PipeNitch/Project_WPNS-IoT/Pictures/IMG20240515162957.jpg

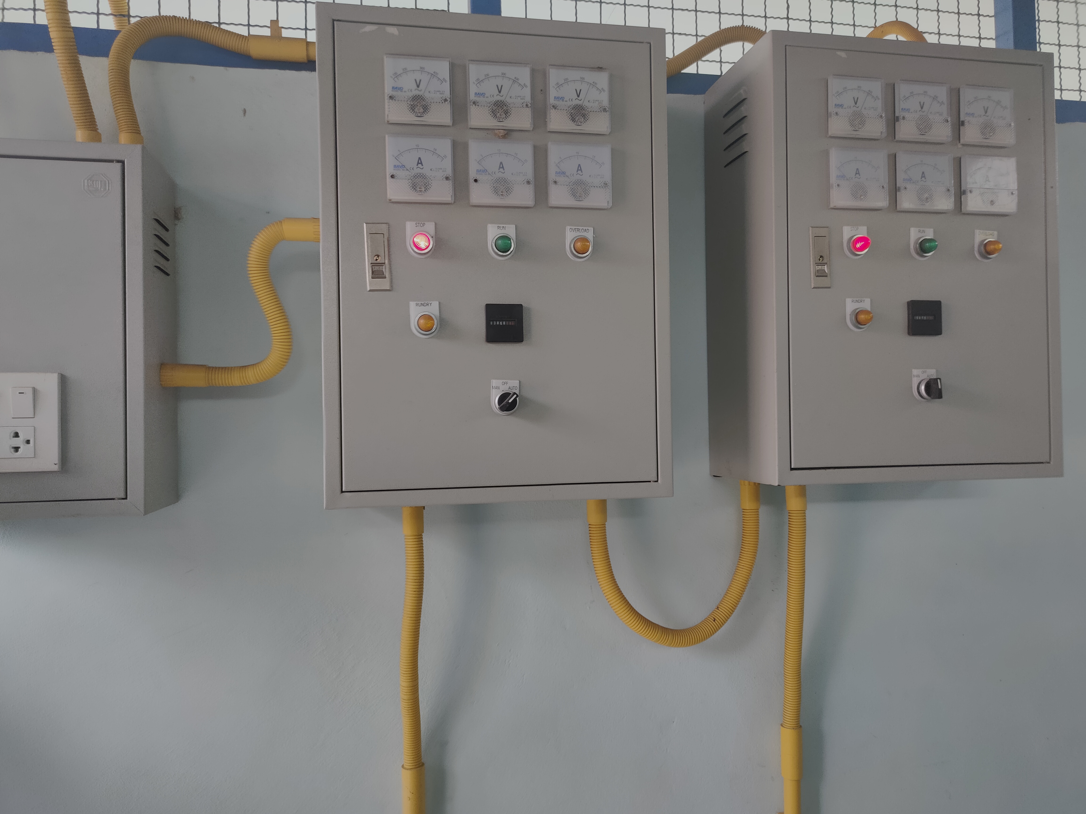
Pictures/IMG20240515162957.jpg
