PipeNitch/Project_WPNS-IoT/Pictures/IMG20240515163106.jpg

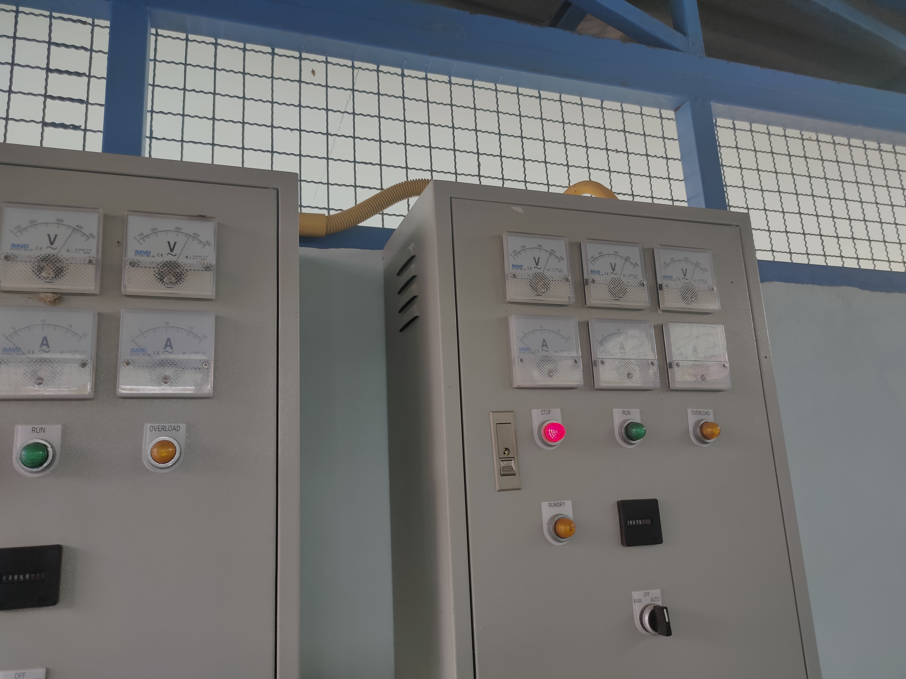
Pictures/IMG20240515163106.jpg
