PipeNitch/Project_WPNS-IoT/README.md

Project_WPNS-IoT\
A notification and shutdown system for water pumps using Internet of Things (IoT) technology.
