PipeNitch/Project_WPNS-IoT/Documents/66CS03_ระบบแจ้งเตือนและตัดการทำงานปั๊มน้ำโดยใช้เทคโนโลยีอินเทอร์เน็ตในทุกสิ่ง (IoT).pdf

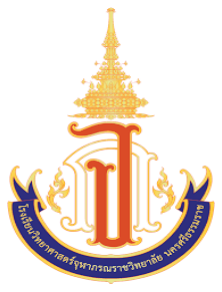
[picture p5: figure]

### ระบบแจ้งเตือนและตัดการท างานของปั๊มน ้าโดยใช้เทคโนโลยีอินเทอร์เน็ตในทุกสิ่ง A notification and shutdown system for water pumps using Internet of Things (IoT) technology

โดย
1. นายชยุต สรรพขาว
2. นายธรรมนิตย์ หนูยิ้มซ้าย

รายงานนี้เป็นส่วนหนึ่งของรายวิชา โครงงานวิทยาศาสตร์ ตามหลักสูตรโรงเรียนวิทยาศาสตร์จุฬาภรณราชวิทยาลัย นครศรีธรรมราช

### ระบบแจ้งเตือนและตัดการท างานของปั๊มน ้าโดยใช้เทคโนโลยีอินเทอร์เน็ตในทุกสิ่ง A notification and shutdown system for water pumps using Internet of Things (IoT) technology

โดย
1. นายชยุต สรรพขาว
2. นายธรรมนิตย์ หนูยิ้มซ้าย

รายงานนี้เป็นส่วนหนึ่งของรายวิชา โครงงานวิทยาศาสตร์ ตามหลักสูตรโรงเรียนวิทยาศาสตร์จุฬาภรณราชวิทยาลัย นครศรีธรรมราช

บทคัดย่อ
อยู่ระหว่างด าเนินการของโครงงาน

กิตติกรรมประกาศ
อยู่ระหว่างด าเนินการของโครงงาน

สารบัญ

อยู่ระหว่างด าเนินการของโครงงาน

บทที่ 1
บทน า
1.1 ที่มาและความส าคัญ
ปั๊มน ้าที่เราใช้กันทั่วไป ทั้งบ้านเรือน ภาคเกษตร หน่วยงานภาครัฐและเอกชน ปฏิเสธไม่ได้เลยว่าปั๊ม น ้ามีความจ าเป็นแทบจะต้องท างานตลอดเวลา หลายครั้งจะพบว่า “ปั๊มน ้าท างานแต่ไม่จ่ายน ้า” หรือเรียก ในทางเทคนิคว่า Dry Run ซึ่งมาจากหลายๆ สาเหตุ หากทราบปัญหาการท างานที่ผิดปกติได้เร็วและได้แก้ไข ในทันที จะช่วยลดค่าใช้จ่ายได้เป็นอย่างมาก แต่หากไม่รีบด าเนินการแก้ไข อาจท าให้เกิดค่าใช้จ่ายในการซ่อม มาก บางครั้งอาจก่อให้เกิดไฟฟ้าลัดวงจรจนเกิดไฟไหม้ได้
ปัญหาปั๊มน ้าท างานแบบ Dry Run พบได้บ่อยในหลายพื้นที่ สร้างความเสียหายต่อตัวปั๊มและ สิ้นเปลืองพลังงาน จากประสบการณ์ส่วนตัวที่พบปัญหาดังกล่าวบ่อยครั้งในหมู่บ้าน กระตุ้นให้เกิดโครงงานนี้ ขึ้นเพื่อพัฒนาระบบตัดการท างานของปั๊มน ้าเมื่อไม่มีน ้าไหลผ่านหรือปั๊มน ้าใช้พลังงานไฟฟ้าผิดปกติ จากปัญหาดังกล่าวข้างต้นทีมงานพัฒนาโครงงานนี้จึงมีความคิดที่จะสร้างระบบที่ท าการแจ้งเตือน และสามารถตัดการท างานปั๊มน ้าโดยอัตโนมัติเมื่อตรวจพบสภาวะ Dry Run หรือปั๊มน ้ากินกระแสไฟฟ้า มากกว่าปกติ รวมถึงระบบยังการบันทึกข้อมูลการท างานของปั๊มน ้าและปริมาณการกินกระแสไฟฟ้าผิดปกติ คุณสมบัติของระบบเหล่านี้จะช่วยยืดอายุการใช้งานปั๊มลดการสูญเสียค่าใช้จ่ายในการซ่อมบ ารุงปั๊มน ้า ประหยัดค่าไฟฟ้า อีกทั้งข้อมูลที่บันทึกไว้ยังสามารถน ามาวิเคราะห์เพื่อหามาตราการณ์ในการลดค่าไฟฟ้าจาก การท าของปั๊มน ้า รวมถึงวิเคราะห์หาแนวโน้มการช ารุดของปั๊มน ้าได้อีกด้วย

1.2 วัตถุประสงค์
1.2.1 เพื่อพัฒนาระบบแจ้งเตือนและป้องกันการท างานที่ผิดปกติของปั๊มน ้า
1.2.2 เพื่อป้องกันปั๊มน ้าไม่ให้เกิดความเสียหาย
1.2.3 เพื่อรวบรวมข้อมูลการท างานต่าง ๆ ของปั๊มน ้า

1.3 ขอบเขตของการศึกษา
1.3.1 ปั๊มน ้าที่ศึกษาเป็นแบบหอยโข่งหรือปั๊มดูดบ่อบาดาล
1.3.2 ปั๊มน ้ามีขนาด 1 แรงขึ้นไปเพื่อที่จะมีก าลังผลักของน ้าพอที่จะให้ Flow Switch ท างานได้ 1.3.3 ท่อส่งน ้าของปั๊มน ้ามีขนาด 1 นิ้วขึ้นไปหากน้อยกว่านั้นจะไม่สามารถติดตั้ง Flow Switch ได้ 1.3.4 ปั๊มน ้าที่ใช้เป็นปั๊มไฟฟ้ากระแสสลับ ขนาดแรงดันไฟฟ้า 220 โวลต์ทั้งแบบ 1 เฟส และ 3 เฟส 1.3.5 การตรวจจับความผิดปกติของปั๊มน ้าจะตรวจจับจาก 2 ปัจจัยดังนี้
1.3.5.1 ตรวจจับการไหลของน ้าโดยใช้ Flow Switch
1.3.5.2 ตรวจจับการใช้พลังงานไฟฟ้าของปั๊มน ้าขณะท างาน มีหน่วยวัดเป็นแอมป์
1.3.6 ใน 1 ระบบจะเฝ้าการท างานของปั๊มน ้า 1 ตัว

1.3.7 บอร์ดประมวลผลกลางใช้บอร์ด Node MCU ESP8266
1.3.8 แอปพลิเคชันในการรับข้อมูลและควบคุมการท างานของระบบจะใช้แอปพลิเคชัน Blynk Legacy
1.3.9 ที่แอปพลิเคชันจะมีการก าหนดค่าการหน่วงเวลาเพื่อตรวจจับการไม่ไหลของน ้าขณะที่ปั๊มน ้า ท างานมีหน่วยเป็น วินาที
1.3.10 ที่แอปพลิเคชันจะมีการก าหนดค่าการใช้พลังงานไฟฟ้าที่เกินก าหนดเพื่อให้ระบบแจ้งเตือนหรือ ตัดการท างานของปั๊มน ้ามีหน่วยเป็นแอมป์
1.3.11 การแจ้งเตือนต่าง ๆ จากระบบไปยังผู้ใช้งานระบบจะแจ้งไปยัง แอปพลิเคชันไลน์แบบกลุ่ม 1.3.12 การเก็บรวบรวมข้อมูลการท างานของปั๊มน ้าและการใช้พลังงานไฟฟ้าจะเก็บลงใน google sheet

1.4 สมมติฐาน
ระบบจะเตือนและตัดการท างานปั๊มน ้าเมื่อปั๊มน ้าท างานแต่ไม่มีน ้าไหล หรือปั๊มน ้าใช้พลังงานไฟฟ้า เกินกว่าที่ก าหนด ซึ่งจะเป็นการป้องกันการเสียหายของปั๊มน ้าได้

1.5 ตัวแปรที่ศึกษา
ตัวแปรต้น | ระบบติดตามการท างานของปั๊มน ้า
ตัวแปรตาม | ประสิทธิภาพการท างานของปั๊มน ้า
ตัวแปรควบคุม | สภาพการใช้งานของปั๊มน ้า

1.6 นิยามเชิงปฏิบัติการ
ระบบแจ้งเตือนและตัดการท างานของปั๊มน ้า หมายถึง ระบบที่สามารถตรวจสอบการท างานที่ผิดปกติ ของปั๊มน ้าได้จากกรณีต่าง ๆ ได้แก่ ปั๊มน ้าไม่สามารถดูดน ้าหรือส่งน ้าได้ ปั๊มน ้าใช้พลังงานไฟฟ้าสูงกว่าปกติ และเมื่อตรวจสอบได้จะท าการแจ้งเตือนให้ผู้ดูแลทราบและตัดการท างานเพื่อป้องกันความเสียหายที่จะเกิดกับ ปั๊มน ้าเช่นปั๊มน ้าไหม้
ประสิทธิภาพการท างานของปั๊มน ้า หมายถึง ปั๊มน ้าสามารถสูบและส่งน ้าได้ในปริมาณที่ก าหนดเมื่อ เทียบกับเวลา ยังคงใช้พลังงานไฟฟ้าเป็นปกติโดยวัดจากปริมาณน ้าที่สูบได้ในระยะเวลาหนึ่ง สภาพการใช้งานของปั๊มน ้า หมายถึง สภาพแวดล้อมที่ปั๊มน ้าจะต้องท างาน เช่น ท างานที่อุณหภูมิห้อง

บทที่ 2
ทฤษฎีและงานวิจัยที่เกี่ยวข้อง ในบทนี้กล่าวถึงทฤษฎีและงานวิจัยที่เกี่ยวข้องที่น ามาท าโครงงานระบบแจ้งเตือนและตัดการท างาน ของปั๊มน ้าโดยใช้เทคโนโลยีอินเทอร์เน็ตในทุกสิ่ง ส าหรับการสร้างระบบดังกล่าวนี้มีองค์ประกอบหลาย ๆ อย่าง ที่ทีมงานจัดท าโครงงานต้องศึกษาค้นคว้า เพื่อน าความรู้ที่ได้ศึกษามาประยุกต์ในการท าโครงงานเพื่อให้ได้ตาม วัตถุประสงค์ที่ต้องการ โดยมีรายละเอียดที่ต้องศึกษาดังนี้
1. ทฤษฎีเกี่ยวกับเซ็นเซอร์ตรวจจับการไหลของน ้า (Flow Switch)
2. ทฤษฎีเกี่ยวกับ NodeMCU ESP8266
3. ทฤษฎีเกี่ยวกับจอแสดงผล LED
4. ทฤษฎีเกี่ยวกับบอร์ด Relay 12 VDC 220 VAC 2 ช่องสัญญาณ
5. ทฤษฎีเกี่ยวกับปั๊มน ้า
6. ทฤษฎีโปรแกรมภาษา C ส าหรับ Arduino
7. ทฤษฎีเกี่ยวกับแอปพลิเคชัน Blynk
8. ทฤษฎีเกี่ยวกับเราเตอร์
9. ทฤษฎีเกี่ยวกับ Application Line
10. งานวิจัยที่เกี่ยวข้อง
2.1 ทฤษฎีเกี่ยวกับเซ็นเซอร์ตรวจจับการไหลของน ้า (Flow Switch)
เป็นสวิตช์ควบคุมการท างานของอุปกรณ์ไฟฟ้าต่าง ๆ เช่น ปั๊มน ้า โดยอาศัยการไหลของน ้าหรือ ของเหลวมาพัดพาให้ใบพายที่เชื่อมต่อไปยังสวิตช์เคลื่อนที่ไปตามทิศทางการไหลซึ่งจะมีผลให้สวิตช์มีการตัด ต่อและสั่งจ่ายหรือตัดกระแสไฟฟ้าที่จ่ายไปยังอุปกรณ์ไฟฟ้านั้น ๆ และยังสามารถปรับให้การตัดต่อสวิตช์ เป็นไปตามอัตราการไหลมากน้อย ได้ตามต้องการและใบพายมีขนาดความยาวหลายขนาดให้เลือกใช้ แสดงได้ ดังภาพที่ 2.1

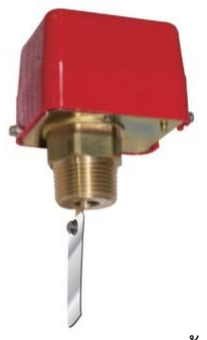
[picture p6: figure]

ภาพที่ 2.1 เซ็นเซอร์วัดการไหลของน ้า (Flow Switch) ที่มา https://inwfile.com/s-cp/496sep.png

2.2 ทฤษฎีเกี่ยวกับ Node MCU ESP8266
Node MCU Development Kit V.10 เป็นตัวที่พัฒนามาจาก Node MCU Version 0.9 เดิมเป็น โมดูลที่ประกอบด้วย ESP8266-12 E มีเสาอากาศแบบ PCB Antenna เชื่อมต่อเฮดเดอร์ส าหรับขาสัญญาณ ต่าง ๆ ได้แก่ GPIO , PWM , 12C , 1-wire , ADC และ มีSPI เพิ่มขึ้นมาจาก Version เดิม มีส่วนของ UBS -to-TTL และพอร์ต micro USB ซึ่งใช้ชิพ USB to Serial ของ Silicon Lab CP2102 เชื่อมต่อเข้ากับเครื่อง คอมพิวเตอร์เพื่อพัฒนาโปรแกรม สามารถติดตั้งเฟิร์มแวร์ Node MCU ได้ และยังมีขนาคของ PCB ที่เล็กลง สามารถใช้งานกับ breadboard ได้แสดงดังภาพที่ 2.2

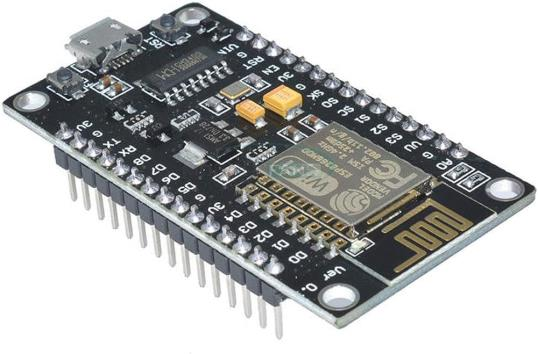
[picture p7: figure]

ภาพที่ 2.2 ลักษณะของ Node MCU ESP8266 ที่มา https://m.media-amazon.com/images/I/61UOyRccN0L._AC_UF1000,1000_QL80_.jpg จากภาพที่ 2.2 ผู้ใช้สามารถเลือกพัฒนาด้วยสคริปต์ LUA โดยใช้เฟิร์มแวร์ NodeMCU หรือเป็นชุด พัฒนาด้วยโมดูล ESP8266 ก็ได้ซึ่งสามารถเขียนด้วย Arduino IDE ได้ โมดูลมี GPIO ให้ใช้ถึง 10 พอร์ต สามารถน ามาพัฒนาโปรเจคทางด้าน Internet of Things (IOTs) เชื่อมต่อกับอุปกรณ์อื่น ๆ ตามต้องการ 2.3 ทฤษฎีเกี่ยวกับจอแสดงผล LCD
LCD ย่อมาจาก Liquid Crystal Display ซึ่งเป็นจอแสดงผลแบบ (Digital) โดยภาพที่ปรากฎขึ้นเกิด จาก แสงที่ถูกปล่อยออกมาจากหลอดไฟด้านหลังของจอภาพ (Black Light) ผ่านชั้นกรองแสง (Polarized filter) แล้ววิ่งไปยังคริสตัลเหลวที่เรียงตัวด้วยกัน 3 เซลล์คือ แสงสีแดง แสงสีเขียวและแสงสีน ้าเงิน กลายเป็น พิกเซล (Pixel) ที่สว่างสดใสเกิดขึ้น แสดงได้ดังภาพที่ 2.3

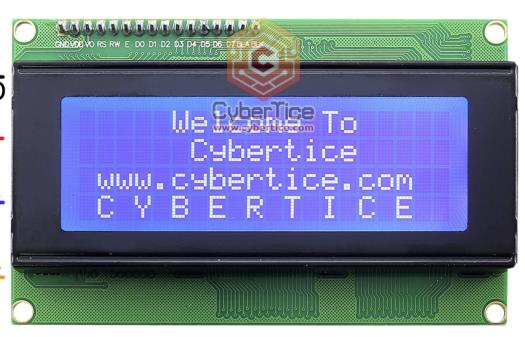
[picture p8: figure]

ภาพที่ 2.3 จอ LCD ขนาด 20x4 ที่มา https://cu.lnwfile.com/_/cu/_webp_max/4096/4096/4w/mc/lu.webp

จากภาพที่ 2.3 แสดงจอ LCD ที่มีการเชื่อมต่อแบบ I2C หรือเรียกอีกอย่างว่าการเชื่อมต่อแบบอนุกรม จะเป็นจอ LCD ธรรมดาทั่วไปที่มาพร้อมกับบอร์ด I2C Bus ที่ท าให้การใช้งานได้สะดวกยิ่งขึ้นและยังมาพร้อม กับ VR ส าหรับ ปรับความเข้มของจอ ในรูปแบบ I2C จะใช้ขาในกาเชื่อมต่อกับไมโครคอนโทรลเลอร์เพียง 4 ขา (แบบ Parallel ใช้ 16 ขา ซึ่งท าให้ใช้งานได้ง่ายและสะดวกมากยิ่งขึ้น ส าหรับการเชื่อมต่อขาสัญญาณกับ บอร์ด ESP8266 แสดงได้ดังภาพที่ 2.4

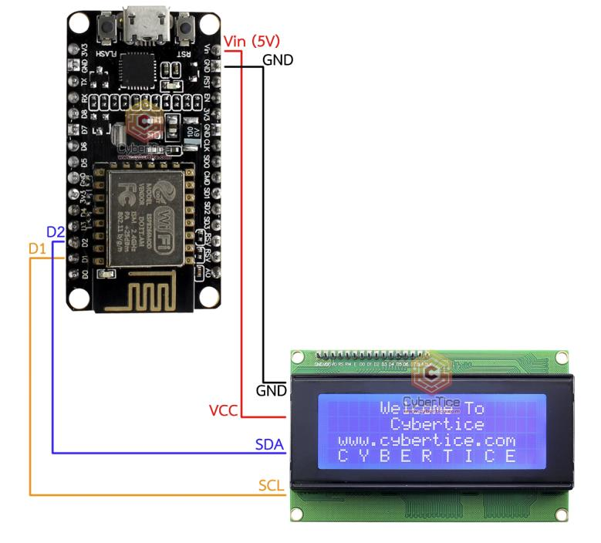
[picture p9: figure]

ภาพที่ 2.4 แสดงการเชื่อมต่อสายสัญญาณ ที่มา https://cu.lnwfile.com/_/cu/_webp_max/4096/4096/4w/mc/lu.webp จากรูปจะเห็นได้ว่าการเชื่อมต่อสายสัญญาณจะใช้เพียง 4 เส้นเท่านั้น โดยขาสัญญาณที่ใช้ส าหรับการ รับส่งข้อมูลระหว่าง บอร์ด ESP8266 กับตัวจอ LCD คือขา SDA และ SCL โดยจะน าไปต่อเช้ากับบอร์ด ESP 8266 ที่ขา D2 และ D1 ส่วน Code ภาษาซีที่ใช้ในการควบคุมการท างานเพื่อให้หน้าจอแสดงผลตามที่ ต้องการแสดงดังภาพที่ 2.5

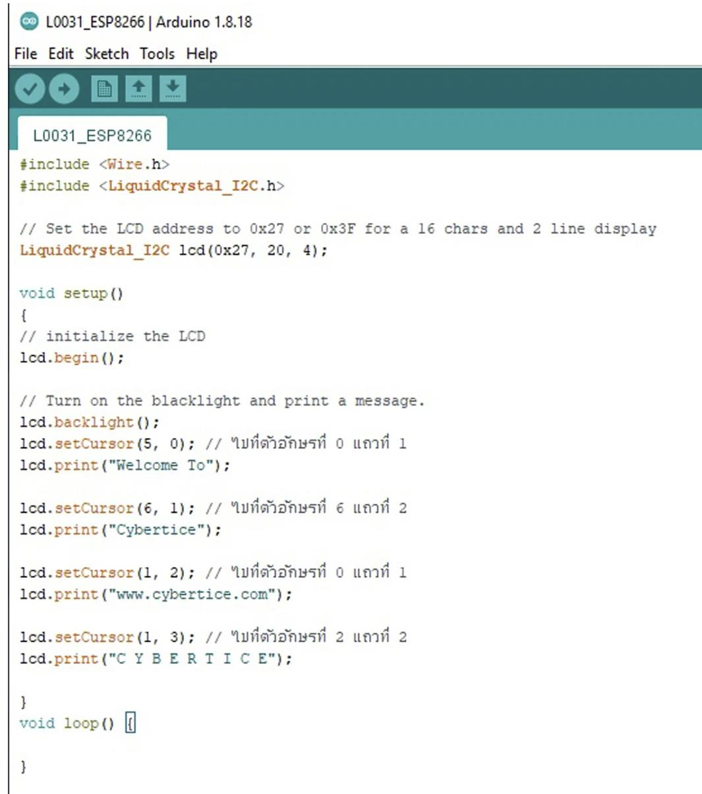
[picture p10: figure]

ภาพที่ 2.5 ตัวอย่าง Code ส าหรับบอร์ด ESP8266 แสดงผลที่จอ LCD ที่มา https://cu.lnwfile.com/_/cu/_webp_max/4096/4096/xz/ti/2i.webp จากภาพที่ 2.5 เป็นตัวอย่าง Code ส าหรับบอร์ด ESP8266 ที่ให้แสดงข้อความ จ านวน 4 บรรทัด และ มีการเรียกใช้ไลบรารี่ LiquidCrytal_I2C.h เพื่อให้ Code สามารถท างานได้

2.4 ทฤษฎีเกี่ยวกับบอร์ด Relay 12 VDC 220 VAC 2 ช่องสัญญาณ
รีเลย์ที่ใช้ต่อกับเอาต์พุตของ PLC หรืออุปกรณ์อื่น ๆ ที่เป็นทั้ง PNP หรือ NPN เพื่อน า Contact Relay ไปใช้งาน ใช้พื้นที่ในการติดตั้งน้อย ซ่อมแซมได้ง่าย เคลื่อบย้ายได้สะควก รูปทรงสวยงาม สามารถติดตั้ง บนราง DIN RAIL ในตู้ไฟฟ้าได้ มี LED โชว์สภาวะการท างานของ Relay ใช้กับสายขนาด 2.5mm*2.5mm สามารถทนอุณหภูมิการติดตั้งได้ 0-50 องศา แสดงได้ดังภาพที่ 2.6

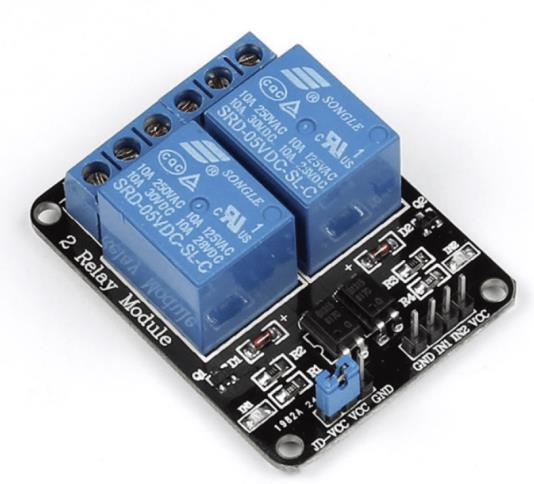
[picture p11: figure]

ภาพที่ 2.6 ลักษณะของรีเลย์ 2 ช่อง ที่มา https://static.cytron.io/image/cache/catalog/products/BB-RELAY-5V-02/BB-RELAY-5V-02-800x800.png (https://static.cytron.io/image/cache/catalog/products/BB-RELAY-5V-02/BB-RELAY-5V-02-800x800.png)
จากภาพที่ 2.6 เป็นอุปกรณ์ที่เปลี่ยนพลังงานไฟฟ้าให้เป็นพลังงานแม่เหล็ก เพื่อใช้ในการดึงดูด หน้าสัมผัสของคอนแทคให้เปลี่ยนสภาวะ โดยการป้อนกระแสไฟฟ้าให้กับขดลวด เพื่อท าการปิดหรือเปิด หน้าสัมผัสคล้ายกับสวิตช์อิเล็กทรอนิกส์ ซึ่งเราสามารถน ารีเลย์ไปประยุกต์ใช้ ในการควบคุมวงจรต่าง ๆ ใน งานช่างอิเล็กทรอนิกส์มากมาย

2.5 ทฤษฎีเกี่ยวกับปั๊มน ้า
เครื่องสูบน ้าแบบหอยโข่งมีใช้กันอย่างแพร่หลาย เพราะมีคุณสมบัติที่เหมาะสมต่อการเกษตร คือ สูบ น ้าได้ปริมาณมาก น ้าที่สูบไม่จ าเป็นที่จะต้องสะอาด เนื่องจากสิ่งสกปรกที่ปะปนอยู่ในน ้า ไม่ค่อยมีผลเสียต่อ เครื่องสูบน ้าชนิดนี้มากนัก การใช้งานก็มีอยู่อย่างกว้างขวาง ทั้งในไร่นาสวนผักสวนผลไม้ หรือแม้แต่ในฟาร์มลี้ ยงสัตว์ เครื่องสูบน ้าเบบนี้ เหมาะส าหรับสูบน ้าในแม่น ้าล าธาร บ่อน ้าคูคลอง หรืออ่างเก็บน ้าที่มีระดับต ่ากว่า ระดับพื้นดินไม่เกิน 10 เมตร แสดงได้ดังภาพที่ 2.7

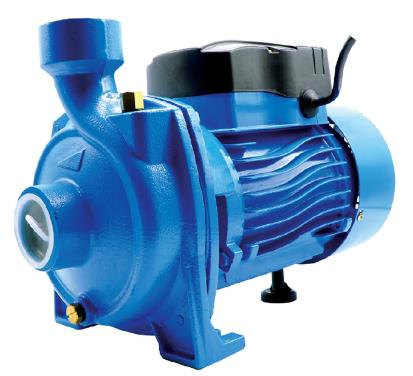
[picture p12: figure]

ภาพที่ 2.7 ปั๊มน ้าหอยโข่ง
ที่มา https://powerpumptool.com/wp-content/uploads/2020/04/43639009_1277524145735645_5090484754927583232_n.png (https://powerpumptool.com/wp-content/uploads/2020/04/43639009_1277524145735645_5090484754927583232_n.png)

จากรูปที่ 2.7 ปั๊มน ้าแบบหอยโข่งสามารถสูบน ้าด้วยการท างานของส่วนประกอบ 4 ส่วน
1. ใบพัด (Impeller): เป็นส่วนที่ท า ให้เกิดแรงหนีศูนย์กลางต่อน ้าที่อยู่ภายในเรือน
2. เรือนสูบ (Casing): เป็นส่วนที่เปลี่ยนแรงหนีศูนย์กลางที่เกิดจากใบพัดให้เป็นแรงดันได้ อย่างมีประสิทธิภาพ
3. ช่องดูด (Suction): ท าหน้าที่เป็นท่อทางน ้าเข้าของปั๊มน ้า
4. ช่องดูด (Discharge): ท าหน้าที่เป็นท่อทางส่งน ้าออกของปั๊มน ้า

2.6 ทฤษฎีโปรแกรมภาษา C ส าหรับ Arduino
ภ าษ า C เป็นก ารเขียนโป รแกรมพื้นฐานสาม ารถป ระยุกต์ใช้กับงานต่ าง ๆ ได้ม ากม าย ระบบปฏิบัติการคอมพิวเตอร์ทางคณิตศาสตร์ โปรแกรมทางไฟฟ้าอิเล็กทรอนิกส์ ไมโครคอนโทรลเลอร์ ซึ่ง เวลาใช้สามารถพิมพ์ชุดค าสั่งภาษาซีเพิ่มเข้าไปในโปรแกรมค านวณทางคณิตศาสตร์ ประมวลผลทาง สัญญาณไฟฟ้าทางไฟฟ้าสื่อสารก็ได้ท าให้ประสิทธิภาพของงานที่ท าดียิ่งขึ้น ภาษา C เป็นภาษาที่บางคน เรียกว่าภาษาระดับกลาง คือไม่เป็นภาษาระดับต ่าแบบแอสเซมบลีหรือเป็นภาษาระดับสูงแบบ เบสิค โคบอล ฟอร์แทรน หรือ ปาสคาล เนื่องจากสามารถจะจัดการเกี่ยวกับเรื่องของพอยน์เตอร์ได้อย่างอิสระ และบางทีก็ สามารถควบคุมฮาร์ดแวร์ผ่านทางภาษา C ได้ราวกับเขียนมันด้วยภาษาแอสเซมบลี
Arduino IDE คือ platform ที่ท างานบนฝั่ง Hardware โดยมี IDE ส าหรับพัฒนาและมีHardware I/O ส าหรับต่อ interface ส าหรับการท างานในรูปแบบต่าง ๆ ไม่ว่าจะเป็นการสื่อสารที่คอมพิวเตอร์ท าได้ เช่น serial sd card usb wifi lang psgsm หรือ module ต่าง ๆ ที่สามารถเพิ่มเข้าไปได้แสดงได้ดังรูปที่ 2.8

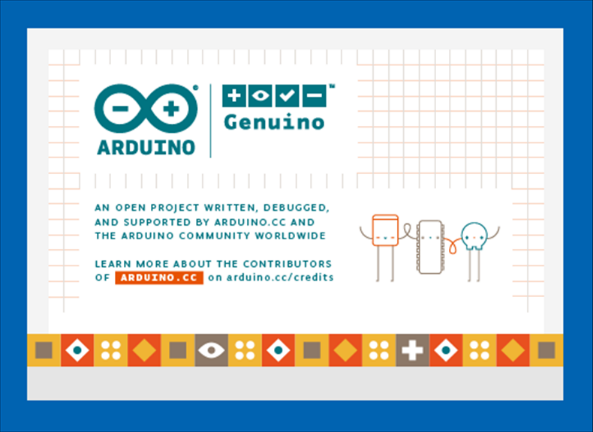
[picture p13: figure]

ภาพที่ 2.8 Arduino IDE
ที่มา https://store-images.s-microsoft.com/image/apps.62706.13510798887551775.79995e90-34bc-4c9a-809c-e0a665258acc.df21e9c8-2407-406e-9ee2-3a361eea0ca7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 (https://store-images.s-microsoft.com/image/apps.62706.13510798887551775.79995e90-34bc-4c9a-809c-e0a665258acc.df21e9c8-2407-406e-9ee2-3a361eea0ca7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)

2.7 ทฤษฎีเกี่ยวกับแอปพลิเคชัน Blynk
Blynk Platform ถูกออกแบบมาเพื่อใช้ในการควบคุมอุปกรณ์ Internet of Things ซึ่งมีคุณสมบัติใน การควบคุมจากระยะไกลผ่านเครือข่ายอินเตอร์เน็ต และยังสามารถแสดงผลค่าจากเวลาต่าง ๆ ได้อีกด้วยแสดง ดังภาพที่ 2.9

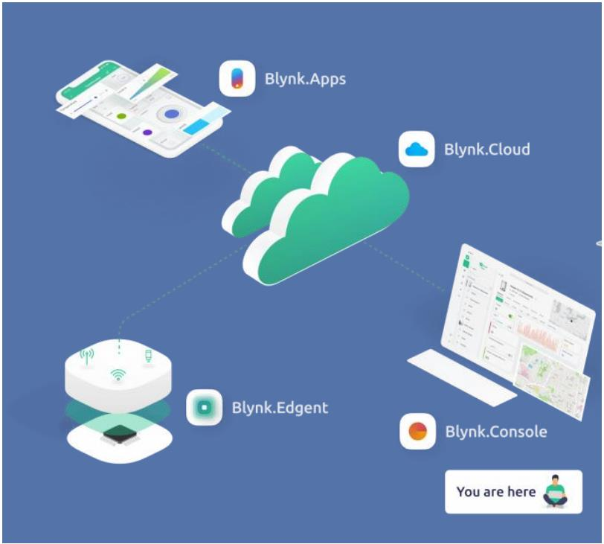
[picture p14: figure]

ภาพที่ 2.10 แอปพลิเคชัน Blynk ที่มา https://doc.inex.co.th/wp-content/uploads/2022/05/intro_2.png จากภาพที่ 2.10 Blynk คือ Application ส าเร็จรูปส าหรับงาน IOT มีความน่าสนใจคือการเขียน โปรแกรมที่ง่าย ไม่ต้องเขียน App เองสามารถใช้งานได้อย่าง Real time สามารถเชื่อมต่อ Device ต่าง ๆ เข้า กับ Internet ได้อย่างง่ายดาย ไม่ว่าจะเป็น Arduino Esp8266 Esp32 Nodemcu Rasberry pi น ามาแสดง บน Application ได้อย่างง่ายดาย แล้วที่ส าคัญ Application Blynk ยังฟรี และ รองรับในระบบ IOS และ Android อีกด้วย

2.8 ทฤษฎีเกี่ยวกับเราเตอร์
เราเตอร์ เป็นอุปกรณ์ที่ใช้ในการเชื่อมต่อเครือข่ายหรืออินเทอร์เน็ต หน้าที่หลักของ Router คือการหา เส้นทางในการส่งผ่านข้อมูลเป็นตัวกลางในการส่งต่อข้อมูลไปยังเครือข่ายอื่น รวมถึงท าหน้าที่ในการแชร์ อินเทอร์เน็ตให้เครื่องคอมพิวเตอร์และเครื่องลูกข่าย โดยลักษณะของเราเตอร์แสดงได้ดังภาพที่ 2.11

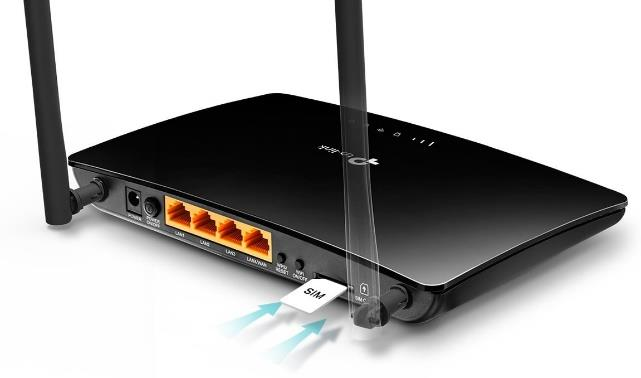
[picture p15: figure]

ภาพที่ 2.11 เราเตอร์ส าหรับเชื่อมต่อเครือข่ายและกระจายสัญญาณอินเทอร์เน็ต
ที่มา https://img.advice.co.th/images_nas/advice_activity/201910243190331481.jpg จากรูปที่ 2.9 บนตัว Router จะมีช่องที่ใช้เสียบต่อสายสัญญาณเรียกว่า LAN Port (แลนพอร์ต) แบบ RJ-45 โดยทั่วไปมัก มี 4 พอร์ต (ความเร็ว 10/100Mbps) หรือมากกว่า และ Router จะมี Internet Port หรือ WAN Port แบบ RJ-45 ส าหรับใช้เป็นพอร์ตต่อเข้ากับ ADSL Modem หรือ Fiber Media Converter เพื่อเชื่อม Router เข้าสู่ระบบเครือข่ายอินเทอร์เน็ตอีกที โดยปกติการเลือกซื้อ Router ควรจะเลือกซื้อที่มี LAN Port อยู่อย่างน้อย 4 พอร์ต เพื่อใช้เป็นพอร์ตส าหรับเชื่อมอุปกรณ์ที่มีแลนพอร์ตอื่น ฯ เช่น เดสก์ท็อป พีซีหรือคอมพิวเตอร์ตั้งโต๊ะ พรินเตอร์ที่เชื่อมต่อเน็ต

2.9 ทฤษฎีเกี่ยวกับ Application Line
โปรแกรม Application Line ที่มีความสามารถในการสนทนา เช่น การแชท การส่งข้อความ การแชร์ ไฟล์ การสร้างกลุ่มพูดคุย หรือการสนทนาผ่านเสียง ผ่านเครือข่ายอินเตอร์เน็ต บนอุปกรณ์ประเภทพกพา (Mobile Devices) เช่น สมาร์ทโฟน แท็บเล็ต เป็นต้น นอกจากนี้ Line ยังสามารถติดตั้งและ ใช้งานบนเครื่อง คอมพิวเตอร์ทั่วไปได้ด้วย แสดงได้ดังภาพที่ 2.12

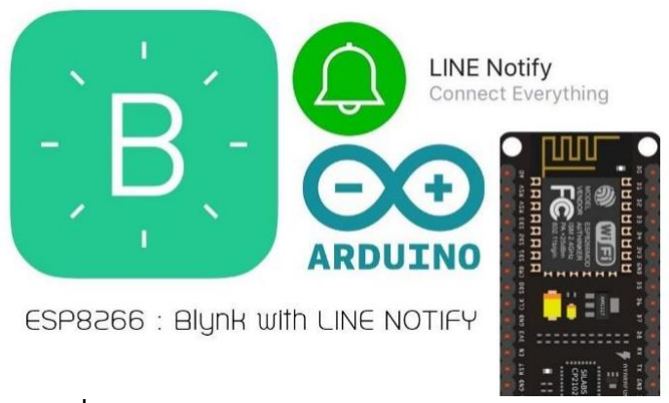
[picture p16: figure]

ภาพที่ 2.12 Application Line ส าหรับแจ้งเตือนการท างาน ที่มา https://encrypted-tbn0.gstatic.com/images?q=tbn:ANd9GcQEtu9q2JfeMJG2DPNuIVR-u0ymiIJeacGrTQ&s (https://encrypted-tbn0.gstatic.com/images?q=tbn:ANd9GcQEtu9q2JfeMJG2DPNuIVR-u0ymiIJeacGrTQ&s)

จากรูปที่ 2.12 แสดงการใช้งาน Application Line การสื่อสารการแจ้งเตือนให้ผู้ใช้งานทราบถึง สถานะการท างานของระบบโดยแจ้งเตือนเมื่ออุปกรณ์เกิดปัญหา มีการขัดข้องของอุปกรณ์ โดยแจ้งให้ผู้ดูแล ทราบสถานะของระบบ

2.10 งานวิจัยที่เกี่ยวข้อง
2.10.1 งานวิจัยเรื่องระบบอัตโนมัติแบบออนไลน์ส าหรับการควบคุมการให้น ้าสวนสละ งานวิจัยนี้เป็นของนายนายวัชรินทร์ไกรนรา และคณะ ซึ่งเป็นการสร้างระบบออนไลน์แบบอัตโนมัติ ส าหรับการควบคุมการให้น ้าในสวนสละ ระบบสามารถควบคุมได้ 2 ทางคือควบคุมที่หน้าตู้ระบบรับค าสั่งจาก การกดแป้นคีย์แพด และควบคุมออนไลน์จากแอปพลิเคชัน Blynk การท างานของระบบสามารถตั้งค่าการ ท างานได้ 3 รูปแบบ คือ การรดน ้าแบบอัตโนมัติตามความชื้นในดิน การรดน ้าตามเวลา และการสั่งรดน ้าตามที่ ผู้ใช้ควบคุมเองตามต้องการ ผู้วิจัยยังได้ออกแบบระบบเพื่อให้ปั๊มน ้าท างานตามการเปิดปิดของโซลินอยวาล์ว โดยไม่ต้องสั่งงานปั๊มน ้าเพื่อความสะดวกในการใช้งาน รวมถึงมีระบบป้องกันปั๊มเสียหายของปั๊มน ้าด้วย การออกแบบระบบของงานวิจัยดังกล่าว ผู้วิจัยได้ประยุกต์ใช้ไมโครคอลโทรลเลอร์แบบ Arduino รุ่น Mega 2560 เป็นตัวประมวลผลหลัก ใช้บอร์ด Ethernet Shield W5100 เพื่อเชื่อมต่ออินเตอร์เน็ต ส าหรับ อินพุตที่ส าคัญของระบบประกอบด้วย เซ็นเซอร์วัดความชื้นจ านวน 4 ตัว เซ็นเซอร์ตรวจจับการไหลของน ้า ส าหรับเอาต์พุตที่ส าคัญของระบบประกอบด้วย โซลินอยวาล์ว 4 ตัว และปั๊มน ้า
การทดลองระบบ ได้ติดตั้งตู้ระบบควบคุมบริเวณโรงเรือนเก็บปั๊มน ้าภายในสวนสละและท าการติดตั้งโซ ลินอยวาล์วขนานกับวาล์วเดิมเพื่อใช้วาล์วเดิมเป็นระบบส ารอง ผลการทดลองปรากฏว่าระบบสามารถรับค าสั่ง จากผู้ใช้ได้ทั้งจากการกดคีย์แพดหน้าตู้ควบคุมหรือจาก Blynk เมื่อได้รับค าสั่งแล้วระบบสามารถท างานตาม ค าสั่งได้อย่างถูกต้อง ส าหรับการท างานในแต่ละรูปแบบระบบสามารถควบคุมการรดน ้าได้อย่างถูกต้องตาม เงื่อนไขที่ได้ก าหนดไว้ รวมถึงสามารถหยุดการท างานของปั๊มน ้ากรณีปั๊มมีปัญหาและท าการแจ้งข้อความเตือน ไปยังผู้ใช้งานระบบผ่านแอพพลิเคชั่นไลน์ได้ส าหรับแผนภาพการเชื่อมโยงความเขี่ยวข้องของระบบกับผู้ใช้งาน ของงานวิจัยดังกล่างแสดงได้ดังภาพที่ 2.13

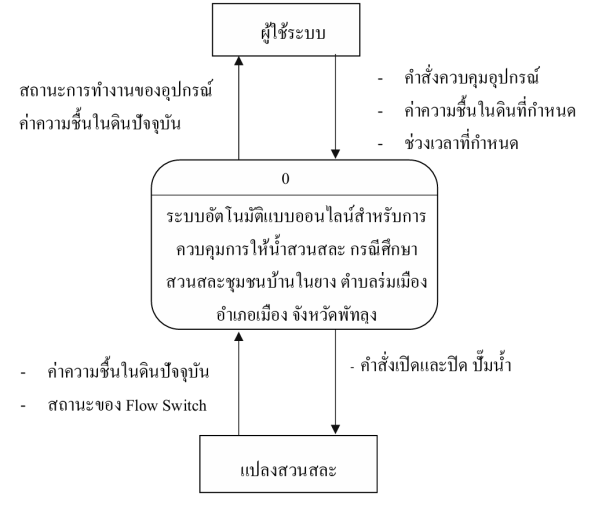
[picture p17: figure]

ภาพที่ 2.13 แสดงแผนผังการเชื่อมโยงระหว่างผู้ใช้ระบบกับแปลงสวนสละ

จากภาพที่ 2.13 แสดงถึงความสัมพันธ์ระหว่างผู้ใช้ระบบ กับระบบควบคุมที่สามารถควบคุมการท างาน ของปั๊มน ้าให้ท างานตามที่ได้ตั้งเวลาไว้และท างานตามความชื่นที่ตรวจวัดได้แบบเรียลไทม์โดยงานวิจัยดังกล่าว มีโครงสร้างระบบดังภาพที่ 2.14

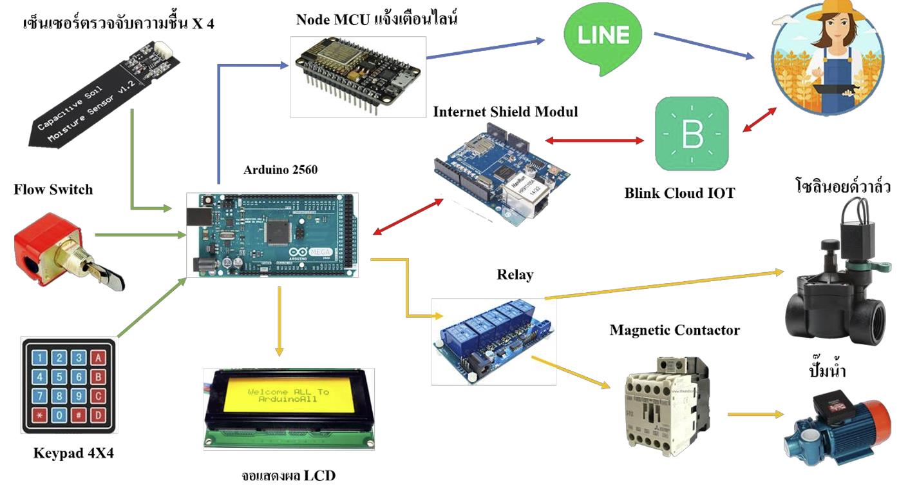
[picture p18: figure]

ภาพที่ 2.14 แสดงโครงสร้างระบบของระบบให้น ้าสวนสละ 2.10.2 งานวิจัยเรื่องระบบอัตโนมัติแบบออนไลน์ส าหรับควบคุมอุปกรณ์ไฟฟ้าเพื่อการประหยัด พลังงาน
งานวิจัยนี้เป็นการสร้างระบบอัตโนมัติแบบออนไลน์ส าหรับควบคุมอุปกรณ์ไฟฟ้าเพื่อการประหยัด ระบบสามารถควบคุมได้ 2 ทาง คือ ควบคุมที่หน้าตู้ระบบรับค าสั่งจากการกดแป้นคีย์แพด และควบคุม ออนไลน์จาก Application Blynk การท างานของระบบสามารถตั้งค่าการท างานได้ 2 รูปแบบ คือ 1. ระบบ สามารถท างานได้อัตโนมัติเพื่อให้ระบบสามารถท างานได้เองตามความต้องการของผู้ใช้ 2. ระบบสามารถเปิด หรือปิดอุปกรณ์ด้วยมือตามความต้องการของผู้ใช้ การออกแบบ ผู้วิจัยได้ประยุกต์ใช้ไมโครคอลโทรลเลอร์ แบบ Arduino รุ่น ATmega2560 ร่วมกับบอร์ด Node MCU 8266 เพื่อเชื่อมต่ออินเทอร์เน็ต โดยมี แมค เนติกสวิตช์ในการควบคุมการเปิดหรือปิดของระบบ
ผลการทดลองพบว่าระบบอัตโนมัติแบบออนไลน์ส าหรับควบคุมอุปกรณ์ไฟฟ้าเพื่อการประหยัด พลังงาน สามารถช่วยประหยัดพลังงานไฟฟ้าและช่วยในการตรวจสอบการใช้งานของอุปกรณ์ไฟฟ้า รวมถึงการ ควบคุมระบบการเปิดหรือปิดเครื่องใช้ไฟฟ้าได้ง่ายขึ้น งานวิจัยนี้มีรูปแบบโครงสร้างของระบบแสดงได้ดังภาพ ที่ 2.15

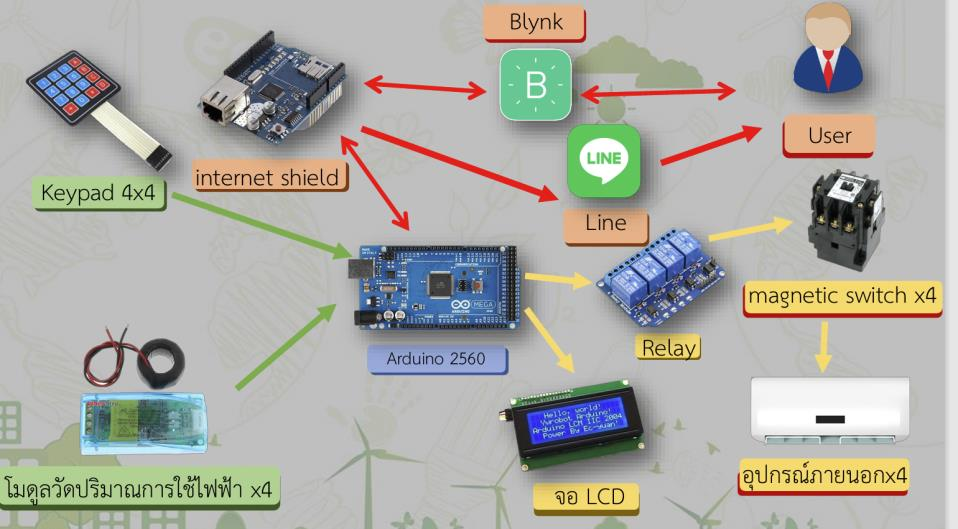
[picture p19: figure]

ภาพที่ 2.15 โครงสร้างระบบควบคุมอุปกรณ์ไฟฟ้า

บทที่ 3
วิธีด าเนินการทดลอง
ในการท าโครงงานวิทยาศาสตร์ เรื่อง ระบบแจ้งเตือนและตัดการท างานของปั๊มน ้าโดยใช้ เทคโนโลยีอินเทอร์เน็ตในทุกสิ่งนั้น เพื่อให้ระบบสามารถท างานได้ตรงตามวัตถุประสงค์ที่วางไว้ ทางทีมงานผู้จัดท าโครงงานจึงได้รวบรวมวิธีด าเนินการทดลองในส่วนต่าง ๆ โดยมีรายละเอียดดังนี้
3.1 | วัสดุอุปกรณ์ส าหรับสร้างระบบ
3.1.1 ปั๊มน ้าหอยโข่งขนาด 1 แรง | จ านวน 1 เครื่อง
3.1.2 ถังน ้าพลาสติกขนาด 100 ลิตร เพื่อท าระบบน ้าหมุนเวียน | จ านวน 1 ถัง
3.1.3 บอร์ดประมวลผล ESP-8266 | จ านวน 1 บอร์ด
3.1.4 ซอกเกตเสียบบอร์ด ESP-8266 | จ านวน 1 บอร์ด
3.1.5 Flow Switch วัดการไหลของน ้าในท่อส่งน ้า | จ านวน 1 ตัว
3.1.6 โมดูลวัดการใช้พลังงานไฟฟ้ากระแสสลับ | จ านวน 1 ตัว
3.1.7 หน้าจอแสดงผลแบบ LCD ขนาด 20 x 4 | จ านวน 1 ตัว
3.1.8 ไฮลิงค์ส าหรับแปลงไฟ 220 Vac เป็น 5 Vdc | จ านวน 2 ตัว
3.1.9 โมดูลรีเลย์ 2 ช่อง | จ านวน 1 ตัว
3.1.10 เทอร์มินอล 8 ช่องสัญญาณ | จ านวน 1 ตัว
3.1.11 ไพลอตแลมป์ไฟแสดงสถานะ | จ านวน 2 ตัว
3.1.12 สวิตช์ 2 จังหวะ | จ านวน 1 ตัว
3.1.13 กล่องพลาสติก | จ านวน 1 กล่อง
3.1.14 เราเตอร์โมเดมแบบใส่ Sim เครือข่ายโทรศัพท์มือถือ | จ านวน 1 เครื่อง
3.1.15 Sim โทรศัพท์มือถือพร้อมสัญญาณอินเทอร์เน็ต | จ านวน 1 ซิม
3.1.16 อื่น ๆ เช่น ท่อ PVC สายไฟ สายสัญญาณ เข้มขัดรัดสายไฟ น๊อต สกรูวาล์วน ้า 3.2 เครื่องมือส าหรับจัดท าโครงงาน
3.2.1 เครื่องคอมพิวเตอร์ส าหรับเขียนโปรแกรมและจัดท าเอกสาร จ านวน 1 เครื่อง 3.2.2 อุปกรณ์แบบสมาร์ทที่ใช้ระบบปฏิบัติการแอนดรอยด์ จ านวน 1 อุปกรณ์ 3.2.3 โปรแกรมภาษาซีส าหรับบอร์ด Arduino
3.2.4 แอปพลิเคชัน Blynk Legacy
3.2.5 แอปพลิเคชันไลน์
3.2.6 Google Sheet
3.2.7 Google App Scrip

3.3 โครงสร้างระบบทางด้านฮาร์ดแวร์ โครงสร้างระบบทางด้านฮาร์ดแวร์แสดงได้ดังภาพที่ 3.1

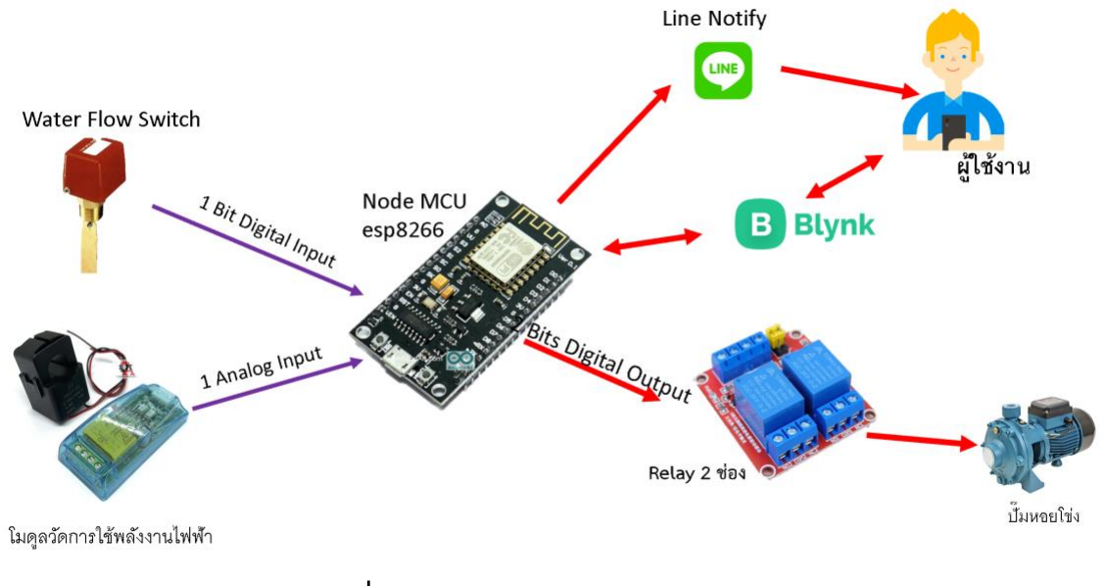
[picture p20: figure]

ภาพที่ 3.1 โครงสร้างระบบทางด้านฮาร์ดแวร์

3.4 ผังงานขั้นตอนการท างานของระบบ ผังงานขั้นตอนการท างานของระบบแสดงได้ดังภาพที่ 3.2

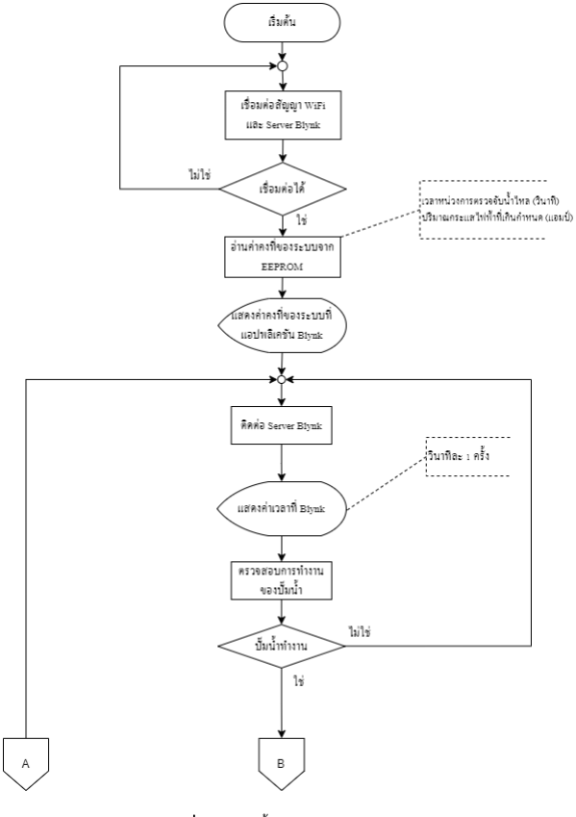
[picture p21: figure]

ภาพที่ 3.2 ผังงานขั้นตอนการท างานของระบบ

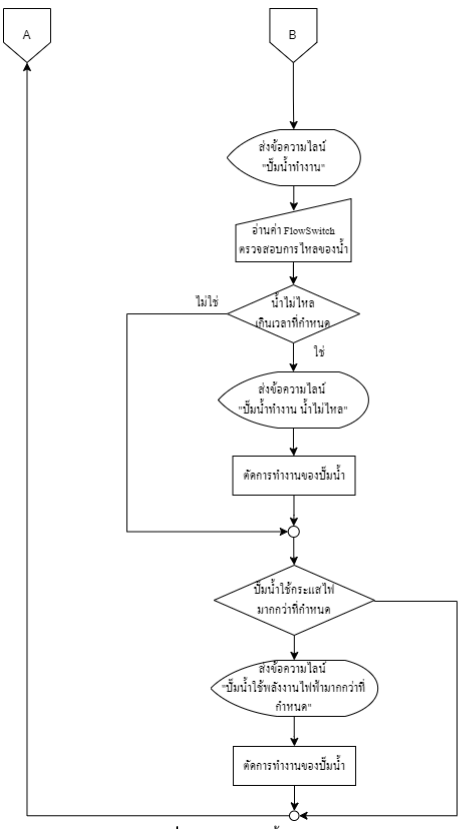
[picture p22: figure]

ภาพที่ 3.2(ต่อ) ผังงานขั้นตอนการท างานของระบบ(ต่อ)

3.5 การด าเนินงานและการทดลอง
3.5.1 ศึกษาและทดลองการใช้งานปั๊มน ้า
3.5.2 ติดตั้งโปรแกรมภาษาซีส าหรับบอร์ด Arduino
3.5.3 ทดลองเขียนโปรแกรมเพื่อควบคุมบอร์ด ESP 8266
3.5.4 ศึกษาและทดลองการท างานของ Flow Switch
3.5.5 เขียนโปรแกรมให้บอร์ด ESP 8266 ตรวจกับการท างานของ Flow Switch 3.5.6 ศึกษาและทดลองโมดูลวัดพลังงานไฟฟ้า
3.5.7 เขียนโปรแกรมให้บอร์ด ESP 8266 ตรวจกับการใช้พลังงานไฟฟ้า
3.5.8 เขียนโปรแกรมเชื่อมต่อบอร์ด ESP 8266 เข้ากับ แอปพลิเคชัน Blynk 3.5.9 เขียนโปรแกรมเชื่อมต่อบอร์ด ESP 8266 เข้ากับ แอปพลิเคชันไลน์ 3.5.10 เขียนโปรแกรมในส่วนของเงือนไขการแจ้งเตือนและตัดการท างานของปั๊ม 3.5.11 ทดสอบระบบในส่วนของโปรแกรมในภาพรวมทั้งหมด
3.5.12 ประกอบอุปกรณ์ใส่ในตู้พลาสติก
3.5.13 ประกอบไพลอตแลมป์และสวัตซ์ที่หน้าตู้พลาสติก
3.5.14 ทดสอบระบบหลังประกอบอุปกรณ์ต่าง ๆ เข้าในตู้พลาสติก

3.6 การติดตั้งระบบ
3.6.1 ติดตั้ง Flow Switch เข้ากับท่อส่งของปั๊มน ้า
3.6.2 ติดตั้งตู้พลาสติดไว้บริเวณตู้ควบคุมสั่งงานปั๊มน ้า
3.6.3 เชื่อมต่อสายไฟเพื่อเลี้ยงระบบแจ้งเตือน
3.6.4 เชื่อมสายสัญญาณ Flow Switch เข้ากับเทอร์มินอลภายในตู้ระบบแจ้งเตือน 3.6.5 เชื่อมต่อสายไฟเพื่อเป็นสัญญาณสั่งตัดการท างานของปั๊มน ้า
3.6.6 ตั้งค่าการรับสัญญาณ WiFi ให้กับระบบแจ้งเตือน
