PipeNitch/Project_WPNS-IoT/Documents/PumpIoT.pdf

A notification and shutdown system for water pumps using Internet of Things technology (IoT)

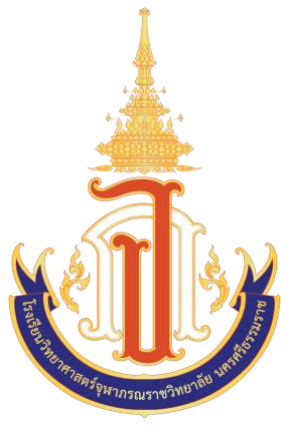
[picture p25: figure]

ระบบแจ้ง เตือนและตัดการท้างานปั๊มน ้าโดยใช้เทคโนโลยี อินเทอร์เน็ตในทุกสิ่ง (IoT)

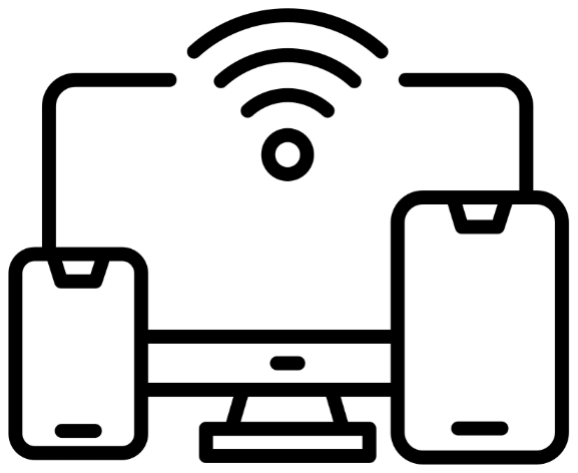
[picture p26: figure]

โรงเรียนวิทยาศาสตร์จุฬาภรณราชวิทยาลัย นครศรีธรรมราช

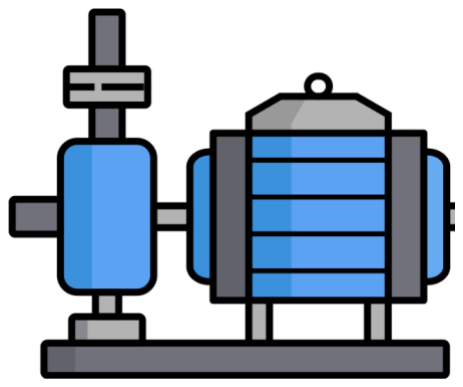
[picture p27: figure]
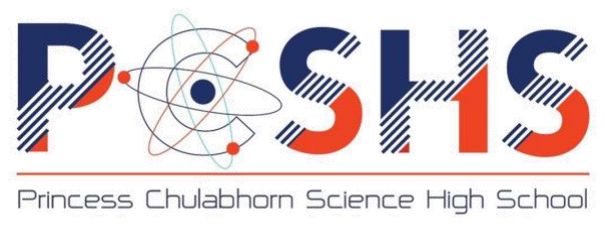
[picture p28: figure]
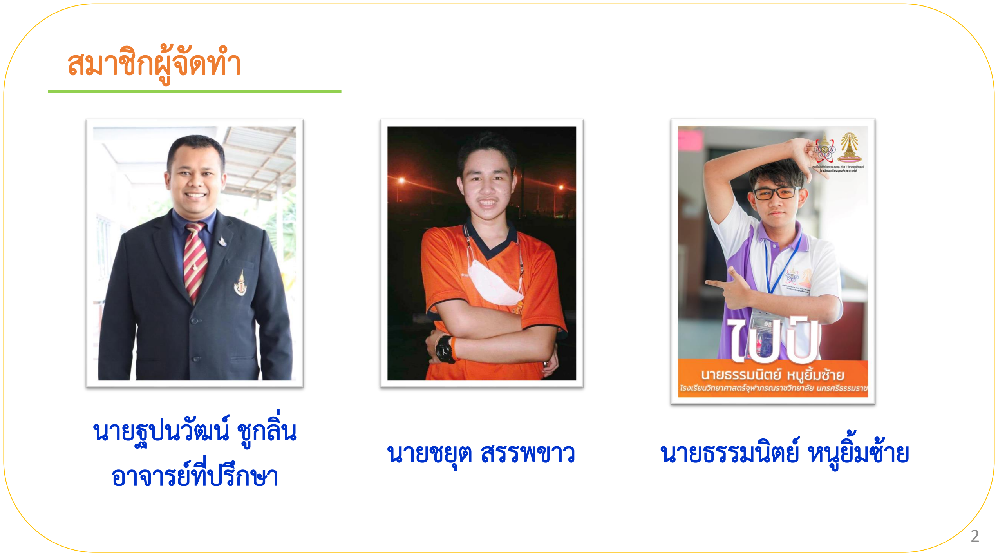
[picture p29: page 2]

### สมาชิกผู้จัดท้า

นายชยุต สรรพขาว นายธรรมนิตย์ หนูยิ มซ้าย

นายฐปนวัฒน์ ชูกลิ่น
อาจารย์ที่ปรึกษา

ทม

ี

่

### าและความสา

ค

ั

ญ

ความส าคัญ: ปั๊มน ้าเป็นอุปกรณ์ที่เราใช้กันทั่วไป ทั งในบ้านเรือน การเกษตร ระบบประปาหมู่บ้าน หรือระบบน ้าโรงเรียน จึงปฏิเสธไม่ได้เลยว่าปั๊มน ้ามีความ จ้าเป็นอย่างยิ่ง และหากเกิดปัญหา จะประทบกับผู้ใช้น ้าอย่างมาก

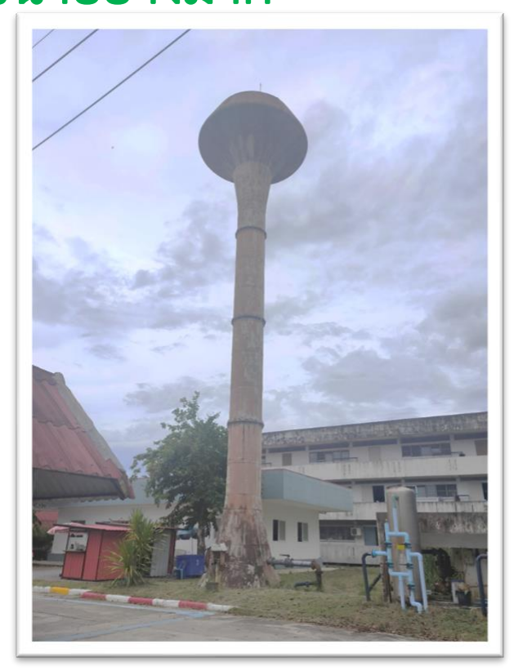
[picture p30: figure]
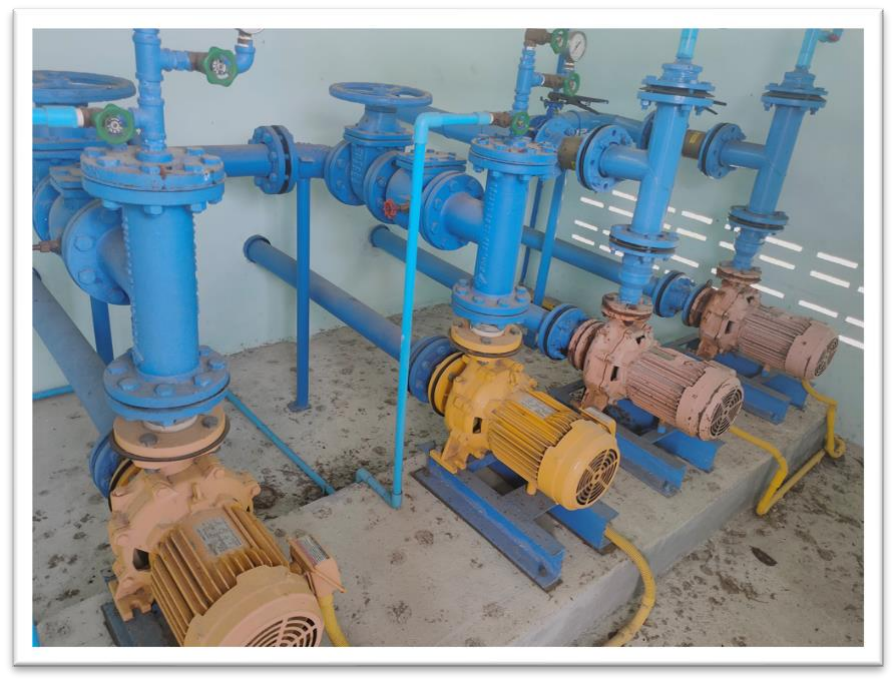
[picture p31: figure]

ทม

ี

่

### าและความสา

ค

ั

### ญ (ต่อ)

ปัญหา: หลายครั งจะพบว่า “ปั๊มน ้าท้างานแต่ไม่จ่ายน ้า” หรือเรียกว่า Dry Run ซึ่งมาจากหลายๆ สาเหตุ หากทราบปัญหาการท้างานที่ผิดปกติได้เร็วและได้แก้ไข ในทันที จะช่วยลดค่าใช้จ่ายได้เป็นอย่างมาก

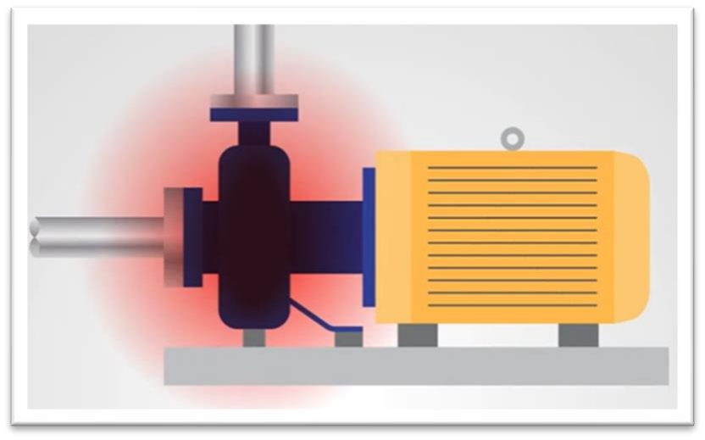
[picture p32: figure]
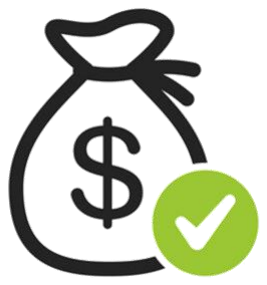
[picture p33: figure]
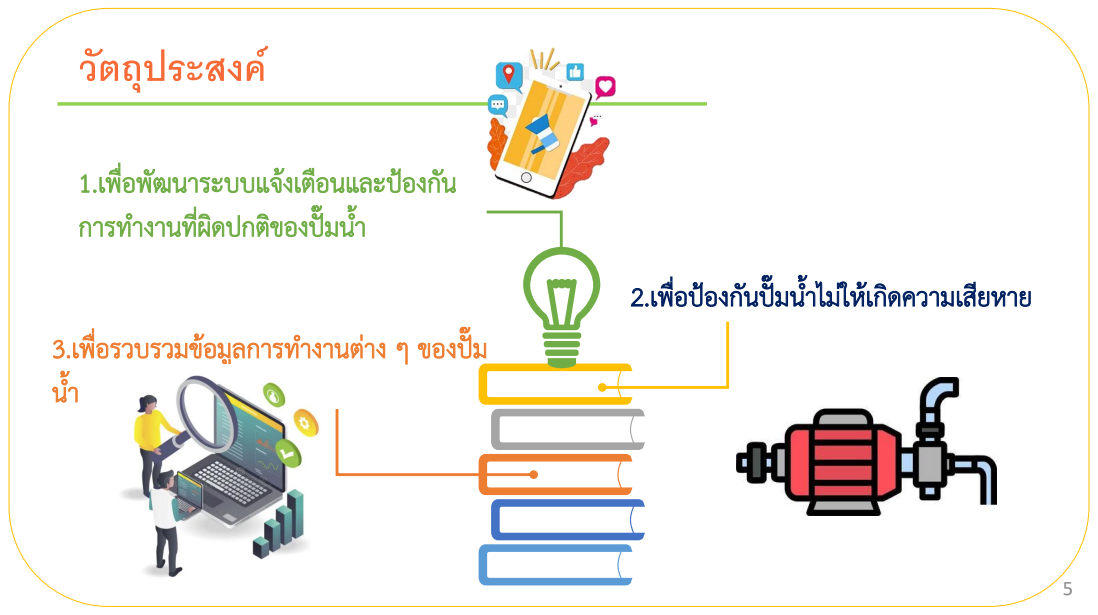
[picture p34: page 5]
วัตถุประสงค์

1.เพื่อพัฒนาระบบแจ้งเตือนและป้องกัน
การท้างานที่ผิดปกติของปั๊มน ้า

2.เพื่อป้องกันปั๊มน ้าไม่ให้เกิดความเสียหาย

3.เพื่อรวบรวมข้อมูลการท้างานต่าง ๆ ของปั๊ม

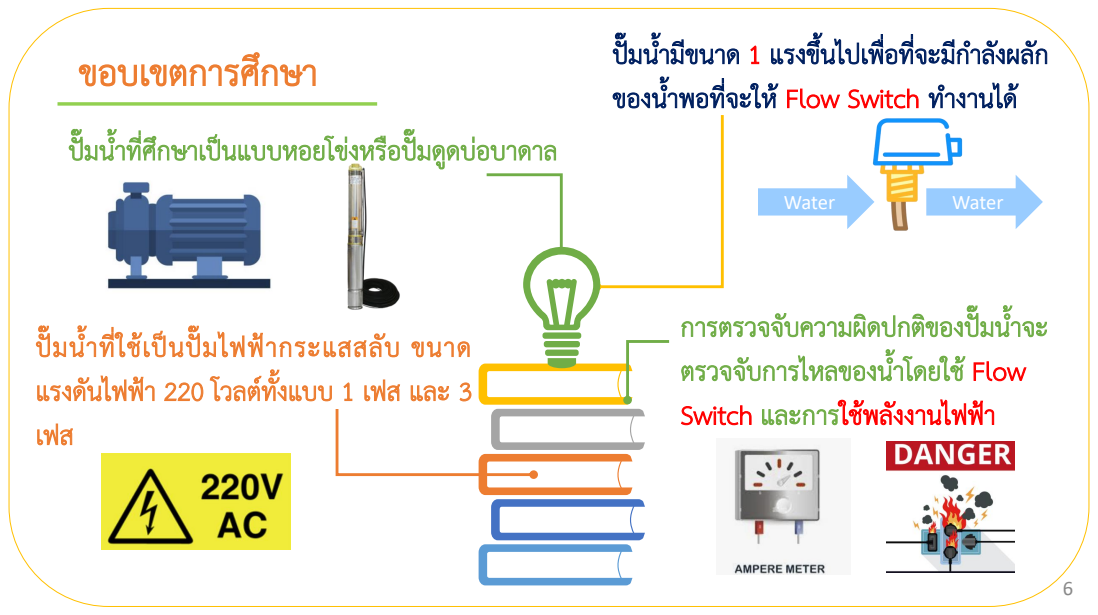
[picture p35: page 6]
ขอบเขตการศึกษา; Water

ปั๊มน ้ามีขนาด 1 แรงขึ นไปเพื่อที่จะมีก้าลังผลัก
ของน ้าพอที่จะให้ Flow Switch ท้างานได้

ปั๊มน ้าที่ศึกษาเป็นแบบหอยโข่งหรือปั๊มดูดบ่อบาดาล

การตรวจจับความผิดปกติของปั๊มน ้าจะ
ตรวจจับการไหลของน ้าโดยใช้Flow
Switch และการใช้พลังงานไฟฟ้า

ปั๊มน ้าที่ใช้เป็นปั๊มไฟฟ้ากระแสสลับ ขนาด
แรงดันไฟฟ้า 220 โวลต์ทั งแบบ 1 เฟส และ 3
เฟส

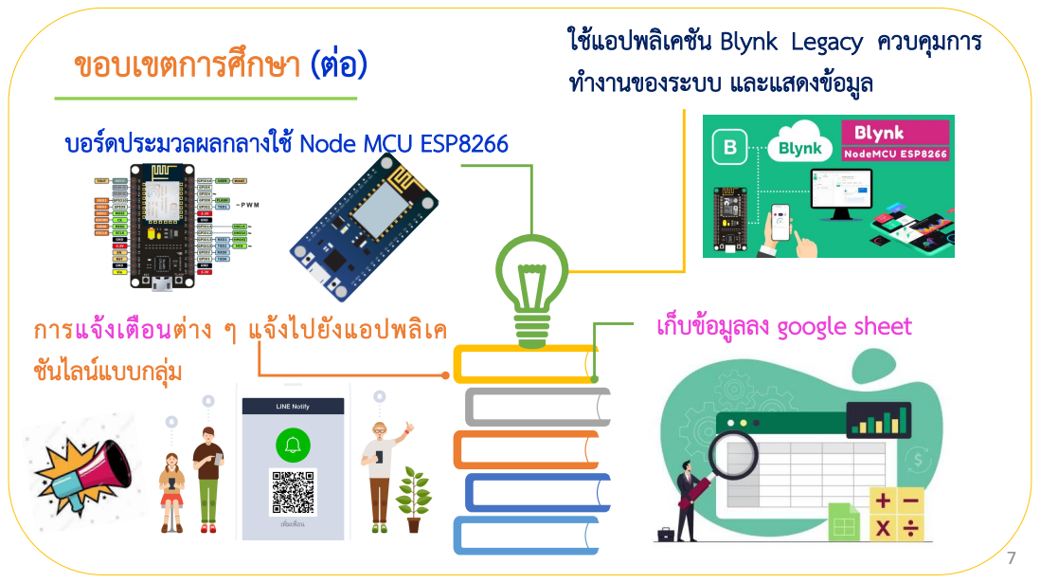
[picture p36: page 7]
ขอบเขตการศึกษา (ต่อ)

ใช้แอปพลิเคชัน Blynk Legacy ควบคุมการ
ท้างานของระบบ และแสดงข้อมูล

บอร์ดประมวลผลกลางใช้ Node MCU ESP8266

การแจ้งเตือนต่าง ๆ แจ้งไปยังแอปพลิเค
ชันไลน์แบบกลุ่ม

เก็บข้อมูลลง google sheet

### สมมติฐาน

ระบบจะเตือนและตัดการท้างานปั๊มน ้าเมื่อปั๊มน ้าท้างานแต่ไม่มีน ้าไหล (Dry Run) หรือปั๊มน ้าใช้พลังงานไฟฟ้าเกินกว่าที่ก้าหนด ซึ่งจะเป็นการ ป้องกันการเสียหายของปั๊มน ้าได้

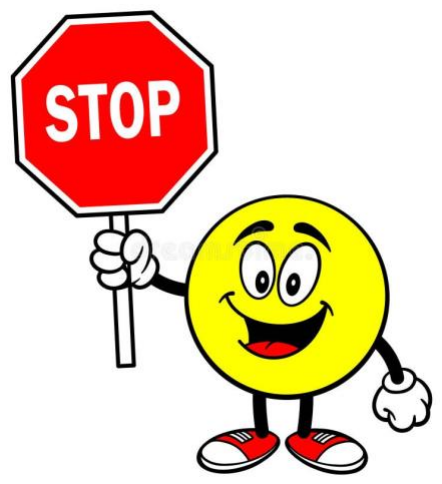
[picture p37: figure]
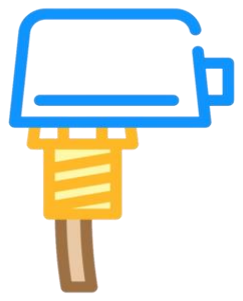
[picture p38: figure]

Water Not
Flow

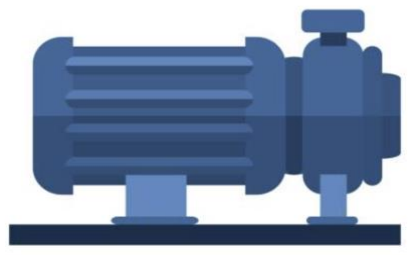
[picture p39: figure]

Over Load

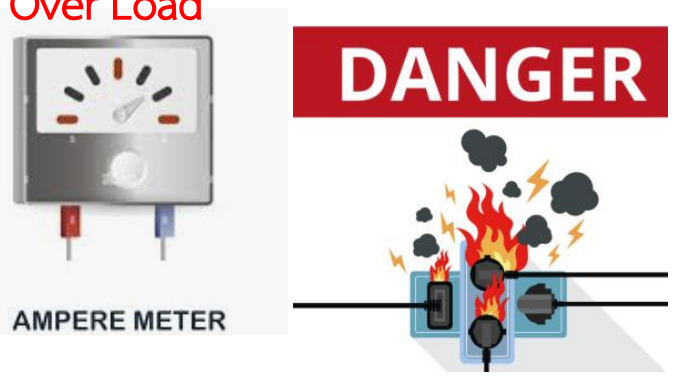
[picture p40: figure]

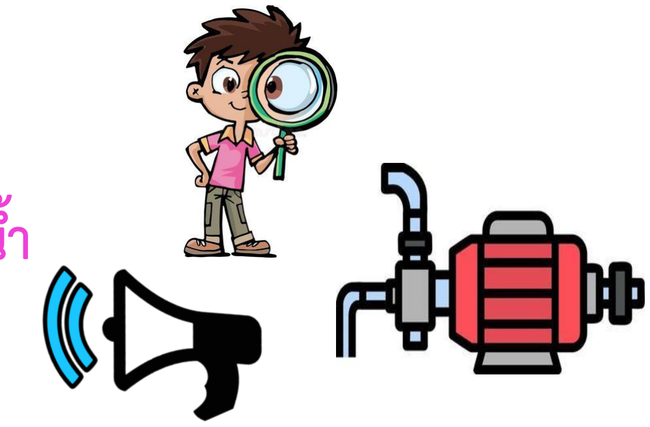
[picture p41: figure]

ตัวแปรต้น ระบบติดตามการท้างานของปั๊มน ้า

### ตัวแปรที่ศึกษา

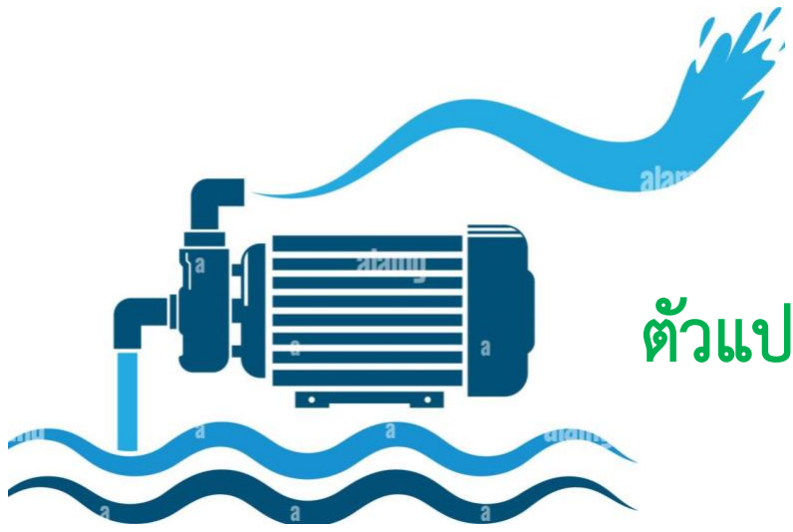
[picture p42: figure]

ตัวแปรตาม ประสิทธิภาพการท้างานของปั๊มน ้า

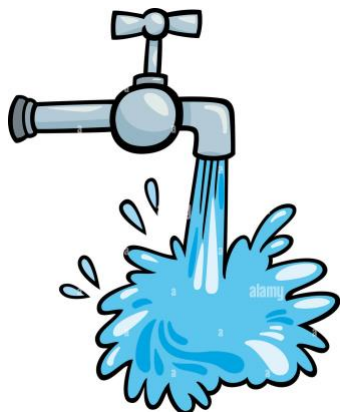
[picture p43: figure]

ตัวแปรควบคุม สภาพการใช้งานของปั๊มน ้า

### อุปกรณ์

ปั๊มน ้าหอยโข่งขนาด 1 แรง

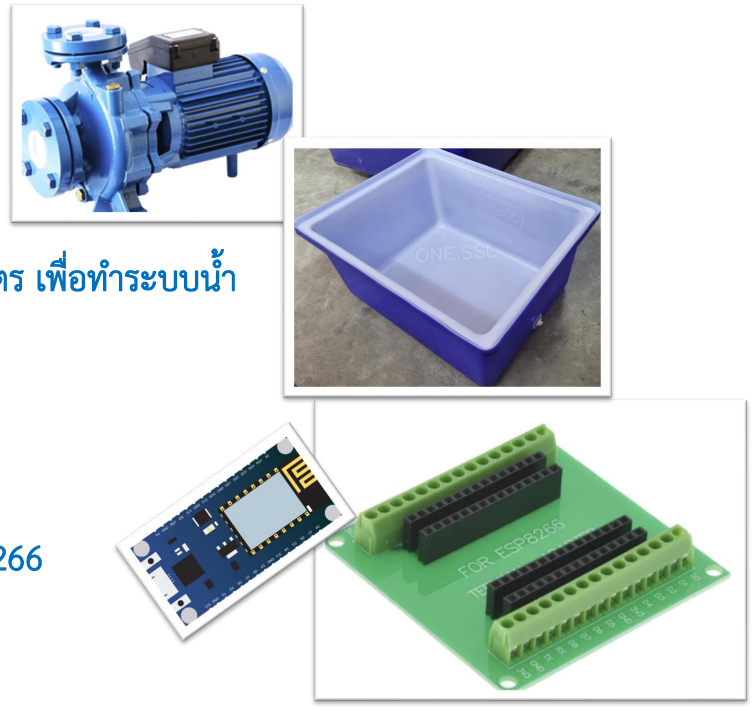
[picture p44: figure]

ถังน ้าพลาสติกขนาด 100 ลิตร เพื่อท้าระบบน ้า หมุนเวียน

บอร์ดประมวลผล ESP-8266
และซอกเกตเสียบบอร์ด ESP-8266

### อุปกรณ์

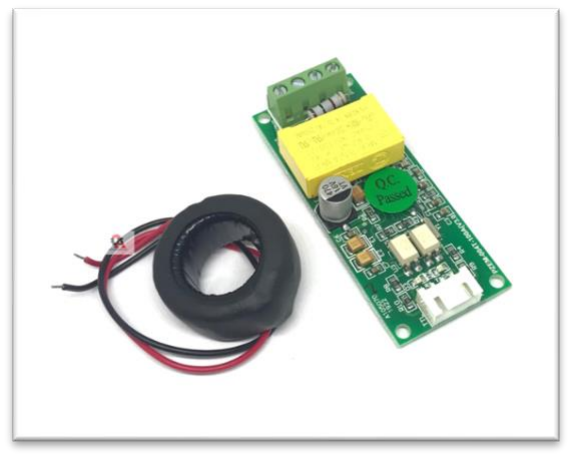
[picture p45: figure]
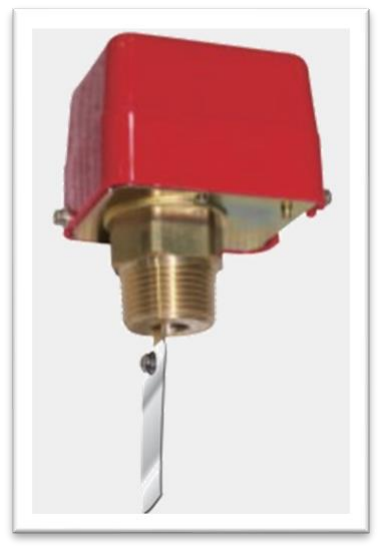
[picture p46: figure]

Flow Switch วัดการไหลของน ้าในท่อส่งน ้า

โมดูลวัดการใช้พลังงานไฟฟ้ากระแสสลับ

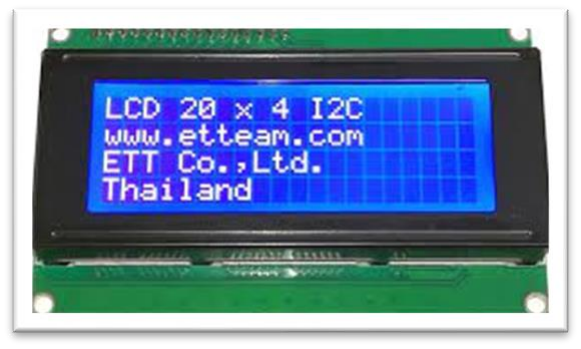
[picture p47: figure]

หน้าจอแสดงผลแบบ LCD ขนาด 20 x 4

### อุปกรณ์

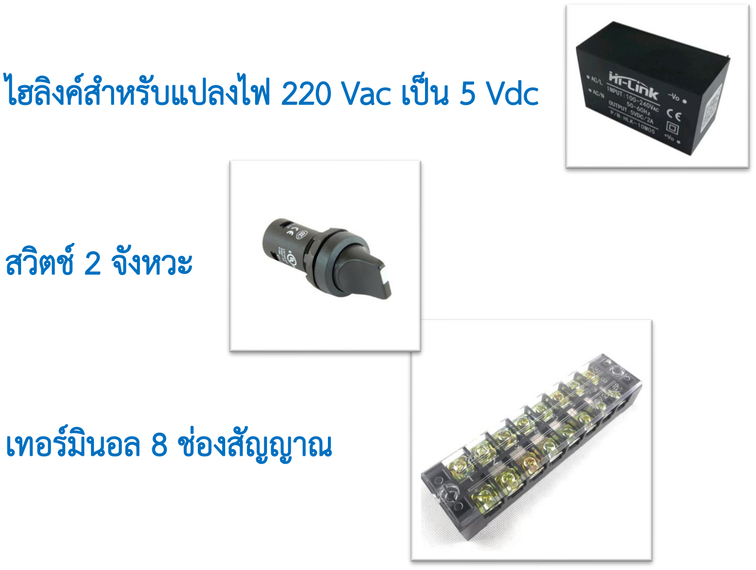
[picture p48: figure]
ไฮลิงค์ส้าหรับแปลงไฟ 220 Vac เป็น 5 Vdc; เทอร์มินอล 8 ช่องสัญญาณ; สวิตช์ 2 จังหวะ

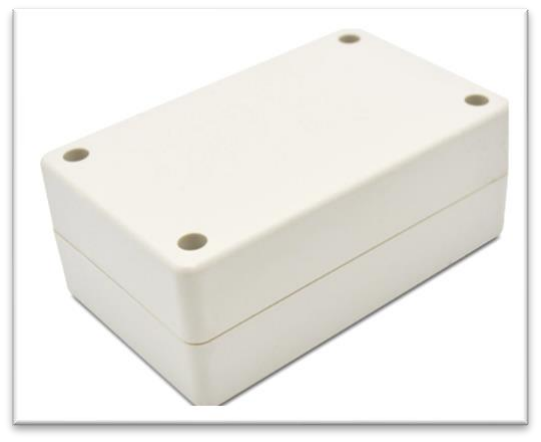
[picture p49: figure]

โมดูลรีเลย์ 2 ช่อง

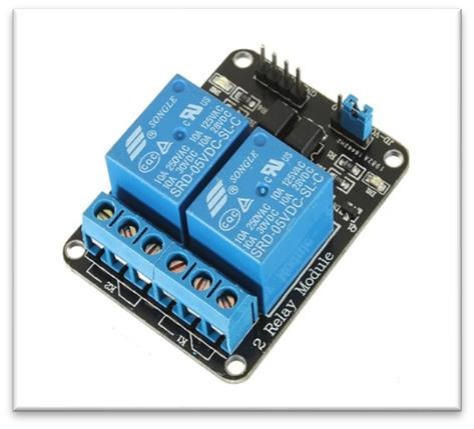
[picture p50: figure]
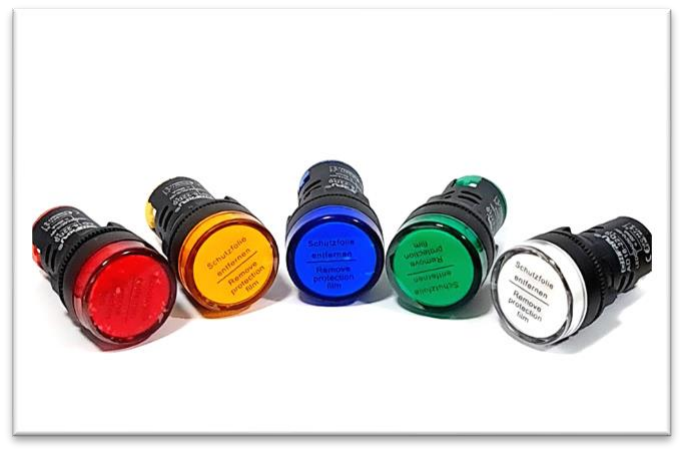
[picture p51: figure]

Pilot Lamp ไฟแสดงสถานะ

### อุปกรณ์

กล่องพลาสติก

เราเตอร์โมเดมแบบใส่ Sim เครือข่ายโทรศัพท์มือถือ และ Sim โทรศัพท์มือถือพร้อมสัญญาณอินเทอร์เน็ต

### อุปกรณ์

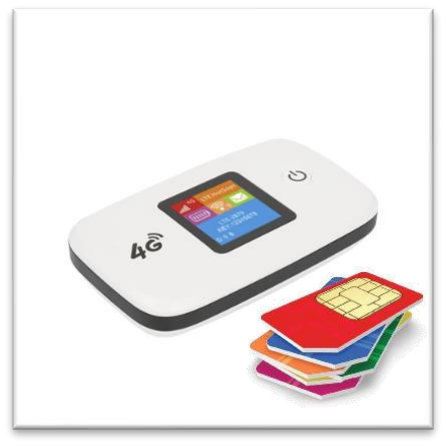
[picture p52: figure]
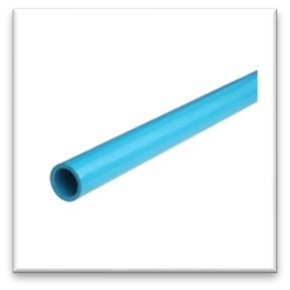
[picture p53: figure]
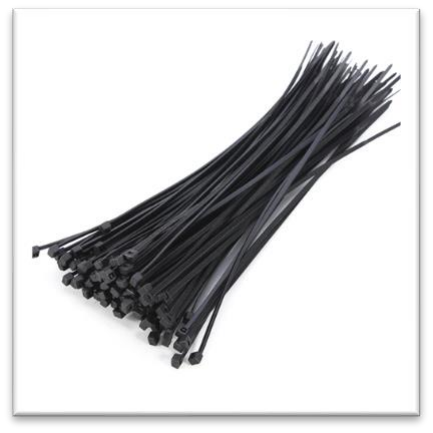
[picture p54: figure]
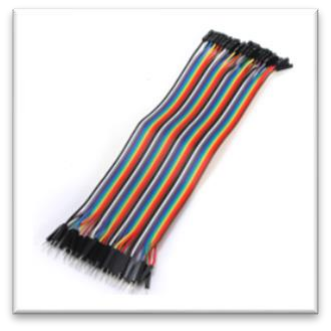
[picture p55: figure]

อื่น ๆ เช่น ท่อ PVC สายไฟ เคเบิ ลไทร์ น๊อต สกรู วาล์วน ้า

1

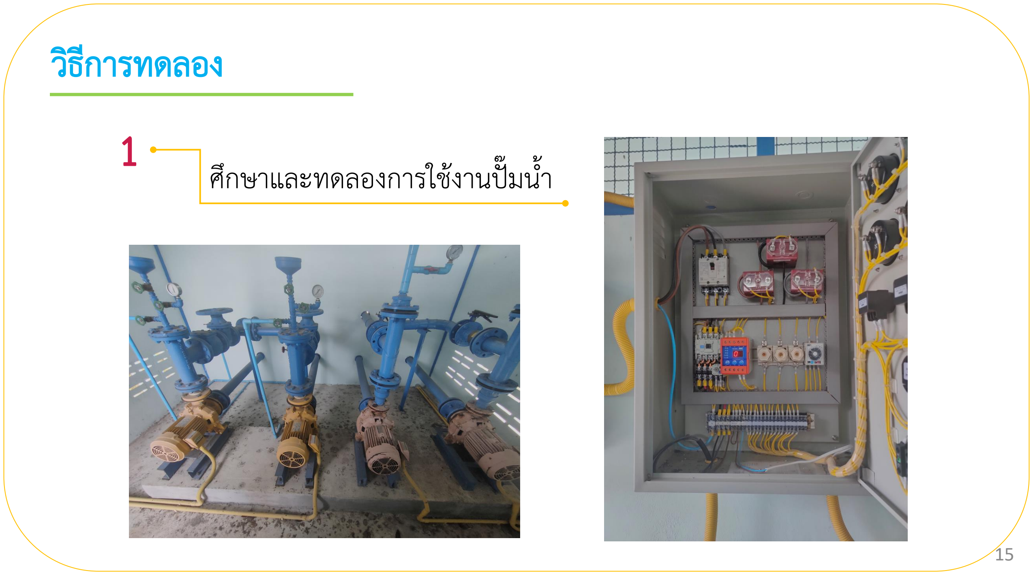
[picture p56: page 15]

### วิธีการทดลอง

ศึกษาและทดลองการใช้งานปั๊มน ้า

### วิธีการทดลอง : ต่อ

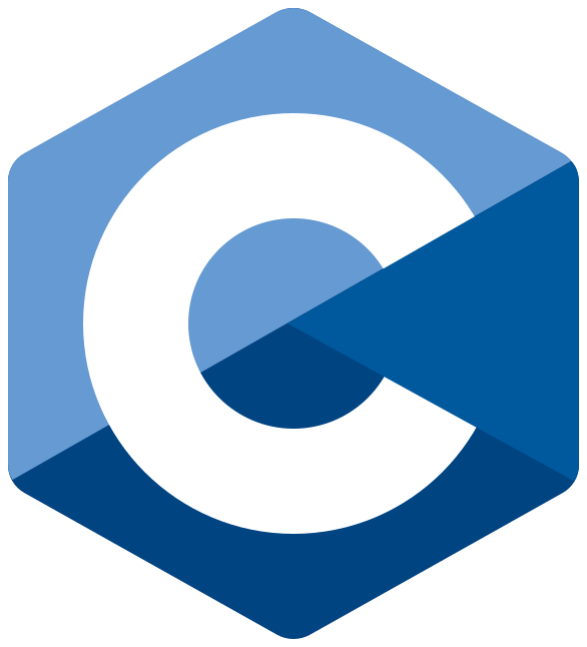
[picture p57: figure]

2

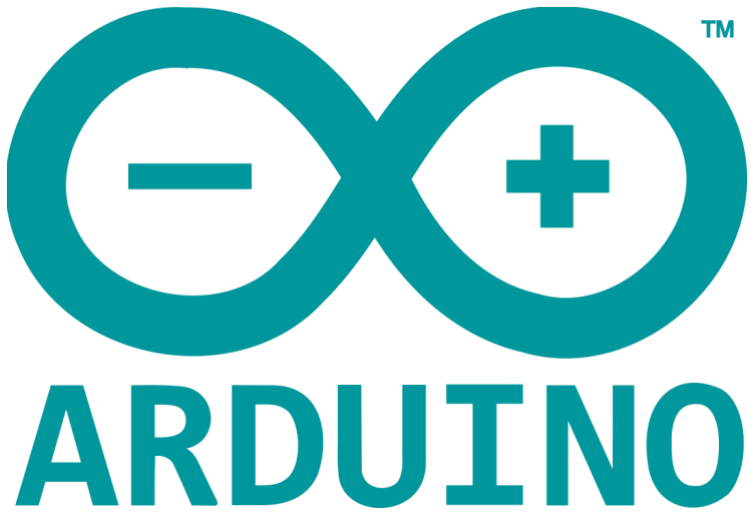
[picture p58: figure]

ติดตั งโปรแกรมภาษา C ส้าหรับบอร์ด Arduino

### วิธีการทดลอง : ต่อ

3
ทดลองเขียนโปรแกรมเพื่อควบคุมบอร์ด ESP 8266

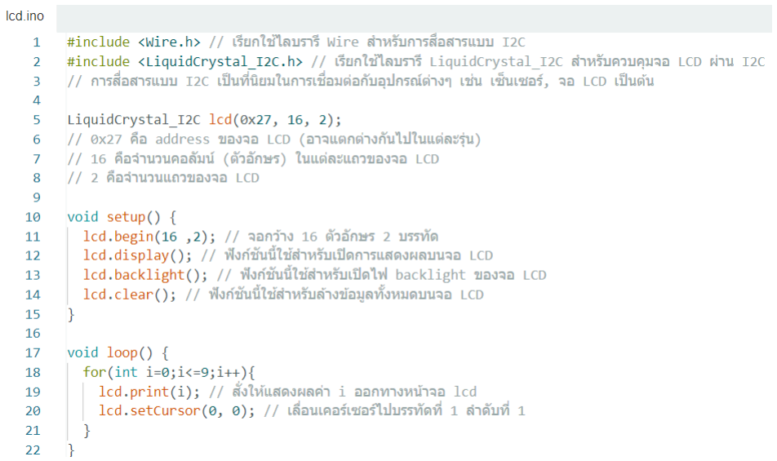
[picture p59: figure]

เขียนโปรแกรมให้บอร์ด ESP 8266 ตรวจจับการท้างานของ Flow Switch

### วิธีการทดลอง : ต่อ

5

4
ศึกษาและทดลองการท้างานของ Flow Switch

ศึกษาและทดลองโมดูลวัดพลังงานไฟฟ้า

6

เขียนโปรแกรมให้บอร์ด ESP 8266 ตรวจกับการใช้พลังงานไฟฟ้า

7

### วิธีการทดลอง : ต่อ

เขียนโปรแกรมเชื่อมต่อบอร์ด
ESP 8266 เข้ากับ แอปพลิเคชันไลน์

9

8 เขียนโปรแกรมเชื่อมต่อบอร์ด ESP 8266 เข้ากับ แอปพลิเคชัน Blynk

เขียนโปรแกรมในส่วนของเงื่อนไขการ แจ้งเตือนและตัดการท้างานของปั๊ม

10

### วิธีการทดลอง : ต่อ

11
ทดสอบระบบในส่วนของโปรแกรมในภาพรวมทั งหมด

ประกอบอุปกรณ์ใส่ในตู้พลาสติก

12

ประกอบ Pilot Lamp และสวิตช์ที่หน้าตู้พลาสติก 13

ทดสอบระบบหลังประกอบอุปกรณ์ต่าง ๆ เข้าในตู้พลาสติก

14

### โครงสร้างระบบทางด้านฮาร์ดแวร์

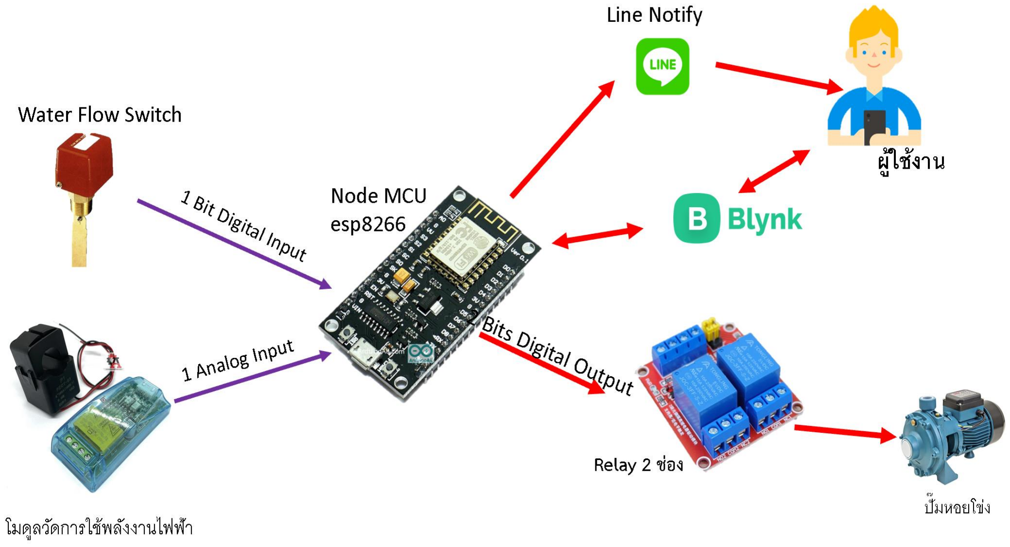
[picture p60: figure]
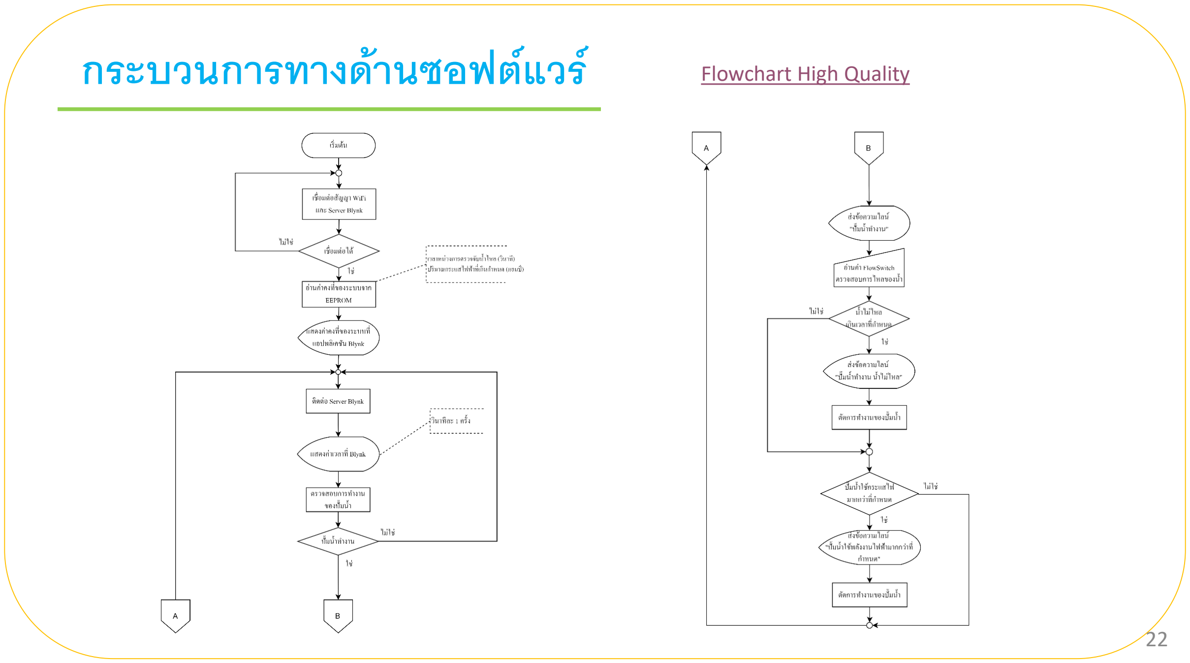
[picture p61: page 22]

### กระบวนการทางด้านซอฟต์แวร์

Flowchart High Quality

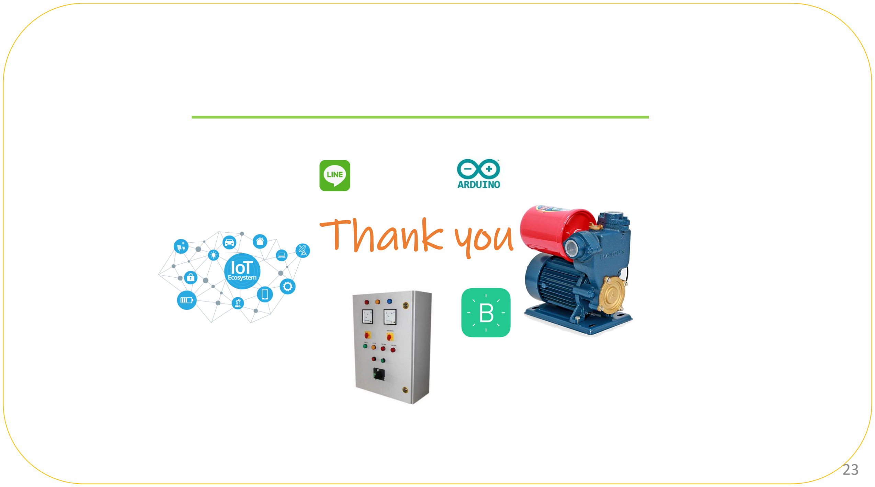
[picture p62: page 23]

Thank you
