PipeNitch/Project_WPNS-IoT/Example/รวมเล่ม_ระบบอัตโนมัติแบบออนไลน์สำหรับควบคุมอุปกรณ์ไฟฟ้าเพื่อการประหยัดพลังงาน.pdf

### ระบบอตัโนมัติแบบออนไลน

์

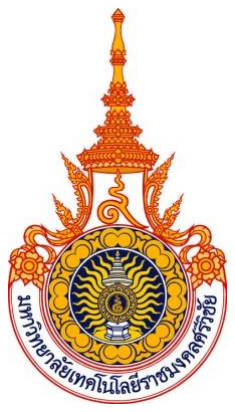
[picture p63: figure]

### ส ำหรับควบคุมอปุ กรณ

### ์ไฟฟ้

### ำเพ

### ื่อกำรประหยัดพลงังำน กรณีศึกษำ คณะวิทยำศำสตร์และเทคโนโลยี มหำวิทยำลัยเทคโนโลยีรำชมงคลศรีวิชัย

AN ONLINE AUTOMATIC SYSTEM FOR CONTROL ELECTRIC DEVICE FOR ENERGY SAVING: A CASE STUDY AT FACULTY OF SCIENCE AND TECHNOLOGY RAJAMANGALA UNIVERSITY OF TECHNOLOGY SRIVIJAYA

คณำธิป ศรีอ่อน
KANATHIP SRION
ณพิชญ์ แน่พิมำย
NAPICH NAEPIMAI
พรพนิต อินทร์แก้ว
PRONPANIT INKAEW

ปริญญำนิพนธ์นีเ้ป็นส่วนหนึ่งของกำรศึกษำตำมหลกัสูตรวิทยำศำสตรบัณฑิต สำขำวิชำเทคโนโลยีสำรสนเทศ คณะวิทยำศำสตร์และเทคโนโลยี มหำวิทยำลัยเทคโนโลยีรำชมงคลศรีวิชัย ปี กำรศึกษำ 2565

หัวข้อปริญญำนิพนธ์ ระบบอัตโนมัติแบบออนไลน์ส ำหรับควบคุมอุปกรณ์ไฟฟ้ำเพื่อกำรประหยัด พลังงำน กรณีศึกษำ คณะวิทยำศำสตร์และเทคโนโลยี มหำวิทยำลัยเทคโนโลยี รำชมงคลศรีวิชัย
นักศึกษำ | นำยคณำธิป ศรีอ่อน
| นำยณพิชญ์ แน่พิมำย นำงสำวพรพนิต อินทร์แก้ว
อำจำรย์ที่ปรึกษำ | อำจำรยส์ รำญพงศ์หนูยมิ้ ซำ้ย
| อำจำรย์สุธำพร เกตุพันธ์

สำขำวิชำเทคโนโลยีสำรสนเทศ คณะวิทยำศำสตร์และเทคโนโลยี มหำวิทยำลัย เทคโนโลยีรำชมงคลศรี วิชัย อนุมัติให้ปริ ญญำนิพนธ์ เป็ นส่วนหนึ่ งของกำรศึกษำตำมหลักสูตร วิทยำศำสตรบัณฑิต

| ประธำนหลักสูตร
(ผู้ช่วยศำสตรำจำรย์ ดร.ชัชฎำ หนูสำย)

คณะกรรมกำรสอบปริญญำนิพนธ์

| ประธำนกรรมกำร
(อำจำรยส์ รำญพงศ์หนูยมิ้ ซำ้ย)
| กรรมกำร
(อำจำรย์ชริยำ นนทกำญจน์)
| กรรมกำร
(อำจำรย์วิสำลักข์คุณธนรุ่งโรจน์)

มหำวิทยำลัยเทคโนโลยีรำชมงคลศรีวิชัย

I

หัวข้อปริญญำนิพนธ์ ระบบอัตโนมัติแบบออนไลน์ส ำหรับควบคุมอุปกรณ์ไฟฟ้ำเพื่อกำรประหยัด พลังงำน กรณีศึกษำ คณะวิทยำศำสตร์และเทคโนโลยี มหำวิทยำลัยเทคโนโลยี รำชมงคลศรีวิชัย
นักศึกษำ | นำยคณำธิป | ศรีอ่อน | รหัส 363202360040
| นำยณพิชญ์ | แน่พิมำย | รหัส 363202360056
นำงสำวพรพนิต อินทร์แก้ว | รหัส 363202360060
อำจำรย์ที่ปรึกษำ | อำจำรยส์ รำญพงศ์หนูยมิ้ ซำ้ย
อำจำรย์ที่ปรึกษำ | อำจำรย์สุธำพร เกตุพันธ์
สำขำวิชำ | เทคโนโลยีสำรสนเทศ
ปี กำรศึกษำ | 2565

บทคัดย่อ
โครงงำนวิจยัน้ีเป็นกำรสร้ำงระบบอตัโนมตัิแบบออนไลน์ส ำหรับควบคุมอุปกรณ์ไฟฟ้ำเพื่อกำร ประหยัดพลังงำน กรณีศึกษำ คณะวิทยำศำสตร์และเทคโนโลยี มหำวิทยำลัยเทคโนโลยีรำชมงคลศรีวิชัย ระบบสำมำรถควบคุมได้2 ทำง คือ ควบคุมที่หน้ำตูร้ะบบรับคำ สั่งจำกกำรกดแป้นคียแ์ พด และควบคุม ออนไลน์จำก Application Blynk กำรทำ งำนของระบบสำมำรถต้งัค่ำกำรทำ งำนได้2 รูปแบบ คือ1. ระบบ สำมำรถท ำงำนได้อัตโนมัติเพื่อให้ระบบสำมำรถท ำงำนได้เองตำมควำมต้องกำรของผู้ใช้ 2. ระบบสำมำรถ เปิ ดหรือปิ ดอุปกรณ์ด้วยมือตำมควำมต้องกำรของผู้ใช้
กำรออกแบบ ผู้วิจัยได้ประยุกต์ใช้ไมโครคอลโทรลเลอร์แบบ Arduino รุ่น ATmega2560 ร่วมกับ บอร์ด Node MCU 8266 เพื่อเชื่อมต่ออินเทอร์เน็ต โดยมี แมคเนติกสวิสต์ในกำรควบคุมกำรเปิ ดหรือปิ ด ของระบบ
ผลกำรทดลองพบว่ำระบบอัตโนมัติแบบออนไลน์ส ำหรับควบคุมอุปกรณ์ไฟฟ้ำเพื่อกำรประหยัด พลังงำน กรณีศึกษำ คณะวิทยำศำสตร์และเทคโนโลยี มหำวิทยำลัยเทคโนโลยีรำชมงคลศรีวิชยัน้นั สำมำรถ ช่วยประหยัดพลังงำนไฟฟ้ำและช่วยในกำรตรวจสอบกำรใช้งำนของอุปกรณ์ไฟฟ้ำ รวมถึงกำรควบคุมระบบ กำรเปิดหรือปิดเครื่องใชไ้ฟฟ้ำไดง้่ำยข้ึน
ค ำส ำคัญ : ประหยัดพลังงำน กำรควบคุม อุปกรณ์ไฟฟ้ำ กำรตรวจวัด

II

Thesis Title | An Online Automatic System for Control Electric Device for Energy Saving:
A Case Study at Faculty of Science and Technology Rajamangala a University of TechnologySrivijaya.
Authors | Mr. Kanathip Srion | ID 363202360040
| Mr. Napich Naepimai | ID 363202360056
| Ms.Pronpanit Inkaew | ID 363202360060
Advisors | Mr. Saranpong Nooyimsai
Advisors | Mr. Sutaporn Getpan
Field of Study | Information Technology
Academic Year | 2023

Abstract
This research project is to create an online automation system for controlling electrical equipment for energy saving. A case study of the Faculty of Science and Technology. Rajamangala University of Technology Srivijaya The system can be controlled in 2 ways: control at the front of the system cabinet receiving commands from pressing the keypad. And control online from Application Blynk. The operation of the system can be set to work in 2 ways: 1. The system can work automatically so that the system can work by itself according to the user's needs. 2. The system can turn on or off the device by hand. according to user requirements.
The researcher has applied the Arduino microcontroller model ATmega2560 with the Node MCU 8266 board to connect to the Internet, with a magnetic switch to control the opening or closing of the system.
The experimental results showed that an online automation system for controlling electrical equipment for energy saving is a case study of the Faculty of Science and Technology. Rajamangala University of Technology Srivijaya It can save electricity and helps to monitor the usage of electrical equipment. Including controlling the system to turn on or off electrical appliances easie.
Keywords : Energy saving, Control, Electrical Equipment, Measurement

III

กิตติกรรมประกำศ

โครงกำรวิจยัฉบบั น้ีส ำเร็จได้ดว้ยควำมช่วยเหลือและสนับสนุนจำกบุคคลหลำยฝ่ำยคณะผูจ้ัดทำ โครงกำรวิจยัรู้สึกซำบซ้ึงเป็นอยำ่ งยงิ่ และขอกรำบขอบพระคุณมำ ณ โอกำสน้ีดว้ย
ขอขอบคุณอำจำรยส์ รำญพงศ์หนูยิ้มซ้ำย ที่กรุณำเป็ นที่ปรึกษำโครงกำรวิจัยเป็ นแรงกระตุ้นให้ คำ ปรึกษำขอ้ เสนอแนะทำงวิชำกำรแนวทำงแก้ไขปัญหำต่ำง ๆ ตลอดจนตรวจทำนกำรวิจยัให้แก่คณะ ผู้จัดท ำมำโดยตลอด
ขอขอบคุณอำจำรย์สุธำพร เกตุพันธ์อำจำรย์ประจ ำหลักสูตรสำขำอุตสำหกรรมศำสตรบัณฑิต คณะ วิทยำสำสตร์และเทคโนโลยีที่กรุณำเป็ นที่ปรึกษำร่วมโครงกำรวิจัย ได้อนุเครำะห์สถำนที่และอุปกรณ์ รวมถึงกำรให้ค ำแนะน ำเกี่ยวกับกำรควบคุมอุปกรณ์ไฟฟ้ำเป็ นอย่ำงดี ขอขอบคุณคณำจำรย์ในหลักสูตรวิทยำศำสตรบัณฑิต สำขำวิชำเทคโนโลยีสำรสนเทศ ทุกท่ำนที่ ประสิทธิ์ ประสำทวิชำให้สำมำรถมีควำมรู้ ส ำหรับกำรศึกษำและท ำโครงกำรวิจัย ขอขอบคุณคณำจำรย์และเจ้ำหน้ำที่ คณะวิทยำศำสตร์และเทคโนโลยีมหำวิทยำลัยเทคโนโลยีรำช มงคลศรีวิชัย ที่ให้เอกสำรควำมรู้และค ำปรึกษำต่ำง ๆ ที่เป็ นประโยชน์ต่อกำรจัดท ำโครงกำรวิจัย ขอขอบคุณเพื่อน ๆ ทุกคนในห้องปฏิบตัิกำรไมโครคอมพิวเตอร์และอินเตอร์เฟส อำคำร 10 ช้นั 2 สำขำวิทยำศำสตร์คอมพิวเตอร์ คณะวิทยำศำสตร์และเทคโนโลยี มหำวิทยำลัยเทคโนโลยีรำชมงคลศรีวิชัย ที่ ใหค้วำมช่วยเหลือและคำ แนะนำ ต่ำง ๆ รวมท้งัใหก้ำ ลงัใจเสมอมำ
ที่ส ำคัญที่สุด คณะผู้จัดท ำขอน้อมร ำลึกถึงพระคุณของบิดำมำรดำและครอบครัวที่ส่งเสริมและ สนับสนุนคณะผู้จัดท ำในทุกเรื่องตลอดมำจนส ำเร็จกำรศึกษำ คุณค่ำและประโยชน์อันพึงมีจำกโครงกำรวิจัย ฉบบั น้ีขำ้พเจำ้ขอมอบแด่ผมู้ีพระคุณทุกท่ำน

คณำธิป ศรีอ่อน
ณพิชญ์ แน่พิมำย
พรพนิต อินทร์แก้ว

IV

สำรบัญ
หน้ำ
บทคัดย่อ | I
กิตติกรรมประกำศ | III
สำรบัญ | IV
สำรบัญตำรำง | VI
สำรบัญรูป | VII
บทที่1 บทน ำ | 1
1.1 ควำมเป็ นมำและควำมส ำคัญ | 1
1.2 วัตถุประสงค์ของกำรวิจัย | 2
1.3 ขอบเขตของกำรวิจัย | 2
1.4 ประโยชน์ที่คำดว่ำจะได้รับจำกงำนวิจัย | 2
1.5 ระเบียบวิธีกำรวิจัย | 2
1.6 ระยะเวลำกำรด ำเนินกำร | 3
1.7 สถำนที่ท ำกำรวิจัย | 3
1.8 เครื่องมืออุปกรณ์และซอฟต์แวร์ที่ใช้ในกำรพัฒนำ | 3
บทที่2 ทฤษฎีและงำนวิจัยที่เกี่ยวข้อง | 5
2.1 ทฤษฎีเกี่ยวกับกำรประหยัดไฟฟ้ำ | 5
2.2 ทฤษฎีเกี่ยวกับบอร์ด MEGA WiFi Dev Board | 6
2.3 ทฤษฎีเกี่ยวกับบอร์ด ESP8266 | 7
2.4 ทฤษฎีเกี่ยวกับโมดูลวัดปริมำณกำรใช้ไฟฟ้ำPZEM-004T | 8
2.5 ทฤษฎีเกี่ยวกับโมดูล Relay ขนำด 4 ช่องสัญญำณ | 9
2.6 ทฤษฎีเกี่ยวกับ Magnetic switch | 10
2.7 ทฤษฎีเกี่ยวกับคีย์แพดขนำด 4x4 | 12
2.8 ทฤษฎีเกี่ยวกับจอแสดงผล LCD 20x4 | 12
2.9 ทฤษฎีเกี่ยวกับ Application Line | 13
2.10 ทฤษฎีเกี่ยวกับ Blynk version 2.27.24 | 14
2.11 ทฤษฎีเกี่ยวกับ Switching Power Supply | 15

V

สำรบัญ (ต่อ)
หน้ำ
2.12 ทฤษฎีเกี่ยวกบักำรเพิ่มขอ้มูลระหวำ่ งบอร์ด | 16
2.13 งำนวิจัยที่เกี่ยวข้อง | 17
บทที่3กำรวิเครำะห์และออกแบบระบบ | 24
3.1 ข้นั ตอนกำรวิเครำะห์ปัญหำ | 24
3.2 ข้นั ตอนกำรออกแบบระบบ | 25
บทที่4 ผลกำรด ำเนินงำน | 36
4.1 กำรออกแบบระบบด้ำนฮำร์ดแวร์ | 36
4.2 กำรออกแบบระบบด้ำนซอฟต์แวร์ | 37
4.3 กำรประเมินควำมพึงพอใจของผู้ใช้ระบบ | 42
บทที่5 สรุปกำรด ำเนินงำน | 46
5.1 สรุปผล | 46
5.2 อุปสรรคและปัญหำ | 52
5.3 แนวทำงกำรแก้ปัญหำ | 52
5.4 ข้อเสนอแนะ | 52
บรรณำนุกรม | 53
ภำคผนวกกข้นั ตอนและวิธีกำรติดต้งัโปรแกรม | 55
ภำคผนวกขคู่มือกำรใช้งำนระบบ | 58
ภำคผนวกค ภำพรวมชิ้นงำน | 68
ภำคผนวกง งบประมำณเพื่องำนวิจัย | 72
ประวัติผู้จัดท ำปริญญำนิพนธ์ | 74

VI

สำรบัญตำรำง
ตำรำงที่ | หน้ำ
1.1ระยะเวลำกำรท ำวิจัย | 3
4.1 ผลกำรวิเครำะห์แบบสอบถำมควำมพึงพอใจด้ำนประสิทธิภำพของกำรท ำงำนระบบ | 44
4.2 ผลกำรวิเครำะห์แบบสอบถำมควำมพึงพอใจด้ำนกำรท ำงำนตำมฟังก์ชันของระบบ | 44
4.3 ผลกำรวิเครำะห์แบบสอบถำมควำมพึงพอใจด้ำนกำรน ำไปใช้ประโยชน์ | 45
5.1 บันทึกข้อมูลกำรทดสอบ | 52
ง.1 งบประมำณเพื่อกำรวิจัย | 73

VII

สำรบัญรูป
รูปที่ | หน้ำ
2.1 MEGA WiFi Dev Board | 7
2.2 ESP 8266 | 8
2.3 โมดูลวัดปริมำณไฟฟ้ำ PZEM-004T | 9
2.4 Relay ขนำด 4 ช่องสัญญำน | 9
2.5กำรใช้งำนของ Relay | 10
2.6แมกเนติกคอนแทคเตอร์ / แมกเนติกสวิตช์ | 11
2.7 กำรท ำงำนของแมกเนติก | 11
2.8 แป้นปุ่ มกดแบบ 4x4 | 12
2.9 จอแสดงผล LCD I2C | 13
2.10 Application Line ส ำหรับกำรแจ้งเตือนกำรท ำงำน | 13
2.11โปรแกรม Blynk | 14
2.12 หน้ำจอ App ที่ท ำกำรออกแบบโดยผู้ใช้ผ่ำนโปรแกรม Blynk | 15
2.13 Switching Power Supply | 15
2.14รูปแบบกำรรับส่งข้อมูลแบบซิงโครนัส | 16
2.15รูปแบบกำรรับส่งข้อมูลแบบอะซิงโครนัส | 17
2.16กำรออกแบบด้ำนฮำร์ดแวร์ | 18
2.17โครงสร้ำงภำยในกล่องควบคุมระบบ | 19
2.18 Flow chart กำรท ำงำนของระบบโดยรวม | 20
2.19 แผนผงักำรติดต้งั | 22
2.20อุปกรณ์ภำยในตู้ระบบ | 23
3.1แผนภำพบริบทของระบบ | 26
3.2ผงังำนข้นั ตอนกำรทำ งำนของระบบโดยรวมที่บอร์ด ATmega2560 | 27
3.3 ผังงำนกำรท ำงำนของโหมดอัตโนมัติที่บอร์ด ATmega2560 (Auto Mode) | 30
3.4ผังงำนกำรท ำงำนของโหมดก ำหนดเองที่บอร์ด ATmega2560 (Manual Mode) | 32
3.5ผังงำนกำรท ำงำนที่บอร์ด NodeMCU Esp8266 | 34
4.1โครงสร้ำงระบบด้ำนฮำร์ดแวร์ | 36

VIII

สำรบัญรูป (ต่อ)
รูปที่ | หน้ำ
4.2แสดงหน้ำจอ Monitor Application Blynk | 37
4.3โค้ดควบคุม เปิ ด/ปิ ด อุปกรณ์ไฟฟ้ำแบบก ำหนดเอง | 38
4.4โค้ดโปรแกรมหน้ำจอกำรท ำงำนอัตโนมัติ | 38
4.5โค้ดโปรแกรมหน้ำจอกำรท ำงำนแบบก ำหนดเวลำ | 38
4.6 หนำ้จอแสดงกำรต้งัค่ำกำรทำ งำนอตัโนมตัิ | 39
4.7โคด้โปรแกรมหนำ้จอกำรต้งัค่ำกำรทำ งำนแบบอตัโนมตัิ | 39
4.8 หนำ้จอแสดงกำรต้งัค่ำแบบกำ หนดเวลำ | 40
4.9 โค้ดโปรแกรมหน้ำจอกำรท ำงำนแบบก ำหนดเวลำ | 40
4.10 หน้ำจอแสดงกรำฟข้อมูลกำรใช้งำน | 41
4.11 กำรบันทึกข้อมูล | 42
5.1แผนกำรติดต้งัระบบ | 46
5.2 ด้ำนหน้ำตู้ควบคุมระบบ | 47
5.3ผังกำรเชื่อมต่อสำยสัญญำณ | 48
5.4 ภำยในตู้ควบคุมระบบ | 49
5.5กำรติดต้งัตูร้ะบบใตอ้ำคำร9 ช้นั 1 | 50
5.6กำรติดต้งัตูแ้มคเนติก | 51
5.7 ติดต้งัมิเตอร์วดัไฟ | 51
ก.1 กำรยอมรับเงือนไข | 56
ก.2 กำรต้งัค่ำกำรติดต้งั | 56
ก.3 กำรเลือก Folder ที่ต้องกำรจะเก็บโปรแกรม | 57
ก.4แสดงสถำนะกำรติดต้งัโปรแกรม | 57
ข.1 ระบบอัตโนมัติแบบออนไลน์ส ำหรับควบคุมอุปกรณ์ไฟฟ้ำเพื่อกำรประหยัดพลังงำน | 59
ข.2กำรเลือกโหมดกำรท ำงำนจำกคีย์แพด | 60
ข.3กำรเลือกโหมดกำรท ำงำนจำกหน้ำตู้โดยใช้สวิตช์ 2 ทำง | 60
ข.4กำรเลือกโหมดกำรท ำงำนจำกหน้ำตู้โดยใช้สวิตช์ 3 ทำง | 61
ข.5 หน้ำจอเมนูหลัก ท ำกำรเลือกโหมดกำรท ำงำน | 61

IX

สำรบัญรูป (ต่อ)
รูปที่ | หน้ำ
ข.6 หน้ำจอโหมดอัตโนมัติ | 62
ข.7 หน้ำจอกำรท ำงำนแบบควบคุมด้วยมือ | 62
ข.8 แสดงหน้ำจอ Application Blynk ส่วนของหน้ำหลัก | 63
ข.9 แสดงหน้ำจอกำรก ำหนดเงื่อนไขกำรท ำงำนอัตโนมัติ | 64
ข.10 หนำ้จอกำรต้งัค่ำเวลำ | 65
ข.11 แสดงหน้ำจอกำรใช้งำนของอุปกรณ์ในรูปแบบกรำฟ | 66
ข.12 หน้ำจอบันทึกข้อมูลลงใน Google Sheet | 67
ค.1 ตู้ควบคุมระบบ | 69
ค.2 ภำพแสดงกำรเชื่อมต่อวงจร | 69
ค.3 ภำพกำรแนะกำรเชื่อมต่อวงจร | 70
ค.4 ภำพกำรท ำตู้ควบคุม | 70
ค.5 ภำพกำรติดต้งัมิเตอร์ไฟฟ้ำ | 71
ค.6 ภำพสอนกำรใช้งำนระบบ | 71

บทที่ 1
บทน ำ

### 1.1 ควำมเป็ นมำและควำมส ำคัญ

ประเทศไทยมีไฟฟ้ำใช้เป็นคร้ังแรกเมื่อปี2427 ในสมัยของพระบำทสมเด็จพระจุลจอมเกล้ำ เจ้ำอยู่หัว รัชกำลที่ 5 ผู้ให้ก ำเนิดกิจกำรไฟฟ้ำในประเทศไทย คือ จอมพลเจ้ำพระยำสุรศักดิ์ มนตรี โดยท่ำน ไดต้ิดต้งัเครื่องกำ เนิดไฟฟ้ำ และเดินสำยไฟฟ้ำติดโคมไฟฟ้ำที่กรมทหำรหนำ้ ซ่ึงเป็นที่ต้งักระทรวงกลำโหม ในปัจจุบัน ในปี พ.ศ. 2534 – 2543 มีกำรนำ เทคโนโลยีช้นั สูงมำพฒั นำมำตรฐำนกำรบริกำรของกำรไฟฟ้ำ ส่วนภูมิภำคทำ ให้ประสบผลส ำเร็จอย่ำงดียิ่ง สำมำรถขยำยเขตระบบจำ หน่ำยไฟฟ้ำให้บริกำรกบั ประชำชน ในเขตพ้ืนที่รับผิดชอบไดอ้ย่ำงทวั่ ถึง ในปีพ.ศ. 2544 – 2553 มีกำรพัฒนำองค์กรเพื่อก้ำวสู่ระดับสำกลใน ธุรกิจพลังงำน กำรไฟฟ้ำส่วนภูมิภำคตระหนักในควำมส ำคัญของกำรให้บริกำรเพื่อสร้ำงควำมพึงพอใจให้ ลูกคำ้ควบคู่กบักำรเพิ่มประสิทธิภำพในกำรดำ เนินงำน รวมท้งัมุ่งเนน้ กำรปรับเปลี่ยนวิธีกำรบริหำรงำนให้ ทนั สมยั คล่องตวัและรวดเร็ว เพื่อให้สำมำรถแข่งขนั ไดใ้นเชิงธุรกิจและสร้ำงควำมเชื่อมนั่ แก่นักลงทุนใน กำรตัดสินใจประกอบกิจกำรต่ำง ๆ ในปี พ.ศ. 2554 – ปัจจุบัน มีกำรพัฒนำคุณภำพระบบไฟฟ้ำและ กำร บริกำร ขับเคลื่อนองค์กรไปสู่ PEA DIGITAL UTILITY กำรไฟฟ้ำส่วนภูมิภำคปรับโครงสร้ำงองค์กรและ กลยุทธ์ในกำรดำ เนินงำนให้สอดคล้องกับสภำวกำรณ์ปัจจุบัน มุ่งมั่นให้บริกำรพลังงำนไฟฟ้ำอย่ำงมี ประสิทธิภำพควบคู่กับกำรพฒั นำองคก์รอยำ่ งต่อเนื่อง ท้งัดำ้นคุณภำพและบริกำร มุ่งสู่องคก์รที่เป็นเลิศดำ้น ธุรกิจพลังงำนไฟฟ้ำ ตอบสนองควำมคำดหวงัของลูกค้ำ ร่วมสร้ำงคุณค่ำสู่สังคมและสิ่งแวดล้อมด้วย เทคโนโลยีดิจิทัล ขับเคลื่อนองค์กรไปสู่ PEA Digital Utility
คณะวิทยำศำสตร์เทคโนโลยี มหำวิทยำลัยเทคโนโลยีรำชมงคลศรี วิชัย อ ำเภอทุ่งสง จังหวัด นครศรีธรรมรำช ด้วยคณะวิทยำศำสตร์เทคโนโลยี มีเครื่องใช้ไฟฟ้ำจ ำนวนมำก ท ำให้มีค่ำใช้จ่ำยที่สูง และ ไม่สำมำรถรับรู้ได้ว่ำอุปกรณ์ตัวไหนมีกำรเปิ ดใช้งำนอยู่ ก็อำจจะมีโอกำศในกำรลืมปิ ดใช้งำนอุปกรณ์ไฟฟ้ำ ที่ไม่ได้ใช้งำนแล้ว
จำกปัญหำข้ำงต้น ทำงผู้วิจัยจึงได้มีแนวคิดที่จะสร้ำงระบบอัตโนมัติแบบออนไลน์ส ำหรับควบคุม อุปกรณ์ไฟฟ้ำเพื่อกำรประหยดั พลงังำน ให้แก่คณะวิทยำศำสตร์เทคโนโลยีมหำวิทยำลยัเทคโนโลยีรำช มงคลศรีวิชัย อ ำเภอทุ่งสง จังหวัดนครศรีธรรมรำช เพื่อให้สำมำรถควบอุปกรณ์ไฟฟ้ำและอ ำนวยควำม สะดวกในกำรควบคุมอุปกรณ์ไฟฟ้ำของบุคลำกรในสำขำรวมถึงเป็ นกำรลดค่ำใช้จ่ำยภำยในสำขำได้ ซึ่ง ระบบน้ีสำมำรถควบคุมอุปกรณ์ไฟฟ้ำได้โดยอตัิโนมตัิและสำมำรถทำ งำนตำมที่ผูใ้ช้ควบคุมจำกระบบ ออนไลน์ผ่ำนโทรศัพท์มือถือ

### 1.2 วัตถุประสงค์ของกำรวิจัย

1.2.1 เพื่อสร้ำงระบบอัตโนมัติแบบออนไลน์ส ำหรับควบคุมอุปกรณ์ไฟฟ้ำเพื่อกำรประหยัด พลังงำน
1.2.2 เพื่อทรำบปริมำณกำรใช้พลังงำนของอุปกรณ์ไฟฟ้ำ
1.2.3 เพื่ออ ำนวยควำมสะดวกในกำรควบคุมอุปกรณ์ไฟฟ้ำของบุคลำกรในสำขำ

### 1.3 ขอบเขตของกำรวิจัย

1.3.1 ระบบสำมำรถควบคุมกำรเปิ ดและปิ ดอุปกรณ์ไฟฟ้ำให้ตัดไฟตำมค่ำปริมำณกำรใช้ไฟฟ้ำที่ ก ำหนดไว้โดยอัตโนมัติ
1.3.2 ระบบสำมำรถควบคุมกำรเปิ ดและปิ ดอุปกรณ์ไฟฟ้ำตำมควำมต้องกำรของผู้ใช้
1.3.3 ระบบสำมำรถต้งัเวลำเปิ ดและปิ ดของอุปกรณ์ไฟฟ้ำได้
1.3.4 ระบบสำมำรถแสดงค่ำปริมำณกำรใช้ไฟฟ้ำผ่ำนจอ LCD และออนไลน์ได้ 1.3.5 ระบบสำมำรถควบคุมไดท้ ้งัแบบออนไซตแ์ละออนไลน์ได้
1.3.6 ระบบสำมำรถแจ้งสถำนะของอุปกรณ์ไฟฟ้ำไปยังแอปพลิเคชันไลน์
1.3.7 ระบบสำมำรบันทึกข้อมูลรำยกำรท ำงำนลงใน GoogleSheet ได้
1.3.8 ระบบสำมำรถแจ้งเตือนไปยังแอปพลิเคชันไลน์ในกรณีที่ไฟฟ้ำเกินค่ำที่ก ำหนดไว้
1.3.9 ระบบสำมำรถควบคุมอุปกรณ์ไฟฟ้ำได้ 4 อุปกรณ์

### 1.4 ประโยชน์ที่คำดว่ำจะได้รับจำกงำนวิจัย

1.4.1 ได้สร้ำงระบบอัตโนมัติแบบออนไลน์ส ำหรับควบคุมอุปกรณ์ไฟฟ้ำเพื่อกำรประหยัดพลังงำน 1.4.2 ได้ทรำบปริมำณกำรใช้พลังงำนของอุปกรณ์ไฟฟ้ำ
1.4.3 ได้อ ำนวยควำมสะดวกในกำรควบคุมอุปกรณ์ไฟฟ้ำของบุคลำกรในสำขำ

### 1.5 ระเบียบวิธีกำรวิจัย

1.5.1 ศึกษำกำรใช้ไฟฟ้ำภำยในสำขำวิชำเทคโนโลยีสำรสนเทศ
1.5.2 ศึกษำค้นคว้ำข้อมูลเกี่ยวกับอุปกรณ์ที่ใช้ในโครงกำรวิจัย
1.5.3 ออกแบบระบบกำรควบคุม
1.5.4 สร้ำงและพัฒนำระบบกำรควบคุม
1.5.5 ทดลองอ่ำนค่ำเซนเซอร์
1.5.6 ทดลองใช้งำนอุปกรณ์ต่ำง ๆ ที่จะน ำมำเชื่อมต่อเป็ นระบบ 1.5.7 ติดต้งัระบบและทำ กำรทดสอบระบบโดยกำรสั่งควบคุมอุปกรณ์

1.5.8 ปรับปรุงแก้ไขระบบและท ำกำรแก้ไขในส่วนที่ผิดพลำด เพื่อให้ระบบมีควำมสมบูรณ์ และมี ประสิทธิภำพดียงิ่ ข้ึน
1.5.9 ประเมินผลจำกผู้ใช้งำน
1.5.10 จัดท ำคู่มือกำรใช้งำนของระบบ

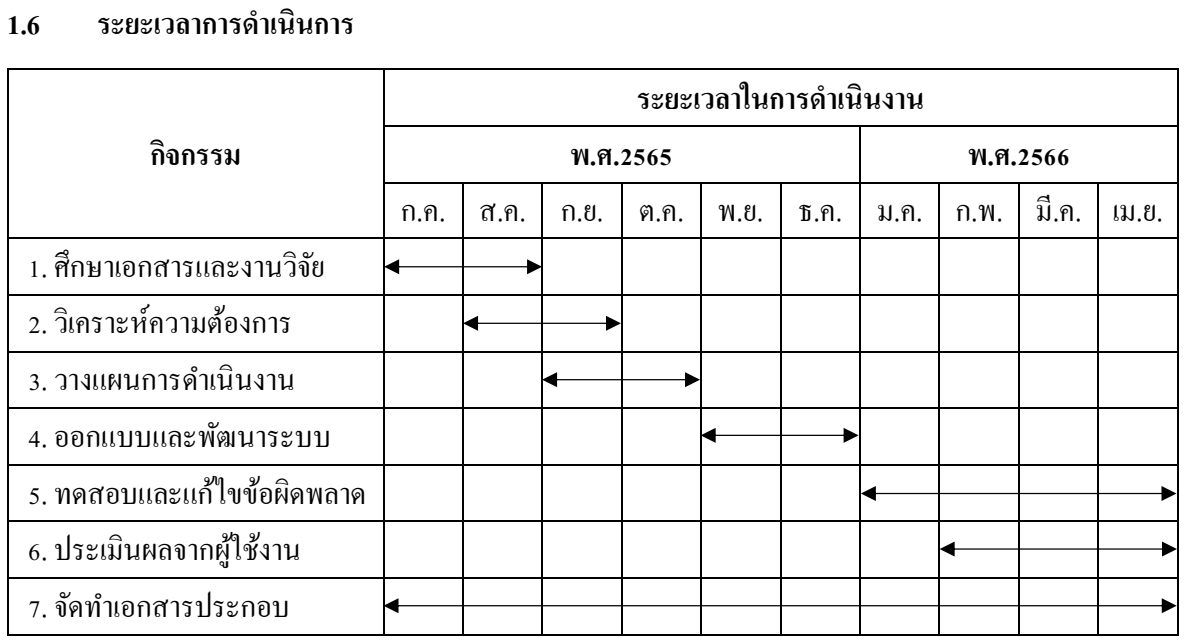
[picture p64: figure]
1.6 ระยะเวลำกำรด ำเนินกำร; กิจกรรม; ระยะเวลำในกำรด ำเนินงำน; 1. ศึกษำเอกสำรและงำนวิจัย 2. วิเครำะห์ควำมต้องกำร 3. วำงแผนกำรด ำเนินงำน 4. ออกแบบและพัฒนำระบบ 5. ทดสอบและแก้ไขข้อผิดพลำด 6. ประเมินผลจำกผู้ใช้งำน 7. จัดท ำเอกสำรประกอบ

ตำรำงที่ 1.1ระยะเวลำกำรท ำวิจัย

### 1.7 สถำนที่ท ำกำรวิจัย

ห้องปฏิบัติกำรระบบฝังตัวและอินเตอร์เน็ตในทุกสรรพสิ่ง คณะวิทยำศำสตร์และเทคโนโลยี มหำวิทยำลยัเทคโนโลยีรำชมงคลศรีวิชยั วิทยำเขตนครศรีธรรมรำช ตำ บลถ้ำ ใหญ่อำ เภอทุ่งสง จงัหวดั นครศรีธรรมรำช

### 1.8 เครื่องมืออุปกรณ์และซอฟต์แวร์ที่ใช้ในกำรพฒั นำ

โครงกำรวิจัยน้ีเป็นกำรประยุกต์ใช้อุปกรณ์ต่ำง ๆ เพื่อน ำมำพฒั นำให้เป็นระบบอัตโนมัติแบบ ออนไลน์ส ำหรับควบคุมอุปกรณ์ไฟฟ้ำเพื่อกำรประหยัดพลังงำน กรณีศึกษำ คณะวิทยำศำสตร์และ เทคโนโลยี มหำวิทยำลัยเทคโนโลยีรำชมงคลศรีวิชัย โดยเครื่องมือที่น ำมำใช้ในกำรพัฒนำระบบแบ่ง ออกเป็ น 2 ส่วน ดงัน้ี

1.8.1 เครื่องมือทำงด้ำนฮำร์ดแวร์ ประกอบด้วย
- บอร์ด Arduino ESP8266 | จ ำนวน 1 ตัว
- บอร์ด Arduino Mega2560 | จ ำนวน 1 ตัว
- โมดูลวัดปริมำณกำรใช้ไฟฟ้ำ | จ ำนวน 4 ตัว
- โมดูล relay ขนำด 4 ช่องสัญญำน | จ ำนวน 1 ตัว
- จอแสดงผล LCD ขนำด 20x4 | จ ำนวน 1 จอ
- magnetic switch | จ ำนวน 4 ตัว
- คีย์แพดขนำด 4x4 | จ ำนวน 1 ตัว
- Switching Power Supply 5v | จ ำนวน 1 ตัว
1.8.2 เครื่องมือทำงด้ำนซอฟต์แวร์ ประกอบด้วย
- โปรแกรมภำษำ C ส ำหรับบอร์ด Arduino ใช้ในกระบวนกำร คอมไพเลอร์ภำษำซี
- Application Blynk ส ำหรับกำรควบคุมกำรใช้งำนจำกระยะไกลผ่ำนเครือข่ำย อินเตอร์เน็ต
- Application Line ส ำหรับส่งข้อควำมแจ้งเตือนจำกระบบไปยังผู้ใช้งำน

บทที่ 2
ทฤษฎีและงำนวิจัยที่เกี่ยวข้อง

ในบทน้ีกล่ำวถึงทฤษฎีและงำนวิจยัที่เกี่ยวขอ้งในกำรสร้ำงงระบบอัตโนมัติแบบออนไลน์ส ำหรับ ควบคุมอุปกรณ์ไฟฟ้ำเพื่อกำรประหยัดพลังงำน กรณีศึกษำ คณะวิทยำศำสตร์และเทคโนโลยี มหำวิทยำลัย เทคโนโลยีรำชมงคลศรีวิชัย เนื่องจำกกำรสร้ำงจะต้องมีองค์ประกอบหลำย ๆ ส่วนประกอบด้วยกันจึงจ ำ เป็ นจะต้องมีกำรศึกษำถึงทฤษฎีและ งำนวิจัยที่เกี่ยวข้องเพื่อให้ทรำบถึงเงื่อนไขต่ำง ๆ และกำรท ำงำนของ อุปกรณ์ที่น ำมำใช้ในกำร ออกแบบและสร้ำงระบบอัตโนมัติแบบออนไลน์ส ำหรับควบคุมอุปกรณ์ไฟฟ้ำเพื่อ กำรประหยัดพลังงำน โดยมีทฤษฎีและงำนวิจยัที่เกี่ยวขอ้งมีดงัน้ี
1. ทฤษฎีเกี่ยวกับกำรประหยัดไฟฟ้ำ
2. ทฤษฎีเกี่ยวกับบอร์ด MEGA WiFi Dev Board
3. ทฤษฎีเกี่ยวกับบอร์ด ESP8266
4. ทฤษฎีเกี่ยวกับโมดูลวัดปริมำณกำรใช้ไฟฟ้ำ PZEM-004T
5. ทฤษฎีเกี่ยวกับโมดูล Relay ขนำด 4 ช่องสัญญำณ
6. ทฤษฎีเกี่ยวกับ Magnetic switch
7. ทฤษฎีเกี่ยวกับคีย์แพดขนำด 4x4
8. ทฤษฎีเกี่ยวกับจอแสดงผลแบบ LCD 20x4
9. ทฤษฎีเกี่ยวกับ Application Line
10. ทฤษฎีเกี่ยวกับ Blynk
11. ทฤษฎีเกี่ยวกับ Switching Power Supply
12. ทฤษฎีเกี่ยวกับกำรส่งข้อมูลระหว่ำงบอร์ด
13. งำนวิจัยที่เกี่ยวข้อง

### 2.1 ทฤษฎีเกี่ยวกับกำรประหยัดไฟฟ้ำ

กำรประหยดัพลงังำนถือเป็นวิธีแกป้ ัญหำที่ก่อใหเ้กิดผลดีต่อทุกฝ่ำย โดยเฉพำะประชำชนผใู้ชไ้ฟฟ้ำ ที่จะได้ประโยชน์สูงสุดในกำรช่วยลดรำยจ่ำยของครอบครัว ขณะเดียวกันก็ส่งผลพลอยได้ท ำให้ปริมำณกำร ใช้พลังงำนในภำพรวมของประเทศลดลงจึงช่วยลดควำมเสี่ยงในกำรขำดแคลนพลังงำนของประเทศ ส่งผล ใหก้ำรนำ เขำ้น้ำ มนัและก๊ำซธรรมชำติ(LNG) ที่มีรำคำแพงจำกต่ำงประเทศลดลงตำมไปด้วย โดยเฉพำะภำค กำรผลิตไฟฟ้ำที่ตน้ ทุนส่วนใหญ่คือค่ำเช้ือเพลิงกำรสั่งเดินเครื่องโรงไฟฟ้ำ น้ันจะเริ่มจำกโรงไฟฟ้ำที่มี ตน้ ทุนต่ำ สุดไปถึงโรงไฟฟ้ำที่มีตน้ ทุนสูงสุด ดงัน้นั หำกกำรใชไ้ฟฟ้ำลดลงกำรผลิตไฟฟ้ำในระบบก็ไม่ตอ้ง เดินเครื่องโรงไฟฟ้ำที่ใช้ LNG เป็นเช้ือเพลิงซ่ึงมีตน้ ทุนสูงในขณะน้ีเขำ้มำในระบบ ส่งผลใหต้ น้ ทุนค่ำเอฟที ในภำพรวมลดลงและเป็ นประโยชน์ต่อค่ำไฟฟ้ำ ดงัน้นักำรช่วยประหยดัพลงังำนคนไมค้นละมือของคนไทย

ทุกคนจึงเปรียบเสมือนกำรหยอดกระปุกออมสินที่ทำ ให้ประเทศไทยลดกำรพ่ึงพำกำรนำ เขำ้เช้ือเพลิงจำก ต่ำงประเทศและมีเสถียรภำพทำงพลงังำนเพิ่มข้ึน
ภำวะเศรษฐกิจของประเทศยงัคงอยู่ในข้นั วิกฤติเรำเป็นหน้ีกองทุนกำรเงินระหว่ำงประเทศเกือบ สองหมื่นลำ้นเหรียญสหรัฐ ประชำชนคนไทยท้งัหลำยต่ำงก็มีควำมห่วงใยในประเทศชำติมีควำมรักชำติที่ เข้มข้น และอยำกที่จะช่วยชำติ ซึ่งนับว่ำเป็ นควำมสำมัคคีที่ต้องจำรึกไว้ในประวัติศำสตร์เพรำะจะเป็นสิ่งที่ ยืนยันว่ำ ในยำมคับขันคนไทยพร้อมจะช่วยชำติ บ้ำงก็น ำเงินดอลล่ำร์มำบริจำค บ้ำงก็สละเงินทองทรัพย์สิน ส่วนตวั เพื่อใหร้ัฐบำลนำ ไปใชห้ น้ีแต่ยงัมีอีกวิธีที่ทุกๆคนสำมำรถช่วยชำติไดเ้ช่นกนั นนั่ ก็คือกำรลดกำรใช้ พลังงำนอย่ำงฉับพลันทันที ไม่ว่ำจะเป็นกำรลดใชน้ ้ำ มนัลงลดใชไ้ฟฟ้ำลง หรือลดใชน้ ้ำ ลง ประเทศไทยมีครัวเรือนรวมประมำณ 12 ล้ำนครัวเรือน หำกแต่ละครอบครัวช่วยกันปิ ดไฟ 1 ดวง (หลอดไส้ 60 วัตต์) เป็ นเวลำ 1 วัน เรำจะประหยัดไฟได้ 4 ล้ำน กิโลวัตต์-ชวั่ โมง/วนั =(60 วัตต์ x 6 ชม* x 12 ล้ำนครัวเรือน) ค่ำผลิตและจ ำหน่ำยไฟฟ้ำ 1 หน่วย (กิโลวัตต์-ชวั่ โมง)คือ2.2 บำท (รวมค่ำพลงังำนที่ใช้ และกำรก่อสร้ำงโรงไฟฟ้ำ) กำรประหยดัไฟ 4ลำ้นหน่วย/วนั จึงคิดเป็นมูลค่ำท้งัสิ้น 8.8ลำ้นบำท/วนั หรือ 3,212 ล้ำนบำทต่อปี=(8.8 ล้ำนบำท x วัน)
* ครอบครัวหน่ึงเปิดหลอดไส้ประมำณ 6 ชวั่ โมงต่อวนั

### 2.2 ทฤษฎีเกี่ยวกับบอร์ด MEGA WiFi Dev Board

MEGA WiFi Dev Board เป็ นบอร์ดไมโครคอนโทรลเลอร์ที่ใช้ชิพ ATmaga2560 ซึ่งมี 54 ดิจิตอล อินพตุ/เอำทพ์ ุต โดยในขำเหล่ำน้นั สำมำรถใชง้ำนเป็น PWM ได้ 15ขำอนำล็อกอินพุต 16ขำ UART 4 ชุด โดยควำมถี่คริสตรัลบนบอร์ดคือ 16 MHz เชื่อมต่อข้อมูลระหว่ำงคอมพิวเตอร์ผ่ำนพอร์ต USB บนบอร์ดได้ โดยตรงอีกท้ังรูปแบบกำรออกแบบยงัออกแบบให้รองรับกำรสวมกับ Shield ต่ำง ๆได้โดยตรง ท ำให้ สำมำรถพัฒนำระบบต่ำง ๆ ได้อย่ำงรวดเร็วและเรียบร้อยสวยงำมโดยรองรับกำรพัฒนำโปรแกรมบน แพลตฟอร์ม Arduino อย่ำงเต็มรูปแบบ ได้แสดงดังรูปที่ 2.1

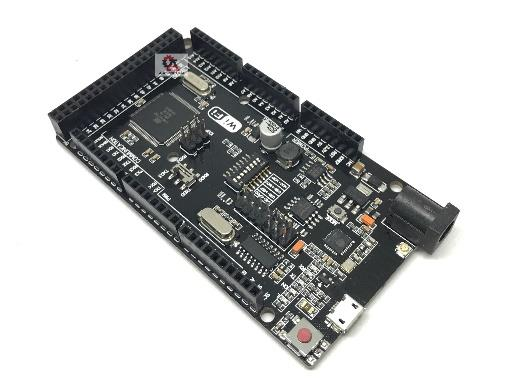
[picture p65: figure]

รูปที่2.1 MEGA WiFi Dev Board [1] จำกรูปที่ 2.1 แสดงลักษณะบอร์ด MEGA WiFi Dev Board ที่ออกแบบมำส ำหรับงำนที่ต้องใช้ช่อง ขำสัญญำณ I/O มำกกว่ำบอร์ด Arduino Uno R3 เช่น งำนที่ต้องกำรรับสัญญำณจำกเซนเซอร์ (Sensor) หรือ ควบคุมมอเตอร์หลำย ๆ ตัว ท ำให้Pin I/O ของบอร์ด Arduino Uno R3 ไม่สำมำรถรองรับได้ท้งัน้ีบอร์ด ATmega2560 ยังมีหน่วยควำมจ ำแบบ Flash ซึ่งมำกกว่ำ Arduino Uno R3 ท ำให้สำมำรถเขียนโค้ดโปรแกรม เข้ำไปได้มำกกว่ำ ในควำมเร็วของ MCU ที่เท่ำกัน

### 2.3 ทฤษฎีเกี่ยวกับบอร์ด ESP8266

มีควำมพิเศษตรงที่ตัวมันสำมำรถโปรแกรมลงไปได้ ท ำให้สำมำรถน ำไปใช้งำนแทน ไมโครคอนโทรลเลอร์ได้เลย และมีพ้ืนที่โปรแกรมที่มำกถึง 4MB ทำ ให้มีพ้ืนที่เหลือมำกในกำรเขียน โปรแกรมลงไป ผู้ใช้สำมำรถเลือกพัฒนำด้วยสคริปต์ LUA โดยใช้เฟิ ร์มแวร์ Node MCU หรือเป็ นชุดพัฒนำ ด้วยโมดูล ESP8266ก็ได้ซึ่งสำมำรถเขียนด้วย Arduino IDE ได้ โมดูลมี GPIO ให้ใช้ถึง 10 พอร์ต สำมำรถ น ำมำพัฒนำโปรเจคทำงด้ำน Internet of Things (IoTs) เชื่อมต่อกับอุปกรณ์อื่น ๆ ตำมต้องกำร
ขำของโมดูล ESP8266แบ่งไดด้งัน้ี
- VCC เป็ นขำส ำหรับจ่ำยไปเข้ำเพื่อให้โมดูลท ำงำนได้ ซึ่งแรงดันที่ใช้งำนได้คือ 3.3 -3.6V
- GND
- Reset และ CH_PD (หรือ EN) เป็ นขำที่ตอ้งต่อเขำ้ไฟ +เพื่อให้โมดูลสำมำรถทำ งำนได้ท้งั 2ขำน้ี สำมำรถน ำมำใช้รีเซ็ตโมดูลได้เหมือนกัน แตกต่ำงตรงที่ขำ Reset สำมำรถลอยไว้ได้ แต่ขำ CH_PD (หรือ EN) จำ เป็นตอ้งต่อเขำ้ไป +เท่ำน้นั เมื่อขำน้ีไม่ต่อเขำ้ไฟ +โมดูลจะไม่ทำ งำนทนั ที
- GPIO เป็ นขำดิจิตอลอินพุต / เอำต์พุต ท ำงำนที่แรงดัน 3.3V
- GPIO15 เป็ นขำที่ต้องต่อลง GND เท่ำน้นั เพื่อใหโ้มดูลทำ งำนได้
- GPIO0 เป็นขำทำ หรับกำรเลือกโหมดทำ งำน หำกนำ ขำน้ีลง GND จะเข้ำโหมดโปรแกรม หำกลอย ไว้ หรือน ำเข้ำไฟ + จะเข้ำโหมดกำรท ำงำนปกติ
- ADC เป็ นขำอนำล็อกอินพุต รับแรงดันได้สูงสุดที่ 1V ขนำด 10 บิต กำรน ำไปใช้งำนกับแรงดันที่สูง กว่ำต้องใช้วงจรแบ่งแรงดันเข้ำช่วย

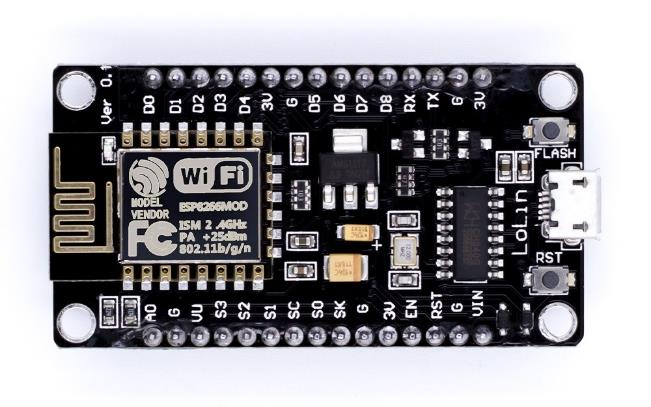
[picture p66: figure]

รูปที่2.2 ESP 8266 [2]
จำกรูปที่ 2.2 ESP8266 น้นัถูกนำ มำทำ เป็นโมดูลหลำยตวัมำก ที่น้ีจึงขออธิบำยเฉพำะตวัโมดูลที่ใช้ งำนได้ง่ำย เป็ นที่นิยม คือ ESP-01 และ Node MCU เท่ำน้นั ส่วนกำรใชง้ำนโมดูลตวัอื่นๆ จะมีวิธีกำรใชง้ำน ที่เหมือนกัน ต่ำงกันตรงกำรจัดวำงและจ ำนวนขำที่มีใช้งำน ซึ่งสำมำรถหำเอกสำรต่ำงๆน ำมำอ้ำงอิงได้ โดยทวั่ ไป โดยขำ I/O ที่ใชง้ำนไดน้้ีจะเรียกวำ่ GPIO อำจฟังดูแปลกแต่มันก็ท ำหน้ำที่เหมือนขำของ Arduino นนั่ เอง ใน Arduino เรำเรียกขำ 2 ว่ำ " 2 " ใน ESP8266 จะเรียกว่ำ " GPIO2 " ชื่อเรียกต่ำงกันแต่ท ำหน้ำที่และ เขียนโปรแกรมเหมือนกัน

### 2.4 ทฤษฎีเกี่ยวกับโมดูลวัดปริมำณกำรใช้ไฟฟ้ำ PZEM-004T

กำรวัดค่ำเพื่อบันทึกกำรใช้งำนไฟฟ้ำ เพื่อกำรตรวจสอบ วัดค่ำกำรใช้พลังงำน ควบคุมค่ำไฟฟ้ำ แล้ว อุปกรณ์วัดจ ำเป็ นต้องให้ข้อมูลหลำย ๆ ค่ำ ไดแ้ก่แรงดนั (VAC) กระแส (IAC) ก ำลังไฟฟ้ำจริง (Active power) ค่ำตัวประกอบก ำลัง (Power Factor) ค่ำพลังงำนไฟฟ้ำ (Energy) เพื่อมำใช้ในกำรค ำนวณ หรือ ควบคุมต่อ ถำ้เป็นสมยัก่อนที่ยงัไม่มีโมดูล PZEM ออกมำ กำรพัฒนำอุปกรณ์เพื่อวัดค่ำพลังงำนไฟฟ้ำ (กระแสสลับ) ดังกล่ำว อำจจะต้องใช้ Sensor เพื่อวดักระแส และแรงดนั จำกน้นัก็นำ ค่ำมำค ำนวณต่อกันเอง แต่ในปัจจุบันโมดูล PZEM รับหน้ำที่กำรค ำนวณค่ำต่ำง ๆ ไปเรียบร้อย และส่งผลกำรค ำนวณต่ำง ๆ ออกมำ จำกโมดูลผ่ำนกำรสื่อสำรแบบ serial (TX, RX) ซ่ึงสำมำรถใชเ้พื่อควบคุมสั่งกำรต่อดว้ยบอร์ด Arduino หรือ ส่งค่ำต่อไปที่คอมพิวเตอร์

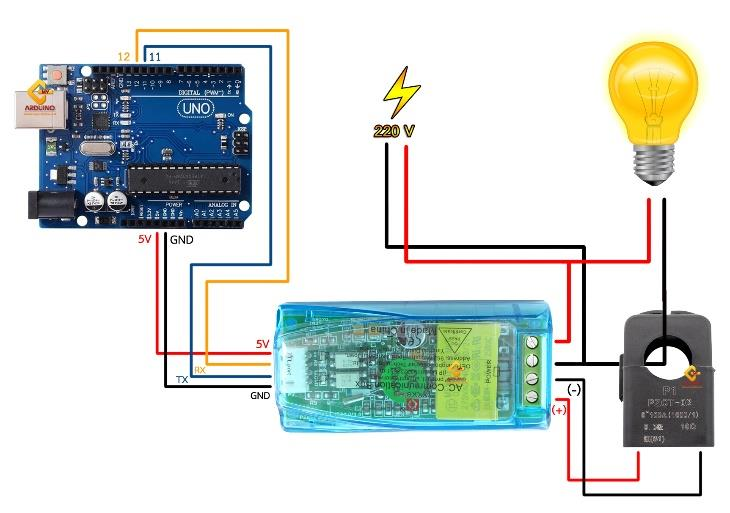
[picture p67: figure]

รูปที่2.3 โมดูลวัดปริมำณไฟฟ้ำPZEM-004T [3] จำกรูปที่ 2.3 แสดงลักษณะกำรใช้งำนโมดูลวัดปริมำณไฟฟ้ำ ที่ก ำลังเชื่อมต่อกับบอร์ด Arduino เพื่อให้ Sensor ตรวจจับไฟฟ้ำและส่งข้อมูลไปที่บอร์ด Arduino

### 2.5 ทฤษฎีเกยี่ วกบัโมดูล Relay ขนำด 4 ช่องสัญญำณ

โมดูลรีเลย์ 4ช่อง 5V (4 Channel Relay Module) เป็นโมดูลที่ใชค้วบคุมโหลดไดท้ ้งัแรงดนั ไฟฟ้ำ DC และ AC ซึ่งโหลดสูงสุด (Maximum Load) คือ AC 250V/10A, DC 30V/10A โดยใช้สัญญำณในกำร ควบคุมกำรท ำงำนด้วยสัญญำณลอจิก TTL ท ำงำนด้วยสัญญำณแบบ Active Low กระแสขับรีเลย์ (Drive Current) 15-20mA. มีกำรออกแบบให้เป็ น Isolate ด้วย Optocoupler มี LED แสดงสถำนะ Relay สำมำรถ น ำไปประยุกต์ใช้งำน PLC Control บ้ำนอัจฉริยะ ใช้ในโรงงำนอุตสำหกรรม หรืองำนอื่น ๆ ข้ึนอยู่กบักำร เขียนโปรแกรมและกำรต่อใช้งำนภำยนอก สำมำรถเชื่อมต่อใช้งำนกับบอร์ด Rasberry Pi Arduino ARM MCS-51 AVR PIC 8051 DSP MSP430 TTL logic

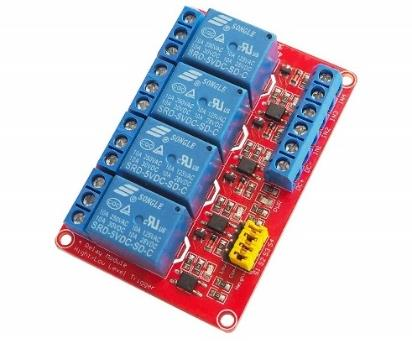
[picture p68: figure]

รูปที่2.4 Relay ขนำด 4 ช่องสัญญำน [4] จำกรูปที่ 2.4 แสดงลักษณะบอร์ดรีเลย์ 4 ช่องสัญญำณ เพื่อใช้ในกำรควบคุมกำรจ่ำยไฟให้อุปกรณ์ ต่ำง ๆ โมดูลรีเลย์ 4ช่อง 5V (4 Channel Relay Module) เป็ นโมดูลที่ใช้ควบคุมกำรท ำงำนของโหลดทำง ไฟฟ้ำไดท้ ้งัแรงดนั ไฟฟ้ำกระแสตรง (DC) และไฟฟ้ำกระแสสลับ (AC) ซึ่งโหลดสูงสุด คือ AC 250V/10A และ DC 30V/10A โดยใช้สัญญำณในกำรควบคุมกำรท ำงำนด้วยสัญญำณลอจิก TTL ท ำงำนด้วยสัญญำณ แบบ Active Low กระแสขับรี เลย์ (Drive Current) 15-20mA. มีกำรออกแบบให้เป็ น Isolate ด้วย

Optocoupler มี LED แสดงสถำนะ Relay สำมำรถน ำไปประยุกต์ใช้งำน PLC Control บ้ำนอัจฉริยะ ใช้ใน โรงงำนอุตสำหกรรม หรืองำนอื่น ๆ ข้ึนอยู่กับกำรเขียนโปรแกรมและกำรต่อใช้งำนภำยนอก สำมำรถ เชื่อมต่อใช้งำนกับบอร์ด Rasberry Pi Arduino Node MCU ESP8266 ฯลฯ เป็ นต้น

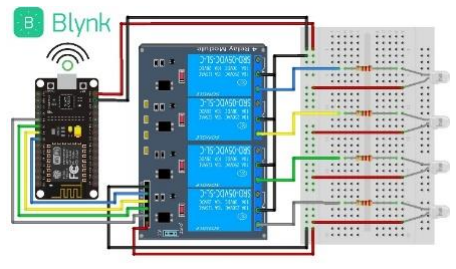
[picture p69: figure]

รูปที่2.5กำรใช้งำนของ Relay [4] จำกรูปที่ 2.5 แสดงลักษณะภำยใน Relay จะประกอบไปด้วยขดลวดและหน้ำสัมผัส
1. หน้ำสัมผัส NC (Normally Close) เป็นหนำ้สัมผสั ปกติปิด โดยในสภำวะปกติหนำ้สัมผสั น้ีจะต่อเขำ้กบัขำ COM (Common) และจะลอยหรือไม่สัมผัสกันเมื่อมีกระแสไฟฟ้ำไหลผ่ำนขดลวด
2. หน้ำสัมผัส NO (Normally Open) เป็ นหน้ำสัมผัสปกติเปิ ด โดยในสภำวะปกติจะลอยอยู่ ไม่ถูกต่อกับขำ COM (Common) แต่จะเชื่อมต่อกันเมื่อมีกระแสไฟไหลผ่ำนขดลวด
3.ขำ COM (Common) เป็ นขำที่ถูกใช้งำนร่วมกันระหว่ำง NC และ NO ข้ึนอยกู่ บัวำ่ ขณะน้นั มีกระแสไฟฟ้ำ ไหลผ่ำนขดลวดหรือไม่ หน้ำสัมผัสใน Relay 1 ตวัอำจมีมำกกว่ำ1 ชุด ข้ึนอยู่กบัผูผ้ลิตและลกัษณะของงำน ที่ถูกน ำไปใช้

### 2.6 ทฤษฎีเกี่ยวกับ Magnetic switch

แมกเนติกคอนแทคเตอร์ หรือ แมคเนติคสวิตช์คือ อุปกรณ์สวิตช์ตัดต่อวงจรไฟฟ้ำ เพื่อกำรเปิ ด-ปิ ด ของหน้ำสัมผัส (Contact) ท ำงำนโดยอำศัยอ ำนำจแม่เหล็กไฟฟ้ำช่วยในกำรเปิ ด-ปิ ดหน้ำสัมผัส ในกำรตัดต่อ วงจรไฟฟ้ำ เช่น เปิ ด-ปิ ด กำรท ำงำนของวงจรควบคุมมอเตอร์ นิยมใช้ในวงจรของระบบแอร์ ระบบควบคุม มอเตอร์ หรือใช้ในกำรควบคุมเครื่องจักรต่ำง ๆ โดยแมกเนติกคอนแทคเตอร์น้ัน จะมีส่วนประกอบหลกั ที่ ส ำคัญต่อกำรทำ งำน ไดแ้ก่แกนเหลก็ (Core) ขดลวด (Coil) หน้ำสัมผัส (Contact) และสปริง (Spring)

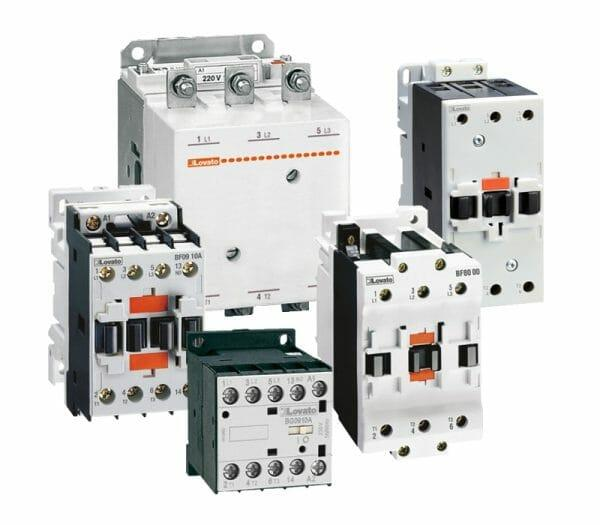
[picture p70: figure]

รูปที่2.6แมกเนติกคอนแทคเตอร์/แมกเนติกสวิตช์[5] จำกรูปที่ 2.6 เมื่อมีกระแสไฟฟ้ำไหลผ่ำนไปยังขดลวดสนำมแม่เหล็กที่อยู่ขำกลำงของแกนเหล็ก ขดลวดจะสร้ำงสนำมแม่เหล็กที่แรงสนำมแม่เหล็กชนะแรงสปริงดึงให้แกนเหล็กชุดที่เคลื่อนที่ (Stationary Core) เคลื่อนที่ลงมำในสภำวะน้ี(ON) คอนแทคท้งัสองชุดจะเปลี่ยนสภำวะกำรทำ งำนคือ คอนแทคปกติปิด จะเปิ ดวงจรจุดสัมผัสออก และคอนแทคปกติเปิ ดจะต่อวงจรของจุดสัมผัส เมื่อไม่มีกระแสไฟฟ้ำไหลผ่ำนเข้ำ ไปยงัขดลวด สนำมแม่เหลก็คอนแทคท้งัสองชุดจะกลบัไปสู่สภำวะเดิม

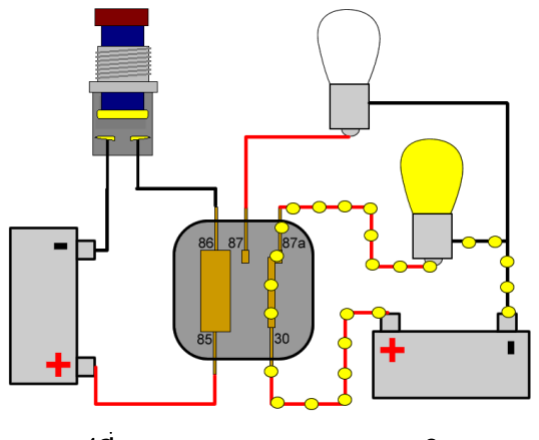
[picture p71: figure]

รูปที่2.7กำรท ำงำนของแมกเนติก[5] จำกรูปที่ 2.7 จะเห็นได้ว่ำส่วนประกอบต่ำงๆ คือ ปัจจัยส ำคัญที่จ ำเป็ นต่อกระบวนกำรท ำงำนของ แมกเนติกคอนแทคเตอร์แต่ถำ้หำกตอ้งกำรเพิ่มประสิทธิภำพเพื่อกำรทำ งำนให้ดีเรำจำ เป็นตอ้งคำ นึงถึง ปัจจัยอื่นๆ ที่มีผลต่อกำรท ำงำนด้วยเช่นกัน ไม่ว่ำจะเป็ นวิธีกำรเลือกใช้แมกเนติก คอนแทคเตอร์ อย่ำงไรให้ ได้ผล และเรำควรเลือกใช้แมกเนติก คอนแทคเตอร์ ประเภทไหนให้เหมำะกับงำน รวมไปถึงเรื่ อง อุปกรณ์เสริมของแมกเนติก คอนแทคเตอร์ที่จำ เป็นต้องรู้เพรำะสิ่งเหล่ำน้ีคือขอ้ มูลส ำคัญที่จะช่วยเพิ่ม ประสิทธิภำพและสำมำรถแกไ้ขปัญหำต่ำงๆที่อำจเกิดข้ึนไดใ้นกำรทำ งำน

### 2.7 ทฤษฎีเกี่ยวกับคีย์แพดขนำด 4x4

แป้นปุ่ มกดหรือ Keypad เป็ นอุปกรณ์ส ำหรับอินพุตจำกเจ้ำหน้ำที่ มีลักษณะเป็ นปุ่ มกดหลำยปุ่ ม ถูก จัดเรียงกัน ในลกัษณะเป็ นอำร์เรย์แบ่งเป็ นแถวแนวนอน (Rows)และแถวแนวต้งั (Columns) เช่น 3 x 4 (12 ปุ่ ม) หรือ 4 x 4 (16ปุ่ ม) เป็ นต้น แต่ละปุ่ มก็จะมีสัญลักษณ์เขียนก ำกับไว้เช่น ตัวเลข 0 ถึง 9 เครื่องหมำย # เครื่องหมำย* เป็นตน้ โดยปกติถ้ำ ต่อปุ่มกดแยกจำ นวน 16 ตวั จะตอ้งใชข้ำสัญญำณท้งัหมด 16ขำแต่ถำ้ใช้ กำรจัดเรียงแบบ 4x4 จะใช้ขำสัญญำณเพียง 8 ขำ แต่ตอ้งมีกำรตรวจดูว่ำ ปุ่มกดใดถูกกดบำ้งในขณะน้ัน วิธีกำรน้ีเรียกวำ่ กำรสแกนปุ่มกด (key scan) ส ำหรับ ลักษณะแป้นปุ่ มกด แบบ 4x4 ปุ่ ม
แสดงได้ดังรูปที่ 2.8

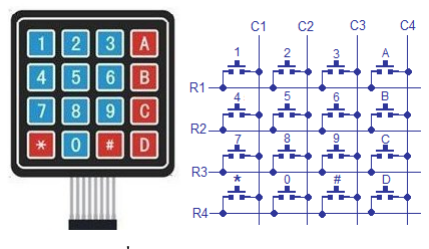
[picture p72: figure]

รูปที่2.8แป้นปุ่ มกดแบบ 4x4 [6] จำกรูปที่ 2.8 แสดงลักษณะแป้นปุ่ มกด แบบ 4x4 ปุ่ มมีสำยเชื่อมต่อคอนเนกเตอร์จ ำนวน 8 ขำ แบบ ตัวเมีย (Female)ถ้ำต้องกำรเสียบขำลงบนเบรดบอร์ด ก็สำมำรถใช้Pin Header ตวัผู้เป็นตวั เชื่อมต่อไดข้ำท้งั 8 น้นั ถำ้มองจำกดำ้นหนำ้ (Front View) และนับจำกซ้ำยไปขวำจะเป็ นขำหมำยเลข 1-8 ตำมล ำดับ โดยที่ข ำ 1 ถึง 4 จะเป็ นขำส ำหรับแถวนอน (Rows) ขำ 5ถึง 8จะเป็นขำแนวต้งั (Columns)

### 2.8 ทฤษฎีเกี่ยวกับจอแสดงผล LCD 20x4

LCD ย่อ มำจำก Liquid Crystal Display ซึ่งเป็ นจอแสดงผลแบบ (Digital)โดยภำพที่ปรำกฏข้ึนเกิด จำกแสงที่ถูกปล่อยออกมำจำกหลอดไฟด้ำนหลังของจอภำพ (Black Light) ผ่ำนช้ันกรองแสง (Polarized filter) แลว้วิ่งไปยงัคริสตลัเหลวที่เรียงตวัดว้ยกนั 3เซลลค์ือแสงสีแดงแสงสีเขียวและแสงสีน้ำ เงิน กลำยเป็ นพิกเซล (Pixel) ที่สวำ่ งสดใสเกิดข้ึน แสดงไดด้งัรูปที่2.9

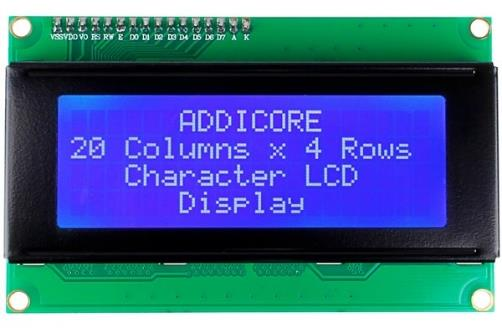
[picture p73: figure]

รูปที่2.9จอแสดงผล LCD I2C [7] จำกรูปที่ 2.9 แสดงจอ LCD ที่มีกำรเชื่อมต่อแบบ I2C หรือเรียกอีกอย่ำงว่ำกำรเชื่อมต่อแบบ อนุกรม จะเป็ นจอ LCD ธรรมดำทวั่ ไปที่มำพร้อมกบั บอร์ด I2C Bus ที่ทำ ให้กำ รใช้งำนไดส้ ะดวกยิ่งข้ึน และยงัมำ พ ร้ อ ม กับ V R ส ำ ห รั บ ป รั บ ค ว ำ ม เ ข้ม ข อ ง จ อ ใ น รู ป แ บ บ I 2 C จ ะ ใ ช้ข ำ ใ น ก ำ ร เ ชื่ อ ม ต่ อ กับ ไมโครคอนโทรลเลอร์เพียง 4 ขำ (แบบ Parallel ใช้16 ขำ ) ซ่ึงทำ ใหใ้ชง้ำนไดง้่ำยและสะดวกมำกยงิ่ ข้ึน

### 2.9 ทฤษฎีเกี่ยวกับ Application Line

โปรแกรม Application Line ที่มีควำมสำมำรถในกำรสนทนำ เช่น กำรแชท กำรส่งข้อควำม กำรแชร์ ไฟล์ก ำรสร้ำงกลุ่มพูดคุย หรือกำรสนทนำผ่ำนเสียงผ่ำนเครือข่ำยอินเตอร์เน็ต บนอุปกรณ์ประเภทพกพ ำ (Mobile Devices) เช่น สมำร์ทโฟน แทบ็ เลต็ เป็นตน้ นอกจำกน้ีLine ยังสำมำรถ ติดต้งัและใชง้ำนบนเครื่อง คอมพิวเตอร์ทวั่ ไปไดด้ว้ย

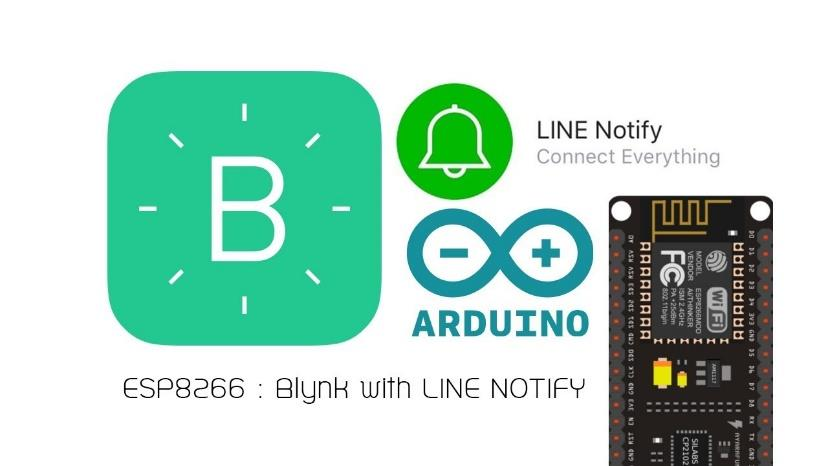
[picture p74: figure]

รูปที่2.10 Application Line ส ำหรับกำรแจ้งเตือนกำรท ำงำน [8] จำกรูปที่ 2.10 Application Line ใช้ในกำรแสดงกำรใช้งำน กำรสื่อสำรแจ้งเตือนให้ผู้ใช้งำนทรำบถึง สถำนะกำรท ำงำนของระบบแจ้งเตือนเมื่ออุปกรณ์แสดงค่ำเกินที่ก ำหนดและ มีกำรเปิ ด/ปิ ดกำรใช้งำนโดย แจ้งให้ผู้ดูแลทรำบสถำนะของระบบ

### 2.10 ทฤษฎีเกี่ยวกับ Blynkversion 2.27.24

Blynk Platform ถูกออกแบบมำเพื่อใช้ในกำรควบคุมอุปกรณ์ Internet of Things ซึ่งมีคุณสมบัติใน กำรควบคุมจำกระยะไกลผ่ำนเครือข่ำยอินเตอร์เน็ต และยังสำมำรถแสดงผลค่ำจำกเวลำต่ำง ๆ ได้อีกด้วย แสดงดังรูปที่ 2.11

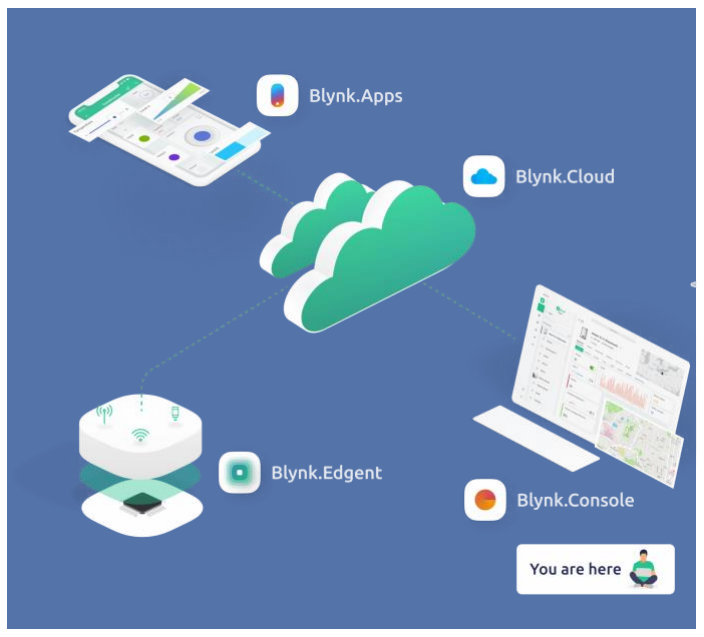
[picture p75: figure]

รูปที่2.11 โปรแกรม Blynk [9] จำกรูปที่ 2.11 Blynk คือ Application ส ำเร็จรูปส ำหรับงำน IOT มีควำมน่ำสนใจคือกำรเขียน โปรแกรมที่ง่ำย ไม่ต้องเขียน App เองสำมำรถใช้งำนได้อย่ำง Real time สำมำรถเชื่อมต่อ Device ต่ำง ๆ เข้ำ กับ Internet ได้อย่ำงง่ำยดำย ไม่ว่ำจะเป็ น Arduino Esp8266 Esp32 Nodemcu Rasberry pi น ำมำแสดงบน Application ได้อย่ำงง่ำยดำย แล้วที่ส ำคัญ Application Blynk ยังฟรี และ รองรับในระบบ IOS และ Android อีกด้วย

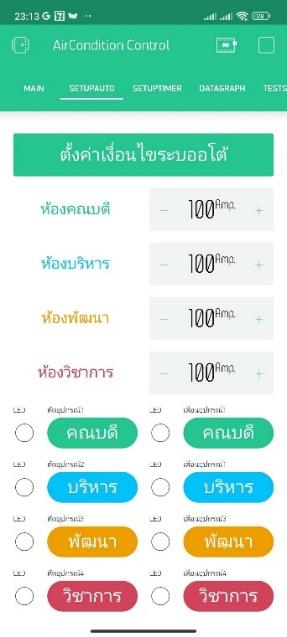
[picture p76: figure]
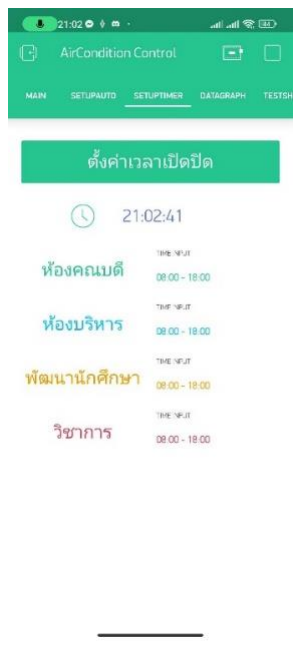
[picture p77: figure]
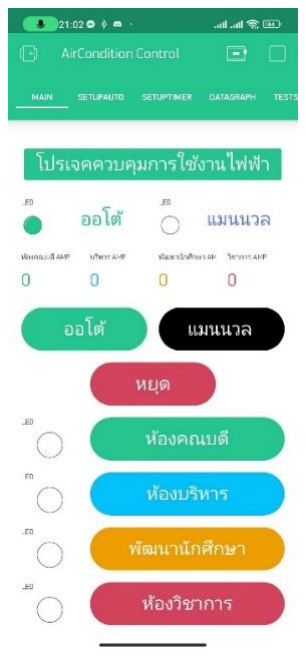
[picture p78: figure]

รูปที่2.12 หน้ำจอ App ที่ท ำกำรออกแบบโดยผู้ใช้ผ่ำนโปรแกรม Blynk [10] จำกรูปที่ 2.12 สำมำรถจับลำกจัดเลียงปรับขนำดให้เหมำะสมตรงตำมที่เรำต้องกำรของผู้ออกแบบ ระบบ เพื่อง่ำยตอนกำรใช่งำน Application

### 2.11 ทฤษฎีเกี่ยวกับ Switching Power Supply

เป็ นแหล่งจ่ำยไฟตรงคงค่ำแรงดันแบบหนึ่ง และสำมำรถเปลี่ยนแรงดันไฟจำกไปสลับโวลต์สูง ให้ เป็ นแรงดันไฟตรงค่ำต ่ำ เพื่อใช้ในงำนอิเลคทรอนิกส์ได้เช่นเดียวกันแหล่งจ่ำยไฟเชิงเส้น (Linear Power Supply) ถึงแมเ้พำเวอร์ซัพพลำยท้งัสองแบบจะตอ้งมีกำรใช้หมอ้แปลงในกำรลดทอนแรงดันสูงให้เป็น แรงดันต ่ำเช่นเดียวกัน แต่สวิตชิ่งเพำเวอร์ซัพพลำยจะตอ้งกำรใช้หมอ้แปลงที่มีขนำดเล็ก และน้ำ หนักน้อย เมื่อเทียบกบัแหล่งจ่ำยไฟเชิงเส้น อีกท้งัสวิตชิ่งเพำเวอร์ซัพพลำยยงัมีประสิทธิภำพสูงกว่ำ ส ำหรับลักษณะ Switching Power Supply ดังรูปที่ 2.13

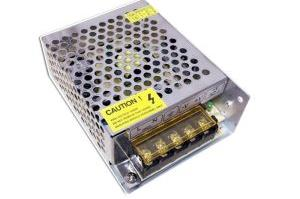
[picture p79: figure]

รูปที่2.13Switching Power Supply [11] จำกรูปที่ 2.13 แสดงลักษณะ Switching Power Supply ซึ่งรับแรงดันไฟจำก 220-240 โวลต์ โดยผ่ำน กำรควบคุมด้วยสวิตช์ ส ำหรับ AT และเมนบอร์ดแล้วยังส่งแรงดันไฟส่วนหนึ่งกลับไปที่ช่อง AC output

เพื่อเล้ียงตวัมอนิเตอร์และจะส่งแรงดนั ไฟ 220 โวลต์อกั ส่วนหน่ึงเขำ้สู่หน่วยกำรท ำงำนที่ท ำหน้ำที่แปลง แรงดันไฟกระแสสลับ 220 โวลต์ ให้เป็ นไฟกระแสตรง 300 โวลต์ โดยไม่ผ่ำนหม้อแปลงไฟ

### 2.12 ทฤษฎีเกี่ยวกับกำรส่งข้อมูลระหว่ำงบอร์ด

กำรสื่อสำรแบบอนุกรม (Serial Communication) สำมำรถท ำได้โดยกำรส่งข้อมูลจำกตัวส่ง (Transmitter) ไปยังตัวรับ (Receiver) คร้ังละ 1 ไบต์ดังน้ันกำรส่งข้อมูลจำ นวน 1 ไบต์จำ เป็นต้องใช้ สำยสัญญำณอย่ำงน้อย 2 เส้น ในกำรส่งข้อมูล คือต้องใช้สำยสัญญำณ 1 สำย ส ำหรับกำรส่งข้อมูล และ 1 สำย ส ำหรับกรำวน์ สำมำรถแบ่งกำรสื่อสำรแบบอนุกรมออกเป็น 2 ประเภท ไดแ้ก่
– แบบซิงโครนัส (Synchronous) เป็ นรูปแบบหนึ่งของวิธีกำรส่งข้อมูล โดยใช้สัญญำณ Clock มำ เป็นตวักำ หนดจงัหวะในกำรรับส่งขอ้ มูลกำรส่งขอ้ มูลแบบน้ีเป็นกำรรับส่งที่ค่อนขำ้งมีเสถียรภำพ และส่ง ได้ที่ควำมเร็วสูง มีโอกำสที่ข้อมูลจะสูญหำยระหวำ่ งกำรส่งนอ้ย ตวัอยำ่ งกำรส่งขอ้มูลลกัษณะน้ีเช่น I2C I2S SPI ดังรูปที่2.14

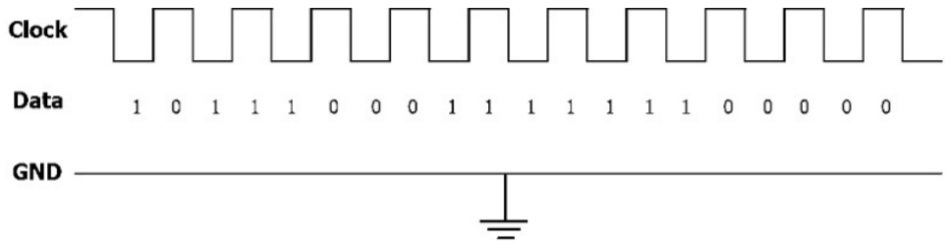
[picture p80: figure]

รูปที่2.14 รูปแบบกำรรับส่งข้อมูลแบบซิงโครนัส [12] จำกรูปที่ 2.14 แสดงกำรส่งข้อมูลแบบซิงโครนัส ผู้ส่งท ำกำรส่งบิตติดต่อกันยำว ๆ ถ้ำผู้ส่งต้องกำร แบ่งช่วงกลุ่มขอ้มูลก็ส่งกลุ่มบิต 0 หรือ1 เพื่อแสดงสถำนะวำ่ ง เมื่อแต่บิตมำถึงผรู้ับ ผู้

ัรับจะนบัจำ นวนบิต
แล้วจับกลุ่มของบิตให้เป็ นไบต์ที่มี 8 บิต
–แบบอะซิงโครนัส (Asynchronous) เป็ นกำรส่งข้อมูลที่ไม่ต้องใช้สัญญำณ Clock มำเป็ น
ตัวก ำหนดจังหวะกำรรับส่งขอ้ มูลแต่ใชว้ิธีกำ หนดรูปแบบกำรรับส่งขอ้มูลข้ึนมำแทน และอำศยักำรกำ หนด อตัรำเร็วของกำรรับ และส่งที่เท่ำกนั ท้งัฝั่งรับและฝั่งส่งขอ้ ดีของกำรใช้Asynchronous คือสำมำรถสื่อสำร แบบ Full Duplex รับ และ ส่งได้ในเวลำเดียวกัน แต่กำรสื่อสำรแบบ Asynchronous มีโอกำสที่ข้อมูลจะสูญ หำยขณะรับหรือส่งข้อมูลมำกกว่ำแบบ Synchronous

รูปที่2.15 รูปแบบกำรรับส่งข้อมูลแบบอะซิงโครนัส [12]

### 2.13 งำนวิจัยที่เกี่ยวข้อง

ในหัวขอ้ น้ีเสนองำนวิจยัที่ผูว้ิจยัไดท้ ำ กำรศึกษำเพื่อนำ มำเป็นแนวทำงในกำรพฒั นำระบบวิจยัของ ข้ำพเจ้ำซ่ึงได้แก่ 1. งำนวิจัยระบบประหยัดพลังงำนแบบออนไลน์ส ำหรับควบคุมเครื่ องปรับอำกำศ กรณีศึกษำสำขำวิทยำศำสตร์คอมพิวเตอร์ คณะวิทยำศำสตร์และเทคโนโลยี มหำวิทยำลัยเทคโนโลยีรำช มงคลศรีวิชัย 2. งำนวิจัยระบบควบคุมอุปกรณ์ไฟฟ้ำและรักษำควำมปลอดภัยภำยในบ้ำนแบบออนไลน์ กรณีศึกษำบ้ำนคุณร ำไพ ทองทิพย์ ต ำบลร่อนพิบูลย์ อ ำเภอร่อนพิบูลย์
2.13.1 งำนวิจัยระบบประหยัดพลังงำนแบบออนไลน์ส ำหรับควบคุมเครื่องปรับอำกำศ กรณีศึกษำ สำขำวิทยำศำสตร์คอมพิวเตอร์คณะวิทยำศำสตร์และเทคโนโลยี มหำวิทยำลัยเทคโนโลยีรำชมงคลศรีวิชัย (Energy Saving Online Control System for Air Conditioner Case Study of Computer Science at Faculty of Science and Technology , RMUTSV)
เป็ นผลงำนของ นำงสำวจิรนนั ท์ชอบหวำน นำงสำวชฎำภรณ์จวั่ นำน และนำงสำววิสสุตำ ขุนมีตำมหลักสูตรวิทยำศำสตรบัณฑิต สำขำวิชำเทคโนโลยีสำรสนเทศ ระบบควบคุมเครื่องปรับอำกำศ ได้ แนวคิดที่จะท ำให้ระบบประหยัดพลังงำนแบบออนไลน์ส ำหรับควบคุมเครื่องปรับอำกำศ กรณีศึกษำสำขำ วิทยำศำสตร์คอมพิวเตอร์ คณะวิทยำศำสตร์และเทคโนโลยีมหำวิทยำลัยเทคโนโลยีรำชมงคลศรี วิชัย สำมำรถสั่งงำนเปิด-ปิดเครื่องปรับอำกำศไดส้ ำมำรถต้งัเวลำปิ ดระบบได้4 ช่วงเวลำ เพื่อใช้ใน กรณีที่ผู้ใช้งำน ลืมปิ ดเครื่องปรับอำกำศหลังจำกใช้งำน โดยยผู้ใช้เลือกสั่งงำนผ่ำนหน้ำเว็บเบรำว์เซอร์หรือกดสวิตซ์ เปิ ด-ปิ ดตำมปกติ
ด้วยเหตุดังกล่ำวข้ำงต้นทำงคณะผู้วิจัยจึงได้เล็งเห็นปัญหำที่เกิดข้ึนและได้มีแนวคิดที่จะท ำ กำรสร้ำงระบบประหยัดพลังงำนแบบออนไลน์ส ำรับควบคุมเครื่องปรับอำกำศ กรณีศึกษำสำขำวิทยำศำสตร์ คอมพิวเตอร์คณะวิทยำศำสตร์และเทคโนโลยีมหำวิทยำลยัเทคโนโลยีรำชมงคลศรีวิชยัข้ึนมำ ซึ่งระบบ สำมำรถควบคุมกำรเปิ ด-ปิ ดเครื่องปรับอำกำศผ่ำนระบบเครือข่ำยคอมพิวเตอร์ไดร้ะบบสำมำรถต้งเ ั วลำปิ ด เครื่องปรับอำกำศตำมเวลำที่ก ำหนดได้4 ช่วงเวลำอีกท้งยังค ั วบคุมระบบแบบออนไลน์ไดซ้่ึงจะช่วยเพิ่ม ควำมสะดวกสบำยให้แก่ผูใช้เ ้ ครื่องปรับอำกำศ ซึ่งนอกจำกจะช่วยประหยัดเวลำ ยังสำมำรถช่วยประหยัด พลังงำนไฟฟ้ำได้ละช่วยในกำรตรวจสอบกำรใช้งำนของเครื่องปรับอำกำศรวมถึงกำรควบคุมระบบกำรเปิ ด-ปิ ดเครื่องปรับอำกำศได้ง่ำยข้ึน

กำรออกแบบระบบโดยรวม
ระบบประหยัดพลังงำนแบบออนไลน์ส ำรับควบคุมเครื่องปรับอำกำศ กรณีศึกษำสำขำ วิทยำศำสตร์คอมพิวเตอร์ คณะวิทยำศำสตร์และเทคโนโลยี มหำวิทยำลยัเทคโนโลยีรำชมงคลศรีวิชยั น้ัน พบว่ำ ภำยในสำขำวิทยำศำสตร์คอมพิวเตอร์น้ันมีเครื่องปรับอำกำศจำ นวน 10 เครื่อง และมีกำรเปิดใช้ เครื่องปรับอำกำศต้งัแต่ช่วงเวลำ 8.00 น. โดยประมำณของแต่ละวนัและไม่มีกำรปิดจนกว่ำจะถึงตอนเยน็ ระบบจะแสดงกำรเชื่อมต่อกำรท ำงำนระหว่ำงบอร์ดแสดงลักษณะดังรูปที่ 2.16

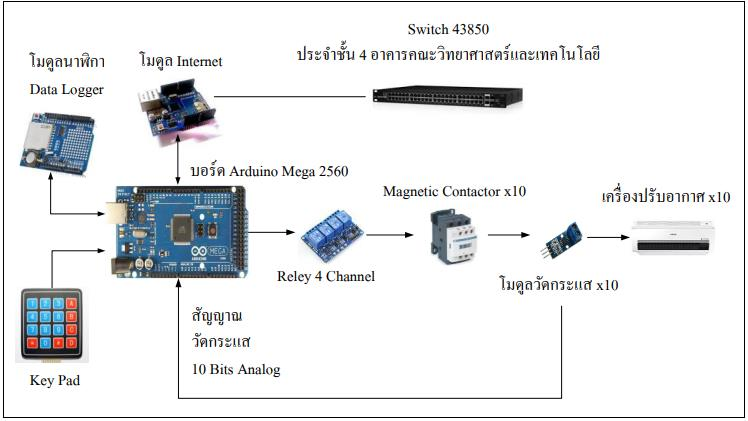
[picture p81: figure]

รูปที่2.16กำรออกแบบด้ำนฮำร์ดแวร์[13] จำกรูปที่ 2.16 ระบบสำมำรถท ำงำนได้ก็ต่อเมื่อได้รับกำรเชื่อมต่อเข้ำกับเครือข่ำยเพื่อเป็ นกำรรับค ำ สั่งจำกผูใ้ช้และส่งกลับข้อมูลไปยงัหน้ำจอแสดงผล เพื่อให้ผู้ใช้งำนระบบรับรู้สถำนะกำรใช้งำนของ เครื่องปรับอำกำศ
กล่องควบคุมระบบมีกำรติดต้งัอุปกรณ์ภำยใน เพื่อใหร้ะบบสำมำรถทำ งำนไดอย่ำงถูกต้อง ้ โดยมีโครงสร้ำงภำยในกล่องควบคุมระบบ ดังรูปที่ 2.17

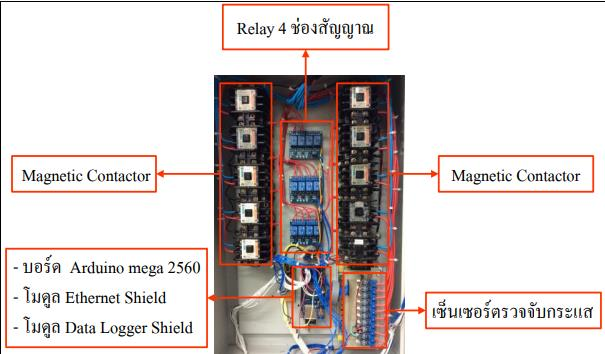
[picture p82: figure]

รูปที่2.17 โครงสร้ำงภำยในกล่องควบคุมระบบ [13] จำกรูปที่ 2.17แสดงลักษณะโครงสร้ำงภำยในกล่องควบคุมระบบ จะประกอบด้วย บอร์ด Arduino mega 2560 บอร์ดรีเลย์ 4 ช่องสัญญำณ แมกเนติกคอนแทคเตอร์โมดูล Ethernet Shield โมดูล Data Logger Shieldและเซ็นเซอร์ตรวจจับกระแสโดยมีข้นั ตอนกำรออกแบบดงัรูปที่ 2.18

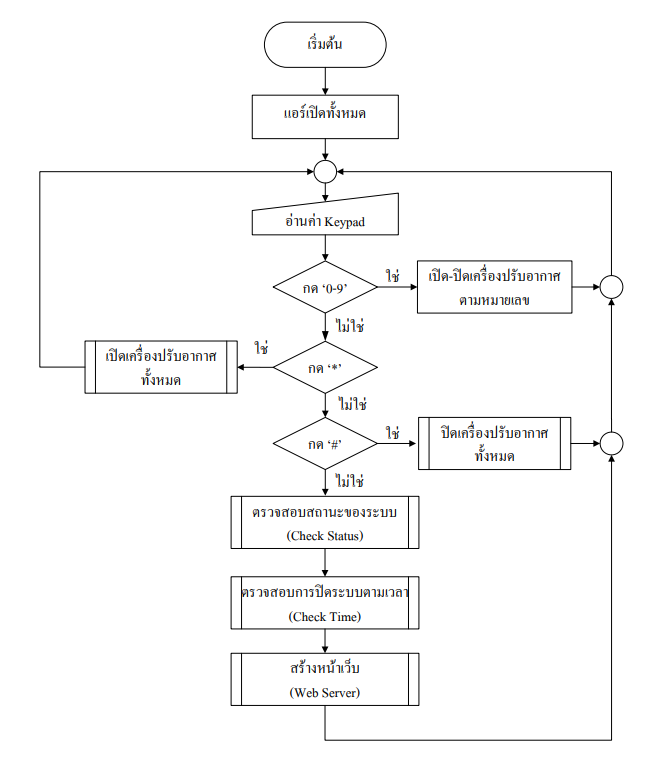
[picture p83: figure]

รูปที่2.18Flow chart กำรท ำงำนของระบบโดยรวม [13] จำกรูปที่2.18แสดงกำรเข้ำใช้งำนระบบผ่ำนกำรกดด้วย Keypad ซึ่งผู้ใชสำมำรถควบคุมกำรท ำงำน ของสวิตซ์เครื่องปรับอำกำศผ่ำนกำรกดด้วย Keypad เมื่อผูใ้ชส้ ั่งเปิด-ปิ ด ที่ระบบหรือที่ตัวสวิตซ์โดยตรงก็ ข้ึนสถำนะกำรทำ งำนของเครื่องปรับอำกำศให้ผู้ใช้งำนทรำบหลอดไฟ LED หน้ำตู้ควบคุม

2.13.2 งำนวิจัยระบบควบคุมอุปกรณ์ไฟฟ้ำและรักษำควำมปลอดภัยภำยในบ้ำนแบบออนไลน์ กรณีศึกษำบ้ำนคุณร ำไพ ทองทิพย์ ต ำบลร่อนพิบูลย์ อ ำเภอร่อนพิบูลย์จังหวัดนครศรีธรรมรำช An Online System For Electrical Appliances And Home Security Controls: A Case Stude At Ban Rampai Thongtip, Tambon Ronpiboon, Ronpiboon District, Nakhon Si Thammarat
เป็ นผลงำนของ นำยจักรวำล ชลสงครำม นำยเจนณรงค์ แก้วนุ้ย นำยสถำพร สุขคุ้ม งำนวิจัย น้ีเป็ นกำรสร้ำงระบบควบคุมอุปกรณ์ไฟฟ้ำและรักษำควำมปลอดภัยภำยในบ้ำนแบบออนไลน์กรณีศึกษำ บ้ำนคุณร ำไพ ทองทิพย์ ต ำบลร่อนพิบูลย์ อ ำเภอร่อนพิบูลย์ จังหวัดนครศรีธรรมรำชระบบมีกำรท ำงำน 2 ส่วนคือ กำรควบคุมอุปกรณ์ไฟฟ้ำ และรักษำควำมปลอดภัยภำยในบ้ำน ในส่วนของกำรควบคุมอุปกรณ์ ไฟฟ้ำผูว้ิจยัไดอ้อกแบบใหร้ะบบควบคุมอุปกรณ์ไดท้ ้งัหมด 7อุปกรณ์คือ หลอดไฟ 4 ชุด เตำ้เสียบไฟ 2 ชุด และเครื่องปรับอำกำศ 1 เครื่อง ส ำหรับกำรรักษำควำมปลอดภัยระบบจะท ำกำรเตือนด้วยกำรส่งข้อควำมไป ทำงแอปพลิเคชนั ไลน์เมื่อเกิดเหตุกำรณ์ต่ำง ๆ เช่น เกิดควำมเคลื่อนไหวภำยในบำ้น เกิดเปลวไฟ เกิดกำรรั่ว ของแก๊ส และอุณหภูมสูงผิดปกติเป็นตน้ ส ำหรับกำรควบคุมกำรทำ งำนของระบบสำมำรถควบคุมได้ท้งั แบบออนไลน์ผ่ำนแอปพลิเคชัน Blynk และผ่ำนกำรกดปุ่ มคีย์แพคหน้ำตู้ระบบ กำรออกแบบระบบได้ใช้ไมโครคอนโทรลเลอร์ Arduino Mega2560 เป็ นตัวประมวลผล หลักและบอร์ด Ethernet Shield W5100 ส ำหรับเชื่อมต่ออินเทอร์เน็ต มีอินพุตของระบบจำ นวน 5 ตวัไดแ้ก่ เซ็นเซอร์วัดอุณหภูมิ เซ็นเซอร์ตรวจจับแก๊ส เซ็นเซอร์ตรวจจับกำรเคลื่อนไหว เซ็นเซอร์ตรวจจับเปลวไฟ และเซ็นเซอร์ตรวจจับกำรใช้อุปกรณ์ไฟฟ้ำ ส ำหรับเอำต์พุตประกอบด้วยบอร์ดรีเลย์ 8 ช่องส ำหรับตัดต่อ วงจรไฟฟ้ำ
ด้วยเหตุดังกล่ำวผู้วิจัยจึงมีแนวคิดค้นที่จะสร้ำงระบบควบคุมกำรเปิ ด-ปิ ดไฟแบบออนไลน์ และรักษำควำมปลอดภัย เพื่อลดปัญหำข้ำงต้นระบบที่ผู้วิจัยไดจ้ดั ทำ ข้ึนมำเพื่อดูแลควบคุมกำรเปิด-ปิ ดไฟ และรักษำควำมปลอดภัย ช่วยในกำรอ ำนวยควำมสะดวกในกำรใช้งำน โดยมีกำรออกแบบปุ่ มกดที่หน้ำ ตู้ควบคุม และมีกำรติดต้ังตู้ควบคุมไวบ้ ริเวณบ้ำนพกัของเจ้ำของบ้ำน เนื่องจำกระบบของผูว้ิจัยได้ใช้ ตู้ควบคุมในกำรใช้ควบคุมกำรเปิ ด-ปิ ดและใช้เซนเซอร์ต่ำง ๆ เพื่อแจง้เตือนควำมปลอดภยัโดยข้นั ตอนกำร วิเครำะห์ปัญหำเพื่อน ำมำเป็ นข้อมูลในกำรพัฒนำระบบ
กำรออกแบบระบบโดยรวม
แผนผงักำรติดต้งัระบบควบคุมกำรเปิด-ปิ ดอุปกรณ์ไฟฟ้ำและรักษำควำมปลอดภัยแบบ ออนไลน์ บ้ำน ร ำไพ ทองทิพย์ แสดงได้ดังรูปที่2.19

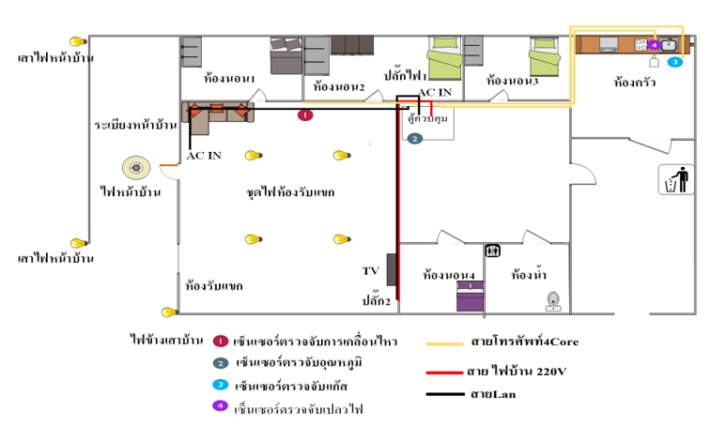
[picture p84: figure]

รูปที่2.19แผนผงักำรติดต้งั [14] จำกรูปที่ 2.19 แสดงแผนผงัพ้ืนที่กำรติดต้งัระบบควบคุมอุปกรณ์ไฟฟ้ำและรักษำควำมปลอดภยั ภำยในบ้ำนแบบออนไลน์กรณีศึกษำบ้ำนคุณร ำไพ ทองทิพย์ จะประกอบไปด้วยสำยไฟฟ้ำ 220v จ ำนวน 30 เมตร ที่เสียบสำยไฟเล้ียงมำจำกเบรกเกอร์สำยโทรศพั ท์4 core จ ำนวน 35 เมตรเป็ นสำยสัญญำณของ เซ็นเซอร์ท้ังหมด 4 ตัวประกอบไปด้วย เซ็นเซอร์ตรวจจับอุณหภูมิ จ ำนวน 1 ตัวติดต้ังหน้ำตู้ควบคุม เซ็นเซอร์ตรวจจับแก๊ส จ ำนวน 1 ตวั ติดต้งับริเวณใกลก้ บัถงัแก๊ส เซ็นเซอร์ตรวจจบักำรเคลื่อนไหวจำ นวน 1 ตวั ติดต้งัเสำกลำงบำ้น เซ็นเซอร์ตรวจจบั เปลวไฟ จำ นวน 1 ตัว ติดต้งัขอบฝ้ำภำยในห้องครัวให้ตรงองศำ กับเตำแก๊ส และสำย LAN จ ำนวน 12 เมตรเพื่อใช้ในกำรเชื่อมต่อ อินเทอร์เน็ตจำก Router ตูค้วบคุมระบบมีกำรติดต้งัอุปกรณ์ภำยใน เพื่อใหร้ะบบสำมำรถทำ งำนไดอ้ยำ่ งถูกตอ้ง โดยมีโครงสร้ำงภำยในตู้ควบคุมระบบ แสดงได้ดังรูปที่ 2.20

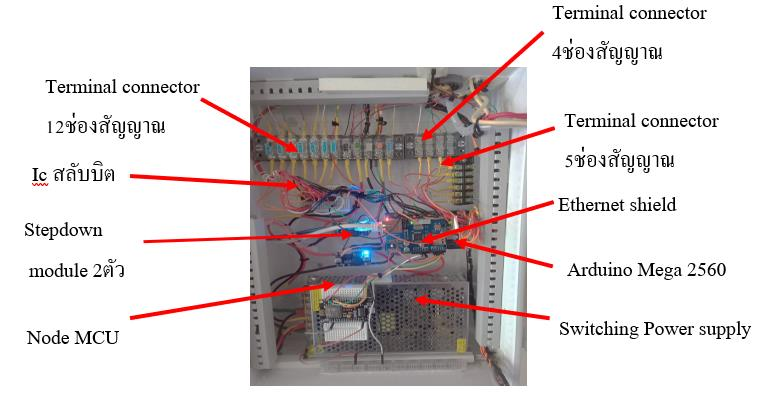
[picture p85: figure]

รูปที่ 2.20อุปกรณ์ภำยในตู้ระบบ [14] จำกรูปที่ 2.20 แสดงลักษณะของตู้ควบคุมระบบโดยมีอุปกรณ์ที่ติดต้ังเชื่อมกันกับตู้ควบคุม ประกอบไปด้วย Terminal ท้งัหมด 3 ชุดเพื่อเป็ นจุดพักสำย ขำ IC เพื่อรับขำ ขำสลับกันกับ AC -IN ภำยนอก ตู้ควบคุม Stepdownเพื่อปรับแรงดันไฟไปยังอุปกรณ์ต่ำง ๆ Switching power supply เพื่อแปลงไฟจำก เบรก เกอร์ มำยัง stepdown เพื่อส่งไฟไปเล้ียงอุปกรณ์ต่ำง ๆ Ethernet shield เพื่อ เชื่อมต่อ internet จำก Board Arduino mega2560 ไปยัง cloud IOT NodeMCU เพื่อใช้ส่งคำ สั่งแจ้งเตือนไปในไลน์ผูใ้ช้งำน Board Arduino mega2560 เพื่อใช้ควบคุมกำรท ำงำนตำมเงื่อนไขของระบบ

บทที่ 3
กำรวิเครำะห์และออกแบบระบบ

วิธีกำรด ำเนินงำน ทำงผวู้ิจยัไดแ้บ่งวิธีกำรปฏิบตัิงำนออกเป็นข้นั ตอน เพื่อให้ได้ระบบที่สมบูรณ์ และมีประสิทธิภำพ โดยมีวิธีกำรดำ เนินงำนเป็น 2ข้นั ตอน
1. ข้นั ตอนกำรวิเครำะห์ปัญหำ
2. ข้นั ตอนกำรออกแบบระบบ

### 3.1 ขั้นตอนกำรวิเครำะห์ปัญหำ

จำกที่ผู้วิจัยได้ท ำกำรศึกษำค้นคว้ำพบว่ำในปัจจุบันมีเครื่องใช้ไฟฟ้ำจ ำนวนมำก ท ำให้มีค่ำใช้จ่ำยที่ สูง และไม่สำมำรถรับรู้ได้ว่ำอุปกรณ์ตัวไหนมีกำรเปิ ดใช้งำนอยู่ ก็อำจจะมีโอกำศในกำรลืมปิ ดใช้งำน อุปกรณ์ไฟฟ้ำที่ไม่ได้ใช้งำนแล้ว จำกปัญหำข้ำงต้นทำงผู้วิจัยจึงได้มีแนวคิดที่จะสร้ำงระบบอัตโนมัติแบบออนไลน์ส ำหรับควบคุม อุปกรณ์ไฟฟ้ำเพื่อกำรประหยดัพลงังำน ใหแ้ก่สำขำวิชำเทคโนโลยสีำรสนเทศ คณะวิทยำศำสตร์เทคโนโลยี มหำวิทยำลัยเทคโนโลยีรำชมงคลศรีวิชัย อ ำเภอทุ่งสง จังหวัดนครศรีธรรมรำช เพื่อให้สำมำรถควบอุปกรณ์ ไฟฟ้ำและอ ำนวยควำมสะดวกในกำรควบคุมอุปกรณ์ไฟฟ้ำของบุคลำกรในสำขำรวมถึงเป็ นกำรลดค่ำใช้จ่ำย ภำยในสำขำได้ซ่ึงระบบน้ีสำมำรถควบคุมอุปกรณ์ไฟฟ้ำได้โดยอตัิโนมตัิและสำมำรถทำ งำนตำมที่ผูใ้ช้ ควบคุมจำกระบบออนไลน์ผ่ำนโทรศัพท์มือถือ
3.1.1 ข้นั ตอนรวบรวมของขอ้ มูลและศึกษำระบบงำน
จำกกำรส ำรวจกำรใช้ไฟฟ้ำห้องพัฒนำนักศึกษำ/งำนบริหำรและวำงแผน มักเกิดปัญหำกำรปิ ดใช้ งำนไฟฟ้ำหลังจำกมีกำรเกิดไฟฟ้ำขัดข้องท ำให้ลืมปิ ดกำรใช้งำนเครื่องใช้ไฟฟ้ำ มีผลให้เกิดค่ำใช้จ่ำยที่สูงเกิด จ ำเป็ นจึงต้องเดินตรวจสอบเครื่องใช้ไฟฟ้ำว่ำได้ท ำกำรปิ ดกำรใช้งำนเครื่องใช้ไฟฟ้ำท้งัหมดแลว้
3.1.2 ข้นั ตอนกำรกำ หนดปัญหำและควำมตอ้งกำรของระบบ
1. ประเด็นปัญหำ
-ผู้ดูแลไม่สำมำรถควบคุม กำรเปิ ด-ปิ ด
-ผู้ดูแลต้องกำรควบคุม กำรเปิ ด-ปิ ดไฟฟ้ำระยะไกล
2 ควำมต้องกำรของระบบ
จำกกำรวิเครำะห์ประเด็นและปัญหำของกำรใช้งำนอุปกรณ์ไฟฟ้ำ ทำงผู้วิจัยพบว่ำ ปัญหำดงักล่ำวจะจะส่งผลใหเ้กิดค่ำใชจ้่ำยที่สูงข้ึน ผดูู้แลตอ้งเสียเวลำ ดงัน้นัผวู้ิจยัจึงเขำ้มำแกป้ ระเด็นปัญหำ ดังกล่ำว โดยได้คิดค้นสร้ำง ระบบอัตโนมัติแบบออนไลน์ส ำหรับควบคุมกำรใช้งำนอุปกรณ์ไฟฟ้ำ ระบบ สำมำรถท ำงำนได้ 2รูปแบบ คือ

1. ระบบสำมำรถท ำงำนแบบอัตโนมัติ
2. ระบบสำมำรถเลือกเปิ ดหรือปิ ดอุปกรณ์ใดก็ได้ตำมที่ผู้ใช้ต้องกำร โดยกำร แกป้ ัญหำ ดงัน้ี
- ชุดไมโครคอนโทรลเลอร์ ATmega2560 ส ำหรับเป็ นหน่วยประมวลผลกลำง -จอแสดงผล LCD 20x4 ใช้ส ำหรับแสดงผลต่ำง ๆ
- Node MCU 8266 เพื่อส่งแจ้งเตือนผ่ำน Application Line
-แป้นพิมพ์ Keypad 4x4 ใช้ส ำหรับป้อนข้อมูลเข้ำไปในระบบ -โมดูลวัดปริมำณกำรใช้ไฟฟ้ำ ใช้วันปริมำณกำรใช้ไฟฟ้ำ

### 3.2 ขั้นตอนกำรออกแบบระบบ

กำรออกแบบระบบเป็นกระบวนกำรที่แสดงให้เห็นถึงข้นั ตอนกำรทำ งำนที่เกิดข้ึนในระบบและกำร เคลื่อนที่ของข้อมูลจำกที่หน่ึงไปอีกยงัที่หน่ึงซ่ึงกำรออกแบบน้ีมีผูว้ิจัยได้เลือกวิธีกำรออกแบบโดยใช้ แผนภำพกระแสข้อมูล (DFD : Data Flow Diagram) ดงัน้ี
3.2.1 แผนภำพบริบท (Context Diagram) แผนภำพบริบทแสดงให้เห็นถึงข้อมูลโดยรวมระบบว่ำได้รับข้อมูลจำกที่ใดมีกำรติดต่อกัน ระหว่ำงระบบอย่ำงไรและระบบมีควำมเกี่ยวข้องกับส่วนใดบ้ำงในกำรออกแบบเพื่อในเห็นภำพรวมของ ระบบและควำมสัมพันธ์ระหว่ำงส่วนต่ำงของระบบผู้วิจัยจึงจัดท ำแผนภำพบริบทแสดงได้ดังรูปที่ 3.1

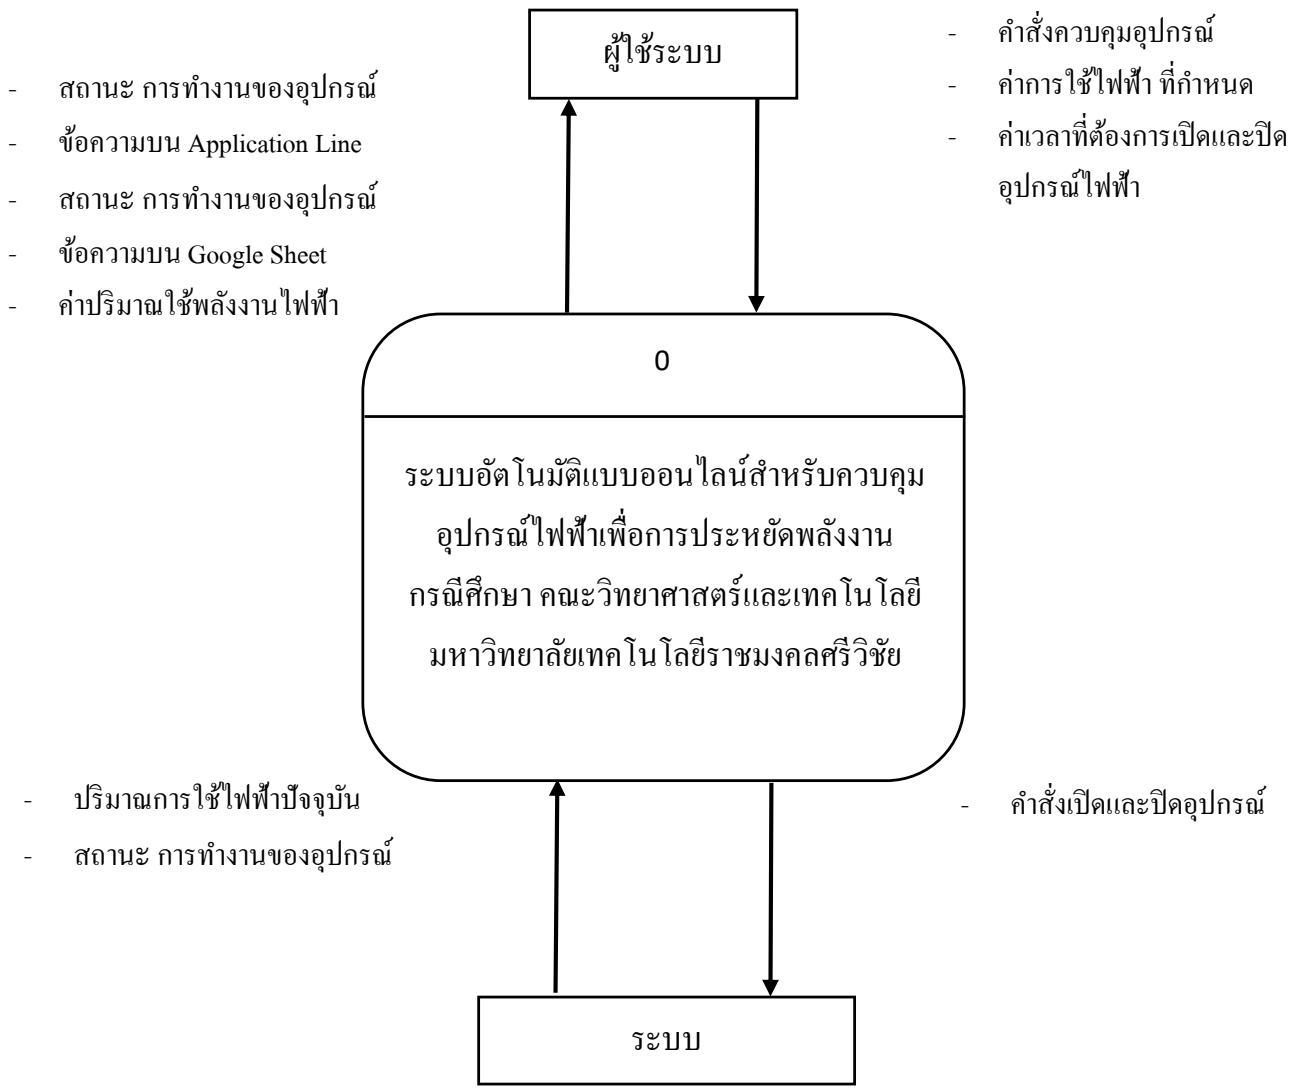
[picture p86: figure]
- คำ สั่งควบคุมอุปกรณ์ - ค่ำกำรใช้ไฟฟ้ำ ที่ก ำหนด - ค่ำเวลำที่ต้องกำรเปิ ดและปิ ด อุปกรณ์ไฟฟ้ำ; - ปริมำณกำรใช้ไฟฟ้ำปัจจุบัน - สถำนะกำรท ำงำนของอุปกรณ์; - คำ สั่งเปิดและปิ ดอุปกรณ์; ผู้ใช้ระบบ; ระบบอัตโนมัติแบบออนไลน์ส ำหรับควบคุม อุปกรณ์ไฟฟ้ำเพื่อกำรประหยัดพลังงำน กรณีศึกษำ คณะวิทยำศำสตร์และเทคโนโลยี มหำวิทยำลัยเทคโนโลยีรำชมงคลศรีวิชัย; ระบบ; - สถำนะกำรท ำงำนของอุปกรณ์ - ข้อควำมบน Application Line - สถำนะกำรท ำงำนของอุปกรณ์ - ข้อควำมบน Google Sheet - ค่ำปริมำณใช้พลังงำนไฟฟ้ำ

รูปที่3.1แผนภำพบริบทของระบบ จำกรูปที่ 3.1แสดงถึงควำมสัมพันธ์ระหว่ำงผู้ใช้กับระบบโดยที่ผู้ใช้สำมำรถใช้ระบบอัตโนมัติแบบ ออนไลน์ส ำหรับควบคุมอุปกรณ์ไฟฟ้ำเพื่อกำรประหยดัพลงังำน โดยกำรสั่งงำนผ่ำนปุ่ม Keypad ให้แสดง ผ่ำนจอ LED จำกน้นั ระบบจะสั่งกำรให้ไปควบคุมปุ่มที่รับค่ำคำ สั่งในกำรทำ งำนของระบบ แบ่งออกเป็น 3 ส่วน คือ วัดปริมำณกำรใช้ไฟฟ้ำ เปิ ด-ปิ ดอุปกรณ์ไฟฟ้ำ ปิ ดอุปกรณ์ไฟฟ้ำตำมค่ำที่ก ำหนด ปิ ดอุปกรณ์ไฟฟ้ำ ตำมช่วงเวลำที่ก ำหนด
3.2.2 กำรวิเครำะห์ส่วนต่ำง ๆ ของระบบ
ผู้วิจัยได้น ำข้อมูลจำกกำรศึกษำมำท ำกำรวิเครำะห์ถึงปัญหำและกระบวนกำรท ำงำนของระบบ โดย วิเครำะห์ปัญหำและออกแบบข้ันตอนกำรท ำงำนของระบบในส่วนต่ำง ๆ เพื่อที่จะอธิบำยข้ันตอน กระบวนกำรทำ งำนของระบบไดอ้ย่ำงชดัเจนยิ่งข้ึน ข้นั ตอนกำรทำ งำนของระบบ ต่ำง ๆ จะเขียนเป็นผงังำน ผังงำน Flow chart คือ รูปภำพ Image หรือ สัญลักษณ์Symbol ที่ใชเ้ขียนแทนข้นั ตอน คำ อธิบำยขอ้ควำม

หรือคำ พูดที่ใชอ้ลักอริทึม เพื่อเสนอข้นั ตอนของระบบให้เขำ้ใจตรงกนัแทนคำ พูด หรือขอ้ควำมทำ ให้เขำ้ใจ ง่ำยกวำ่ ดงัน้ี

### 1. ผังงำนขั้นตอนกำรท ำงำนของระบบโดยรวมที่บอร์ด ATmega2560 (System Flowchart)

ผงังำนข้นั ตอนกำรทำ งำนของระบบโดยรวมเป็นกำรอธิบำยถึงกำรทำ งำนของโปรแกรมเมื่อเริ่มเปิด ใชง้ำนระบบว่ำมีข้นั ตอนหลกัเป็นอย่ำงไรบำ้ง มีกำรตรวจสอบเงื่อนไข และปุ่มกดในกำรควบคุมระบบมีกี่ เงื่อนไข แสดงได้ดังรูปที่ 3.2

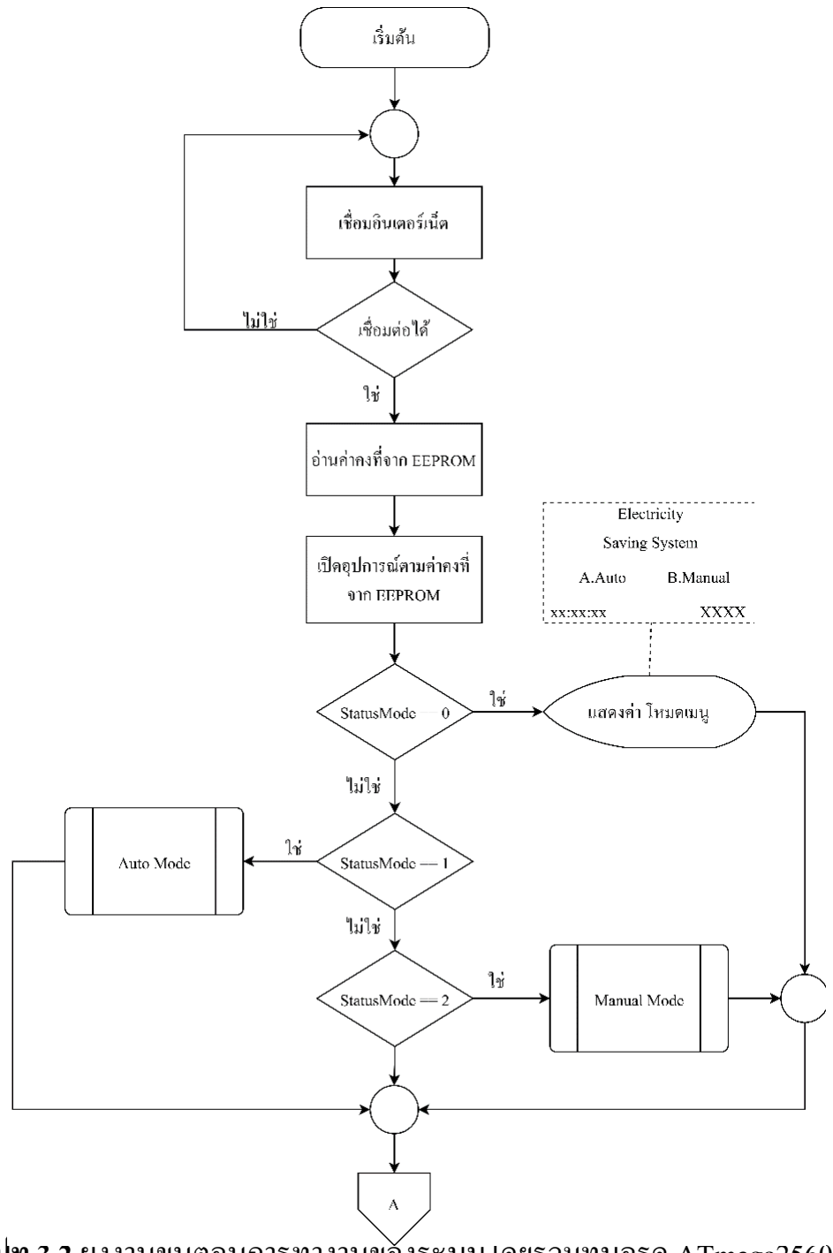
[picture p87: figure]

รูปที่3.2ผงังำนข้นั ตอนกำรทำ งำนของระบบโดยรวมที่บอร์ด ATmega2560

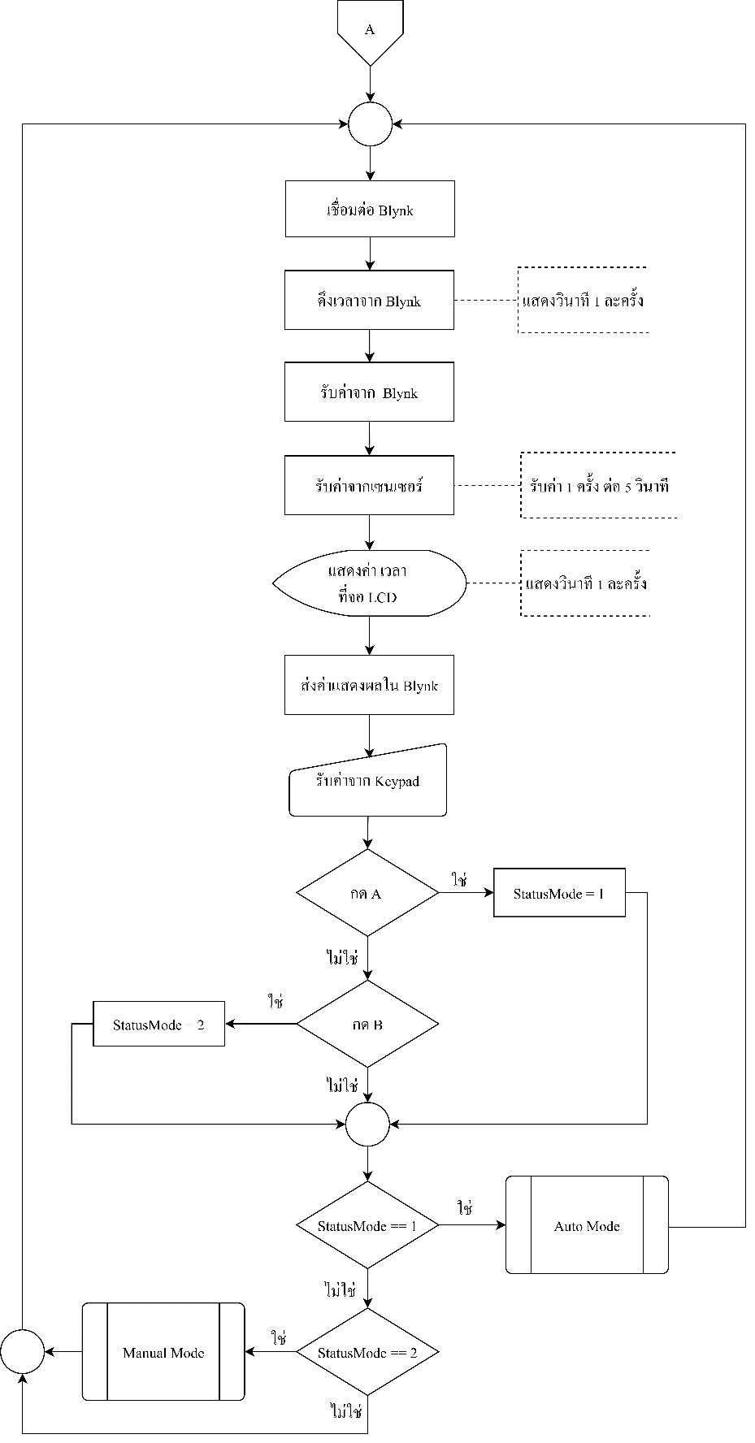
[picture p88: figure]

รูปที่3.2(ต่อ)ผงังำนข้นั ตอนกำรทำ งำนของระบบโดยรวมที่บอร์ด ATmega2560 (ต่อ) จำกรูปที่ 3.2ผงังำนข้นั ตอนกำรทำ งำนของระบบโดย เริ่มตน้ ระบบกำรเชื่อมต่ออินเตอร์เน็ตและ Server Blynk หำกอินเตอร์เน็ตมีปัญหำระบบจะท ำกำรเชื่อมต่อไปเรื่อย ๆ จนกว่ำระบบจะเชื่อมอินเตอร์เน็ต ได้ เมื่อมีกำรเชื่อมต่ออินเตอร์เน็ตระบบจะแสดงหน้ำ Menu โหมดทำง LCD และจะอ่ำนค่ำคงที่จำก

EEPROM ว่ำมีกำรทำ งำนคำ้งอยู่หรือไม่ถำ้ระบบทำ งำนคำ้งอยู่จะเริ่มทำ งำนจำกโหมดที่คำ้งอยู่หำกไม่มี กำรท ำงำนค้ำงอยู่ระบบจะรอรับค่ำจำก Keypad เพื่อเข้ำสู่เมนูกำรท ำงำนต่ำง ๆ คือ
1. กด A เพื่อเข้ำโหมด Auto
2. กด B เพื่อเข้ำโหมด Manual

### 2. ผังงำนกำรท ำงำนของโหมดอัตโนมัติที่บอร์ด ATmega2560 (Auto Mode)

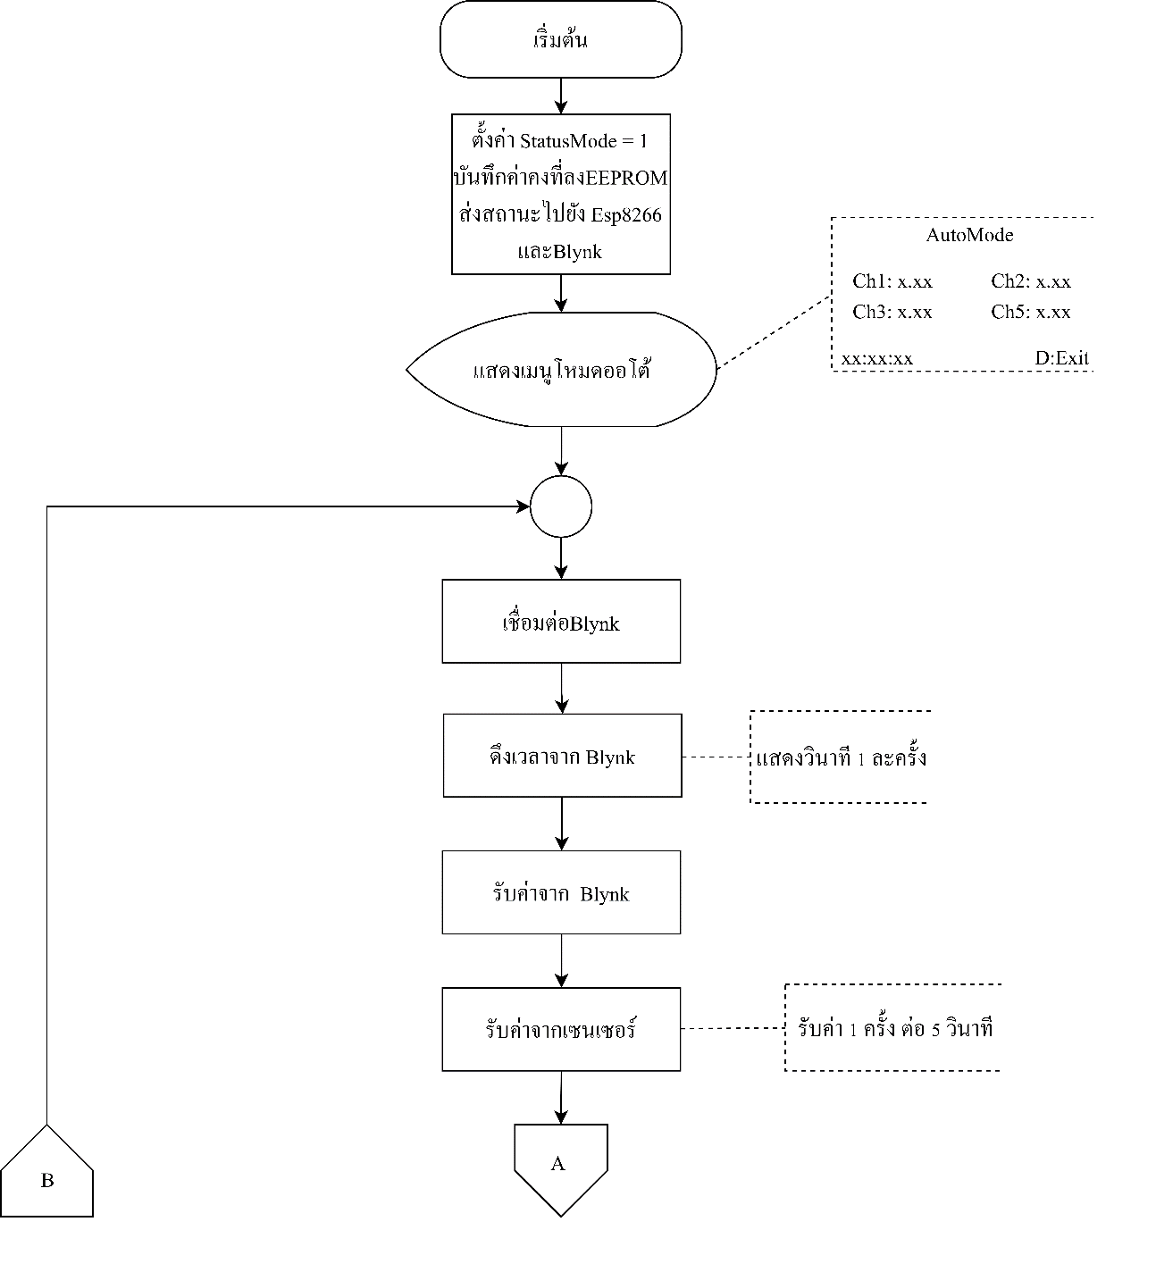
[picture p89: figure]

รูปที่3.3ผังงำนกำรท ำงำนของโหมดอัตโนมัติที่บอร์ด ATmega2560 (Auto Mode)

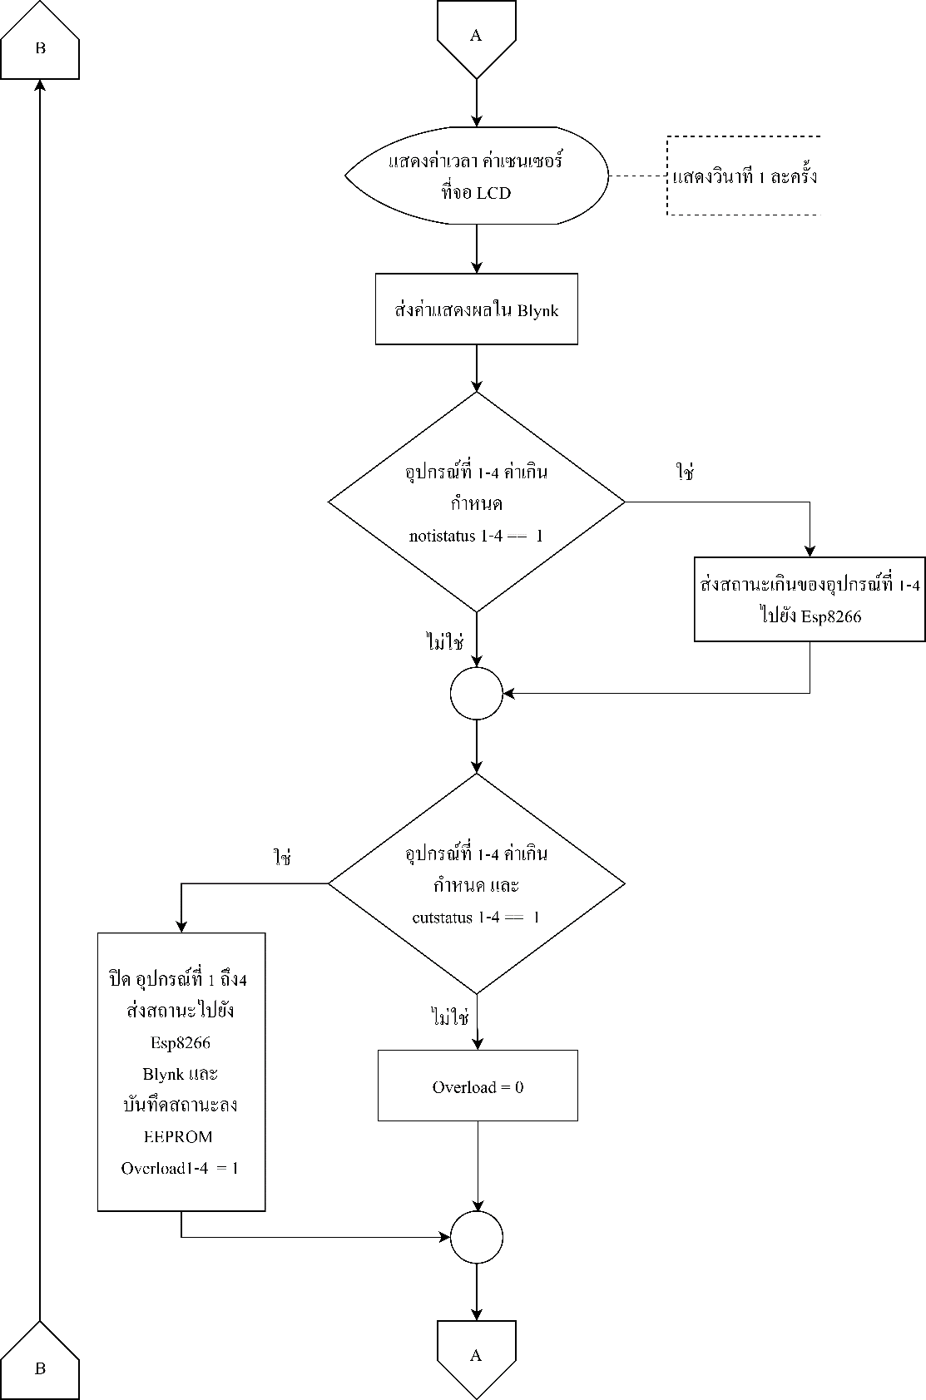
[picture p90: figure]

รูปที่3.3(ต่อ)ผังงำนกำรท ำงำนของโหมดอัตโนมัติที่บอร์ด ATmega2560 (Auto Mode)

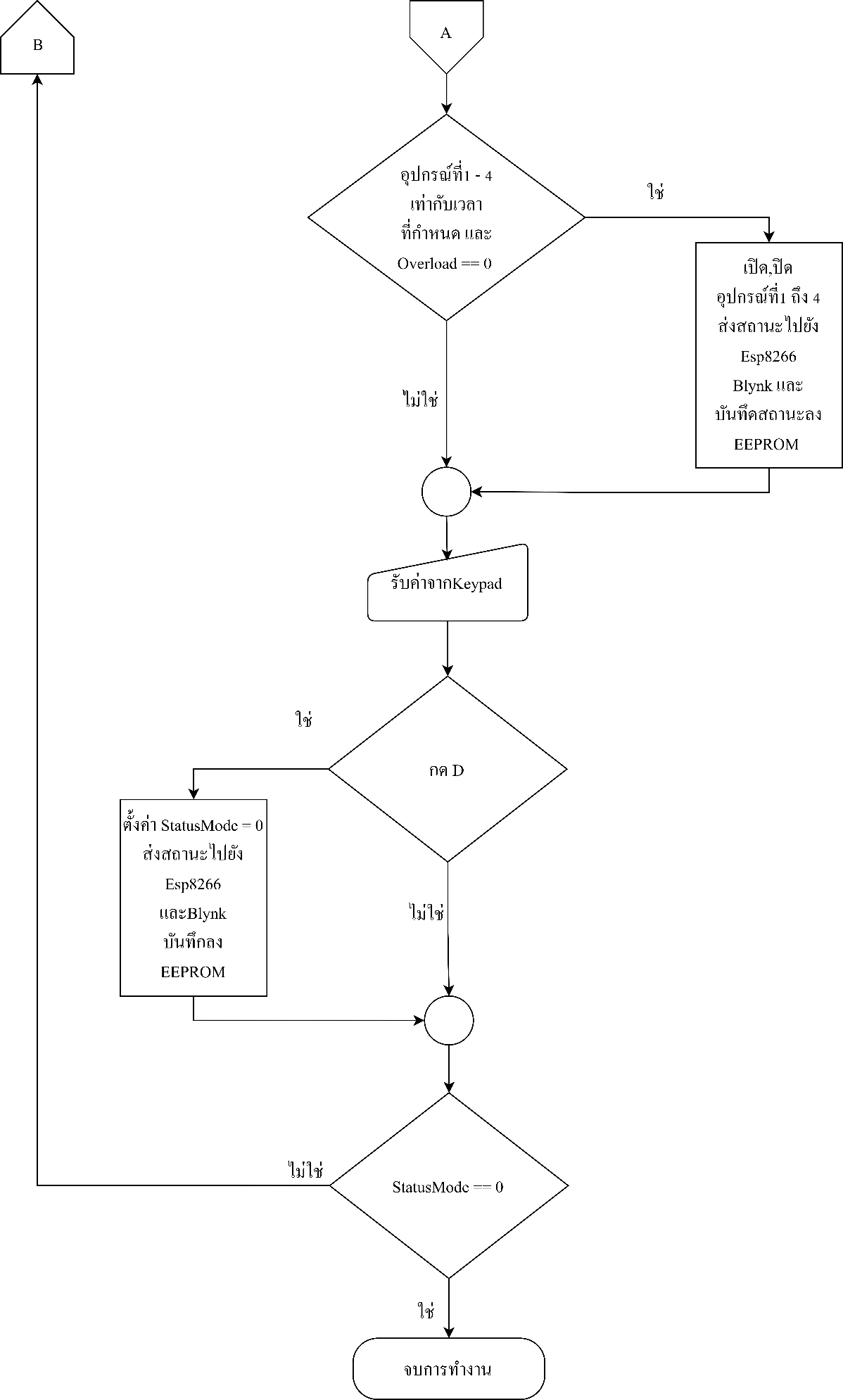
[picture p91: figure]

รูปที่3.3(ต่อ)ผังงำนกำรท ำงำนของโหมดอัตโนมัติที่บอร์ด ATmega2560 (Auto Mode) จำกรูปที่ 3.3ผงัข้นั ตอนกำรทำ งำนของโหมดอตัโนมตัิจะแสดงผลค่ำปริมำณกำรใชไ้ฟฟ้ำ ผ่ำนทำง จอ LCD โดยระบบจะท ำงำนตำมเงื่อนไขที่ก ำหนดไว้ในแอปพลิเคชัน Blynk ระบบก็จะเริ่มทำ กำรปิดแบบ

อัตโนมัติ หำกปริมำณกำรใช้ไฟฟ้ำเกินค่ำที่ก ำหนด แล้วส่งค่ำไปยัง Blynk และแสดงสถำนะหน้ำตู้ หำกผู้ใช้ ท ำกำร เปลี่ยนโหมดจำกแอปพลิเคชัน Blynk หรือผ่ำน keypad โดยกำรกด D จะเป็นกำรสิ้นสุดกำรทำ งำน ในโหมดอัตโนมัติ

### 3. ผังงำนกำรท ำงำนของโหมดก ำหนดเองที่บอร์ด ATmega2560 (Manual Mode)

ผงังำนข้นั ตอนกำรทำ งำนของโปรแกรมโหมดควบคุมดว้ยตนเอง เป็นส่วนของโปรแกรมส ำหรับ กำรท ำงำนที่ผู้ใช้ เปิ ด-ปิ ด อุปกรณ์ต่ำง ๆ ด้วยตนเอง จำกกำรกดปุ่ มที่ Keypad หรือสั่งงำนจำก Application Blynk ซึ่งกำรท ำงำนของโปรแกรม แสดงได้ดังรูปที่ 3.6

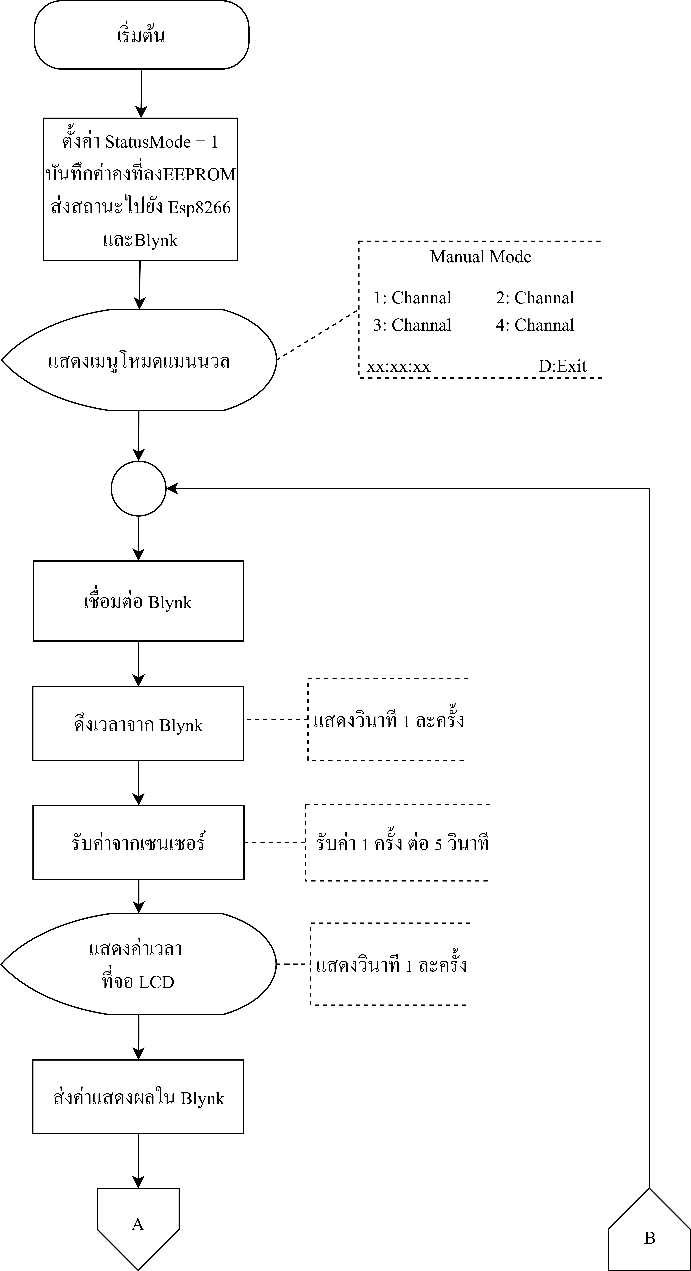
[picture p92: figure]

รูปที่3.4ผังงำนกำรท ำงำนของโหมดก ำหนดเองที่บอร์ด ATmega2560 (Manual Mode)

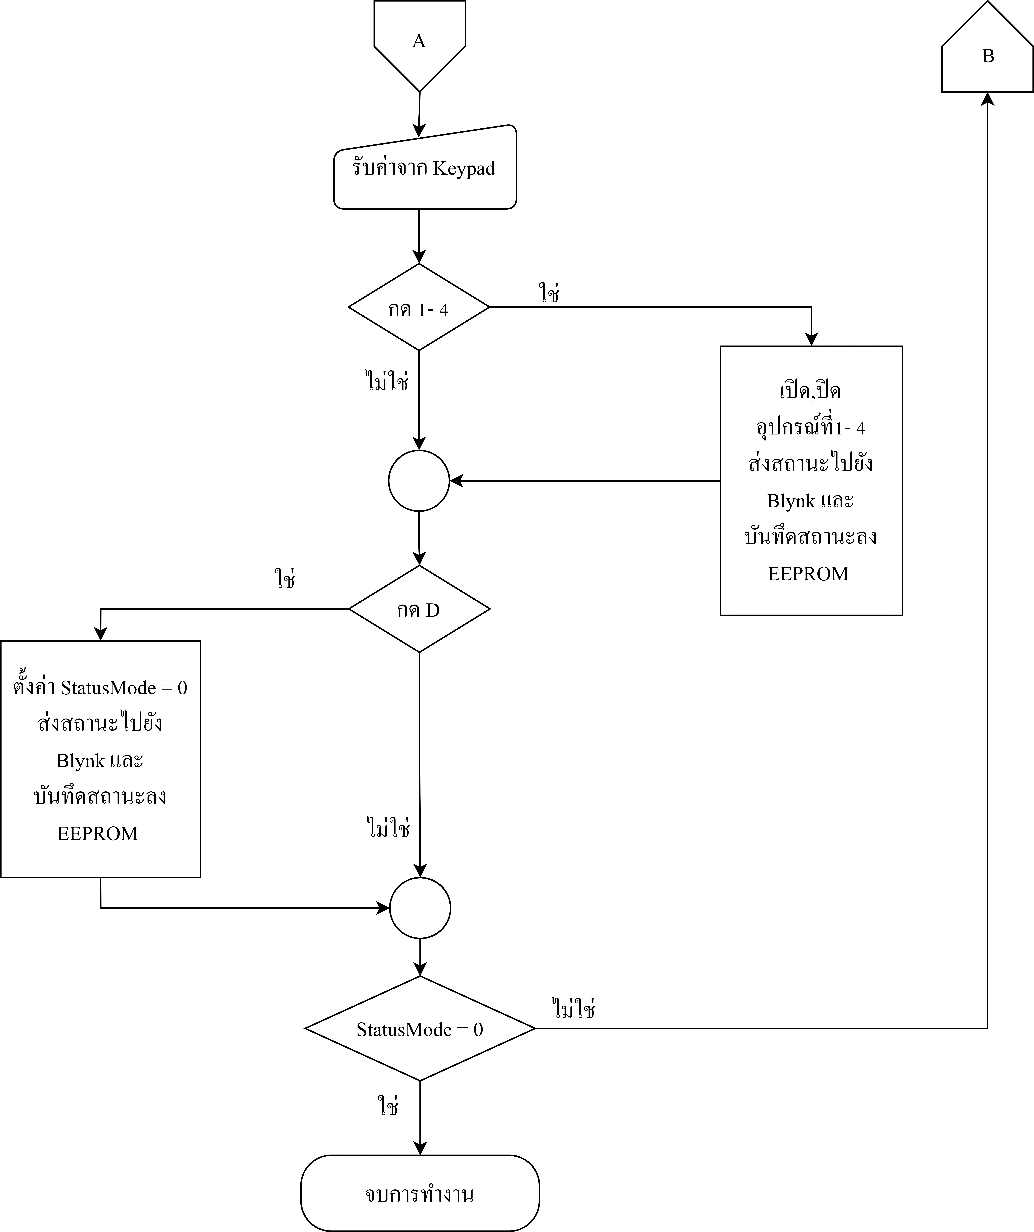
[picture p93: figure]

รูปที่3.4(ต่อ)ผังงำนกำรท ำงำนของโหมดก ำหนดเองที่บอร์ด ATmega2560 (Manual Mode) จำกรูปที่ 3.4ผงัข้นั ตอนกำรทำ งำนของโหมดกำ หนดเอง โดยระบบจะทำ งำนจำกกำรที่ผใู้ชเ้ป็นคนสั่ง เปิ ดหรือปิ ดผ่ำนทำง Keypad หรือ Blynk เมื่อผู้ใช้กดปุ่ มระบบก็จะส่งสัญญำณให้อุปกรณ์ท ำงำน และส่งค่ำ กำรเปิ ดปิ ดเพื่อแสดงสถำนะอุปกรณ์ใน Application Blynk แลว้ทำ กำร เปิด/ปิดอุปกรณ์ท้งัหมดตำมที่ผู้ใช้ ต้องกำร

### 4. ผังงำนกำรท ำงำนที่บอร์ด NodeMCU Esp8266

ผังงำนกำรท ำงำนผ่ำน NodeMCU จะมีกำรท ำงำนโดยกำรรับค่ำจำกบอร์ด ATmega2560 ส่งให้แก่ NodeMCU เพื่อน ำค่ำที่ได้ส่งไปยัง Application Line แสดงข้อควำมกำรท ำงำนแต่ละอุปกรณ์ไปยังผู้ใช้ แสดงได้ดังรูปที่3.5

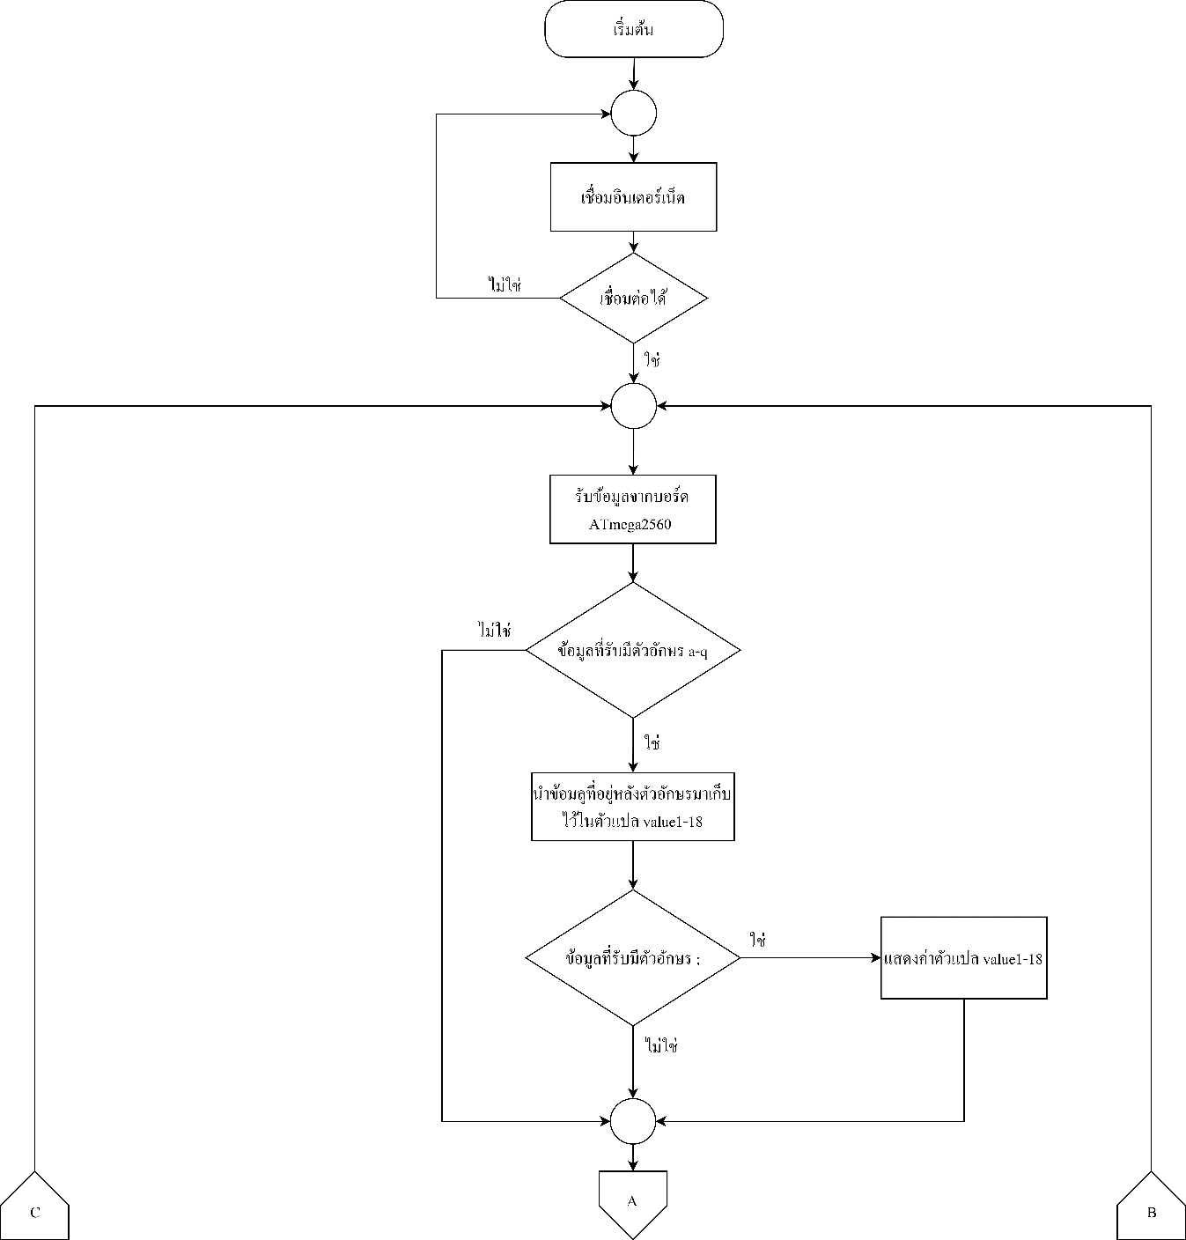
[picture p94: figure]

รูปที่3.5ผังงำนกำรท ำงำนที่บอร์ด NodeMCU Esp8266

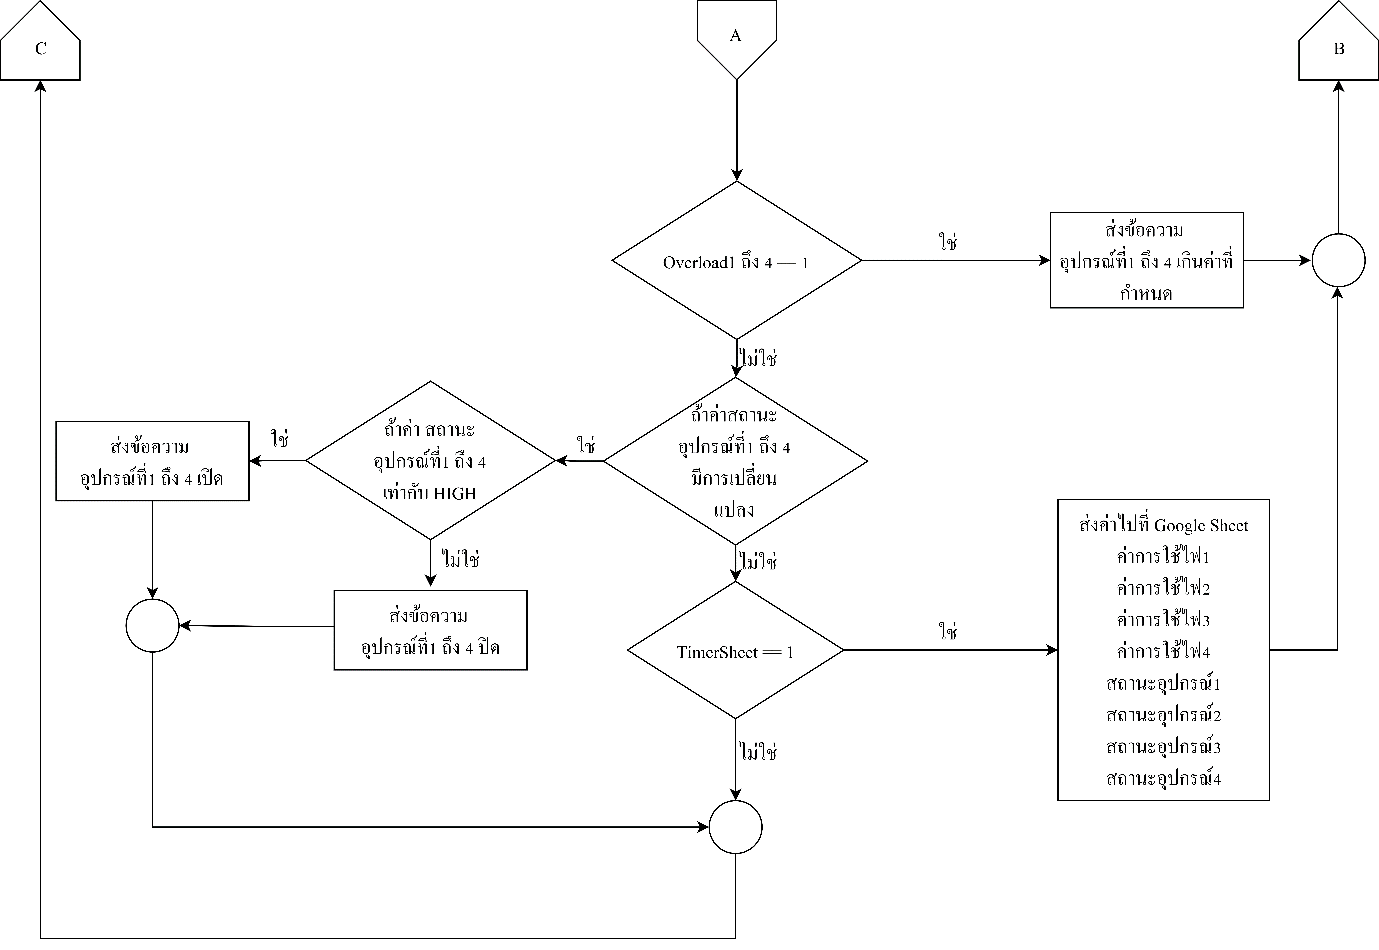
[picture p95: figure]

รูปที่3.5(ต่อ)ผังงำนกำรท ำงำนที่บอร์ด NodeMCU Esp8266 จำกรูปที่ 3.5 แสดงข้นั ตอนกำรทำ งำนของระบบกำรทำ งำนของบอร์ด Esp 8266 เริ่มจำกเชื่อมต่อ Wifi เมื่อเชื่อมต่อได้ก็จะท ำกำรรับค่ำข้อมูลจำกบอร์ด ATmega2560 นำ ขอ้ มูลน้นั มำใชง้ำนแลว้นำ มำทำ กำร ตรวจสอบหำกขอ้มูลตรงตำมเง้ือนไขจะดำ เดินกำรงำนที่ระบุไว้

บทที่ 4
ผลกำรด ำเนินงำน

บทน้ีจะเป็นกำรกล่ำวถึงกำรพฒั นำระบบงำนเพื่อสร้ำงระบบให้สำมำรถทำ งำนไดต้ ำมขอบเขตที่ ผูว้ิจัยได้กำ หนดไว้ส ำหรับงำนวิจัยที่ผูว้ิจัยด ำเนินกำรน้ีจะต้องทำ กำรออกแบบใน 2 ส่วน ด้วยกันคือ กำรออกแบบระบบด้ำนฮำร์ดแวร์ และระบบดำ้นซอฟตแ์วร์โดยมีรำยละเอียดดงัต่อไปน้ี

### 4.1 กำรออกแบบระบบด้ำนฮำร์ดแวร์

จำกกำรวิเครำะห์ระบบตำมขอบเขตที่ผู้วิจัยได้ก ำหนดไว้ ผู้วิจัยได้ท ำกำรออกแบบระบบด้ำน ฮำร์ดแวร์โดยใช้บอร์ด Atmega 2560 เป็นตวัประมวลผลกลำงโดยมีอินพุดที่นำ มำเชื่อต่อไดแ้ก่ โมดูลวดั ปริมำณกำรใช้ไฟฟ้ำ จะส่งค่ำปริมำณกำรใช้ไฟฟ้ำไปยังบอร์ด Atmega2560 เพื่อประมวณผลว่ำมีกำรใช้งำน เกินเกณฑ์หรือไม่ และ Keypad 4x4 สำ หรับรับคำ สั่งจำกผใู้ชง้ำนระบบ และส่วนในดำ้นของอุปกรณ์เอำตพ์ ุต ไดแ้ก่Relay 4 Channel จอแสดงผลภำพ LCD ดังรูป 4.1

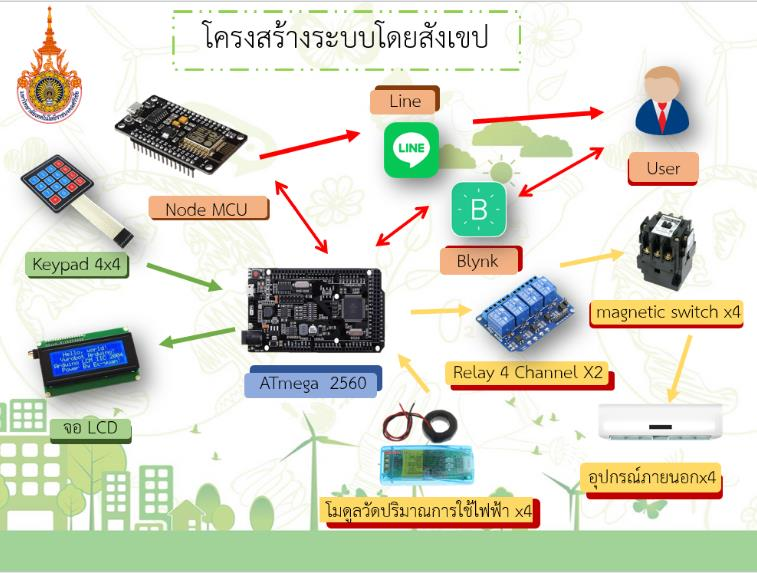
[picture p96: figure]

รูปที่4.1 โครงสร้ำงระบบด้ำนฮำร์ดแวร์ จำกรูปที่ 4.1 ทำงผู้วิจัยได้ออกแบบกำรเชื่อมต่ออุปกรณ์ต่ำง ๆ ทำงด้ำนฮำร์ดแวร์ระบบ โดยบอร์ด จะสำมำรถรับค่ำจำกโมดูลวัดปริมำณกำรใช้ไฟฟ้ำ และจำก Keypad 4x4 โดยอ่ำนค่ำจำกบอร์ด Atmega2560 ค ำนวณปริมำณกำรใช้เป็ น Unit ต่อชั่วโมง เพื่อเป็นกำรกำ หนดเกณฑ์กำรท ำงำนของอุปกรณ์ และผู้ใช้

สำมำรถก ำหนดเวลำเปิ ดปิ ดกำรใช้งำนอุปกณณ์ไฟฟ้ำตำมเวลำที่ผู้ใช้ก ำหนด ผ่ำน Application Blynk โดยมี กำรเชื่อมต่อกับอินเทอร์เน็ต และมีกำรแจ้งเตือนสถำนะของอุปกรณ์ต่ำง ๆ ทำงไลน์ และ Google Sheet ทุก ๆ ชวั่ โมง

### 4.2 กำรออกแบบระบบด้ำนซอฟต์แวร์

ข้นั ตอนของกำรออกแบบระบบทำงดำ้นซอฟตแ์วร์ผูว้ิจยัไดอ้อกแบบให้มีกำรทำ งำนใน 2 รูปแบบ คือ แบบท ำอัตโนมัติ และแบบผู้ใช้ก ำหนดเอง กำรออกแบบทำงด้ำนซอฟต์แวร์ผู้วิจัยได้ท ำกำรออกแบบตัว โปรแกรมและหนำ้จอแสดงผลโดยมีรำยละเอียดดงัน้ี
4.2.1 หน้ำจอแสดงข้อมูล Monitor ผ่ำน Application Blynk
เป็ นกำรแสดงหน้ำจอควบคุมกำรใช้งำนไฟฟ้ำ ผ่ำน Application Blynk ซ่ึงหนำ้น้ีจะแสดง โหมดกำรใช้งำน กำรควบคุม สถำนะของอุปกรณ์ แสดงได้ดังรูปที่ 4.2

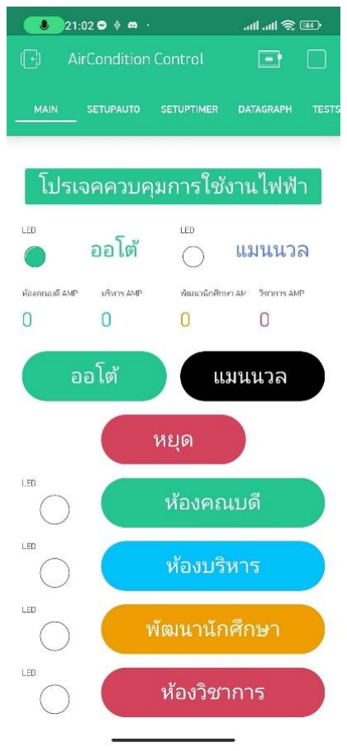
[picture p97: figure]

รูปที่4.2แสดงหน้ำจอ Monitor Application Blynk จำกรูปที่ 4.2 หน้ำจอเลือกกำรท ำงำนของระบบ แบ่งออกเป็ น กำรเลือกกำรท ำงำนแบบอัตโนมัติ แบบกำรท ำงำนด้วยกำรก ำหนดเวลำ และควบคุมกำรเปิ ด/ปิ ดอุปกรณ์ไฟฟ้ำ แสดงค่ำสถำนะกำรท ำงำนและมี กำรแสดงโค้ดโปรแกรมดังรูป

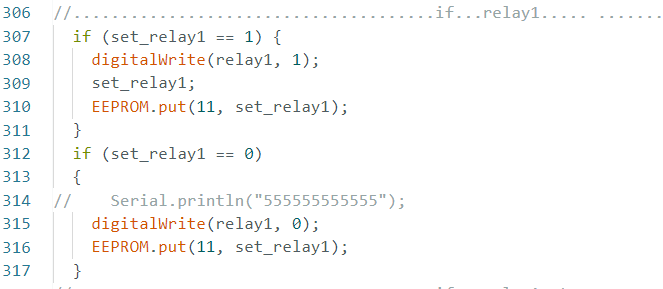
[picture p98: figure]

รูปที่4.3 โค้ดควบคุม เปิ ด/ปิ ด อุปกรณ์ไฟฟ้ำแบบก ำหนดเอง จำกโค้ดตัวอย่ำงรูปที่ 4.3 แสดงวิธีกำรท ำงำนของปุ่ มควบคุมกำรเปิ ด/ปิ ดของอุปกรณ์ จำกหน้ำ Monitor โดยผใู้ชส้ ำมำรถกด 1คร้ังเพื่อเปิด กำรทำ งำน และกดอีก1คร้ัง เพื่อ ปิดกำรทำ งำนของอุปกรณ์

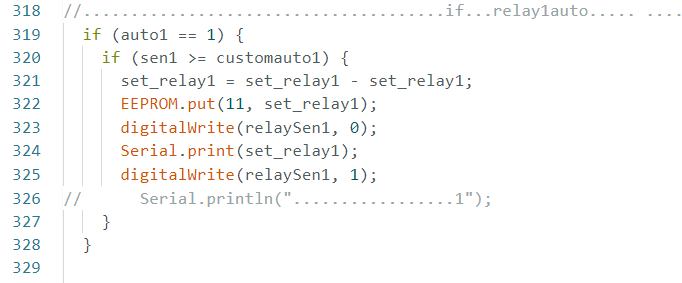
[picture p99: figure]

รูปที่4.4 โค้ดโปรแกรมหน้ำจอกำรท ำงำนอัตโนมัติ จำกโค้ดตัวอย่ำงรูปที่ 4.4 แสดงวิธีกำรท ำงำนของปุ่ ม Auto จำกหน้ำ Monitor ผู้ใช้สำมำรถกดเปิ ด Auto หลงัจำกต้งัค่ำกำรทำ งำนของปุ่มแลว้จำกกำรต้งัค่ำกำรทำ งำนผำ่ นหนำ้ SETUPAUTO

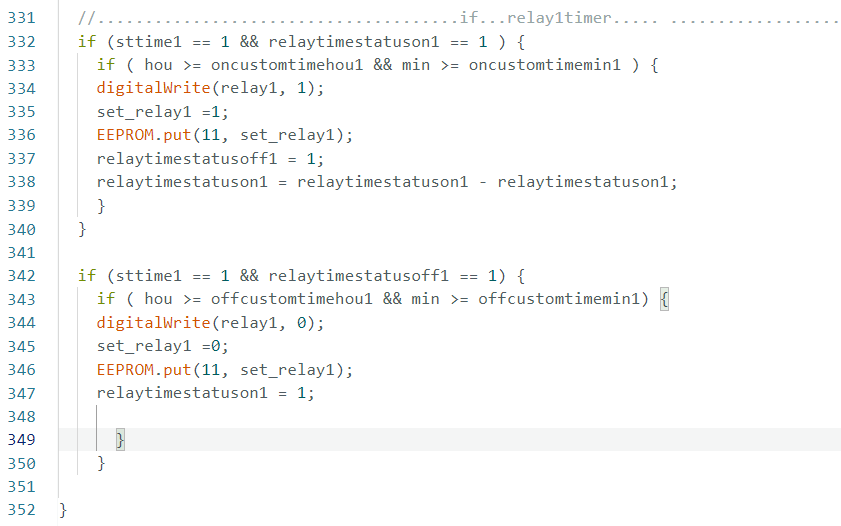
[picture p100: figure]

รูปที่4.5 โค้ดโปรแกรมหน้ำจอกำรท ำงำนแบบก ำหนดเวลำ จำกโค้ดตัวอย่ำงรูปที่ 4.5 แสดงวิธีกำรท ำงำนของปุ่ ม Timer จำกหน้ำ Monitor ผู้ใช้สำมำรถกดเปิ ด กำรท ำงำนของปุ่มหลังจำก ต้ังค่ำกำรท ำงำนของปุ่ม Timer จำกกำรต้ังค่ำกำรท ำงำนผ่ำนหน้ำจอ SETUPTIMER

4.2.2 หนำ้จอแสดงกำรต้งัค่ำกำรท ำงำนอัตโนมัติ
โหมดอัตโนมัติจะท ำงำนตำมเงือนไขของกำรต้ังค่ำ UNIT ของหน่วยที่ผู้ใช้ต้องกำร แสดงได้ดังรูปที่ 4.6

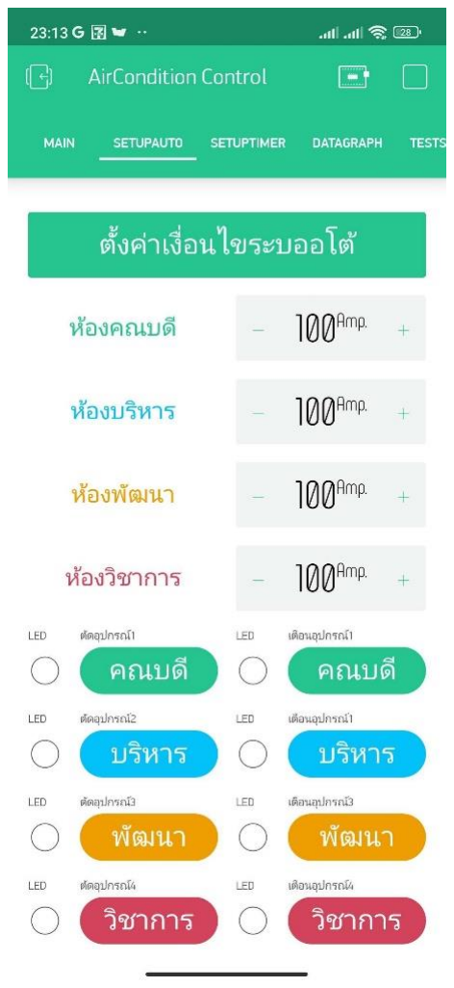
[picture p101: figure]

รูปที่4.6 หนำ้จอแสดงกำรต้งัค่ำกำรทำ งำนอตัโนมตัิ จำกรูปที่ 4.6จะข้ึนอยู่กบักำรกำ หนดเงือนไขกำรต้งัค่ำของผูใ้ชง้ำนที่จะกำ หนด UNIT ของอุปกรณ์ ไฟฟ้ำ โดยสำมำรถแสดงโค้ด ได้ดังรูปที่ 4.7

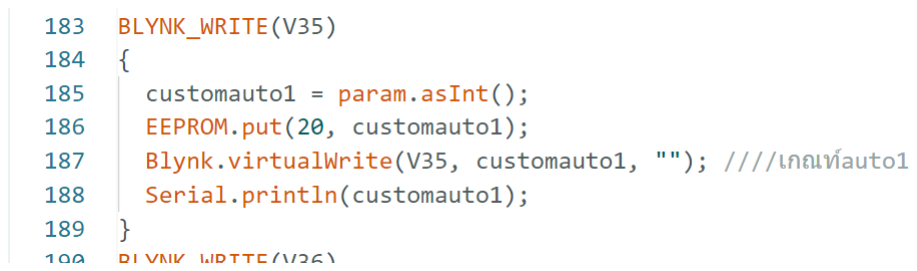
[picture p102: figure]

รูปที่4.7 โคด้โปรแกรมหนำ้จอกำรต้งัค่ำกำรทำ งำนแบบอตัโนมตัิ จำกรูปที่ 4.7 หนำ้กำรต้งัค่ำระบบอตัโนมตัิระบบสำมำรถต้งัค่ำควำมตอ้งกำรของผูใช้เพื่อที่จะหยุด ้ กำรท ำงำนของอุปกรณ์ตำมเงือนไขที่ผู้ใช้ก ำหนด

4.2.3 หนำ้จอแสดงกำรต้งัค่ำแบบกำ หนดเวลำ
โหมดกำรต้งัค่ำแบบกำ หนดเวลำทำ งำนตำมเวลำที่ผูใ้ชก้ำ หนด เริ่มจำกกำรที่ผูใ้ชใ้ส่เวลำที่ ตอ้งกำรปิดลงในช่องดำ้นล่ำงและใส่เวลำที่เริ่มเปิด ในช่องดำ้นบน ตำมรูปภำพที่ 4.8

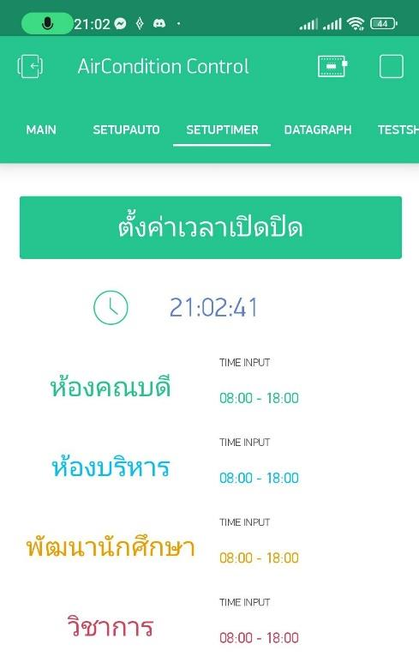
[picture p103: figure]

รูปที่4.8 หนำ้จอแสดงกำรต้งัค่ำแบบกำ หนดเวลำ จำกรูปที่4.8 จะแสดงค่ำกำรทำ งำนตำมที่ผูใ้ช้กำ หนด โดย เวลำช่องดำ้นบน จะเป็นกำรต้งัค่ำให้ อุปกรณ์น้นั เปิดทำ งำนในช่วงเวลำ 05.05 น. และจำ ทำ กำรปิดในช่วงเวลำ 09.30 น. แสดงโค้ดตัวอย่ำงกำร ท ำงำนตำมรูปที่ 4.9

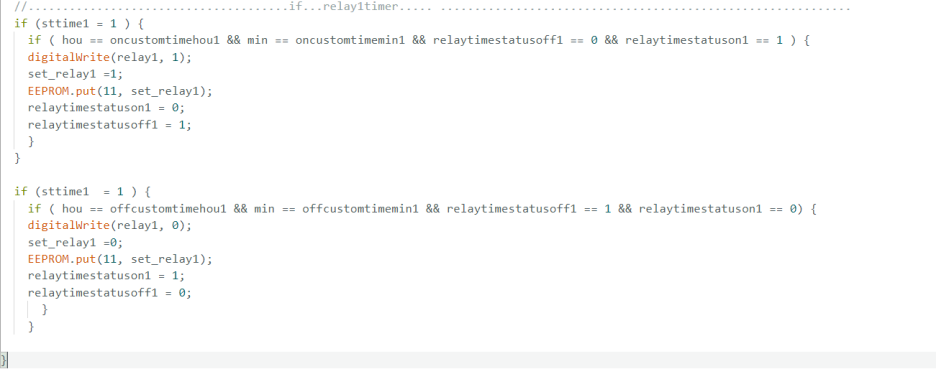
[picture p104: figure]

รูปที่4.9 โค้ดโปรแกรมหน้ำจอกำรท ำงำนแบบก ำหนดเวลำ จำกโคด้ ตวัอยำ่ งรูปที่4.9จำ กำ หนดใหเ้มื่อโปรแกรมต้งัค่ำเวลำในกำรเปิด/ปิดแลว้ จะทำ ใหต้วัคำ สั่ง จะเข้ำสู่เงือนไขกำรท ำงำนของผู้ใช้งำน

4.2.4 หน้ำจอแสดงกำรใช้งำนของอุปกรณ์ในรูปแบบของกรำฟ
แสดงค่ำกำรทำ งำนของอุปกรณ์ท้งัหมดในรูปแบบกรำฟ สำมำรถปรับกำรตรวจสอบตำม ระยะเวลำที่ผู้ใช้ต้องกำรดูได้ ตำมรูปภำพที่ 4.10

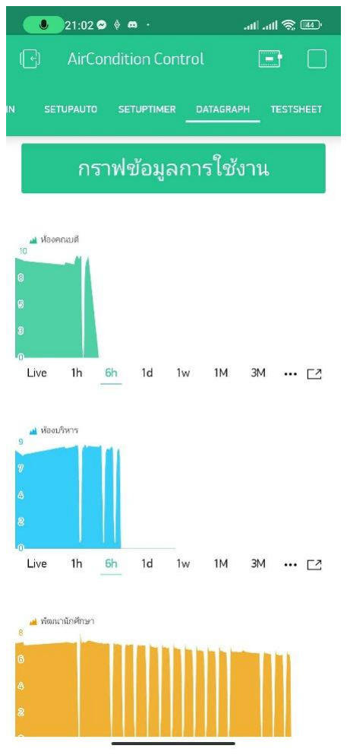
[picture p105: figure]

รูปที่4.10 หน้ำจอแสดงกรำฟข้อมูลกำรใช้งำน จำกรูปที่4.10จะแสดงกำรใชง้ำนของอุปกรณ์ท้งัหมดตำมที่ผู้ใช้ต้องกำรตำมช่วงเวลำที่ผู้ใช้ก ำหนด

4.2.5 หน้ำจอบันทึกข้อมูลกำรใช้งำนลง Google Sheet เมนูกำรบันทึกข้อมูลลงใน Google Sheet ตำมรูปที่ 4.11

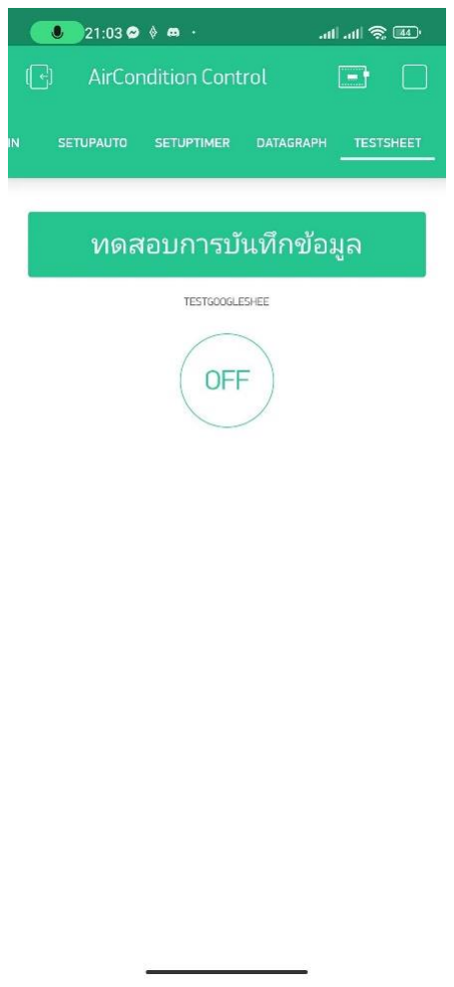
[picture p106: figure]

รูปที่4.11 กำรบันทึกข้อมูล จำกรูปที่ 4.11 แสดงปุ่ มทดสอบกำรบันทึกข้อมูลลง Google Sheet

### 4.3 กำรประเมินควำมพงึพอใจของผู้ใช้ระบบ

กำรประเมินควำมพึงพอใจของผู้ใช้ระบบ ผู้วิจัยได้ใช้แบบสอบถำมโดยมีค ำถำมใน 3 ประเด็นหลัก ๆ ดังน้ี1. ด้ำนประสิทธิภำพของกำรท ำงำนระบบ 2. ด้ำนกำรท ำงำนตำมฟังก์ชันของระบบและด้ำนกำร น ำไปใช้ประโยชน์
มีผู้ตอบแบบสอบถำมจ ำนวน 15 คน แบ่งออกเป็ น 3 ส่วน คือ
ส่วนที่ 1 นักศึก 9 คน
ส่วนที่ 2 ครู/อำจำรย์ 4 คน
ส่วนที่3 บุคคลทวั่ ไป 2คน

มีลักษณะค ำตอบเป็ นมำตรำส่วนประมำณค่ำ 5อนั ดบั ดงัน้ี
4.50 – 5.00 หมำยถึง ระดับกำรประเมินอยู่ในระดับ มำกที่สุด 3.50 – 4.49 หมำยถึง ระดับกำรประเมินอยู่ในระดับ มำก 2.50 – 3.49 หมำยถึง ระดับกำรประเมินอยู่ในระดับ ปำนกลำง 1.50 – 2.49 หมำยถึง ระดับกำรประเมินอยู่ในระดับ น้อย 1.00 – 1.49 หมำยถึง ระดับกำรประเมินอยู่ในระดับ น้อยที่สุด เกณฑ์กำรประเมินจะพิจำรณำคะแนนเฉลี่ยของควำมพึงพอใจต่อกำรใช้งำนระบบ เป็นตวั ช้ีวดั ประสิทธิภำพของระบบ ซึ่งกำรวิเครำะห์ข้อมูลใช้สถิติเชิงพรรณนำ (Descriptive Statistics) ในกำรวัดค่ำของ ข้อมูลโดยใช้ค่ำเฉลี่ยเลขคณิตหรื อค่ำเฉลี่ย (Mean) และวัดกำรกระจำยของข้อมูลโดยใช้ค่ำเบี่ยงเบน มำตรฐำน(Standard Deviation) โดยกำรค ำนวณหำค่ำเฉลี่ยเลขคณิตหรือค่ำเฉลี่ย (Mean) ใช้สูตร
- ค่ำเฉลี่ย (Arithmetic Mean) ของคะแนน โดยใช้สูตร
สูตร | x̅= ∑ x
| n
เมื่อ x̅ | แทน ค่ำเฉลี่ย
∑ x แทน ผลรวมของคะแนนท้งัหมดในกลุ่ม
n แทน จ ำนวนคนในกลุ่ม
- ส่วนเบี่ยงเบนมำตรฐำน (Standard Deviation) โดยใช้สูตร
สูตร | S.D. = √ n ∑ x 2 − (∑ x)
2
| n(n−1)

เมื่อ S.D. แทน ส่วนเบี่ยงเบนมำตรฐำน
x
2 | แทน คะแนนแต่ละตัว
n | แทน คะแนนในกลุ่ม
Σ | แทน ผลรวม

ตำรำงที่4.1ผลกำรวิเครำะห์แบบสอบถำมควำมพึงพอใจด้ำนประสิทธิภำพของกำรท ำงำนระบบ

รำยกำรประเมิน | x̅ | S.D. | ระดับควำม พึงพอใจ
1. ควำมสำมำรถในกำรท ำงำนแบบอัตโนมัติของระบบ | 4.87 | 0.35 | ดีมำก
2. ควำมสำมำรถในกำรท ำงำนที่ควบคุมด้วยตนเอง | 4.80 | 0.41 | ดีมำก
3. ควำมสำมำรถในกำรท ำงำนที่ควบคุมตำมเวลำที่ก ำหนด | 4.87 | 0.35 | ดีมำก
4. ควำมสำมำรถในกำรท ำงำนของระบบโดยรวม | 4.87 | 0.35 | ดีมำก
5. ควำมสำมำรถในกำรสลับกำรใช้งำนระบบ | 4.73 | 0.46 | ดีมำก
6. ควำมสำมำรถในกำรส่งข้อควำมผ่ำนไลน์ไปยังผู้ใช้ระบบ | 4.87 | 0.35 | ดีมำก
รวม | 4.84 | 0.05 | ดีมำก

จำกตำรำงที่ 4.1 พบว่ำ ผลกำรประเมินคุณภำพควำมพึงพอใจด้ำนประสิทธิภำพของกำรท ำงำน ระบบ พบว่ำอยู่ในเกณฑ์ดีมำก ((x̅)= 4.84,S.D. = 0.05) เมื่อพิจำรณำ เป็ นรำยข้อ ด้ำนประสิทธิภำพของกำร ท ำงำนระบบพบว่ำในข้อที่ 1, 3, 4, 6.ควำมสำมำรถในกำรท ำงำนแบบอัตโนมัติของระบบ, ควำมสำมำรถใน กำรท ำงำนที่ควบคุมตำมเวลำที่ก ำหนด, ควำมสำมำรถในกำรท ำงำนของระบบโดยรวม และควำมสำมำรถใน กำรส่งข้อควำมผ่ำนไลน์ไปยังผู้ใช้ระบบ ท้ังหมดมีค่ำเฉลี่ยมำกที่สุด อยู่ในเกณฑ์ดีมำก ((x̅)=4.87, S.D. = 0.35) รองลงมำคือข้อที่ 2 ควำมสำมำรถในกำรท ำงำนที่ควบคุมด้วยตนเอง อยู่ในเกณฑ์ดีมำก ((x̅)=4.80, S.D. = 0.41 )และค่ำเฉลี่ยน้อยที่สุดคือข้อที่ 5ควำมสำมำรถในกำรสลับกำรใช้งำนระบบ อยู่ใน เกณฑ์ดีมำก ((x̅)=4.60, S.D. = 0.60 )
ตำรำงที่ 4.2ผลกำรวิเครำะห์แบบสอบถำมควำมพึงพอใจด้ำนกำรท ำงำนตำมฟังก์ชันของระบบ
รำยกำรประเมิน | x̅ | S.D. | ระดับ ควำมพึง พอใจ
1. แอปพลิเคชันมีรูปแบบกำรจัดองค์ประกอบที่ชัดเจน และใช้งำนง่ำย | 4.87 | 0.35 | ดีมำก
2. ภำษำที่ใช้มีควำมชัดเจน ถูกต้อง เหมำะสม ท ำให้ผู้ใช้เข้ำใจได้โดยง่ำย | 5 | 0.00 | ดีมำก
3. แอปพลิเคชันมีสีสันที่ดูเรียบง่ำย สบำยตำ | 4.93 | 0.26 | ดีมำก
4. แอปพลิเคชันมีกำรชัดชุดข้อมูลอย่ำงเป็ นระเบียบ | 4.67 | 0.49 | ดีมำก
5. รูปแบบหนำ้จอกำรแบ่งหนำ้ มีควำมสอดคลอ้งกนั ท้งัหนำ้จอ ท ำให้ง่ำยต่อกำรใช้งำน | 4.93 | 0.26 | ดีมำก
รวม | 4.88 | 0.18 | ดีมำก

จำกตำรำงที่ 4.2 พบว่ำ ผลกำรประเมินคุณภำพควำมพึงพอใจด้ำนกำรท ำงำนตำมฟังก์ชันของระบบ พบว่ำอยู่ในเกณฑ์ดีมำก ((x̅) = 4.88, S.D. = 0.18) เมื่อพิจำรณำ เป็ นรำยข้อ ด้ำนกำรออกแบบ พบว่ำในข้อที่ 2 ภำษำที่ใช้มีควำมชัดเจน ถูกต้อง เหมำะสม ท ำให้ผู้ใช้เข้ำใจได้โดยง่ำย มีค่ำเฉลี่ยมำกที่สุด อยู่ในเกณฑ์ดี มำก ((x̅) =5, S.D. = 0.00) รองลงมำคือข้อที่ 3แอปพลิเคชันมีสีสันที่ดูเรียบง่ำย สบำยตำ อยู่ในเกณฑ์ดีมำก ((x̅) =4.93, S.D. = 0.26 ) รองลงมำคือข้อที่ 5 รูปแบบหนำ้จอกำรแบ่งหนำ้ มีควำมสอดคลอ้งกนั ท้งหน้ำจอ ั ท ำให้ง่ำยต่อกำรใช้งำน อยู่ในเกณฑ์ดีมำก ((x̅) = 4.93, S.D. = 0.26 ) รองลงมำคือข้อที่ 1 แอปพลิเคชันมี รูปแบบกำรจัดองค์ประกอบที่ชัดเจน และใช้งำนง่ำยอยู่ในเกณฑ์ดีมำก ((x̅)=4.87, S.D. = 0.35)และค่ำเฉลี่ย น้อยที่สุดคือข้อที่ 4 แอปพลิเคชันมีกำรจัดชุดข้อมูลอย่ำงเป็ นระเบียบ อยู่ในเกณฑ์ดีมำก ((x̅)= 4.67, S.D. = 0.49)
ตำรำงที่ 4.3ผลกำรวิเครำะห์แบบสอบถำมควำมพึงพอใจด้ำนกำรน ำไปใช้ประโยชน์
รำยกำรประเมิน | x̅ | S.D | ระดับควำมพึงพอใจ
1. ระบบมีประโยชน์ต่อกำรใช้งำนทำงด้ำนไฟฟ้ำ | 4.93 | 0.26 | ดีมำก
2. ระบบมีประโยชน์ต่อกำรควบคุมไฟฟ้ำ | 4.87 | 0.35 | ดีมำก
รวม | 4.90 | 0.06 | ดีมำก
จำกตำรำงที่ 4.3 พบว่ำ ผลกำรประเมินคุณภำพควำมพึงพอใจด้ำนกำรน ำไปใช้ประโยชน์พบว่ำอยู่ ในเกณฑ์ดีมำก ((x̅) = 4.90,S.D. = 0.06) เมื่อพิจำรณำ เป็ นรำยข้อ ด้ำนกำรน ำไปใช้ประโยชน์พบว่ำใน ข้อที่ 1 ระบบมีประโยชน์ต่อกำรใช้งำนทำงด้ำนไฟฟ้ำ มีค่ำเฉลี่ยมำกที่สุด อยู่ในเกณฑ์ดีมำก ((x̅)=4.93, S.D. = 0.26) และค่ำเฉลี่ยน้อยที่สุดคือข้อที่ 2 ระบบมีประโยชน์ต่อกำรควบคุมไฟฟ้ำ อยู่ในเกณฑ์ดีมำก ((x̅)=4.87, S.D. = 0.35)

บทที่ 5
สรุปกำรด ำเนินงำน

บทน้ีจะเป็นกำรกล่ำวถึงสรุปผลจำกกำรทำ วิจยั กำรทดลอง ขอ้ เสนอแนะรวมถึงแนวทำง ในกำร พฒั นำระบบให้มีประสิทธิภำพมำกข้ึน จำกปัญหำและประสบกำรณ์ของผูว้ิจยัที่ไดด้ ำ เนินกำรวิจยัน้ีโดย รำยละเอียดมีดงัต่อไปน้ี

### 5.1 สรุปผล

ระบบอัตโนมัติแบบออนไลน์ส ำหรับควบคุมอุปกรณ์ไฟฟ้ำเพื่อกำรประหยัดพลังงำนกรณีศึกษำ คณะวิทยำศำสตร์และเทคโนโลยี มหำวิทยำลัยเทคโนโลยีรำชมงคลศรีวิชัย โดยระบบสำมำรถควบคุมไฟฟ้ำ ตำมควำมต้องกำรของผู้ใช้เปิ ด-ปิ ดไฟฟ้ำตำมเวลำที่ผู้ใช้ก ำหนด แบบระบบอัตโนมัติ โดยผู้ใช้สำมำรถ ก ำหนดหน่วยไฟฟ้ำ เวลำในกำรเปิ ด-ปิ ด และสำมำรถควบคุมระบบโดยผู้ใช้เอง ตัวระบบจะแจ้งสถำนะกำร ท ำงำนไปยังผู้ใช้ผ่ำนไลน์
ซ่ึงเทคโนโลยีที่นำ มำใชแ้ละพฒั นำเกี่ยวกบั งำนวิจยัน้ีซ่ึงในส่วนของฮำร์ดแวร์จะประกอบไปดว้ย บอร์ด Arduino mega 2560 รีเลย์ 4 ช่องสัญญำณ แมกเนติกคอนแทคเตอร์ Node MCU ESP8266 จอ LCD KeyPad 4x4โมดูลวัดปริมำณกำรใช้ไฟฟ้ำ เทคโนโลยีที่กล่ำวมำท ำให้งำนวิจัยสมบูรณ์ และสำมำรถท ำงำน ไดอ้ยำ่ งมีประสิทธิภำพข้ึน
5.1.1แผนผงักำรติดต้งัระบบ
แผนกำรติดต้งัระบบควบไฟฟ้ำอตัโนมตัิแบบออนไลน์แสดงไดด้งัรูป 5.1

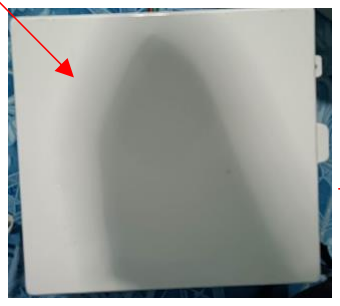
[picture p107: figure]

รูปที่5.1แผนกำรติดต้งัระบบ

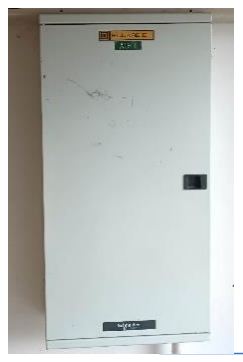
[picture p108: figure]

อุปกรณ์เชื่อมต่อ

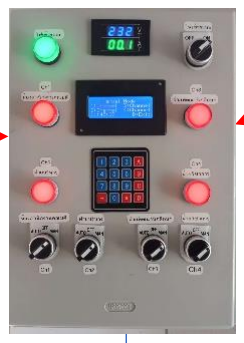
[picture p109: figure]

ควบคุมกำรท ำงำนของ
อุปกรณ์

เซนเซอร์ส่งข้อมูลกลับ
ตู้แมคเนติก

ตู้ควบคุม
ระบบ

จำกรูปที่5.1แสดงแผนผงัพ้ืนที่กำรติดต้งัระบบ จะประกอบไปดว้ย มิเตอร์ไฟฟ้ำ จำ นวน 4 ตวั ตูท้ ี่ ใส่แมกเนติก 4 ตวั ระยะห่ำงจำกตูป้ ระมำณ 1 เมตร และติดต้งัตูค้วบคุมไวด้ำ้นขำ้งสูงจำกพ้ืนประมำณ 2 เมตร
5.1.2 โครงสร้ำงตู้ระบบควบคุม
ในกำรทดลองระบบ ผู้วิจัยได้ท ำกำรสร้ำงตู้ควบคุมระบบ เพื่อให้ง่ำยต่อกำรควบคุม และสะดวกต่อกำรใช้งำนของระบบ โดยมีโครงสร้ำงด้ำนหน้ำตู้ควบคุมระบบ แสดงดังรูปที่ 5.2

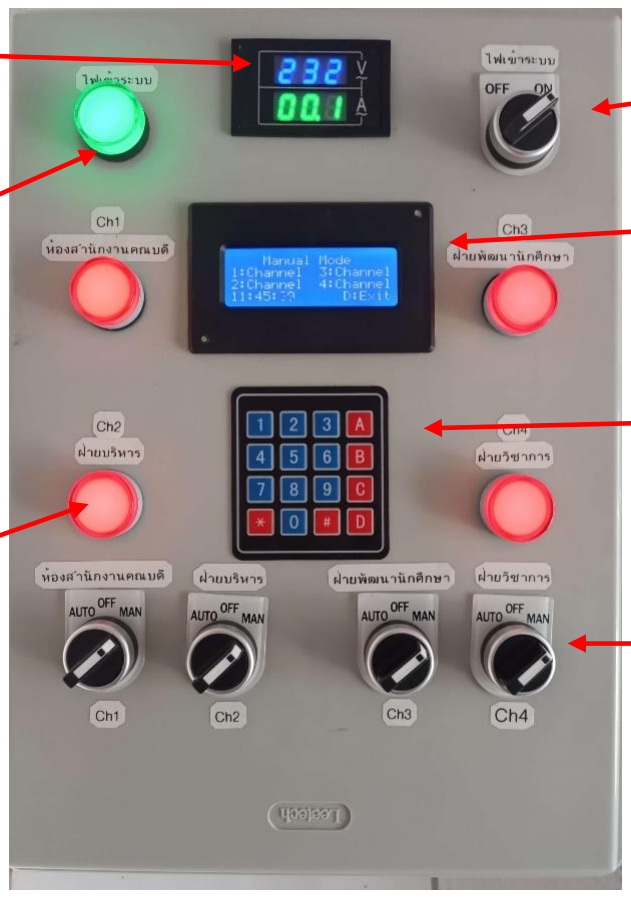
[picture p110: figure]

รูปที่5.2 ด้ำนหน้ำตู้ควบคุมระบบ จำกรูปที่ 5.2 แสดงลักษณะโครงสร้ำงด้ำนหน้ำตู้ควบคุมระบบ จะประกอบไปด้วย LCD แสดงผล แรงดันไฟฟ้ำ หน้ำจอ LCD แสดงผลกำรท ำงำนLED แสดงสถำนะของระบบ LED แสดงกำรณ์ท ำงำนของ แต่ละอุปกรณ์ สวิตช์เปิ ด-ปิ ด ของระบบ สวิตช์ควบคุมฟังก์ชันอุปกรณ์ และ Keypad ควบคุมกำรท ำงำน หน้ำตู้
ตูค้วบคุมระบบมีกำรติดต้งัอุปกรณ์ภำยใน เพื่อให้ระบบสำมำรถทำ งำนไดอ้ยำ่ งถูกตอ้งโดยมีผงักำร เชื่อมสำยสัญญำณ แสดงได้ดังรูปที่ 5.3 และโครงสร้ำงภำยในตู้ควบคุมระบบ แสดงได้ดังรูปที่ 5.4

LCD แสดงแรงดันไฟฟ้ำ

LED แสดงสถำนะระบบ

LED แสดงสถำนะ
กำรท ำงำนของอุปกรณ์

สวิตซ์ เปิ ด-ปิ ด ระบบ

จอแสดงผล LCD

ปุ่ มควบคุม
กำรท ำงำนหน้ำตู้

สวิตซ์ ควบคุม
กำรท ำงำนของอุปกรณ์

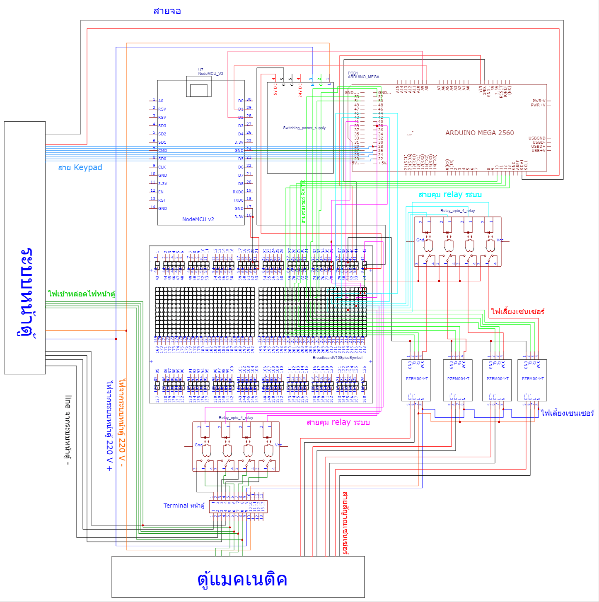
[picture p111: figure]

รูปที่5.3ผังกำรเชื่อมต่อสำยสัญญำณ จำกรูปที่ 5.3 แสดงผังเชื่อมต่อสำยสัญญำณ ของแต่ละอุปกรณ์ประกอบด้วย NodeMCU ESP8266 รีเลย์ 4 ช่องสัญญำณ ATmega2560 โมดูลวัดปริมำณกำรใช้ไฟฟ้ำ ตู้แมคเนติค ระบบหน้ำตู้ และเทอมินอล 18 ช่อง ส ำหรับเป็ นที่ต่อสำยสัญญำนควบคุมกำรเปิ ด – ปิ ดอุปกรณ์

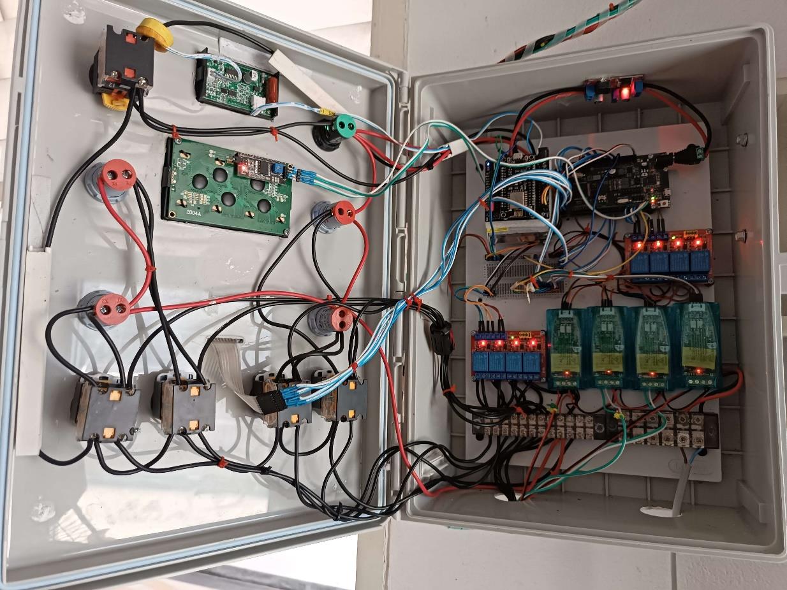
[picture p112: figure]

รูปที่5.4 ภำยในตู้ควบคุมระบบ จำกรูปที่ 5.4 แสดงกำรเชื่อมต่อสำยสัญญำณ ภำยในตู้ของแต่ละอุปกรณ์ ซึ่ งประกอบไปด้วย NodeMCU ESP8266 ATmega2560 รีเลย์ 4 ช่องสัญญำณ โมดูลวัดปริมำณกำรใช้ไฟฟ้ำ เทอร์มินอล 18 ช่อง 5.1.3กำรติดต้งัตูค้วบคุม
กำรติดต้งัตูค้วบคุมผูว้ิจยัไดต้ิดต้งัตูค้วบคุมระบบไวบ้ ริเวณห้องควบคุมระบบไฟฟ้ำ ตึกคณะวิทยำศำสตร์อำคำร 9 ช้ัน 1 มหำวิทยำลัยเทคโนโลยีรำชมงคลศรีวิชัย พ้ืนที่ไสใหญ่ แสดงดังรูปที่ 5.5

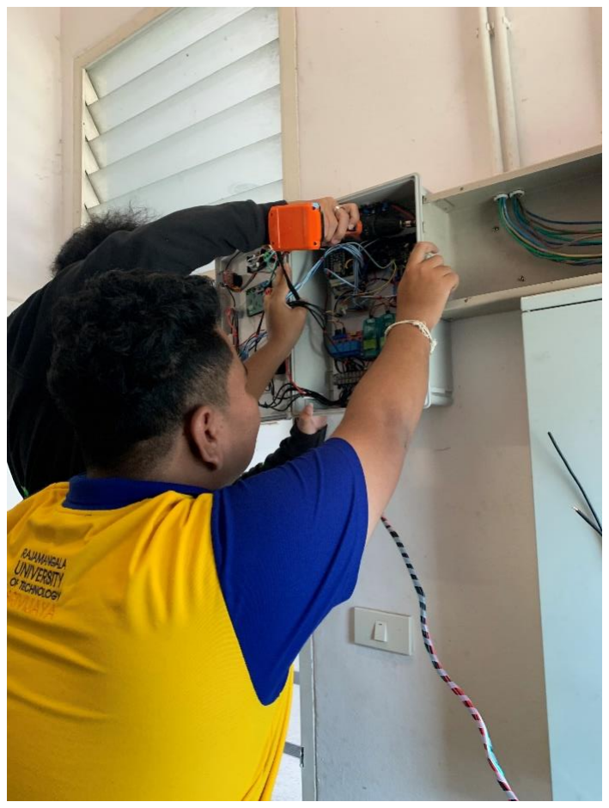
[picture p113: figure]

รูปที่5.5กำรติดต้งัตูร้ะบบใตอ้ำคำร9 ช้นั 1 จำกรูปที่ 5.5 ในกำรติดต้ังตู้ควบคุมได้ติดต้ังที่ห้องระบบไฟฟ้ำ อำคำร 9 ช้ัน 1มหำวิทยำลัย เทคโนโลยรีำชมงคลศรีวิชยั พ้ืนที่ไสใหญ่เพื่อใช้ในกำรควบคุมกำรท ำงำนของ 5.1.4กำรติดต้งัตูแ้มคเนติก
ควบคุมกำรท ำงำนของระบบไฟฟ้ำภำยในอำคำรจ ำเป็ นต้องควบคุมกำรเปิ ด-ปิ ดกำร ท ำงำนผ่ำนแมคเนติก ตำมรูปที่ 5.6

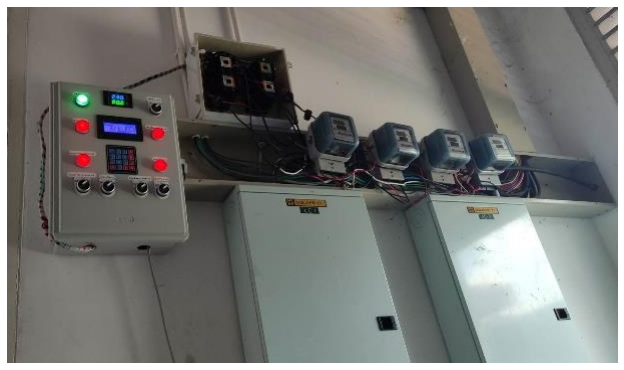
[picture p114: figure]

รูปที่5.6กำรติดต้งัตูแ้มคเนติก จำกรูปที่ 5.6 เพื่อให้ตู้ระบบสำมำรถตัดกระแสไฟฟ้ำได้เมื่อครบตำมเงือนไขที่ก ำหนด 5.1.5กำรติดต้งัมิเตอร์
มิเตอร์วัดไฟฟ้ำเข้ำกับตู้ควบคุมส ำหรับเก็บข้อมูลค่ำมิเตอร์ที่อุปกรณ์ไฟฟ้ำใช้ ตำมรูปที่ 5.7

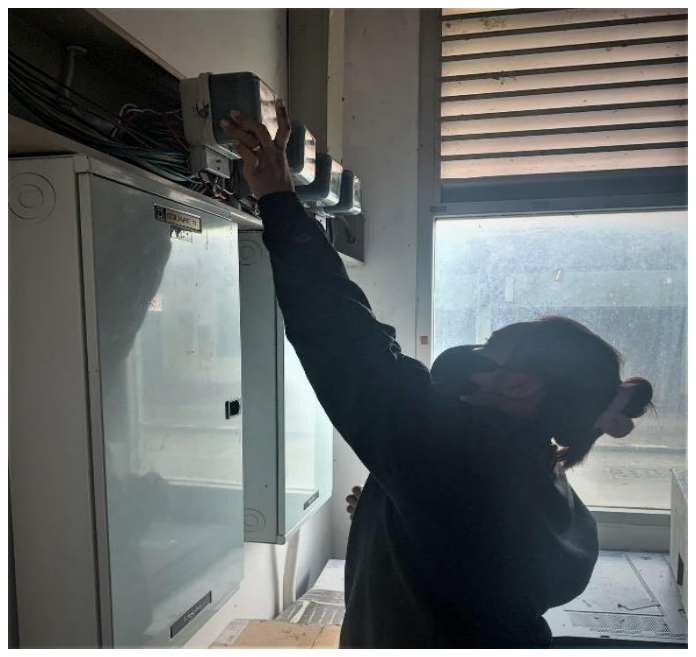
[picture p115: figure]

รูปที่5.7 ติดต้งัมิเตอร์วดัไฟ จำกรูปที่ 5.7 ติดต้งัมิเตอร์เพื่อใช้วัดปริมำณกระแสไฟฟ้ำของกำรใช้งำนอุปกรณ์ไฟฟ้ำ

5.1.6กำรเฝ้ำติดตำมทดลองกำรใช้งำนระบบ จำกกำรเฝ้ำทดลองระบบได้เจอปัญหำอุปกรณ์ไม่ตอบสนองต่อกำรท ำงำน แสดงค่ำ ไม่ตรงกับควำมเป็ นจริ ง ได้ปรับปรุ งแก้ไขปัญหำและบันทึกข้อมูลกำรทดสอบตู้ระบบ แสดงดัง ตำรำงที่ 5.1
ตำรำงที่ 5.1 บันทึกข้อมูลกำรทดสอบ

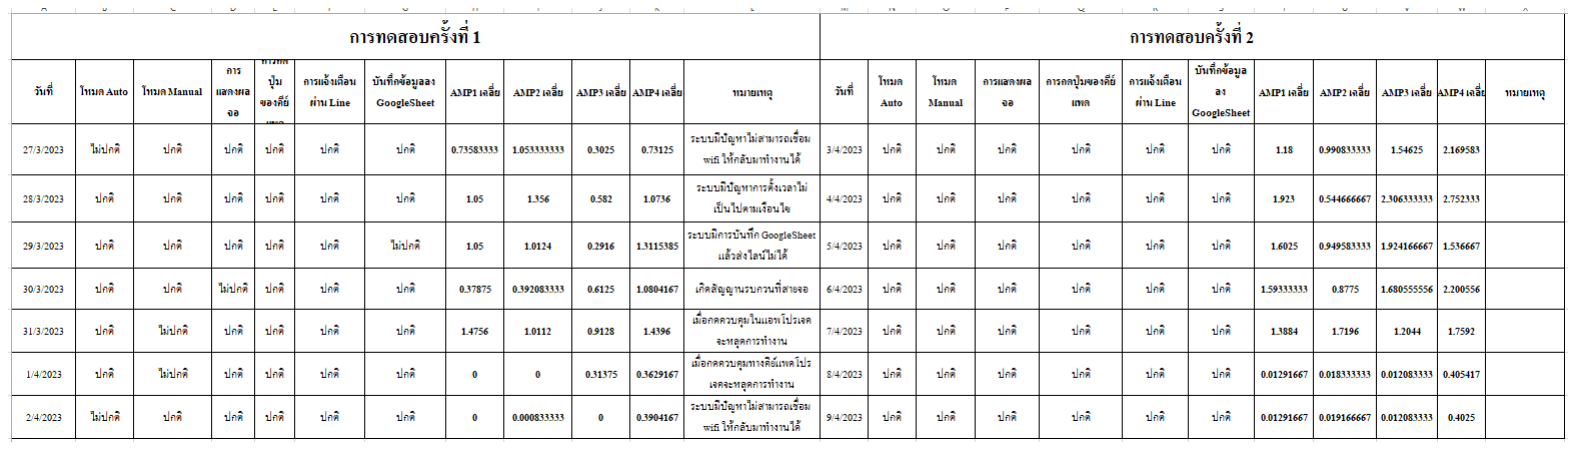
[picture p116: figure]

จำกตำรำงที่ 5.4 เป็ นกำรเก็บข้อมูลกำรทดสอบกำรท ำงำนกำรใช้งำนจริงพบว่ำ ยังมีข้อบกพร่องใน ช่วงแรกของกำรติดต้งั และไดท้ ำ กำรแกไ้ขใหเ้สถียรของในช่วยกำรทดสอบคร้ังถดัไป

### 5.2 อุปสรรคและปัญหำ

5.2.1 ขำสัญญำณไม่พอเนื่องจำกตอ้งใชใ้นกำรแสดงท้งัสถำนะกำรทำ งำนท้งักำรส่งขอ้ มูลผ่ำนไลน์ และกำรวัดค่ำปริมำณไฟฟ้ำ
5.2.2 Ethernet Shield ไม่เสถียรในเชื่อมต่อกำรท ำงำนท ำให้ช้ำและหลุดบ่อย

### 5.3 แนวทำงกำรแก้ปัญหำ

5.3.1 ศึกษำโครงสร้ำงของขำ Mega ว่ำมีขำอื่นที่ท ำหน้ำที่เหมือนกันหรือไม่ แปลงขำสัญญำณมำใช้ แทน
5.3.2 ใช้ Arduino Mega 2560 ท ำให้สำมำรถเชื่อมต่อ Wifi ได้เสถียรกว่ำ

### 5.4 ข้อเสนอแนะ

5.4.1 สำมำรถแยกกำรควบคุมออกเป็ นห้อง
5.4.2 สรุปกำรใช้ไฟฟ้ำตลอดเดือน
5.4.3 ต้งัเวลำหลำยช่วงเวลำได้

บรรณำนุกรม
[1] บอร์ด ATMega2560แหล่งที่มำ : https://www.allnewstep.com/product/2422/%E0%B8%9A%E0%B8%AD%E0%B8%A3%E0%B 9%8C%E0%B8%94-arduino-mega2560-pro-arduino-mega2560-pro-atmega2560-ch340g-arduino-compatible สืบค้นเมื่อ 25 ธันวำคม 2565
[2] Node mcu esp8266 แหล่งที่มำ : https://www.cybertice.com/category/144/modules-sensors/internet-of-things-iot-wifi/esp8266-wifi สืบค้นเมื่อ 25 ธันวำคม 2565
[3] PZEM-004T แหล่งที่มำ : https://www.cybertice.com/product/1765 สืบค้นเมื่อ 25 ธันวำคม 2565
[4] Relay 4 Channel แหล่งที่มำ : https://www.allnewstep.com/product/777/relay-4-channel-5v-relay-active-high-low-relay-module-shield-250v-10a-relay-5v สืบค้นเมื่อ 7 มกรำคม 2566
[5] Magnetic Contactor แหล่งที่มำ : https://mall.factomart.com/principle-of-magnetic-contactor/สืบค้นเมื่อ25 ธันวำคม 2565
[6] Matrix Keypad 4x4 Arduino แหล่งที่มำ : https://www.cybertice.com/product/3/ สืบค้นเมื่อ 25 ธันวำคม 2565
[7] จอแสดงผล LED 20*4 แหล่งที่มำ : https://www.ab.in.th/article/57/ สืบค้นเมื่อ 25 ธันวำคม 2565
[8] Application Line ส ำหรับกำรแจ้งเตือนกำรท ำงำน แหล่งที่มำ : https://www.timemint.co/line-notify-update/ สืบค้นเมื่อ 25 ธันวำคม 2565
[9] โปรแกรม Blynk แหล่งที่มำ : http://doc.inex.co.th/mbit-with-microblockide-ep8/ สืบค้นเมื่อ 7 มกรำคม 2566
[10] กำรออกแบบโปรแกรมโดยผู้ใช้งำนก ำหนดเอง ผ่ำน Blynk แหล่งที่มำ : https://iot.jpnet.co.th/blynk-library/ สืบค้นเมื่อ 7 มกรำคม 2566
[11] Switching power supply แหล่งที่มำ : https://www.ai-corporation.net/2021/11/12/component-of-power-supply/ สืบค้นเมื่อ 7 มกรำคม 2566
[12] กำรสื่อสำรอนุกรมแบบ UART แหล่งที่มำ : https://blog.thaieasyelec.com/espino32-ch7-how-to-use-uart/ สืบค้นเมื่อ 9 มกรำคม 2566
[13] จิรนันท์ ชอบหวำน ชฎำภรณ์ จวั่ นำน วิสสุตำ ขุนมี2559. วิจัยระบบประหยัดพลังงำนแบบออนไลน์ ส ำหรับควบคุมเครื่องปรับอำกำศ กรณีศึกษำสำขำวิทยำศำสตร์คอมพิวเตอร์ คณะวิทยำศำสตร์และ เทคโนโลยี มหำวิทยำลัยเทคโนโลยีรำชมงคลศรีวิชัย สืบค้นเมื่อ 9 มกรำคม 2566

[14] จักรวำล ชลสงครำ เจนณรงค์ แก้วนุ้ย สถำพร สุขคุ้ม 2562. งำนวิจัย ระบบควบคุมอุปกรณ์ไฟฟ้ำ และรักษำควำมปลอดภัยภำยในบ้ำนแบบออนไลน์กรณีศึกษำบ้ำนคุณร ำไพ ทองทิพย์ ต ำบลร่อน พิบูลย์ อ ำเภอร่อนพิบูลย์จังหวัดนครศรีธรรมรำช สืบค้นเมื่อ 9 มกรำคม 2566
[15] Code กำรใช้งำน Node mcu esp8266 แหล่งที่มำ :https://www.analogread.com/article/90/ สืบค้น เมื่อ 7ธันวำคม 2565
[16] ตัวอย่ำง Code กำรอ่ำนค่ำ Sensor แหล่งที่มำ : http://fitrox.lnwshop.com/article /40/tutorial สืบค้น เมื่อ9 มกรำคม 2566
[17] Application Line แหล่งที่มำ : https://line.me/en/ สืบค้นเมื่อ 7 มกรำคม 2566
[18] Arduino IDE แหล่งที่มำ : https://www.arduino.cc/en/software สืบค้นเมื่อ 7 มกรำคม 2566
[19] สุปริญญำลิ้มวนำนนท์2559. งำนวิจัยกำรประหยัดพลังงำนไฟฟ้ำ แหล่งที่มำ : http://ithesis-ir.su.ac.th/dspace/bitstream/123456789/1677/1/58602381.pdf สืบค้นเมื่อ 9 มกรำคม 2566

ภำคผนวก ก
ขั้นตอนและวิธีกำรติดตั้งโปรแกรม

ขั้นตอนกำรติดตั้งโปรแกรม Arduino IDE 2.0.0-rc9.3
1. เปิดไฟลต์ิดต้งัข้ึนมำกดปุ่ม I Agree ได้เลย

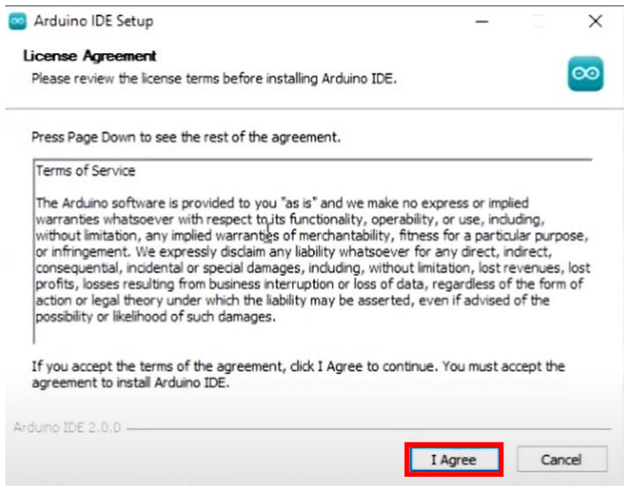
[picture p117: figure]

รูปที่ก.1กำรยอมรับเงือนไข
2. มีตวัเลือกให้เลือกติดต้งัแนะนำ ใหเ้ลือกท้งัหมด (ค่ำเริ่มตน้คือเลือกท้งัหมด)แลว้คลิกปุ่ม Next >

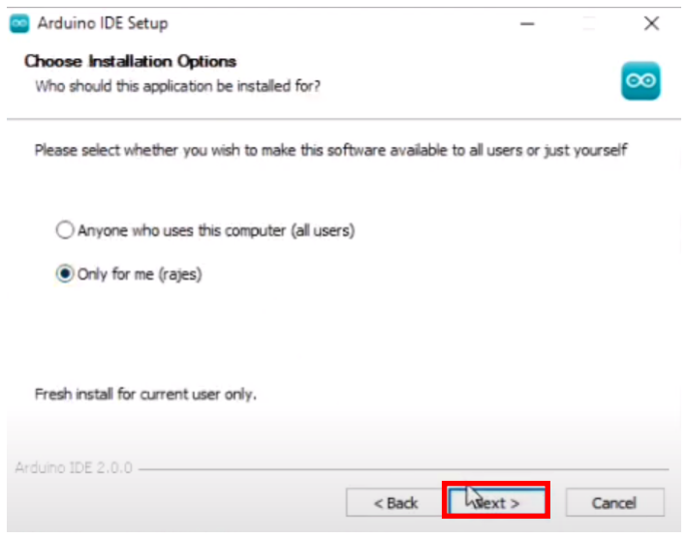
[picture p118: figure]

รูปที่ก.2กำรต้งัค่ำกำรติดต้งั

3. เลือกโฟลเดอร์ติดต้งัโปรแกรม หำกไม่ตอ้งกำรแกไ้ขคลิกปุ่ม Install

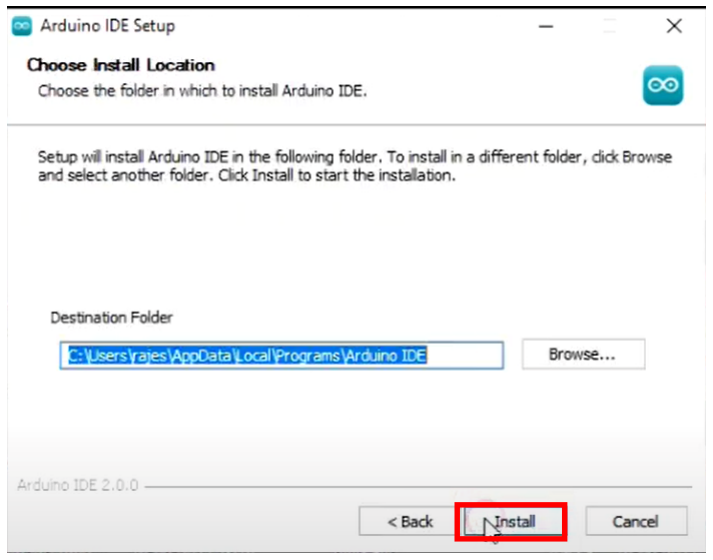
[picture p119: figure]

รูปที่ก.3กำรเลือก Folder ที่ต้องกำรจะเก็บโปรแกรม
4. จำกน้นั เริ่มทำ กำรติดต้งัโปรแกรม เมื่อติดต้งัเสร็จแลว้ใหเ้ลือก Close

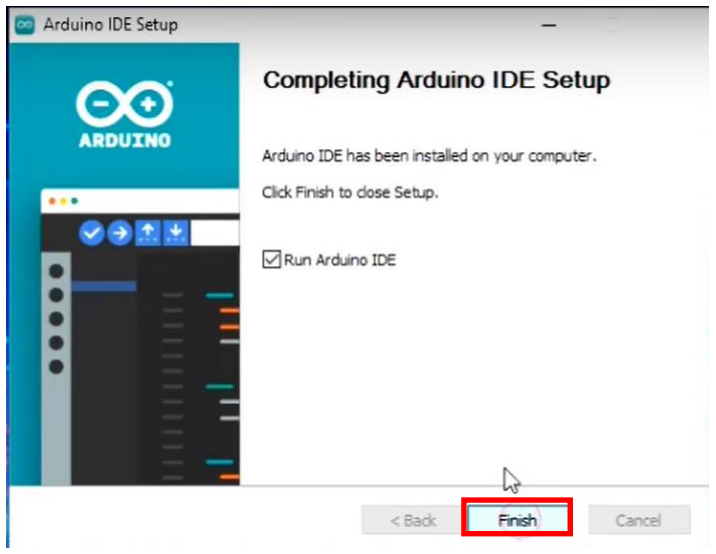
[picture p120: figure]

รูปที่ก.4แสดงสถำนะกำรติดต้งัโปรแกรม

ภำคผนวก ข
คู่ม

ื

อกำรใช้งำนระบบ

คู่ม

ื

อกำรใช้งำนระบบ

ระบบอัตโนมัติแบบออนไลน์ส ำหรับควบคุมอุปกรณ์ไฟฟ้ำเพื่อกำรประหยัดพลังงำน กรณีศึกษำ คณะวิทยำศำสตร์และเทคโนโลยี มหำวิทยำลัยเทคโนโลยีรำชมงคลศรีวิชัย

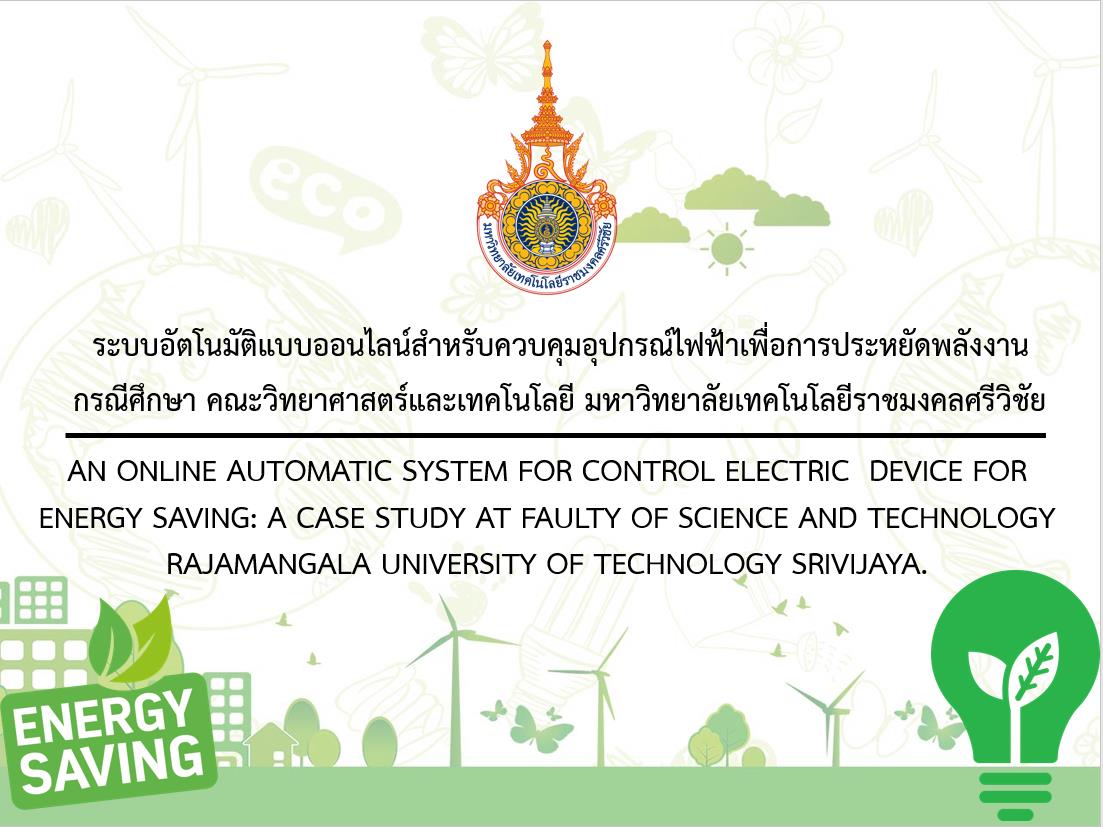
[picture p121: figure]

รูปที่ข.1ระบบอัตโนมัติแบบออนไลน์ส ำหรับควบคุมอุปกรณ์ไฟฟ้ำเพื่อกำรประหยัดพลังงำน

คู่มือกำรใช้งำนระบบที่ตู้ควบคุม
เมื่อผู้ใช้งำนต้องกำรควบคุมกำรท ำงำนของอุปกรณ์ไฟฟ้ำ ระบบอัตโนมัติแบบออนไลน์ส ำหรับ ควบคุมอุปกรณ์ไฟฟ้ำเพื่อกำรประหยัดพลังงำน กรณีศึกษำ คณะวิทยำศำสตร์และเทคโนโลยี มหำวิทยำลัย เทคโนโลยีรำชมงคลศรีวิชัย ผู้ใช้สำมำรถเลือกรูปแบบกำรท ำงำนได้ตำมที่ผู้ใช้ต้องกำร

1. เลือกโหมดกำรท ำงำนจำกคีย์แพด

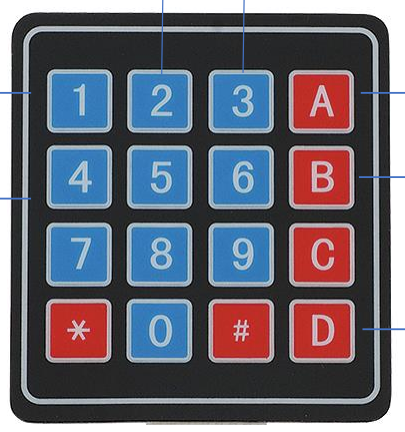
[picture p122: figure]

รูปที่ข.2กำรเลือกโหมดกำรท ำงำนจำกคีย์แพด จำกรูปที่ ข. 2ผใู้ชส้ ำมำรถเลือกรูปแบบกำรทำ งำนของระบบ ดงัน้ี
1. กดปุ่ ม 1 = Channel 1
2. กดปุ่ ม 2= Channel 2
3.กดปุ่ ม 3= Channel 3
4.กดปุ่ ม 4= Channel 4
5.กดปุ่ ม A = Auto กำรท ำงำนอัตโนมัติ 6.กดปุ่ ม B = Manualควบคุมด้วยมือ
7. กดปุ่ ม D = เพื่อออกจำกโหมด
2. เลือกโหมดกำรท ำงำนจำกสวิตช์ 2ทำง

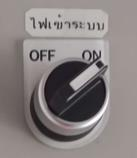
[picture p123: figure]

รูปที่ข.3กำรเลือกโหมดกำรท ำงำนจำกหน้ำตู้โดยใช้สวิตช์ 2 ทำง

1

4

5

6

7

2 3

จำกรูปที่ ข.3 ผใู้ชส้ ำมำรถเลือกรูปแบบกำรทำ งำนของระบบ ดงัน้ี
1. หมุนทำงซ้ำย = ปิ ดกำรท ำงำนของระบบ
2. หมุนทำงขวำ = เปิ ดกำรท ำงำนของระบบ
3. เลือกโหมดกำรท ำงำนจำกหน้ำตู้แบบสวิตช์3 ทำง

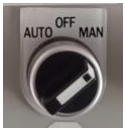
[picture p124: figure]

รูปที่ข.4กำรเลือกโหมดกำรท ำงำนจำกหน้ำตู้โดยใช้สวิตช์ 3 ทำง จำกรูปที่ ข.4 ผใู้ชเ้ลือกรูปแบบกำรทำ งำนของระบบ ดงัน้ี
1. หมุนทำงซ้ำย = กำรท ำงำนแบบ Auto
2. หมุนทำงขวำ = กำรท ำงำนแบบ Manual
3. หมุนตรงกลำง = ปิ ดกำรท ำงำน
4. หน้ำจอเมนูหลัก ท ำกำรเลือกโหมดกำรท ำงำน

รูปที่ข.5 หน้ำจอเมนูหลัก ท ำกำรเลือกโหมดกำรท ำงำน จำกรูปที่ ข.5ผู้ใช้สำมำรถเลือกรูปแบบกำรท ำงำนของระบบ แบ่งกำรท ำงำน 2 รูปแบบ
1. กดปุ่ ม A โหมดอัตโนมัติ
2. กดปุ่ ม B โหมดผู้ใช้งำนก ำหนดเอง

3. เมื่อกดปุ่ ม A แสดงภำยในโหมดอัตโนมัติ

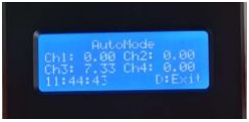
[picture p125: figure]

รูปที่ข.6 หน้ำจอโหมดอัตโนมัติ จำกรูปที่ ข.6 ระบบจะท ำงำนอัตโนมัติเมื่อท ำกำรเปิ ดกำรใช้งำน จะมีค่ำกำรวัดกำรใช้งำนไฟฟ้ำโดย แสดงขอ้ควำมดงัน้ี
1. Ch1: คือข้อควำมกำรใช้งำนเครื่องตัวที่ 1
2. Ch2: คือข้อควำมกำรใช้งำนเครื่องตัวที่ 2
3. Ch3: คือข้อควำมกำรใช้งำนเครื่องตัวที่ 3
4. Ch4: คือข้อควำมกำรใช้งำนเครื่องตัวที่ 4
5. กด D เพื่อออกจำกกำรใช้งำนโหมดอัตโนมัติ
4. เมื่อกดปุ่ ม B แสดงภำยในโหมดควบคุมด้วยมือ

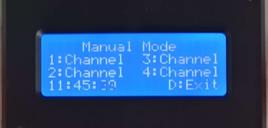
[picture p126: figure]

รูปที่ข.7 หน้ำจอกำรท ำงำนแบบควบคุมด้วยมือ จำกรูปที่ ข.7 ระบบกำรท ำงำนกรณีที่อุปกรณ์มีปัญหำหรือต้องกำรใช้งำนโดยไม่สนเงื่อนไขโดย แสดงขอ้ควำม 5 ตวัเลือกดงัน้ี
1. กดปุ่ ม 1 เพื่อให้ Ch1: เครื่องตัวที่ 1 ท ำงำน
2. กดปุ่ ม 2 เพื่อให้ Ch2: เครื่องตัวที่ 2 ท ำงำน
3. กดปุ่ ม 3 เพื่อให้ Ch3: เครื่องตัวที่ 3 ท ำงำน
4. กดปุ่ ม 4 เพื่อให้ Ch4: เครื่องตัวที่ 4 ท ำงำน
5. กด D เพื่อออกจำกกำรใช้งำนโหมดควบคุมด้วยมือ

คู่มือกำรใช้งำนระบบบน Application Blynk

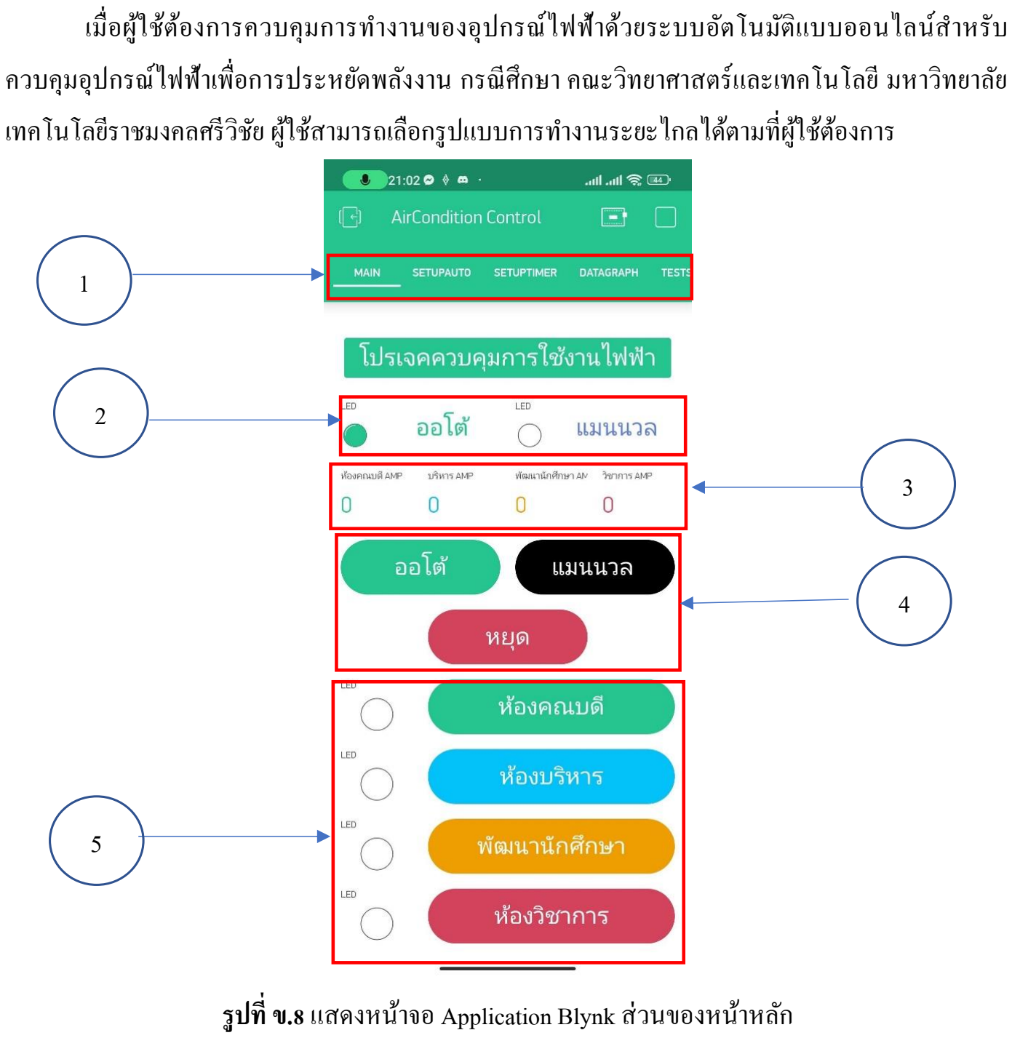
[picture p127: figure]
เมื่อผู้ใช้ต้องกำรควบคุมกำรท ำงำนของอุปกรณ์ไฟฟ้ำด้วยระบบอัตโนมัติแบบออนไลน์ส ำหรับ ควบคุมอุปกรณ์ไฟฟ้ำเพื่อกำรประหยัดพลังงำน กรณีศึกษำ คณะวิทยำศำสตร์และเทคโนโลยี มหำวิทยำลัย เทคโนโลยีรำชมงคลศรีวิชัย ผู้ใช้สำมำรถเลือกรูปแบบกำรท ำงำนระยะไกลได้ตำมที่ผู้ใช้ต้องกำร; รูปที่ข.8แสดงหน้ำจอ Application Blynk ส่วนของหน้ำหลัก

จำกรูปที่ ข.8องค์ประกอบของหน้ำหลัก 1.แถบเมนู 2.โหมดกำรท ำงำน 3.หน่วยไฟที่อุปกรณ์วัดค่ำ ได้ 4.เลือกโหมดกำรท ำงำน 5.สถำนะกำรท ำงำนอุปกรณ์

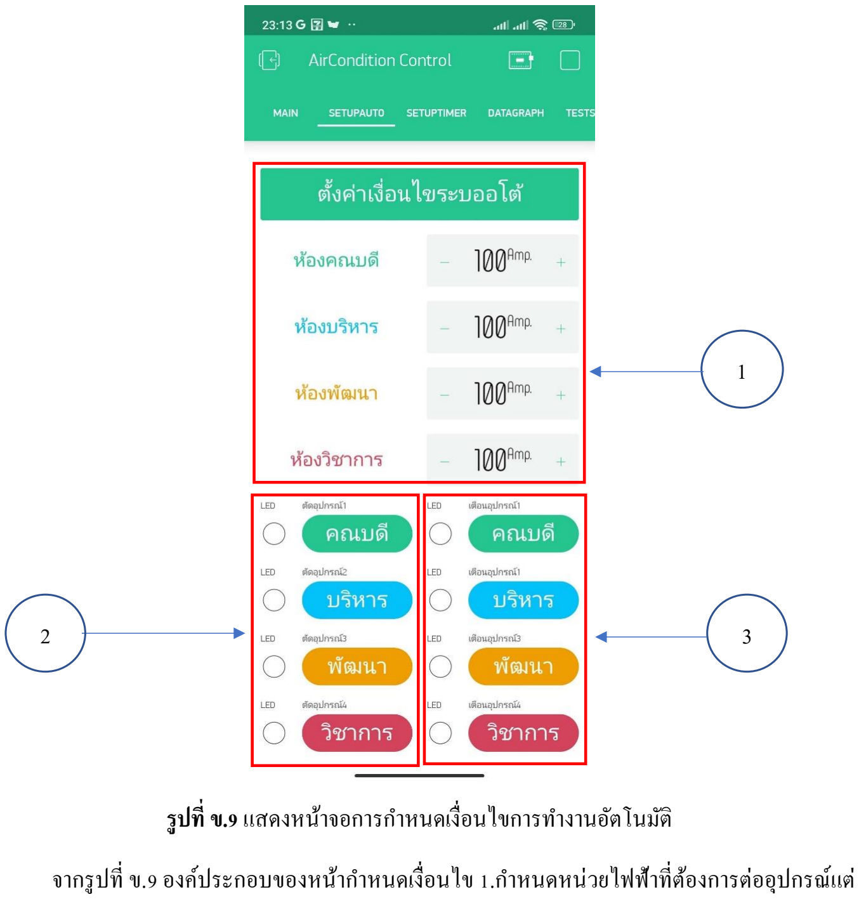
[picture p128: figure]
รูปที่ข.9แสดงหน้ำจอกำรก ำหนดเงื่อนไขกำรท ำงำนอัตโนมัติ; จำกรูปที่ ข.9องค์ประกอบของหน้ำก ำหนดเงื่อนไข 1.ก ำหนดหน่วยไฟฟ้ำที่ต้องกำรต่ออุปกรณ์แต่

ละตัว 2.ปุ่ มเปิ ด/ปิ ดกำรแจ้งเตือนกำรตัดเมื่อไฟอุปกรณ์เกิน 3.ปุ่ มเปิ ด/ปิ ด กำรแจ้งเตือนเมื่ออุปกรณ์เกิน ก ำหนด

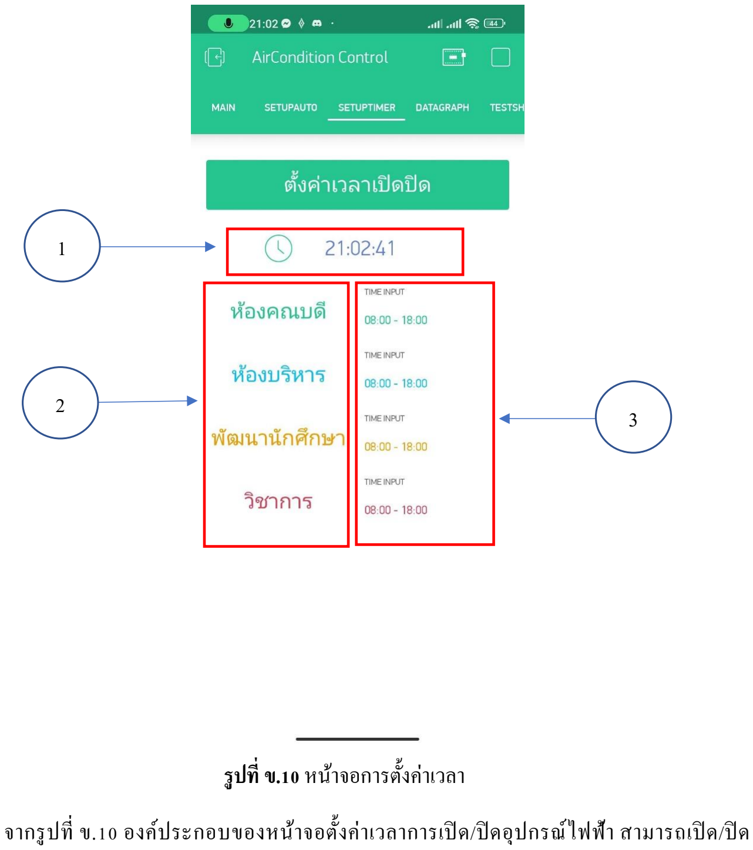
[picture p129: figure]
รูปที่ข.10 หนำ้จอกำรต้งัค่ำเวลำ; จำกรูปที่ ข.10 องค์ประกอบของหน้ำจอต้ังค่ำเวลำกำรเปิด/ปิดอุปกรณ์ไฟฟ้ำ สำมำรถเปิด/ปิด

อุปกรณ์ตำมเวลำที่ก ำหนด 1.แถบแสดงเวลำปัจจุบัน 2.ชื่อของอุปกรณ์ไฟฟ้ำ 3.เวลำกำรเปิ ด/ปิ ดอุปกรณ์

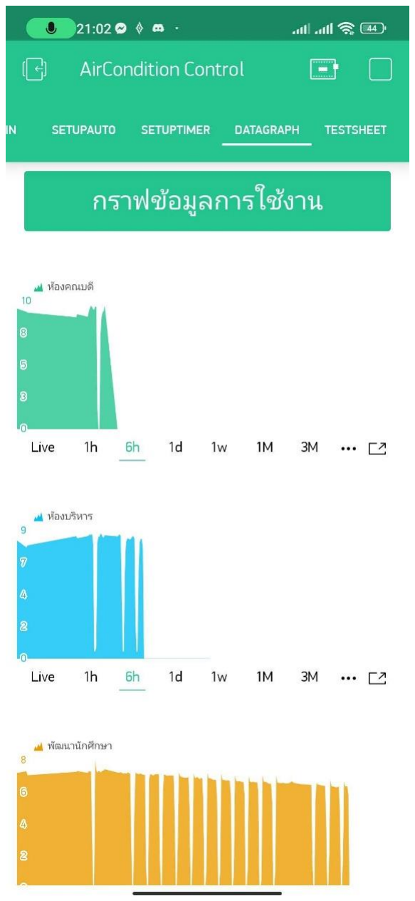
[picture p130: figure]

รูปที่ข.11แสดงหน้ำจอกำรใช้งำนของอุปกรณ์ในรูปแบบกรำฟ จำกรูป ข.11จะแสดงหน้ำจอกำรใช้งำนของอุปกรณ์แต่ละตัวในรูปแบบกรำฟ เพื่อง่ำยต่อกำรตรวจ วำ่ อุปกรณ์แต่ละตวัใชง้ำนในช่วงเวลำน้นั ๆ ไปกี่หน่วย

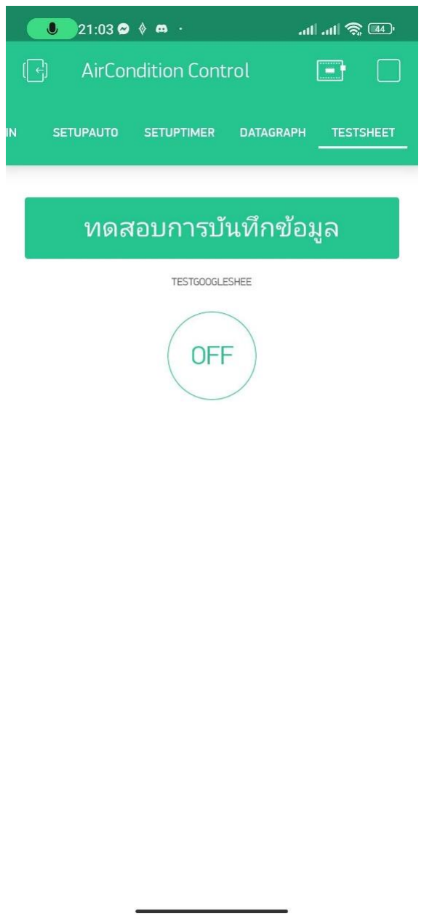
[picture p131: figure]

รูปที่ข.12 หน้ำจอบันทึกข้อมูลลงใน Google Sheet จำกรูปที่ ข.12จะแสดงปุ่ มทดสอบกำรบันทึกข้อมูลลง Google Sheet

ภำคผนวก ค
ภำพรวมชิ้นงำน

ภำพรวมชิ้นงำน

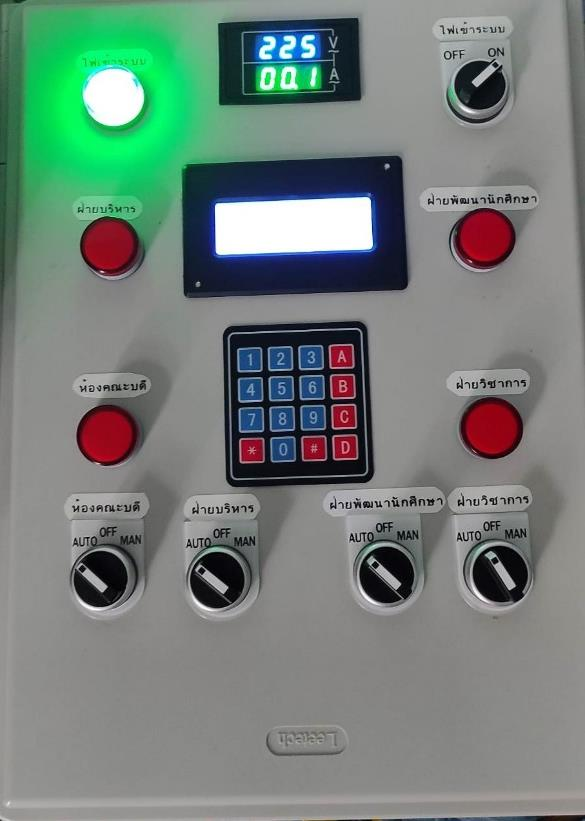
[picture p132: figure]

รูปที่ค.1 ตู้ควบคุมระบบ

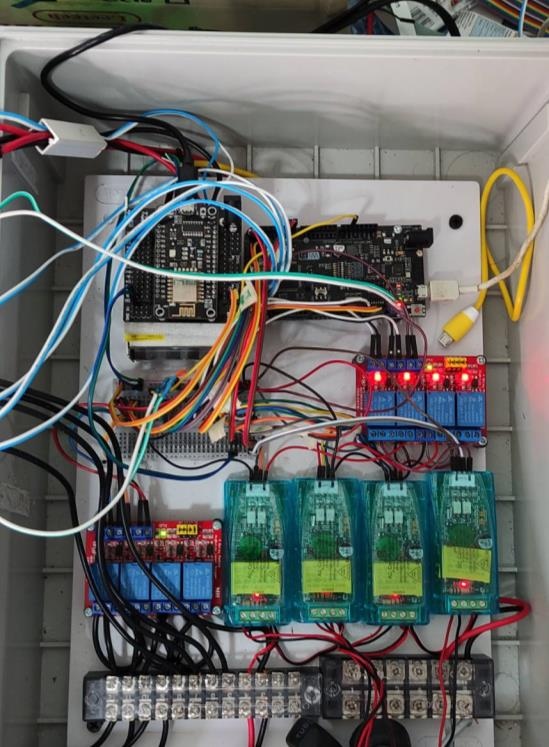
[picture p133: figure]

รูปที่ค.2 ภำพแสดงกำรเชื่อมต่อวงจร

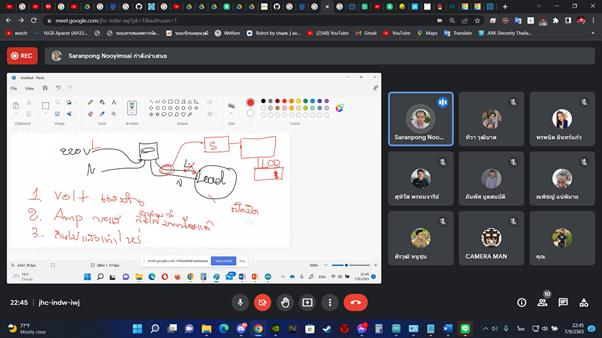
[picture p134: figure]

รูปที่ค.3 ภำพกำรแนะกำรเชื่อมต่อวงจร

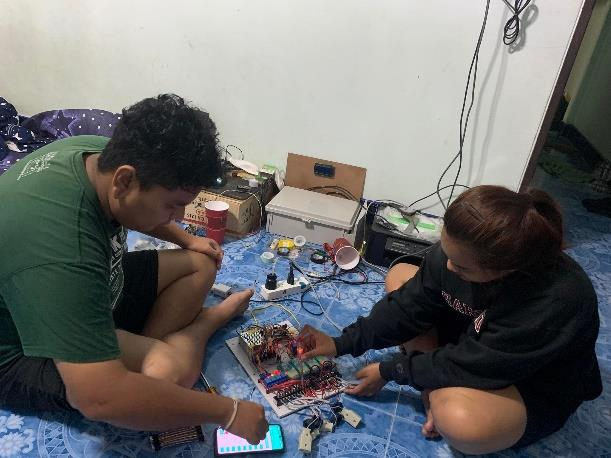
[picture p135: figure]
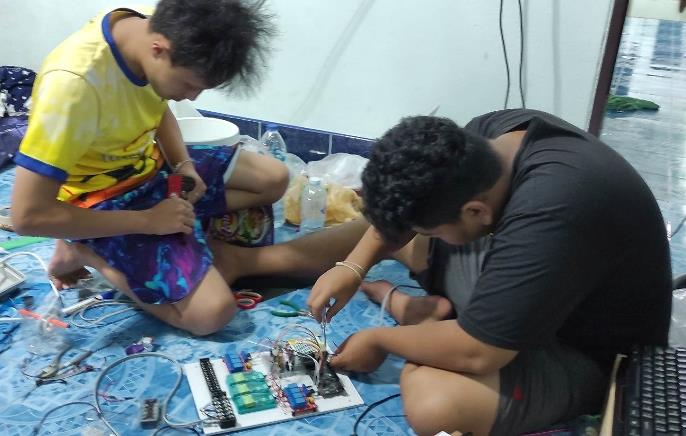
[picture p136: figure]

รูปที่ค.4 ภำพกำรท ำตู้ควบคุม

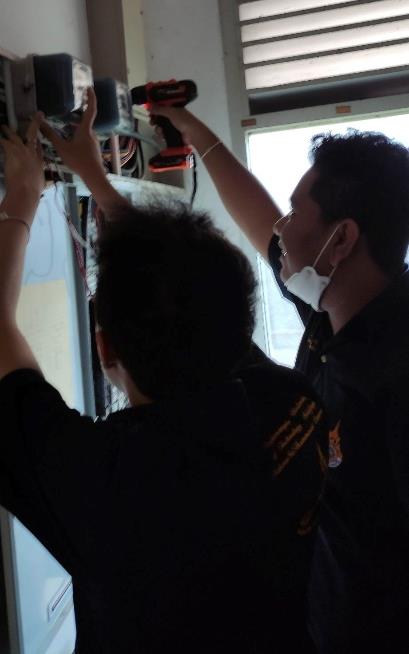
[picture p137: figure]
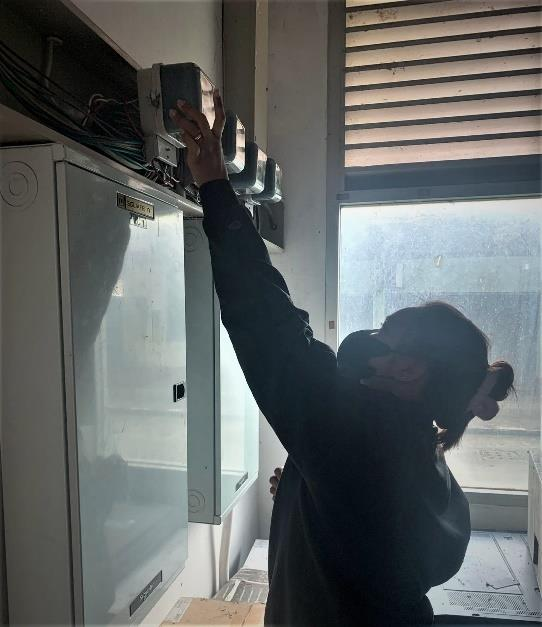
[picture p138: figure]

รูปที่ค.5 ภำพกำรติดต้งัมิเตอร์ไฟฟ้ำ

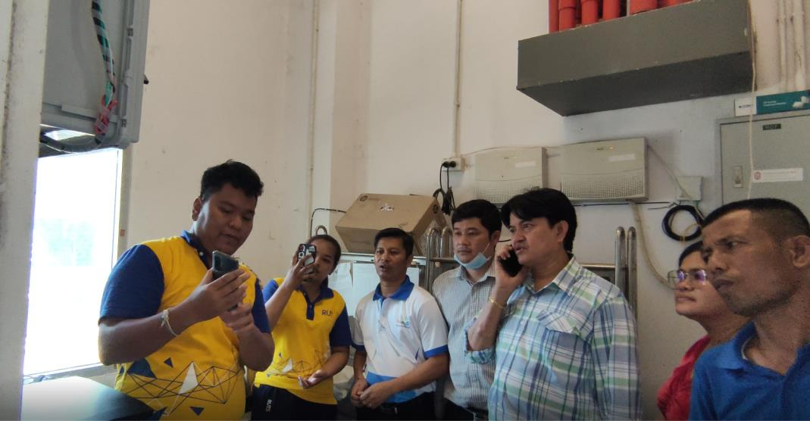
[picture p139: figure]

รูปที่ค.6 ภำพสอนกำรใช้งำนระบบ

ภำคผนวก ง
งบประมำณเพื่องำนวิจัย

งบประมำณเพื่องำนวิจัย

ตำรำงที่ ง.1 งบประมำณเพื่อกำรวิจัย

ล ำดับที่ | รำยกำร | จ ำนวน | หน่วย | รำคำ/ หน่วย | รวม
1 | บอร์ด ATMega2560 | 1 | บอร์ด | 745 | 745
2 | บอร์ด Arduino ESP8266 | 1 | บอร์ด | 70 | 70
3 | โมดูลวัดปริมำณกำรใช้ไฟฟ้ำ | 4 | โมดูล | 260 | 1,040
4 | โมดูล relay ขนำด 4 ช่องสัญญำน | 1 | โมดูล | 100 | 100
5 | จอแสดงผล LCD ขนำด 20x4 | 1 | แผง | 198 | 198
6 | สวิทชิ่ง 5 v | 1 | ชิ้น | 295 | 295
7 | คีย์แพดขนำด 4x4 | 1 | ชิ้น | 28 | 28
8 | สำยแพ/สำยจ้มัเปอร์ | 3 | แผง | 35 | 105
9 | ตู้ควบคุม | 1 | กล่อง | 390 | 390
10 | กล่องตู้ไฟ | 1 | กล่อง | 150 | 150
11 | สำยไฟ | 2 | เส้น | 150 | 300
12 | Breadboard | 1 | บอร์ด | 39 | 39
13 | Magnetic switch | 4 | ตัว | 500 | 2,000
14 | Terminal | 3 | ตัว | 70 | 210
15 | Pilot Lamp / ไฟแสดงสถำนะ | 5 | แผง | 35 | 175
16 | Selector Switch 2 Positions | 1 | ชิ้น | 35 | 35
17 | Selector Switch 3 Positions | 4 | ชิ้น | 35 | 140
18 | อุปกรณ์เบ็ดเตล็ด | | | | 500
รวม | | | | | 6,520

ประวัติผู้จัดท ำปริญญำนพิ นธ

์

ประวัติผู้จัดท ำปริญญำนพิ นธ

์

ชื่อ-นำมสกุล | นำยคณำธิป ศรีอ่อน 364202360040
สำขำวิชำ | สำขำวิชำเทคโนโลยีสำรสนเทศ
วัน-เดือน-ปี เกิด | วันที่ 30 มีนำคม 2544
สถำนที่เกิด | จังหวัดนนทบุรี
ที่อยู่ | 176 หมู่ที่1 ต ำบลปริก อ ำเภอทุ่งใหญ่ จังหวัดนครศรีธรรมรำช 80240
เบอร์โทร | 095-440-9235
ประวัติกำรศึกษำ | มัธยมศึกษำตอนต้น (ม.3) โรงเรียนเจริญวิทยำ ปี ปี ที่ส ำเร็จกำรศึกษำ 2559
| ประกำศนียบัตรวิชำชีพ (ปวช.) วิทยำลัยเทคนิคทุ่งสง ปี ที่ส ำเร็จกำรศึกษำ 2562
| ประกำศนียบตัรวิชำชีพช้นั สูง (ปวส.)วิทยำลยัเทคนิคทุ่งสง ปีที่สำ เร็จกำรศึกษำ
| 2564

ประวัติผู้จัดท ำปริญญำนพิ นธ

์

ชื่อ-นำมสกุล | นำงสำวพรพนิต อินทร์แก้ว 364202360060
สำขำวิชำ | สำขำวิชำเทคโนโลยีสำรสนเทศ
วัน-เดือน-ปี เกิด | วันที่ 17 ตุลำคม 2543
สถำนที่เกิด | จังหวัดนครศรีธรรมรำช

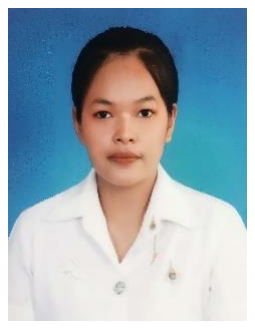
[picture p140: figure]

ที่อยู่ | 14 ถนน ทุ่งสง-นำบอน ต ำบล ปำกแพรก อ ำเภอ ทุ่งสง จังหวัด นครศรีธรรมรำช
| 80110
เบอร์โทร | 080-474-3009
ประวัติกำรศึกษำ | มัธยมศึกษำตอนต้น (ม.3) โรงเรียนทุ่งสง ปี ที่ส ำเร็จกำรศึกษำ 2559
| ประกำศนียบัตรวิชำชีพ (ปวช.) วิทยำลัยกำรอำชีพพรหมคีรี
| ปี ที่ส ำเร็จกำรศึกษำ 2562
| ประกำศนียบตัรวิชำชีพช้นั สูง (ปวส.)วิทยำลยักำรอำชีพพรหมคีรี
| ปี ที่ส ำเร็จกำรศึกษำ 2564

ประวัติผู้จัดท ำปริญญำนพิ นธ

์

ชื่อ-นำมสกุล | นำยณพิชญ์ แน่พิมำย 364202360056
สำขำวิชำ | สำขำวิชำเทคโนโลยีสำรสนเทศ
วัน-เดือน-ปี เกิด | วันที่ 2 มิถุนำยน 2542
สถำนที่เกิด | จังหวัดนครศรีธรรมรำช

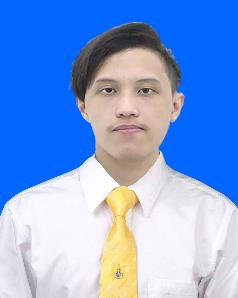
[picture p141: figure]

ที่อยู่ | 314 ถนนศรีธรรมโศก ต ำบลในเมือง อ ำเภอเมือง จังหวัดนครศรีธรรมรำช 80000
เบอร์โทร | 092-993-3752
ประวัติกำรศึกษำ | มัธยมศึกษำตอนต้น (ม.3) โรงเรียนจรัสพิชำกร ปี ที่ส ำเร็จกำรศึกษำ 2557
| ประกำศนียบัตรวิชำชีพ (ปวช.) วิทยำลัยเทคโนโลยีจรัสพิชำกร
| ปี ที่ส ำเร็จกำรศึกษำ 2560
| ประกำศนียบตัรวิชำชีพช้นั สูง (ปวส.)วิทยำลยัเทคนิคนครศรีธรรมรำช
| ปี ที่ส ำเร็จกำรศึกษำ 2562
