PipeNitch/Project_WPNS-IoT/Example/รวมเล่มรายงานวิจัยรายได้66.pdf

## รายงานการวิจัย

## การพัฒนาระบบอัตโนมัติแบบออนไลน์ส้าหรับการควบคุมการให้น ้าสวน สละชุมชนบ้านในยาง ต้าบลร่มเมือง อ้าเภอเมือง จังหวัดพัทลุง

## Development of automatic online system for the watering

controls in salacca plantations, Bannaiyang, Rommuang,

## Muang District, Phatthalung Province

## สราญพงศ์ หนูยิ มซ้าย Saranpong Nooyimsai

รัตติยา สารดิษฐ์ | Rattiya Saradit
สกุลรัตน์หาญศึก | Sakulrat Hansuek

## คณะวิทยาศาสตร์และเทคโนโลยี มหาวิทยาลัยเทคโนโลยีราชมงคลศรีวิชัย

## ได้รับการสนับสนุนทุนวิจัยจากมหาวิทยาลัยเทคโนโลยีราชมงคลศรีวิชัย งบประมาณเงินรายได้ประจ้าปีพ.ศ. 2566

ก

## การพัฒนาระบบอัตโนมัติแบบออนไลนสําหรับการควบคุมการใหน้ําสวนสละ ชุมชนบานในยาง ตําบลรมเมือง อําเภอเมือง จังหวัดพัทลุง

### สราญพงศ หนูยิ้มซาย รัตติยา สารดิษฐ และสกุลรัตน หาญศกึ

### บทคัดยอ

โครงงานวิจัยนี้เปนการพัฒนาระบบอัตโนมัติแบบออนไลนสําหรับการควบคุมการใหน้ําในสวน สละ เปนกรณีศึกษาที่สวนสละชุมชนบานในยาง ตําบลรมเมือง อําเภอเมือง จังหวัดพัทลุง ระบบควบคุม การเปดปดปมน้ําและสลับการใหน้ําในสวน 4 แถว การควบคุมระบบจะควบคุมไดทั้งแบบออนไซตท่ีหนา ตูระบบจากการกดแปนคียแพด และควบคุมแบบออนไลนผานแอพพลิเคชั่นบนโทรศัพทมือถือ การทํางาน

ของระบบสามารถตั้งคา การทํางานได3 รูปแบบ คือ การรดน้ําแบบอัตโนมัติตามความชื้นในดิน การรดน้ํา

ตามเวลา และการสั่งรดน้ําตามที่ผูใชควบคุมเองตามตองการ ผูวิจัยยังไดออกแบบระบบเพื่อใหปมน้ํา ทํางานตามการเปดปดของโซลินอยวาลวโดยไมตองสั่งงานปมน้ําเพื่อความสะดวกในการใชงาน รวมถึงมี ระบบปองกันปมน้ําเสียหายจากการที่ปมไมสามารถดูดน้ําในบอขึ้นมาได ปองกันความเสียหายของระบบ ทอจากการที่แรงดันน้ําในทอน้ําสูงเกินปกติ การทดลองระบบ ผูวิจัยไดติดตั้งตูระบบควบคุมบริเวณโรงเรือนเก็บปมน้ําภายในสวนสละและ ทําการติดตั้งโซลินอยวาลวรวมกับวาลวเดิมเพื่อใชวาลวเดิมเปนระบบสํารอง ผลการทดสอบระบบปรากฏ

วาระบบสามารถรับคําสั่งจากผูใชไดทั้งจากการกดคียแพดหนาตูควบคุมหรือจาก Blynk เมื่อไดรับคําสั่ง

### แลวระบบสามารถทํางานตามคําสั่งไดอยางถูกตอง ระบบสามารถสลับการเปดปดน้ําแตละแถวไดทุกตอง ตามเวลาท่ีกําหนดไดอยางแมนยํารวมถึงสามารถหยุดการทํางานของปมน้ํากรณีปมมีปญหาและทําการ แจงขอความเตือนไปยังผูใชงานระบบผานแอพพลิเคชั่นไลนได

### คําสําคัญ ระบบออนไลน ความชื้นในดิน การควบคุม สวนสละ สมารทฟารม

ข

## Development of automatic online system for the watering controls in

salacca plantations, Bannaiyang, Rommuang, Muang District,

## Phatthalung Province

Abstract This research project is the development of an online automatic system for controlling water supply in a salak orchard. The case study is a salak orchard in Ban Nai Yang community, Rom Muang sub-district, Mueang district, Phatthalung province. The system controls the on-off and off-off of the water pump and switches the water supply in the 4 -row orchard. The system control can be controlled both on-site at the system cabinet by pressing the keypad and online via a mobile phone application. The system can be set to work in 3 modes: automatic watering according to soil moisture, watering according to time, and watering according to the user's own control as desired. The researcher also designed the system to make the water pump work according to the on-off of the solenoid valve without having to control the water pump for ease of use. There is also a system to prevent water pump damage from the pump not being able to suck water from the pond up, and to prevent damage to the pipe system from water pressure

in the water pipe being too high.

### System testing The researcher installed a control cabinet in the water pump storage house inside the salak orchard and installed a solenoid valve together with the

original valve to use the original valve as a backup system. The system test results showed

that the system could receive commands from the user either by pressing the keypad in front of the control cabinet or from Blynk. When receiving the command, the system could work correctly according to the command. The system can switch the water on and off in each row at the specified time accurately, including stopping the water pump in case of a problem and sending a warning message to the system user via the LINE

application.
Keywords: online system, moisture levels in soil, control,

### Salacca plantation, smartfarm

ค

## กิตติกรรมประกาศ

ขอขอบคุณมหาวิทยาลัยเทคโนโลยีราชมงคลศรีวิชัย ที่สนับสนุนทุนวิจัยจากงบประมาณรายได ประจําป พ.ศ. 2566 ขอขอบคุณ นายรุน วัฒนหนู เจาของสวนสละที่ใหความอนุเคราะหสถานที่ในการทดสอบระบบ สําหรับโครงการวิจัยในครั้งนี้ ขอขอบคุณอาจารยและเจาหนาที่ สาขาเทคโนโลยี คณะวิทยาศาสตรและเทคโนโลยี ทุกทานที่ให ความชวยเหลือและอํานวยความสะดวกในเรื่องตาง ๆ ที่จําเปนตอการทํางานวิจัย

### สราญพงศ หนูยิ้มซาย รัตติยา สารดิษฐ สกุลรัตน หาญศกึ สิงหาคม 2567

ง

### สารบัญ

### บทคัดยอภาษาไทย บทคัดยอภาษาอังกฤษ กิตติกรรมประกาศ สารบัญ สารบัญตาราง สารบัญภาพ

ก
ข
ค
ง
ฉ
ช

จ

### สารบัญ (ตอ)

บทที่ 3 การวิเคราะหและออกแบบระบบ | 23 3.1 ขั้นตอนการวิเคราะหปญหา | 23 3.2 ขั้นตอนการออกแบบระบบ | 24 3.3 การพัฒนาโปรแกรมสําหรับควบคุมระบบ | 25 บทที่ 4 การพัฒนาระบบงาน | 40 4.1 การเชื่อมตออุปกรณทางดานฮารดแวร | 40 4.2 การออกแบบหนาจอแสดงผลที่ตูควบคุมระบบ | 42 4.3 การออกแบบแอพพลิเคชั่นที่ใชในการควบคุมระบบ | 45 บทที่ 5 สรุปผลการทดลอง | 46 5.1 การติดตั้งระบบ | 46 5.2 การทดสอบระบบ | 49 5.3 การประเมินความพึงพอใจของผูใชระบบ | 51 5.4 สรุปผล | 52 เอกสารอางอิง | 53

ฉ

## สารบัญตาราง

### ตารางที่ 5.1 คาเฉลี่ยและสวนเบี่ยงเบนมาตรฐานความพึงพอใจของผูใชระบบ | 51

ช

## สารบัญรูป

ซ

## สารบัญรูป(ตอ)

1

1

## บทที่ 1 บทนํา

1.1 ความเปนมาและความสําคัญ สละเปนผลไมที่มีประโยชนเนื่องดวยในผลสละมีสารตานอนุมูลอิสละเปนจํานวนมาก ไดแกสารฟ โนลิค สารฟลาโวนอยด ซึ่งเปนสารตานอนุมูลอิสระที่ทรงประสิทธิภาพ ชวยปองกันโรคตาง ๆ ไดเปน อยางดี ไดแกโรคมะเร็ง โรคหัวใจขาดเลือด ปองกันการถูกทําลายของเซลลจากสารอนุมูลอิสระ รวมทั้ง ชะลอการเกิดริ้วรอยกอนวัย สละจึงเปนที่นิยมรับประทาน และสงผลใหราคาของสละคอนขางสูงตอเนื่อง และตลอดป ดวยราคาที่คอนขางสูงและสามารถเก็บเกี่ยวไดตลอดป สละจึงเปนที่นิยมในการเพาะปลูก ของเกษตรกร สวนสละชุมชนบานในยาง ต.รมเมือง อ.เมือง จ.พัทลุง เปนสวนสละที่สรางรายไดใหแกทางชุมชน

โดยเมื่อทําการเก็บเกี่ยวเพื่อจําหนายจะมีแมคามารับซื้อผลผลิตถึงสวนโดยมีราคาขายที่หนาสวนกิโลกรัม

### ละประมาณ 50 ถึง 60 บาท ในบางครั้งดวยความนิยมรับประทานของผูบริโภคจะมีการสั่งจองเพื่อใหทาง สวนทําการจัดสงผานขนสงเอกชนซึ่งจะขายในราคาขายปลีกกิโลกรัมละประมาณ 70 ถึง 80 บาทไมรวม คาจัดสง ดวยราคาขายดังกลาวจะเห็นไดวาการปลูกสละทําใหเกษตรกรมีรายไดที่มั่นคงและตลอดป แต

ทั้งนี้จากการสํารวจของทีมงานวิจัยพบวาการปลูกสละเพื่อการจําหนายที่จะใหไดผลสละที่มีประสิทธิภาพ

### ไมมีโรค ไมมีหนอนชอนไช และรสชาติที่อรอยนั้น การปลูกสละจะตองดูแลการเพาะปลูกอยางดี มีปจจัย หลายอยางที่ตองควบคุมดูแลเอาใจใส ไดแก การผสมดอกที่มีชวงผสมระยะเวลาเก็บเกี่ยวที่ตองไดระยะ

เก็บเกี่ยวที่ไมมากไมนอยกวาที่กําหนดซึ่งโดยประมาณจะอยูที่ 7 เดือนครึ่งหลังทําการผสมดอก การใหปุย

การปองกันแมลง การเก็บเกี่ยว และที่สําคัญคือการใหน้ําที่ตองสม่ําเสมอไมมากไมนอยเกินไป จาก รายละเอียดขางตนจะเห็นวาแมผลสละจะมีราคาคอนขางสูงและเก็บเกี่ยวไดตลอดปแตก็ตองแลกกับการ เอาใจใสดูแลรักษาที่ตองคอนขางรัดกุม เกษตรกรตองมีเวลาเอาใจใสเปนอยางมากโดยเฉพาะการรดน้ําใน แปลงสวนสละที่ตองรดน้ําใหไดปริมาณน้ําที่พอดีไมมากหรือนอยเกินไป ซึ่งจะมีผลตอรสชาติและการ เจริญเติบโตของลําตน ดังนั้นในการเพาะปลูกสละของชาวเกษตรกรพบวาปจจัยหลักที่มีผลตอการ

เจริญเติบโตและรสชาติของสละคือการใหน้ําที่ตองมีการบริหารจัดการที่ดีเพื่อกอใหเกิดการประหยัดเพื่อ

### ลดตนทุนกอใหเกิดรายไดมากขึ้น ทั้งการประหยัดพลังงานไฟฟา ประหยัดเวลา รวมถึงการปองกันความ เสียหายของอุปกรณที่ใชในการรดน้ําภายในสวนสละไดแก ปมน้ํา ที่จะสามารถชํารุดไดทันที (ปมน้ํา

มอเตอรไหม) จากการที่ปมดูดน้ําในบอไมขึ้นดวยเหตุผลนานัปการ ซึ่งสิ่งตาง ๆ เหลานี้ลวนเปนคา ใชจายที่

### มีผลตอรายไดของเกษตรกรทั้งสิ้น จากประเด็นปญหาของการบริหารจัดการน้ําภายในสวนสละที่ตองการปริมาณน้ําที่ตองพอดิบ พอดีไมมากไมนอยจนเกินไป รวมถึงความตองการใหเกษตรกรมีเวลาเพื่อการดูแลปจจัยอื่นที่มีผลตอ

2

2

คุณภาพของผลสละและที่สําคัญเพื่อเปนการปองกันการชํารุดของปมน้ําที่มีราคาคอนขางแพง ทางผูวิจัย

จึงไดมีแนวคิดที่จะสราง ระบบอัตโนมัติแบบออนไลนสําหรับการควบคุมการใหน้ําสวนสละ โดยระบบ สามารถทํางานไดหลายรูปแบบไดแก การทํางานแบบอัตโนมัติตามความชื้นที่มีภายในดินจากการวัดดวย เซนเซอรวัดความชื้นในดิน การทํางานตามเวลาที่ไดกําหนดไวลวงหนาและแปรผันตามความชื้นในดิน ระบบยังมีการทํางานที่เปนแบบออนไลนที่สามารถควบคุมสั่งการดวยโทรศัพทมือถือแบบสมารทโฟน เพื่อ เพิ่มความสะดวกในการควบคุมระบบใหกับเกษตรกรและยังสามารถควบคุมมแบบออนไซตไดดวย ระบบ ที่ผูวิจัยคิดคนนี้ยังมีระบบปองกันความเสียหายของปมน้ํา ปองกันควาเสียหายของระบบทอท่ีเกิดจาก แรงดันน้ําในระบบทอมากเกินไป โดยระบบจะหยุดการทํางานของปมน้ําทันทีเมื่อตรวจจับความผิดปกติใน กรณีตาง ๆ ได ทั้งนี้เพื่อเปนการประหยัดคาซอมแซมที่เกิดจากความเสียหายของอุปกรณใหกับเกษตรกร

และที่สําคัญในสวนของอัลกอริทึมของการใหน้ําสําหรับการสลับแถวของการใหน้ําในแตละแถวผูวิจัยจะใช

### แนวคิดในการใหน้ําแบบคอยเปนคอยไปเมื่อถึงเวลาเปลี่ยนแถวการใหน้ําจะเปดการใหน้ําแบบ 2 แถว พรอมกันกอนสักระยะแลวคอยปดแถวเดิมที่ไดทําการลดน้ําไปแลว ทั้งนี้เพื่อเปนการปองกันแรงดันใน ระบบทอน้ํามากเกินไปในชวงระหวางการเปลี่ยนแถวการใหน้ํา

### 1.2 วัตถุประสงคของการวิจัย 1.2.1 เพื่อศึกษาและพัฒนาระบบอัตโนมัติสําหรับการควบคุมการใหน้ําในสวนสละที่ออนไลนโดย ใชเทคโนโลยีอินเตอรเน็ตในทุกสิ่ง 1.2.2 เพื่อเปรียบเทียบประสิทธิภาพของการใหน้ําในสวนสละในรูปแบบเดิมเทียบกับการใชระบบ อัตโนมัติที่ผูวิจัยพัฒนาขึ้น

1.3 ประโยชนที่คาดวาจะไดรับจากงานวิจัย 1.3.1 ไดระบบอัตโนมัติสําหรับการควบคุมการใหน้ําสวนสละ ใหแกชุมชนบานในยาง ตําบลรม เมือง อําเภอเมือง จังหวัดพัทลุง 1.3.2 ไดนวัตกรรมที่ชวยใหเกษตรกรมีความสะดวกไดใชเทคโนโลยีอยางคุมคา 1.3.3 เปนการสนับสนุนใหเกษตรกรในพื้นท่ีใกลเคียงไดเห็นคุณคาของการนําเทคโนโลยีมาใชใน การเกษตร 1.3.4 ชวยเพิ่มผลผลิตของสวนสละใหมีผลผลิตมากขึ้น 1.3.5 ชวยใหเกษตรกรชุมชนบานในยางมีรายไดเพิ่มขึ้น 1.3.6 ลดการสูญเสียของอุปกรณที่ใชในการเกษตร

3

3

### 1.4 เครื่องมืออุปกรณและซอฟตแวรที่ใชในการพัฒนา 1.4.1 เครื่องมือทางดานฮารดแวร ประกอบดวย

- เซ็นเซอรวัดความชื้นในดิน | จํานวน 4 โมดลู
- keypad 4x4 | จํานวน 1 แผง
- Flow Switch | จํานวน 1 ตัว
- บอรด Arduino รุน 2560 | จํานวน 1 บอรด

### - บอรด Ethernet Shield W5 100 จํานวน 1 บอรด

- Node MCU | จํานวน 1 บอรด
- จอแสดงผล LCD 20x4 | จํานวน 1 โมดูล
- Relay Module 5 Channel | จํานวน 1 โมดูล
- โซลินอยดวาลว | จํานวน 4 ตัว
- Magnetic Contactor | จํานวน 1 ตัว
- เราเตอรแบบใส SIM | จํานวน 1 เราเตอร
- ตูขนาด 6.5x12.5x16 นิ้ว | จํานวน 1 ตู
- Pressure Switch | จํานวน 1 ตัว

### 1.4.2 เครื่องมือทางดานซอฟแวร ประกอบดวย - โปรแกรมภาษา C สําหรับบอรด โปรแกรม Arduino สําหรับใชในกระบวนการ คอมไพลเลอรภาษาซี - แฟลตฟอรมแอพพลิเคชั่น Blynk - แฟลตฟอรมแอพพลิเคชั่น Line

4

4

## บทที่ 2 ทฤษฎีและงานวิจัยที่เกี่ยวของ

### ในบทนี้กลาวถึงทฤษฎีและงานวิจัยที่เกี่ยวของในการสรางระบบอัตโนมัติแบบออนไลนสําหรับ การควบคุมการใหน้ําสวนสละ กรณีศึกษาสวนสละชุมชนบานในยาง ตําบลรมเมือง อําเภอเมือง จังหวัด พัทลุง เนื่องจากการสรางจะตองมีองคประกอบหลายๆสวนประกอบดวยกันจึงจําเปนตองมีการศึกษาถึง

ทฤษฎีและงานวิจัยที่เกี่ยวของเพื่อใหทราบถึงเงื่อนไขตางๆ และการทํางานของอุปกรณที่นํามาใชในการ

ออกแบบและสรางระบบอัตโนมัติแบบออนไลนสําหรับการควบคุมการใหน้ําสวนสละ โดยมีทฤษฎีและ งานวิจัยที่เกี่ยวของ มีดังนี้ 1. ทฤษฎีเกี่ยวกับสวนสละ 2. ทฤษฎีเกี่ยวกับเซ็นเซอรวัดความชื่นในดิน ( Soil Moisture Sensor ) 3. ทฤษฎีเกี่ยวกับ Keypad 4x4 4. ทฤษฎีเกี่ยวกับเซ็นเซอรวัดการไหลของน้ํา ( Flow Switch ) 5. ทฤษฎีเกี่ยวกับบอรดไมโครคอนโทรลเลอร Arduino Mega 2560 6. บอรด Ethernet Shield W5100 7. ทฤษฎีของ Node MCU 8. ทฤษฎีเกี่ยวกับบอรด Relay 12 VDC 220 VAC 5 ชองสัญญาณ 9. ทฤษฎีเกี่ยวกับโซลินอยดวาลว 10. ทฤษฎีเกี่ยวกับ Magnetic Contactor 11. ทฤษฎีเกี่ยวกับจอแสดงผล LED 12. ทฤษฎีเกี่ยวกับปมน้ํา 13. ทฤษฎีโปรแกรมภาษา C สําหรับ Arduino 14. ทฤษฎีเกี่ยวกับ Blynk Platform 15. ทฤษฎีเกี่ยวกับ แอพพลิเคชั่นไลน 16. งานวิจัยที่เกี่ยวของ

### 2.1 ทฤษฎีเกี่ยวกับสวนสละ สละพันธุสุมาลี เปนผลไมที่นาสนใจเปนอยางมาก เมื่อเปรียบเทียบกับผลไมชนิดอื่นๆ เชน ทุเรียน

เงาะ มังคดุ เปนตน เพราะยังมีการปลูกนอย และในปจจุบันมีผูบริโภคผลสละเพิ่มมากขึ้น เรื่องของรสชาติ มีความอรอย ถูกปากคนไทย สละพันธุสุมาลีเปนพืชที่ชอบน้ํา ชอบความชื้น เหมาะกับสภาพดินที่มีน้ํา

5

5

เพียงพอตอความตองการของตนสละ ดอกและผลจะออกที่โคนตนอยูกับพื้นดิน ทําใหทํางานไดสะดวก ใช คนเก็บผลผลิตแคไมกี่คนก็สามารถทําได ในสวนของเรื่องโรคและแมลงในสละมีนอยหากดูแลหมั่นเอาใจ ใส เม่อืสละติดผลก็จะทําใหพบเจอนอย หรือหากพบเจอก็สามารปองกันไดทันเวลา วิธีการปลูก จะเวนระยะหางระหวางแถวประมาณ 10 ศอก โดยปลูกแบบกอไวกอละ 2-3 ตน ขุด หลุมปลูกใหมิดถุงตนกลาที่นํามาปลูกพอดี แลวนําดินกลบตนกลาที่ปลูกใหอยูระดับเดียวกับผิวดิน การพรางแสง สละตองมีรมเงาพรางแสงประมาน 50 เปอรเซ็นตของแสงปกติ อาจทําโดยการ ปลูกไมโตเร็ว หรือไมยืนตน ที่เหมาะสมควรปลูกมากกวา 1 ชนิดหรืออาจใชตาขายพลาสติกพรางแสงขึง คลุม การดูแลรักษา ใหปุย ใหน้ํา ตามที่กลาวขางตนวาตนสละเปนพืชชอบน้ํา ดังนั้นดินตองมีความชื่น อยูเสมอทําใหตนสละเจริญเติบโตไดดีและไมหยุดชะงัก โดยเฉพาะในฤดูหนาว และ ฤดูรอน ตองใหน้ํามาก

พอเพราะดินจะแหงเร็วจําเปนตองใหน้ําทุกวัน ครั้งละครึ่งชั่วโมง และจะใหน้ําขึ้นอยูกับความชื่นภายใน

สวนรวมถึงสภาพอากาศในแตละฤดู การใสปุยบํารุงตนสละ จะใหเดือนละ 1 ครั้ง เพื่อใหสละภายในสวนมีสารอาหารท่ีเพียงพอตอ การเจริญเติบโตเพื่อใหดอกสละมีความแข็งแรงตอการผสมพันธุ โรคและแมลง ที่พบในสวนสละสวนใหญเปนหนอน มอด และมด วิธีกําจัดจะใชวิธีเมื่อเจอตัว แมลงพวกนี้จะจับออกจากพื้นที่ทันที หรือฉีดยาปองกัน ในสวนของสละพันธุสุมาลีไมพบเจอโรคมากนัก เพราะเปนพันธุที่ตานทานโรคอยูแลว จึงไมคอยพบปญหาในเรื่องนี้ การตัดแตงทางใบ สละที่ใหผลผลิตแลวควรไวทางใบประมาณ 15-20 ทางใบ ไมควรตัดแตงทาง ใบที่รองรับทะลายผลจนกวาจะเก็บเกี่ยวผลผลิตแลว การผสมเกสร เนื่องจากสละเปนพืชที่ตนตัวผู เละตัวเมียแยกกัน การปลอยธรรมชาติจะผสมติด ไมเกิน 10 เปอรเซ็นตจึงจําเปนตองชวยผสมเกสรตัวเมีย

2.2 เซ็นเซอรวัดความชื้นในดิน ( Soil Moisture Sensor ) เซ็นเซอรวัดคาความชื่นในดิน Soil Moisture Sensor ใชวัดความชื้นในดิน หรือใชเปนเซ็นเซอร น้ํา สามารถตอใชงานกับไมโครคอนโทรลเลอรโดยใชอนาล็อกอินพุตอานคาความชื้นหรือเลือกใชสัญญาณ ดิจิตอลที่สงมาจากโมดูล สามารถปรับคาความไวไดดวยการปรับคาความตานที่ตัวโมดูล แสดงไดดังรูปที่

2.1

6

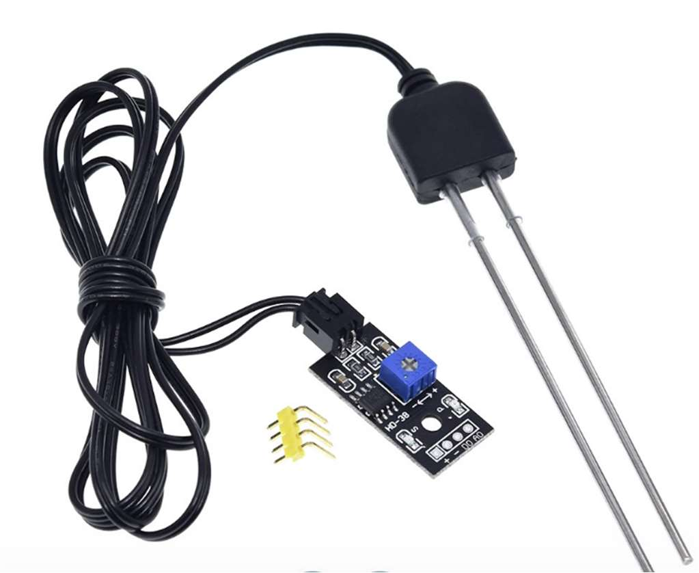
[picture p142: figure]

6

### รูปที่ 2.1 เซ็นเซอรวัดความชื่นในดิน Soil Moisture Sensor แหลงที่มา : https://www.analogread.com/product/4594/soil-moisture-sensor

จากรูปที่ 2.1 แสดงการใชงาน Sensor 1. ขาไฟเลี้ยง (+5V) สําหรับตอไฟเลี้ยงแรงดัน +5V 2. ขา Echo Pulse Output (ECHO) เปนขาเอาตพุตสําหรับสงสัญญาณพัลสออก ซึ่งการใชงาน จะนําขานี้ไปตอเขากับพอรตอินพุตของไมโครคอนโทรลเลอรเพื่อตรวจจับความกวางของสัญญาณพัลสท่ี สงออกมาเพื่อแปลความหมายออกมาเปนระยะทางอีกครั้งหนึ่ง 3. ขา Trigger Pulse Input (TRIGER) เปนขาอินพุตรับสัญญาณพัลสท่ีมีความกวางนอยกวา 10

ไมโครวินาทีเพื่อกระตุนการสรางสัญญาอัลตราโซนิค ความถี่ 40 kHz ออกสูอากาศจากตัวสง ดังนั้นเมื่อ คลื่นความถี่ดังกลาวนี้เคลื่อนที่ไปกระทบสิ่งกีดขวางท่ีอยูเบื่องหนาก็จะเกิดการสะทอนกลับเขามายังตัวรับ

### และถูกแปลงออกมาเปนความกวางของสัญญาณพัลสท่จีะสงออกไปทาง ขา Echo Pulse Output 4. ขา GND สําหรับตอกราวด สําหรับการเขียนโปรแกรมในการอานคา ความชื่นในดินจาก Sensor แสดงไดดังรูปท่ี2.2

7

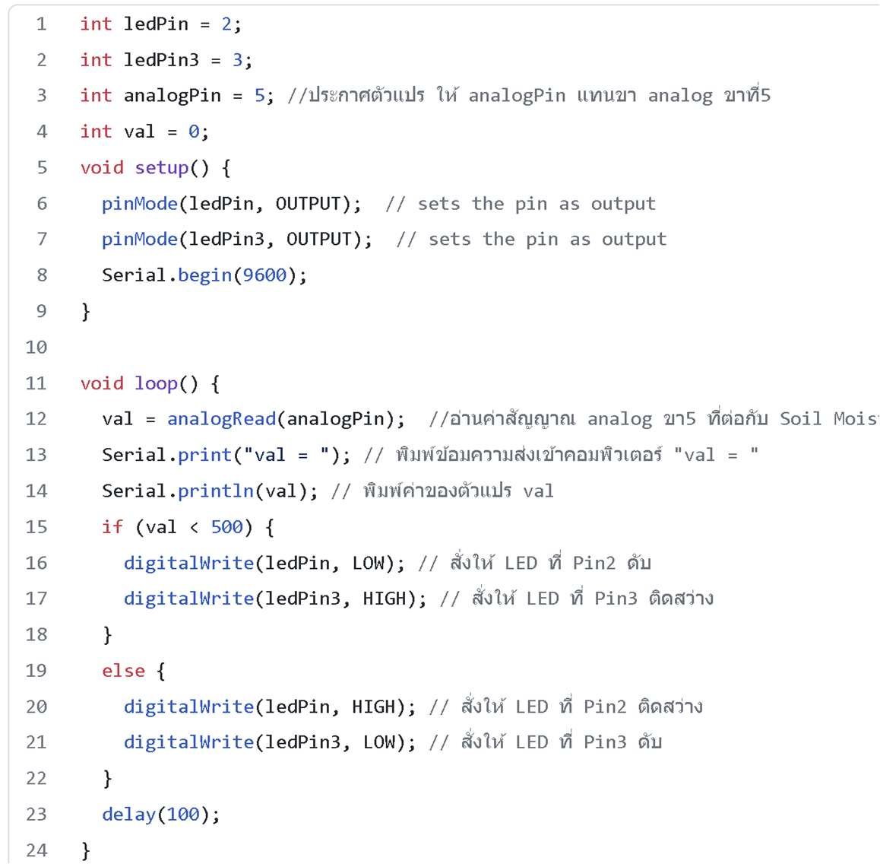
[picture p143: figure]

7

### รูปที่ 2.2 ตัวอยาง Code สําหรับอานคาความชื้นในดินจาก Sensor แหลงที่มา : https://www. cybertice.com/article/208/สอนใชงาน-arduino-เซ็นเซอรวัดความชื้นใน ดิน-soil-moisture-sensor-module

### 2.3 Keypad 4x4 แปนปุมกดหรือ Keypad เปนอุปกรณสําหรับอินพุตจากเจาหนาที่ มีลักษณะเปนปุมกดหลาย ปุม ถูกจัดเรียงกันในลักษณะเปนอารเรย แบงเปนแถวแนวนอน (Rows) และแถวแนวตั้ง (Columns)

เชน 3 x 4 (12 ปุม) หรือ 4 x 4 (16 ปุม) เปนตน แตละปุมก็จะมีสัญลักษณเขียนกํากับไว เชน ตัวเลข 0

### ถึง 9 เครื่องหมาย # เครื่องหมาย * เปนตน โดยปกติถาตอปุมกดแยกจํานวน 16 ตัว จะตองใช ขาสัญญาณทั้งหมด 16 ขา แตถาใชการจัดเรียงแบบ 4x4 จะใชขาสัญญาณเพียง 8 ขา แตตองมีการ ตรวจดูวา ปุมกดใดถูกกดบางในขณะนั้น วิธีการนี้เรียกวา การสแกนปุมกด (key scan) สําหรับลักษณะ แปนปุมกด แบบ 4x4 ปุม แสดงไดดังรูปที่ 2.3

8

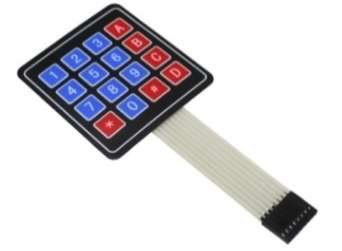
[picture p144: figure]
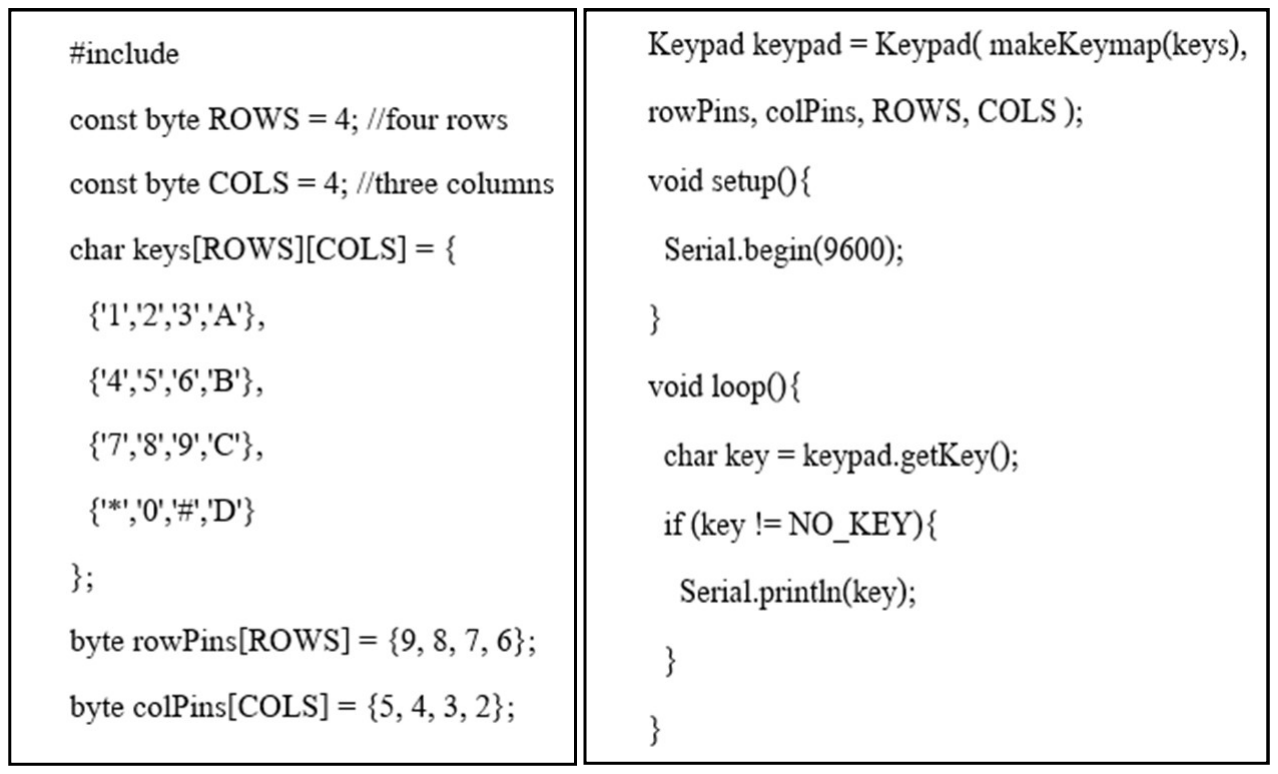
[picture p145: figure]

8

### รูปที่ 2.3 แปนปุมกดแบบ 4 x 4 แหลงที่มา : http://www.arduino.in.th/product/19/4x4-matrix-keypad

จากรูปที่ 2.3 แสดงลักษณะแปนปุมกด แบบ 4x4 ปุมมีสายเชื่อมตอคอนเนกเตอรจํานวน 8 ขา แบบตัวเมีย (Female) ถาตองการเสียบขาลงบนเบรดบอรด ก็สามารถใช Pin Header ตัวผู เปนตัว เชื่อมตอได ขาทั้ง 8 นั้น ถามองจากดานหนา (Front View) และนับจากซายไปขวา จะเปนขาหมายเลข 1-8 ตามลําดับ โดยที่ขา 1 ถึง 4 จะเปนขาสําหรับแถวนอน (Rows) ขา 5 ถึง 8 จะเปนขาแนวตั้ง (Columns) สําหรับการเขียนโปรแกรมรับคา Keypad แสดงไดดังรูปท่ี2.4

### รูปที่ 2.4 ตัวอยาง Code สําหรับการเขียนโปรแกรมรับคา Keypad 4x4 แหลงที่มา : http://www.arduino.in.th/product/19/4x4-matrix-keypad

บทที่1
บทน ำ

### 1.1 ควำมเป็นมำและควำมส ำคัญ

สละเป็นผลไม้ที่มีประโยชน์เนื่องด้วยในผลสละมีสารต้านอนุมูลอิสละเป็นจ านวนมาก ได้แก่สารฟี โนลิค สารฟลาโวนอยด์ ซึ่งเป็นสารต้านอนุมูลอิสระที่ทรงประสิทธิภาพ ช่วยป้องกันโรคต่าง ๆ ได้เป็น อย่างดี ได้แก่โรคมะเร็ง โรคหัวใจขาดเลือด ป้องกันการถูกท าลายของเซลล์จากสารอนุมูลอิสระ รวมทั้ง ชะลอการเกิดริ้วรอยก่อนวัย สละจึงเป็นที่นิยมรับประทาน และส่งผลให้ราคาของสละค่อนข้างสูงต่อเนื่อง และตลอดปี ด้วยราคาที่ค่อนข้างสูงและสามารถเก็บเกี่ยวได้ตลอดปี สละจึงเป็นที่นิยมในการเพาะปลูก ของเกษตรกร
สวนสละชุมชนบ้านในยาง ต.ร่มเมือง อ.เมือง จ.พัทลุง เป็นสวนสละที่สร้างรายได้ให้แก่ทางชุมชน โดยเมื่อท าการเก็บเกี่ยวเพื่อจ าหน่ายจะมีแม่ค้ามารับซื้อผลผลิตถึงสวนโดยมีราคาขายที่หน้าสวนกิโลกรัม ละประมาณ 50 ถึง 60 บาท ในบางครั้งด้วยความนิยมรับประทานของผู้บริโภคจะมีการสั่งจองเพื่อให้ทาง สวนท าการจัดส่งผ่านขนส่งเอกชนซึ่งจะขายในราคาขายปลีกกิโลกรัมละประมาณ 70 ถึง 80 บาทไม่ร่วม ค่าจัดส่ง ด้วยราคาขายดังกล่าวจะเห็นได้ว่าการปลูกสละท าให้เกษตรกรมีรายได้ที่มั่นคงและตลอดปี แต่ ทั้งนี้จากการส ารวจของทีมงานวิจัยพบว่าการปลูกสละเพื่อการจ าหน่ายที่จะให้ได้ผลสละที่มีประสิทธิภาพ ไม่มีโรค ไม่มีหนอนชอนไช และรสชาติที่อร่อยนั้น การปลูกสละจะต้องดูแลการเพาะปลูกอย่างดี มีปัจจัย หลายอย่างที่ต้องควบคุมดูแลเอาใจใส่ ได้แก่ การผสมดอกที่มีช่วงผสมระยะเวลาเก็บเกี่ยวที่ต้องได้ระยะ เก็บเกี่ยวที่ไม่มากไม่น้อยกว่าที่ก าหนดซึ่งโดยประมาณจะอยู่ที่ 7 เดือนครึ่งหลังท าการผสมดอก การให้ปุ๋ย การป้องกันแมลง การเก็บเกี่ยว และที่ส าคัญคือการให้น้ าที่ต้องสม่ าเสมอไม่มากไม่น้อยเกินไป จาก รายละเอียดข้างต้นจะเห็นว่าแม้ผลสละจะมีราคาค่อนข้างสูงและเก็บเกี่ยวได้ตลอดปี แต่ก็ต้องแลกกับการ เอาใจใส่ดูแลรักษาที่ต้องค่อนข้างรัดกุม เกษตรกรต้องมีเวลาเอาใจใส่เป็นอย่างมากโดยเฉพาะการรดน้ าใน แปลงสวนสละที่ต้องรดน้ าให้ได้ปริมาณน้ าที่พอดีไม่มากหรือน้อยเกินไป ซึ่งจะมีผลต่อรสชาติและการ เจริญเติบโตของล าต้น ดังนั้นในการเพาะปลูกสละของชาวเกษตรกรพบว่าปัจจัยหลักที่มีผลต่อการ เจริญเติบโตและรสชาติของสละคือการให้น้ าที่ต้องมีการบริหารจัดการที่ดีเพื่อก่อให้เกิดการประหยัดเพื่อ ลดต้นทุนก่อให้เกิดรายได้มากขึ้น ทั้งการประหยัดพลังงานไฟฟ้า ประหยัดเวลา รวมถึงการป้องกันความ เสียหายของอุปกรณ์ที่ใช้ในการรดน้ าภายในสวนสละได้แก่ ปั๊มน้ า ที่จะสามารถช ารุดได้ทันที (ปั๊มน้ า มอเตอร์ไหม้) จากการที่ปั๊มดูดน้ าในบ่อไม่ขึ้นด้วยเหตุผลนานัปการ ซึ่งสิ่งต่าง ๆ เหล่านี้ล้วนเป็นค่าใช้จ่ายที่ มีผลต่อรายได้ของเกษตรกรทั้งสิ้น
จากประเด็นปัญหาของการบริหารจัดการน้ าภายในสวนสละที่ต้องการปริมาณน้ าที่ต้องพอดิบ พอดีไม่มากไม่น้อยจนเกินไป รวมถึงความต้องการให้เกษตรกรมีเวลาเพื่อการดูแลปัจจัยอื่นที่มีผลต่อ

คุณภาพของผลสละและที่ส าคัญเพื่อเป็นการป้องกันการช ารุดของปั๊มน้ าที่มีราคาค่อนข้างแพง ทางผู้วิจัย จึงได้มีแนวคิดที่จะสร้าง ระบบอัตโนมัติแบบออนไลน์ส าหรับการควบคุมการให้น้ าสวนสละ โดยระบบ สามารถท างานได้หลายรูปแบบได้แก่ การท างานแบบอัตโนมัติตามความชื้นที่มีภายในดินจากการวัดด้วย เซนเซอร์วัดความชื้นในดิน การท างานตามเวลาที่ได้ก าหนดไว้ล่วงหน้าและแปรผันตามความชื้นในดิน ระบบยังมีการท างานที่เป็นแบบออนไลน์ที่สามารถควบคุมสั่งการด้วยโทรศัพท์มือถือแบบสมาร์ทโฟน เพื่อ เพิ่มความสะดวกในการควบคุมระบบให้กับเกษตรกรและยังสามารถควบคุมมแบบออนไซต์ได้ด้วย ระบบ ที่ผู้วิจัยคิดค้นนี้ยังมีระบบป้องกันความเสียหายของปั๊มน้ า ป้องกันควาเสียหายของระบบท่อที่เกิดจาก แรงดันน้ าในระบบท่อมากเกินไป โดยระบบจะหยุดการท างานของปั๊มน้ าทันทีเมื่อตรวจจับความผิดปกติใน กรณีต่าง ๆ ได้ ทั้งนี้เพื่อเป็นการประหยัดค่าซ่อมแซมที่เกิดจากความเสียหายของอุปกรณ์ให้กับเกษตรกร และที่ส าคัญในส่วนของอัลกอริทึมของการให้น้ าส าหรับการสลับแถวของการให้น้ าในแต่ละแถวผู้วิจัยจะใช้ แนวคิดในการให้น้ าแบบค่อยเป็นค่อยไปเมื่อถึงเวลาเปลี่ยนแถวการให้น้ าจะเปิดการให้น้ าแบบ 2 แถว พร้อมกันก่อนสักระยะแล้วค่อยปิดแถวเดิมที่ได้ท าการลดน้ าไปแล้ว ทั้งนี้เพื่อเป็นการป้องกันแรงดันใน ระบบท่อน้ ามากเกินไปในช่วงระหว่างการเปลี่ยนแถวการให้น้ า

### 1.2 วัตถุประสงค์ของกำรวิจัย

1.2.1 เพื่อศึกษาและพัฒนาระบบอัตโนมัติส าหรับการควบคุมการให้น้ าในสวนสละที่ออนไลน์โดย ใช้เทคโนโลยีอินเตอร์เน็ตในทุกสิ่ง
1.2.2 เพื่อเปรียบเทียบประสิทธิภาพของการให้น้ าในสวนสละในรูปแบบเดิมเทียบกับการใช้ระบบ อัตโนมัติที่ผู้วิจัยพัฒนาขึ้น

### 1.3 ประโยชน์ที่คำดว่ำจะได้รับจำกงำนวิจัย

1.3.1 ได้ระบบอัตโนมัติส าหรับการควบคุมการให้น้ าสวนสละ ให้แก่ชุมชนบ้านในยาง ต าบลร่ม เมือง อ าเภอเมือง จังหวัดพัทลุง
1.3.2 ได้นวัตกรรมที่ช่วยให้เกษตรกรมีความสะดวกได้ใช้เทคโนโลยีอย่างคุ้มค่า
1.3.3 เป็นการสนับสนุนให้เกษตรกรในพื้นที่ใกล้เคียงได้เห็นคุณค่าของการน าเทคโนโลยีมาใช้ใน การเกษตร
1.3.4 ช่วยเพิ่มผลผลิตของสวนสละให้มีผลผลิตมากขึ้น
1.3.5 ช่วยให้เกษตรกรชุมชนบ้านในยางมีรายได้เพิ่มขึ้น
1.3.6 ลดการสูญเสียของอุปกรณ์ที่ใช้ในการเกษตร

### 1.4 เครื่องมืออุปกรณ์และซอฟต์แวร์ที่ใช้ในกำรพัฒนำ

1.4.1 เครื่องมือทางด้านฮาร์ดแวร์ ประกอบด้วย
- เซ็นเซอร์วัดความชื้นในดิน | จ านวน 4 โมดูล
- keypad 4x4 | จ านวน 1 แผง
- Flow Switch | จ านวน 1 ตัว
- บอร์ด Arduino รุ่น 2560 | จ านวน 1 บอร์ด
- บอร์ด Ethernet Shield W5 100 จ านวน 1 บอร์ด
- Node MCU | จ านวน 1 บอร์ด
- จอแสดงผล LCD 20x4 | จ านวน 1 โมดูล
- Relay Module 5 Channel | จ านวน 1 โมดูล
- โซลินอยด์วาล์ว | จ านวน 4 ตัว
- Magnetic Contactor | จ านวน 1 ตัว
- เราเตอร์แบบใส่ SIM | จ านวน 1 เราเตอร์
- ตู้ขนาด 6.5x12.5x16 นิ้ว | จ านวน 1 ตู้
- Pressure Switch | จ านวน 1 ตัว
1.4.2 เครื่องมือทางด้านซอฟแวร์ ประกอบด้วย
- โปรแกรมภาษา C ส าหรับบอร์ด โปรแกรม Arduino ส าหรับใช้ในกระบวนการ คอมไพล์เลอร์ภาษาซี
- แฟลตฟอร์มแอพพลิเคชั่น Blynk
- แฟลตฟอร์มแอพพลิเคชั่น Line

บทที่ 2
ทฤษฎีและงำนวิจัยที่เกี่ยวข้อง

ในบทนี้กล่าวถึงทฤษฎีและงานวิจัยที่เกี่ยวข้องในการสร้างระบบอัตโนมัติแบบออนไลน์ส าหรับ การควบคุมการให้น้ าสวนสละ กรณีศึกษาสวนสละชุมชนบ้านในยาง ต าบลร่มเมือง อ าเภอเมือง จังหวัด พัทลุง เนื่องจากการสร้างจะต้องมีองค์ประกอบหลายๆส่วนประกอบด้วยกันจึงจ าเป็นต้องมีการศึกษาถึง ทฤษฎีและงานวิจัยที่เกี่ยวข้องเพื่อให้ทราบถึงเงื่อนไขต่างๆ และการท างานของอุปกรณ์ที่น ามาใช้ในการ ออกแบบและสร้างระบบอัตโนมัติแบบออนไลน์ส าหรับการควบคุมการให้น้ าสวนสละ โดยมีทฤษฎีและ งานวิจัยที่เกี่ยวข้อง มีดังนี้
1. ทฤษฎีเกี่ยวกับสวนสละ
2. ทฤษฎีเกี่ยวกับเซ็นเซอร์วัดความชื่นในดิน ( Soil Moisture Sensor )
3. ทฤษฎีเกี่ยวกับ Keypad 4x4
4. ทฤษฎีเกี่ยวกับเซ็นเซอร์วัดการไหลของน้ า ( Flow Switch )
5. ทฤษฎีเกี่ยวกับบอร์ดไมโครคอนโทรลเลอร์ Arduino Mega 2560
6. บอร์ด Ethernet Shield W5100
7. ทฤษฎีของ Node MCU
8. ทฤษฎีเกี่ยวกับบอร์ด Relay 12 VDC 220 VAC 5 ช่องสัญญาณ
9. ทฤษฎีเกี่ยวกับโซลินอย์ด์วาล์ว
10. ทฤษฎีเกี่ยวกับ Magnetic Contactor
11. ทฤษฎีเกี่ยวกับจอแสดงผล LED
12. ทฤษฎีเกี่ยวกับปั๊มน้ า
13. ทฤษฎีโปรแกรมภาษา C ส าหรับ Arduino
14. ทฤษฎีเกี่ยวกับ Blynk Platform
15. ทฤษฎีเกี่ยวกับ แอพพลิเคชั่นไลน์
16. งานวิจัยที่เกี่ยวข้อง

### 2.1 ทฤษฎีเกี่ยวกับสวนสละ

สละพันธุ์สุมาลี เป็นผลไม้ที่น่าสนใจเป็นอย่างมาก เมื่อเปรียบเทียบกับผลไม้ชนิดอื่นๆ เช่น ทุเรียน เงาะ มังคุด เป็นต้น เพราะยังมีการปลูกน้อย และในปัจจุบันมีผู้บริโภคผลสละเพิ่มมากขึ้น เรื่องของรสชาติ มีความอร่อย ถูกปากคนไทย สละพันธุ์สุมาลีเป็นพืชที่ชอบน้ า ชอบความชื้น เหมาะกับสภาพดินที่มีน้ า

เพียงพอต่อความต้องการของต้นสละ ดอกและผลจะออกที่โคนต้นอยู่กับพื้นดิน ท าให้ท างานได้สะดวก ใช้ คนเก็บผลผลิตแค่ไม่กี่คนก็สามารถท าได้ ในส่วนของเรื่องโรคและแมลงในสละมีน้อยหากดูแลหมั่นเอาใจ ใส่ เมื่อสละติดผลก็จะท าให้พบเจอน้อย หรือหากพบเจอก็สามารป้องกันได้ทันเวลา
วิธีการปลูก จะเว้นระยะห่างระหว่างแถวประมาณ 10 ศอก โดยปลูกแบบกอไว้กอละ 2-3 ต้น ขุด หลุมปลูกให้มิดถุงต้นกล้าที่น ามาปลูกพอดี แล้วน าดินกลบต้นกล้าที่ปลูกให้อยู่ระดับเดียวกับผิวดิน การพรางแสง สละต้องมีร่มเงาพรางแสงประมาน 50 เปอร์เซ็นต์ของแสงปกติ อาจท าโดยการ ปลูกไม้โตเร็ว หรือไม้ยืนต้น ที่เหมาะสมควรปลูกมากกว่า 1 ชนิดหรืออาจใช้ตาข่ายพลาสติกพรางแสงขึง คลุม
การดูแลรักษา ให้ปุ๋ย ให้น้ า ตามที่กล่าวข้างต้นว่าต้นสละเป็นพืชชอบน้ า ดังนั้นดินต้องมีความชื่น อยู่เสมอท าให้ต้นสละเจริญเติบโตได้ดีและไม่หยุดชะงัก โดยเฉพาะในฤดูหนาว และ ฤดูร้อน ต้องให้น้ ามาก พอเพราะดินจะแห้งเร็วจ าเป็นต้องให้น้ าทุกวัน ครั้งละครึ่งชั่วโมง และจะให้น้ าขึ้นอยู่กับความชื่นภายใน สวนรวมถึงสภาพอากาศในแต่ละฤดู
การใสปุ๋ยบ ารุงต้นสละ จะให้เดือนละ 1 ครั้ง เพื่อให้สละภายในสวนมีสารอาหารที่เพียงพอต่อ การเจริญเติบโตเพื่อให้ดอกสละมีความแข็งแรงต่อการผสมพันธุ์
โรคและแมลง ที่พบในสวนสละส่วนใหญ่เป็นหนอน มอด และมด วิธีก าจัดจะใช้วิธีเมื่อเจอตัว แมลงพวกนี้จะจับออกจากพื้นที่ทันที หรือฉีดยาป้องกัน ในส่วนของสละพันธุ์สุมาลีไม่พบเจอโรคมากนัก เพราะเป็นพันธุ์ที่ต้านทานโรคอยู่แล้ว จึงไม่ค่อยพบปัญหาในเรื่องนี้
การตัดแต่งทางใบ สละที่ให้ผลผลิตแล้วควรไว้ทางใบประมาณ 15-20 ทางใบ ไม่ควรตัดแต่งทาง ใบที่รองรับทะลายผลจนกว่าจะเก็บเกี่ยวผลผลิตแล้ว
การผสมเกสร เนื่องจากสละเป็นพืชที่ต้นตัวผู้ เละตัวเมียแยกกัน การปล่อยธรรมชาติจะผสมติด ไม่เกิน 10 เปอร์เซ็นต์จึงจ าเป็นต้องช่วยผสมเกสรตัวเมีย

### 2.2 เซ็นเซอร์วัดควำมชื้นในดิน ( Soil Moisture Sensor )

เซ็นเซอร์วัดค่าความชื่นในดิน Soil Moisture Sensor ใช้วัดความชื้นในดิน หรือใช้เป็นเซ็นเซอร์ น้ า สามารถต่อใช้งานกับไมโครคอนโทรลเลอร์โดยใช้อนาล็อกอินพุตอ่านค่าความชื้นหรือเลือกใช้สัญญาณ ดิจิตอลที่ส่งมาจากโมดูล สามารถปรับค่าความไวได้ด้วยการปรับค่าความต้านที่ตัวโมดูล แสดงได้ดังรูปที่ 2.1

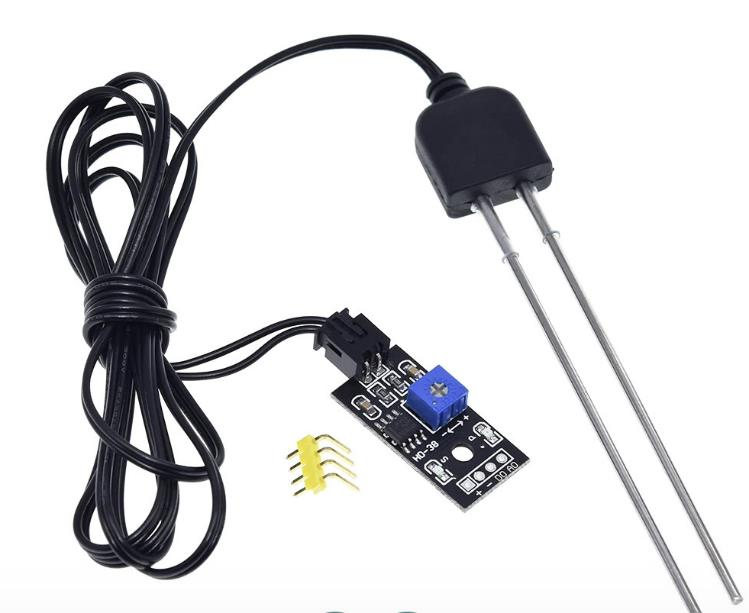
[picture p146: figure]

รูปที่ 2.1 เซ็นเซอร์วัดความชื่นในดิน Soil Moisture Sensor แหล่งที่มา : https://www.analogread.com/product/4594/soil-moisture-sensor

จากรูปที่ 2.1 แสดงการใช้งาน Sensor
1. ขาไฟเลี้ยง (+5V) ส าหรับต่อไฟเลี้ยงแรงดัน +5V
2. ขา Echo Pulse Output (ECHO) เป็นขาเอาต์พุตส าหรับส่งสัญญาณพัลส์ออก ซึ่งการใช้งาน จะน าขานี้ไปต่อเข้ากับพอร์ตอินพุตของไมโครคอนโทรลเลอร์เพื่อตรวจจับความกว้างของสัญญาณพัลส์ที่ ส่งออกมาเพื่อแปลความหมายออกมาเป็นระยะทางอีกครั้งหนึ่ง
3. ขา Trigger Pulse Input (TRIGER) เป็นขาอินพุตรับสัญญาณพัลส์ที่มีความกว้างน้อยกว่า 10 ไมโครวินาทีเพื่อกระตุ้นการสร้างสัญญาอัลตราโซนิค ความถี่ 40 kHz ออกสู่อากาศจากตัวส่ง ดังนั้นเมื่อ คลื่นความถี่ดังกล่าวนี้เคลื่อนที่ไปกระทบสิ่งกีดขวางที่อยู่เบื่องหน้าก็จะเกิดการสะท้อนกลับเข้ามายังตัวรับ และถูกแปลงออกมาเป็นความกว้างของสัญญาณพัลส์ที่จะส่งออกไปทาง ขา Echo Pulse Output
4. ขา GND ส าหรับต่อกราวด์
ส าหรับการเขียนโปรแกรมในการอ่านค่าความชื่นในดินจาก Sensor แสดงได้ดังรูปที่ 2.2

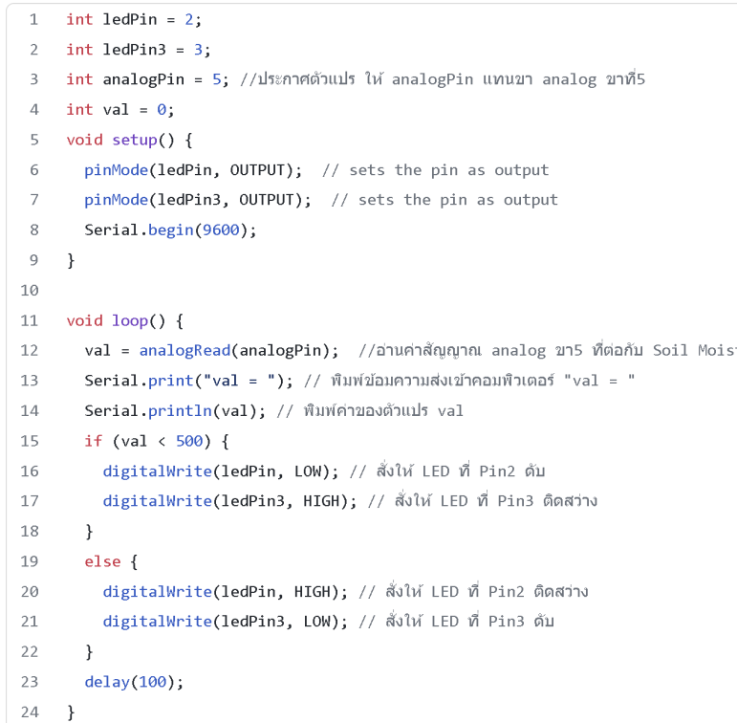
[picture p147: figure]

รูปที่ 2.2 ตัวอย่าง Code ส าหรับอ่านค่าความชื้นในดินจาก Sensor แหล่งที่มา : https://www.cybertice.com/article/208/สอนใช้งาน-arduino-เซ็นเซอร์วัดความชื้นใน ดิน-soil-moisture-sensor-module

### 2.3 Keypad 4x4

แป้นปุ่มกดหรือ Keypad เป็นอุปกรณ์ส าหรับอินพุตจากเจ้าหน้าที่ มีลักษณะเป็นปุ่มกดหลาย ปุ่ม ถูกจัดเรียงกันในลักษณะเป็นอาร์เรย์ แบ่งเป็นแถวแนวนอน (Rows)และแถวแนวตั้ง (Columns) เช่น 3 x 4 (12 ปุ่ม) หรือ 4 x 4 (16 ปุ่ม) เป็นต้น แต่ละปุ่มก็จะมีสัญลักษณ์เขียนก ากับไว้ เช่น ตัวเลข 0 ถึง 9 เครื่องหมาย # เครื่องหมาย * เป็นต้น โดยปกติถ้าต่อปุ่มกดแยกจ านวน 16 ตัว จะต้องใช้ ขาสัญญาณทั้งหมด 16 ขา แต่ถ้าใช้การจัดเรียงแบบ 4x4 จะใช้ขาสัญญาณเพียง 8 ขา แต่ต้องมีการ ตรวจดูว่า ปุ่มกดใดถูกกดบ้างในขณะนั้น วิธีการนี้เรียกว่า การสแกนปุ่มกด (keyscan) ส าหรับลักษณะ แป้นปุ่มกด แบบ 4x4 ปุ่ม แสดงได้ดังรูปที่ 2.3

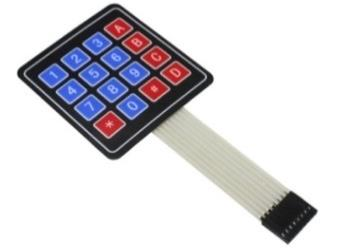
[picture p148: figure]

รูปที่ 2.3 แป้นปุ่มกดแบบ 4 x 4

แหล่งที่มา : http://www.arduino.in.th/product/19/4x4-matrix-keypad

จากรูปที่ 2.3 แสดงลักษณะแป้นปุ่มกด แบบ 4x4 ปุ่มมีสายเชื่อมต่อคอนเนกเตอร์จ านวน 8 ขา แบบตัวเมีย (Female) ถ้าต้องการเสียบขาลงบนเบรดบอร์ด ก็สามารถใช้Pin Header ตัวผู้ เป็นตัว เชื่อมต่อได้ ขาทั้ง 8 นั้น ถ้ามองจากด้านหน้า (FrontView) และนับจากซ้ายไปขวา จะเป็นขาหมายเลข 1-8 ตามล าดับ โดยที่ขา 1 ถึง 4 จะเป็นขาส าหรับแถวนอน (Rows) ขา 5 ถึง 8 จะเป็นขาแนวตั้ง (Columns)
ส าหรับการเขียนโปรแกรมรับค่า Keypad แสดงได้ดังรูปที่ 2.4

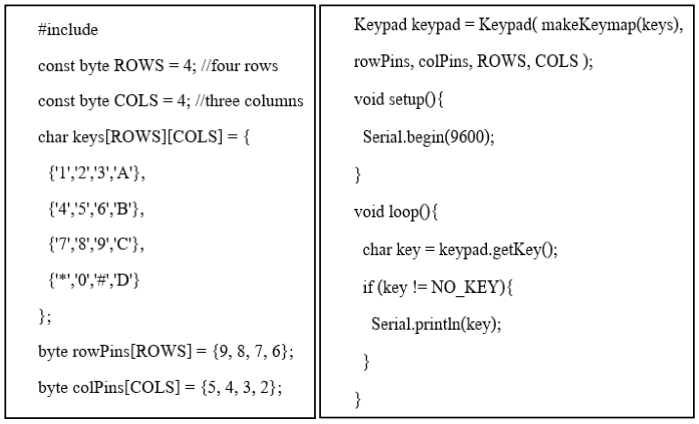
[picture p149: figure]

รูปที่ 2.4 ตัวอย่าง Code ส าหรับการเขียนโปรแกรมรับค่า Keypad 4x4

แหล่งที่มา : http://www.arduino.in.th/product/19/4x4-matrix-keypad

จากรูปที่ 2.4 แสดง Code Keypad โดยมีการ include Library <Keypad.h> และเมื่อใช้งาน ต้องต่อสาย Keypad ตั้งแต่ขา 2-9 ต่อเข้าพอร์ท analog ของบอร์ด Arduino จากนั้นวนรอรับ Key จาก ผู้ใช้

### 2.4 เซ็นเซอร์วัดกำรไหลของน้ ำ (Flow Switch)

เป็นสวิตช์ควบคุมการท างานของอุปกรณ์ไฟฟ้าต่าง ๆ เช่น ปั๊มน้ า โดยอาศัยการไหลของน้ า หรือ ของเหลว มาพัดพาให้ใบพายที่เชื่อมต่อไปยังสวิตช์ เคลื่อนที่ไปตามทิศทางการไหล ซึ่งจะมีผลให้สวิตช์มี การตัดต่อและสั่งจ่ายหรือตัดกระแสไฟฟ้าที่จ่ายไปยังอุปกรณ์ไฟฟ้านั้น ๆ และยังสามารถปรับให้การตัดต่อ สวิตช์เป็นไปตามอัตราการไหลมากน้อย ได้ตามต้องการ และใบพายมีขนาดความยาวหลายขนาดให้ เลือกใช้แสดงได้ดังรูปที่ 2.5

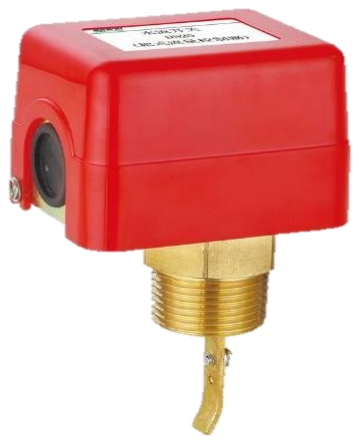
[picture p150: figure]

รูปที่ 2.5 เซ็นเซอร์วัดการไหลของน้ า Flow Switch แหล่งที่มา : https://www.siamhw.com/products_detail/view/6344186

จากรูปที่ 2.5 อุปกรณ์ที่ใช้ส าหรับตรวจจับอัตราการไหลของของไหลในท่อ สวิตช์ควบคุมอัตรา การไหล เป็นอุปกรณ์ป้องกันของปั๊มน้ า ป้องกันความเสียหายที่เกิดจาก ปั๊มน้ าท างานแล้ว แต่ดูดน้ าไม่ขึ้น หรือไม่มีน้ า ก็จะตัดการท างาน

### 2.5 บอร์ด Arduino Mega 2560

Arduino Mega 2560 คือ บอร์ดคอมพิวเตอร์ขนาดเล็กที่สามารถเชื่อมต่อกับจอมอนิเตอร์ คีย์บอร์ดและเมาส์ได้ สามารถน ามาประยุกต์ใช้ในการท าโครงงานทางด้านอิเล็กทรอนิกส์ การเขียน

โปรแกรม หรือเป็นเครื่องคอมพิวเตอร์ตั้งโต๊ะขนาดเล็ก ไม่ว่าจะเป็นการท างาน Spreadsheet Word Processing ท่องอินเทอร์เน็ตส่งอีเมล์ หรือเล่นเกมส์ อีกทั้งยังสามารถเล่นไฟล์วีดีโอความละเอียดสูง Arduino Mega 2560 สามารถเชื่อมรับพลังงานโดยการเชื่อมต่อ Micro USB Connector จาก ภายนอกได้ โดยแหล่งพลังงานจะถูกเลือกโดยอัตโนมัติบอร์ดสามารถท างานได้ในช่วงแรงดัน 6 ถึง 20 โวลต์ถ้าแหล่งจ่ายมีค่าต่ ากว่า 7 โวลต์อาจส่งผลให้ 5 โวลต์มีแรงดันที่ต่ ากว่า 5 โวลต์ และบอร์ดอาจจะ ไม่เสถียร แต่ถ้าหากแรงดันมีค่าสูงกว่า 12 โวลต์อาจส่งผลให้บอร์ด Overheat และอาจท าให้บอร์ด เสียหายได้ ดังนั้นช่วงแรงดันที่เหมาะสมกับบอร์ดคือ 7 โวลต์ถึง 12 โวลต์ แสดงได้ดังรูปที่ 2.6

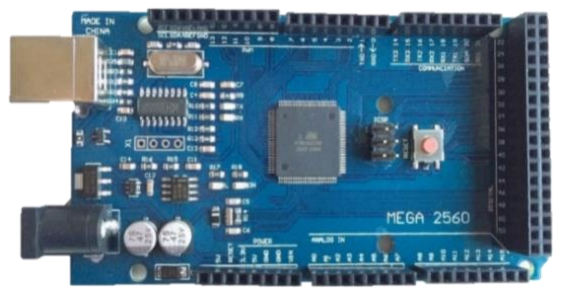
[picture p151: figure]

รูปที่ 2.6 Arduino Mega 2560 แหล่งที่มา : https://www.arduino.in.th/product/558/arduino-mega-2560-r3-แถมสาย-usb

จากรูปที่ 2.6 บอร์ด Arduino Mega 2560 เป็นบอร์ด Arduino ที่ออกแบบมาส าหรับงานที่ต้อง ใช้ I/O มากกว่า Arduino Uno R3 เช่น งานที่ต้องการรับสัญญาณจาก Sensor หรือควบคุมมอเตอร์ Servo หลายๆ ตัว ท าให้ Pin I/O ของบอร์ด Arduino Uno R3 ไม่สามารถรองรับได้ ทั้งนี้บอร์ด Mega 2560 R3 ยังมีความหน่วยความจ าแบบ Flash มากกว่า Arduino Uno R3 ท าให้สามารถเขียนโค้ด โปรแกรมเข้าไปได้มากกว่า ในความเร็วของ MCU ที่เท่ากัน

### 2.6 บอร์ด Ethernet Shield W5100

เป็นบอร์ดไมโครคอนโทรลเลอร์ที่สามารถเชื่อมต่อกับอินเทอร์เน็ตได้ หัวใจหลักของส่วนนี้ คือ ไอซี Ethernet จากบริษัท WIZnet เบอร์ W5100 W5100 จะสื่อสารในระบบเครือข่าย (IP) ได้ทั้งใน รูปแบบของ TCP และ UDP สามารถรองรับการเชื่อมต่อพร้อมกันได้ถึง 4 คอนเน็กชันด้วยกัน โดยใช้ ไลบราลี่ของ Ethernet จากเว็บไซต์ https://www.arduino.cc/en/Reference/Ethernet ซึ่งจะมี ตัวอย่างที่ใช้กับ Ethernet Shield นี้ หลังจากที่มีการเชื่อมต่อ Ethernet Shield กับบอร์ด Arduino แล้ว ท่านยังสามารถใช้ขาที่เป็นรูปแบบพื้นฐานของบอร์ด Arduino เดิมได้ เพราะขาทุกขาของบอร์ด

Arduino จะถูกเชื่อมต่อกับบอร์ด Ethernet Shield ดังนั้นท่านจึงสามารถใช้งานขาของบอร์ด Arduino ได้เช่นเดิม ดังแสดงในรูปที่ 2.7

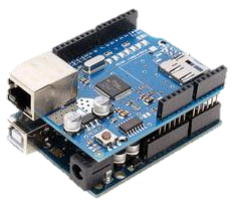
[picture p152: figure]

รูปที่ 2.7 การเชื่อมต่อบอร์ด Ethernet Shield กับบอร์ด Arduino แหล่งที่มา : http://www.arduino.in.th/product/5/ethernet-wiznet-5100micro-sd-card-shield

จากรูปที่ 2.7 บนบอร์ดมีช่องเสียบการ์ด Micro-SD ซึ่งสามารถน ามาใช้ในการจัดเก็บไฟล์ส าหรับ การให้บริการผ่านเครือข่าย บอร์ดถูกออกแบบให้ใช้ได้กับ Arduino/Genuino ทุกบอร์ด การ์ด Micro SD บนบอร์ดสามารถใช้งานได้ด้วยไลบราลี่ SD ที่ตระเตรียมไว้ให้ในตัวอย่าง ซึ่งเมื่อเรียกใช้งาน SD จะใช้ขา 4 ของ Arduino เป็นขา SS บนบอร์ด Shield ได้เพิ่มส่วนการรีเซตเพื่อให้มั่นใจว่าโมดูล W5100Ethernet ถูกรีเซ็ตเมื่อได้รับแรงดัน (power on reset)
Arduino สื่อสารกับ W5100 และการ์ด SD โดยใช้บัส SPI (ผ่านทางพอร์ท ICSP) ซึ่งจะตรงกับ ขาดิจิตอล 10, 11, 12, และ 13 ส าหรับบอร์ด UNO และขา 50, 51, และ 52 ส าหรับบอร์ด MEGA การ เลือกใช้งานระหว่าง Ethernet W5100 กับ การ์ด SD จะใช้ขา 10 ส าหรับเลือก W5100 และขา 4 ส าหรับการ์ด SD ในกรณีบอร์ด MEGA จะไม่สามารถใช้ขา I/O ทั่วไปมาก าหนดให้เป็นขา SS ได้ ซึ่ง จ าเป็นต้องใช้ขาที่มีคุณสมบัติเป็น SS โดยเฉพาะ ซึ่งนั่นก็คือขา 53, ดังนั้นหากใช้บอร์ด MEGA ท่านจะ สามารถเลือกใช้ได้เพียงอย่างใดอย่างหนึ่งระหว่าง W5100 หรือการ์ด SD เนื่องจากการเชื่อมต่อระหว่าง W5100 และการ์ด SD จะใช้บัส SPI เดียวกัน ดังนั้นการสื่อสารจะ ท าได้ทีละอย่าง ถ้าหากโปรแกรมของท่านมีการก าหนดให้ใช้งานทั้งสองอย่างการอ่านสื่อสารจะต้อง สอดคล้องกัน และการเลือกอุปกรณ์จะต้องเป็นไปอย่างชัดเจน ยกตัวอย่างเช่น การเลือกการ์ด SD ขา 4

จะต้องก าหนดให้เป็นเอาต์พุตและสภาวะต้องเป็นลอจิกสูง (High) ในส่วนของ W5100 จะต้องไม่เลือกใช้ งานขา 10 ของ Arduino จะต้องก าหนดเป็นเอาต์พุตและก าหนดเป็นลอจิกต่ า (Low)

### 2.7 บอร์ด Node MCU

Node MCU (โหนดเอ็มซียู) คือ บอร์ดคล้าย Arduino (https://poundxi.com/arduino-%e0%b8%84%e0%b8%b7%e0%b8%ad%e0%b8%ad%e0%b8%b0%e0%b9%84%e0%b8%a3) ที่สามารถเชื่อมต่อกับ WiFi ได้สามารถ เขียนโปรแกรมด้วย ArduinoIDE (https://poundxi.com/%e0%b8%a7%e0%b8%b4%e0%b8%98%e0%b8%b5%e0%b9%83%e0%b8%8a%e0%b9%89%e0%b8%87%e0%b8%b2%e0%b8%99%e0%b9%82%e0%b8%9b%e0%b8%a3%e0%b9%81%e0%b8%81%e0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) ได้เช่นเดียวกับ Arduino และบอร์ดก็มีราคาถูกมากๆ เหมาะแก่ผู้ที่คิด จะเริ่มต้นศึกษา หรือทดลองใช้งานเกี่ยวกับ Arduino, IoT, อิเล็กทรอนิกส์ หรือแม้แต่การน าไปใช้จริงใน โปรเจคต่าง ๆ ดังแสดงในรูปที่ 2.8

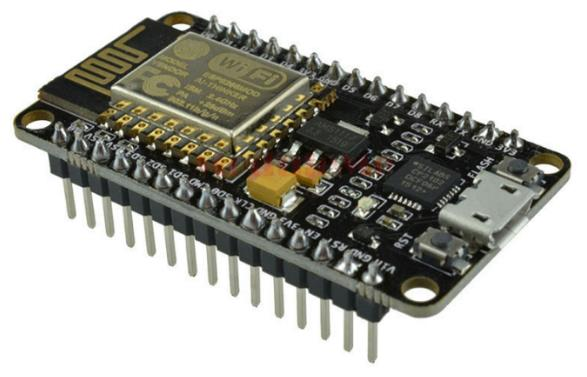
[picture p153: figure]

รูปที่2.8 NodeMCU ESp8266
แหล่งที่มา : http://www.arduino.in.th/product/420/nodemcu-development-kit-v2

จากรูปที่ 2.8 บอร์ด Nodemcu ภายในบอร์ดของ NodeMCU ประกอบไปด้วย ESP8266 ไมโครคอนโทรลเลอร์ที่สามารถเชื่อมต่อ WiFi ได้ พร้อมอุปกรณ์อ านวยความสะดวกต่าง ๆ เช่น พอร์ต micro USB ส าหรับจ่ายไฟ/อัปโหลดโปรแกรม, ชิพส าหรับอัปโหลดโปรแกรมผ่านสาย USB ชิพแปลง แรงดันไฟฟ้า และขาส าหรับเชื่อมต่ออุปกรณ์ภายนอก เป็นต้น

### 2.8 บอร์ด Relay Module

ชุดรีเลย์ที่ใช้ต่อกับเอาต์พุตของ PLC หรืออุปกรณ์อื่นๆ ที่เป็นทั้ง PNP หรือ NPN เพื่อน า Contact Relay ไปใช้งาน ใช้พื้นที่ในการติดตั้งน้อย ซ่อมแซมได้ง่าย เคลื่อนย้ายได้สะดวก รูปทรงสวยงาม สามารถติดตั้ง บนราง DIN RIAL ในตู้ไฟฟ้าได้ มี LED โชว์สภาวะการท างานของ Relay ใช้กับสายขนาด 2.5mm×2.5mm สามารถทนอุณหภูมิการติดตั้งได้ 0-50 องศา แสดงได้ดังรูปที่ 2.9

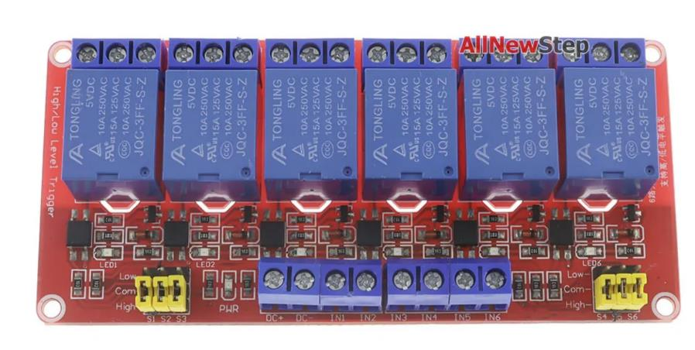
[picture p154: figure]

รูปที่ 2.9 บอร์ด Relay Module แหล่งที่มา : https://www.allnewstep.com/product/3047/relay-5v-6-ช่อง-relay-module-relay-5v-relay-6-channal-แบบแยกกราวน์-optocupler-isolation

จากรูปที่ 2.9 เป็นอุปกรณ์ที่เปลี่ยนพลังงานไฟฟ้าให้เป็นพลังงานแม่เหล็ก เพื่อใช้ในการดึงดูด หน้าสัมผัสของคอนแทคให้เปลี่ยนสภาวะ โดยการป้อนกระแสไฟฟ้าให้กับขดลวด เพื่อท าการปิดหรือเปิด หน้าสัมผัสคล้ายกับสวิตช์อิเล็กทรอนิกส์ ซึ่งเราสามารถน ารีเลย์ไปประยุกต์ใช้ ในการควบคุมวงจรต่าง ๆ ในงานช่างอิเล็กทรอนิกส์มากมายภายใน Relay (http://thaieasyelec.com/products-components/relay.html) จะประกอบไปด้วยขดลวดและหน้าสัมผัส แสดงได้ดังรูป ที่ 2.10

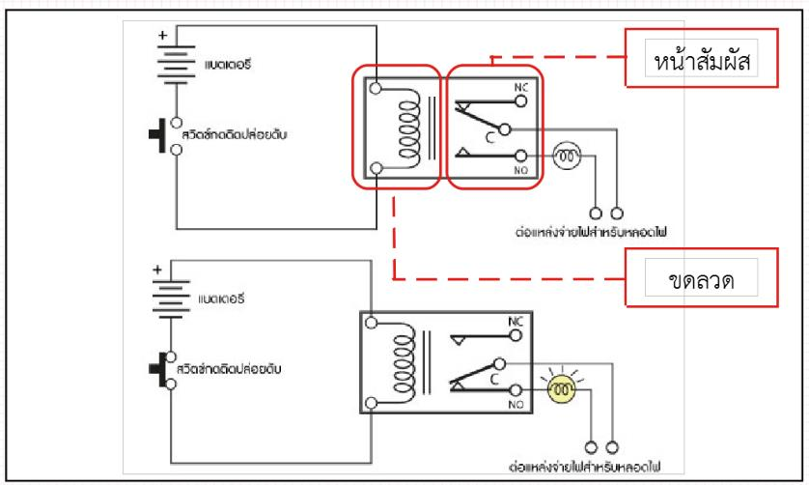
[picture p155: figure]

รูปที่ 2.10 สัญลักษณ์วงจรไฟฟ้าภายในรีเลย์ แหล่งที่มา : http://www.kruteerapong.com/u18Knowledge.php

จากรูปที่ 2.10 แสดงภายใน Relay (http://thaieasyelec.com/products-components/relay.html) จะประกอบไปด้วยขดลวดและหน้าสัมผัส หน้าสัมผัส NC (Normally Close) เป็นหน้าสัมผัสปกติปิด โดยในสภาวะปกติหน้าสัมผัสนี้จะต่อเข้ากับขา COM (Common) และจะลอยหรือไม่สัมผัสกันเมื่อมีกระแสไฟฟ้าไหลผ่านขดลวด หน้าสัมผัส NO (Normally

Open) เป็นหน้าสัมผัสปกติเปิด โดยในสภาวะปกติจะลอยอยู่ ไม่ถูกต่อกับขาCOM (Common) แต่จะ เชื่อมต่อกันเมื่อมีกระแสไฟไหลผ่านขดลวด ขา COM (Common) เป็นขาที่ถูกใช้งานร่วมกันระหว่าง NC และ NO ขึ้นอยู่กับว่า ขณะนั้นมีกระแสไฟฟ้าไหลผ่านขดลวดหรือไม่ หน้าสัมผัสใน Relay 1 ตัวอาจมี มากกว่า 1 ชุด ขึ้นอยู่กับผู้ผลิตและลักษณะของงานที่ถูกน าไปใช้

### 2.9 โซลินอยด์วำล์ว

โซลินอยด์ (Solenoid) เป็นอุปกรณ์แม่เหล็กไฟฟ้าชนิดหนึ่ง ที่มีหลักการท างานคล้ายกับรีเลย์ (Relay) Relay) Relay) ภายในโครงสร้างของโซลินอยด์จะประกอบด้วย ขดลวดที่พันอยู่รอบแท่งเหล็กที่ ภายในประกอบด้วย แม่เหล็กชุดบนกับชุดล่าง เมื่อมีกระแสไฟไหลผ่านขดลวดที่พันรอบแท่งเหล็ก ท าให้ แท่งเหล็กชุดล่างมีอ านาจแม่เหล็กดึงเท่งเหล็กชุดบนลงมาสัมผัสกันท าให้ครบวงจรท างาน เมื่อวงจรถูกตัด กระแสไฟท าให้แท่งเหล็กส่วนล่างหมดอ านาจแม่เหล็ก สปริงก็จะดันแท่งเหล็กส่วนบนกับสู่ต าแหน่งปกติ จากหลักการดังกล่าวของโซลินอยด์ก็จะน ามาใช้ในการเลื่อนลิ้นวาล์วของระบบนิวแมติกส์ไฟฟ้า โครงสร้าง ของ Solenoid Valve Solenoid Valve โดยทั่วไปแบ่งออกเป็น 2 ชนิด คือ เลื่อนวาล์วด้วยโซลินอยด์ วาล์วกลับด้วยสปริง (Single Solenoid Valve) e Solenoid Valve) และเลื่อนวาล์ว แสดงได้ดังรูปที่ 2.11

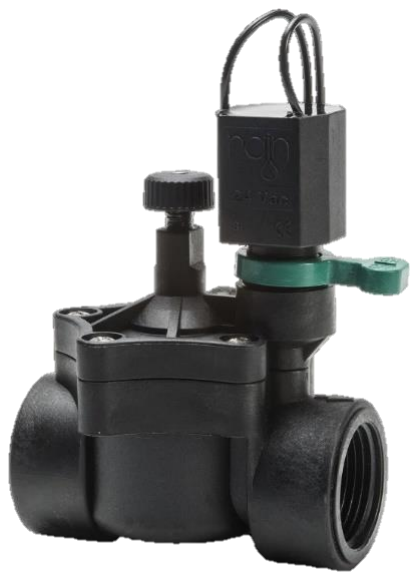
[picture p156: figure]

รูปที่ 2.11 โซลินอยด์วาล์ว แหล่งที่มา : https://globalhouse.co.th/product/detail/8855638057825

จากรูปที่ 2.11 เป็นโซลินอยด์วาล์วกลับด้วยโซลินอยด์วาล์ว (Double Solenoid Valve) ที่ใช้อยู่ ในปัจจุบัน เช่น โซลินอยด์วาล์ว 2/2 เป็นต้น

### 2.10 Magnetic Contactor

แมกเนติกคอนแทคเตอร์ คือ อุปกรณ์สวิตช์ตัดต่อวงจรไฟฟ้า เพื่อการเปิด-ปิด ของหน้าสัมผัส (Contact) ท างานโดยอาศัยอ านาจแม่เหล็กไฟฟ้าช่วยในการเปิด-ปิดหน้าสัมผัส ในการตัดต่อวงจรไฟฟ้า เช่น เปิด-ปิด การท างานของวงจรควบคุมมอเตอร์ นิยมใช้ในวงจรของระบบแอร์ , ระบบควบคุมมอเตอร์ หรือใช้ในการควบคุมเครื่องจักรต่าง ๆ โดยแมคเนติกคอนแทคเตอร์นั้น จะมีส่วนประกอบหลักที่ส าคัญต่อ การท างาน ได้แก่ แกนเหล็ก (Core) ,ขดลวด (Coil), หน้าสัมผัส (Contact) และสปริง (Spring) ดังรูปที่ 2.12

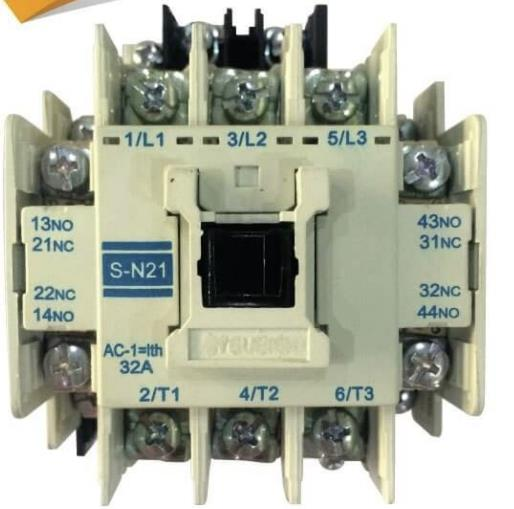
[picture p157: figure]

รูปที่ 2.12 Magnetic Contactor แหล่งที่มา : http://www.tsc-th.com/ดูยังไงว่าแมกเนติกเสีย/

จากรูปที่ 2.12 แสดงแมคเนติกคอนแทกเตอร์ (Magnetic Contactor) เป็นสวิตซ์อีกชนิดหนึ่ง ประกอบด้วยส่วนที่ส าคัญ 2 ส่วนคือ ส่วนที่เป็นขดลวดหรือคอยล์ ซึ่งเมื่อป้อนกระแสไฟฟ้าเข้าในขดลวด แล้วจะเกิดสนามแม่เหล็กขึ้น และอีกส่วนหนึ่งเป็นหน้าสัมผัสของตัวแมคเนติคอนแทกเตอร์ ท าหน้าที่ตัด หรือต่อวงจรไฟฟ้า ก าลังที่ป้อนเข้าโหลด หลักการท างานของแมคเนติกคอนแทกเตอร์คือ เมื่อป้อน กระแสไฟฟ้าเข้าในขดลวดจะเกิดสนามแม่เหล็กขึ้นรอบขดลวด มีอ านาจดูดเหล็กอาร์มาเจอร์ (Armature) ซึ่งแกนเหล็กนี้ปลายข้างหนึ่งจะต่ออยู่กับหน้าสัมผัสเคลื่อนที่ (Moving Contact) และปลายอีกข้างหนึ่ง วางอยู่บนสปริง ซึ่งจะคอยผลักแกนเหล็กอาร์มาเจอร์ให้หน้าสัมผัสจาก เมื่อขดลวดเกิดสนามแม่เหล็กและ มีอ านาจมากกว่าแรงดันสปริง แกนอาร์มาเจอร์จะถูกดูด ท าให้หน้าสัมผัสต่อกัน และเมื่อตัดกระแสไฟฟ้าที่ ป้อนเข้าขดลวด อ านาจแม่เหล็กรอบขดลวดจะหมดไป แรงดันสปริงจะผลักแกนเหล็กอาร์มาเจอร์ให้ หน้าสัมผัสจากออกหน้าสัมผัสของแม็กเนติกคอนแทกเตอร์ในหนึ่งตัวอาจจะมีขั้วเพียงขั้วเดียว หรือ 2 ขั้ว

หรือ 3 ขั้วก็ได้ และหน้าสัมผัสอาจเป็นแบบปกติเปิดทั้งหมด หรืออาจจะมีทั้งหน้าสัมผัสปกติเปิดและปกติ ปิดสลับกันก็ได้ ทั้งนี้ขึ้นอยู่กับแบบและวงจรการควบคุม

### 2.11 จอแสดงผลแบบ LCD

LCD ย่อมาจาก Liquid Crystal Display ซึ่งเป็นจอแสดงผลแบบ (Digital) โดยภาพที่ปรากฏขึ้น เกิดจาก แสงที่ถูกปล่อยออกมาจากหลอดไฟด้านหลังของจอภาพ (Black Light) ผ่านชั้นกรองแสง (Polarized filter) แล้ววิ่งไปยังคริสตัลเหลวที่เรียงตัวด้วยกัน 3 เซลล์คือ แสงสีแดง แสงสีเขียวและแสงสี น้ าเงิน กลายเป็นพิกเซล (Pixel) ที่สว่างสดใสเกิดขึ้น แสดงได้ดังรูปที่ 2.13

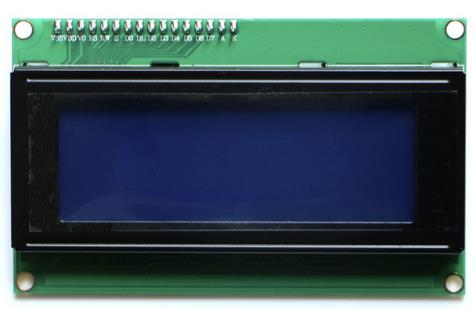
[picture p158: figure]

รูปที่2.13 จอแสดงผล LCD
แหล่งที่มา : http://www.arduino4.com/product/140/2004-lcd-blue-screen-20x4-lcd-จอ-lcd-สีฟ้า

จากรูปที่ 2.13 แสดงจอ LCD ที่มีการเชื่อมต่อแบบ I2C หรือเรียกอีกอย่างว่าการเชื่อมต่อแบบ อนุกรม จะเป็นจอ LCD ธรรมดาทั่วไปที่มาพร้อมกับบอร์ด I2C Bus ที่ท าให้การใช้งานได้สะดวกยิ่งขึ้น และยังมาพร้อมกับ VR ส าหรับ ปรับความเข้มของจอ ในรูปแบบ I2C จะใช้ขาในกาเชื่อมต่อกับ ไมโครคอนโทรลเลอร์เพียง 4 ขา (แบบ Parallel ใช้ 16 ขา) ซึ่งท าให้ใช้งานได้ง่ายและสะดวกมากยิ่งขึ้น ส าหรับการเขียนโปรแกรมจอแสดงผล LCD แสดงได้ดังรูปที่ 2.14

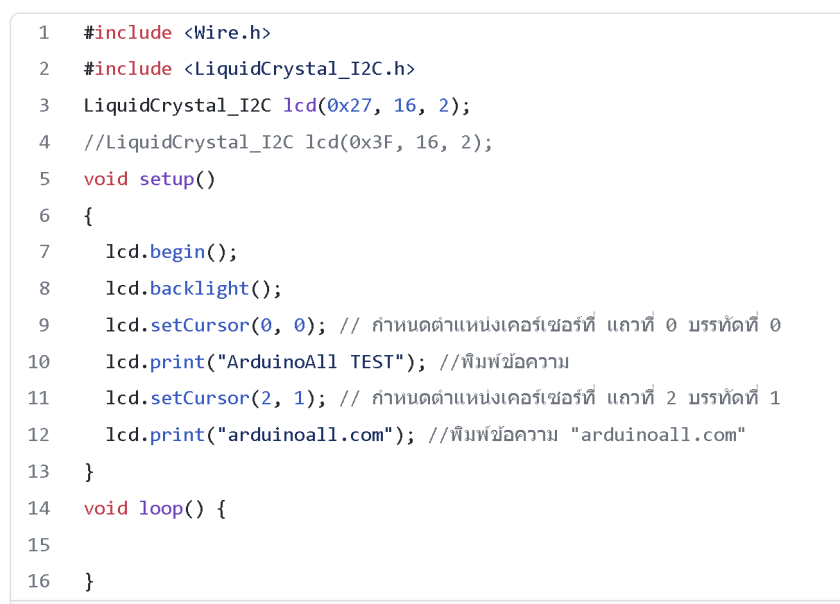
[picture p159: figure]

รูปที่ 2.14 ตัวอย่าง Code ส าหรับการเขียนโปรแกรมจอแสดงผล LCD แหล่งที่มา : http://www.allnewstep.com/article/220/20-สอน-arduino-วิธีใช้จอ-lcd-1602-แบบ-i2c-อย่างง่าย

จากรูปที่ 2.14 แสดง Code ส าหรับการเขียนโปรแกรมจอแสดงผล LCD โดยมีการ include Library <LiquidCrystal_I2C.h> เข้ามา

### 2.12 ปั๊มน้ ำ

เครื่องสูบน้ าแบบหอยโข่งมีใช้กันอย่างแพร่หลาย เพราะมีคุณสมบัติที่เหมาะสมต่อการเกษตร คือ สูบน้ าได้ปริมาณมาก น้ าที่สูบไม่จ าเป็นที่จะต้องสะอาด เนื่องจากสิ่งสกปรกที่ปะปนอยู่ในน้ า ไม่ค่อยมี ผลเสียต่อเครื่องสูบน้ าชนิดนี้มากนัก การใช้งานก็มีอยู่อย่างกว้างขวาง ทั้งในไร่นา สวนผัก สวนผลไม้ หรือ แม้แต่ในฟาร์มเลี้ยงสัตว์ เครื่องสูบน้ าแบบนี้ เหมาะส าหรับสูบน้ าในแม่น้ าล าธาร บ่อน้ า คูคลอง หรืออ่าง เก็บน้ าที่มีระดับต่ ากว่าระดับพื้นดินไม่เกิน 10 เมตร แสดงได้ดังรูปที่ 2.15

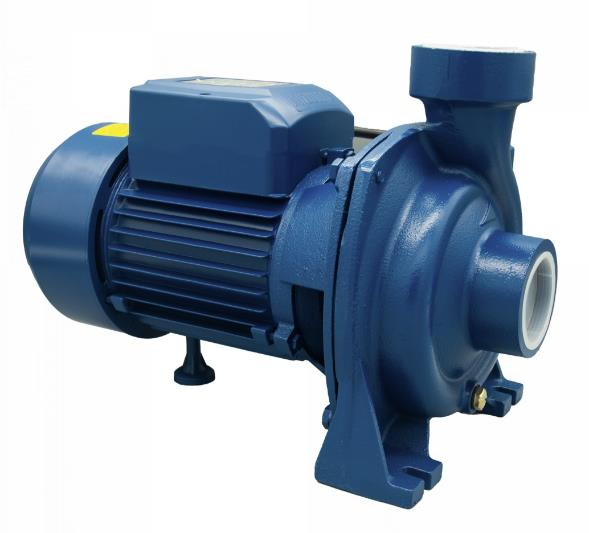
[picture p160: figure]

รูปที่ 2.15 ปั๊มน้ าขนาด 2 แรงม้า แหล่งที่มา : https://globalhouse.co.th/product/detail/6222007620195

จากรูปที่ 2.15 ปั๊มน้ าแบบหอยโข่งสามารถสูบน้ าด้วยการท างานของส่วนประกอบ 4 ส่วน
1. ใบพัด (Impeller): เป็นส่วนที่ท า ให้เกิดแรงหนีศูนย์กลางต่อน้ าที่อยู่ภายในเรือน
2. เรือนสูบ (Casing): เป็นส่วนที่เปลี่ยนแรงหนีศูนย์กลางที่เกิดจากใบพัดให้เป็นแรงดันได้อย่างมี ประสิทธิภาพ
3. ช่องดูด (Suction): ท าหน้าที่เป็นท่อทางน้ าเข้าของปั๊มน้ า (https://www.ktw.co.th/category/%E0%B8%9B%E0%B8%B1%E0%B9%8A%E0%B8%A1%E0%B8%99%E0%B9%89%E0%B8%B3%E0%B8%AB%E0%B8%AD%E0%B8%A2%E0%B9%82%E0%B8%82%E0%B9%88%E0%B8%87-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)
4. ช่องดูด (Discharge): ท าหน้าที่เป็นท่อทางส่งน้ าออกของปั๊มน้ า (https://www.ktw.co.th/category/%E0%B8%9B%E0%B8%B1%E0%B9%8A%E0%B8%A1%E0%B8%99%E0%B9%89%E0%B8%B3%E0%B8%AB%E0%B8%AD%E0%B8%A2%E0%B9%82%E0%B8%82%E0%B9%88%E0%B8%87-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)

### 2.13 โปรแกรมภำษำ C ส ำหรับ Arduino

เนื้อหาในส่วนนี้จะอธิบายถึงระบบปฏิบัติการและภาษาที่ใช้ในการควบคุมให้ระบบสามารถ ท างานได้ตามขอบเขตที่ก าหนดไว้ โดยมีรายละเอียดดังนี้
(1) ภาษาที่ใช้ในการพัฒนาระบบ
ภาษา C เป็นการเขียนโปรแกรมพื้นฐานสามารถประยุกต์ใช้กับงานต่างๆได้มากมาย ระบบปฏิบัติการคอมพิวเตอร์ทางคณิตศาสตร์ โปรแกรมทางไฟฟ้าอิเล็กทรอนิกส์ ไมโครคอนโทรลเลอร์ ซึ่งเวลาใช้สามารถพิมพ์ชุดค าสั่งภาษาซีเพิ่มเข้าไปในโปรแกรมค านวณทางคณิตศาสตร์ ประมวลผลทาง สัญญาณไฟฟ้าทางไฟฟ้าสื่อสารก็ได้ท าให้ประสิทธิภาพของงานที่ท าดียิ่งขึ้น ภาษาซีเป็นภาษาที่บางคน เรียกว่าภาษาระดับกลาง คือไม่เป็นภาษาระดับต่ าแบบแอสเซมบลีหรือเป็นภาษาสูงแบบ เบสิค โคบอล ฟอร์แทรน หรือ ปาสคาล เนื่องจากสามารถจะจัดการเกี่ยวกับเรื่องของพอยน์เตอร์ได้อย่างอิสระ และบาง ทีก็สามารถควบคุมฮาร์ดแวร์ผ่านทางภาษาซีได้ราวกับเขียนมันด้วยภาษาแอสเซมบลี
(2) Arduino IDE ที่ใช้ในการพัฒนาระบบ

Arduino IDE คือ platform ที่ท างานบนฝั่ง Hardware โดยมี IDE ส าหรับพัฒนาและมี Hardware I/O ส าหรับต่อ interface ส าหรับการท างานในรูปแบบต่างๆ ไม่ว่าจะเป็นการสื่อสารที่ คอมพิวเตอร์ท าได้ เช่น serial sd card usb wifi lang psgsm หรือ module ต่างๆ ที่สามารถเพิ่มเข้าไป ได้ แสดงได้ดังรูปที่ 2.16

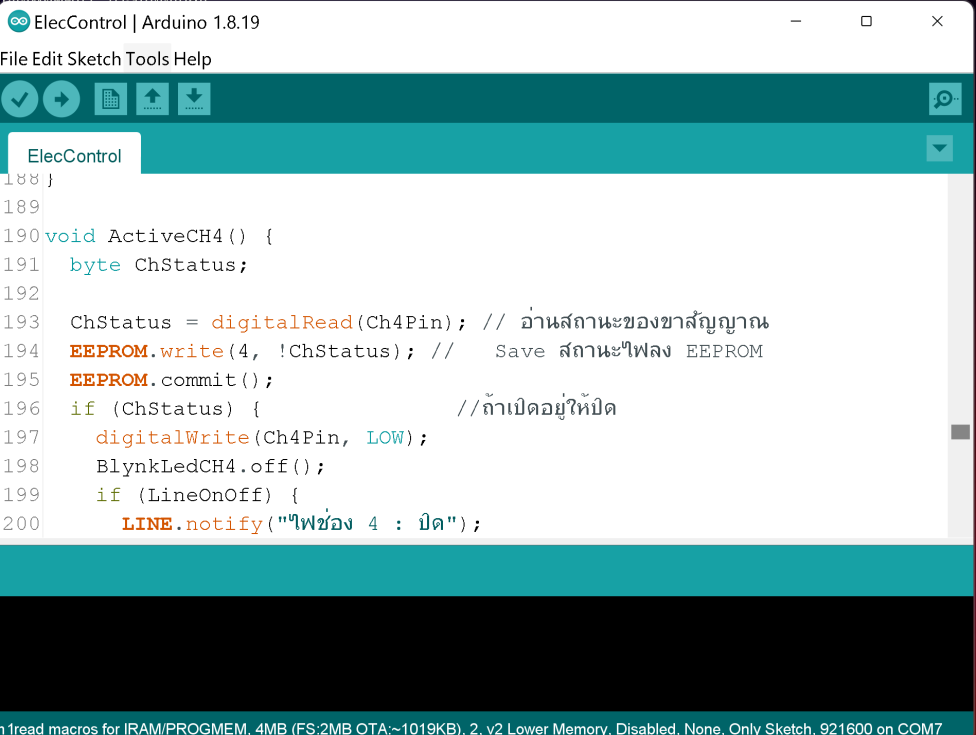
[picture p161: figure]

รูปที่ 2.16 แสดงลักษณะของโปรแกรม Arduino IDE แหล่งที่มา : ผลิตเอง

จากรูปที่ 16 แสดงการใช้งาน Arduino IDE จะรวบรวมชุดไลบรารี่ส าหรับการท างานร่วมกัน Arduino hardware ซึ่งหลังจากพัฒนาหรือจะท าการทดลองก็เพียงแค่โหลดโปรแกรมที่เขียนลงสู่ Arduino hardware ได้โดยไม่ต้องมีเครื่องโปรแกรมใด ๆ

### 2.14 Blynk Platform

Blynk Platform ถูกออกแบบมาเพื่อใช้ในการควบคุมอุปกรณ์ Internet of Things ซึ่งมี คุณสมบัติในการควบคุมจากระยะไกลผ่านเครือข่ายอินเตอร์เน็ต และยังสามารถแสดงผลค่าจากเซนเซอร์ ต่าง ๆ ได้อีกด้วย ส าหรับโครงการของ Blynk Platform แสดงได้ดังรูปที่ 2.17

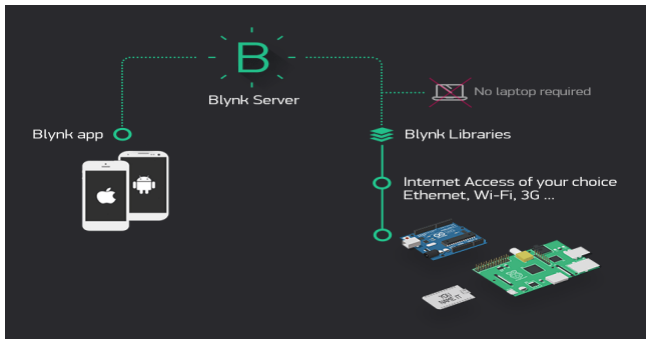
[picture p162: figure]

รูปที่ 2.17 Blynk Platform แหล่งที่มา : https://blog.thaieasyelec.com/getting-started-iot-with-blynk

จากรูปที่ 2.17 แสดงการใช้Blynk App – แอพพลิเคชั่นที่สามารถติดตั้งในมือถือของเราเองเพื่อ สร้าง Interface ในการควบคุมหรือแสดงผลค่าจากอุปกรณ์Internet of ThingsBlynk Server – ท า หน้าที่เป็นตัวกลางในการติดต่อสื่อสารระหว่างแอพพลิเคชั่นกับอุปกรณ์Internet of Things ในส่วนนี้จะ เปิดให้ใช้บริการฟรี Blynk Librariesออกแบบมาส าหรับอุปกรณ์Internet of Things ต่างๆ ให้สามารถ สื่อสารกันได้อย่างมีประสิทธิภาพ แสดงได้ดังรูปที่ 2.18

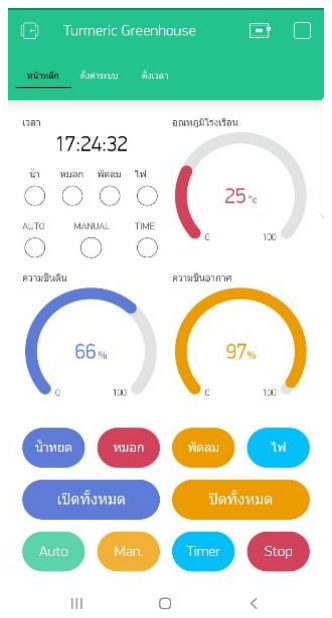
[picture p163: figure]
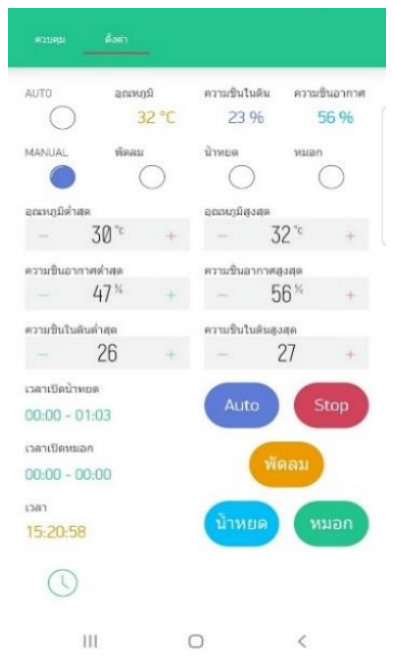
[picture p164: figure]

รูปที่ 2.18 ตัวอย่างของแอพพลิเคชันที่สร้างจาก Blynk Platform แหล่งที่มา : ผลิตเอง

จากรูปที่ 2.18 แสดงให้เห็นถึงการออกแบบหน้าใช้งานของโปรแกรม Blynk Server เป็น Digital Dashboard Platform ส าหรับ Arduino NodeMCU และ Raspberry Pi โดยผู้ใช้งานสามารถสร้าง Graphic interface ขึ้นมาใน Application (รองรับทั้ง iOS และ Android) เพื่อท าการควบคุมจัดการ อุปกรณ์ IoT ได้อย่างง่ายได้ส าหรับท่านที่ต้องการใช้งาน Blynk นั้นทางเราได้ท าการสร้างระบบ Blynk Server ขึ้นมาเพื่อให้สามารถใช้งานได้แบบฟรีๆ กันเลย

### 2.15 แอพพลิเคชั่นไลน์

โปรแกรม App Line แอพพลิเคชั่น ที่มีความสามารถในการสนทนา เช่น การแชท การส่ง ข้อความ การแชร์ไฟล์การสร้างกลุ่มพูดคุย หรือการสนทนาผ่านเสียง ผ่านเครือข่ายอินเตอร์เน็ต บน อุปกรณ์ประเภทพกพา (Mobile Devices) เช่น สมาร์ทโฟน แท็บเล็ต เป็นต้น นอกจากนี้ Line ยัง สามารถติดตั้งและใช้งานบนเครื่อง คอมพิวเตอร์ทั่วไปได้ด้วย แสดงได้ดังรูปที่ 2.19

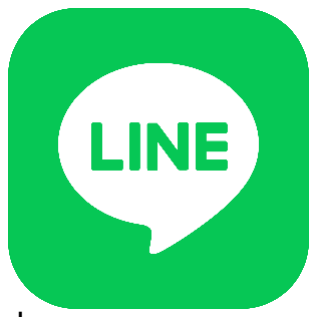
[picture p165: figure]

รูปที่ 2.19 Application Line แหล่งที่มา : http://th.wikipedia.org/wiki/ไลน์_(โปรแกรมประยุกต์)

จากรูปที่ 2.19 แสดงการใช้งาน App Line การสื่อสารการแจ้งเตือนให้ผู้ใช้งานทราบถึง สถานะการท างานของระบบโดยแจ้งเตือนเมื่ออุปกรณ์เกิดปัญหา มีการขัดข้องของอุปกรณ์โดยแจ้งให้ ผู้ดูแลทราบสถานะของระบบ

### 2.16 งำนวิจัยที่เกี่ยวข้อง

ในหัวข้อนี้เสนองานวิจัยที่ผู้วิจัยได้ท าการศึกษาเพื่อน ามาเป็นแนวทางในการพัฒนา ระบบวิจัยของข้าพเจ้าซึ่งได้แก่ งานวิจัยเรื่องระบบควบคุมการให้น ้าอัตโนมัติด้วยเซนเซอร์ความชื้นของดิน ระบบรดน้ าอัตโนมัติผ่านเครือข่ายเซ็นเซอร์ไร้สาย และระบบอัตโนมัติแบบออนไลน์ส าหรับการควบคุม การให้น้ าสวนสละ กรณีศึกษาสวนสละ ชุมชนบ้านในยาง ต าบลร่มเมือง อ าเภอเมือง จังหวัดพัทลุง โดย รายละเอียดเกี่ยวกับงานวิจัยที่ผู้วิจัยได้น ามาศึกษามีดังนี้
2.16.1 งานวิจัยเรื่องระบบควบคุมการให้น้ าอัตโนมัติด้วยเซนเซอร์ความชื้นของดิน ผลงานของ ทองล้วน สิงห์นันท์และ วันดี หวังคะพันธ์ สาขาวิชาเทคโนโลยีคอมพิวเตอร์ คณะเกษตรศาสตร์และ

เทคโนโลยี มหาวิทยาลัยเทคโนโลยีราชมงคลอีสาน วิทยาเขตสุรินทร์ อ าเภอเมือง จังหวัดสุรินทร์และ สาขาวิชาวิทยาศาสตร์ คณะวิทยาศาสตร์และเทคโนโลยี มหาวิทยาลัยราชภัฏราชนครินทร์ อ าเภอเมือง จังหวัดฉะเชิงเทรา โครงการวิจัยชุดนี้มีวัตถุประสงค์ เพื่อออกแบบ และพัฒนาเครื่องมือเทคโนโลยี สารสนเทศ ส าหรับ ควบคุมการให้ น้าอัตโนมัติ โดยใช้ เซ็นเซอร์ วัดค่า ความชื้นจากดินในพื้นที่แปลงปลูก พืช ส่งข้อมูลมาประมวลผลเพื่อท าการตัดสินใจในการให้น้าแก่พืชที่ปลูก โดยอัตโนมัติ และสามารถ ควบคุมได้ด้วยมือ เพื่อช่วย ลดปัญหาในเรื่องของทรัพยากรน้า สามารถท างานแทนมนุษย์ได้
2.16.2 ดิน ระบบรดน้ าอัตโนมัติผ่านเครือข่ายเซ็นเซอร์ไร้สาย ผลงานของ นราธิป ทองปาน และ ธนาพัฒน์ เที่ยงภักดิ์ คณะเทคโนโลยีสารสหนเทศ มหาวิทยาลัยราชภัฏมหาสารคาม งานวิจัยนี้มี วัตถุประสงค์เพื่อ พัฒนาระบบรดน้ าอัตโนมัติผ่านเครือข่ายเซ็นเซอร์ไร้สาย ศึกษาผลการ ทดลองใช้ระบบ รดน้ าอัตโนมัติผ่านเครือข่ายเซ็นเซอร์ไร้สายในแปลงทดลองของเกษตรกรและ ศึกษาความพึงพอใจของ เกษตรกรที่มีต่อระบบรดน้ าอัตโนมัติผ่านเครือข่ายเซ็นเซอร์ไร้สาย กลุ่มตัวอย่างเป็น เกษตรกรบ้านโนน ตาล ต าบลท่า สองคอน อ าเภอเมือง จังหวัดมหาสารคาม จ้านวน 10 คน ด้วยวิธีเลือกแบบเจาะจง เฉพาะ กลุ่มเกษตรที่ปลูกหน่อไม้เครื่องมือที่ใช้ในการวิจัย ได้แก่ ระบบรดน้ าอัตโนมัติแบบบันทึกการวัดระยะการ ท างานระบบรดน้ าอัตโนมัติแบบบันทึก การวัดค่าความชื้นของดิน แบบบันทึกการวัดระยะการท้างาน ระบบรดน้ าด้วยคอมพิวเตอร์และ แบบสอบถามความพึง พอใจของผู้ใช้ระบบ สถิติที่ใช้ในการวิจัย คือ ค่าเฉลี่ย และส่วนเบี่ยงเบนมาตรฐาน
2.16.3 ระบบอัตโนมัติส าหรับการควบคุมการให้น้ าสวนผสมผสาน กรณีศึกษาศูนย์การเรียนรู้ เศรษฐกิจพอเพียงบ้านคลองเคียน ต าบลกะปาง อ าเภอทุ่งสง จังหวัดนครศรีธรรมราชผลงานของ ธัญ ลักษณ์ บัวทิพย์ศิริกานต์ เรื่องสุวรรณ์และ อรรถพล วิฑูรย์พันธ์สาขาเทคโนโลยีสารสนเทศ คณะ วิทยาศาสตร์และเทคโนโลยี มหาวิทยาลัยเทคโนโลยีราชมงคลศรีวิชัย ท าการวิจัยเรื่องระบบรดน้ า อัตโนมัติใดยจะท าการรดน้ าเมื่อค่าความชื้นในดินมีค่าไม่เหมะสมต่อการเจริญเติบโตของต้นสละ หรือ ระบบสามารถท างานได้ตามผู้ใช้ควบคุมการรดน้ าจากการกดปุ่มผ่านกล่องควบคุม และผ่านแอพพลิเคชั่น Blynk ที่ติดตั้งอยู่ในบริเวณที่พักของเจ้าหน้าที่ดูแล

บทที่ 3
กำรวิเครำะห์และออกแบบระบบ

### 3.1 ขั้นตอนกำรวิเครำะห์ปัญหำ

จากที่ผู้วิจัยได้ท าการศึกษาค้นคว้าพบว่าในปัจจุบันทางสวนสละชุมชนบ้านในยาง ต าบลร่มเมือง อ าเภอเมือง จังหวัดพัทลุง จะเป็นลักษณะของการให้น้ าด้วยระบบสปริงเกอร์ที่เจ้าหน้าที่จะต้องท าการ เดินควบคุมการรดน้ าด้วยตนเอง ซึ่งจะท าให้เจ้าของสวนที่เสียเวลาเสียก าลังแรงงาน และไม่สามารถรับรู้ ความชื้นในดินว่าเหมาะสมหรือไม่ซึ่งเป็นผลกระทบต่อผลสละท าให้มีการเจริญเติบโตได้ช้า ด้วยเหตุดังกล่าวผู้วิจัยจึงมีแนวคิดค้นที่จะสร้างระบบอัตโนมัติแบบออนไลน์ส าหรับการควบคุม การให้น้ าสวนสละ เพื่อลดปัญหาข้างต้นระบบที่ผู้วิจัยได้จัดท าขึ้นมาเพื่อดูแลควบคุมความชื้นแปลงต้น สละ ช่วยในการอ านวยความสะดวกในการใช้งาน โดยมีการออกแบบปุ่มกดที่หน้าตู้ควบคุม และมีการ ติดตั้งตู้ควบคุมไว้บริเวณที่พักของผู้ดูแลสวนร่วมถึงมีการท างานผ่านระบบออนไลน์เนื่องจากระบบของ ผู้วิจัยได้ใช้เซ็นเซอร์วัดความชื้นในดินควบคุมการให้น้ าสวนสละ จึงได้รับค่าความชื้นที่เหมาะสมต่อการ เจริญเติบโต โดยขั้นตอนการวิเคราะห์ปัญหาเพื่อน ามาเป็นข้อมูลในการพัฒนาระบบ ส าหรับงานวิจัยนี้ ประกอบด้วย
1. ขั้นตอนรวบรวมของข้อมูลและศึกษาระบบงาน
2. ขั้นตอนการก าหนดปัญหาและความต้องการของระบบ
3.1.1 ขั้นตอนการรวบรวมข้อมูลและศึกษาระบบงาน
จากการศึกษาสวนสละโดยทั่วไป ในปัจจุบันพบว่าผู้ใช้งานมักพบปัญหาเกี่ยวกับเรื่องของ การให้น้ า ที่ผู้ใช้งานคาดคะเนในการให้น้ าแต่ละครั้ง แถวของต้นสละแต่ละแถวต้องการน้ าในปริมาณที่ แตกต่างกัน เนื่องจากพื้นที่มีความต่างระดับ โดยต้นสละที่ก าลังออกผลที่ก าลังเจริญเติบโตย่อมต้องการน้ า เป็นจ านวนมากในแต่ละวัน และการให้น้ าต้นสละในแต่ละครั้งนั้นควรให้น้ าปริมาณที่พอเหมาะกับความ ต้องการของต้นสละ
3.1.2 ขั้นตอนการก าหนดปัญหาและความต้องการของระบบ
1. ประเด็นปัญหา
- เจ้าของสวน ไม่สามารถควบคุมความชื้นในดิน ที่เหมาะสมต่อการเจริญเติบโต ของผลสละได้เนื่องจากไม่มีเครื่องมือวัดค่าความชื้นในดิน
- ผู้ดูแลสวนต้องดูแลการให้น้ าโดยควบคุมระบบสปริงเกอร์
- ไม่มีความสะดวกในการดูต้นสละและผลสละ
2. ความต้องการของระบบ

จากการวิเคราะห์ประเด็นและปัญหา ของสวนสละทางผู้ดูแลพบว่าปัญหาดังกล่าวจะส่งผลให้ ผลผลิตตกต่ าไม่มีคุณภาพ รายได้น้อย ผู้ดูแลต้องเสียเวลาในการดูแล และเสียสุขภาพ เสี่ยงต่อการเกิด อุบัติเหตุในการท างานโดยเฉพาะผู้ดูแลสูงอายุดังนั้นทางผู้วิจัยจึงเข้ามาแก้ประเด็นปัญหาดังกล่าว ได้ คิดค้นระบบอัตโนมัติแบบออนไลน์ส าหรับการควบคุมการให้น้ าสวนสละฯ สามารถท างานได้ 3 รูปแบบ คือ การควบคุมการให้น้ าตามค่าความชื้นในดิน (Auto Mode) การควบคุมการให้น้ าตามช่วงเวลาที่ ก าหนด (Timer & Auto Mode) และการควบคุมการให้น้ าที่ผู้ใช้ก าหนดเอง (Manual Mode) สามารถ ระบุความต้องการของระบบที่ใช้ในการแก้ปัญหา โดยพัฒนาระบบอัตดนมัติเพื่อช่วยในการให้น้ าในสวน สละที่แม่นย าตามเวลาที่ก าหนดและความชื้นที่ก าหนด

### 3.2 ขั้นตอนกำรออกแบบระบบ

การออกแบบระบบเป็นกระบวนการที่แสดงให้เห็นถึงขั้นตอนการท างานที่เกิดขึ้นในระบบและ การเคลื่อนที่ของข้อมูลจากที่หนึ่งไปยังอีกที่หนึ่ง ซึ่งการออกแบบนี้ ผู้วิจัยได้เลือกวิธีการออกแบบ โดยใช้ แผนภาพกระแสข้อมูล (DFD : Data Flow Diagram) ดังนี้

### 3.2.1 แผนภำพบริบท (Context Diagram)

แผนภาพบริบท เป็นการแสดงให้เห็นถึงข้อมูลโดยรวมของระบบว่าได้รับข้อมูลจากที่ใด มี ส่วนประกอบใดและเกี่ยวข้องกันอย่างไร มีการติดต่อสื่อสารกันอย่างไร และมีการแลกเปลี่ยนข้อมูลใดบ้าง โดยแผนภาพบริบทของระบบการให้น้ าสวนสละที่ผู้วิจัยได้ท าการวิเคราะห์ข้อมูลมาได้นั้นแสดงได้ดังรูปที่ 20

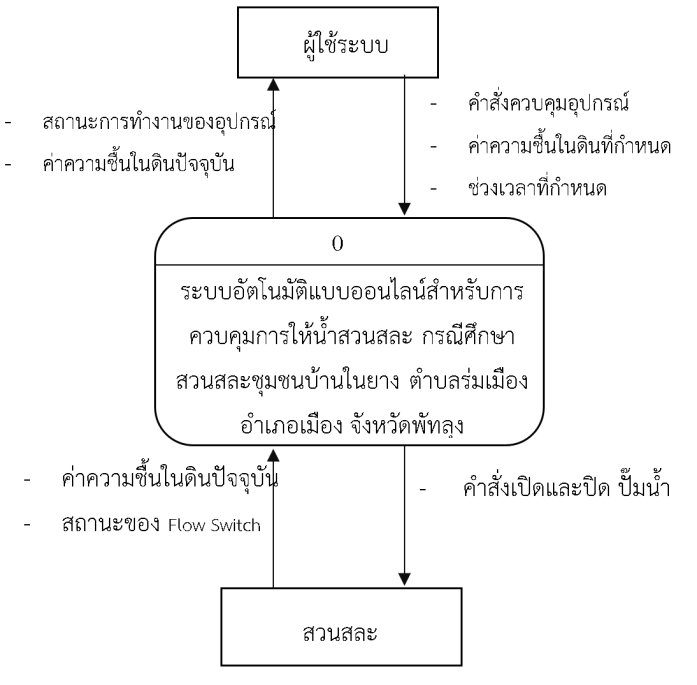
[picture p166: figure]

รูปที่ 3.1 แผนภาพบริบทของระบบ

### 3.2.2 โครงสร้ำงทำงด้ำนฮำร์ดแวร์ของระบบ

เป็นการแสดงให้เห็นถึงวัสดุอุปกรณ์ที่น ามาสร้างเป็นระบบและแสดงให้เห็นถึงการเชื่อมต่อกัน ของวัสดุอุปกรณ์ต่าง ๆ ว่ามีการเชื่อมต่อกันอย่างไรบ้าง ซึ่งแสดงได้ดังรูปที่ 21

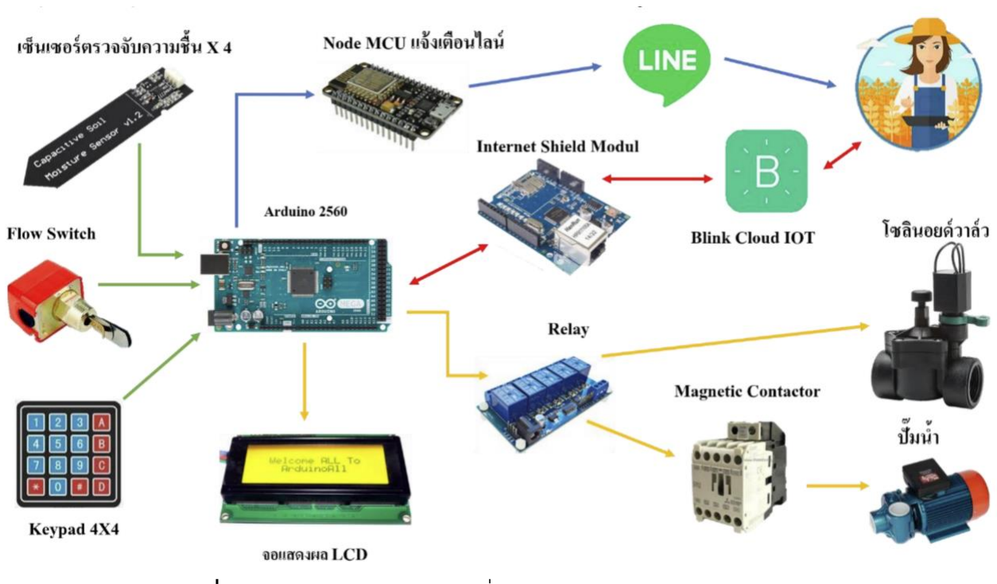
[picture p167: figure]

รูปที่ 3.2 แสดงโครงสร้างการเชื่อมต่อทางด้านฮาร์ดแวร์ของระบบ

3.3กำรพัฒนำโปรแกรมส ำหรับควบคุมระบบ
ในส่วนนี้จะเป็นการพัฒนาโปรแกรมส าหรับบันทึกเข้าไปในตัวประมวลผลกลางที่อยู่ในบอร์ด Arduino เพื่อให้ตัวประมวลผลกลางท างานตามโปรแกรมที่ผู้วิจัยให้ท างานตามเงื่อนไขต่าง ๆ อยู่ถูกต้อง แม่นย า โดยผู้วิจัยจะแบ่งการเขียนโปรแกรมเป็นส่วน ๆ และจะอธิบายล าดับการท างานในลักษณะผังงาน หรือที่เรียกว่า Flowchart ดังนี้

### 3.3.1 ผังงำนขั้นตอนกำรท ำงำนของระบบโดยรวม

ผังงานขั้นตอนการท างานของระบบโดยรวมเป็นการอธิบายถึงการท างานของโปรแกรมเมื่อเริ่ม เปิดใช้งานระบบว่ามีขั้นตอนหลักเป็นอย่างไรบ้าง มีการตวจสอบเงื่อนไข และปุ่มกดในการควบคุมระบบกี่ เงื่อนไข ซึ่งแสดงได้ดังรูปที่ 3.3

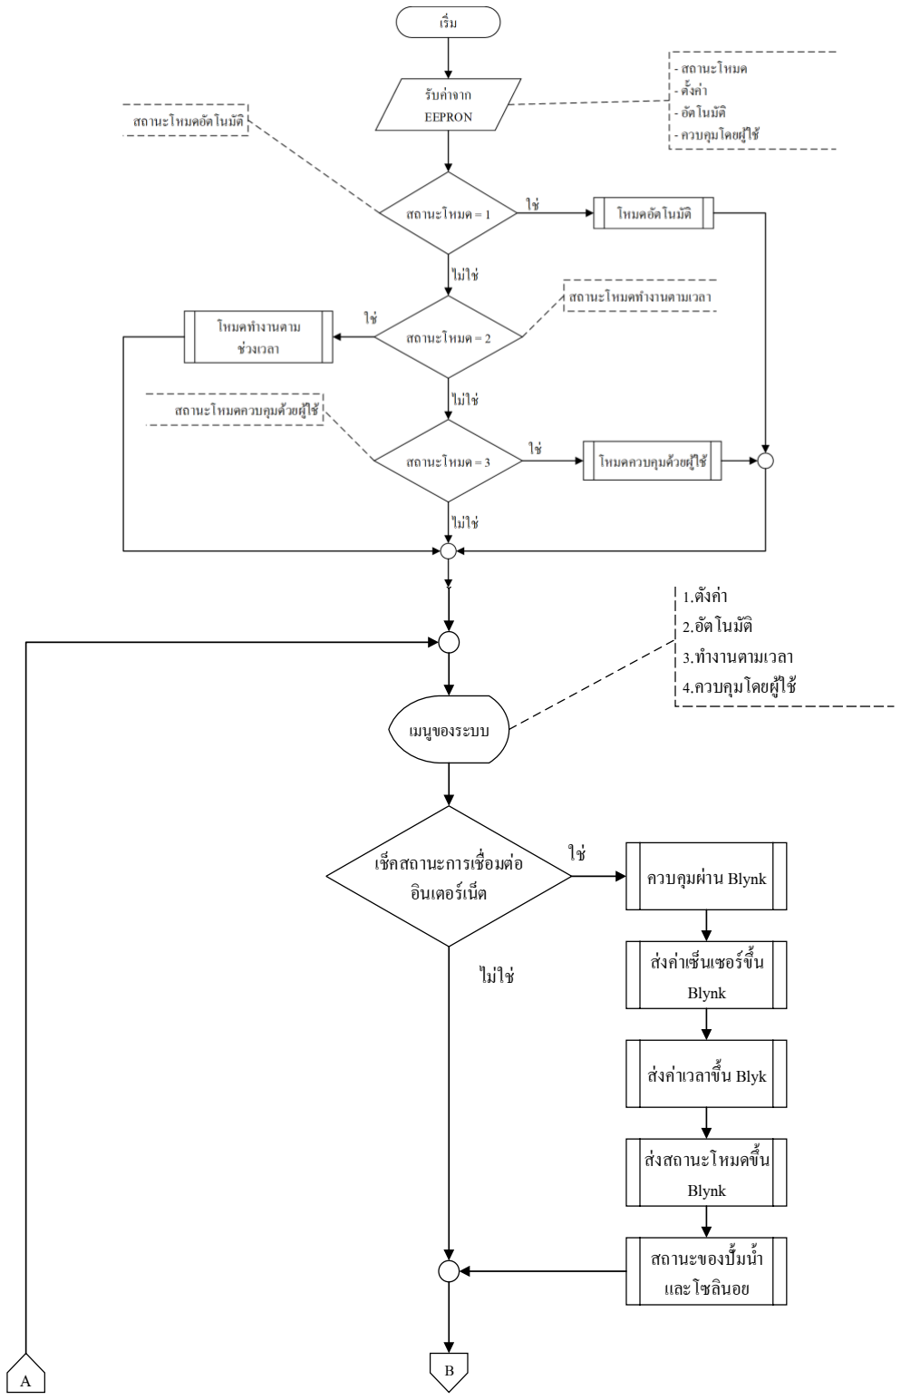
[picture p168: figure]
Blynk; Blyk

รูปที่3.3 ผังงานขั้นตอนการท างานของระบบโดยรวม

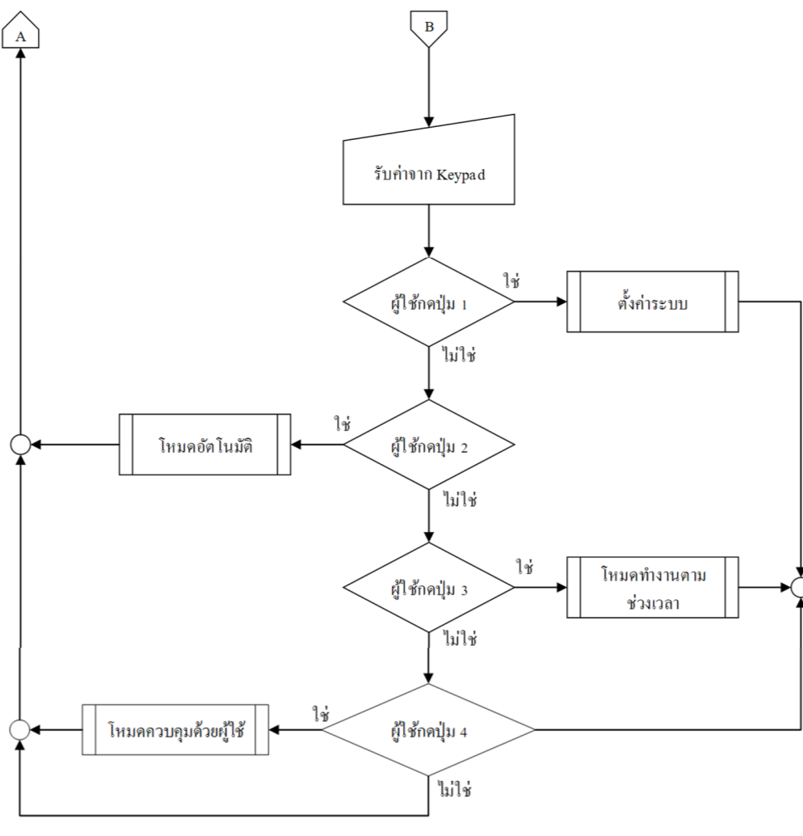
[picture p169: figure]

รูปที่ 3.3 ผังงานขั้นตอนการท างานของระบบโดยรวม (ต่อ)

จากรูปที่ 3.3 ผังงานขั้นตอนการท างานระบบโดยรวม เริ่มต้นระบบมีจะการอ่านค่าคงที่จาก EEPROM เมื่อเป็นการเข้าระบบครั้งแรกจะมีการตรวจสอบการเข้าระบบว่ามีการท างานค้างอยู่หรือไม่ถ้า ระบบค้างอยู่ ระบบจะเริ่มการท างานตามโหมดที่ค้างอยู่ หากไม่มีการท างานให้ระบบรับค่าจาก Keypad เพื่อเข้าสู่ Mode ต่าง ๆ ต่อไปแล้วระบบจะแสดงผลออกทางหน้าจอโดยมีMode ต่าง ๆ คือ
1. กด 1 จะเข้าสู่การตั้งค่าการท างาน
2. กด 2 จะเข้าสู่โหมดอัตโนมัติ
3. กด 3 จะเข้าสู่โหมดท างานตามช่วงเวลา(อัตโนมัติ)
4. กด 4 จะเข้าสู่ระบบควบคุมด้วยผู้ใช้

### 3.3.2 ผังงำนขั้นตอนกำรท ำงำนของกำรตั้งค่ำของระบบ

การท างานของการตั้งค่าของระบบ เป็นส่วนของโปรแกรมส าหรับตั้งค่าคงที่ต่าง ๆ ของระบบที่จะ น าไปใช้ในการตรวจสอบเงื่อนไขต่าง ๆ ที่จะให้ระบบท างานได้อย่างถูกต้องตามขอบเขตที่ผู้วิจัยได้ก าหนด ไว้ โดยจะมีการตั้งค่าคงที่ได้แก่ ตั้งค่าความชื้นต่ าสุด ตั้งค่าความชื้นสูงสุด ตั้งค่าช่วงเวลาเปิดปิด และตั้งค่า ช่วงเวลาของโหมดอัตมัติโดยแสดงได้ดังรูปที่ 3.4

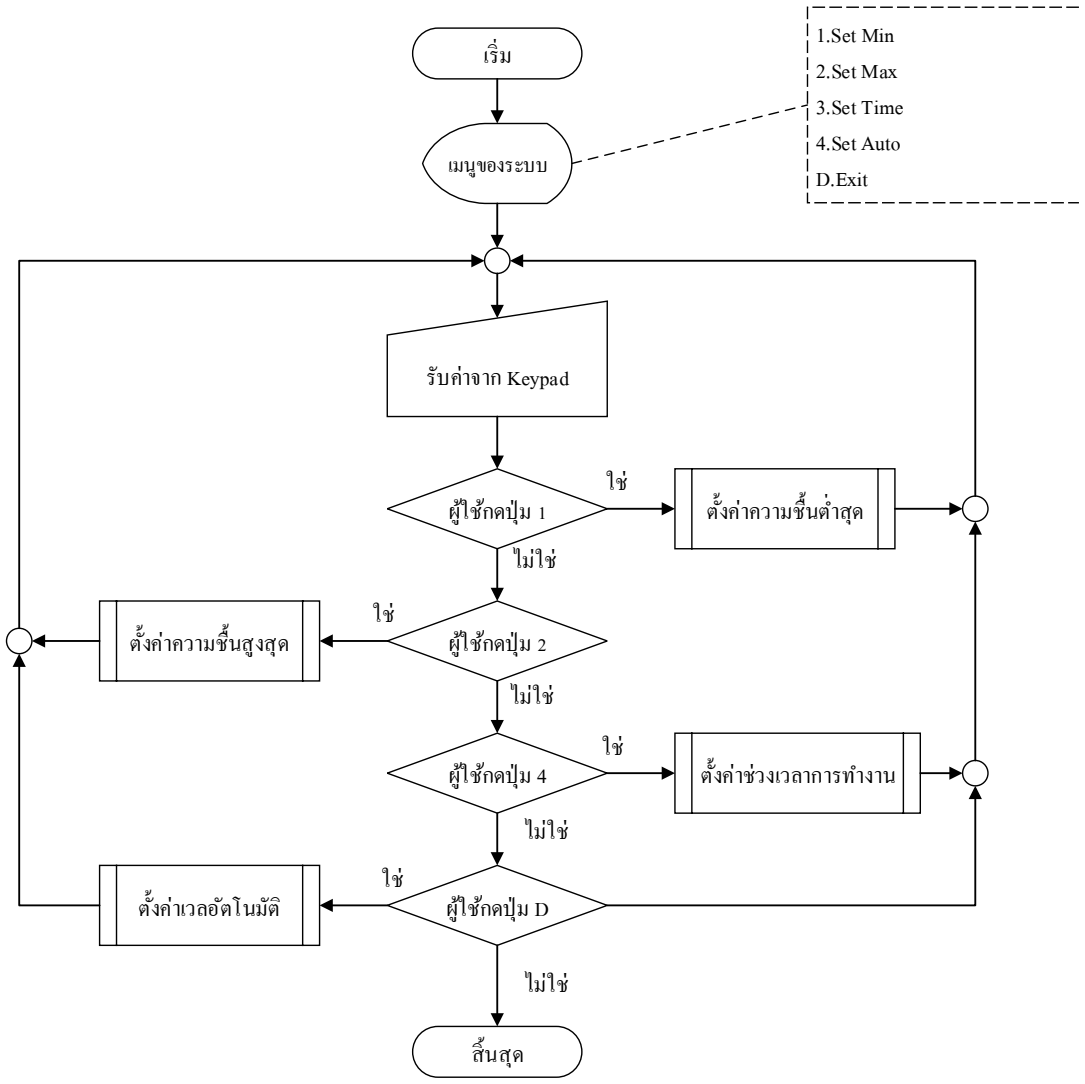
[picture p170: figure]
Keypad; 1.Set Min 2.Set Max 3.Set Time 4.Set Auto D.Exit

รูปที่ 3.4 ผังงานการตั้งค่าระบบ

จากรูปที่ 3.3 ขั้นตอนการท างานของการตั้งค่าระบบ เริ่มต้นระบบจะท าแสดงเมนูของการท างาน ตั้งค่าระบบ หลังจากนั้นระบบจะให้ผู้ใช้ ดังนี้
1. ตั้งค่าความชื้นต่ าสุด
2. ตั้งค่าความชื้นสูงสุด
3. ตั้งค่าช่วงเวลาการท างาน
3. ตั้งค่าช่วงเวลาโหมดอัตโนมัติ

### 3.3.3 ผังงำนกำรอ่ำนค่ำเซ็นเซอร์(Read Sensor)

การอ่านค่าเซ็นเซอร์เป็นส่วนโปรแกรมส าหรับอ่านค่าเซ็นเซอร์วัดความชื้น จ านวน 4 ตัวแล้วท า การหาค่าเฉลี่ยเพื่อน าค่าเฉลี่ยที่ได้ไปใช้ในการตรวจสอบเงื่อนไขร่วมกับค่าความชื้นต่ าสุดและสูงสุด โดยผัง งานแสดงได้ดังรูปที่ 3.5

NumSensor =4

Sensor 4

Sensor 1<10 | NumSensor = NumSensor -1
NumSensor = NumSensor -1 | Sensor 2<10
Sensor 3<10 | NumSensor = NumSensor -1
NumSensor = NumSensor -1 | Sensor 4<10
NumSensor <=0 | NumSensor = 1

= (Sensor 1+Sensor 2+Sensor 3+Sensor4)/NumSensor

รูปที่3.5 ผังงานการท างานของการอ่านค่าเซ็นเซอร์

จากรูปที่3.5 หลักการท างานของการอ่านค่าเซ็นเซอร์จะเริ่มจากอ่านค่าเซ็นเซอร์ทั้ง 4 ตัว จะท า การตรวจสอบว่าเซ็นเซอร์ท างานหรือไม่ ถ้าไม่ท างานให้NumSensor = NumSensor – 1 หลังจากนั้น น าค่าของเซ็นเซอร์ทั้ง 4 ตัวบวกกันแล้วหารด้วยจ านวนเซ็นเซอร์ที่ใช้งานได้เพื่อหาค่าเฉลี่ยของความชื่นใน ดินที่จะน าไปเป็นเงื่อนไขในการให้น้ าในโหมด Auto

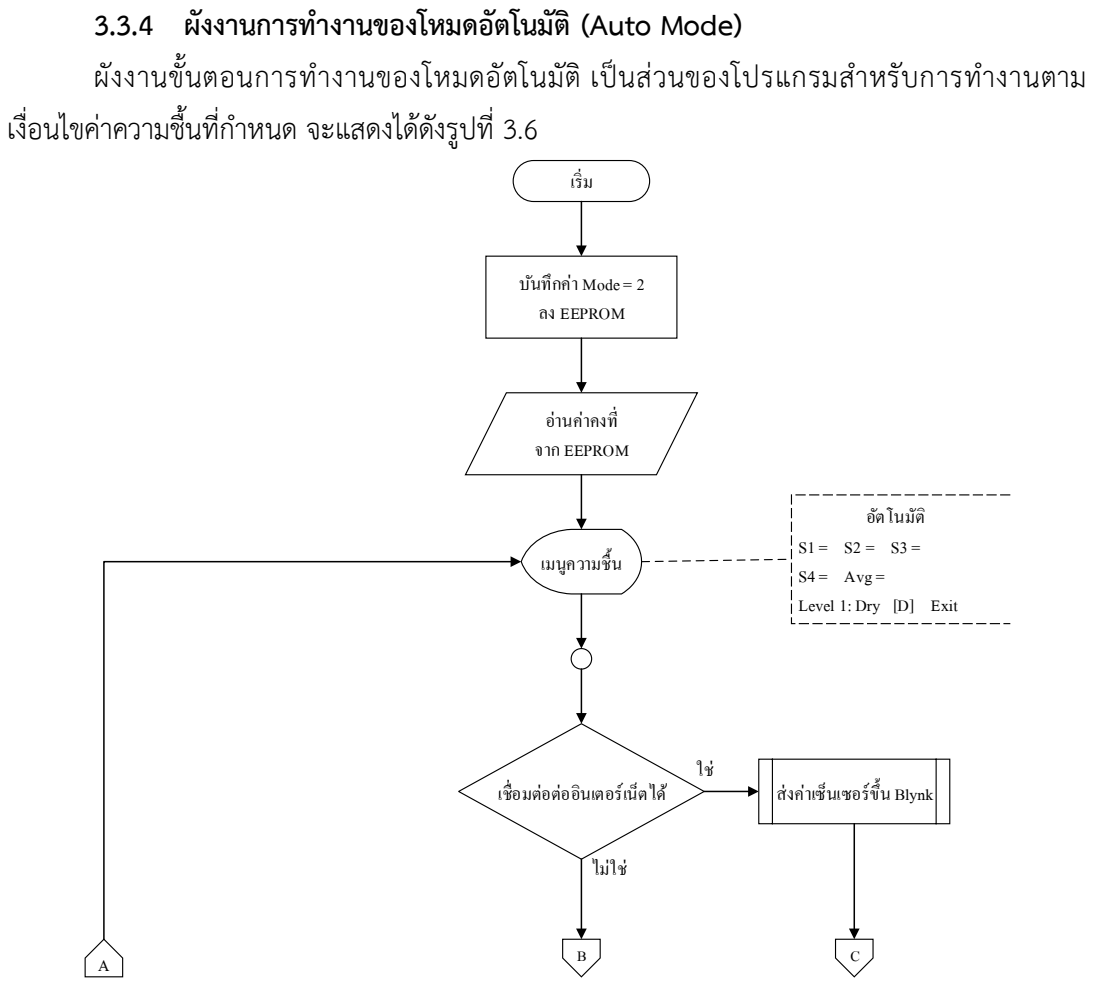
[picture p171: figure]
3.3.4 ผังงำนกำรท ำงำนของโหมดอัตโนมัติ(Auto Mode) ผังงานขั้นตอนการท างานของโหมดอัตโนมัติเป็นส่วนของโปรแกรมส าหรับการท างานตาม เงื่อนไขค่าความชื้นที่ก าหนด จะแสดงได้ดังรูปที่ 3.6; Mode = 2 EEPROM; EEPROM; Blynk; S1 = S2 = S3 = S4 = Avg = Level 1: Dry [D] Exit

รูปที่3.6 ผังงานการท างานของโหมดอัตโนมัติ

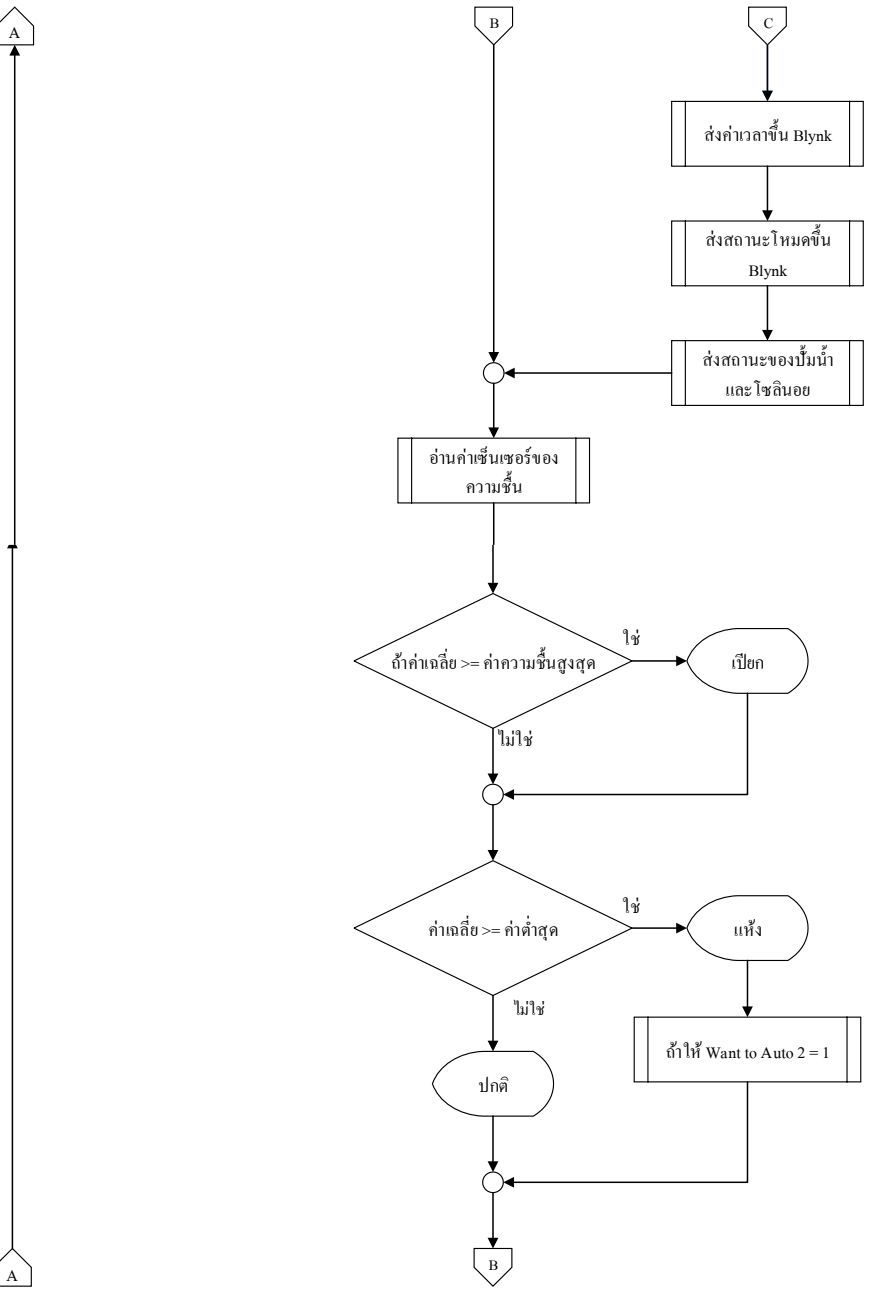
[picture p172: figure]
Blynk; Want to Auto 2= 1

รูปที่3.6 ผังงานการท างานของโหมดอัตโนมัติ(ต่อ)

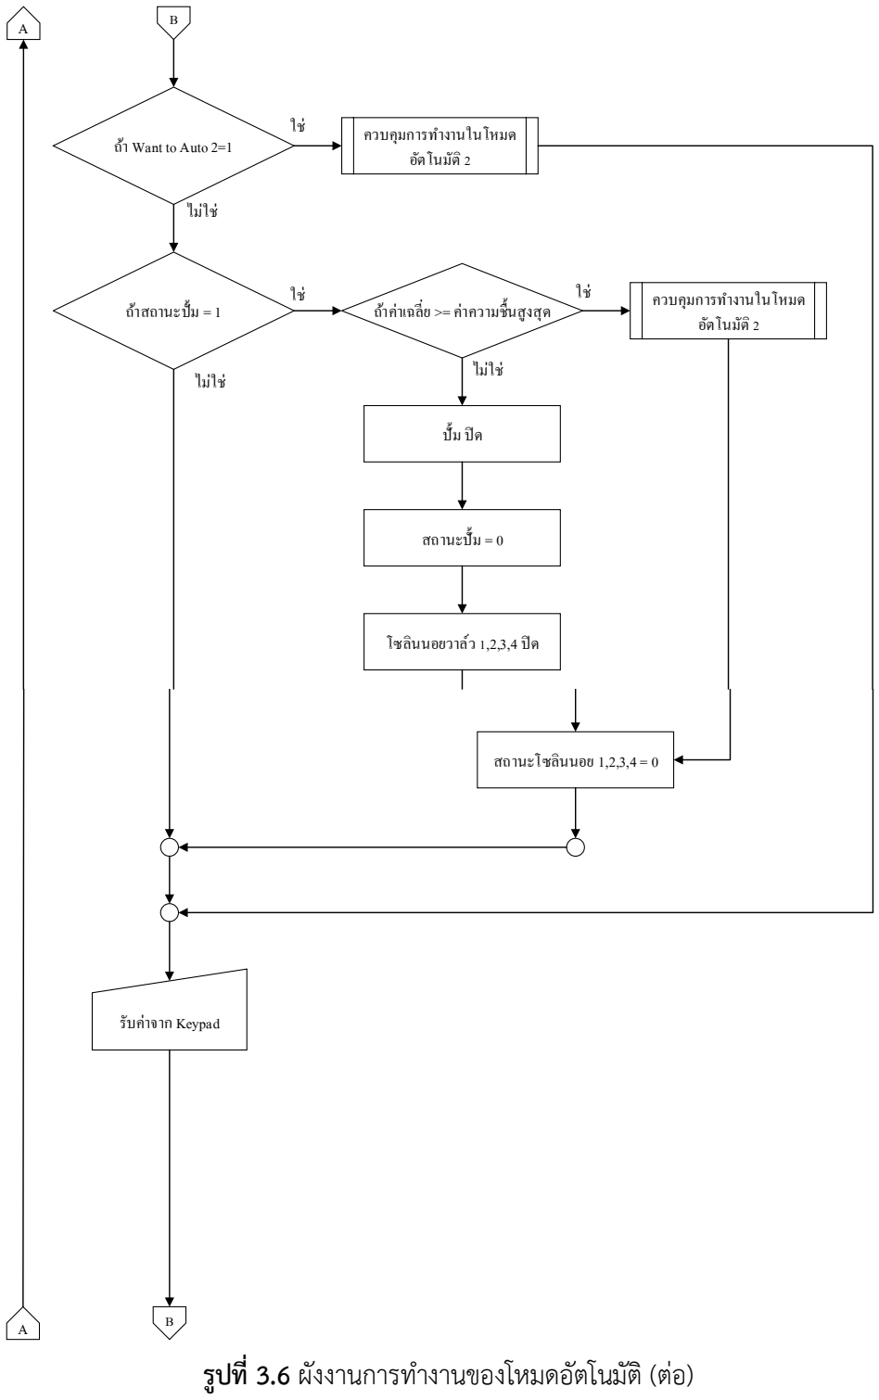
[picture p173: figure]
Want to Auto 2=1; Keypad; รูปที่3.6 ผังงานการท างานของโหมดอัตโนมัติ(ต่อ)

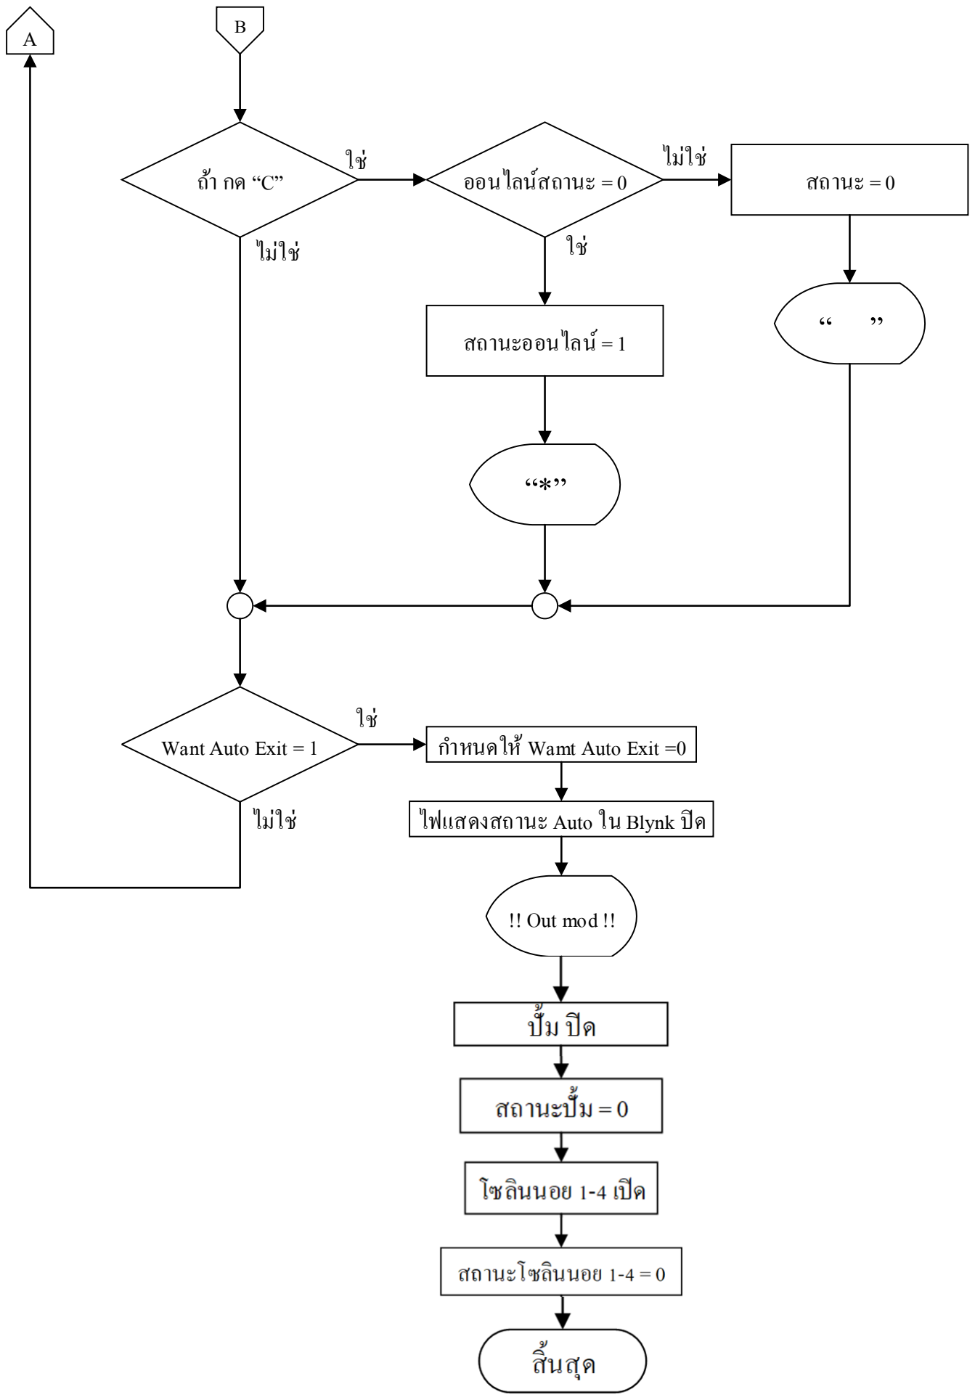
[picture p174: figure]
Want Auto Exit = 1; Wamt Auto Exit =0; Auto Blynk; !! Out mod !!

รูปที่3.6 ผังงานการท างานของโหมดอัตโนมัติ(ต่อ)

### 3.3.5 ผังงำนกำรท ำงำนของโหมดกำรท ำงำนตำมช่วงเวลำ (Time r& Auto Mode)

ผังงานขั้นตอนการท างานของโหมดการท างานตามช่วงเวลา เป็นส่วนของโปรแกรมส าหรับการ ท างานตามเงื่อนไข ช่วงเวลาการท างาน และค่าความชื้นที่ก าหนด จะแสดงได้ดังรูปที่ 3.7

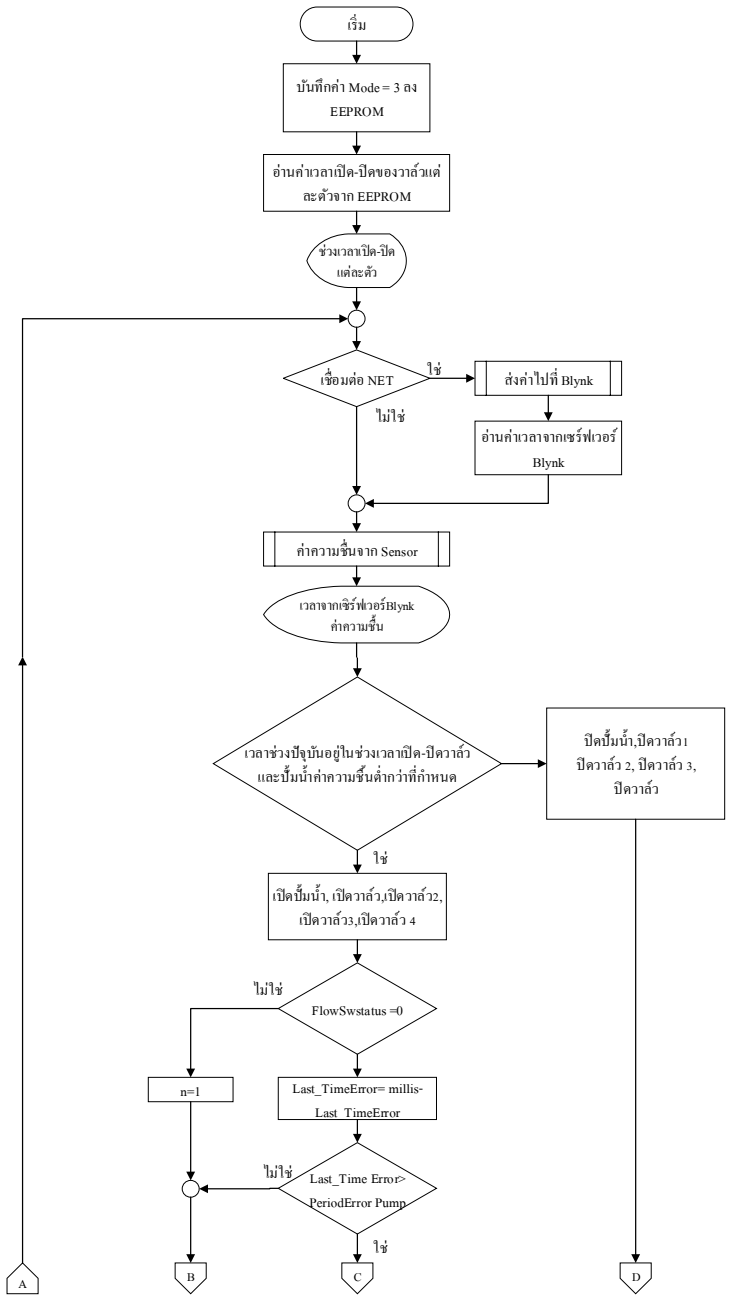
[picture p175: figure]
Mode = 3 EEPROM; - EEPROM; NET; Blynk; Sensor; FlowSwstatus =0; Last_TimeError= millis-; Last_TimeError; Last_Time Error> PeriodError Pump

รูปที่ 3.7 ผังงานการท างานโหมดการท างานตามช่วงเวลา

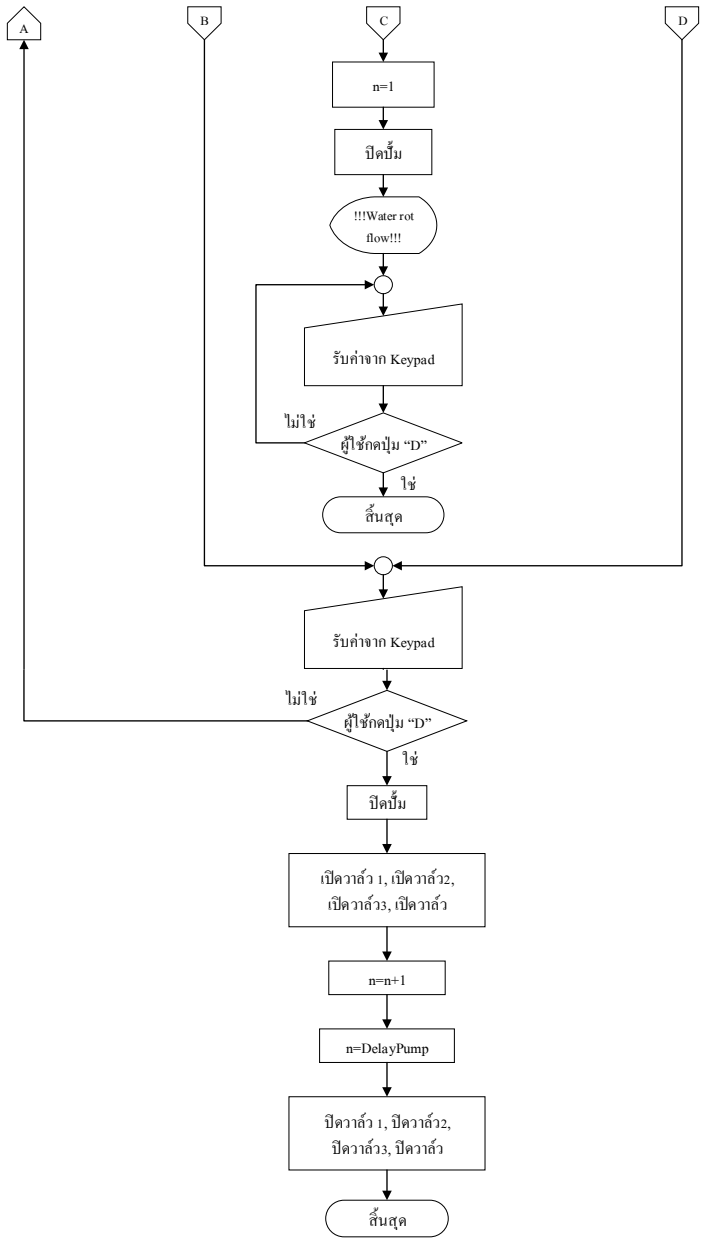
[picture p176: figure]
!!!Water rot flow!!!; Keypad; n=DelayPump

รูปที่ 3.7 ผังงานการท างานโหมดการท างานตามช่วงเวลา (ต่อ)

จากรูปที่ 3.7 แสดงขั้นตอนการท างานของระบบการให้น้ าตามช่วงเวลา จะเริ่มจากบันทึกค่า โหมดลงใน EEPROM หลังจากนั้นอ่านค่าคงที่เดิมจาก EEPROM แสดงหน้าเมนูและช่วงเวลาของการ ท างานเดิม อ่านเวลาจากเซิร์ฟเวอร์Bylnk และค่าความชื้นจากเซ็นเซอร์แล้วจะแสดงหน้าเมนูระบบจะ ท างานตามเงื่อนไข ถ้าเวลาช่วงปัจจุบันอยู่ในช่วงเปิดปั๊มน้ าและค่าความชื้นต่ ากว่าที่ก าหนด ปั๊มจะเริ่ม

ท างาน หากกรณีน้ าไม่ไหลแต่ปั๊มท างาน Flow Switch จะนับรอบเพื่อตรวจสอบว่าน้ าไหลหรือไม่ ถ้าน้ า ไม่ไหลระบบจะสั่งให้ปั๊มหยุดการท างานทันทีแล้วจะแสดงข้อความว่า !!!Water Not Flow!!! ผู้ใช้กดปุ่ม D ระบบก็จะสิ้นสุดการท างานในโหมดการท างานตามช่วงเวลา กรณีน้ าไม่ไหลระบบจะสั่งให้ปั๊มหยุดการ ท างานทันทีแล้วจะแสดงข้อความว่า !!!Water Not Flow!!! ผู้ใช้กดปุ่ม D ระบบก็จะสิ้นสุดการท างานใน โหมดการท างานตามช่วงเวลา

### 3.3.6 ผังงำนกำรท ำงำนของโหมดผู้ใช้ก ำหนดเอง (Manual Mode)

ผังงานขั้นตอนการท างานของโหมดผู้ใช้ก าหนดเอง เป็นส่วนของโปรแกรมส าหรับการท างานตาม เงื่อนไข โดยผู้ใช้ควบคุมการเปิดปิดปั๊มน้ าเอง จะแสดงได้ดังรูปที่ 3.8

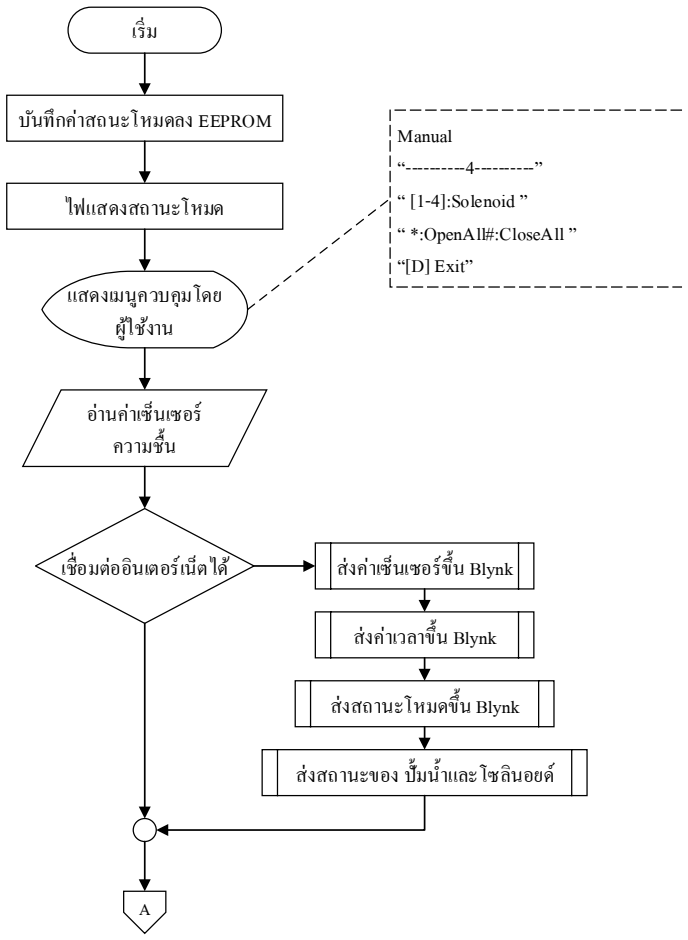
[picture p177: figure]
EEPROM; Blynk; Manual ---------- ---------- [1-4]:Solenoid *:OpenAll#:CloseAll D] Exit

รูปที่ 3.8 ผังงานการท างานโหมดผู้ใช้ก าหนดเอง

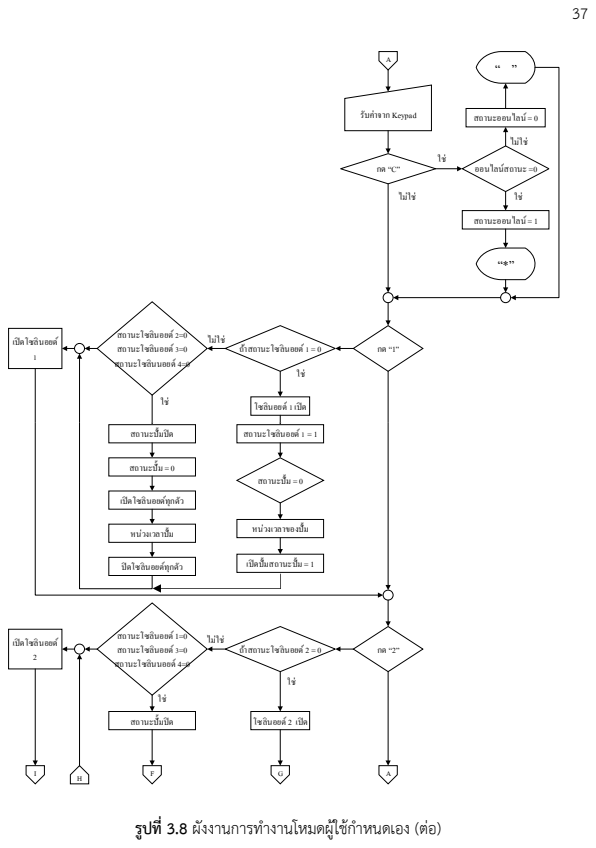
[picture p178: page 54]
Keypad

รูปที่3.8 ผังงานการท างานโหมดผู้ใช้ก าหนดเอง (ต่อ)

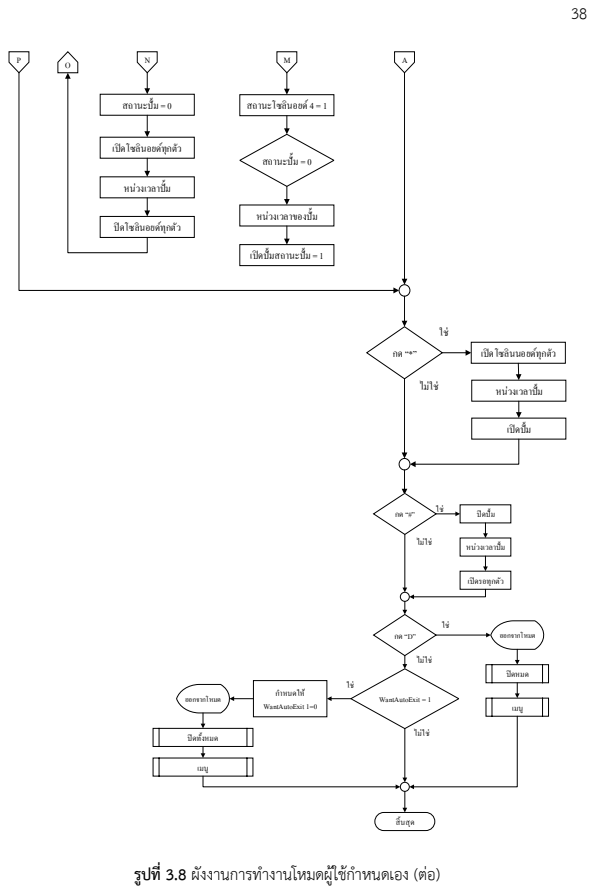
[picture p179: page 55]
WantAutoExit = 1; WantAutoExit 1=0

รูปที่ 3.8 ผังงานการท างานโหมดผู้ใช้ก าหนดเอง (ต่อ)

จากรูปที่ 3.8 แสดงขั้นตอนการท างานของโหมดผู้ใช้ก าหนดเอง จะเริ่มจากบันทึกค่าโหมดลงใน EEPROM หลังจากนั้นอ่านสถานะของปั๊มจาก EEPROM แสดงหน้าเมนูเมื่อผู้ใช้กดปุ่ม 1 ระบบก็จะสั่งให้ ปั๊มและวาล์วตัวที่ 1 เปิดการท างาน ถ้าผู้ใช้กดปุ่ม 1 อีกครั้งระบบก็จะสั่งให้ปั๊มและวาล์วที่ 1 หยุดการ
ท างาน หากกรณีน้ าไม่ไหลแต่ปั๊มท างาน Flow Switch จะนับรอบเพื่อตรวจสอบว่าน้ าไหลหรือไม่ถ้าน้ า ไม่ไหลระบบจะสั่งให้ปั๊มหยุดการท างานทันทีแล้วจะแสดงข้อความว่า !!!Water Not Flow!!! ผู้ใช้กดปุ่ม D ระบบก็จะสิ้นสุดการท างานในโหมดอัตโนมัติ

บทที่ 4
กำรพัฒนำระบบงำน

บทนี้จะเป็นการกล่าวถึงการพัฒนาระบบงานเพื่อสร้างระบบให้สามารถท างานได้ตามขอบเขตที่ ผู้วิจัยได้ก าหนดไว้ส าหรับงานวิจัยที่ผู้วิจัยด าเนินการนี้จะต้องท าการออกแบบใน 2 ส่วนด้วยกันคือ การ ออกแบบระบบทางด้านฮาร์ดแวร์ซึ่งเป็นการออกแบบการเชื่อมต่ออุปกรณ์ต่าง ๆ ให้ท างานร่วมกันได้ อย่างถูกต้องเพื่อควบคุมอุปกรณ์ที่ได้ก าหนดไว้อีกส่วนคือการออกแบบทางด้านซอฟต์แวร์ซึ่งเป็นการ ออกแบบส่วนติดต่อผู้ใช้ การออกแบบการแสดงผลที่แอพพลิเคชั่น และ ที่หน้าจอตรงตุ้ควบคุมระบบ โดย มีรายละเอียดทั้งสองส่วนดังต่อไปนี้

4.1กำรเชื่อมต่ออุปกรณ์ทำงด้ำนฮำร์ดแวร์ ในส่วนนี้จะเป็นการเชื่อมต่ออุปกรณ์ทางด้านฮาร์ดแวร์ที่จะน าอุปกรณ์ต่าง ๆ ที่ใช้ในการควบคุม ระบบการให้น้ าในส่วนสละโดยอัตโนมัติ ซึ่งจะเป็นการเชื่อมต่อประสานอุปกรณ์ต่าง ๆ ได้แก่ เซนเซอร์วัด ความชื้นในดิน บอร์ดประมวลผล บอร์ดเชื่อมต่ออินเทอร์เน็ต โมดูลรีเลย์ คีย์แพด เป็นต้น โดยจะแบ่งการ อธิบายเป็น 2 ส่วนย่อย เป็นการเชื่อมต่ออุปกรณ์หน้าตู้ควบคุม และ การเชื่อมต่ออุปกรณ์ภายในตู้ควบคุม

### 4.1.1 กำรเชื่อมต่ออุปกรณ์หน้ำตู้ควบคุม

การเชื่อมต่ออุปกรณ์หน้าตู้ควบคุม จะเป็นส่วนส าหรับผู้ใช้งานระบบ สั่งให้ระบบท างานผ่านการ กดค่าคีย์แพดที่ติดไว้บริเวณหน้าตู้ แล้วการท างานของระบบจะแสดงผลออกมาแสดงที่ หน้าจอ LCD และ หลอดไฟ LED ที่หน้าตู้ระบบยังมีสวิตช์ส าหรับ เปิด ปิด การท างานของตู้ควบคุมระบบ ส าหรับการ เชื่อมต่ออุปกรณ์ต่าง ๆ ที่บริเวณหน้าตู้ระบบ แสดงดังรูปที่ 4.1

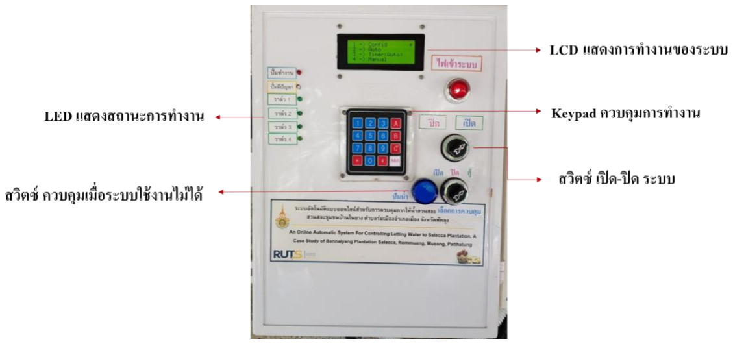
[picture p180: figure]

รูปที่ 4.1 การเชื่อมต่ออุปกรณ์ทางด้านฮาร์ดแวร์ที่หน้าตู้ควบคุมระบบ

### 4.1.2 กำรเชื่อมต่ออุปกรณ์ภำยในตู้ควบคุม

ในส่วนนี้จะเป็นการเชื่อมต่ออุปกรณ์ต่าง ๆ ทางด้านฮาร์ดแวร์ ที่อยู่ภายในตู้ควบคุมระบบ ซึ่ง ภายในตู้จะประกอบไปด้วย
1. แหล่งจ่ายไฟกระแสตรงขนาด 12 โวลต์ (Power Supply)
2. แหล่งจ่ายไฟกระแสสลับขนาด 24 โวลต์
3. บอร์ดลดแรงดันไฟฟ้าจาก 12 โวลต์ เป็น 5 โวลต์
4. บอร์ดประมวลผลกลาง Arduino Mega2560
5. บอร์ดเชื่อมต่ออินเตอร์เน็ต
6. แผงวงจรรีเลย์โมดูล
7. โมดูลเซนเซอร์วัดความชื้น
8. แผงเทอร์มินอลส าหรับยึดสายไฟ
ส าหรับการเชื่อมต่ออุปกรณ์ต่าง ๆ เข้าด้วยกัน รวมถึงการจัดวางต าแหน่งของอุปกรร์ภายในตู้ แสดงได้ดังรูปที่ 4.2

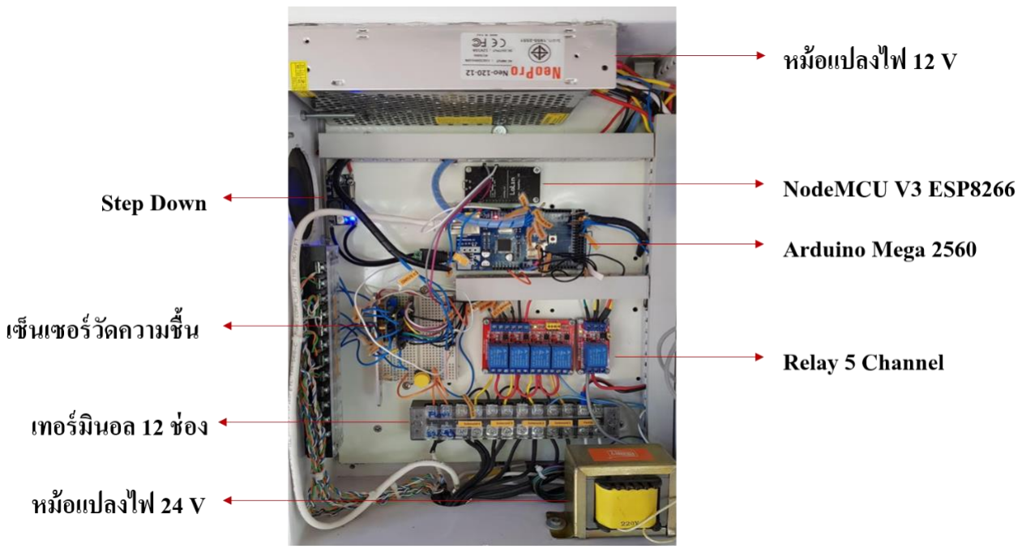
[picture p181: figure]

รูปที่ 4.2 แสดงการเชื่อมต่ออุปกรณ์ทางด้านฮาร์ดแวร์ภายในตู้ควบคุมระบบ

4.2กำรออกแบบหน้ำจอแสดงผลที่ตู้ควบคุมระบบ ในส่วนนี้จะเป็นการอธิบายการออกแบบหน้าจอแสดงผลบริเวณหน้าตู้ควบคุมระบบ เพื่อให้ ผู้ใช้งานระบบได้เห็นสถานะของระบบว่ามีการท างานในโหมดใด มีค่าความชื้นในดินเท่าไหร่บ้างของ เซนเซอร์วัดความชื้นแต่ละตัว โดยมีรายละเอียดของการออกแบบหน้าจอดังนี้

### 4.2.1 หน้ำจอหลักของระบบ

หน้าจอหลักจะแสดงผลเมื่อมีการเข้าระบบและยังไม่มีการสั่งให้ระบบท าการให้น้ า หน้าจอหลักนี้ จะเป็นหน้าจอแรก เมื่อเปิดระบบให้ท างานเพื่อรอให้ผู้ใช้ระบบสั่งการว่าต้องการท าสิ่งใดโดยการกดปุ่มคีย์ แพทที่หน้าตู้ควบคุมระบบเป็นตัวเลข 4 ตัว ได้ เลข 1 เมื่อต้องการเข้าไปตั้งค่าระบบ เลข 2 เมื่อต้องการ เข้าระบบเพื่อท างานแบบ Auto เลข 3 เมื่อต้องการเข้าระบบเพื่อท างานแบบ Timer Auto หรือการ ท างานตามเวลาที่ก าหนดโดยไม่ขึ้นกับค่าความชื้นในดิน และกด เลข 4 เมื่อต้องการควบคุมแบบ Manual โดยรายละเอียดแสดงดังรูปที่ 4.3

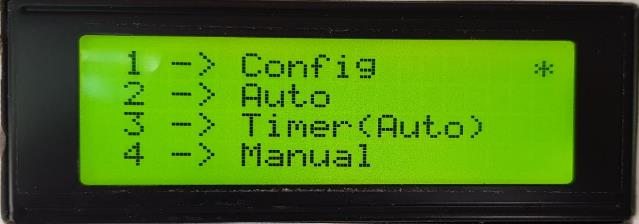
[picture p182: figure]

รูปที่4.3 หน้าจอหลักของระบบ จากรูปที่ 4.3 จะเห็นว่าข้อความที่แสดงผลที่หน้าจอ LCD จะแสดงตัวเลขแล้วตามด้วย ข้อความ เป็นภาษาอังกฤษในแต่ละบรรทัด เพื่อบกบอกให้ผู้ใช้ทราบว่าหากต้องการเข้าเมนูใด ให้กดปุ่มตัวเลขที่ ต้องการที่ปุ่มคีย์แพทที่อยู่หน้าตู้ ส าหรับ Code ของโปรแกรมที่ท าให้เกิดการแสดงผลและท างานตาม ต้องการจากการกดปุ่ม ตัวเลข 1 ถึง 4 ได้นั้น แสดงดังรูปที่ 4.4

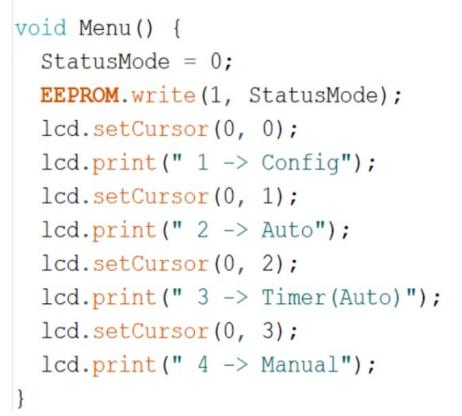
[picture p183: figure]

รูปที่ 4.4 โค้ดโปรแกรมส าหรับการแสดงข้อความหน้าจอหลัก

### 4.2.2 หน้ำจอกำรตั้งค่ำระบบ

หน้าจอแสดงผลนี้จะแสดงตัวเลือกในการท างาน การตั้งค่าความชื้นสูงสุด การตั้งค่าความชื้น ต่ าสุด ตั้งค่าช่วงเวลาการท างาน และการตั้งค่าช่วงเวลาโหมดอัตมัติแสดงได้ดังรูปที่ 4.5

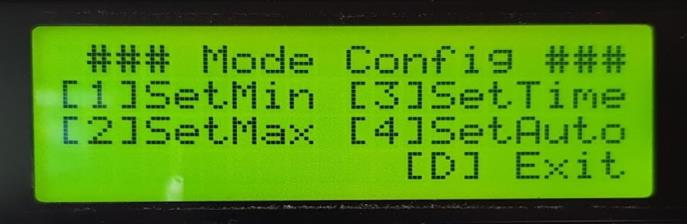
[picture p184: figure]

รูปที่ 4.5 หน้าจอการตั้งค่าระบบ

จากรูปที่ 4.5 จะเป็นหน้าจอเมื่อผู้ใช้งานกดเลข 1 จากเมนูหลัก เพื่อเข้ามาสู่โปรแกรมส าหรับตั่ง ค่าต่าง ๆ ของระบบ จากหน้าจอนี้จะเป็นการบอกให้ผู้ใช้เลือกว่าต้องการจะตั้งค่าใด ซึ่งประกอบด้วย 4 ค่าต่าง ๆ ดังนี้
1. กดปุ่ม 1 หมายถึง ตั้งค่าความชื้นต่ าสุด (Set Min)
2. กดปุ่ม 2 หมายถึง ตั้งค่าความชื้นสูงสุด (Set Max)
3. กดปุ่ม 3 หมายถึง ตั้งค่าเวลาการให้น้ า (Set Time)
4. กดปุ่ม 4 หมายถึง การตั้งค่าช่วงเวลาโหมดอัตโนมัติ(Set Auto)
ส าหรับ Code โปรแกรมที่ให้เกิดผลของการท างานในส่วนของการตั้งค่าระบบแสดงได้ ดังรูปที่ 4.6

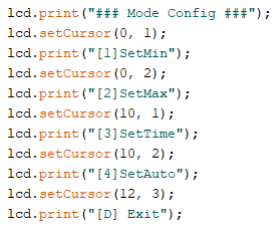
[picture p185: figure]

รูปที่ 4.6 โค้ดโปรแกรมส าหรับตั้งค่าระบบ

### 4.2.3 หน้ำจอโหมด Auto

หน้าโหมด Auto หน้าจอนี้จะเข้ามาเมื่อผู้ใช้งานระบบกดค าสั่งให้มีการท างานแบบ Auto ซึ่งจะ เป็นการให้น้ าในสวนเมื่อค่าความชื้นเฉลี่ยน้อยกว่าที่ก าหนดไว้ โดยไม่สนใจว่าเป็นเวลาใด ส าหรับข้อมูลที่ แสดงผลจะประกอบไปด้วย ค่าความชื้นในดินจากเซนเซอร์แต่ละตัว และค่าความชื้นเฉลี่ย รายละเอียด แสดงดังรูปที่ 4.7

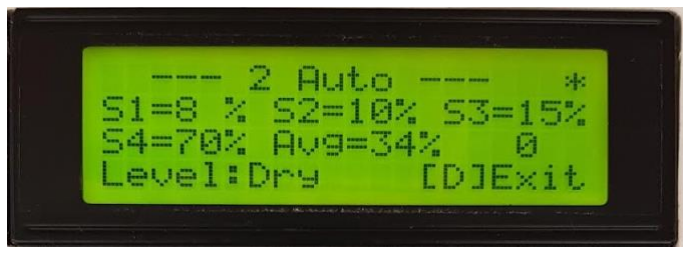
[picture p186: figure]

รูปที่ 4.7 หน้าจอแสดงผลเมื่อเข้าสู่โหมด Auto

### 4.2.4 หน้ำจอโหมด Timer Auto

การแสดงผลหน้าจอ Timer Auto หน้าจอนี้จะเข้ามาแสดงผลเมื่อผู้ใช้สั่งควบคุมระบบให้ท างาน อัตโนมัติตามเวลาที่ก าหนดไว้ ข้อมูลที่แสดงผลในหน้าจะดังกล่าวจะประกอบด้วย ค่า % ความชื้อแต่ละ ตัว ค่าความชื้นเฉลี่ย เวลาที่ท าการรดน้ าในแต่ละแถว เช่น 17:00 – 17:20 หมายถึงจะท าการรดน้ าที่เวลา ห้าโมงเย็น ถึง ห้าโมงยี่สิบนาที เป็นเวลา 20 นาที โดยข้อมูลในแต่ละแถวที่แสดงผลที่หน้าจอ LCD หมายถึง เวลาการเปิดวาล์วรดน้ าในแต่ละแถว ซึ่งค่าเวลานี้จะท าการค านวณโดยอัตโนมัติ จากการตั้ง ค่าคงที่ไว้ จากเมนู ที่ 1 หน้าตั้งค่าคงที่ของระบบ (Config) แล้วเลือก Set Time ส าหรับหน้าจอในโหมด Timer Auto แสดงได้ดังรูปที่ 4.8

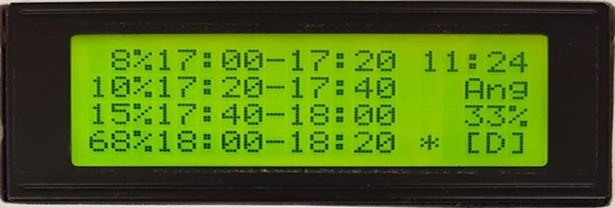
[picture p187: figure]

รูปที่ 4.8 หน้าจอแสดงผลเมื่อเข้าสู่การท างานแบบ Timer Auto

### 4.2.5 หน้ำจอโหมด Manual

การแสดงผลหน้าจอในโหมด Manual จะมีการแสดงผลข้อความที่บ่งบอกถึงการกดตัวเลข 1 – 4 เพื่อเป็นการเลือกเปิดโซลินอยวาล์วตามล าดับแถวที่ต้องการให้รดน้ าในสวนสละ โดยการท างานเมื่อมีการ กดปุ่มตัวเลข 1 2 3 หรือ 4 จะเป็นการสั่งให้ปั๊มน้ าท างานและเปิดวาล์วน้ าของแถวนั้น ซึ่งเมื่อกดอีกครั้งก็ จะเป็นการปิดวาล์ว โดยหน้าจอแสดงได้ดังรูปที่ 4.9

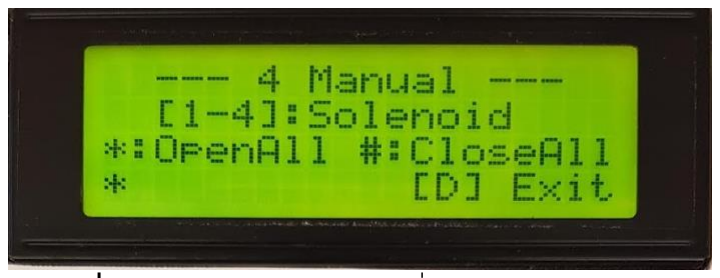
[picture p188: figure]

รูปที่ 4.9 หน้าจอการท างานเมื่อเข้าโหมด Manual

4.3กำรออกแบบแอพพลิเคชั่นที่ใช้ในกำรควบคุมระบบ
แอพพลิเคชั่นส าหรับควบคุมการท างานของระบบ จะเป็นการควบคุมในกรณีที่ผู้ใช้งานต้องการ ควบคุมระบบแบบออนไลน์ แอพพลิเคชั่นนี้สร้างโดยแฟลตฟอร์มของแอพพลิเคชั่น Blynk โดยมีส่วนที่ เป็นการแสดงผลจะประกอบด้วย สถานะของโหมดที่ท างาน ค่าความชื้นในดินจากเซนเซอร์แต่ละตัว ค่า ความชื้นเฉลี่ย และค่าเวลาเปิดปิดของวาล์วน้ าแต่ละตัวที่ได้ก าหนดไว้ ส าหรับปุ่มค าสั่งที่ใช้ในการควบคุม ระบบด้วยแอพพลิเคชั่นจะประกอบไปด้วย ปุ่มกดเพื่อเลือกการท างานของระบบ ปุ่มกดเพื่อเลือกการเปิด ปิด วาล์วน้ าแต่ละแถวที่ต้องการรดน้ าในสวน โดยการจัดวางต าแหน่งของส่วนการแสดงผลและปุ่มค าสั่ง แสดงดังรูปที่ 4.10

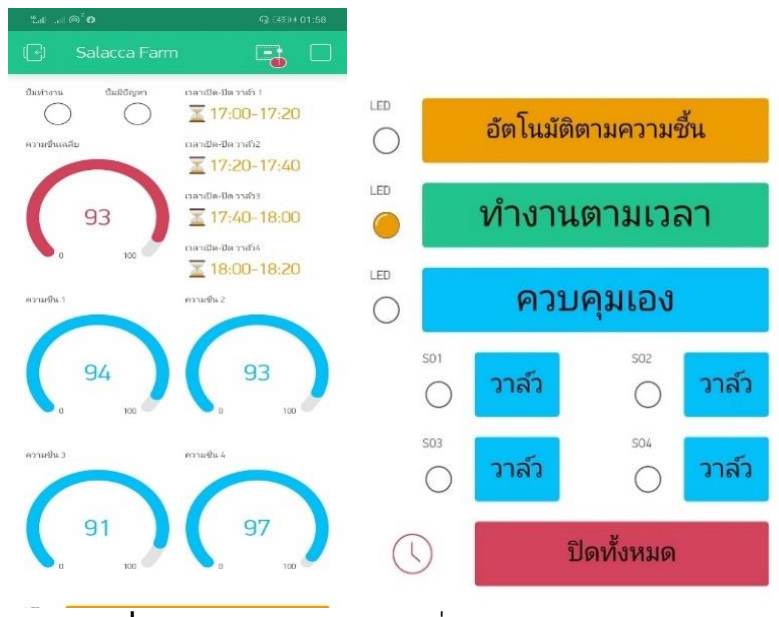
[picture p189: figure]

รูปที่ 4.10 แสดงแอพพลิเคชั่นในการควบคุมระบบ

บทที่ 5
สรุปผลกำรทดลอง

ในบทที่จะเป็นการสรุปผลการทดลองระบบที่ได้พัฒนาขึ้นเพื่อให้ได้ทราบถึงประสิทธิภาพการ ท างานของระบบให้น้ าในสวนสละแบบอัตโนมัติ ว่าระบบสามารถควบคุมปั๊มน้ าและโซลินอยวาล์วให้ ท างานได้ถูกต้องตามเงื่อนไขที่ก าหนดไว้ได้อย่างแม่นย าหรือไม่ ในการทดลองระบบผู้วิจัยได้ท าการติดตั้ง อุปกรณ์เพิ่มเติมภายในสวนสละที่ใช้เป็นกรณีศึกษา ได้แก่ การติดตั้งตู้ควบคุม การติดตั้งโซลินอยวาล์ว การเดินสายไฟเพื่อควบคุมโซลินอยวาล์วจากตู้ควบคุมระบบ การติดตั้งเซนเซอร์วัดความชื้นในดิน การ ติดตั้ง Flow Switch เพื่อตรวจจับการไหลของน้ าจากการท างานของปั๊มน้ า การติดตั้ง Pressure Switch เพื่อป้องกันระบบท่อน้ าแตกจากแรงดันน้ า หลังจากนั้นผู้วิจัยจึงได้เปิดระบบให้ท างานในโหมดต่าง ๆ และ เฝ้าสังเกตุการท างานของระบบว่าระบบได้ท างานถูกต้องแม่นย าตามเงื่อนไขหรือไม่ โดยมีรายละเอียดดังนี้ 5
5.1กำรติดตั้งระบบ
การติดตั้งระบบทางผู้วิจัยได้ติดตั้งอุปกรณ์ต่าง ๆ ที่ใช้ในการทดลองระบบได้แก่ ตู้ควบคุมระบบ รติดตั้งโซลินอยวาล์ว เดินสายไฟเพื่อควบคุมโซลินอยวาล์วจากตู้ควบคุมระบบ ติดตั้งเซนเซอร์วัดความชื้น ในดิน ติดตั้ง Flow Switch เพื่อตรวจจับการไหลของน้ าจากการท างานของปั๊มน้ า การติดตั้ง Pressure Switch เพื่อป้องกันระบบท่อน้ าแตกจากแรงดันน้ า โดยมีรายละเอียดของการติดตั้งดังนี้

### 5.1.1 กำรติดตั้งตู้ควบคุม

ตู้ควบคุมระบบผู้วิจัยได้ท าการติดตั้งบริเวณหน้าห้องส าหรับเก็บปั๊มน้ า โดยดึงสายไฟฟ้ามาจาก ภายในห้อง รอยสายผ่านท่อพลาสติกเข้ามายังภายในกล่องคุม ดังรูปที่ 5.1

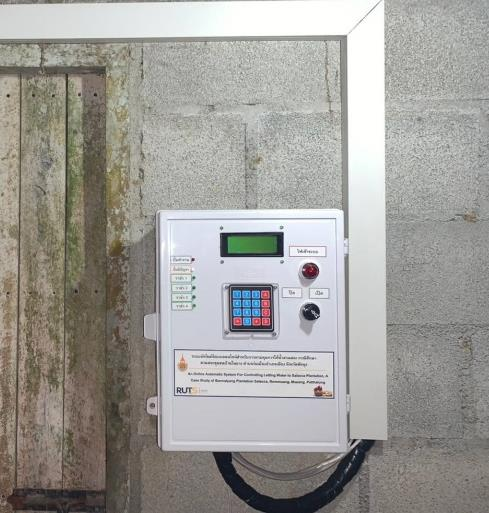
[picture p190: figure]

รูปที่ 5.1 แสดงการติดตั้งกล่องควบคุมระบบ

### 5.1.2 กำรติดตั้งโซลินอยวำล์ว

โซลินอยวาล์วเป็นวาล์วน้ าที่เปิดปิดด้วยไฟฟ้า ในงานวิจัยนี้ได้เลือกใช้โซลินอยวาล์วที่ใช้ แรงดันไฟฟ้าขนาด 24 โวลต์กระแสสลับ ในการเปิดปิดวาล์ว และเป็นโซลินอยวาล์วแบบอาศัยแรงดันน้ า ในการติดตั้งโซลินอยวาล์วได้ติดตั้งขนานไปกับวาล์วเดิมของทางสวนสละ เพื่อให้วาล์วเดิมเป็นวาล์วส ารอง ที่จะเปิดให้น้ าไหลผ่านได้กรณีที่ระบบอัตโนมัติช ารุด ส าหรับการติดตั้งแสดงดังรูปที่ 5.2

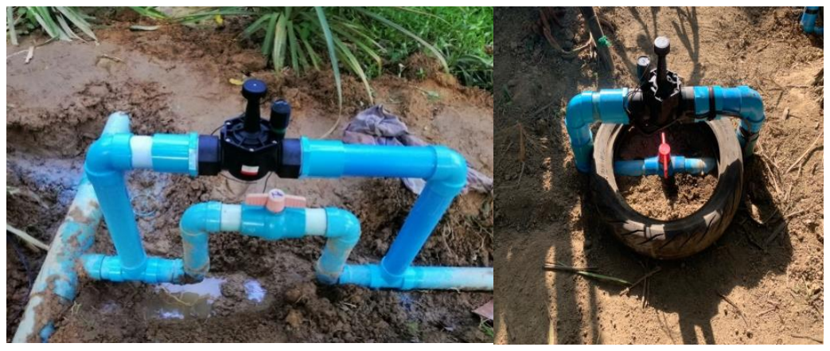
[picture p191: figure]

รูปที่ 5.2 แสดงการติดตั้งโซลินอยวาล์วขนานกับวาล์วเดิม

### 5.1.3 กำรติดตั้งเซนเซอร์วัดค่ำควำมชื้นในดิน

การติดตั้งเซนเซอร์วัดค่าความชื้นในดิน มีการติดตั้งบริเวณโคนต้นสละ ท าการฝังเซนเซอร์ลงไป ในดินประมาณ 5 เซนติเมตร เนื่องจากต้นสละมีการแผ่กระจายรากอยู่บริเวณหน้าดิน การท างานของ เซนเซอร์วัดค่าความชื้นในดิน คือ รับค่าความชื้นส่งมายังตู้ควบคุมเพื่อท าการ เปิด-ปิด โซลินอยด์วาล์ว เมื่อผู้ใช้เลือกโหมดการท างานอัตโนมัติและ โหมดท างานตามเวลา ระบบจะมีการตรวจสอบค่าความชื้น ในดินเพื่อท าการให้น้ าต้นสละ ถ้ามีค่าความชื้นต่ ากว่า 60-70 % จะมีการท างานอัตโนมัติเมื่อค่าความชื้น ในดินสะสมถึง 70 % ระบบจะตัดการท างานทันทีโดยการติดตั้งแสดงได้ดังรูปที่ 5.3

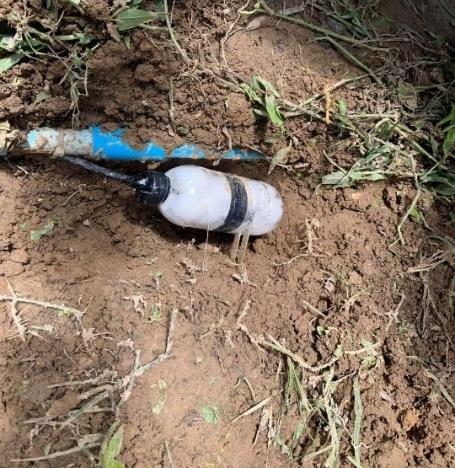
[picture p192: figure]

รูปที่ 5.3 แสดงการติดตั้งเซนเซอร์วัดความชื้นในดิน

### 5.1.4 กำรติดตั้ง Flow Switch

Flow Switch จะเป็นอุปกรณ์ส าหรับตรวจจับการไหลของน้ า ซึ่งจะถูกติดตั้งบนท่อน้ าขาออก ของปั๊มน้ า เมื่อปั๊มน้ าท างานและสามารถดูดน้ าจากบ่อขึ้นมาได้จะท าให้มีแรงดันน้ าไปกระทบกับใบพาย ของ Flow Switch ท าให้ Flow Switch ต่อวงจรให้มีสัญญาณส่งไปยังกล่องควบคุมที่ได้มีการโปรแกรม เพื่อตรวจสอบการท างานของ Flow Switch เมื่อระบบสั่งให้ปั๊มน้ าท างาน แต่หากว่าปั๊มน้ าถูกสั่งให้ ท างานแล้วแต่ไม่มีแรงดันน้ าไหลฝ่าย Flow Switch ซึ่งนั้นหมายถึงปั๊มน้ าท างานผิดปกติที่สามารถดูดน้ า ขึ้นจากบ่อน้ าได้ ระบบก็จะสั่งให้ปั๊มน้ าหยุดท างานทันที เพื่อป้องกันไม่ให้ปั๊มน้ าเสียหาย ส าหรับการติดตั้ง Flow Switch แสดงดังรูปที่ 5.4

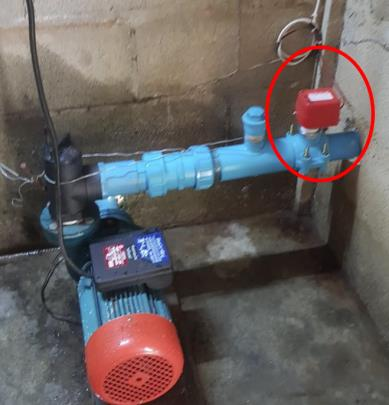
[picture p193: figure]
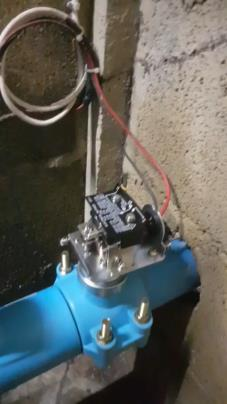
[picture p194: figure]

รูปที่ 5.4 แสดงการติดตั้ง Flow Switch

### 5.1.5 กำรติดตั้ง Pressure Switch

Pressure Switch เป็นอุปกรณ์ส าหรับตรวจจับแรงดันของน้ าในระบบท่อ เมื่อแรงดันในท่อน้ าสูง กว่าที่ตั้งค่าไว้ Pressure Switch จะท าการตัดวงจรไฟฟ้าไม่ให้ไฟฟ้าไหลผ่าน ด้วยหลักการนี้ทางผู้วิจัยจึง น้ ามาใช้ในการส่งสัญญาณไปยังตู้ควบคุมระบบให้ท าการตัดการท างานของปั๊มน้ าเพื่อไม่ให้ปั๊มน้ าดันน้ าใน ท่อภายในสวนแตกหรือหลุดได้ โดยการติดตั้งแสดงดังรูปที่ 5.5

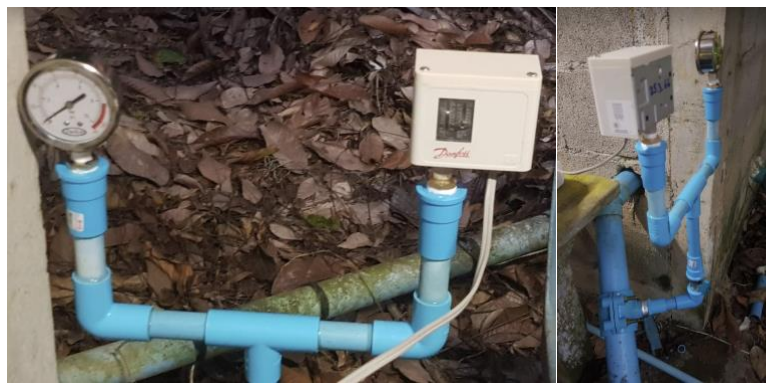
[picture p195: figure]

รูปที่ 5.5 แสดงการติดตั้ง Pressure Switch

### 5.1.6 กำรเดินสำยสัญญำณ

สายสัญญาณที่ใช้ในการติดตั้งระบบจะประกอบไปด้วยสายสัญญาณจากเซนเซอร์วัดความชื้นใน ดินจ านวน 4 ตัว และสายสัญญาณที่ตู้ควบคุมส่งไปเปิดให้โซลินอยวาล์วท างาน การเดินสายสัญญาณนี้ ผู้วิจัยได้ท าการเดินสายในแนวเดียวกับเดินท่อน้ าภายในสวนเพื่อป้องกันการขุดหรือท าให้สายสัญญา เสียหาย โดยมีรายละเอียดของการเดินสายสัญญาณดังรูปที่ 5.6

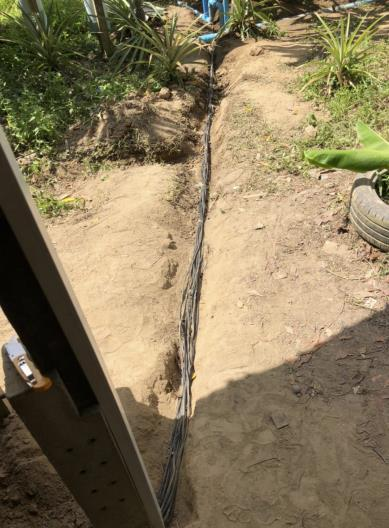
[picture p196: figure]
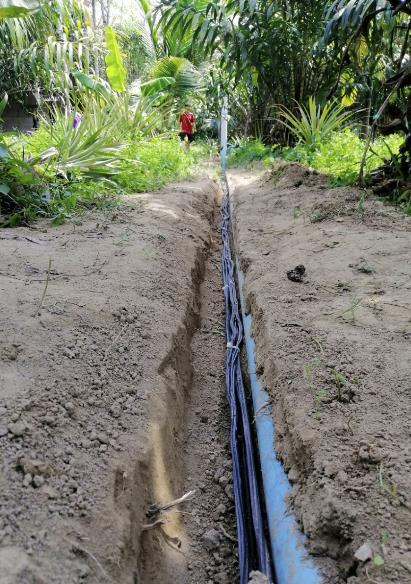
[picture p197: figure]

รูปที่ 5.6 แสดงการเดินสายสัญญาณ 5.2กำรทดสอบระบบ
ในการทดสอบการใช้งานระบบจะท าการทดสอบเป็นส่วน ๆ เพื่อวัดประสิทธิภาพการท างานของ ระบบแยกเป็นการทดสอบดังต่อไปนี้

### 5.2.1 ทดสอบในโหมด Manual

การท างานในโหมดนี้จะเป็นการสั่งให้ระบบรับค าสั่งเพื่อเปิดปิดวาล์วแต่ละแถวจากการสั่งการ จากผู้ใช้โดยตรง โดยไม่ขึ้นกับเวลาและค่าความชื้นในดิน หรือกล่าวได้ว่าเป็นการสั่งเปิดปิดวาล์วให้รดน้ า แต่ละแถวตามอัธยาศัยของผู้ใช้งานระบบเอง ในการทดสอบได้ท าการทดสอบทั้งแบบ Onsite จากการกด ปุ่มคีย์แพดที่ปุ่มหน้าตู้ และสั่งผ่านแอพพลิเคชั่น ผลปรากฎว่าระบบสามารถสั่งเปิดปิดวาล์วน้ าได้อย่าง ถูกต้องและเมื่อมีการสั่งให้วาล์วเปิดปั๊มน้ าก็จะท างานทันทีเพื่อเป็นการเพิ่มความสะดวกในการใช้งาน ระบบ โดยในโปรแกรมที่ผู้วิจัยได้พัฒนาขึ้นจะใช้เงือนไขให้ปั๊มน้ าท างานเมื่อมีการเปิดวาล์วน้ าแถวใด แถวนึง และจะหยุดท างานทันทีเพื่อวาล์วน้ าทุกแถวได้ปิดลง ทั้งนี้เพื่อป้องกันการหลงลืมปิดปั๊มเมื่อวาล์ว ถูกปิดทั้งหมดแล้ว

### 5.2.2 ทดสอบในโหมด Auto

การท างานในโหมด Auto จะเป็นการสั่งให้ระบบรดน้ าในสวนและสลับวาล์วน้ าตามค่าความชื้น เฉลี่ยที่ค านวณได้ โดยไม่ขึ้นอยู่กับเวลาหมายถึง เมื่อความชื้นเฉลี่ยน้อยกว่าค่าที่ก าหนดไว้ระบบจะสั่งเปิด วาล์วน้ าและปั๊มน้ าให้ท างานแล้วท าการสลับแถวการรดน้ าไปตามระยะเวลาที่ก าหนดไว้ว่าต้องการรดน้ า แถวละกี่นาที เมื่อรดน้ าครบทุกแถวแล้วระบบจะสั่งปิดปั๊มน้ าให้โดยอัตโนมัติ ผลจากการทดลองใช้งาน ระบบในโหมด Auto พบว่าระบบท างานได้ถูกต้องตามเงื่อนไขที่ก าหนดไว้นั้นคือ เมื่อค่าความชื้นเฉลี่ย น้อยกว่าที่ก าหนดไว้ระบบก็จะท าการเปิดวาล์วตัวที่ 1 แล้วตามด้วยเปิดปั๊มน้ าตามหลัง และเมื่อแต่ละแถว ได้ท าการรดน้ าครบเวลาที่มีหน่วยเป็นนาทีแล้วระบบก็จะท าการเปิดวาล์วตัวถัดไปซึ่งการเปิดวล์วน้ าล าดับ ถัดไปนี้ระบบจะท าการเปิดก่อนที่วาล์วก่อนหน้าจะหมดเวลา 1 นาที หมายถึงจะเปิดวาล์ว 2 วาล์วพร้อม กันก่อนเป็นเวลา 1 นาที แล้วจึงปิดวาล์วก่อนหน้า ทั้งนี้เพื่อเป็นการป้องกันแรงดันในระบบท่อน้ าสูง เกินไปในขณะท าการรดน้ า การท างานจะเป็นลักษณะดังกล่าวไปเรื่อนจนรดน้ าครบทุกแถว เมื่อครบทุก แถวระบบจะสั่งให้เปิดวลาว์น้ าทุกตัวเป็นเวลา 1 วินาทีเพื่อเป็นการระบบแรงดันของท่อน้ าออกจากแถว ทุกแถวก่อนที่จะสั่งปิดปั๊มน้ าตามหลังแล้วตามด้วยปิดวาล์วน้ าทุกตัว

### 5.2.3 ทดสอบในโหมด Auto Timer

การท างานในโหมด Auto Timer คือการท างานแบบอัตโนมัติตามเวลา โดยไม่ขึ้นกับค่าความชื้น ในดิน กล่าวคือ การเปิดวาล์วน้ าแต่ละแถว จะเปิดเมื่อเวลานาฬิกาของระบบตรงกับเวลาที่ก าหนดไว้ใน การตั้งค่าการเปิดวาล์วน้ าของแต่ละแถว เมื่อเวลาตรงกับการเปิดของแถวใดระบบก็จะท าเปิดวาล์วน้ าของ แถวนั้นแล้วตามด้วยเปิดปั๊ม จากการทดสอบระบบ ระบบสามารถเปิดและปิดวาล์วรวมถึงปั๊มน้ าได้ถูกต้อง ตามเงื่อนไขของเวลาที่ก าหนดไว้ รวมถึงระบบยังสามารถตรวจสอบได้อีกว่า เมื่อวาล์วน้ าทุกตัวไม่มีการ เปิดแล้วระบบจะสั่งปิดปั๊มน้ าให้เองโดยอัตโนมัติ

### 5.2.4 ทดสอบกำรป้องกันปั๊มน้ ำจำกเหตุน้ ำไม่ไหล

การทดสอบนี้จะเป็นการทดสอบให้ระบบป้องกันปั๊มน้ าเสียหายจากการที่ปั๊มน้ าท างานแต่ไม่ สามารถดูดน้ าขึ้นจากบ่อและไม่สามารถส่งน้ าไปยังท่อส่งน้ าเพื่อท าการรดน้ าในสวนได้ ในการทดสอบนี้ ระบบจะท าการตรวจสอบเงื่อนไข 2 อย่างคือ เมื่อปั๊มน้ าเปิดท างานแล้ว Flow Switch จะต้องตรวจจับน้ า ว่าไหลหรือไม่ ถ้าหากว่าปั๊มน้ าท างานแต่น้ าไม่ไหล Flow Switch จะส่งสัญญาณไปบอกระบบให้ท าการ ปิดน้ าตามค่าหน่วงเวลาที่ก าหนดไว้ เช่น ก าหนดเวลาไว้ 10 วินาทีของค่าการหน่วงน้ าไม่ไหล เมื่อน้ าไม่ ไหลนานกว่าที่ก าหนดไว้ระบบต้องสั่งปิดปั๊มน้ าโดยทันทีจากการทดสอบผู้วิจัยได้ทดสอบโดยการสั่งให้ปั๊ม น้ าท างานในโหมดต่าง ๆ หลังจากนั้นจะท าการปิดวาล์วธรรมดาตรงบริเวณท่อส่งน้ าเพื่อกั้นน้ าไม่ให้ไหล ผ่าน Flow Switch หลังจากนั้นเมื่อระบบเริ่มจับเวลาของการที่น้ าไม่ไหลถึงวินาทีที่ก าหนดไว้ ระบบก็จะ ท าการตัดปั๊มน้ า ในขณะเดียวกันก็จะส่งข้อความไปทางแอพพลิเคชั่นไลน์ด้วย ส่วนที่หน้าตู้ควบคุมระบบ

LED ก็จะติดในดวงที่มีป้ายก ากับไว้ว่า ปั๊มน้ ามีปัญหา เพื่อเป็นการบ่งบอกให้ผู้ใช้งานระบบทราบว่ามี เหตุการณ์ที่ท าให้น้ าไม่สามารถดูดน้ าส่งไปในระบบท่อรดน้ าให้สวนได้

### 5.2.5 ทดสอบกำรป้องกันแรงดันน้ ำเกินก ำหนดในระบบท่อส่งน้ ำ

การทดสอบนี้จะเป็นการทดสอบการป้องกันความเสียหายของระบบท่อน้ าที่เกิดจากปั๊มน้ าท างาน และมีการส่งน้ า แต่วาล์วแต่ละตัวไม่เปิดให้น้ าไหล ซึ่งโดยปกติแล้วหากเกิดเหตุการณ์ดังกล่าวปั๊มน้ าที่มี ก าลังดันน้ าสูงจะท าให้น้ าดันท่อส่งน้ าแตก หรือหลุด ตามจุดต่าง ๆ ส่งผลให้มีค่าใช้จ่ายในการซ่อม แต่ด้วย ระบบที่ผู้วิจัยได้ออกแบบไว้ ได้ท าการติดตั้ง Pressure Switch เพื่อเป็นตัวตัดการท างานของปั๊มน้ าเมื่อ แรงดันในระบบท่อสูงกว่าที่ก าหนดไว้ เพื่อเป็นการลดความเสียหายของท่อน้ าได้ ผลการทดลองระบบ ผู้วิจัยได้ทดลองเปิดระบบให้ปั๊มน้ าท างานเพื่อรถน้ าโดยปกติ แล้วผู้วิจัยได้สั่งให้ระบบเข้า โหมด Manual เพื่อควบคุมวาล์วน้ าได้ตามอัธยาศัย เมื่อเข้าโหมด Manual แล้วจึงได้สั่งปิดวาล์วน้ าทุกตัวในขณะที่ปั๊มน้ า ยังท างานอยู่ เมื่อปิดวาล์วน้ าจนหมด น้ าในระบบท่อไม่มีทางไปจึงเกิดแรงดันในท่อสูงขึ้นเรื่อย ๆ จนถึง ประมาณ 2 บาร์ กว่า ๆ Pressure Switch จึงท าการตัดไฟที่ไปควบคุมปั๊มน้ าเพื่อหยุดการท างานของปั๊ม น้ าก่อนที่แรงดันจะสูงเกินจนเกิดความเสียหายได้

5.3กำรประเมินควำมพึงพอใจของผู้ใช้ระบบ
การประเมินความพึงพอใจของผู้ใช้ระบบ ผู้วิจัยได้ใช้แบบสอบถามโดยมีค าถามใน 3 ประเด็น หลัก ๆ ดังนี้ ด้านประสิทธิภาพการท างานของระบบ ด้านการท างานตามฟังก์ชันของระบบ และด้านการ น าไปใช้ประโยชน์ แบบสอบถามความพึงพอใจมีจ านวน 10 ข้อ ส าหรับกลุ่มเป้าหมายทางผู้วิจัยได้ให้ เจ้าของสวนสละ ท าการประเมิน หลังจากนั้นผู้วิจัยได้น าข้อมูลมาวิเคราะห์ด้วยโปรแกรมคอมพิวเตอร์ เพื่อหาค่าเฉลี่ย และส่วนเบี่ยงเบนมาตรฐาน โดยผลการวิเคราะห์ได้ผลความพึงพอใจอยู่ที่ 4.98 ซึ่ง หมายถึงความพึงพอใจของการใช้ระบบมีค่าความพึงพอใจเป็น มากที่สุด และมีรายละเอียดการประเมิน ดังตารางที่ 5.1

ตำรำงที่ 5.1 ค่าเฉลี่ยและส่วนเบี่ยงเบนมาตรฐานความพึงพอใจของผู้ใช้ระบบ

รำยกำร | x̃ | S.D.
1. ด้านประสิทธิภาพของการท างานระบบ
1.1 ความสามารถในการท างานแบบอัตโนมัติของระบบ | 5.00 | .000
1.2 ความสามารถในการท างานที่ควบคุมด้วยตนเอง | 5.00 | .500
1.3 ความสามารถในการท างานที่ควบคุมตามเวลาที่ก าหนด | 4.90 | .000

1.5 ความสามารถในการท างานของระบบโดยรวม | 5.00 | .000
2 .ด้านการท างานตามฟังก์ชั่นของระบบ
2.1 ความถูกต้องของระบบในการเปิด-ปิดอุปกรณ์ | 4.80 | 0.00
2.2 ความถูกต้องในการท างานของเซ็นเซอร์วัดความชื้น | 5.00 | 0.00
2.3 ความถูกต้องของการท างานที่ควบคุมด้วยตนเอง | 5.00 | 0.32
2.4 ความถูกต้องของการท างานของเวลาที่ก าหนด | 5.00 | 0.00
2.5 ความถูกต้องของระบบในภาพรวม | 5.00 | 0.00
3 .ด้านการน าไปใช้ประโยชน์
3.1 ระบบมีประโยชน์ต่อการใช้งานทางการเกษตร | 5.00 | 0.00
รวม | 4.98 | 0.06

จากตารางที่5.1 ความคิดเห็นความพึงพอใจของผู้ใช้ระบบโดยรวมอยู่ในระดับความพึงพอใจมาก ที่สุด ( x̃ = 4.98) ด้านประสิทธิภาพของการท างานระบบอยู่ในระดับดีมาก ด้านการท างานตามฟังก์ชัน อยู่ในระดับดีมาก และด้านการน าไปใช้ประโยชน์อยู่ในระดับดีมาก

5.4สรุปผล
สรุปผลโดยภาพรวมหลังจากที่ผู้วิจัยได้ท าการทดสอบและวัดประสิทธิภาพของระบบ ปรากฏว่า ระบบท างานได้ถูกต้องและแม่นย าตามเงื่อนไขที่ผู้วิจัยได้ก าหนดไว้ เพื่อให้ตรงกับความต้องการของผู้ใช้ ระบบอย่างแท้จริง ซึ่งในการใช้งานระบบทางผู้วิจัยได้เปิดระบบเพื่อควบคุมการรดน้ าในสวนสละเป็นเวลา 3 เดือน ผลปราก าว่าระบบท างานได้ดี และโหมดที่ผู้ใช้งานที่เป็นเจ้าของสวนเปิดใช้บ่อยที่สุดคือ โหมด Auto Timer หรือระบบที่รดน้ าในสวนตามเวลาที่ก าหนด ซึ่งเจ้าของสวนได้ตั้งเวลาการรดน้ าแถวแรกไว้ที่ เวลา 17:00 น. – 17:20 น. แถวที่ 2 เวลา 17:20 น. – 17:40 น. แถวที่ 3 เวลา 17:40 น. – 18:00 น. และแถวที่ 4 เวลา 18:00 น. – 18:20 น. แถวละ 20 นาทีในการรดน้ า ส าหรับการป้องกันปั๊มน้ าเสียหาย นั้น ในระยะเวลาที่ใช้งานระบบ ได้มีเหตุปั๊มน้ าดูดน้ าไม่ขึ้น จ านวน 1 ครั้ง ซึ่งระบบได้ท าการตัดปั๊มน้ าให้ โดยอัตโนมัติ ในขณะที่เจ้าของสวนไม่ได้อยู่ในพื้นที่ในระหว่างระบบก าลังท าการรดน้ าให้ จะเห็นได้ว่าหาก เป็นการรดน้ าด้วยวิธีธรรมดาแล้วเกิดเหตุดังกล่าว อาจท าให้ปั๊มน้ าเสียหายและมีค่าใช้จ่ายในการซ่อมได้ ส าหรับการป้องกันแรงดันน้ าในท่อสูงผิดปกติ ในระหว่างที่ใช้ระบบตามช่วงเวลาดังกล่าวยังไม่เกิด เหตุการณ์นี้

เอกสำรอ้ำงอิง

สนธยา นงนุช เซ็นเซอร์วัดความชื้นในดิน Soil Moisture Sensor แหล่งที่มา : https://www.ioxhop.com/product/soil-moisture-sensor (10 ตุล าคม 2566). นพพร จูจันทร์Keypad 4x4 [ระบบออนไลน์] แหล่งที่มา : http://www.circuitstoday.com/interfacing- Hex-keypad-to-Arduino (10 ตุลาคม 2566).
เซ็นเซอร์วัดการไหลของน้ า Flow Switch [ระบบออนไลน์] แหล่งที่มา :
http://wow.in.th/XYC1 (10 ตุลาคม 2566).
Arduino Mega 2560 [ระบบออนไลน์] แหล่งที่มา : http://wow.in.th/u9e1 (10 ตุลาคม 2566). อภิรักษ์นามแถ่ง Arduino Ethernet Control [ระบบออนไลน์] แหล่งที่มา : https://bit.ly/3aIPDJg (10 ตุลาคม 2566).
ธัญวัลย์ธนวงศ์พร (256) รถส ารวจเพดานควบคุมผ่านสมาร์ตโฟน
[ระบบออนไลน์] แหล่งที่มา : http://digital_collect.lib.buu.ac.th/project/b00254341. (10 ตุลาคม 2566).
บอร์ด Relay Module [ระบบออนไลน์] แหล่งที่มา : https://bit.ly/2y3T3sT (10 ตุลาคม 2566).
ห ลั ก ก า ร ท าง าน ข องโ ซ ลิน อ ย ด์ ว า ล์ ว (Solenoid valve) [ร ะบ บ อ อ นไ ล น์] แห ล่ง ที่ ม า : https://2www.me/S8GM7 (10 ตุลาคม 2566).
Magnetic Contactor [ระบบออนไลน์] แหล่งที่มา : https://bit.ly/2y0d3fV (10 ตุลาคม 2566). จอแสดงผล LCD [ระบบออนไลน์] แหล่งที่มา http://wow.in.th/W28L (10 ตุลาคม 2566).
ปั๊มน้ า [ระบบออนไลน์] แหล่งที่มา : http://wow.in.th/WsyK (10 ตุลาคม 2566).
ประภาส สุวรรณเพชร. (2558). เครื่องมือเขียนโปรแกรม ArduinoIDE. [ออนไลน์]
แหล่งที่มา : http://praphas.com/index.php/arduino/87-arduino-2-sketch (20 ตุลาคม 2566 ).
คณุตฆ์แซ่ม้า (2561). ระบบรดน้ าแปลงผักอัตโนมัติ[ระบบออนไลน์] แหล่งที่มา : http://dspace.rmutk.ac.th/bitstream/handle (15 ตุลาคม 2566). ศักรินทร์ตันสุพงษ์. (2548). ปัจจัยที่ส่งผลต่อการยอมรับแอพพลิเคชั่นไลน์[ระบบออนไลน์] แหลงที่มา : http://dspace.bu.ac.th/bitstream/123456789/1260/1/sakarin.tans.pdf (8 ตุลาคม2562)
