PipeNitch/Project_WPNS-IoT/Documents/PumpIoT/PumpIoT Final.pdf

A notification and shutdown system for water pumps using Internet of Things technology (IoT)


ระบบแจ้งเตือนและตัดการท้างานปั๊มน ้าโดยใช้เทคโนโลยี อินเทอร์เน็ตในทุกสิ่ง (IoT)


โรงเรียนวิทยาศาสตร์จุฬาภรณราชวิทยาลัย นครศรีธรรมราช

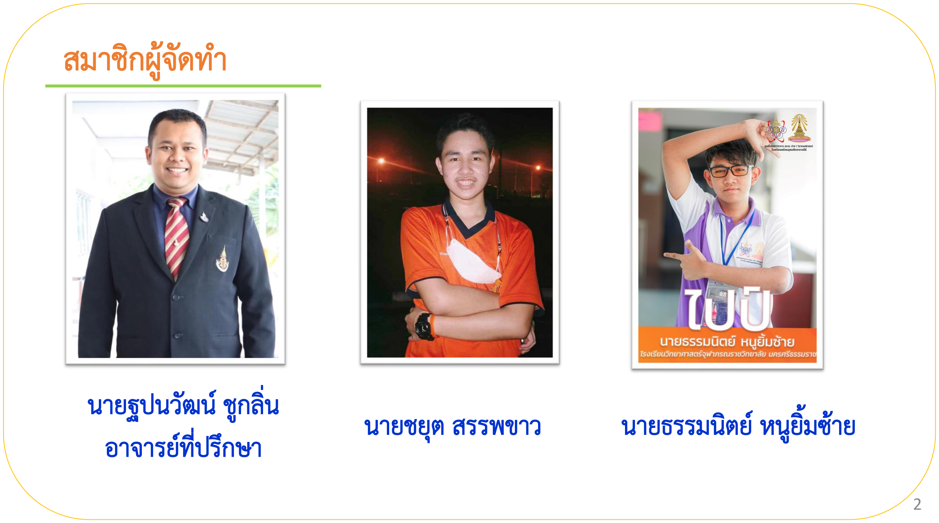
[picture p198: page 2]

### สมาชิกผู้จัดท้า

นายชยุต สรรพขาว นายธรรมนิตย์ หนูยิ มซ้าย

นายฐปนวัฒน์ ชูกลิ่น
อาจารย์ที่ปรึกษา

ทม

ี

่

### าและความสา

ค

ั

ญ

ความส าคัญ: ปั๊มน ้าเป็นอุปกรณ์ที่เราใช้กันทั่วไปในหลายพื นที่ จึงปฏิเสธไม่ได้ เลยว่าปั๊มน ้ามีความจ้าเป็นอย่างยิ่ง และหากเกิดปัญหา จะกระทบกับผู้ใช้น ้า อย่างมาก

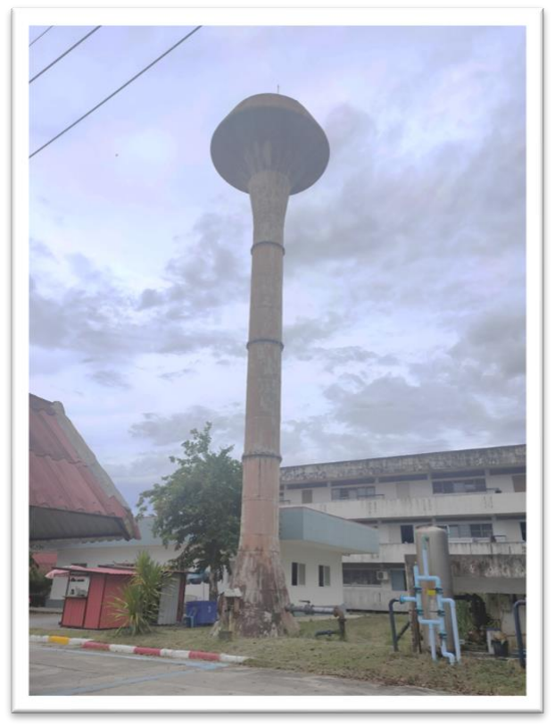
[picture p199: figure]

ทม

ี

่

### าและความสา

ค

ั

### ญ (ต่อ)

ปัญหา: หลายครั งจะพบว่า “ปั๊มน ้าท้างานแต่ไม่จ่ายน ้า” (Dry Run) ซึ่งมาจาก หลายๆ สาเหตุ หากทราบปัญหาการท้างานที่ผิดปกติได้เร็วและได้แก้ไขในทันที จะช่วยลดค่าใช้จ่ายได้เป็นอย่างมาก

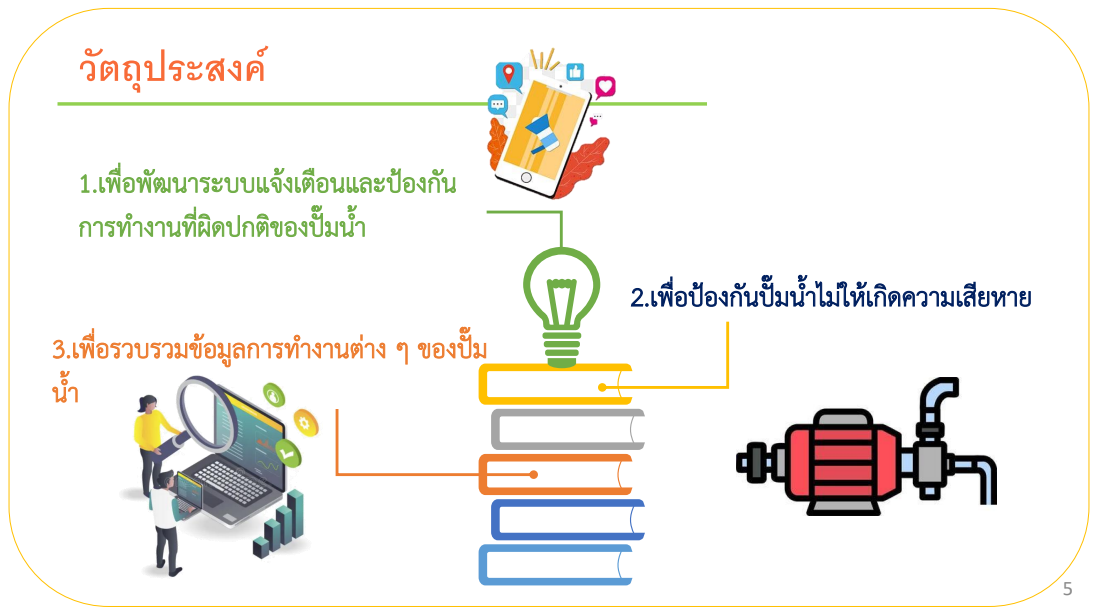
[picture p200: page 5]
วัตถุประสงค์

1.เพื่อพัฒนาระบบแจ้งเตือนและป้องกัน
การท้างานที่ผิดปกติของปั๊มน ้า

2.เพื่อป้องกันปั๊มน ้าไม่ให้เกิดความเสียหาย

3.เพื่อรวบรวมข้อมูลการท้างานต่าง ๆ ของปั๊ม

ขอบเขตการศึกษา; Water

ปั๊มน ้ามีขนาด 1 แรงขึ นไปเพื่อที่จะมีก้าลังผลัก
ของน ้าพอที่จะให้ Flow Switch ท้างานได้

ปั๊มน ้าที่ศึกษาเป็นแบบหอยโข่งหรือปั๊มดูดบ่อบาดาล

การตรวจจับความผิดปกติของปั๊มน ้าจะ
ตรวจจับการไหลของน ้าโดยใช้Flow
Switch และการใช้พลังงานไฟฟ้า

ปั๊มน ้าที่ใช้เป็นปั๊มไฟฟ้ากระแสสลับ ขนาด
แรงดันไฟฟ้า 220 โวลต์ทั งแบบ 1 เฟส และ 3
เฟส

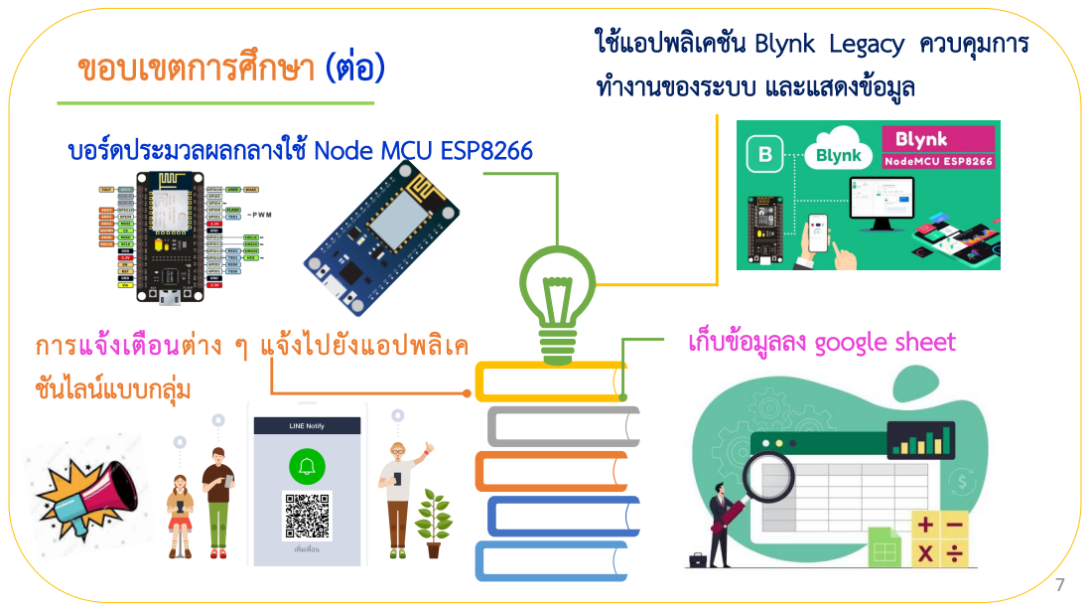
[picture p201: page 7]
ขอบเขตการศึกษา (ต่อ)

ใช้แอปพลิเคชัน Blynk Legacy ควบคุมการ
ท้างานของระบบ และแสดงข้อมูล

บอร์ดประมวลผลกลางใช้ Node MCU ESP8266

การแจ้งเตือนต่าง ๆ แจ้งไปยังแอปพลิเค
ชันไลน์แบบกลุ่ม

เก็บข้อมูลลง google sheet

### สมมติฐาน

ระบบจะเตือนและตัดการท้างานปั๊มน ้าเมื่อปั๊มน ้าท้างานแต่ไม่มีน ้าไหล (Dry Run) หรือปั๊มน ้าใช้พลังงานไฟฟ้าเกินกว่าที่ก้าหนด ซึ่งจะเป็นการ ป้องกันการเสียหายของปั๊มน ้าได้


Water Not
Flow

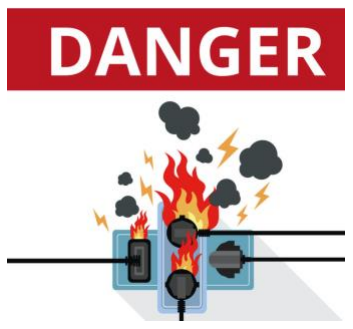
[picture p202: figure]
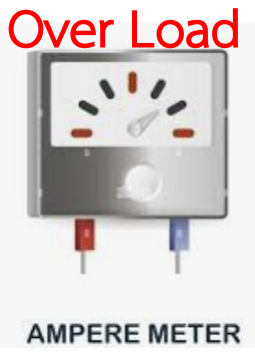
[picture p203: figure]
Over Load


ตัวแปรต้น | ระบบติดตามการท้างานของปั๊มน ้า

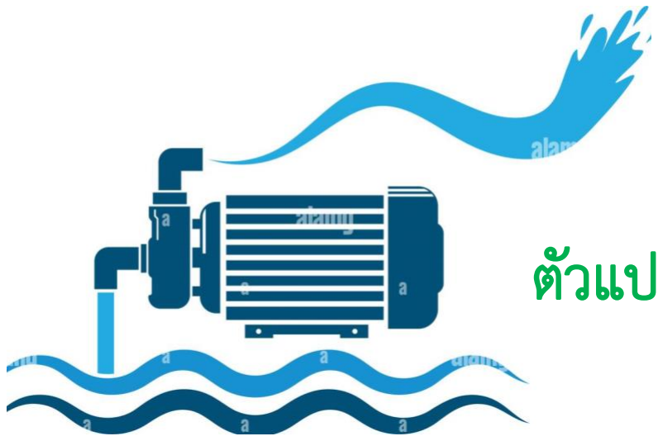
[picture p204: figure]

ตัวแปรตาม | ประสิทธิภาพการท้างานของปั๊มน ้า


ตัวแปรควบคุม สภาพการใช้งานของปั๊มน ้า

### ตัวแปรที่ศึกษา

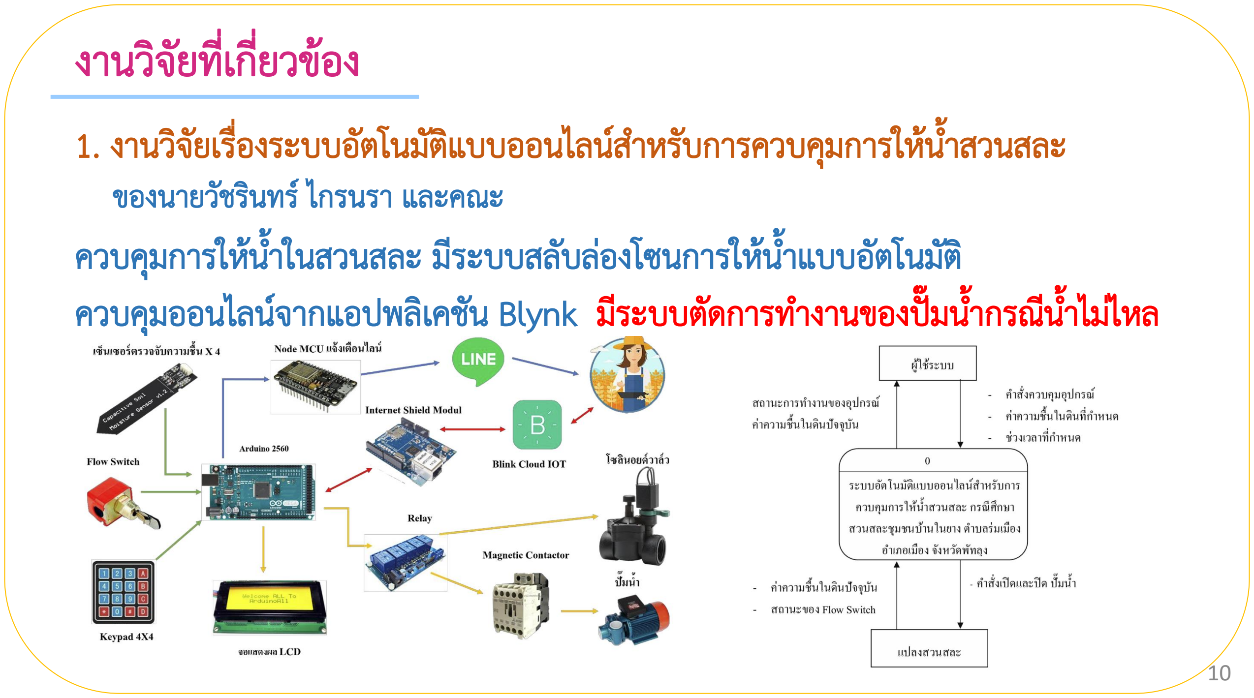
[picture p205: page 10]

### งานวิจัยที่เกี่ยวข้อง

1. งานวิจัยเรื่องระบบอัตโนมัติแบบออนไลน์ส้าหรับการควบคุมการให้น ้าสวนสละ ของนายวัชรินทร์ ไกรนรา และคณะ
ควบคุมการให้น ้าในสวนสละ มีระบบสลับล่องโซนการให้น ้าแบบอัตโนมัติ ควบคุมออนไลน์จากแอปพลิเคชัน Blynk มีระบบตัดการท้างานของปั๊มน ้ากรณีน ้าไม่ไหล

### งานวิจัยที่เกี่ยวข้อง (ต่อ)

2. งานวิจัยเรื่องระบบอัตโนมัติแบบออนไลน์ส้าหรับควบคุมอุปกรณ์ไฟฟ้าเพื่อการประหยัด
พลังงาน | ของนายคณาธิป ศรีอ่อน และคณะ

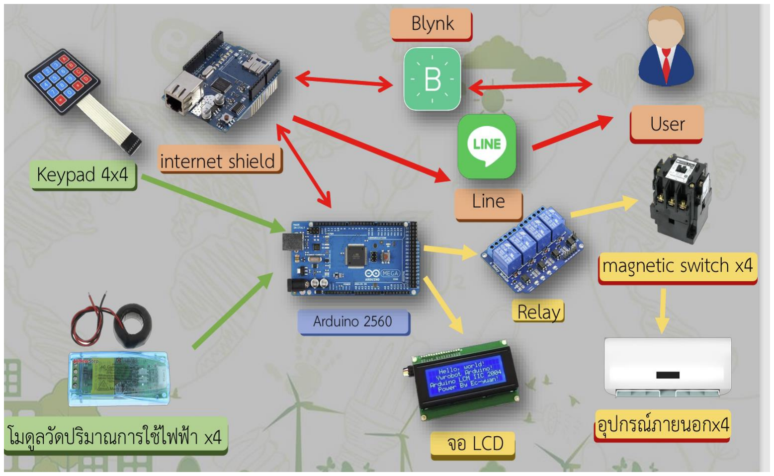
[picture p206: figure]

- พัฒนาระบบควบคุมอุปกรณ์ไฟฟ้า 4 อุปกรณ์
- ควบคุมออนไลน์จากแอปพลิเคชัน Blynk
- มีระบบตัดการท้างานของอุปกรณ์ไฟฟ้า กรณีที ่ใช้ไฟฟ้าเกินกว่าที่ก้าหนด
- ใช้เซนเซอร์วัดการใช้พลังงานไฟฟ้า

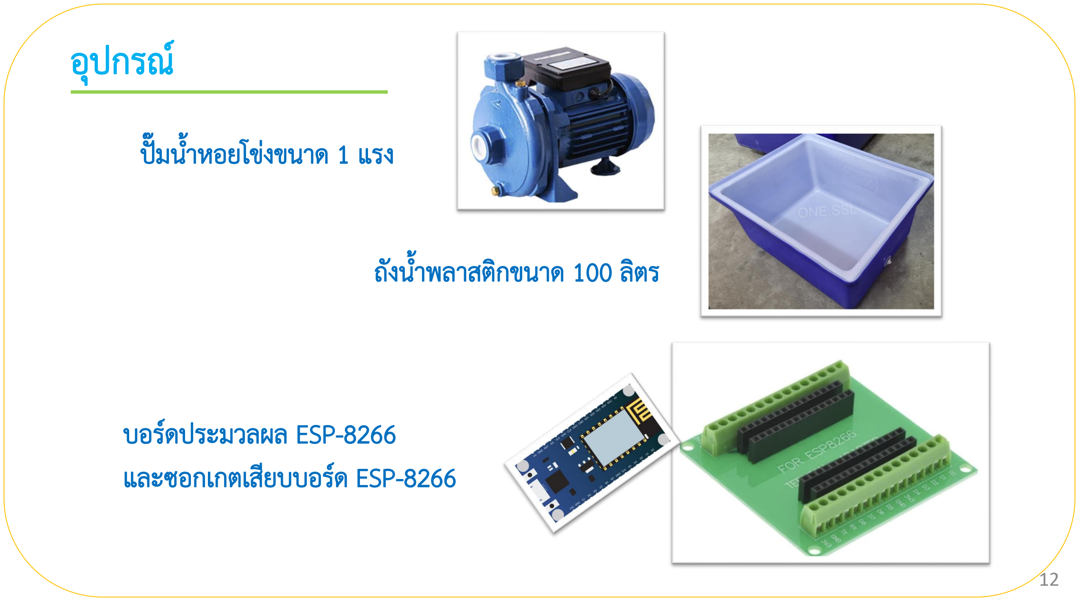
[picture p207: page 12]

### อุปกรณ์

ปั๊มน ้าหอยโข่งขนาด 1 แรง

ถังน ้าพลาสติกขนาด 100 ลิตร

บอร์ดประมวลผล ESP-8266
และซอกเกตเสียบบอร์ด ESP-8266

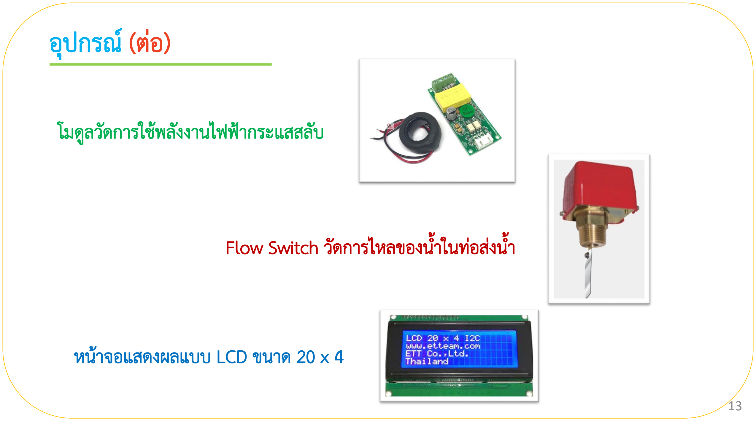
[picture p208: page 13]

### อุปกรณ์ (ต่อ)

Flow Switch วัดการไหลของน ้าในท่อส่งน ้า

โมดูลวัดการใช้พลังงานไฟฟ้ากระแสสลับ

หน้าจอแสดงผลแบบ LCD ขนาด 20 x 4

### อุปกรณ์ (ต่อ)

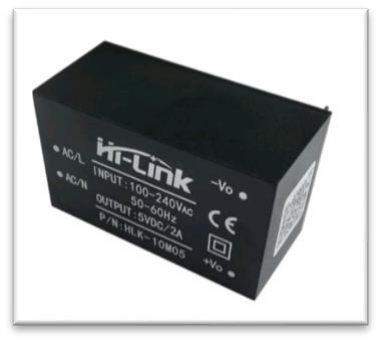
[picture p209: figure]

ไฮลิงค์ส้าหรับแปลงไฟ 220 Vac เป็น 5 Vdc

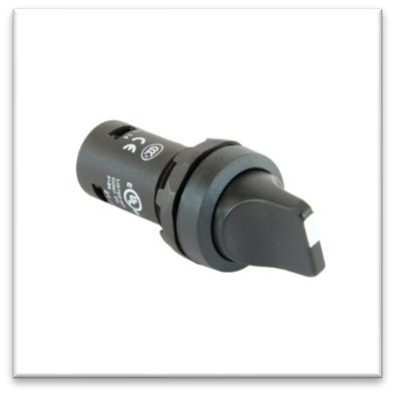
[picture p210: figure]
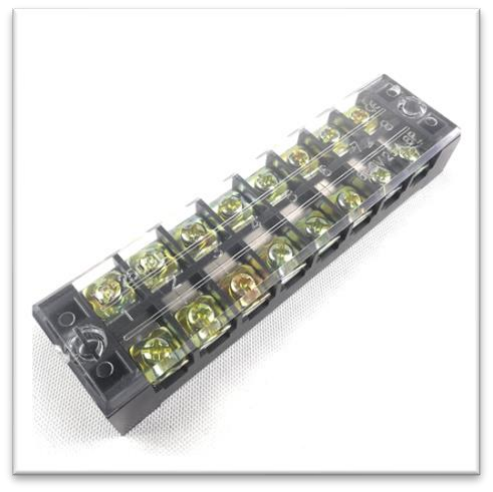
[picture p211: figure]

เทอร์มินอล 8 ช่องสัญญาณ

สวิตช์ 2 จังหวะ


โมดูลรีเลย์ 2 ช่อง

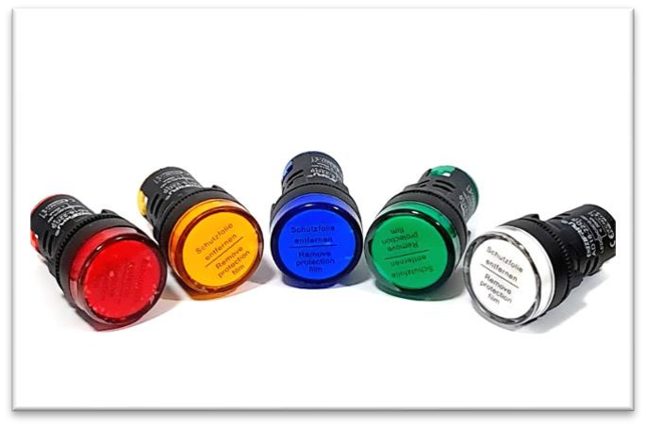
[picture p212: figure]

Pilot Lamp ไฟแสดงสถานะ

### อุปกรณ์ (ต่อ)

กล่องพลาสติก

เราเตอร์แบบใส่ Sim เครือข่ายโทรศัพท์มือถือ
และ Sim โทรศัพท์มือถือพร้อมสัญญาณอินเทอร์เน็ต

### อุปกรณ์ (ต่อ)


อื่น ๆ เช่น ท่อ PVC สายไฟ เคเบิ ลไทร์ น๊อต สกรู วาล์วน ้า

1

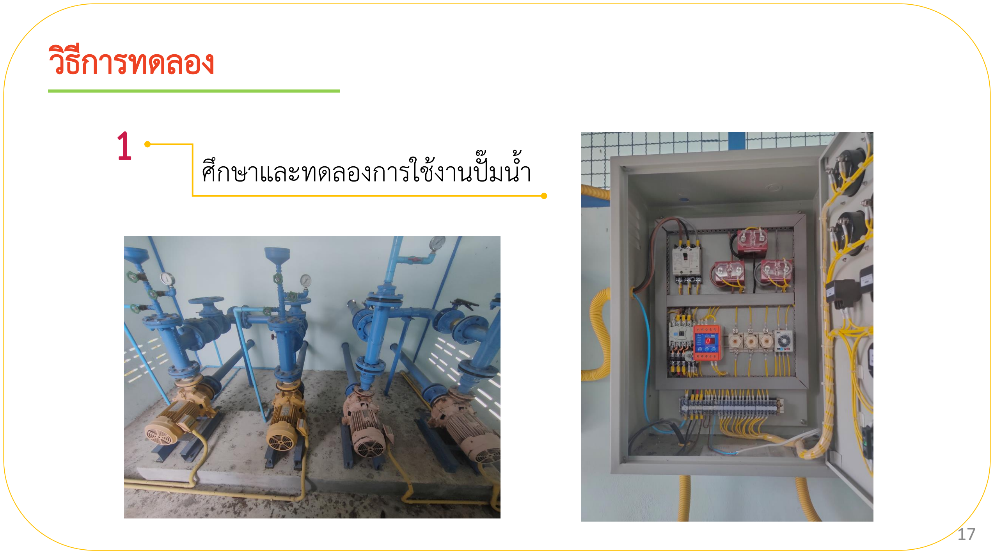
[picture p213: page 17]

### วิธีการทดลอง

ศึกษาและทดลองการใช้งานปั๊มน ้า

### วิธีการทดลอง (ต่อ)


2


ติดตั งโปรแกรมภาษา C ส้าหรับบอร์ด Arduino

3
ทดลองเขียนโปรแกรมเพื่อควบคุมบอร์ด ESP 8266

### วิธีการทดลอง (ต่อ)


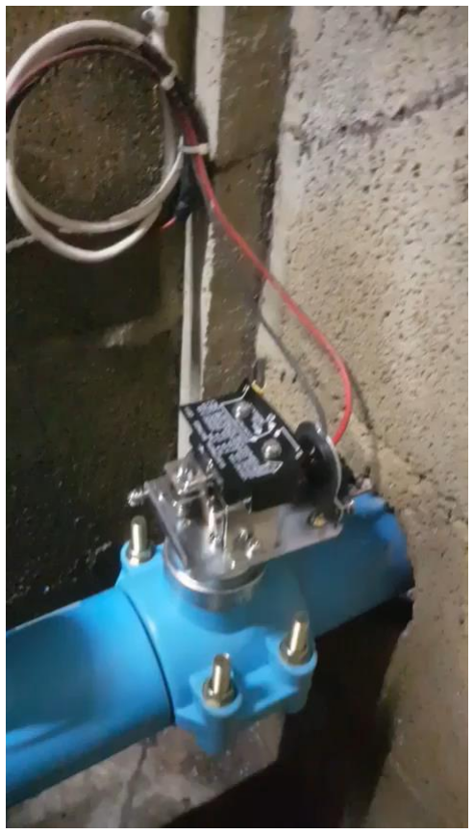
[picture p214: figure]

4
ศึกษาและทดลองการท้างานของ Flow Switch แล้วเขียนโปรแกรมให้บอร์ดรับสัญญาณจาก Flow Switch

ศึกษาและทดลองโมดูลวัดพลังงานไฟฟ้า แล้ว เขียนโปรแกรมให้บอร์ดรับสัญญาณจากโมดูลวัด พลังงานไฟฟ้า

5

### วิธีการทดลอง (ต่อ)

7

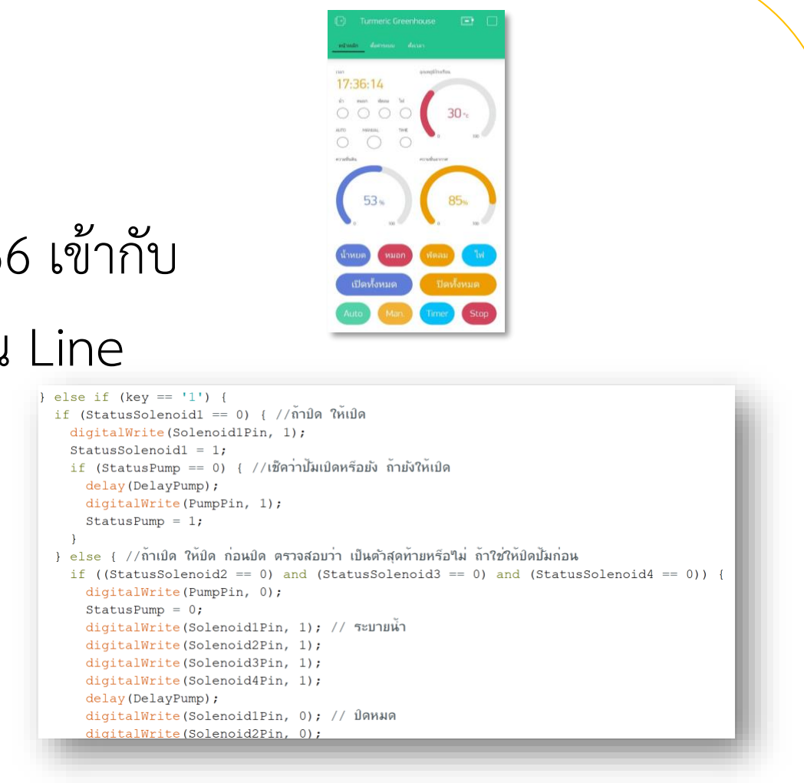
[picture p215: figure]

6 เขียนโปรแกรมเชื่อมต่อบอร์ด ESP 8266 เข้ากับ แอปพลิเคชัน Blynk และ แอปพลิเคชัน Line เขียนโปรแกรมในส่วนของเงื่อนไขการ แจ้งเตือนและตัดการท้างานของปั๊ม
8

### วิธีการทดลอง (ต่อ)

ทดสอบระบบในส่วนของโปรแกรมใน ภาพรวมทั งหมด

9
ประกอบอุปกรณ์ใส่ในตู้พลาสติก 10 ทดสอบระบบหลังประกอบอุปกรณ์ต่าง ๆ เข้าในตู้พลาสติก

### วิธีการทดลอง (ต่อ)

### โครงสร้างระบบทางด้านฮาร์ดแวร์

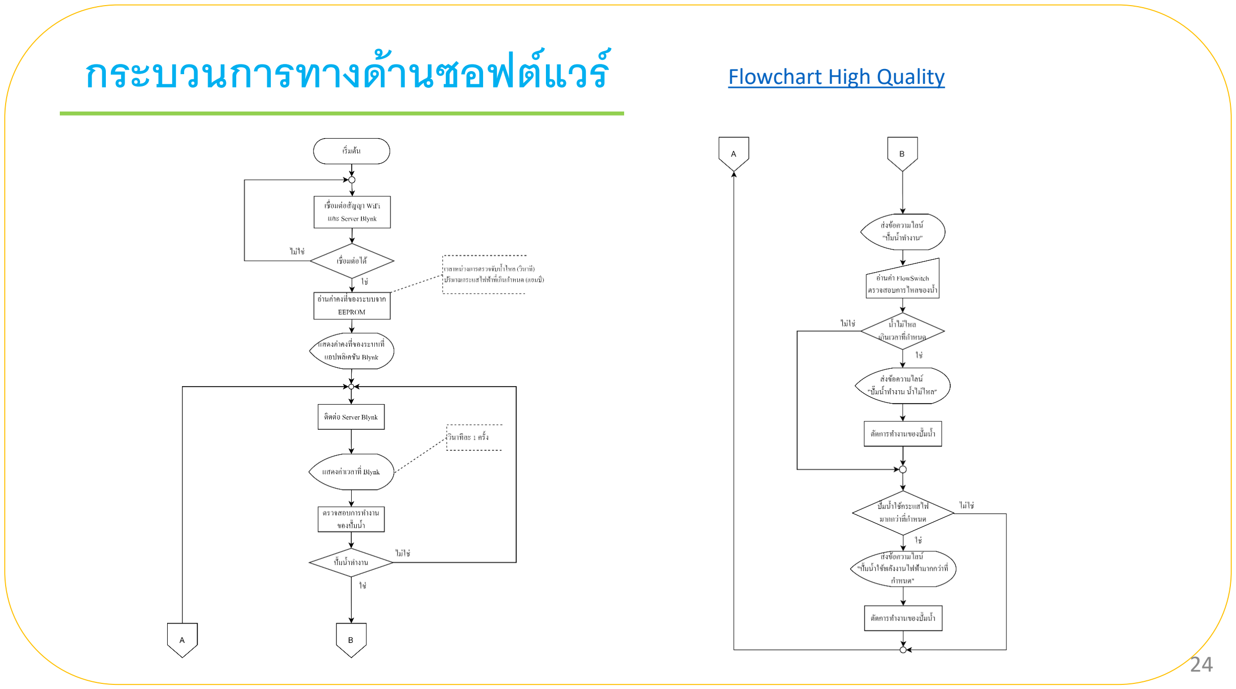
[picture p216: page 24]

### กระบวนการทางด้านซอฟต์แวร์

Flowchart High Quality

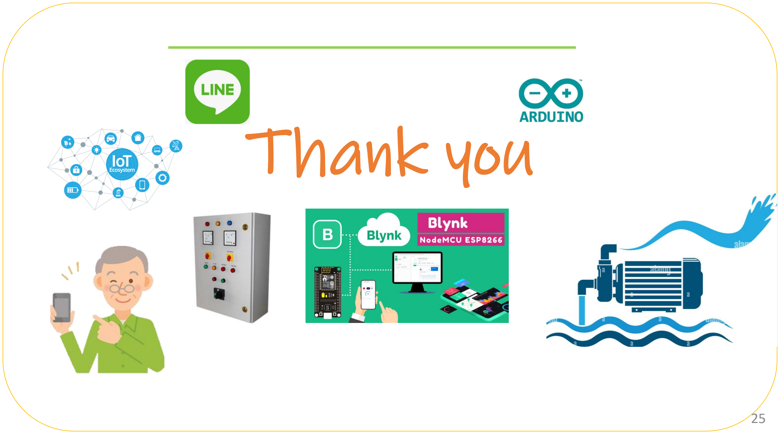
[picture p217: page 25]

# Thank you
