PipeNitch/Project_WPNS-IoT/Example/ของบวิจัย2566-สราญพงศ์.pdf

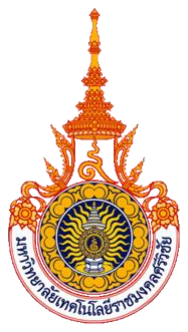
[picture p228: figure]

# การพัฒนาระบบอัตโนมัติแบบออนไลน์ส้าหรับการควบคุมการให้น ้าสวนสละ ต้าบลบ้านในยาง อ้าเภอเมือง จังหวัดพัทลุง

# Development of automatic online system for the watering controls in salacca plantations, Bannaiyang, Muang District, Phatthalung Province

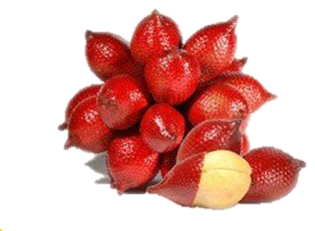
[picture p229: figure]

# คณะวิทยาศาสตร์และเทคโนโลยี

# น้าเสนอของบประมาณวิจัยเงินรายได้ประจ้าปี 2566

### มหาวิทยาลัย นวัตกรรม เพื่อสังคม

# คณะวิจัย

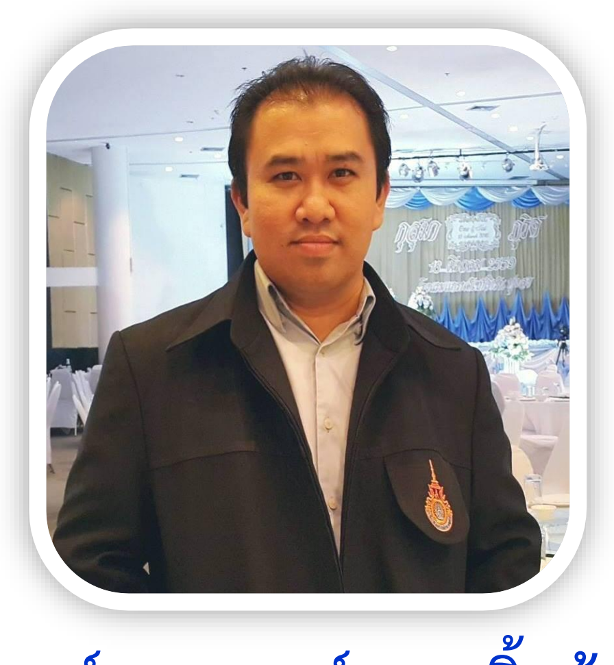
[picture p230: figure]

# อาจารย์สราญพงศ์ หนูยิ มซ้าย หัวหน้าคณะวิจัย

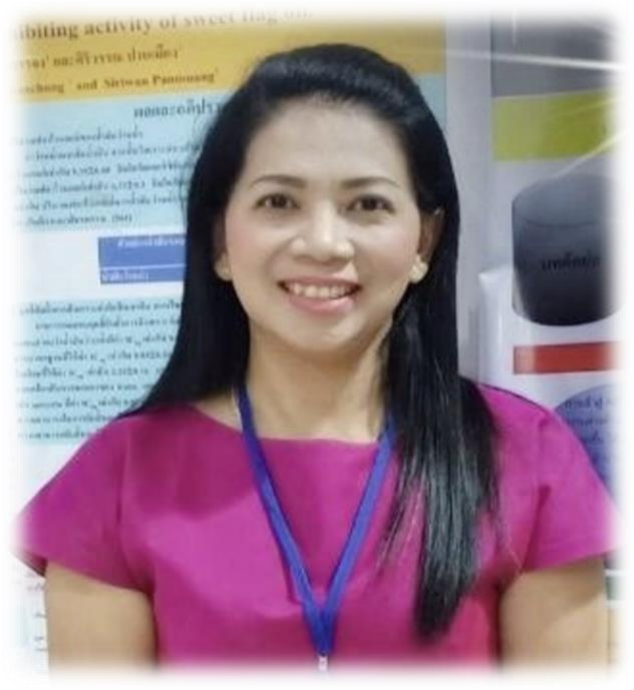
[picture p231: figure]

# ผู้ช่วยศาสตราจารย์รัตติยา สารดิษฐ์ ผู้ร่วมวิจัย

# ที่มาและความส้าคัญ

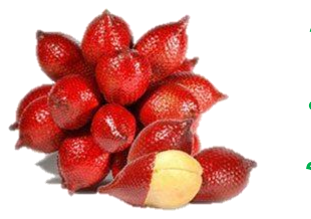
[picture p232: figure]

# สละเป็นผลไม้ที่ได้รับความนิยมในการรับประทาน มีรสชาติอร่อย ทั งยังมีประโยชน์ต่อร่างกาย ด้วยมีสารต้านอนุมูลอิสละ เช่น สารฟี โนลิค สารฟลาโวนอยด์เป็นต้น [1]

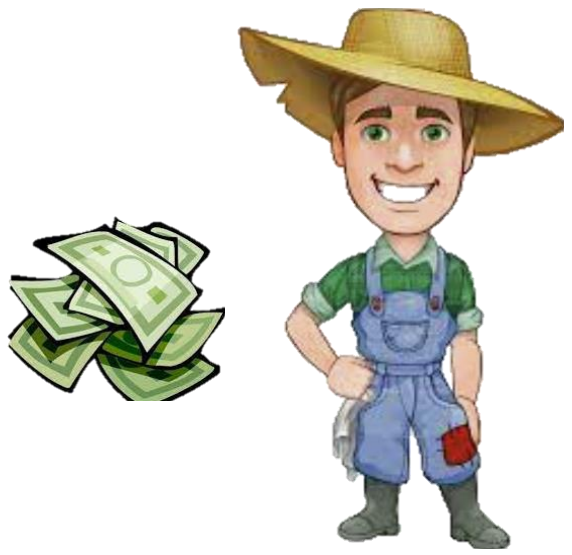
[picture p233: figure]

# ราคาขายปลีก ประมาณ 70 - 80 ฿/Kg ราคาค่อนข้างคงที่ตลอด ปี และผลผลิตออกตลอดปี ส่งผลให้เกษตรกรมีรายได้เป็นอย่างมาก

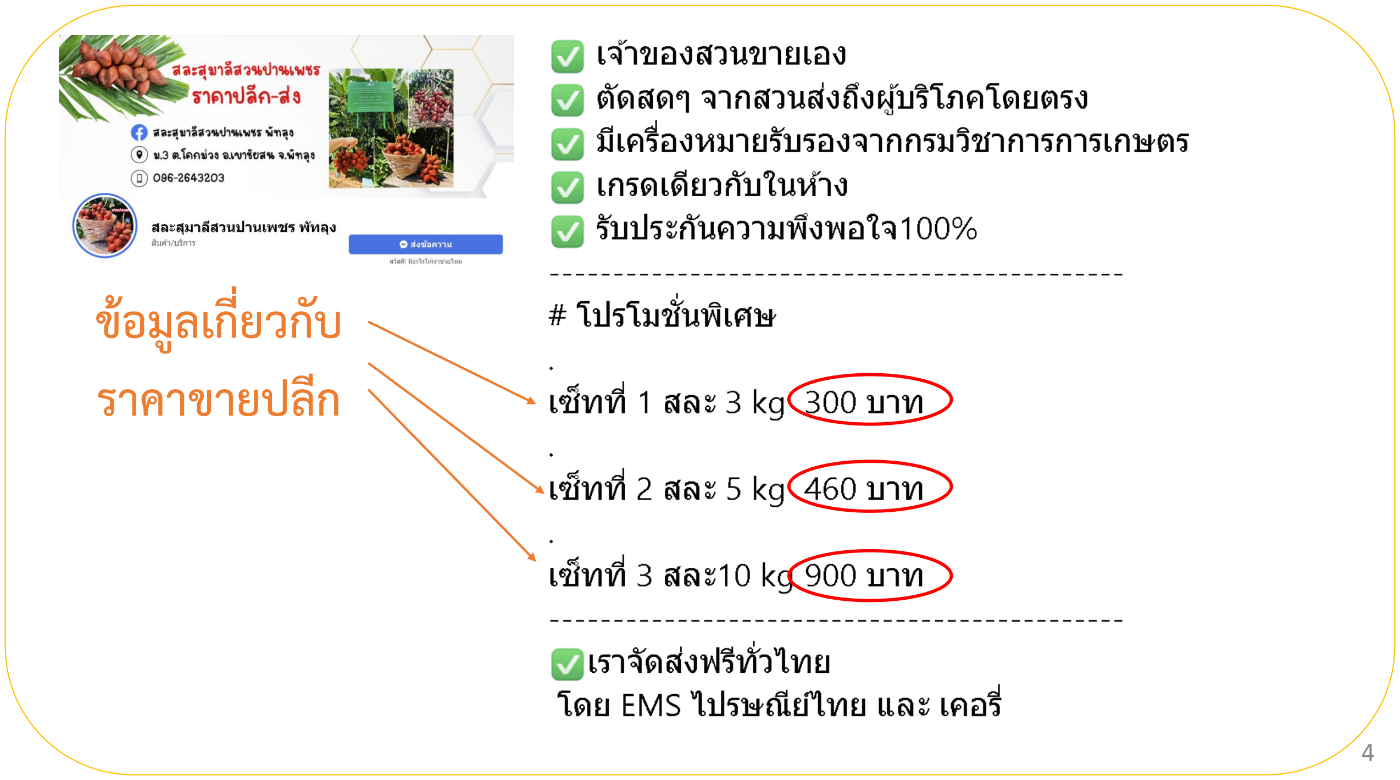
[picture p234: page 4]

# ข้อมูลเกี่ยวกับ ราคาขายปลีก

# เพท Facebook ขายสละในจังหวัดพัทลุง

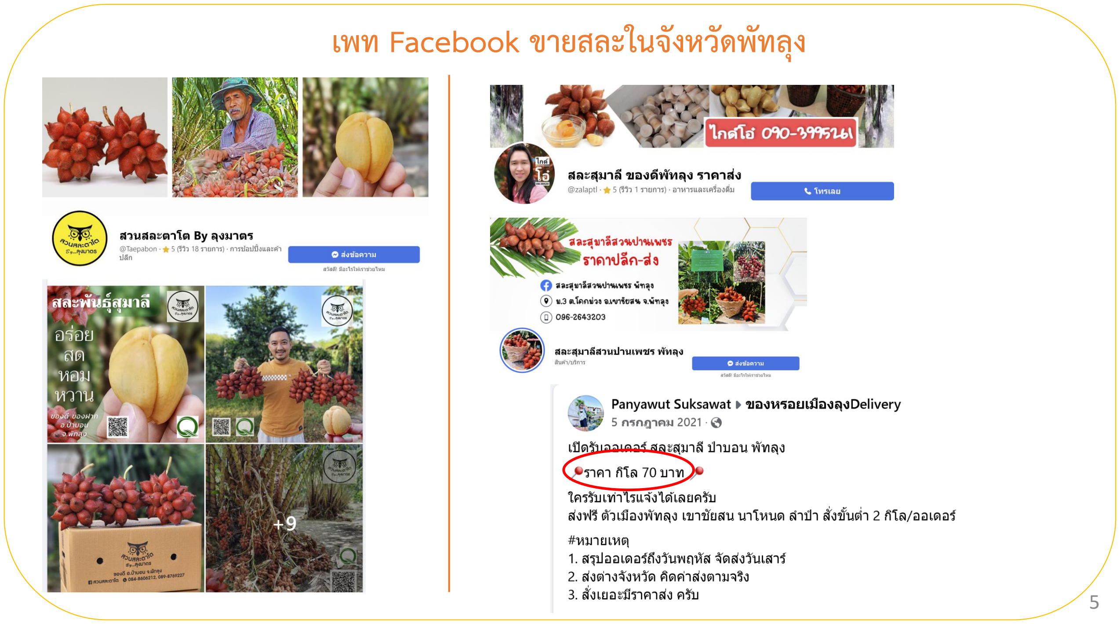
[picture p235: page 5]

# เพท Facebook ขายสละในจังหวัดพัทลุง

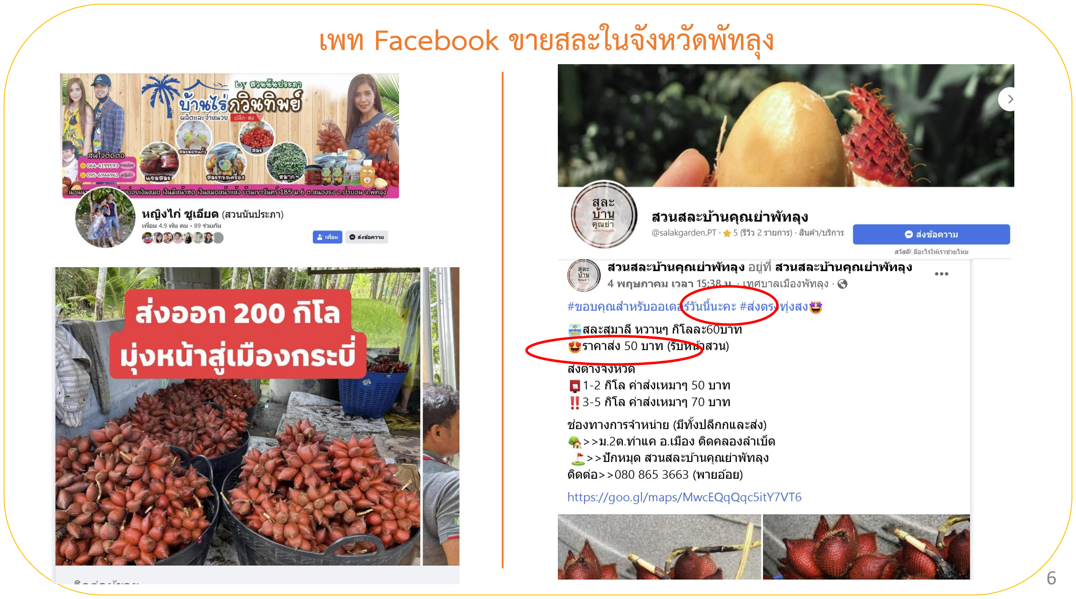
[picture p236: page 6]

# สละ ต้องดูแลอย่างดี รสชาติถึงจะอร่อย น้อยไปไม่ได้

# ที่มาและความส้าคัญ : ปัญหา

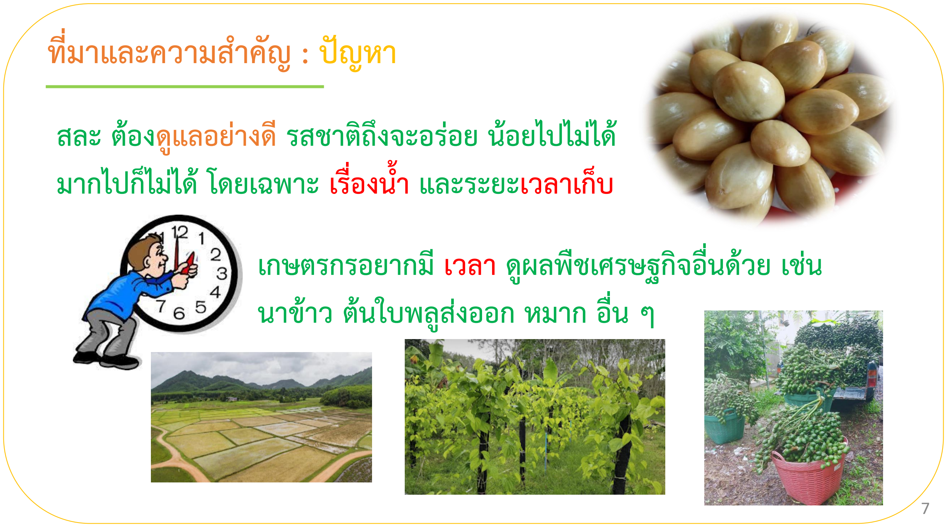
[picture p237: page 7]

# มากไปก็ไม่ได้ โดยเฉพาะ เรื่องน ้า และระยะเวลาเก็บ

# เกษตรกรอยากมีเวลา ดูผลพืชเศรษฐกิจอื่นด้วย เช่น นาข้าว ต้นใบพลูส่งออก หมาก อื่น ๆ

# รายจ่ายแผง เช่น ค่าไฟจากการปั๊มน ้าเกินจ้าเป็น น ้าดูด

# ที่มาและความส้าคัญ : ปัญหา

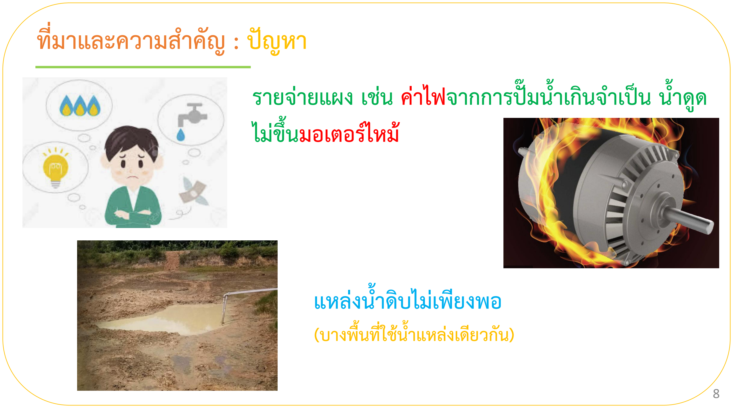
[picture p238: page 8]

# ไม่ขึ นมอเตอร์ไหม้

# แหล่งน ้าดิบไม่เพียงพอ

## (บางพื นที่ใช้น ้าแหล่งเดียวกัน)

# ควบคุมการให้น ้า ให้มีความชื นใน ดินเหมาะสม

# ที่มาและความส้าคัญ : แก้ปัญหา

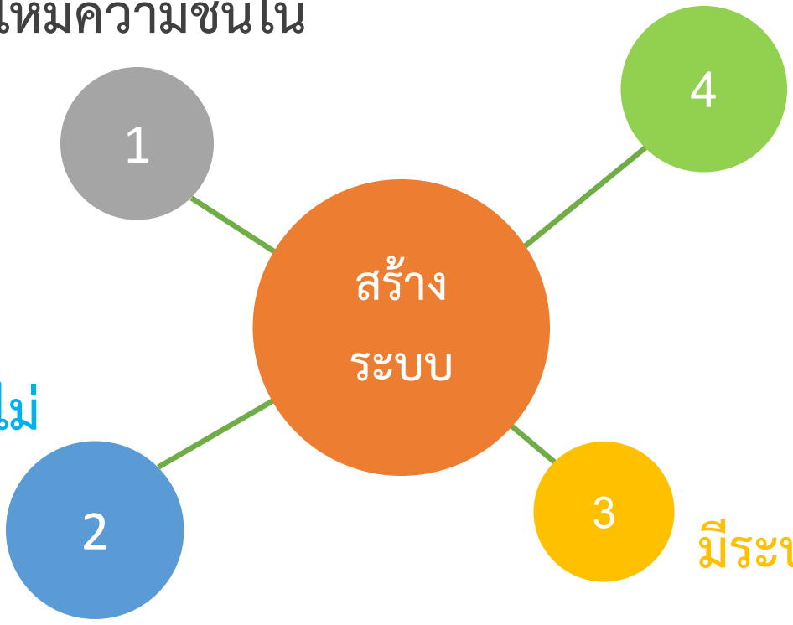
[picture p239: figure]
สร้าง ระบบ

# ควบคุมแบบออนไลน์ ไม่ ต้องเข้ามาในสวน มีระบบป้องกันปั๊มน ้าเสียหาย

## มีการแจ้งการท้างานของ ระบบไปยัง ไลน์

## - ตัดปั๊มเมื่อดูดน ้าไม่ขึ น - ตัดปั๊มเมื่อร้อนเกินก้าหนด

# วัตถุประสงค์

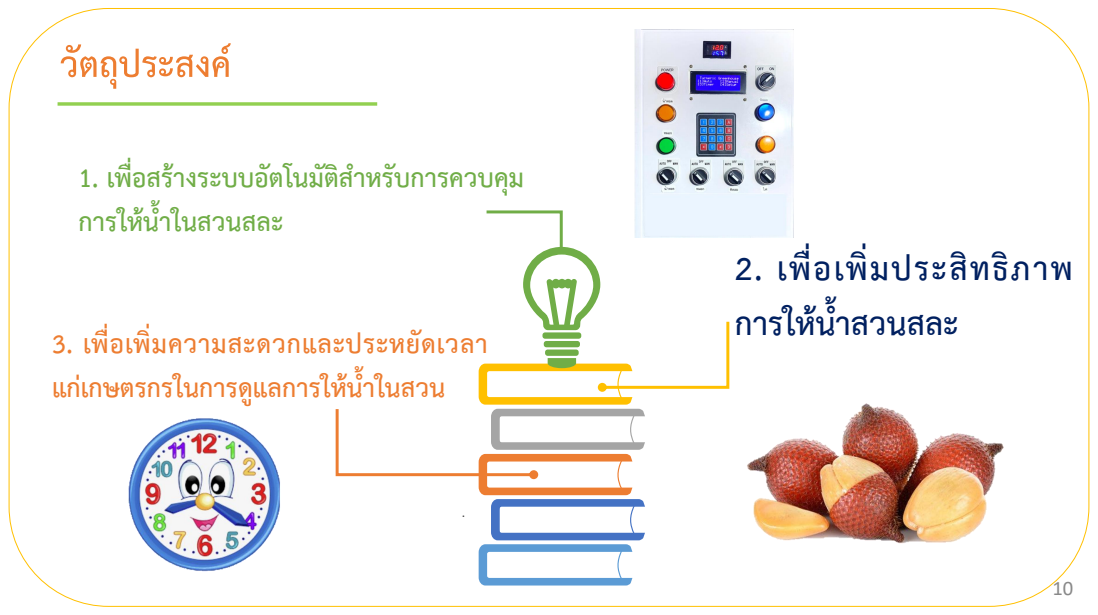
[picture p240: page 10]

1. เพื่อสร้างระบบอัตโนมัติส้าหรับการควบคุม
การให้น ้าในสวนสละ

2. เพื่อเพิ่มประสิทธิภาพ
การให้น ้าสวนสละ

3. เพื่อเพิ่มความสะดวกและประหยัดเวลา
แก่เกษตรกรในการดูแลการให้น ้าในสวน

# กรอบวิจัย

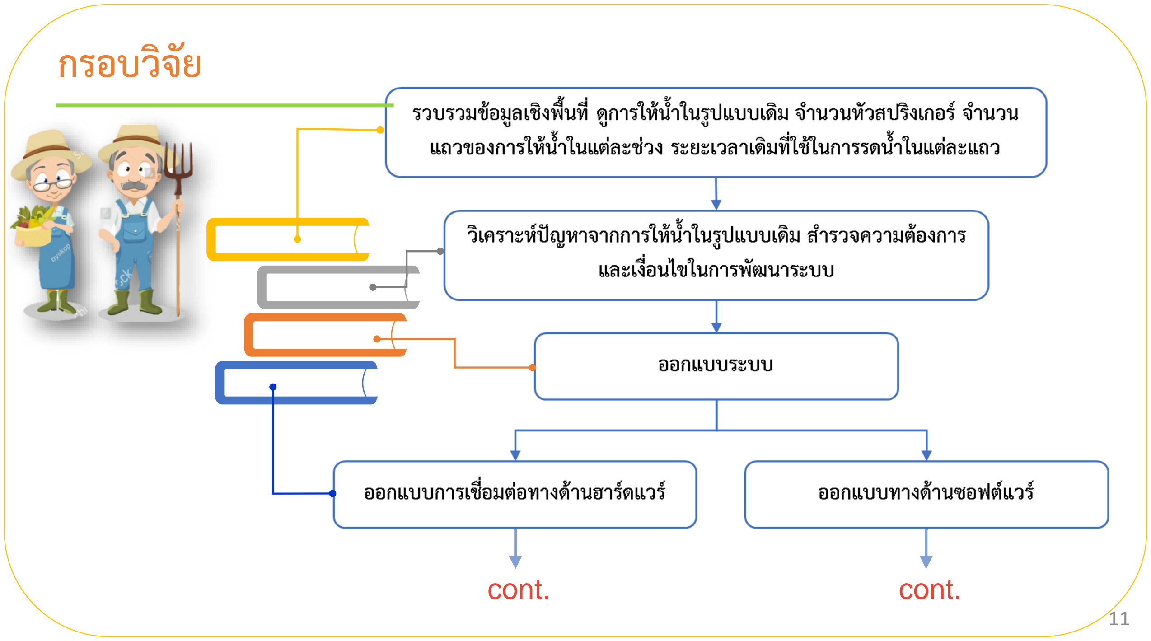
[picture p241: page 11]

cont. | cont.

กรอบวิจัย cont.

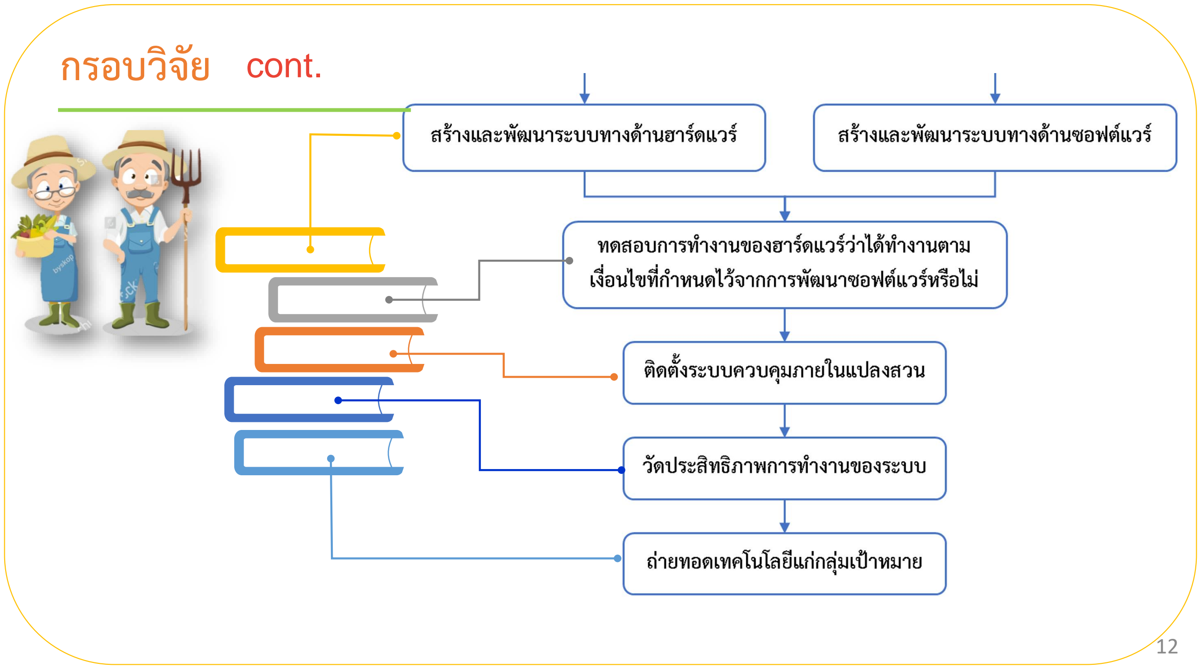
[picture p242: page 12]

# ระเบียบวิธีวิจัย

## รวบรวมข้อมูลเชิงพื นที่ ดูการให้น ้าในรูปแบบเดิมของเกษตรกร จ้านวนหัว

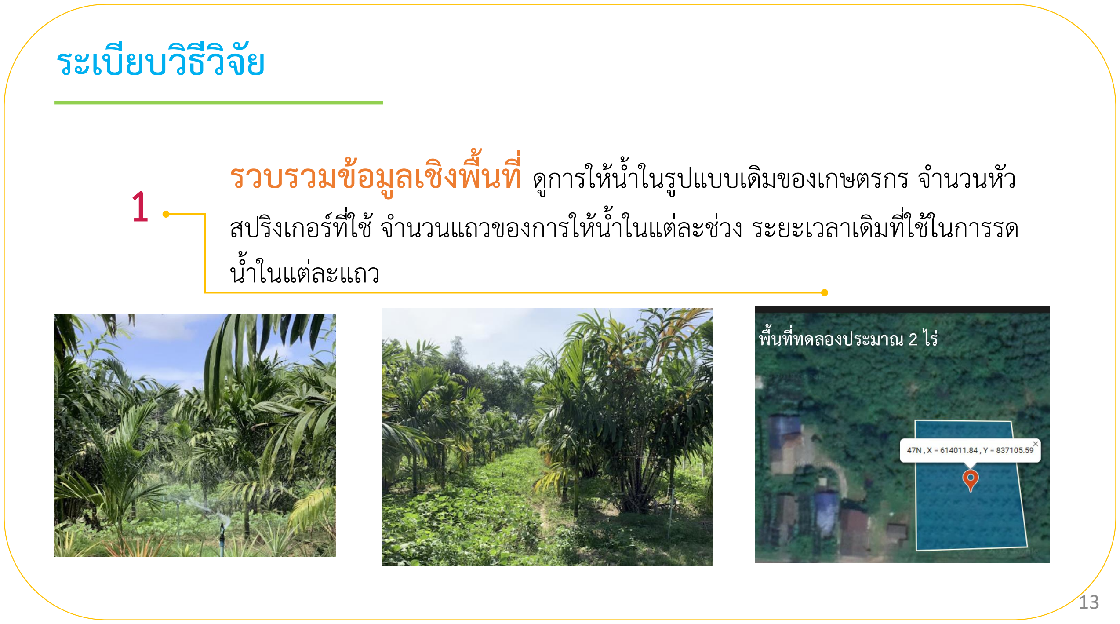
[picture p243: page 13]

1

## สปริงเกอร์ที่ใช้ จ้านวนแถวของการให้น ้าในแต่ละช่วง ระยะเวลาเดิมที่ใช้ในการรด น ้าในแต่ละแถว

# วิเคราะห์ปัญหาจากการให้น ้าในรูปแบบเดิม

2

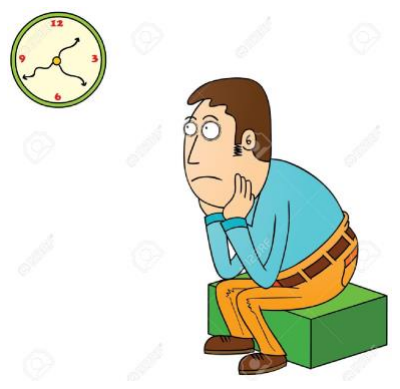
[picture p244: figure]

## ต้องเฝ้าการให้น ้าตลอดเวลา กลัวน ้าหมดบ่อ กลัวให้น ้ามากเกินไป

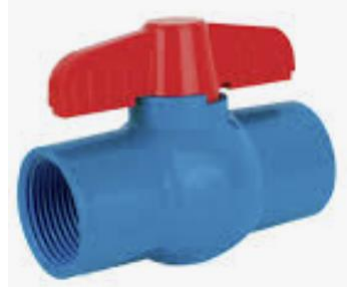
[picture p245: figure]

## ต้องปรับสลับแถวรดน ้าเอง

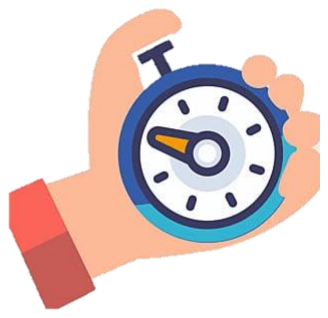
[picture p246: figure]

## คาดคะเนปริมาณการให้น ้าด้วย การกะเวลา

# ระเบียบวิธีวิจัย : ต่อ

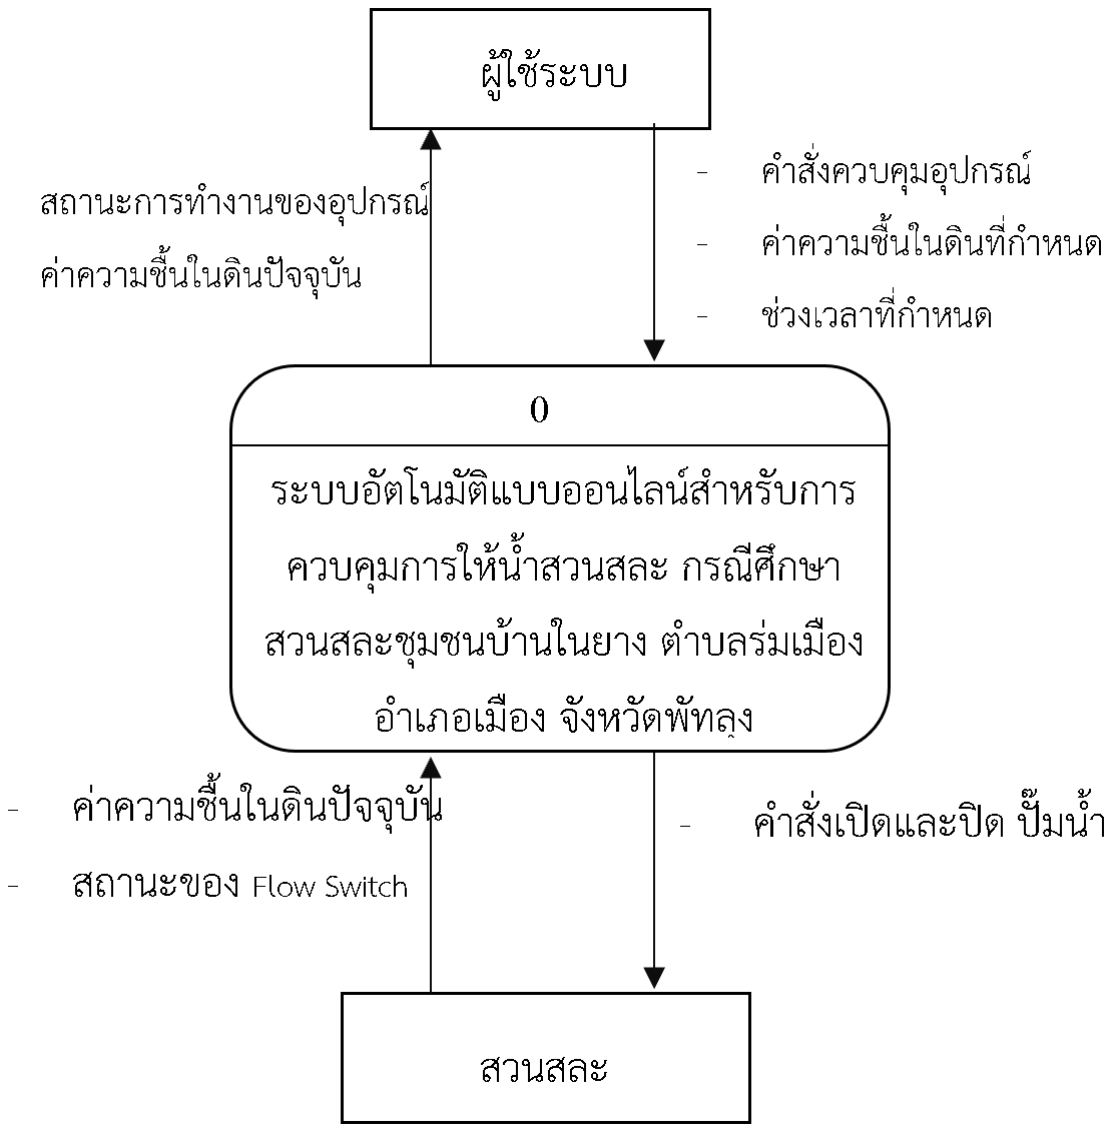
[picture p247: figure]

# ออกแบบระบบ

3

# 3.1 Context Diagram

# ระเบียบวิธีวิจัย : ต่อ

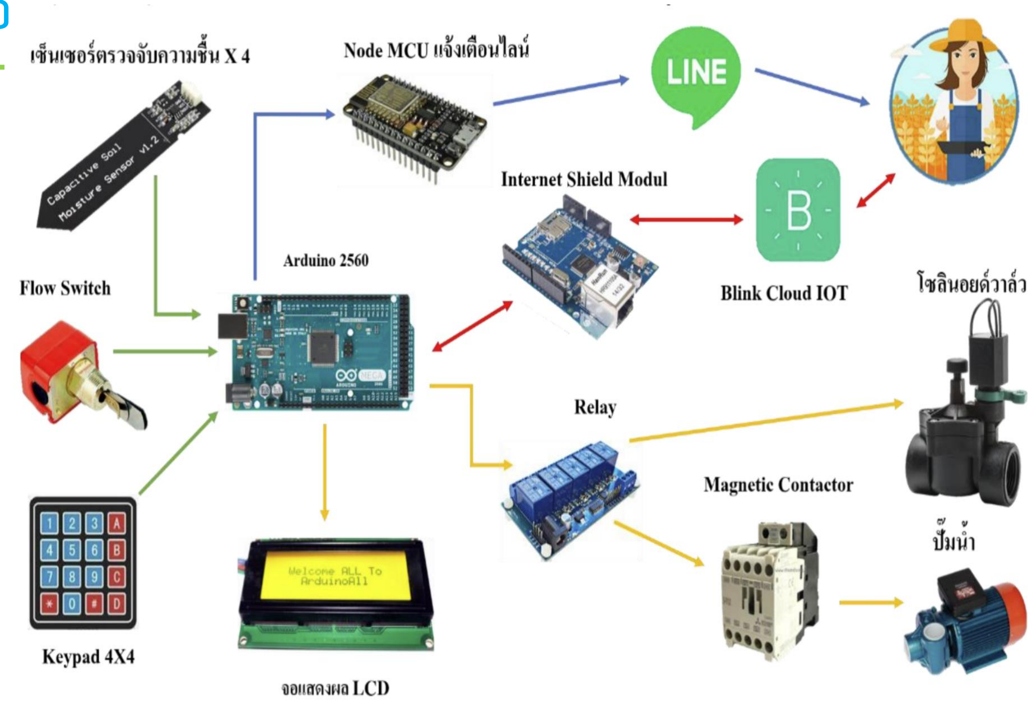
[picture p248: figure]

# ออกแบบระบบ

3

# 3.2 Hardware Interface

# ระเบียบวิธีวิจัย : ต่อ

# สร้างและพัฒนาระบบทางด้านฮาร์ดแวร์

4

# ระเบียบวิธีวิจัย : ต่อ

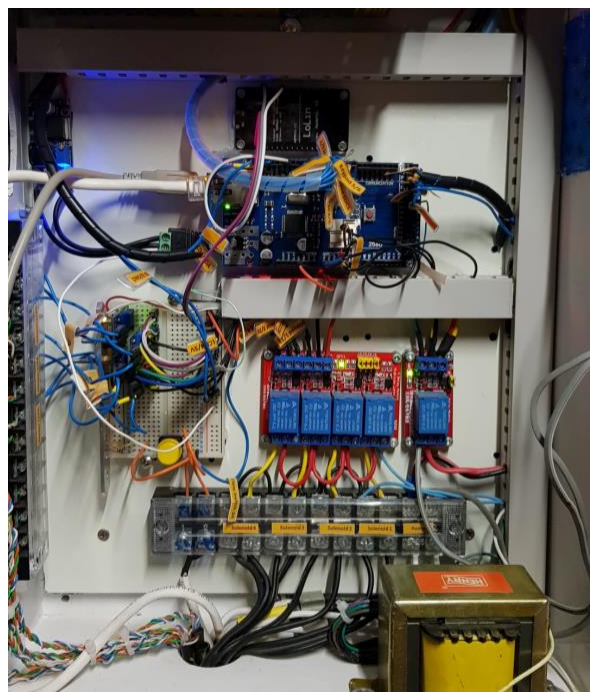
[picture p249: figure]
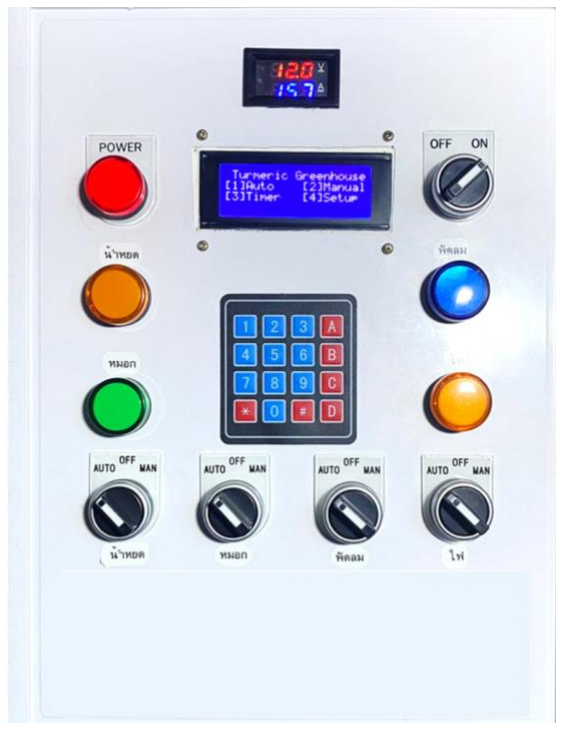
[picture p250: figure]

# พัฒนาซอฟต์แวร์ที่ใช้ในการควบคุมระบบ

5

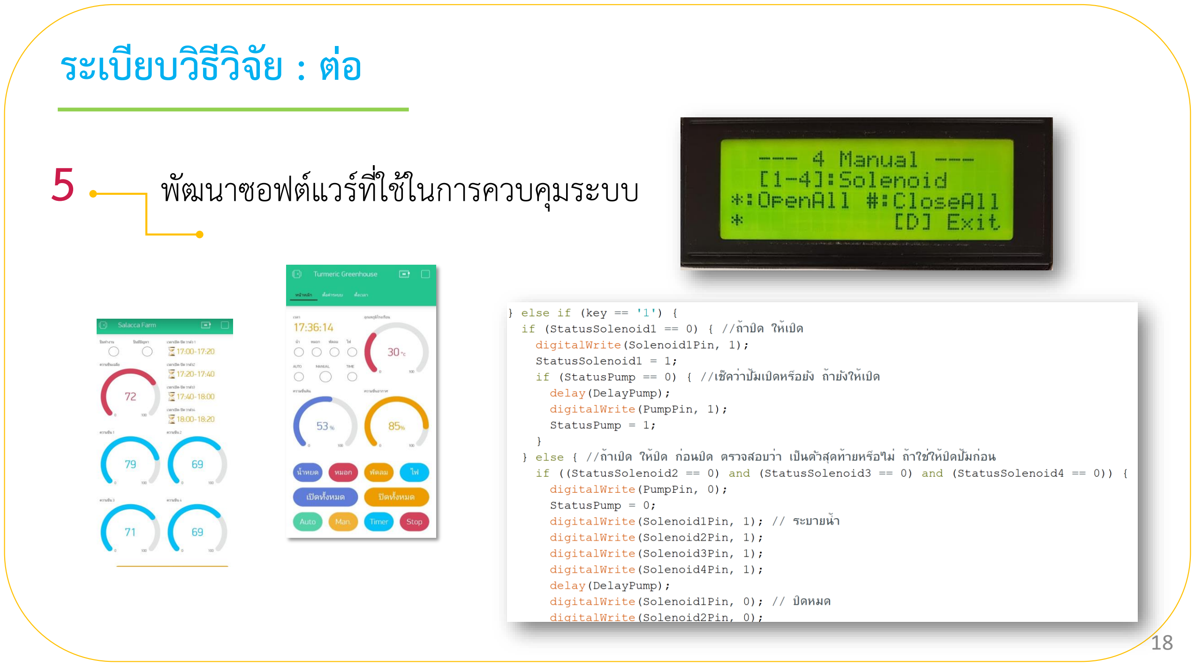
[picture p251: page 18]

# ระเบียบวิธีวิจัย : ต่อ

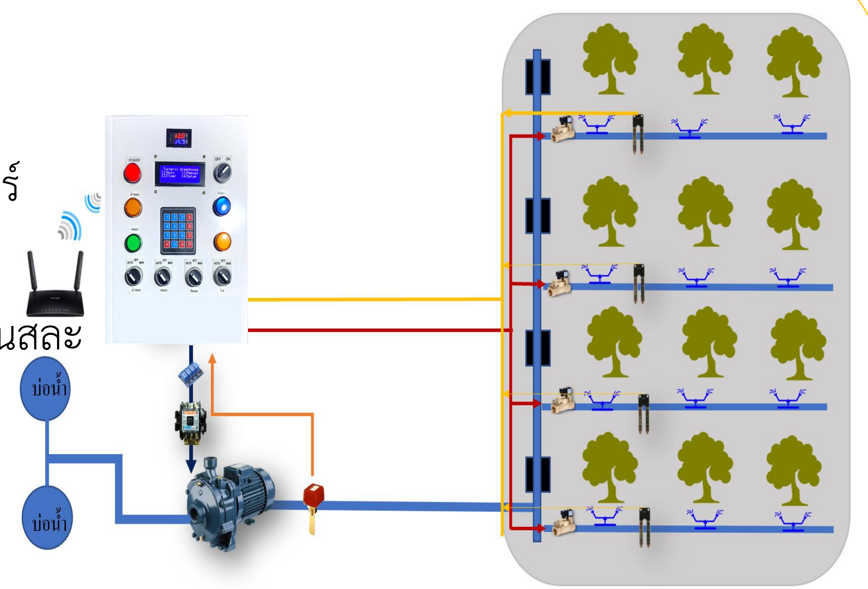
[picture p252: figure]

# ทดสอบการท้างานของฮาร์ดแวร์

6
7

# ติดตั งตู้ควบคุมระบบภายในสวนสละ 8 ติดตั งโซลินอยวาล์ว

# 9 ติดตั งเซนเซอร์วัดความชื น

10 ติดตั งระบบอินเตอร์เน็ต | เชื่อมต่อตู้ควบคุมระบบเข้ากับระบบอินเตอร์เน็ต 11

# ระเบียบวิธีวิจัย : ต่อ

# ระเบียบวิธีวิจัย : ต่อ

# ทดสอบการท้างานของระบบที่ได้ติดตั ง

12

# ปรับปรุงแก้ไข จากปัญหาที่เกิดขึ น 13

# จัดท้าคู่มือ 14

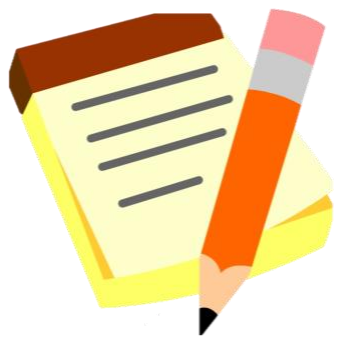
[picture p253: figure]
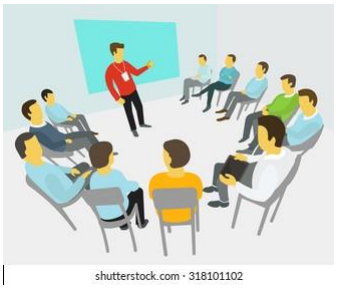
[picture p254: figure]

# ถ่ายทอดเทคโนโลยี 15

# แผนด้าเนินงาน

กิจกรรม | ระยะเวลาในการด้าเนินงาน

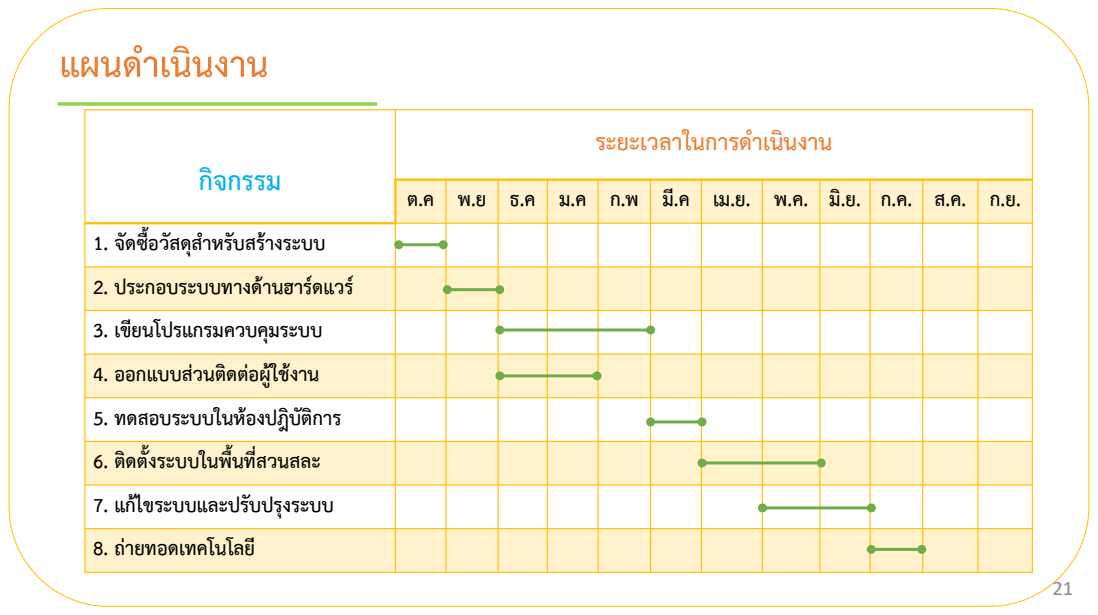
[picture p255: page 21]

1. จัดซื อวัสดุส้าหรับสร้างระบบ
2. ประกอบระบบทางด้านฮาร์ดแวร์
3. เขียนโปรแกรมควบคุมระบบ
4. ออกแบบส่วนติดต่อผู้ใช้งาน
5. ทดสอบระบบในห้องปฎิบัติการ
6. ติดตั งระบบในพื นที่สวนสละ
7. แก้ไขระบบและปรับปรุงระบบ
8. ถ่ายทอดเทคโนโลยี

# งบประมาณ

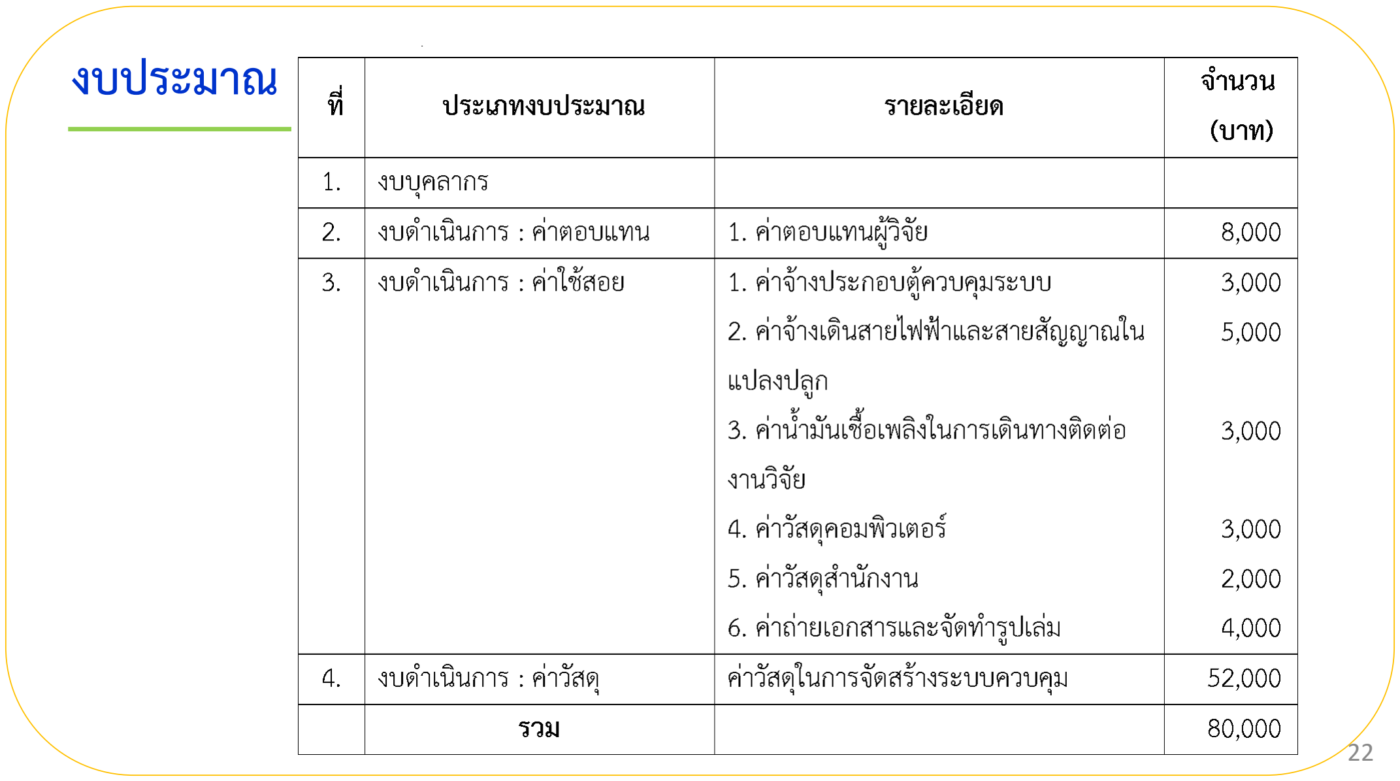
[picture p256: page 22]

# งบประมาณ : แจงรายละเอียด

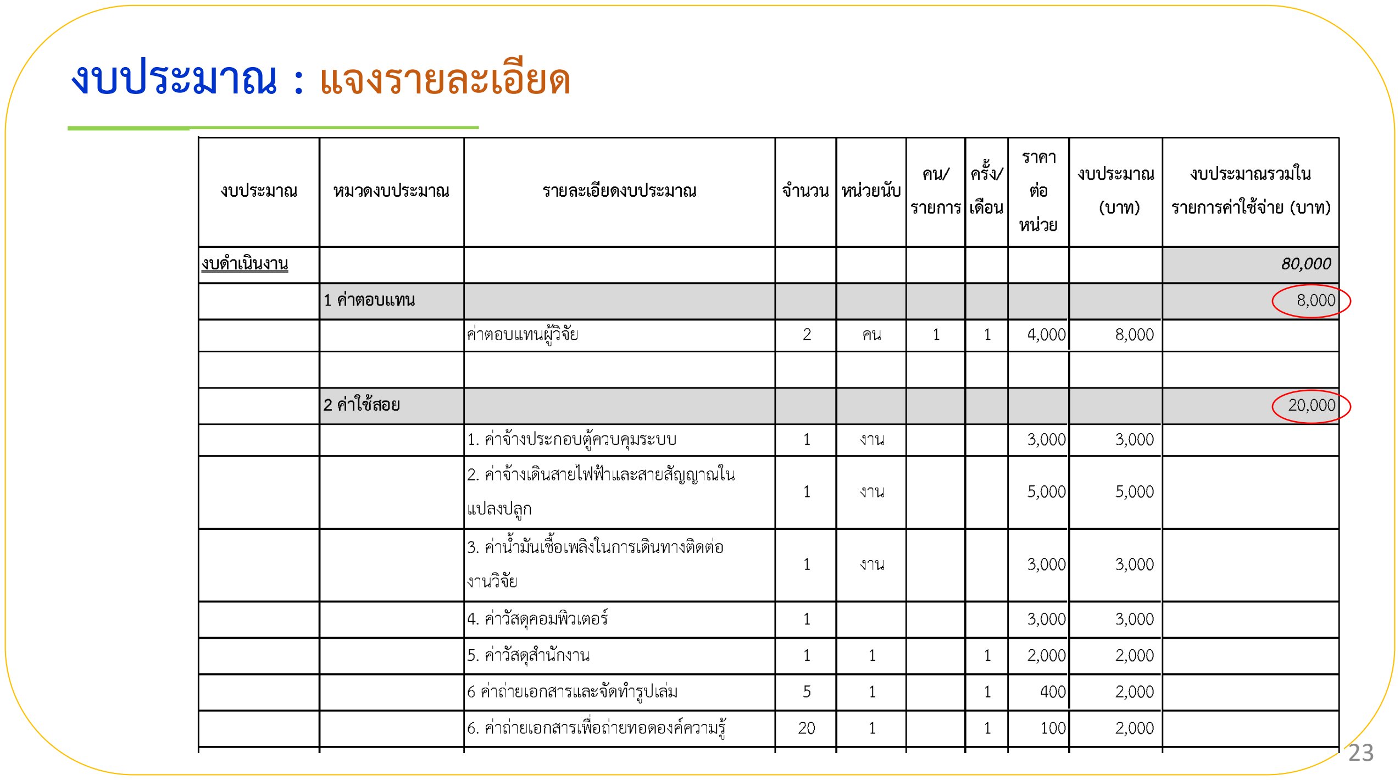
[picture p257: page 23]

# งบประมาณ : แจงรายละเอียด

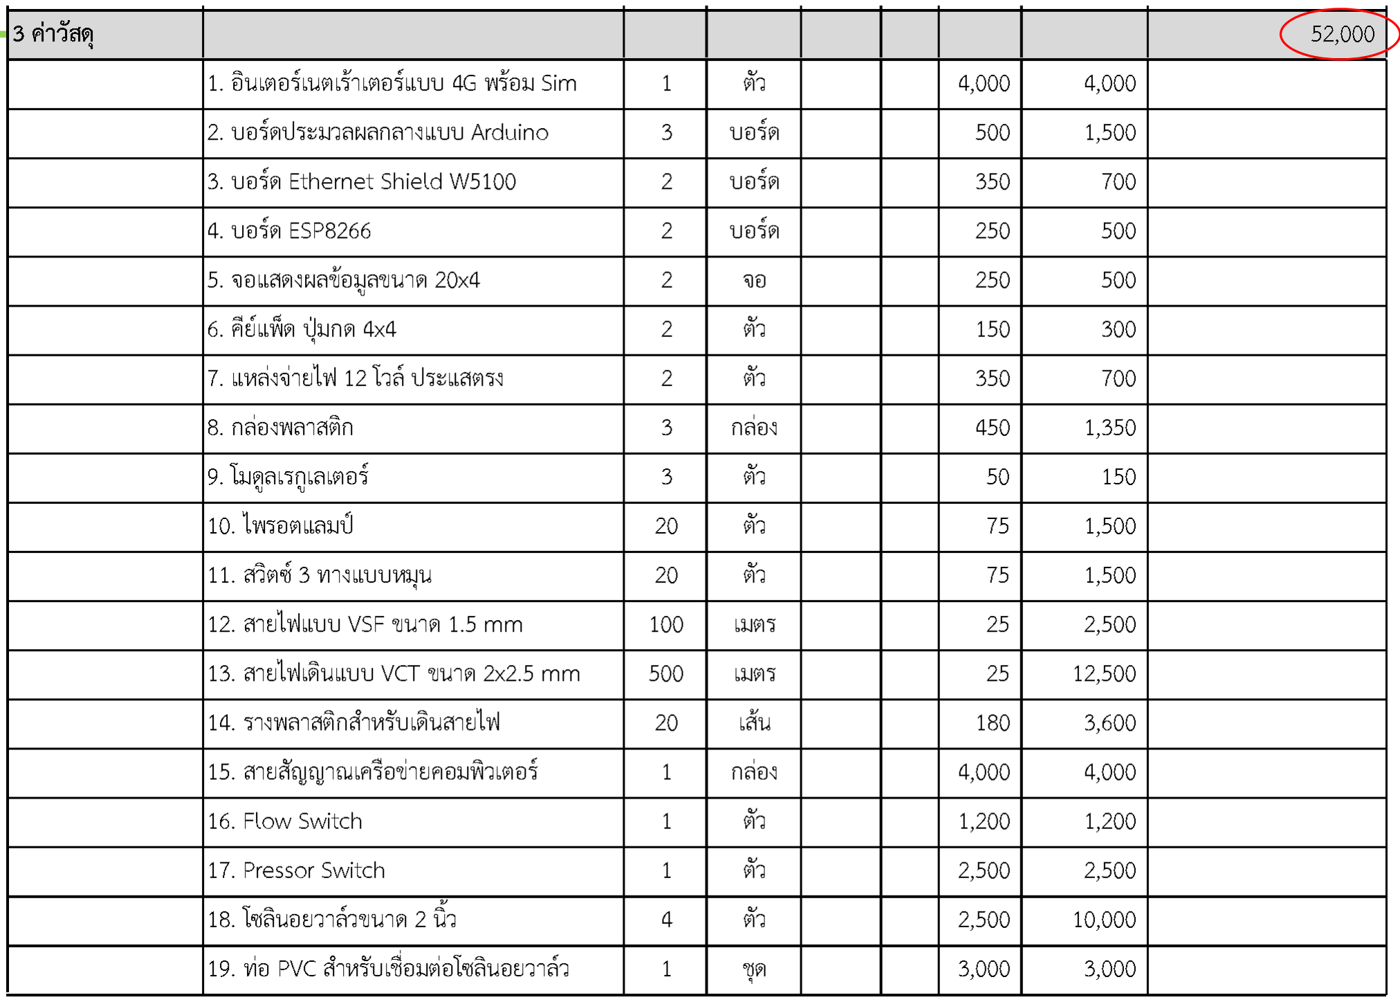
[picture p258: figure]

### * รวมเผื่อช้ารุด

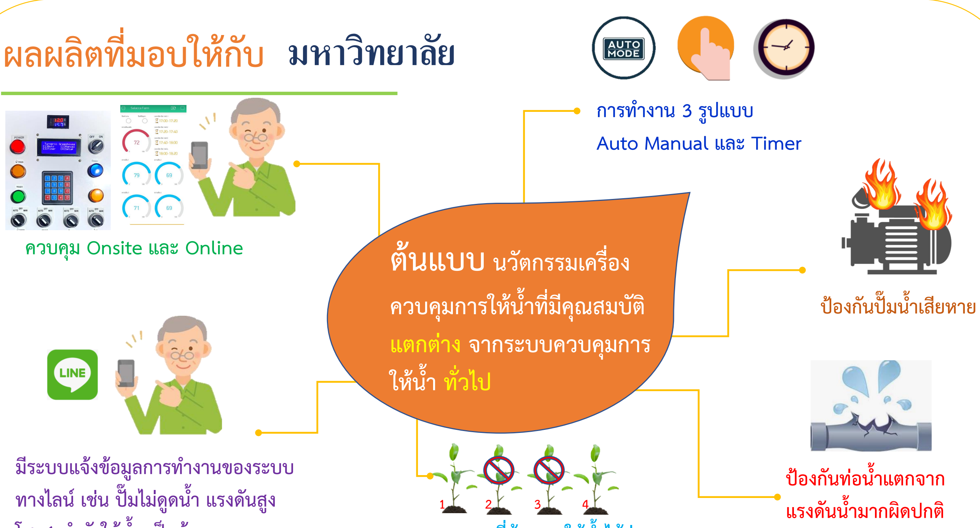
[picture p259: figure]
ผลผลิตที่มอบให้กับ; ต้นแบบ นวัตกรรมเครื่อง; ควบคุมการให้น ้าที่มีคุณสมบัติ แตกต่าง จากระบบควบคุมการ ให้น ้า ทั่วไป; ควบคุม Onsite และ Online; มหาวิทยาลัย; การท้างาน 3 รูปแบบ Auto Manual และ Timer; ป้องกันปั๊มน ้าเสียหาย; ป้องกันท่อน ้าแตกจาก แรงดันน ้ามากผิดปกติ; มีระบบแจ้งข้อมูลการท้างานของระบบ ทางไลน์เช่น ปั๊มไม่ดูดน ้า แรงดันสูง

โซน1 ก้าลังให้น ้า เป็นต้น | ระบุแถวที่ต้องการให้น ้าได้ว่าจะ ให้แถวไหนบ้าง

# แผนที่ผลลัพธ์ : Outcome Mapping

Input | Output | Outcome | Impact
User | Change
1.งบวิจัย 80,000 บาท

### 2. ระยะเวลา 1 ปี 3. นักวิจัย 2 คน 4. องค์ความรู้

- องค์ความรู้เกี่ยวกับการ
พัฒนาระบบอัตโนมัติ
และ IoT
- องค์ความรู้เกี่ยวกับการ
ออกแบบระบบน ้าทาง
การเกษตร
1. ต้นแบบเทคโนโลยีของ
การประยุกต์ใช้ระบบให้
น ้าแบบอัตโนมัติส้าหรับ
การเกษตรที่มีคุณสมบัติ
ป้องกันความเสียหาย
ของปั๊มน ้าได้
2. ชุดความรู้เกี่ยวกับการ
พัฒนาระบบให้น ้า
ทางการเกษตรที่สามารถ
ให้น ้าตามค่าความชื นใน
ดินและสามารถป้องกัน
ความเสียหายของปั๊มน ้า
ได้
3. เกษตรกรมีทักษะในการ
ใช้ระบบอัตโนมัติมาช่วย
ในการเกษตร
1. เกษตรกรผู้ปลูกสละ
ชุมชนบ้านในยาง อ.เมือง
จ.พัทลุง
2. นักวิชาการเกษตร
3. เกษตรกรทั่วไป
4. หน่วยงานที่มีหน้าที่
สนับสนุนทางการเกษตร
ชุมชน
1. สามารถใช้ระบบการให้
น ้าทางการเกษตรที่มี
ประสิทธิภาพเหมาะสมต่อ
พืชปลูกและพื นที่
2. เกษตรกรมีความรู้
ทางด้านระบบการให้น ้า
แบบอัตโนมัติเพิ่มมากขึ น
3. สามารถน้าระบบไป
พัฒนาและประยุกต์ใช้ใน
การเกษตรอื่นๆ
1. ผลกระทบด้านสังคม : มีเวลาใน การพบปะพูดคุยเข้าร่วมกิจกรรม ในสังคมมากขึ น
2. ผลกระทบด้านเศรษฐกิจ :
- เกษตรกรมีรายได้เพิ่มขึ น
- ท้าให้เพิ่มมูลค่าทางธุรกิจอาหาร เกษตรปลอดภัยในจังหวัดพัทลุง
3. ด้านสิ่งแวดล้อม
- ประหยัดทรัพยากรน ้า
- ประหยัดพลังงาน
- เกิดความตระหนัก รับผิดชอบต่อ การอนุรักษ์และฟื้นฟูทรัพยากรใน ท้องถิ่น

# อ้างอิง

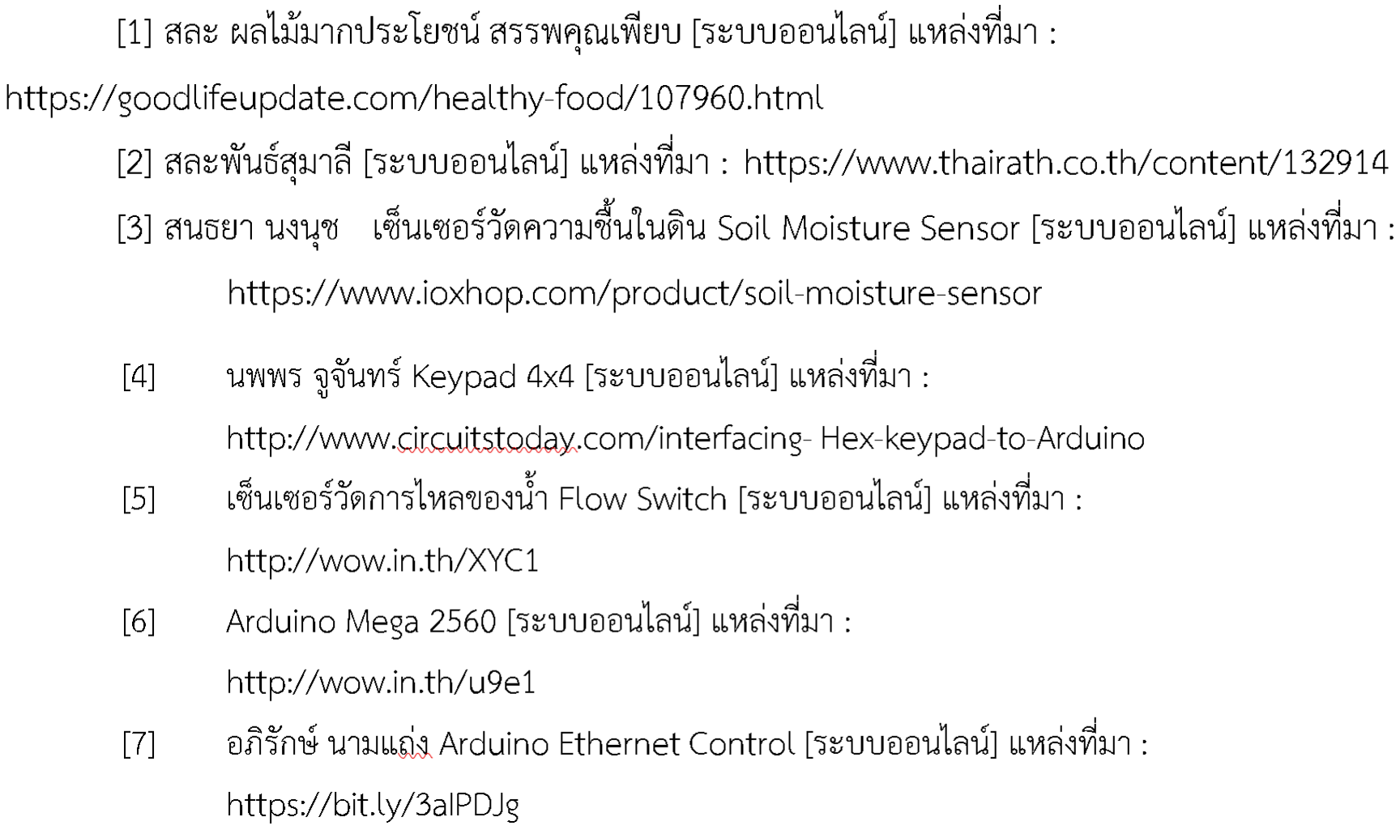
[picture p260: figure]

# อ้างอิง : ต่อ

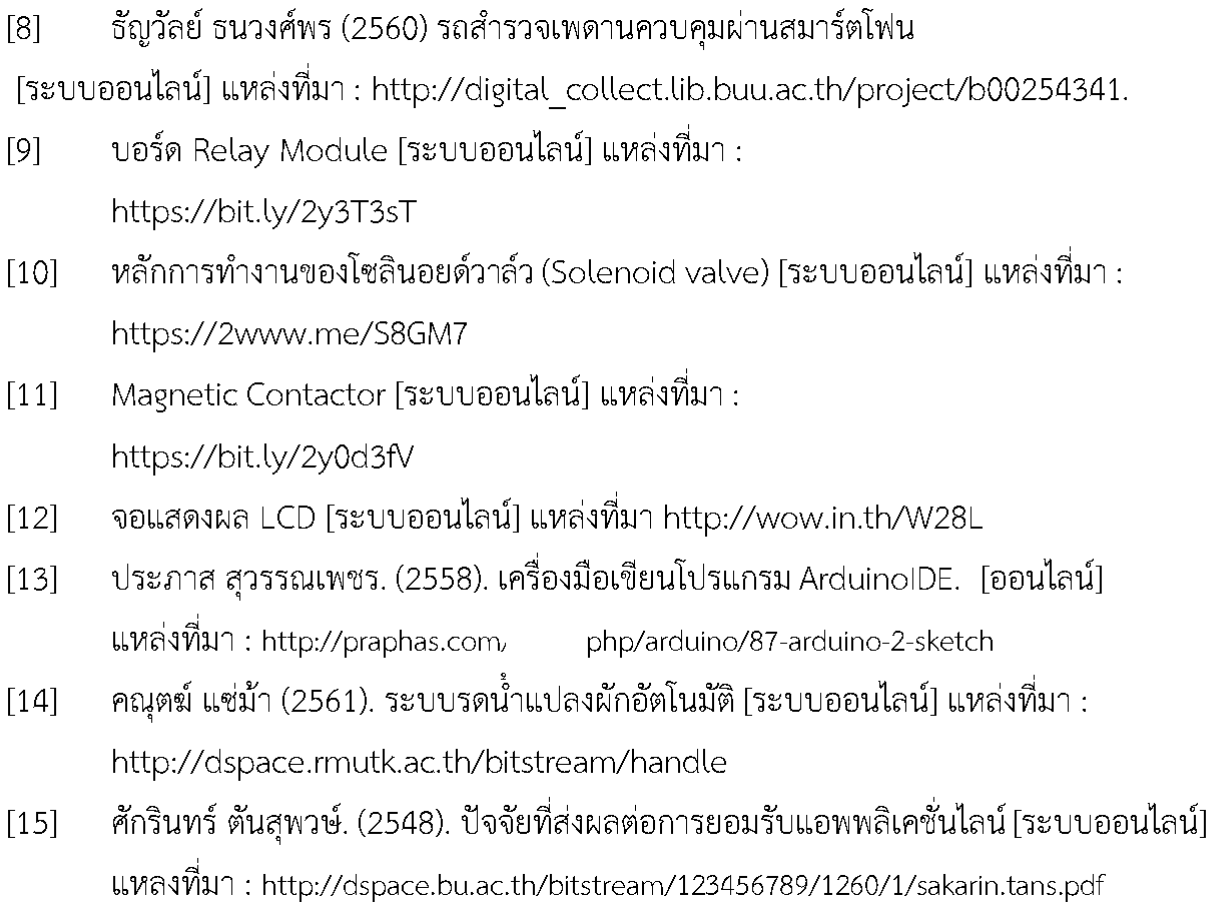
[picture p261: figure]

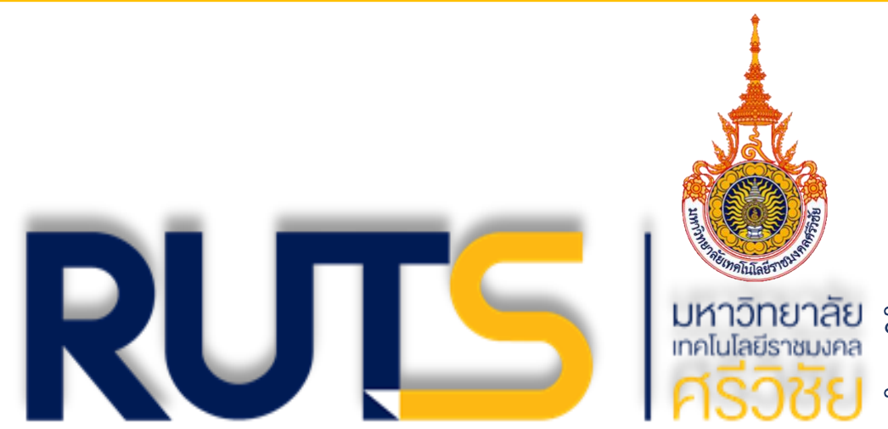
[picture p262: figure]
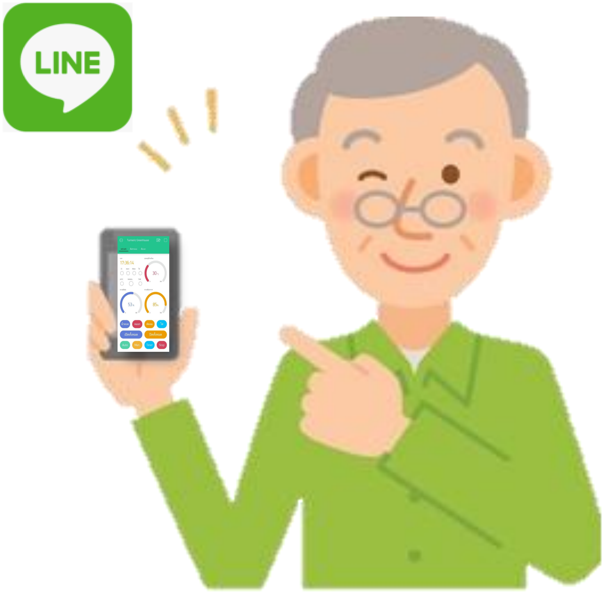
[picture p263: figure]
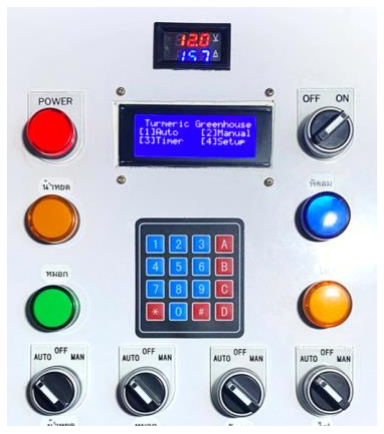
[picture p264: figure]

# จบการน้าเสนอ…ขอบคุณครับ

### มหาวิทยาลัย นวัตกรรม เพื่อสังคม
