PipeNitch/Project_WPNS-IoT/Example/ระบบควบคุมอุปกรณ์ไฟฟ้าระยะไกล.pdf

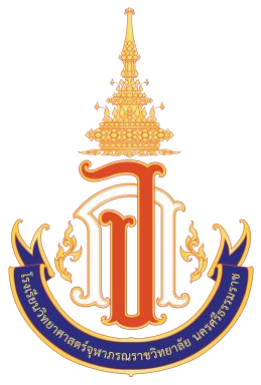
[picture p265: figure]

## โครงงานวิทยาศาสตร์ เรื่องระบบควบคุมอุปกรณ์ไฟฟ้าระยะไกล Remote control of electrical devices

โดย
1. เด็กชายธนทัต จิตเมตไตร | ห้อง 203 | เลขที่ 5
2. เด็กชายธนพล สองรักษ์ | ห้อง 204 | เลขที่ 2
3. เด็กชายธรรมนิตย์ หนูยิ้มซ้าย | ห้อง 204 | เลขที่ 4

รายงานนี้เป็นส่วนหนึ่งของรายวิชา โครงงานวิทยาศาสตร์ 2 ตามหลักสูตรโรงเรียนวิทยาศาสตร์จุฬาภรณราชวิทยาลัย นครศรีธรรมราช ภาคเรียนที่ 2 ปีการศึกษา 2564

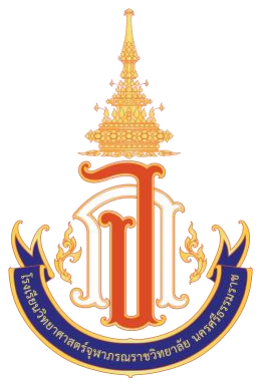
[picture p266: figure]

## โครงงานวิทยาศาสตร์ เรื่องระบบควบคุมอุปกรณ์ไฟฟ้าระยะไกล Remote control of electrical devices

โดย
1. เด็กชายธนทัต จิตเมตไตร | ห้อง 203 | เลขที่ 5
2. เด็กชายธนพล สองรักษ์ | ห้อง 204 | เลขที่ 2
3. เด็กชายธรรมนิตย์ หนูยิ้มซ้าย | ห้อง 204 | เลขที่ 4

ครูที่ปรึกษา
นายฐปนวัฒน์ ชูกลิ่น

รายงานนี้เป็นส่วนหนึ่งของรายวิชา โครงงานวิทยาศาสตร์ 2 ตามหลักสูตรโรงเรียนวิทยาศาสตร์จุฬาภรณราชวิทยาลัย นครศรีธรรมราช ภาคเรียนที่ 2 ปีการศึกษา 2564

ก

## บทคัดย่อ

โครงงานระบบควบคุมอุปกรณ์ไฟฟ้าระยะไกล มีจุดประสงค์เพื่อสร้างระบบอัตโนมัติแบบ ออนไลน์ส าหรับควบคุมเครื่องใช้ไฟฟ้า เพื่อศึกษาการท างานของระบบอัตโนมัติแบบออนไลน์ส าหรับ ควบคุมเครื่องใช้ไฟฟ้า และเพื่อศึกษาการรับ-ส่งข้อมูลผ่านแอปพลิเคชัน Blynk และแอบพลิเคชัน Line ทางผู้จัดท าจึงได้คิดค้นอุปกรณ์เพื่อควบคุมอุปกรณ์ไฟฟ้าระยะไกลขึ้น ผ่านแอปพลิเคชัน Blynk และ แอบพลิเคชัน Line ขึ้น
ทั้งนี้จากการทดลองควบคุมอุปกรณ์ไฟฟ้าระยะไกล จ านวน 20 ครั้ง ผลปรากฎว่าสามารถ ควบคุมได้ทุกครั้ง มีความแม่นย า ร้อยละ 100 อีกทั้งการควบคุมอุปกรณ์ดังกล่าว แม้ระบบสัญญาณ อินเตอร์เน็ตในบางครั้งอาจจะไม่เสถียร ระบบอาจจะหยุดท างาน แต่เมื่อสัญญาณอินเตอร์เน็ตใช้ได้ เป็นปกติ ระบบจะท างานอย่างต่อเนื่อง ไม่เกิดปัญหาที่จะต้องไปเริ่มต้นใหม่ ซึ่งถือว่าเป็นข้อดีของการ พัฒนาระบบควบคุมดังกล่าวที่คณะผู้จัดท าได้พัฒนาขึ้น

ข

## กิตติกรรมประกาศ

โครงงานเรื่องระบบควบคุมอุปกรณ์ไฟฟ้าระยะไกล สามารถส าเร็จลุล่วงได้ด้วยความกรุณา ช่วยเหลือ แนะน า ให้ค าปรึกษา ตรวจสอบแก้ไขข้อบกพร่องต่าง ๆ ด้วยความเอาใจใส่อย่างดียิ่งจาก คุณครูฐปนวัฒน์ ชูกลิ่น ครูผู้สอนรายวิชาเทคโนโลยีและวิทยาการค านวณ ว22103 ขอขอบพระคุณผู้ปกครองและคุณครูทุกท่าน ที่มีส่วนช่วยในการสนับสนุนค่าอุปกรณ์และคอย ช่วยเหลือสนับสนุนเป็นก าลังใจ ให้ผู้จัดท าโครงงานสามารถท าโครงงานชิ้นนี้ได้เสร็จสมบูรณ์ นอกจากนี้ยังมีผู้ที่ให้ความร่วมมือช่วยเหลืออีกหลายท่าน ซึ่งผู้เขียนไม่สามารถกล่าวนามในที่นี้ได้หมด จึงขอขอบคุณทุกท่านไว้ ณ โอกาสนี้ด้วย
สุดท้ายนี้ หากผลส าเร็จของโครงงานฉบับนี้เป็นประโยชน์แก่ผู้ที่สนใจและเป็นประโยชน์ทาง การศึกษา ผู้จัดท าขอมอบคุณค่าและคุณประโยชน์ที่มาจากโครงงานฉบับนี้ แด่คณะครูโรงเรียน วิทยาศาสตร์จุฬาภรณ์ราชวิทยาลัย นครศรีธรรมราช และผู้มีพระคุณทุกท่าน

ธนทัต จิตเมตไตร
ธนพล สองรักษ์
ธรรมนิตย์ หนูยิ้มซ้าย

ค

## สารบัญ

หน้า

บทคัดย่อ | ก
กิตติกรรมประกาศ | ข
สารบัญ | ค
สารบัญตาราง | ง
สารบัญภาพ | จ
บทที่ 1 บทน า | 1
ที่มาและความส าคัญ | 1
วัตถุประสงค์ของโครงงาน | 1
ขอบเขตของโครงงาน | 1
สมมุติฐาน | 2
ตัวแปรที่ศึกษา | 2
นิยามเชิงปฏิบัติการ | 2
บทที่ 2 เอกสารและงานวิจัยที่เกี่ยวข้อง | 3
บทที่ 3 วิธีการด าเนินการทดลอง | 10
บทที่ 4 ผลการทดลอง | 12
บทที่ 5สรุป อภิปรายผล และข้อเสนอแนะ | 17
เอกสารอ้างอิง | 19
ภาคผนวก | 20

ง

## สารบัญตาราง

ตารางที่ | หน้า

ตารางที่ 4.1 แสดงผลการทดลองการควบคุมอุปกรณ์ไฟฟ้า ผ่านแอปพลิเคชัน Blynk
ครั้งละ 1 Channel | 13
ตารางที่ 4.2 แสดงผลการทดลองการควบคุมอุปกรณ์ไฟฟ้า ผ่านแอปพลิเคชัน Blynk
ครั้งละ 2 Channel | 13
ตารางที่ 4.3 แสดงผลการทดลองการควบคุมอุปกรณ์ไฟฟ้า จากสวิสต์ที่บอร์ดควบคุม 14 ตารางที่ 4.4 แสดงผลการทดลองการควบคุมอุปกรณ์ไฟฟ้า แบบผสมผสาน
โดยผ่านแอปพลิเคชัน Blynk และจากสวิสต์ที่บอร์ดควบคุม | 15

จ

## สารบัญภาพ

ภาพที่ | | หน้า
ภาพที่ 2.1 | NodeMCU | 3
ภาพที่ 2.2 | บอร์ดรีเลย์ 4 ช่องสัญญาณ | 4
ภาพที่ 2.3 | แสดงสัญลักษณ์ในวงจนไฟฟ้าของรีเลย์ | 5
ภาพที่ 2.4 | การเชื่อมต่อขาสัญญาณ Relay 4 Channel กับบอร์ด Arduino | 6
ภาพที่ 2.5 | การจัดวางปุ่มของ Tact Switch | 6
ภาพที่ 2.6 | การต่อวงจรของ Tact Switch | 7
ภาพที่ 2.7 | โปรแกรม Blynk | 7
ภาพที่ 2.8 | การออกแบบโปรแกรม โดยผู้ใช้งานก าหนดเอง | 8
ภาพที่ 2.9 | Application Line | 8
ภาพที่ 4.1 | ผลการสร้างระบบอัตโนมัติแบบออนไลน์ส าหรับควบคุมอุปกรณ์
| ไฟฟ้าระยะไกล | 12
ภาพที่ 4.2 | การท างานของระบบอัตโนมัติแบบออนไลน์ ส่งข้อมูล
| ผ่านแอปพลิเคชัน Blynk | 12

## บทที่ 1 บทน า

### 1.1 ที่มาและความส าคัญ

ในปัจจุบันการควบคุมเครื่องใช้ไฟฟ้าในบ้าน ที่ท างาน หรือหน่วยงานต่าง ๆ ยังคงเป็นแบบ เปิดปิดโดยการกดสวิตช์หรือเปิดปิดอุปกรณ์ทีละอย่าง ไม่สามารถควบคุมอุปกรณ์ได้หลายๆ อย่างใน เวลาเดียวกันได้ และหากต้องอยู่นอกสถานที่ ไม่สามารถสั่งการท างานของอุปกรณ์ในระยะไกลได้ ผู้จัดท า จึงมีแนวคิดที่จะจัดท าระบบการควบคุมไฟฟ้าจากระยะไกลขึ้น ซึ่งสามารถท างาน ได้ 2 ภาพแบบ คือ อัตโนมัติตามเวลาและ เปิด – ปิดโดยผู้ใช้เอง ทั้งนี้ระบบสามารถแจ้งเตือนออนไลน์ ผานแอพ Blynk ได้ซึ่งแนวคิดดังกล่าว สามารถลดปัญหาการลืมเปิด – ปิดอุปกรณ์ไฟฟ้าเมื่อออกจาก บ้าน ช่วยอ านวยความสะดวกในการควบคุมเครื่องใช้ไฟฟ้าในบ้าน ตลอดถึงมีความปลอดภัยในการ ด ารงชีวิตประจ าวัน
ทั้งนี้ โครงงานดังกล่าวผู้จัดท าได้เล็งเห็นความก้าวหน้าทางด้านเทคโนโลยีคอมพิวเตอร์ และ เทคโนโลยีในการสื่อสาร ที่มีศักยภาพสูงสามารถน ามาใช้เพื่อให้เกิดประโยชน์ในชีวิตประจ าวันและ เกิดประโยชน์ต่อผู้ที่สนใจศึกษา จึงเกิดเป็นโครงงานนี้ขึ้น

### 1.2 วัตถุประสงค์

1.2.1 เพื่อสร้างระบบอัตโนมัติแบบออนไลน์ส าหรับควบคุมเครื่องใช้ไฟฟ้า
1.2.2 เพื่อศึกษาการท างานของระบบอัตโนมัติแบบออนไลน์ส าหรับควบคุมเครื่องใช้ไฟฟ้า 1.2.3 เพื่อศึกษาการรับ-ส่งข้อมูลผ่านแอปพลิเคชัน Blynk และแอบพลิเคชัน Line

### 1.3 ขอบเขตของการศึกษา

1.3.1 ระบบสามารถควบคุมอุปกรณ์ไฟฟ้าโดยอัตโนมัติตามค่าที่ก าหนดได้
1.3.2 ระบบสามารถท างานได้ 2 ภาพแบบ คือ อัตโนมัติตามเวลาและเปิด – ปิดโดยผู้ใช้เอง 1.3.3 ระบบจัดท าเป็นตู้ควบคุมที่สามารถใช้งานได้ง่าย
1.3.4 ระบบสามารถแจ้งเตือนออนไลน์ผ่านแอพ Blynk ได้
1.3.5 แจ้งเตือนการท างานของอุปกรณ์ไฟฟ้าผ่านแอพพลิเคชันไลน์
1.3.6 ระบบสามารถควบคุมการท างานได้แบบออนไลน์

สถานที่ : โรงเรียนวิทยาศาสตร์จุฬาภรณ์ราชวิทยาลัย นครศรีธรรมราช ระยะเวลา : 1 ปีการศึกษา

### 1.4 สมมุติฐาน

ระบบอัตโนมัติแบบออนไลน์ส าหรับควบคุมเครื่องใช้ไฟฟ้า สามารถท างานผ่านแอปพลิเคชัน Blynk และแอบพลิเคชัน Line ได้

### 1.5 ตัวแปรที่ศึกษา

ตัวแปรต้น | ระบบอัตโนมัติแบบออนไลน์ส าหรับควบคุมเครื่องใช้ไฟฟ้า
ตัวแปรตาม | การเปิด-ปิดเครื่องใช้ไฟฟ้าด้วยระบบอัตโนมัติ
ตัวแปรควบคุม ความเสถียรของระบบเครือข่ายอินเตอร์เน็ต

### 1.6 นิยามเชิงปฏิบัติการ

อุปกรณ์ไฟฟ้า หมายถึง ระบบไฟฟ้า หรือเครื่องใช้ไฟฟ้าต่าง ๆ
ระยะไกล หมายถึงระบบควบคุมการท างานแบบอัตโนมัติเพื่อให้อุปกรณ์หรือเครื่องใช้ไฟฟ้า ท างานผ่านแอปพลิเคชัน Blynk และ Line ซึ่งสามารถควบคุมการท างานของระบบไฟฟ้าและอุปกรณ์ ไฟฟ้าได้

## บทที่ 2 เอกสารและงานวิจัยที่เกี่ยวข้อง

การจัดท าโครงงานวิทยาศาสตร์ เรื่องระบบควบคุมอุปกรณ์ไฟฟ้าระยะไกล มีวัตถุประสงค์ เพื่อสร้างระบบอัตโนมัติแบบออนไลน์ส าหรับควบคุมเครื่องใช้ไฟฟ้า เพื่อศึกษาการท างานของระบบ อัตโนมัติแบบออนไลน์ส าหรับควบคุมเครื่องใช้ไฟฟ้า และเพื่อศึกษาการรับ-ส่งข้อมูลผ่านแอปพลิเคชัน Blynk และแอบพลิเคชัน Line ผู้จัดท าได้ศึกษาค้นคว้า รวบรวมเอกสาร แนวคิดทฤษฎีที่เกี่ยวข้อง ดังต่อไปนี้
1. ทฤษฎีเกี่ยวกับบอร์ด Nodemcu
2. ทฤษฎีเกี่ยวกับบอร์ดรีเลย์ 4 ช่องสัญญาณ (Relay 4CH)
3. ทฤษฎีเกี่ยวข้องกับการท างานของ Tact Switch
4. ทฤษฎีเกี่ยวกับ Blynk
5. ทฤษฎีเกี่ยวกับแอปพลิเคชัน Line

### 2.1 ทฤษฎีเกี่ยวกับบอร์ด NodeMcu

บอร์ดของ NodeMCU ประกอบไปด้วย ไมโครคอนโทรลเลอร์ที่สามารถเชื่อมต่อ WiFi ได้ พร้อมอุปกรณ์อ านวยความสะดวกต่าง ๆ เช่น พอร์ต micro USB ส าหรับจ่ายไฟ/อัปโหลดโปรแกรม ชิพส าหรับอัปโหลดโปรแกรมผ่านสาย USB, ชิพแปลงแรงดันไฟฟ้า และขาส าหรับเชื่อมต่ออุปกรณ์ ภายนอก เป็นต้น ซึ่งในตอนนี้ทาง NodeMCU จะออกมาอีกสองรุ่น คือ รุ่น 0.9 กับ รุ่น 1.0 ทาง ผู้พัฒนาตั้งใจจะออกNodeMCU ให้เป็น platform ที่ออกแบบทุกอย่างเป็น Node การท างานย่อย ๆ และใช้ภาษา Lua ในการเขียนโปรแกรม แต่ด้วย platfrom ที่สะดวกในการใช้งาน ทางกลุ่มนักพัฒนา ของ ESP8266 ก็เลยน า NodeMCU มาบรรจุในเป็นบอร์ดหนึ่งของ ARDUINO IDE (ESP8266) ด้วย จึงได้มีการพัฒนาต่อให้สามารถเขียนในภาษา C/C++ ซึ่งนักพัฒนาด้านไมโครคอนโทรลเลอร์คุ้นเคย กว่า ภาษา Lua จึงท าให้ได้รับความนิยมทดลองใช้กันอย่างกว้างขวางดังภาพที่ 2.1

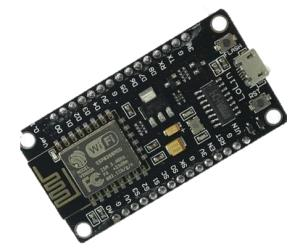
[picture p267: figure]

ภาพที่ 2.1 Nodemcu
ลักษณะโครงสร้างของโมดูล Nodemcu ESP 8266 ซึ่งมีรายละเอียด ดงัต่อไปนี้ 2.1.1 ใช้โมดูล ESP-1 2E (ESP8266 SoC chip) ของบริษัท AI Thinker (ในขณะที่ NodeMCU v1 ใช้โมดูล ESP12) มีขาเพิ่มมาอีก6ขา เมื่อเปรียบเทียบกับ ESP-12 2.1.2 ใช้ชิป Flash ความจุ 32Mbits (4MBytes)

2.1.3 มีขนาดแคบกว่า NodeMCU v1 ดังนั้นเมื่อเสียบขาลงบนเบรดบอร์ด จะมีช่อง เหลือด้านข้างท าให้สะดวกในการต่อวงจรบนเบรดบอร์ด 2.1.4 มีวงจรควบคุมแรงดัน 3.3v (@800mA max.) บนบอร์ดใช้ไอซีที่จ่ายกระแส มากกว่า บอร์ด NodeMCU v1
2.1.5 ใช้ชิป CP2102 ของ Silabs ท าหน้าที่เป็นส่วนเชื่อมต่อ USB-to-Serial (แต่ NodeMCU v1 ใช้ชิป CH340G)
2.1.6 มีขาส าหรับ SPI ส าหรับต่อกับการ์ด SD (เพิ่มจากเดิมที่มีขาส าหรับ HSPI)
2.1.7 มีขาGPIO3/RXD0และ GPIO1/TXD0 ที่ต่อกับขาTXDและRXDของชิป CP2102 ตามล าดับ
2.1.8 มีขา GPIO13/RXD2และ GPIO15/TXD2 (ใช้เป็นพอร์ต Serial เพิ่มอีกหนึ่งชุด) 2.1.9 ใช้คอนเนกเตอร์แบบ micro-USB ส าหรับจ่ายแรงดันไฟเลี้ยง (VUSB) เท่ากับ +5V และส าหรับดาวน์โหลดเฟิร์มแวร์ (แรงดัน VUSB ต่อผ่าน Schottky Diode 1N5819 ไปยัง VDD5V)
2.1.10 สามารถจ่ายแรงดันไฟเลี้ยง+5V จากภายนอกได้ (ต่อเข้าที่ขา VDD5V)
2.1.11 มีปุ่มกด RST (รีเซตการท างาน) และ Flash (ส าหรับโปรแกรมเฟิร์มแวร์ใหม่) 2.1.12 มีขา A0 รับอินพุตแรงดันแบบแอนะล็อกส าหรับวงจร ADC (ขนาด 10 บิต) ที่อยู่ ภายในชิปผ่านวงจรแบ่งแรงดันด้วยตัวต้านทาน 100k / 220k (ลดแรงดันอินพุตจาก 0..3.3V ลงมาให้ อยู่ในช่วง 0V..1V

### 2.2 ทฤษฎีเกี่ยวกับบอร์ดรีเลย์ 4 ช่องสัญญาณ (Relay 4CH)

บอร์ดรีเลย์ 4 ช่องสัญญาณ เป็นอุปกรณ์ที่ใช้ส าหรับควบคุมการท างานของอุปกรณ์ไฟฟ้า ขนาดไฟ 220 โวลต์ เพื่อใช้งานในการควบคุมอุปกรณ์ไฟฟ้า รับกระแสได้สูงถึง 12A ใช้งานได้ทั้งไฟฟ้า กระแสตรงและกระแสสลับ รับแรงดันระดับ 5 โวลต์ตรงจากบอร์ด Arduino มี LED แสดง สถานการณ์ท างานของรีเลย์ ซึ่งโครงงานนี้ได้น ามาควบคุม การหมุนของมอเตอร์ ส าหรับลักษณะ บอร์ดรีเลย์ 4 ช่องสัญญาณ แสดงดังภาพที่ 2.2

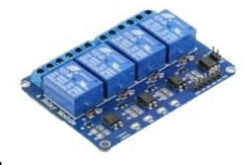
[picture p268: figure]

ภาพที่ 2.2 บอร์ดรีเลย์ 4 ช่องสัญญาณ

จากภาพที่ 2.2 แสดงลักษณะบอร์ดรีเลย์ 4 ช่องสัญญาณ รีเลย์เป็นอุปกรณ์ไฟฟ้าชนิดหนึ่ง ซึ่ง ท าหน้าที่ตัดต่อวงจรแบบเดียวกับสวิตช์ โดยควบคุมการท างานด้วยไฟฟ้ารีเลย์มีหลายประเภท ตั้งแต่ รีเลยข์นาดเล็กที่ใช้ในงานอิเล็กทรอนิกส์ทั่วไปจนถึงรีเลยข์นาดใหญ่ที่ใช้ในงานไฟฟ้าแรงสูงโดย มี ภาพร่างหน้าตาแตกต่างกันออกไป แต่มีหลักการท างานที่คล้ายคลึงกัน ส าหรับการนารีเลย์ไปใช้

งานจะ ใช้ในการตัดต่อวงจร ทั้งนี้รีเลย์ยังสามารถเลือกใช้งานได้หลากหลายภาพแบบ ส าหรับการ แสดง สัญลักษณ์ในวงจรไฟฟ้าของรีเลย์แสดงดังภาพที่ 2.3

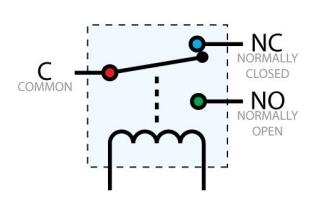
[picture p269: figure]

ภาพที่ 2.3 แสดงสัญลักษณ์ในวงจนไฟฟ้าของรีเลย์

จากภาพที่ 2.3 แสดงสัญลักษณ์ในวงจรไฟฟ้าของรีเลย์ ซึ่งภายในรีเลย์จะประกอบไปด้วย ขดลวดและหน้าสัมผัส มีรายละเอียดดังต่อไปนี้
2.2.1 หน้าสัมผัส NC(Normally Close) เป็นหน้าสัมผัสปกติปิดโดยในสภาวะปกติ หน้าสัมผัสนี้จะต่อเข้ากับขา COM (Common) และจะลอยสัมผัสกันเมื่อมีกระแสไฟฟ้าไหลผ่าน ขดลวด
2.2.2 หน้าสัมผัส NO (Normally Open) เป็นหน้าสัมผัสปกติเปิด โดยในสภาวะปกติจะ ลอยอยู่ ไม่ถูกต่อกับขา COM (Common) แต่จะเชื่อมต่อกันเมื่อมีกระแสไฟไหลผ่านขดลวด
2.2.3 ขา COM (Common) เป็นขาที่ถูกใช้งานร่วมกันระหว่าง NC และNOขึ้นอยู่กับว่า ขณะนั้น มีกระแสไฟฟ้าไหลผ่านขดลวดหรือไม่ หน้าสัมผัสใน Relay 1 ตัวอาจมีมากกว่า 1 ชุด ขึ้นอยู่ กับผู้ผลิต และลักษณะของงานที่ถูกน าไปใช้ จ านวนหน้าสัมผัสถูกแยกประเภทตามจ านวน Pole และ จ านวน Throw ซึ่งจ านวน Pole (SP-Single Pole, DP - Double Pole, 3P -Triple Pole, etc.) จะ บอกถึงจ านวน วงจรที่ท าการเปิด-ปิด หรือ จ านวนของขา COM และจ านวน Throw (ST, DT) จะ บอกถึงจ านวนของ ตัวเลือกของ Pole ตัวอย่างเช่น SPST-Single Pole Single Throw สวิตช์จะ สามารถเลือกได้เพียงอย่าง เดียวโดยจะเป็นปกติเปิด (NO-Normally Open) หรือปกติปิด (NC-Normally Close) แต่ถ้าเป็น SPDT - Single Pole Double Throw สวิตช์จะมีหนึ่งคู่เป็นปกติเปิด (NO) และอีกหนึ่งคู่เป็นปกติปิดเสมอ (NC) ลักษณะการเชื่อมต่อขาสัญญาณ Relay 4 CH กับบอร์ด Arduino แสดงดังภาพที่ 2.4

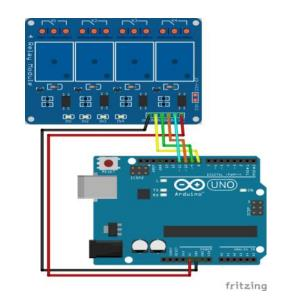
[picture p270: figure]

ภาพที่ 2.4 การเชื่อมต่อขาสัญญาณ Relay 4 Channel กับบอร์ด Arduino

จากภาพที่ 2.4 การเชื่อมต่อขาสัญญาณ Relay 4 Channel กับบอร์ด Arduino โดยมีการ เชื่อมต่อดังนี้คือ
1) น าขาสัญญาณ VCC จาก Relay 4 Channel ต่อเข้ากับไฟ 5V ของบอร์ด Arduino
2) น าขาสัญญาณ GNG จาก Relay 4 Channel ต่อเข้ากับขา GNG ของบอร์ด Arduino
3) น าขาสัญญาณ IN1 IN2 IN3 IN4 จาก Relay 4 Channel ต่อเข้ากับขา PIN 8PIN 9PIN 10 PIN 11 ของบอร์ด Arduino

### 2.3 ทฤษฎีเกี่ยวข้องกับการท างานของ Tact Switch

การท างานของ Tact Switch จะแยกเป็น 2 ส่วน คือตอนที่ยังไม่กด (Not Pressed) และ ตอนที่กด(Pressed) ซึ่งเมื่อเราลองจัดวางปุ่มนี้ ดังภาพ โดยให้ด้านหน้าและหลังของปุ่ม ไม่มีขา ส่วน ด้านซ้ายเป็นขา 1 กับ 3 และด้านขวาเป็นขา 2 กับ 4 ดังภาพที่ 2.5

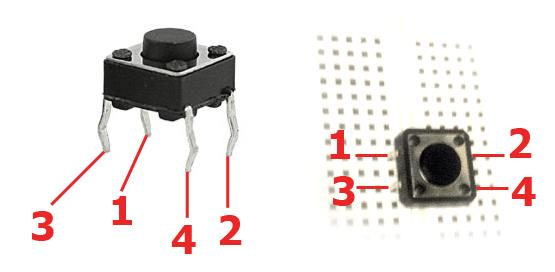
[picture p271: figure]

ภาพที่ 2.5 การจัดวางปุ่มของ Tact Switch

เมื่อวงจรเปิด (Not Pressed) : ขาที่ 1 จะเชื่อมอยู่กับขาที่ 2/ขาที่ 3 จะเชื่อมอยู่กับขาที่ 4 เมื่อวงจรปิด (Pressed) : ขาที่ 1 จะเชื่อมอยู่กับขาที่ 3/ขาที่ 2 จะเชื่อมอยู่กับขาที่ 4 หรือพูดง่าย ๆ คือ เมื่อยังไม่ได้กดปุ่มขาที่ 1 จะเชื่อมอยู่กับขาที่ 2 และขาที่ 3 จะเชื่อมอยู่กับขาที่ 4 แต่เมื่อเรากดปุ่ม

แล้ว จะเกิดการสลับคู่ของขาเพื่อเปลี่ยนแปลงเส้นทางการจ่ายกระแสไฟฟ้าในวงจรนั่นเอง ซึ่ง สามารถใช้หลักการนี้มาควบคุมการเปิดและปิดของวงจรอิเล็กทรอนิกส์ได้ง่าย ๆ
การใช้งานของ Tact Switch (การต่อวงจร) จากหลักการท างานของมัน จะสังเกตได้ว่าการ สลับคู่ของขานั้น ท าให้เกิดการเปลี่ยนแปลงของทิศทางการไหลของกระแสไฟฟ้า ซึ่งจะมีลักษณะดัง ภาพที่ 2.6

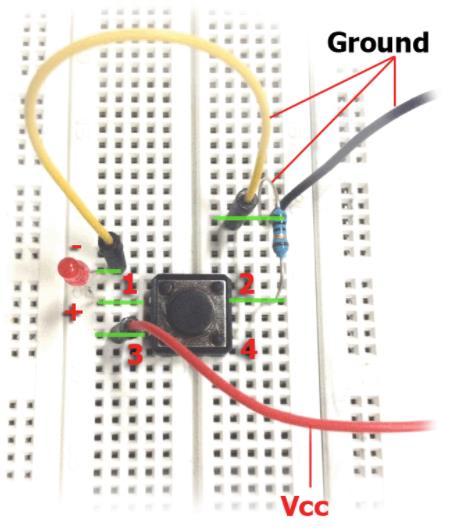
[picture p272: figure]

ภาพที่ 2.6 การต่อวงจรของ Tact Switch

จากภาพที่ 2.6 เมื่อวงจรเปิด ขา 1 ของปุ่มจะเชื่อมเข้ากับขา 2 เป็นเหตุท าให้ขา + ของ LED เชื่อมต่อกับ Ground จึงท าให้ไฟดับ และเมื่อวงจรปิด ขา 1 ของปุ่ม จะเชื่อมเข้ากับขา 3 เป็นเหตุท า ให้ขา + ของ LED เชื่อมต่อกับแหล่งจ่าย 3 Volts ท าให้ไฟติด

### 2.4 ทฤษฎีเกี่ยวกับ Blynk

Blynk Platform ถูกออกแบบมาเพื่อใช้ในการควบคุมอุปกรณ์ Internet of Things ซึ่งมี คุณสมบัติในการควบคุมระยะไกลผ่านเครือข่ายอินเตอร์เน็ต และยังสามารถแสดงผลค่าจาก เวลาต่าง ๆ ได้อีกด้วยแสดงได้ดังภาพที่ 2.7

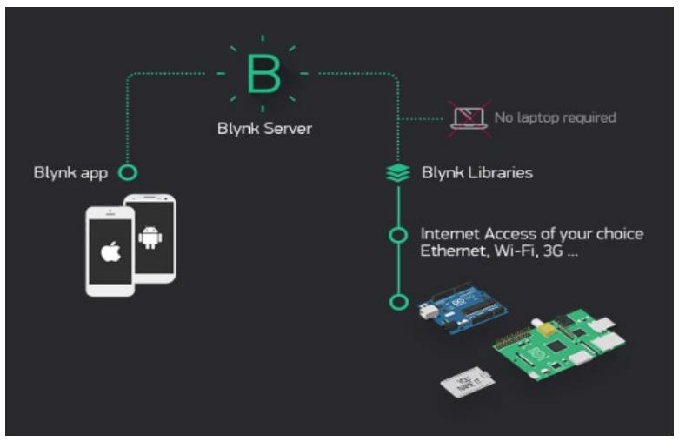
[picture p273: figure]

ภาพที่ 2.7 โปรแกรม Blynk
จากภาพที่ 2.7 แสดงการใช้Blynk App – แอปพลิเคชันที่สามารถติดตั้งในมือถือของเราเอง เพื่อสร้าง Interface ในการควบคุมหรือแสดงผลค่าจากอุปกรณ์Internet of ThingsBlynk Server

ท าหน้าที่เป็นตัวกลางในการติดต่อสื่อสารระหว่างแอปพลิเคชันกับอุปกรณ์ Internet of Things ใน ส่วนนี้จะเปิดให้ใช้บริการฟรี Blynk Libraries ออกแบบมาส าหรับอุปกรณ์ Internet of Things ต่าง ๆ ให้สามารถสื่อสารกันได้อย่างมีประสิทธิภาพ แสดงได้ดังภาพที่ 2.8

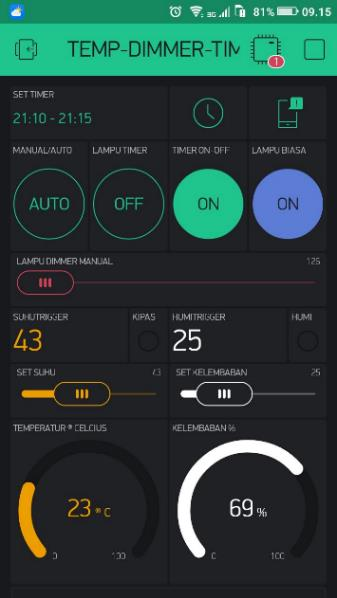
[picture p274: figure]

ภาพที่ 2.8 การออกแบบโปรแกรม โดยผู้ใช้งานก าหนดเอง

จากภาพที่ 2.8 แสดงให้เห็นถึงการออกแบบหน้าใช้งานของโปรแกรม Blynk Server เป็น Digital Dashboard Platform ส าหรับ Arduino, NodeMCU และ Raspberry Pi โดยผู้ใช้งาน สามารถสร้าง Graphic interface ขึ้นมาใน Application (รองรับทั้ง iOS และ Android) เพื่อท าการ ควบคุมจัดการ อุปกรณ์ IoT ได้อย่างง่ายได้ ส าหรับท่านที่ต้องการใช้งาน Blynk นั้นทางเราได้ท าการ สร้างระบบ Blynk Server ขึ้นมาเพื่อให้สามารถใช้งานได้แบบฟรีๆ กันเลย

### 2.5 ทฤษฎีเกี่ยวกับแอปพลิเคชัน Line

โปรแกรม Application Line ที่มีความสามารถในการสนทนา เช่น การแชท การส่งข้อความ การแชร์ไฟล์การสร้างกลุ่มพูดคุย หรือการสนทนาผานเสียง ผ่านเครือข่ายอินเตอร์เน็ต บนอุปกรณ์ ประเภทพกพา (Mobile Devices) เช่น สมาร์ทโฟน แท็บเล็ต เป็นต้น นอกจากนี้Line ยังสามารถ ติดตั้งและใช้งานบนเครื่องคอมพิวเตอร์ทั่วไปได้ด้วย แสดงได้ดังภาพที่ 2.9

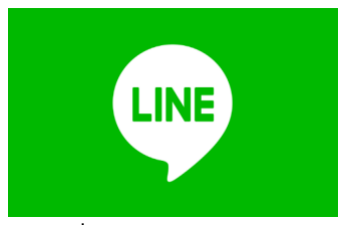
[picture p275: figure]

ภาพที่ 2.9 Application Line

จากภาพที่ 2.9 แสดงการใช้งาน Application Line การสื่อสารการแจ้งเตือนให้ผู้ใช้งาน ทราบถึงสถานะการท างานของระบบ โดยแจ้งเตือนเมื่ออุปกรณ์เกิดปัญหา มีการขัดข้องของอุปกรณ์ โดยแจ้งให้ผู้ดูแลทราบสถานะของระบบ

## บทที่ 3 วิธีด าเนินการทดลอง

โครงงานวิทยาศาสตร์ เรื่องระบบควบคุมอุปกรณ์ไฟฟ้าระยะไกล มีวัตถุประสงค์เพื่อสร้าง ระบบอัตโนมัติแบบออนไลน์ส าหรับควบคุมเครื่องใช้ไฟฟ้า เพื่อศึกษาการท างานของระบบอัตโนมัติ แบบออนไลน์ส าหรับควบคุมเครื่องใช้ไฟฟ้า และเพื่อศึกษาการรับ-ส่งข้อมูลผ่านแอปพลิเคชัน Blynk และแอบพลิเคชัน Line ซึ่งผู้จัดท าได้ด าเนินการ ดังนี้

### 3.1 วัสดุอุปกรณ์

3.1.1 กล่องพลาสติก ขนาด 123mm x 206mm จ านวน 1 กล่อง
3.1.2 Hi-Link 5V 3W จ านวน 1 ตัว (ตัวแปลงไฟ 220vac เป็น 5vDc) 3.1.3 บอร์ด Node MCU ESP8266 v2 จ านวน 1 ตัว
3.1.4 โมดูลรีเลย์ขนาด 4 ช่องสัญญาณ 5v จ านวน 1 โมดูล
3.1.5 สวิตช์ กดติดปล่อยดับ ขนาด 12x12x14 mm จ านวน 8 ตัว 3.1.6 ตัวตานทานขนาด 4.7 KW จ านวน 8 ตัว
3.1.7 โมดูลจอแสดงผลแบบ LCD 20 x 4 I2c จ านวน 1 ตัว 3.1.8 สายจั๊มแบบ ผู้ ผู้ จ านวน 20 เส้น
3.1.9 สายจั๊มแบบ ผู้ เมีย จ านวน 20 เส้น
3.1.10 แผ่นปริ้นอเนกประสงค์ จ านวน 4 แผ่น
3.1.11 ตะกั่วบัดกรี จ านวน 1 หลอด
3.1.12 น้ ายาประสาน จ านวน 1 ตลับ
3.1.13 หัวแร้งบัดกรี จ านวน 1 ตัว
3.1.14 ปลั๊กไฟกราวด์คู่ พร้อมหน้ากาก จ านวน 2 ชุด
3.1.15 ตะปูเกรียวตัวเล็ก จ านวน 20 ตัว
3.1.16 สายไฟแบบ VSF ขนาด 2 มิลลิเมตรสีด า จ านวน 3 เมตร 3.1.17 สายไฟแบบ VSF ขนาด 2 มิลลิเมตรสีแดง จ านวน 3 เมตร 3.1.18 สายไฟแบบ VSF ขนาด 1.5 มิลลิเมตรสีเขียว จ านวน 3 เมตร 3.1.19 เทอร์มินอลขนาด 12 ช่อง จ านวน 1 ตัว

### 3.2 ขั้นตอนการด าเนินงาน

3.2.1 ต่อวงจรสวิตช์ โดยน าสวิตช์เชื่อมต่อกับค่าความต้านทาน
3.2.2 ต่อชุดสวิตช์และโมดูลรีเลย์เข้ากับ Node MCU
3.2.3 เขียนโปรแกรมรับค่าสวิตช์และสั่งงานเปิดปิดรีเลย์
3.2.4 สร้างแอปพลิเคชัน Blynk ให้มีปุ่มควบคุมจ านวน 4 ปุ่ม และมีการแสดงผล สถานะของช่องสัญญาณไฟฟ้า 4 ช่อง
3.2.5 เขียนโปรแกรมเชื่อมต่อแอปพลิเคชัน Blynk เข้ากับบอร์ด Node MCU 3.2.6 ทดสอบสั่งงานเปิดปิดอุปกรณ์จากแอปพลิเคชัน Blynk
3.2.7 เขียนโปรแกรมให้ระบบเปิดปิดอุปกรณ์ได้ตามเวลาที่ก าหนด
3.2.8 ทดสอบให้ระบบเปิดปิดอุปกรณ์ตามเวลาที่ตั้งค่าไว้
3.2.9 เขียนโปรแกรมเชื่อมต่อแอปพลิเคชัน Line เข้ากับบอร์ด Node MCU 3.2.10 ทดสอบให้บอร์ดแจ้งเตือนไลน์เมื่อมีการเปิดปิดอุปกรณ์
3.2.11 ทดสอบการท างานโดยภาพรวมของระบบ

## บทที่ 4 ผลการทดลอง

จากการด าเนินการทดลอง ควบคุมอุปกรณ์ไฟฟ้าระยะไกล โดยมีวัตถุประสงค์เพื่อสร้างระบบ อัตโนมัติแบบออนไลน์ส าหรับควบคุมเครื่องใช้ไฟฟ้า เพื่อศึกษาการท างานของระบบอัตโนมัติแบบ ออนไลน์ส าหรับควบคุมเครื่องใช้ไฟฟ้า และเพื่อศึกษาการรับ-ส่งข้อมูลผ่านแอปพลิเคชัน Blynk และ แอบพลิเคชัน Line นั้น ผู้จัดท าได้ผลการทดลองที่สอดคล้องกับสมมติฐาน วัตถุประสงค์และวิธีการ ด าเนินงาน
ผลการสร้างระบบอัตโนมัติแบบออนไลน์ส าหรับควบคุมเครื่องใช้ไฟฟ้าแบบออนไลน์ ผู้จัดท า ได้ด าเนินการจัดสร้างและพัฒนาขึ้น ดังภาพที่ 4.1

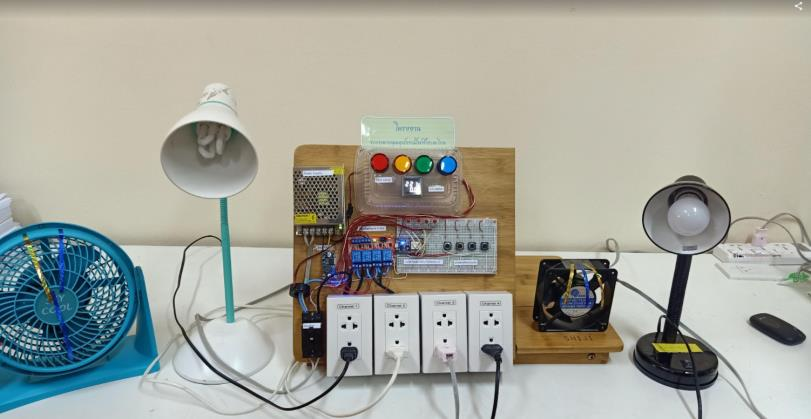
[picture p276: figure]

ภาพที่ 4.1 ผลการสร้างระบบอัตโนมัติแบบออนไลน์ส าหรับควบคุมอุปกรณ์ไฟฟ้าระยะไกล

ผลการศึกษาการท างานของระบบอัตโนมัติแบบออนไลน์ ส่งข้อมูลผ่านแอปพลิเคชัน Blynk แสดงดังภาพที่ 4.2

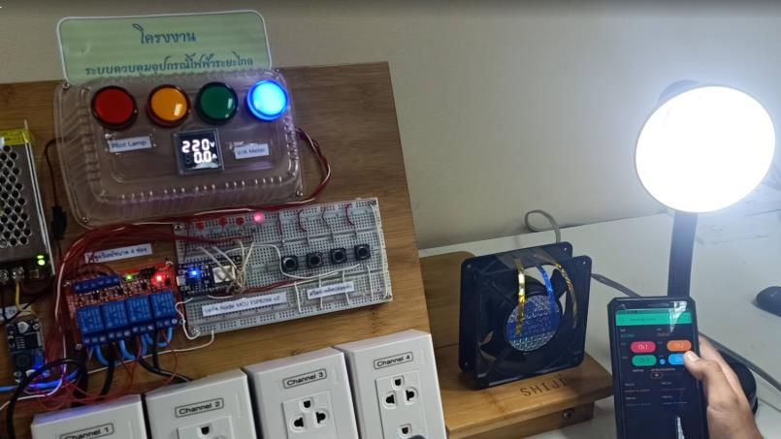
[picture p277: figure]

ภาพที่ 4.2 การท างานของระบบอัตโนมัติแบบออนไลน์ ส่งข้อมูลผ่านแอปพลิเคชัน Blynk

ผลการทดลองการควบคุมการท างานของระบบอัตโนมัติแบบออนไลน์ ส าหรับควบคุม เครื่องใช้ไฟฟ้าระยะไกล ซึ่งจากการทดลองควบคุม แสดงได้ผลตามตารางบันทึกผลต่อไปนี้

ตารางที่ 4.1 แสดงผลการทดลองการควบคุมอุปกรณ์ไฟฟ้า ผ่านแอปพลิเคชัน Blynk โดย ควบคุมครั้งละ 1 Channel

ครั้งที่ | Channel | สรุปผลการทดลอง
1 | 2 | 3 | 4
1 | | | | ✓ | ควบคุมได้
2 | ✓ | | | | ควบคุมได้
3 | | ✓ | | | ควบคุมได้
4 | | | ✓ | | ควบคุมได้
5 | ✓ | | | | ควบคุมได้
6 | | | ✓ | | ควบคุมได้
7 | | | | ✓ | ควบคุมได้
8 | | ✓ | | | ควบคุมได้
9 | ✓ | | | | ควบคุมได้
10 | | | ✓ | | ควบคุมได้

จากตารางที่ 4.1 พบว่า ผลการทดลองการควบคุมอุปกรณ์ไฟฟ้า ผ่านแอปพลิเคชัน Blynk โดย ควบคุมครั้งละ 1 Channel จ านวน 10 ครั้ง สามารถควบคุมได้10 ครั้ง และควบคุมไม่ได้ 0 ครั้ง

ตารางที่ 4.2 แสดงผลการทดลองการควบคุมอุปกรณ์ไฟฟ้า ผ่านแอปพลิเคชัน Blynk โดย ควบคุมครั้งละ 2 Channel

ครั้งที่ | Channel | สรุปผลการทดลอง
1 | 2 | 3 | 4
1 | | ✓ | | ✓ | ควบคุมได้
2 | ✓ | | | ✓

ครั้งที่ | Channel | สรุปผลการทดลอง
1 | 2 | 3 | 4
2 | ✓ | | | ✓ | ควบคุมได้
3 | ✓ | ✓ | | | ควบคุมได้
4 | | | ✓ | ✓ | ควบคุมได้
5 | ✓ | | ✓ | | ควบคุมได้
6 | | ✓ | ✓ | | ควบคุมได้
7 | ✓ | | | ✓ | ควบคุมได้
8 | | ✓ | | | ควบคุมได้
9 | ✓ | ✓ | | | ควบคุมได้
10 | | | ✓ | ✓ | ควบคุมได้

จากตารางที่ 4.2 พบว่า ผลการทดลองการควบคุมอุปกรณ์ไฟฟ้า ผ่านแอปพลิเคชัน Blynk โดยควบคุมครั้งละ 2 Channel จ านวน 10 ครั้ง สามารถควบคุมได้10 ครั้ง และควบคุมไม่ได้ 0 ครั้ง
สรุปผลการทดลอง จ านวน 20 ครั้ง พบว่า ระบบควบคุมอุปกรณ์ไฟฟ้าระยะไกล เป็นระบบ อัตโนมัติแบบออนไลน์ที่สามารถควบคุมเครื่องใช้ไฟฟ้า โดยรับ-ส่งข้อมูลผ่านแอปพลิเคชัน Blynk และแอบพลิเคชัน Line สามารถควบคุมได้ ร้อยละ 100 เป็นไปตามสมมุตฐานที่ตั้งไว้

นอกจากนี้ ผู้จัดท าได้ทดลองการควบคุมอุปกรณ์ไฟฟ้าจากสวิสต์ที่บอร์ดควบคุมอุปกรณ์ ไฟฟ้า และแบบผสมผสาน โดยผ่านแอปพลิเคชัน Blynk และจากสวิสต์ที่บอร์ดควบคุม แสดงผล ดังตาราง 4.3 และตารางที่ 4.4

ตารางที่ 4.3 แสดงผลการทดลองการควบคุมอุปกรณ์ไฟฟ้า จากสวิสต์ที่บอร์ดควบคุม

ครั้งที่ | Channel | สรุปผลการทดลอง
1 | 2 | 3 | 4
1 | | | | ✓ | ควบคุมได้
2 | ✓ | | | | ควบคุมได้
3 | | ✓ | | | ควบคุมได้

ครั้งที่ | Channel | สรุปผลการทดลอง
1 | 2 | 3 | 4
4 | | | ✓ | | ควบคุมได้
5 | ✓ | | | | ควบคุมได้
6 | | | ✓ | | ควบคุมได้
7 | | | | ✓ | ควบคุมได้
8 | | ✓ | | | ควบคุมได้
9 | ✓ | | | | ควบคุมได้
10 | | | ✓ | | ควบคุมได้

จากตารางที่ 4.3 พบว่า ผลการทดลองการควบคุมอุปกรณ์ไฟฟ้า จากสวิสต์ที่บอร์ดควบคุม สามารถควบคุมได้10 ครั้ง และควบคุมไม่ได้ 0 ครั้ง

ตารางที่ 4.4 แสดงผลการทดลองการควบคุมอุปกรณ์ไฟฟ้า แบบผสมผสาน โดยผ่านแอปพลิเคชัน Blynk และจากสวิสต์ที่บอร์ดควบคุม

ครั้งที่ | เปิดจาก Blynk | เปิดจากสวิตซ์ ที่บอร์ด ควบคุม | ปิดจาก Blynk | ปิดจากสวิตซ์ที่ บอร์ดควบคุม | สรุปผลการ ทดลอง
1 | Channel 1 | | | Channel 1 | ควบคุมได้
2 | | Channel 2 | Channel 2 | | ควบคุมได้
3 | Channel 3 | | | Channel 3 | ควบคุมได้
4 | | Channel 4 | Channel 4 | | ควบคุมได้
5 | Channel 1 | | | Channel 1 | ควบคุมได้
6 | | Channel 2 | Channel 2 | | ควบคุมได้
7 | Channel 3 | | | Channel 3 | ควบคุมได้
8 | | Channel 4 | Channel 4 | | ควบคุมได้

ครั้งที่ | Channel | สรุปผลการ ทดลอง
1 | 2 | 3 | 4
9 | Channel 2 | | | Channel 2 | ควบคุมได้
10 | | Channel 3 | Channel 3 | | ควบคุมได้

จากตารางที่ 4.4 พบว่า ผลการทดลองการควบคุมอุปกรณ์ไฟฟ้า แบบผสมผสาน โดยผ่านแอปพลิเคชัน Blynk และจากสวิสต์ที่บอร์ดควบคุม สามารถควบคุมได้10 ครั้ง และควบคุม ไม่ได้ 0 ครั้ง

## บทที่ 5 สรุป อภิปรายผล และข้อเสนอแนะ

จากการศึกษาและจัดท าโครงงานเรื่องระบบควบคุมอุปกรณ์ไฟฟ้าระยะไกล | ในครั้งนี้เพื่อ
สร้างระบบอัตโนมัติแบบออนไลน์ส าหรับควบคุมเครื่องใช้ไฟฟ้าในระยะไกล | ซึ่งสามารถสรุปผล
อภิปรายผล และข้อเสนอแนะได้ดังนี้

5.1สรุปผล
จากการสร้างระบบอัตโนมัติแบบออนไลน์ส าหรับควบคุมเครื่องใช้ไฟฟ้า มีการรับ-ส่งข้อมูล ผ่านแอปพลิเคชัน Blynk และแอบพลิเคชัน Line และมีการเชื่อมต่อกับโมดูลสวิตย์รีเลย์ 4 ช่อง ซึ่ง จากการทดลองการท างานของระบบอัตโนมัติโดยการควบคุมระยะไกล จ านวน 20 ครั้ง พบว่า ร้อยละ 100 สามารถควบคุมอุปกรณ์ไฟฟ้าผ่านระบบอัตโนมัติได้อย่างแม่นย าและมีประสิทธิภาพ นอกจากนี้ผู้จัดท าได้พัฒนาให้ระบบสามารถควบคุมผ่านสวิสต์ที่บอร์ดควบคุม และแบบผสมผสาน ซึ่ง จากการทดลองดังกล่าวสามารถควบคุมการการท างานของเครื่องใช้ไฟฟ้าได้อย่างแม่นย าทุกครั้ง

### 5.2 อภิปรายผล

การจัดท าโครงงานเรื่องระบบอัตโนมัติควบคุมเครื่องใช้ไฟฟ้าระยะไกล โดยสามารถอภิปราย ผลได้ดังนี้
การสร้างระบบอัตโนมัติแบบออนไลน์ส าหรับควบคุมเครื่องใช้ไฟฟ้า ผ่านแอปพลิเคชัน Blynk และแอบพลิเคชัน Line และมีการเชื่อมต่อกับโมดูลสวิตย์รีเลย์ 4 ช่อง ท าให้ระบบมีการท างาน แบบออนไลน์สามารถควบคุมเครื่องใช้ไฟฟ้าระยะไกลได้ ซึ่งจากผลการทดลองในการควบคุมอุปกรณ์ ไฟฟ้าทุกครั้งระบบมีความแม่นย าถูกต้องและสามารถใช้ได้จริงสอดคล้องกับวิทยานิพนธ์ของนาย จักรวาล ชลสงครามและคณะ ที่จัดท าวิจัยเรื่องระบบควบคุมอุปกรณ์ไฟฟ้าและรักษาความปลอดภัย ในบ้านแบบออนไลน์ และสอดคล้องกับข้อมูลที่ผู้จัดท าโครงการได้ศึกษาเพิ่มเติมจาก ข้อมูลการพัฒนา แอพพลิเคชั่นส าหรับโทรศัพท์มือถือระบบปฏิบัติการแอนดรอยด์ เพื่อการควบคุมเครื่องใช้ไฟฟ้า ภายในบ้านจากระยะไกล ของพาขวัญ พัดเย็นใจ
สรุปได้ว่า การจัดท าโครงงานระบบอัตโนมัติควบคุมเครื่องใช้ไฟฟ้าระยะไกล สามารถ แก้ปัญหาการควบคุมอุปกรณ์ไฟฟ้าได้หลายๆ อย่างในเวลาเดียวกันได้ และหากต้องอยู่นอกสถานที่ สามารถสั่งการท างานของอุปกรณ์ในระยะไกลได้ ช่วยลดปัญหาการลืมเปิด – ปิดอุปกรณ์ไฟฟ้าเมื่อ ออกจากบ้าน ช่วยอ านวยความสะดวกในการควบคุมเครื่องใช้ไฟฟ้าในบ้าน ตลอดถึงมีความปลอดภัย ในการด ารงชีวิตประจ าวัน และเป็นการน าเทคโนโลยีคอมพิวเตอร์ และเทคโนโลยีในการสื่อสาร ที่มี ศักยภาพสูงสามารถน ามาใช้เพื่อให้เกิดประโยชน์ในชีวิตประจ าวันได้อย่างมีประสิทธิภาพ

### 5.3 ข้อเสนอแนะ

5.3.1 พัฒนาระบบให้สามารถเปิด-ปิด หรือท างานตามเวลาที่ก าหนดได้
5.3.2 ปรับปรุงรูปลักษณ์ของระบบควบคุมอุปกรณ์ไฟฟ้าระยะไกล ให้มีความแข็งแรงทนทาน ต่อการน าไปใช้งานจริง

## เอกสารอ้างอิง

จักรวาล ชลสงครามและคณะ, ระบบควบคุมอุปกรณ์ไฟฟ้าและรักษาความปลอดภัยในบ้าน แบบออนไลน์ (วิทยานิพนธ์ปริญญาตรีบัณฑิต คณะวิทยาศาสตร์ มหาวิทยาลัยเทคโนโลยีราชมงคลศรี วิชัย วิทยาเขตนครศรีธรรมราช 2562), หน้า 6.
พาขวัญ พัดเย็นใจ. (2561). การพัฒนาแอพพลิเคชั่นส าหรับโทรศัพท์มือถือระบบปฏิบัติการ แอนดรอยด์ เพื่อการควบคุมเครื่องใช้ไฟฟ้าภายในบ้านจากระยะไกล. [ออนไลน์].
เข้าถึงได้จาก https://ph02.tci-thaijo.org/index.php/project-journal/article/view/152790 สัญญา ผาสุก. (2549). การควบคุมอุปกรณ์ไฟฟ้าระยะไกลด้วยข้อความจาก โทรศัพท์เคลื่อนที่. [ออนไลน์]. เข้าถึงได้จาก https://www.repository.rmutsv.ac.th/handle/123456789/730
โสภณ มหาเจริญ. (2558). การเพิ่มประสิทธิภาพระบบควบคุมอุปกรณ์ไฟฟ้าระยะไกลผ่าน อุปกรณ์สมาร์ทโฟน. [ออนไลน์]. เข้าถึงได้จาก https://publication.npru.ac.th/jspui/handle/123456789/513

## ภาคผนวก

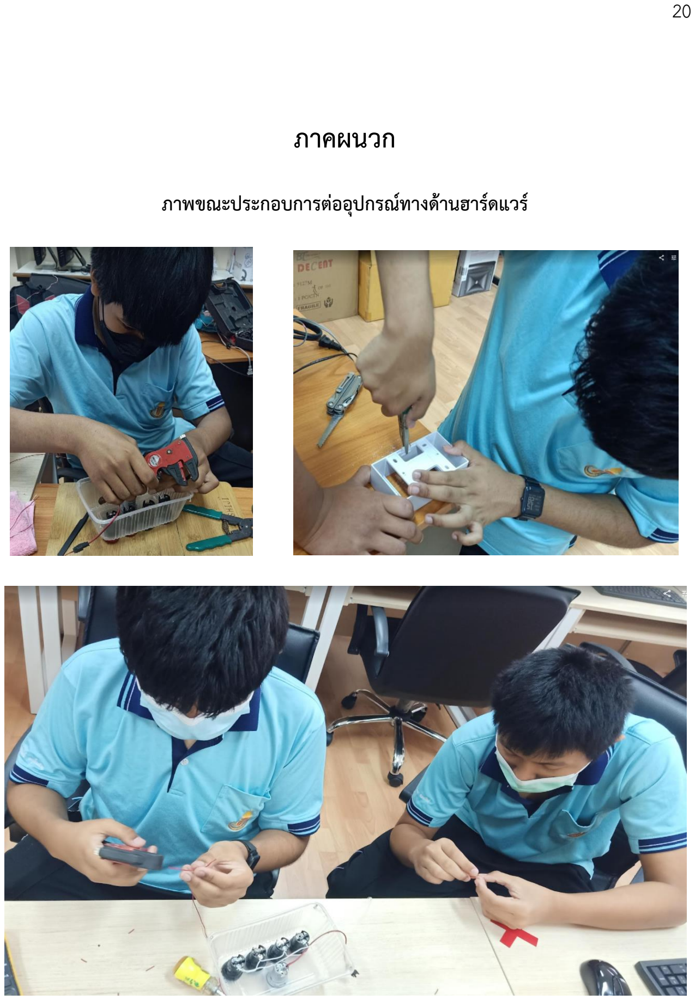
[picture p278: page 27]

ภาพขณะประกอบการต่ออุปกรณ์ทางด้านฮาร์ดแวร์

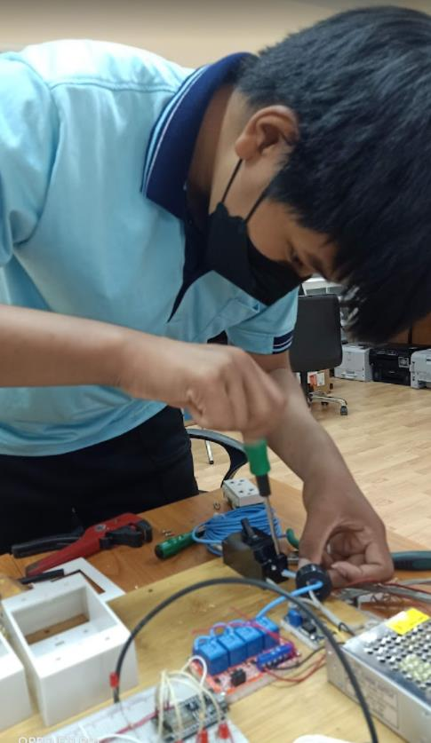
[picture p279: figure]
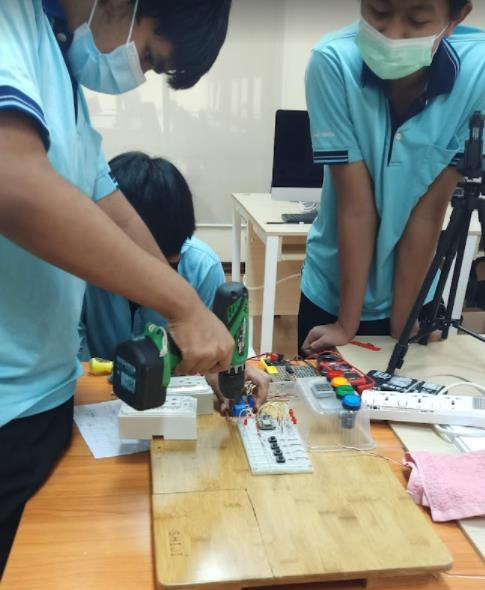
[picture p280: figure]
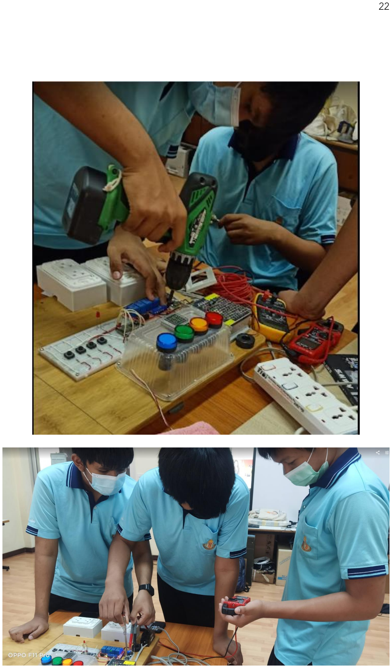
[picture p281: page 29]

## ภาคผนวก

ภาพขณะประกอบการควบคุมระบบ

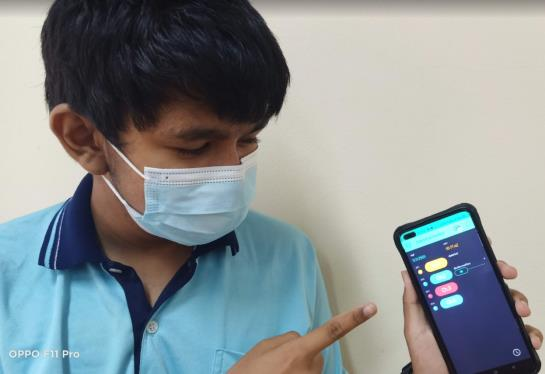
[picture p282: figure]
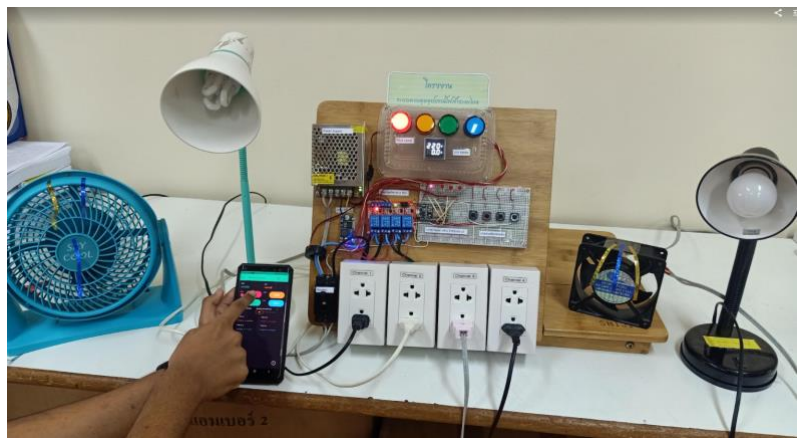
[picture p283: figure]

Channel 1

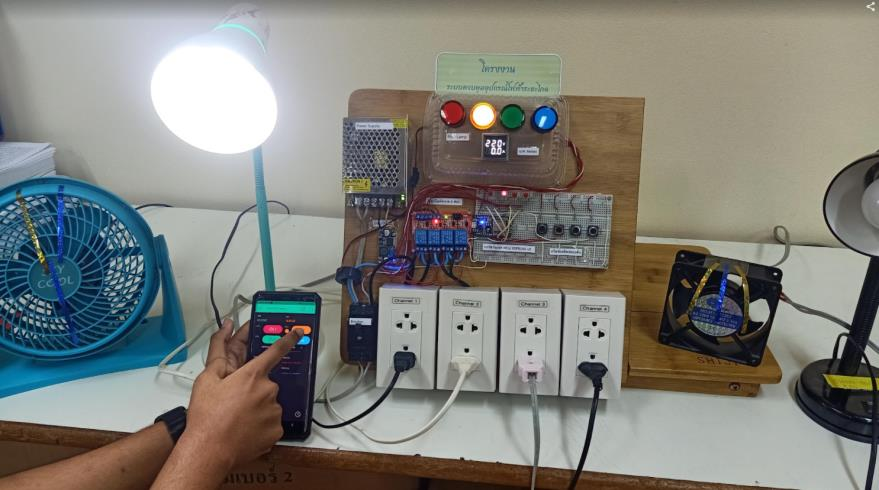
[picture p284: figure]

Channel 2

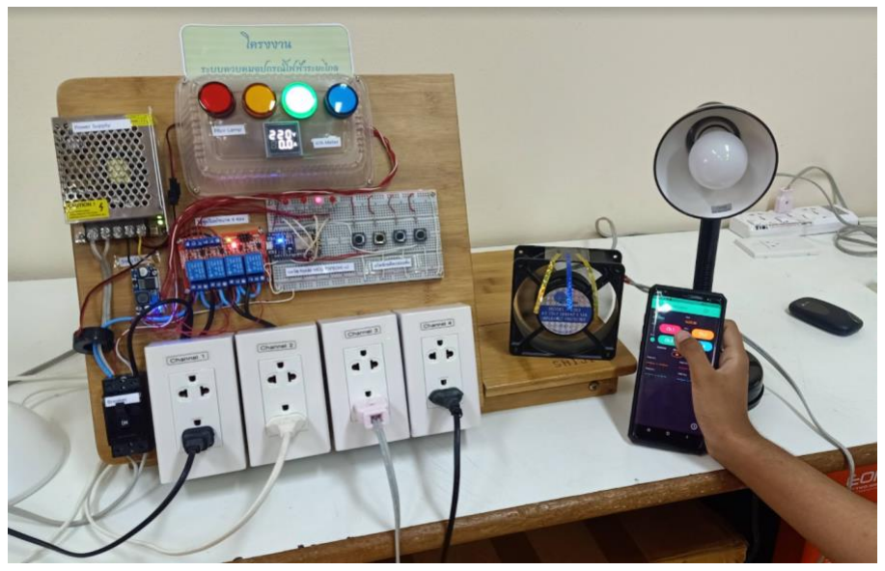
[picture p285: figure]

Channel 3

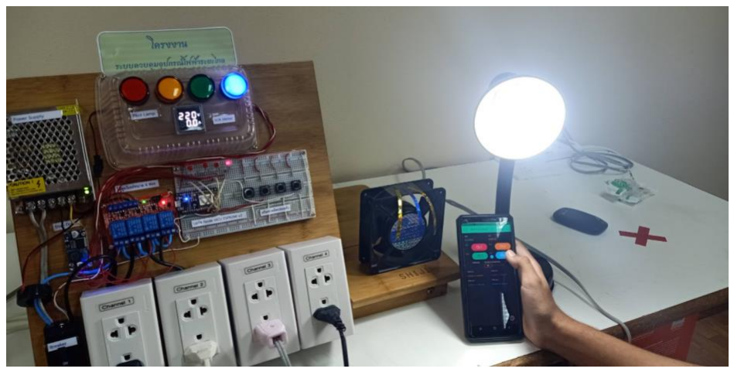
[picture p286: figure]

Channel 4

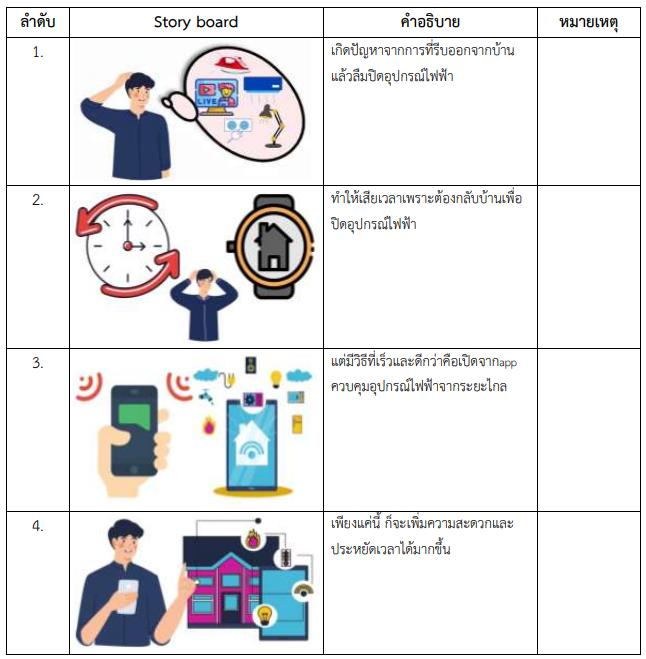
[picture p287: figure]
