PipeNitch/Project_WPNS-IoT/Documents/เอกสารความเป็นเจ้าของและอื่นๆ/img20240830_08542125.pdf

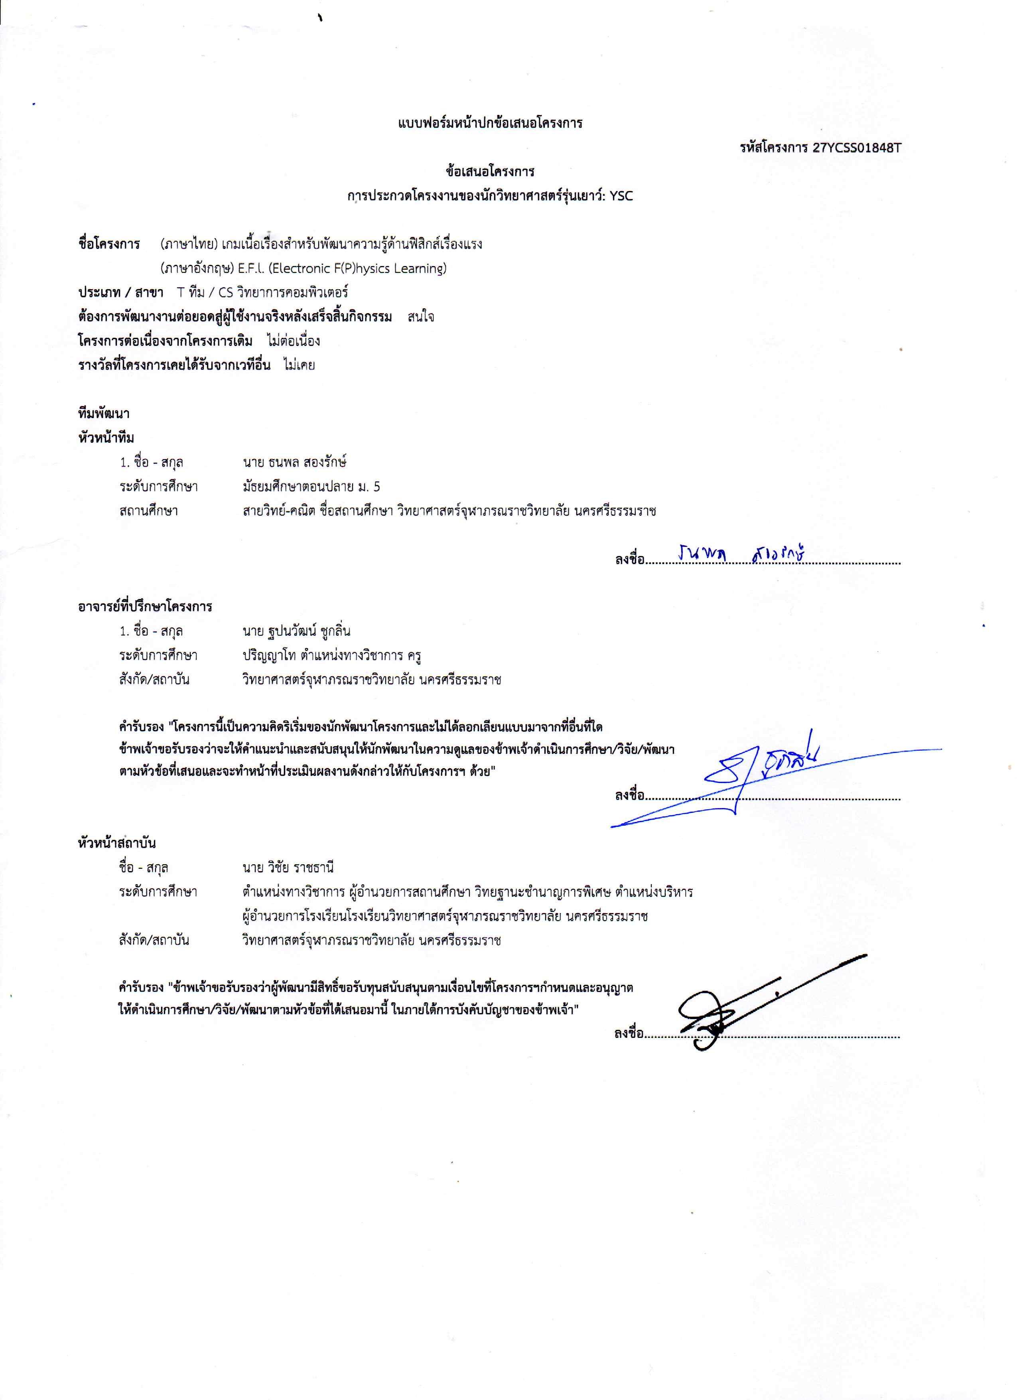
[picture p288: page 1]
