PipeNitch/Project_WPNS-IoT/Documents/เอกสารความเป็นเจ้าของและอื่นๆ/PumpIoT.pdf

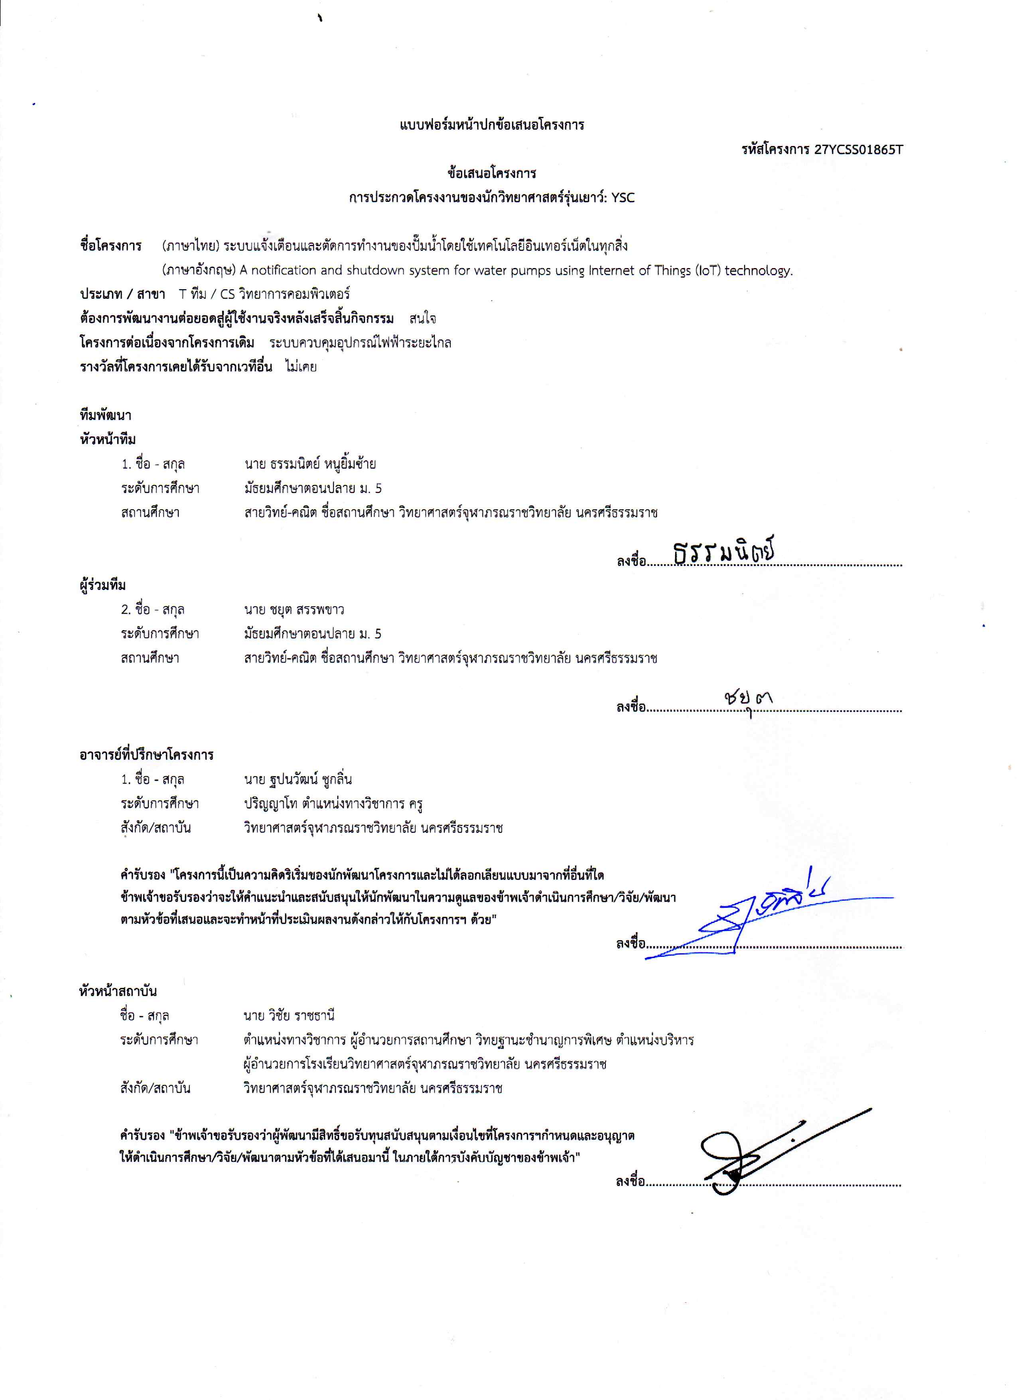
[picture p289: page 1]
