PipeNitch/Project_WPNS-IoT/Documents/Flowchart PumpIoT 1 page.png

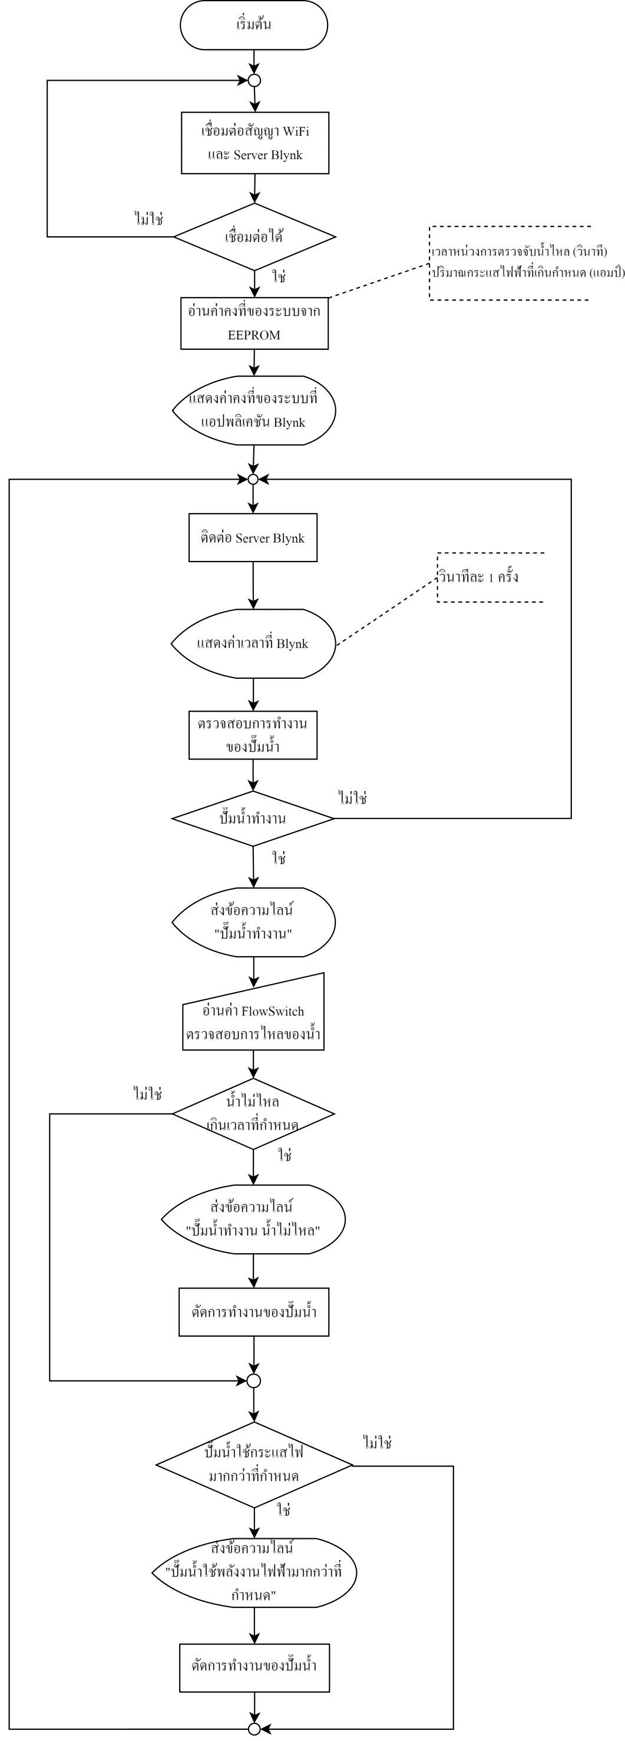
Documents/Flowchart PumpIoT 1 page.png
