PipeNitch/Project_WPNS-IoT/Documents/Flowchart PumpIoT 2 pages-1.png

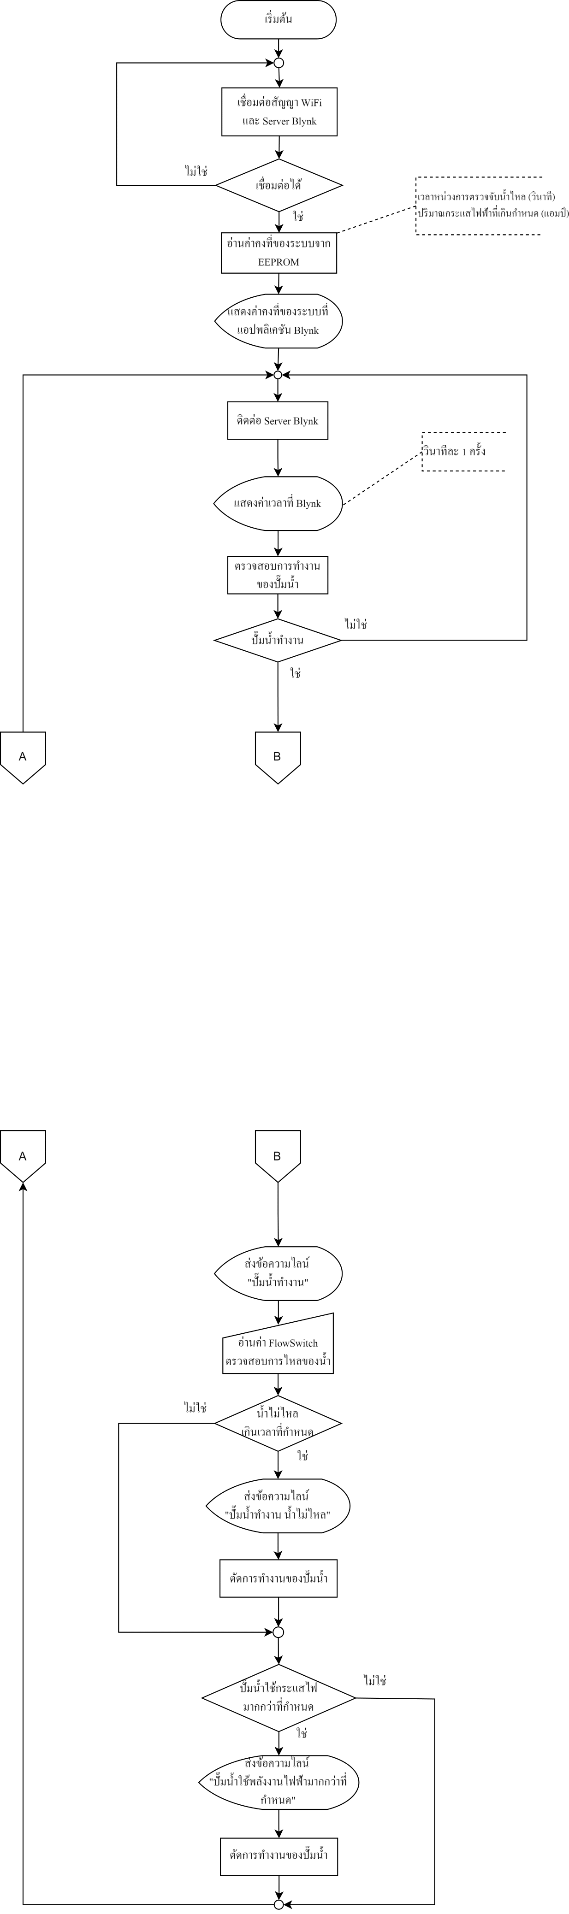
Documents/Flowchart PumpIoT 2 pages-1.png
