PipeNitch/Project_WPNS-IoT/Documents/PumpIoT/Screenshot 2024-05-22 231715.png

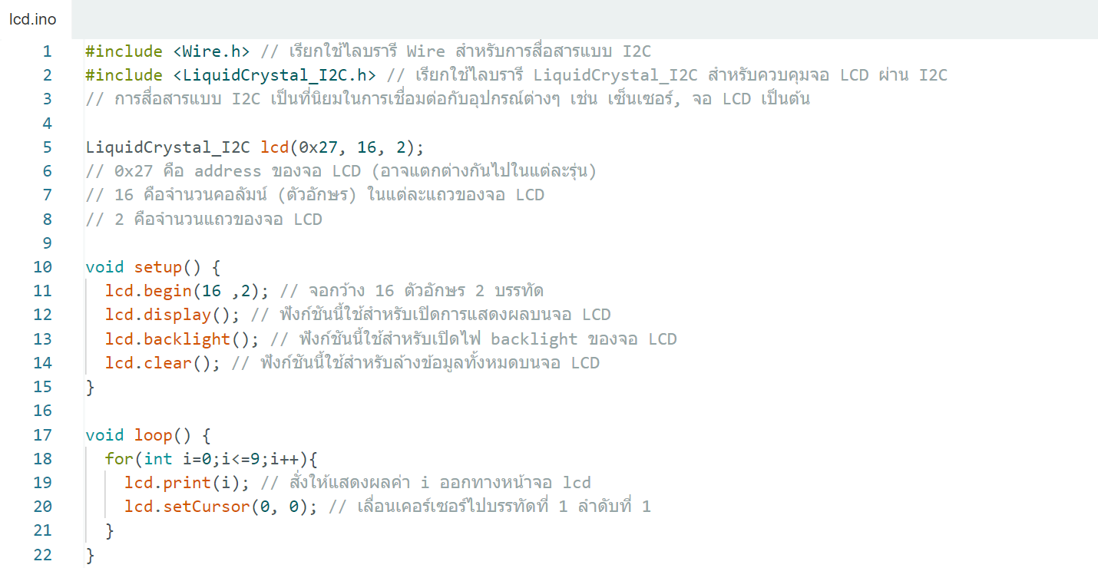
Documents/PumpIoT/Screenshot 2024-05-22 231715.png
