PipeNitch/Project_WPNS-IoT/Pictures/IMG20240515163019.jpg

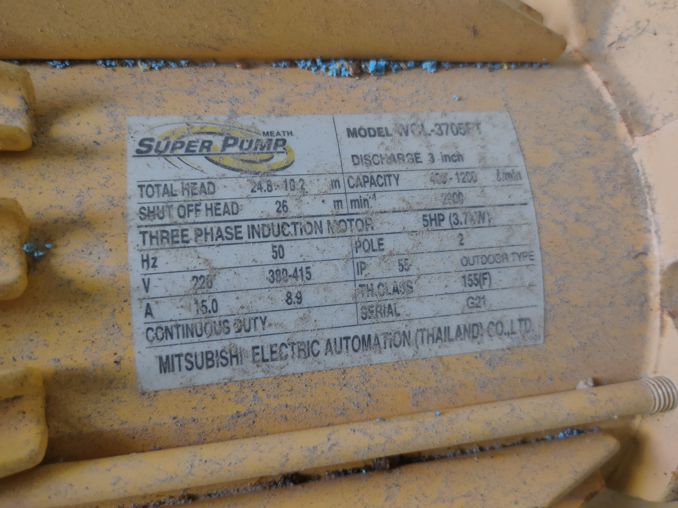
Pictures/IMG20240515163019.jpg
