PipeNitch/Project_WPNS-IoT/Pictures/IMG20240515163022.jpg

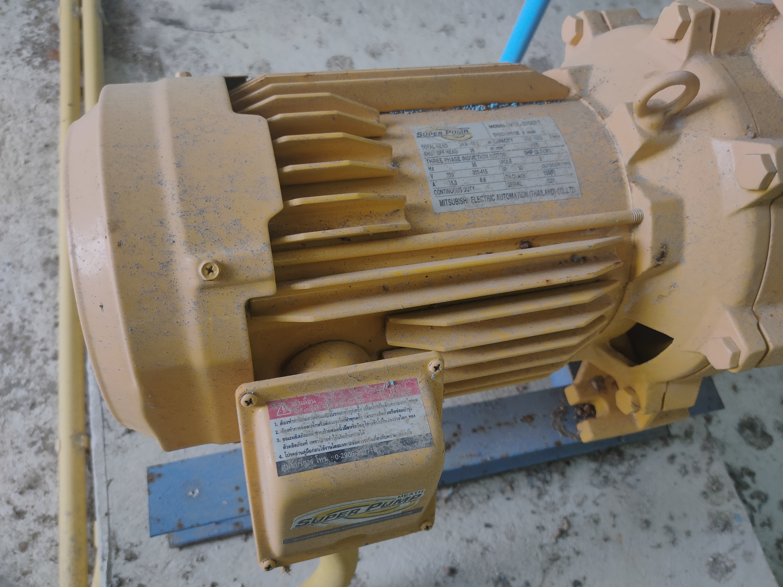
Pictures/IMG20240515163022.jpg
