PipeNitch/Project_WPNS-IoT/Pictures/IMG20240515163026.jpg

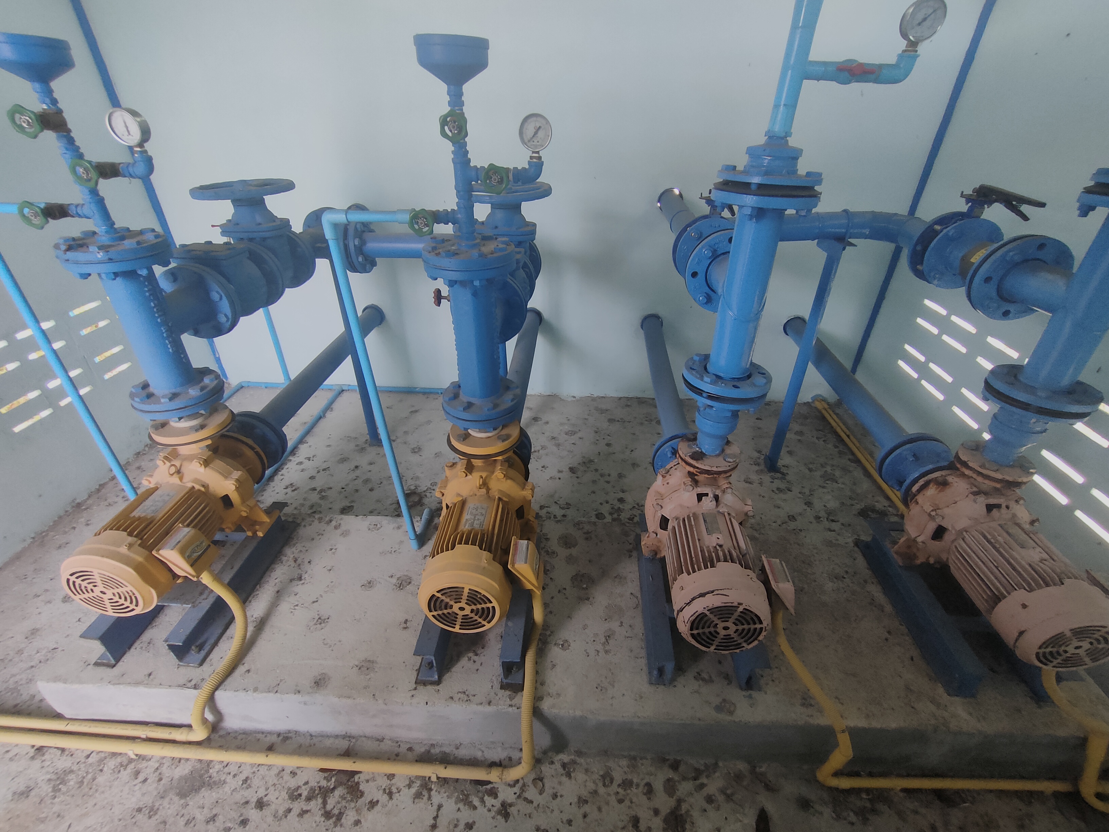
Pictures/IMG20240515163026.jpg
