PipeNitch/Project_WPNS-IoT/Pictures/IMG20240515163104.jpg

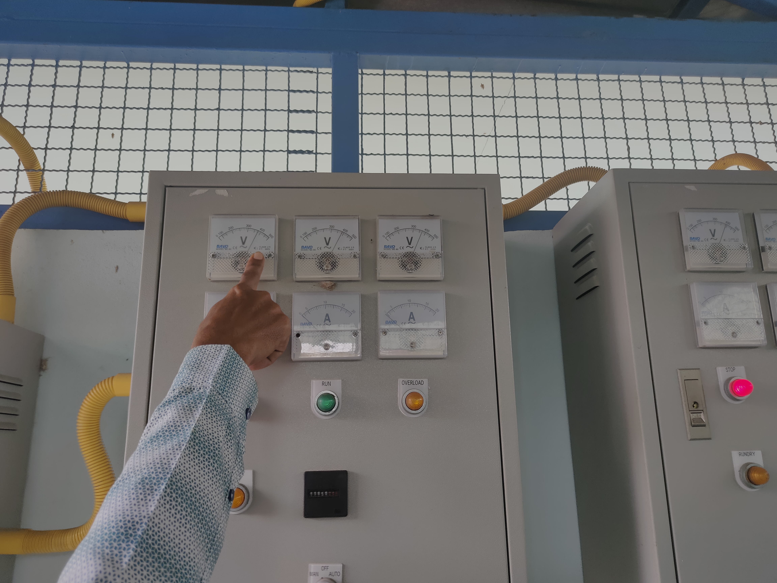
Pictures/IMG20240515163104.jpg
