PipeNitch/Project_WPNS-IoT/Pictures/IMG20240515163153.jpg

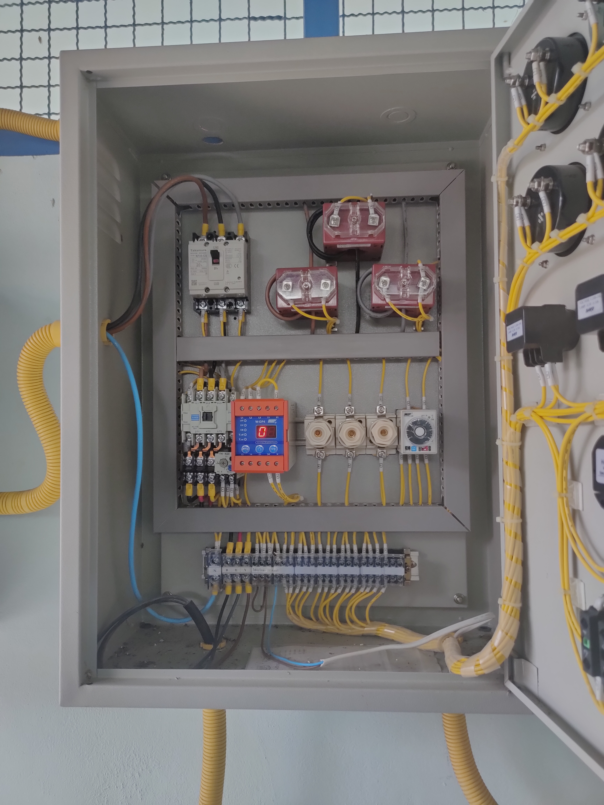
Pictures/IMG20240515163153.jpg
