PipeNitch/Project_WPNS-IoT/Pictures/IMG20240515163155.jpg

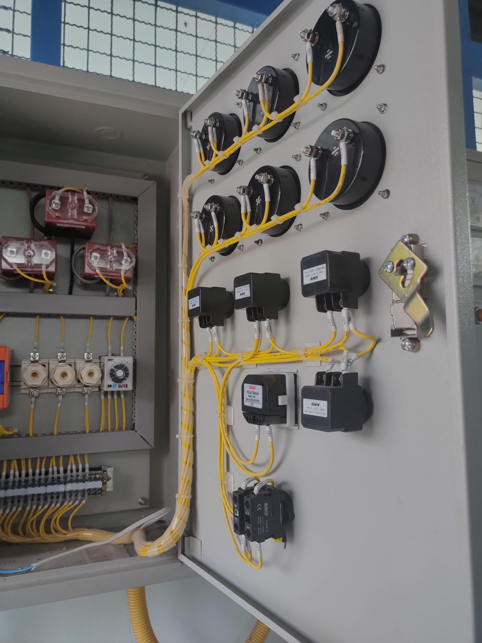
Pictures/IMG20240515163155.jpg
