PipeNitch/Project_WPNS-IoT/Pictures/IMG20240515163158.jpg

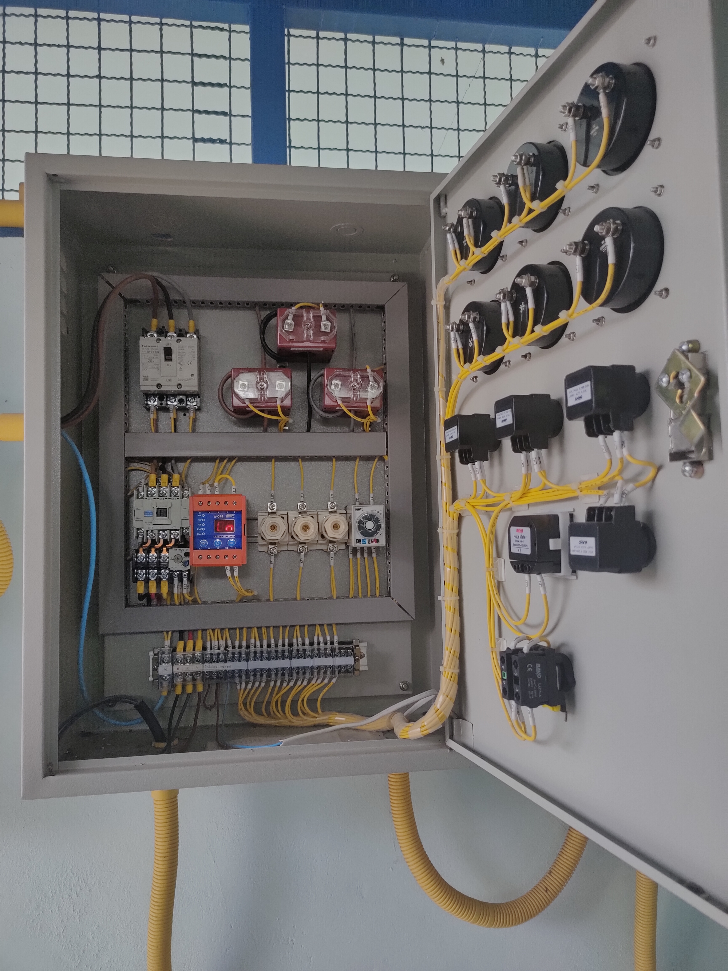
Pictures/IMG20240515163158.jpg
