PipeNitch/Project_WPNS-IoT/Pictures/IMG20240515163215.jpg

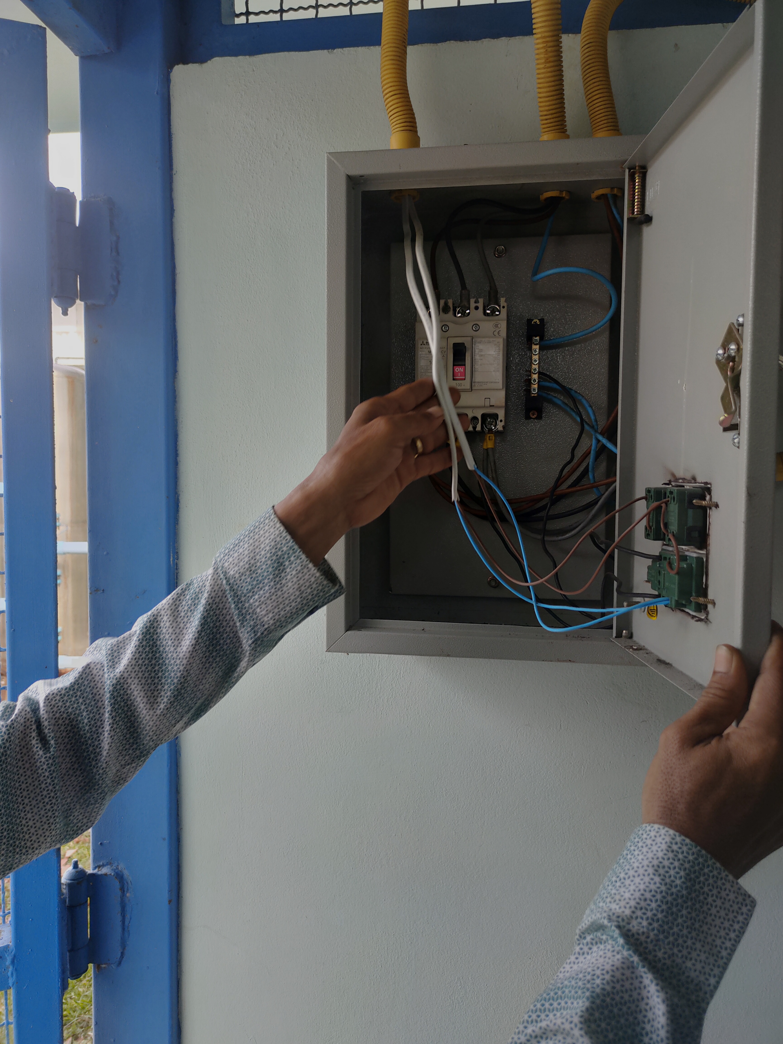
Pictures/IMG20240515163215.jpg
