PipeNitch/Project_WPNS-IoT/Pictures/IMG20240515163219.jpg

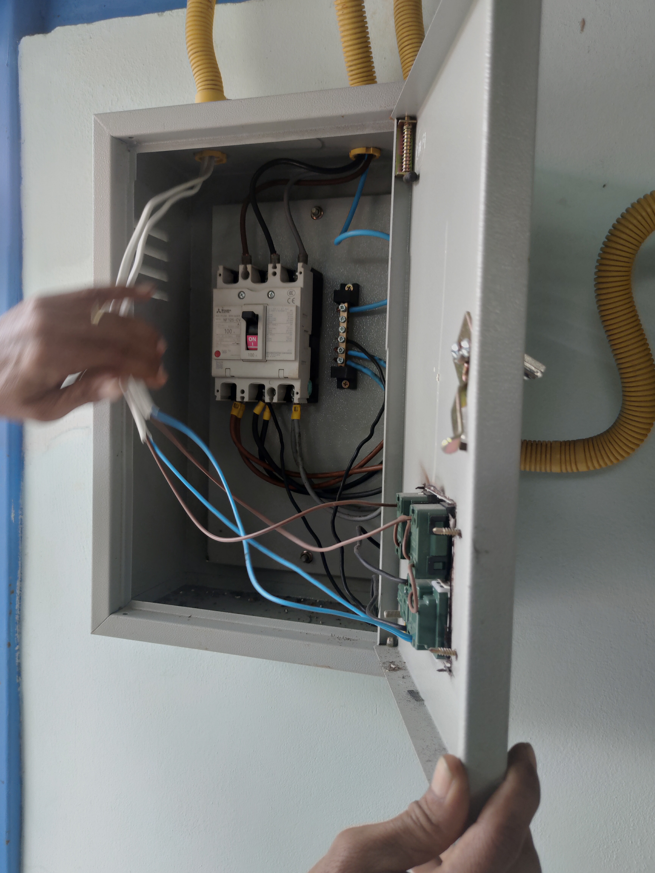
Pictures/IMG20240515163219.jpg
