PipeNitch/Project_WPNS-IoT/Pictures/IMG20240515163220.jpg

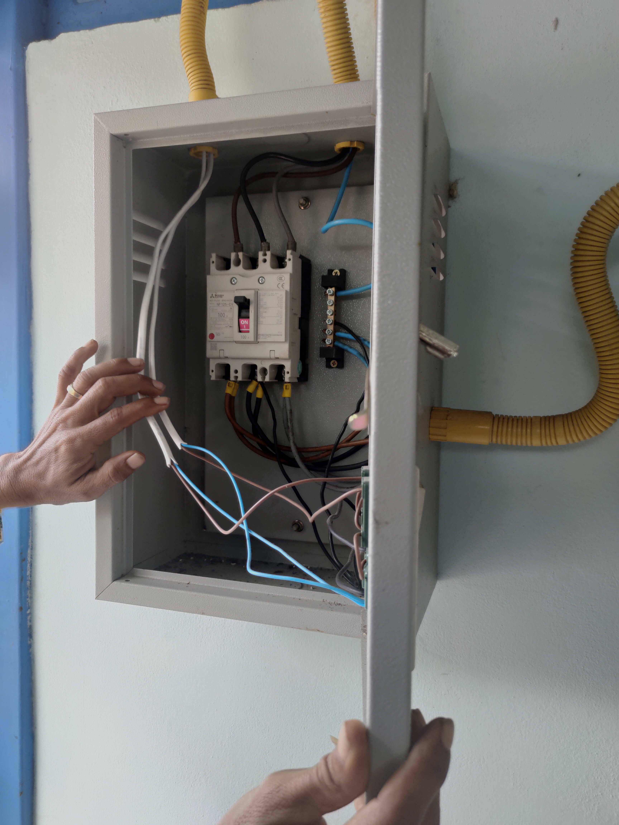
Pictures/IMG20240515163220.jpg
