PipeNitch/Project_WPNS-IoT/Pictures/IMG20240515163225.jpg

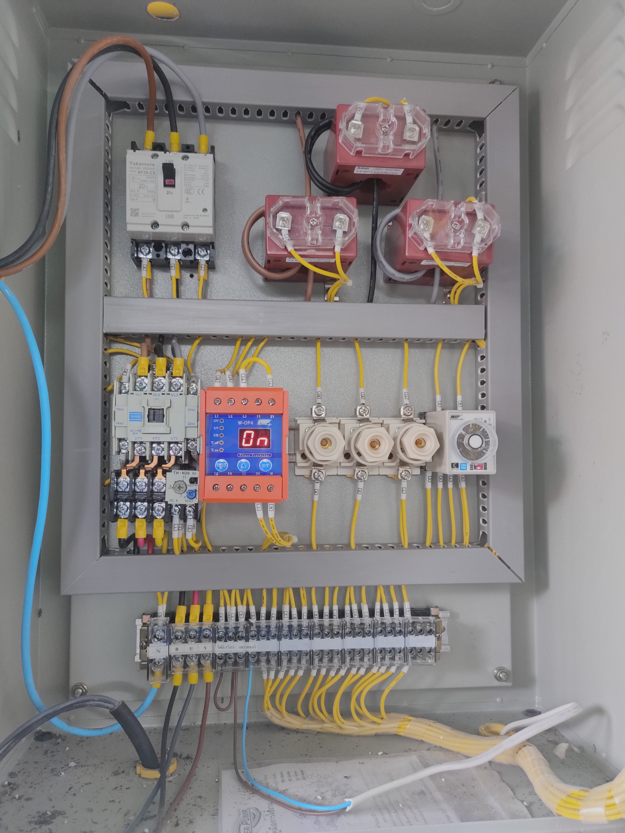
Pictures/IMG20240515163225.jpg
