PipeNitch/Project_WPNS-IoT/Pictures/IMG20240515163234.jpg

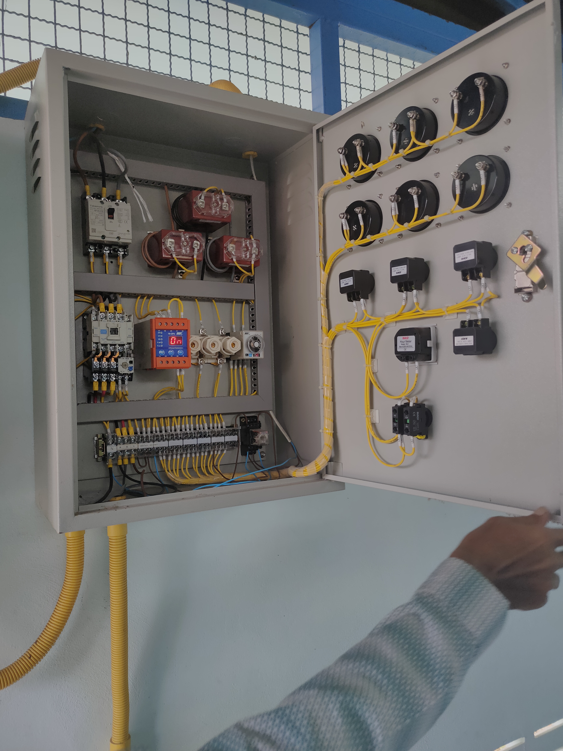
Pictures/IMG20240515163234.jpg
