PipeNitch/Project_WPNS-IoT/Pictures/IMG20240515163326.jpg

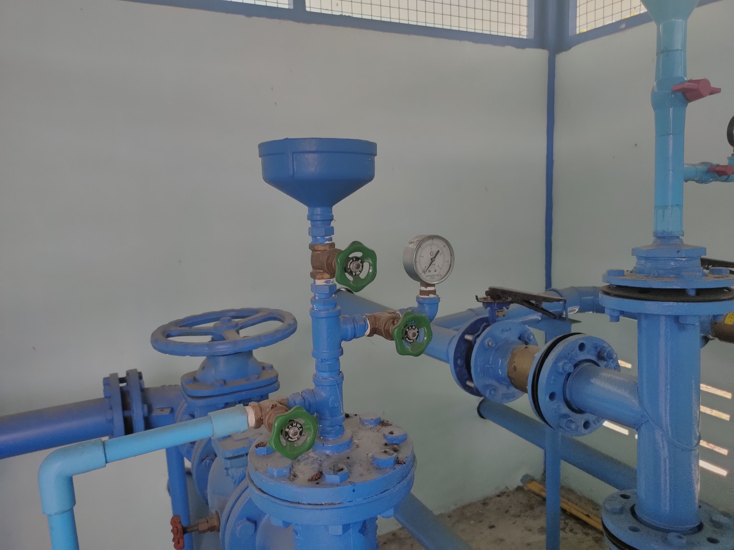
Pictures/IMG20240515163326.jpg
