PipeNitch/Project_WPNS-IoT/Pictures/IMG20240515163740.jpg

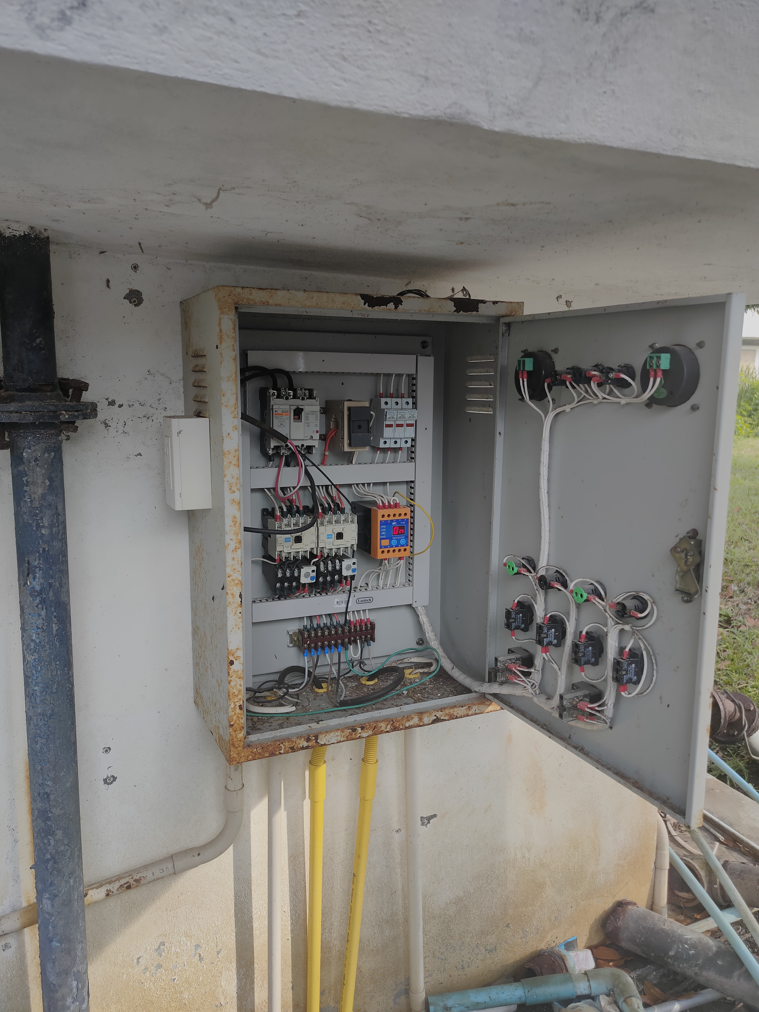
Pictures/IMG20240515163740.jpg
