PipeNitch/Project_WPNS-IoT/Pictures/IMG20240515163743.jpg

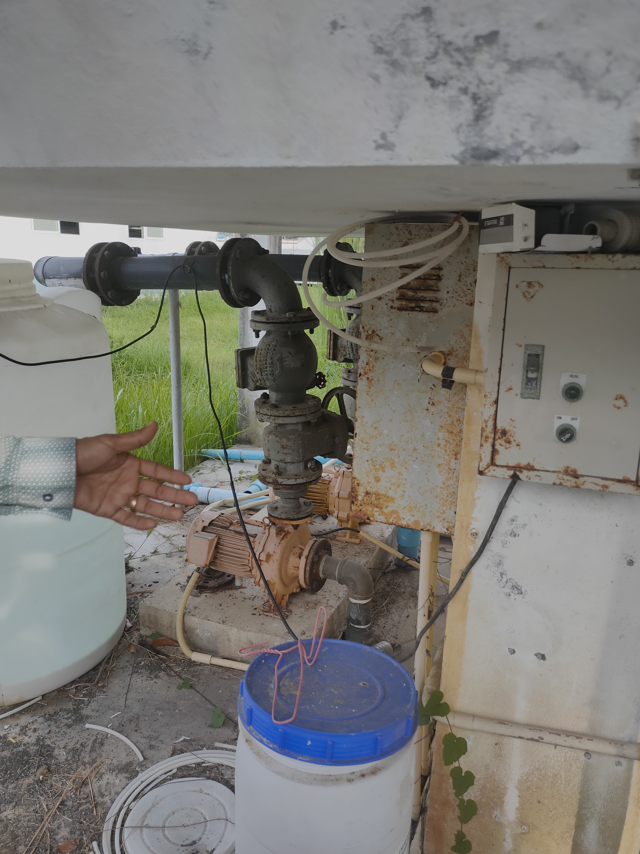
Pictures/IMG20240515163743.jpg
