PipeNitch/Project_WPNS-IoT/Pictures/IMG20240515163814.jpg

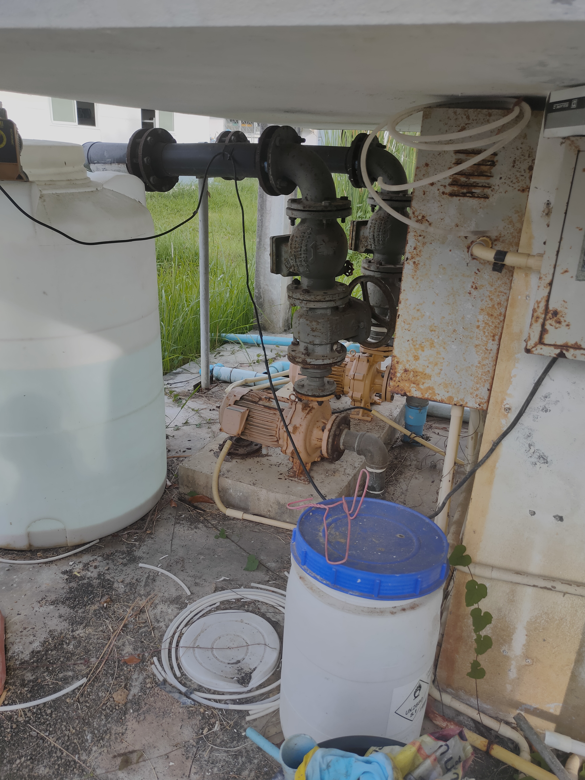
Pictures/IMG20240515163814.jpg
