PipeNitch/Project_WPNS-IoT/Pictures/IMG20240521151940.jpg

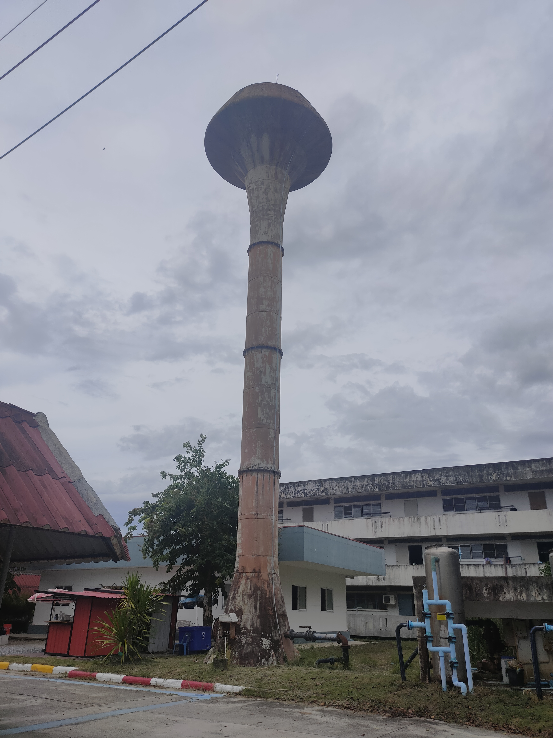
Pictures/IMG20240521151940.jpg
