PipeNitch/Project_WPNS-IoT/Pictures/IMG_20240522_211048.jpg

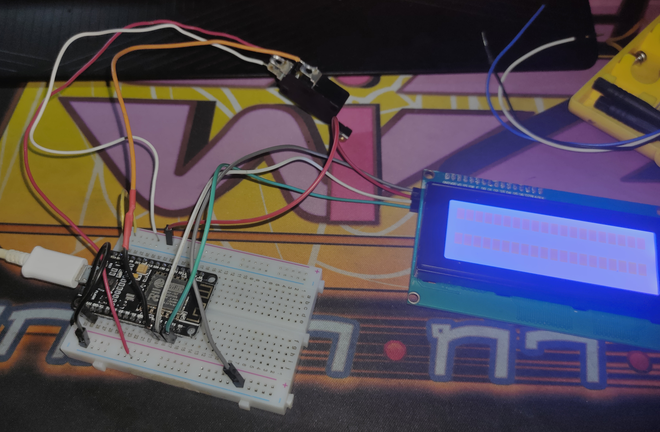
Pictures/IMG_20240522_211048.jpg
