PipeNitch/Project_WPNS-IoT/Pictures/ระบบแจ้งเตือนและตัดการทำงานของปั๊มน้ำโดยใช้เทคโนโลยีอินเทอร์เน็ตในทุกสิ่ง_InterfaceBlynk.jpg

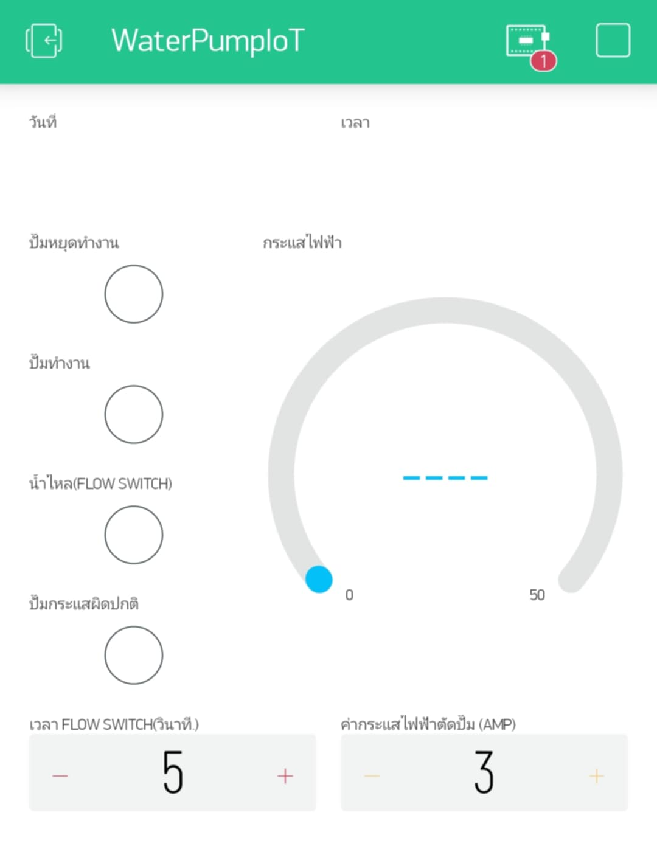
Pictures/ระบบแจ้งเตือนและตัดการทำงานของปั๊มน้ำโดยใช้เทคโนโลยีอินเทอร์เน็ตในทุกสิ่ง_InterfaceBlynk.jpg
