PipeNitch/Project_WPNS-IoT/Documents/ระบบแจ้งเตือนและตัดการทำงานของปั๊มน้ำโดยใช้เทคโนโลยีอินเทอร์เน็ตในทุกสิ่ง_Infographic.pdf

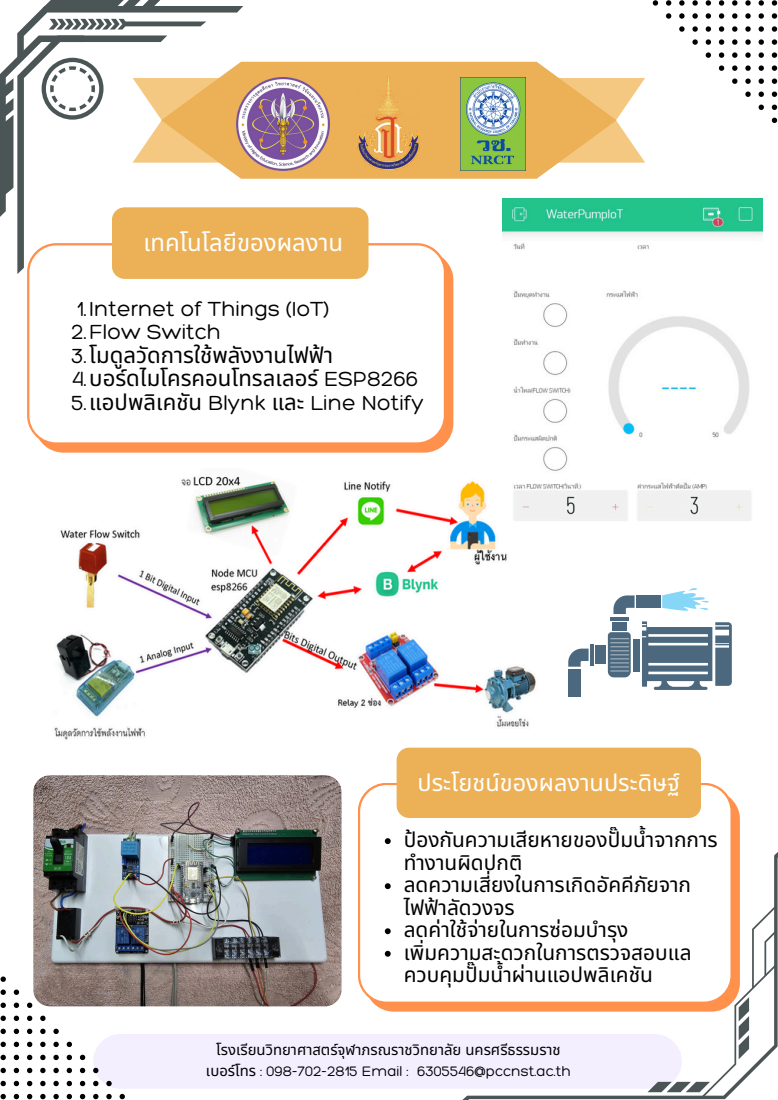
[picture p312: page 1]
โรงเรียรี; ยาศาสตร์จุร์; จุฬาภรณราชวิทวิ; ยาลัย นครศรีธรี; รรมราช; เบอร์โร์; ทร : 098-702-2815 Email : 6305546@pccnst.ac.th; ประโยชน์ขน์; องผลงานประดิษดิ; งกันความเสียสี; หายของปั๊มน้ำ จากการ; ทำ งานผิดผิ; ปกติ; ลดความเสี่ย; ไฟฟ้าฟ้; ลัดวงจร; ลดค่าใช้จ่ช้; ยในการซ่อซ่; มบำ รุงรุ; ความสะดวกในการตรวจสอบแล; ควบคุมคุ; นแอปพลิเคชันชั; เทคโนโลยีขยี; องผลงาน; 3.โมดูลดู; การใช้พช้; ลังงานไฟฟ้าฟ้; 4.บอร์ดร์; ไมโครคอนโทรลเลอร์ ESP8266; 5.แอปพลิเคชันชั; Blynk และ Line Notify

1.Internet of Things (IoT)
2.Flow Switch

งในการเกิดอัคคีภัยจาก
