PipeNitch/Project_WPNS-IoT/Example/KM64Cop7.pdf

## แนวปฏิบัติที่ดี CoP ที่ 7 การพัฒนานักศึกษา ขอบเขต : ส

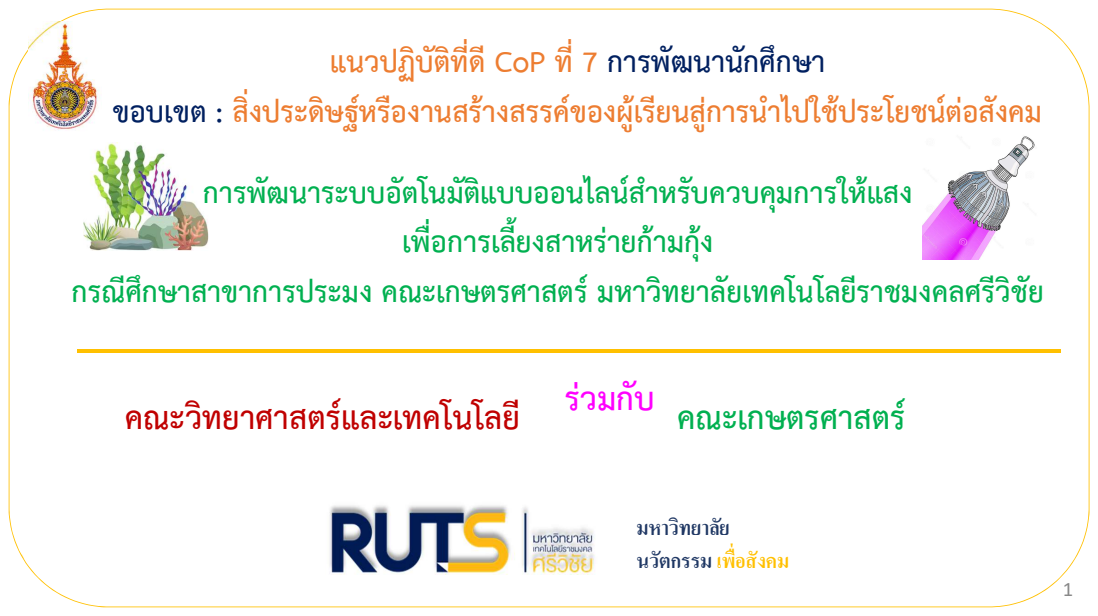
[picture p313: page 1]
ฒนาระบบอ; ตโนม; แบบออนไลน; าหร; บควบคม; การให; แสง; ษฐห; งานสรา; งสรรค; ของผ; ยนส; ูการน; าไปใช; ประโยชน; งคม; คณะเกษตรศาสตร รวมกับ

ิ่งประด
การพ
กรณีศึกษาสาขาการประมง คณะเกษตรศาสตร มหาวิทยาลัยเทคโนโลยีราชมงคลศรีวิชัย

เพื่อการเลี้ยงสาหรายกามกุง

คณะวิทยาศาสตรและเทคโนโลยี

มหาวทิยาลยั นวัตกรรม เพืÉอสังคม

# ทีมงาน

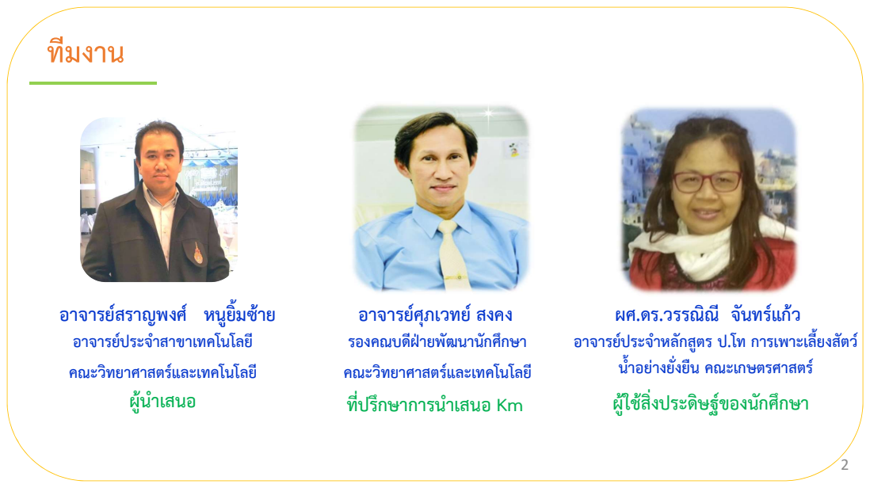
[picture p314: page 2]
สราญพงศ; สิ่งประดิษฐ; ของนกัศ; กษา; ภเวทย; สงคง; น้ําอยางยั่งยนื คณะเกษตรศาสตร คณะวิทยาศาสตรและเทคโนโลยี; คณะวิทยาศาสตรและเทคโนโลยี

อาจารย
อาจารยประจําสาขาเทคโนโลยี
ผูนําเสนอ

รองคณบดีฝายพัฒนานักศึกษา
ที่ปรึกษาการนําเสนอ Km

ผศ.ดร.วรรณิณี จันทรแกว
อาจารยประจําหลักสูตร ป.โท การเพาะเลี้ยงสัตว

# ความเปนมา ความสําคัญและวัตถุประสงค

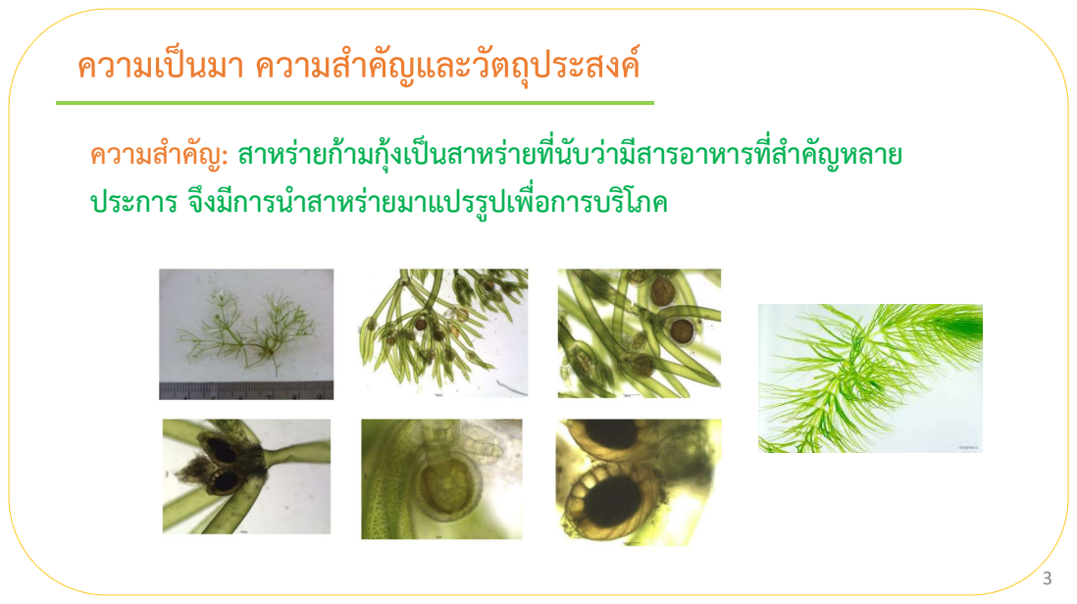
[picture p315: page 3]
ามก; งเป; นสาหรายท; สารอาหารท่ส; ญหลาย

ความสําคัญ: สาหรายก
ประการ จึงมีการนําสาหรายมาแปรรูปเพื่อการบริโภค

# ความเปนมา ความสําคัญและวัตถุประสงค

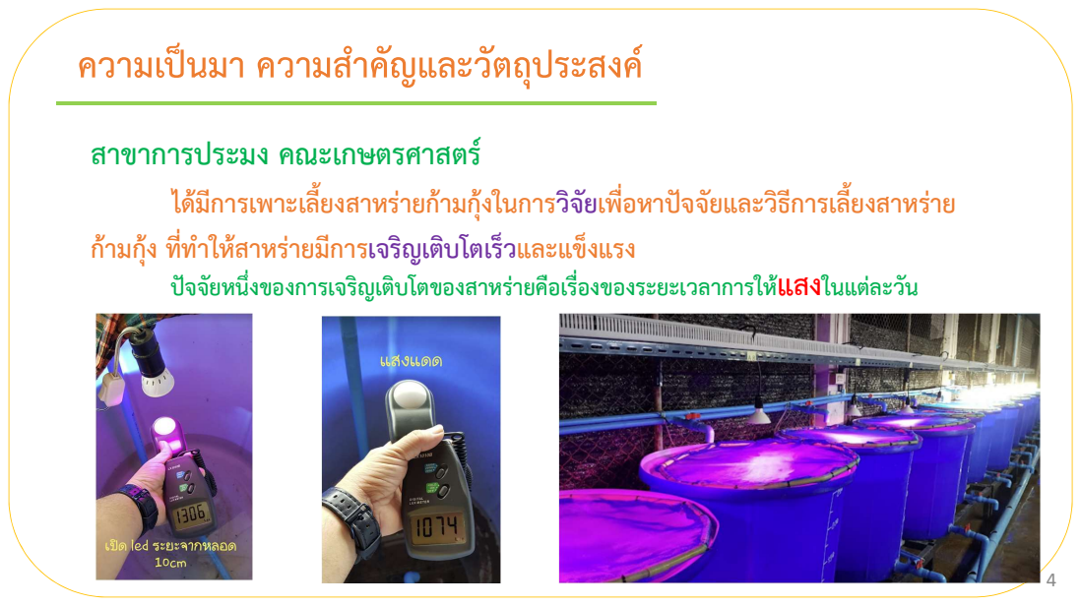
[picture p316: page 4]
ื่อหาปจ; ยและว; การเล; ้ ยงสาหราย; ญเตบ; ิโตเร; วและแข็งแรง; ื่องของระยะเวลาการใหแสง ในแตละวัน

สาขาการประมง คณะเกษตรศาสตร
ไดมีการเพาะเลี้ยงสาหรายกามกุงในการวิจัยเพ
กามกุง ที่ทําใหสาหรายมีการเจร
ปจจัยหน

ึ่งของการเจริญเติบโตของสาหรายคอ

# ความเปนมา ความสําคัญและวัตถุประสงค

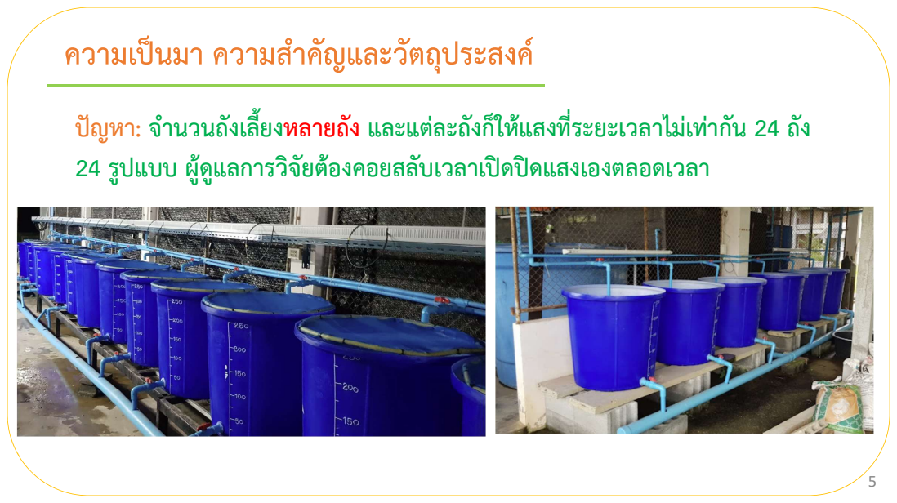
[picture p317: page 5]
แสงท; ี่ระยะเวลาไมเทา ก

ปญหา: จํานวนถังเลี้ยงหลายถัง และแตละถ
24 รูปแบบ ผูดูแลการวิจัยตองคอยสลับเวลาเปดปดแสงเองตลอดเวลา

# ความเปนมา ความสําคัญและวัตถุประสงค

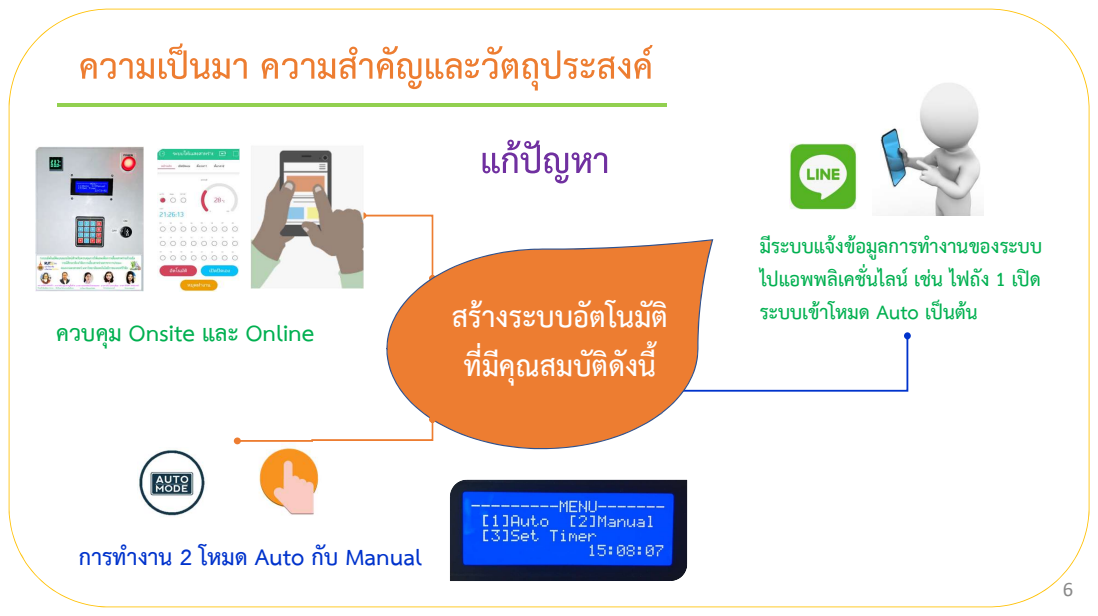
[picture p318: page 6]
ณสมบ; นตน; แกปญหา

มีระบบแจงขอมูลการทํางานของระบบ
ไปแอพพลิเคชั่นไลน เชน ไฟถัง 1 เปด
ระบบเขาโหมด Auto เป

สรางระบบอัตโนมัติ

้ ควบคุม Onsite และ Online

การทํางาน 2 โหมด Auto กับ Manual

## วิธีปฏิบัติที่ดี ตามหลัก PDCA

าน | Action

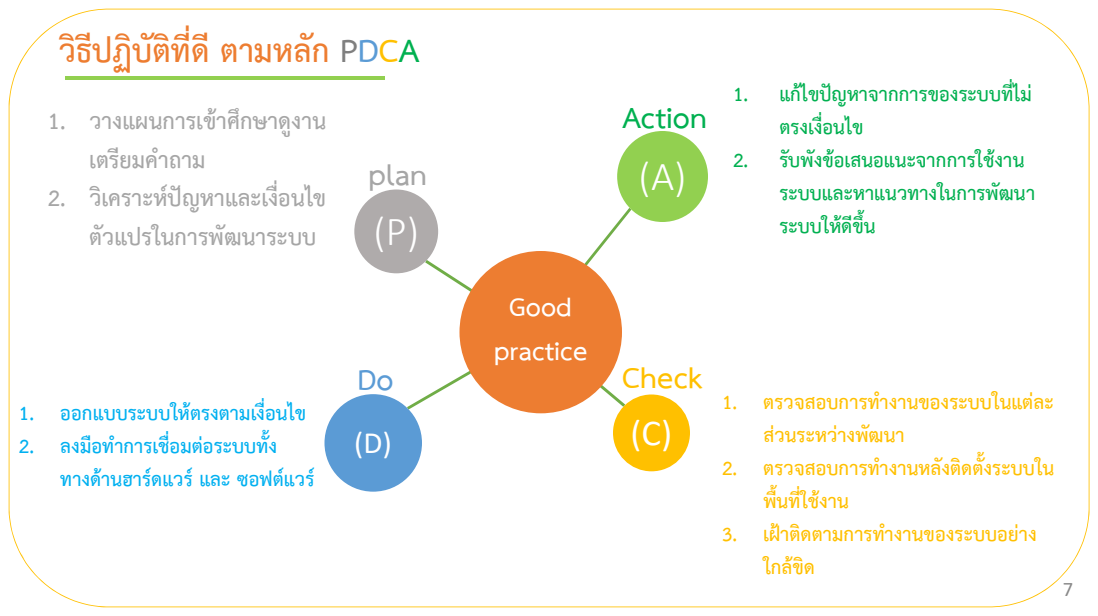
[picture p319: page 7]
Good practice; ระบบและหาแนวทางในการพัฒนา ระบบใหดีขึ้น; plan; Check; กษาดง

1. แกไขปญหาจากการของระบบที่ไม
ตรงเงื่อนไข
2. รับพังขอเสนอแนะจากการใชงาน

1. วางแผนการเข
เตรียมคําถาม
2. วิเคราะหปญหาและเงื่อนไข
ตัวแปรในการพัฒนาระบบ

1. ตรวจสอบการทํางานของระบบในแตละ
สวนระหวางพัฒนา
2. ตรวจสอบการทํางานหลังติดต้งัระบบใน
พ้นืที่ใชงาน
3. เฝาติดตามการทาํ งานของระบบอยาง
ใกลขิด

1. ออกแบบระบบใหตรงตามเงื่อนไข
2. ลงมือทําการเชื่อมตอระบบทั้ง
ทางดานฮารดแวร และ ซอฟตแวร

## วิธีปฏิบัติที่ดี

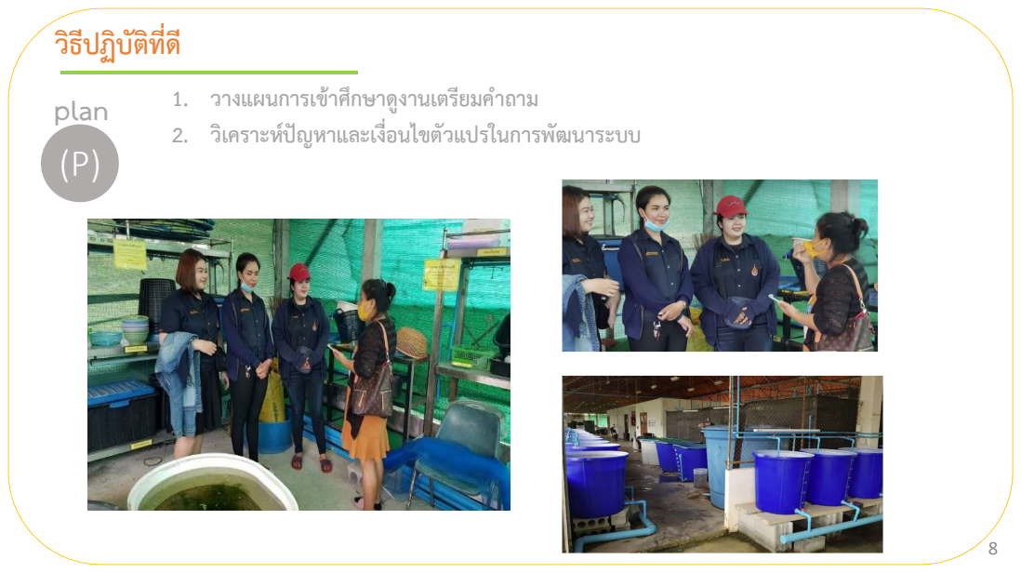
[picture p320: page 8]
plan; 1. วางแผนการเขาศึกษาดูงานเตรียมคําถาม; 2. วิเคราะหป ญหาและเง

ื่อนไขตัวแปรในการพัฒนาระบบ

# วางแผนดําเนินการ

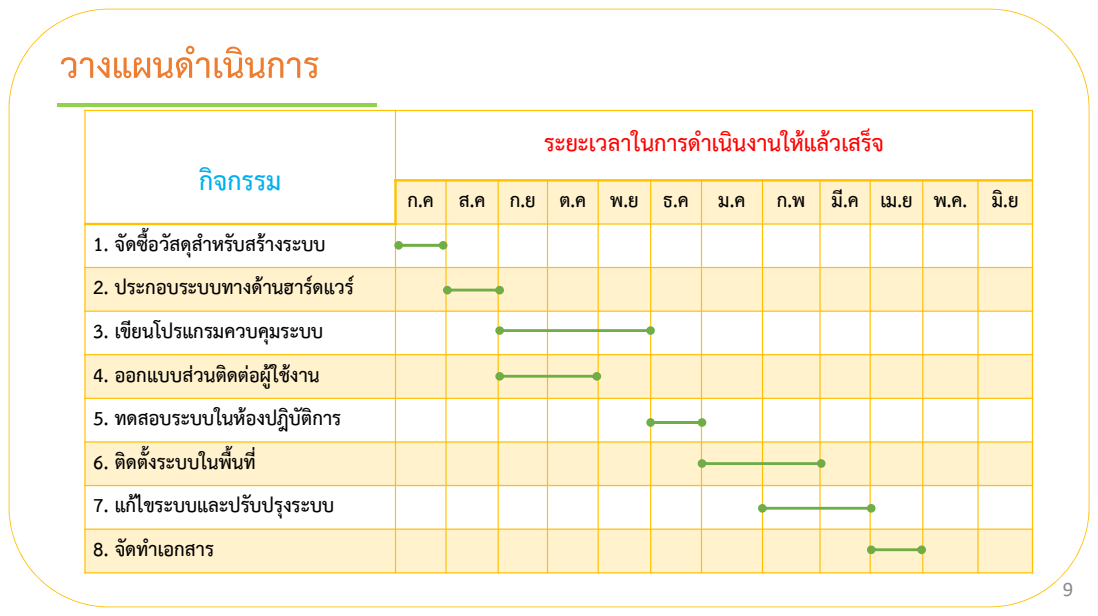
[picture p321: page 9]

กิจกรรม | ระยะเวลาในการดําเนนิงานใหแ ลว เสร ็ จ

1. จัดซื้อวัสดุสําหรับสรางระบบ
2. ประกอบระบบทางดานฮารดแวร
3. เขียนโปรแกรมควบคุมระบบ
4. ออกแบบสวนตดิตอผูใชงาน
5. ทดสอบระบบในหองปฎบิ ติการ ั 6. ติดตั้งระบบในพื้นที่

7. แกไขระบบและปรบั ปรุงระบบ
8. จัดทําเอกสาร

## วิธีปฏิบัติที่ดี

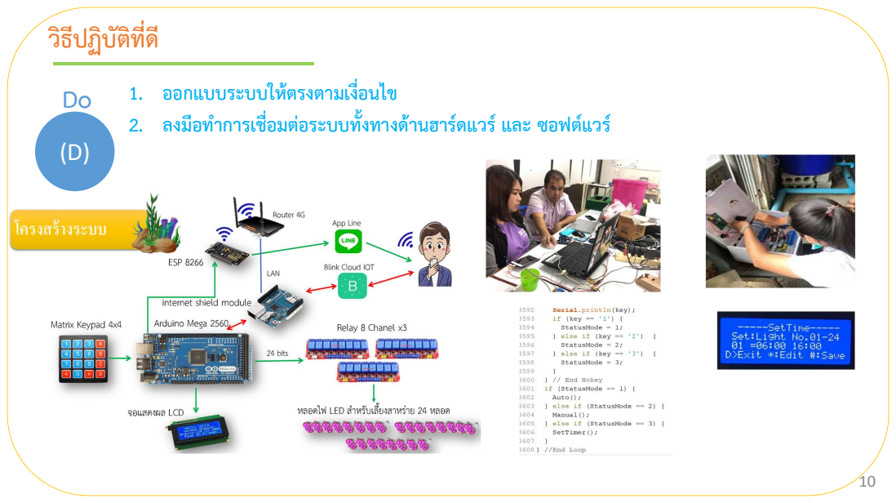
[picture p322: page 10]

Do 1. ออกแบบระบบใหตรงตามเงื่อนไข
2. ลงมือทําการเชื่อมตอระบบทั้งทางดานฮารดแวร และ ซอฟตแวร

## วิธีปฏิบัติที่ดี

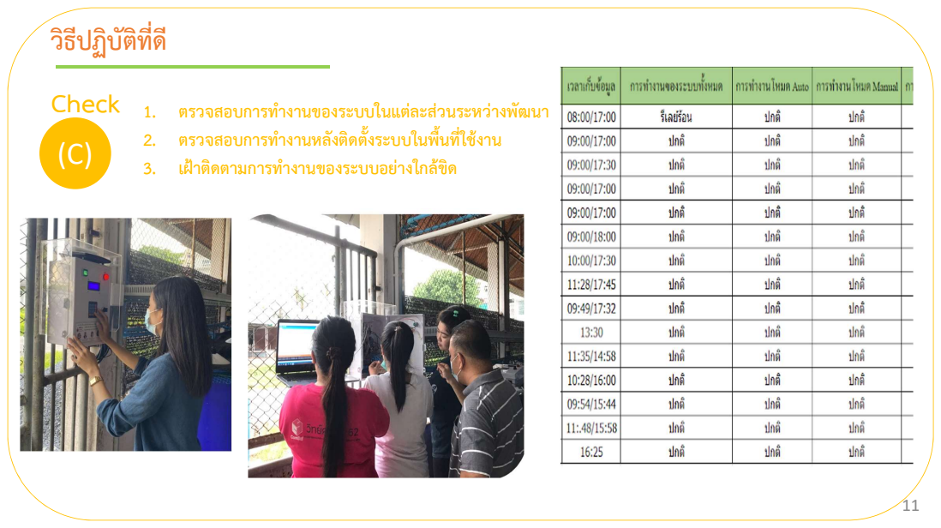
[picture p323: page 11]

Check 1. ตรวจสอบการทํางานของระบบในแตละสวนระหวางพัฒนา
2. ตรวจสอบการทํางานหลังติดตั้งระบบในพื้นที่ใชงาน
3. เฝาติดตามการทํางานของระบบอยางใกลขิด

## วิธีปฏิบัติที่ดี

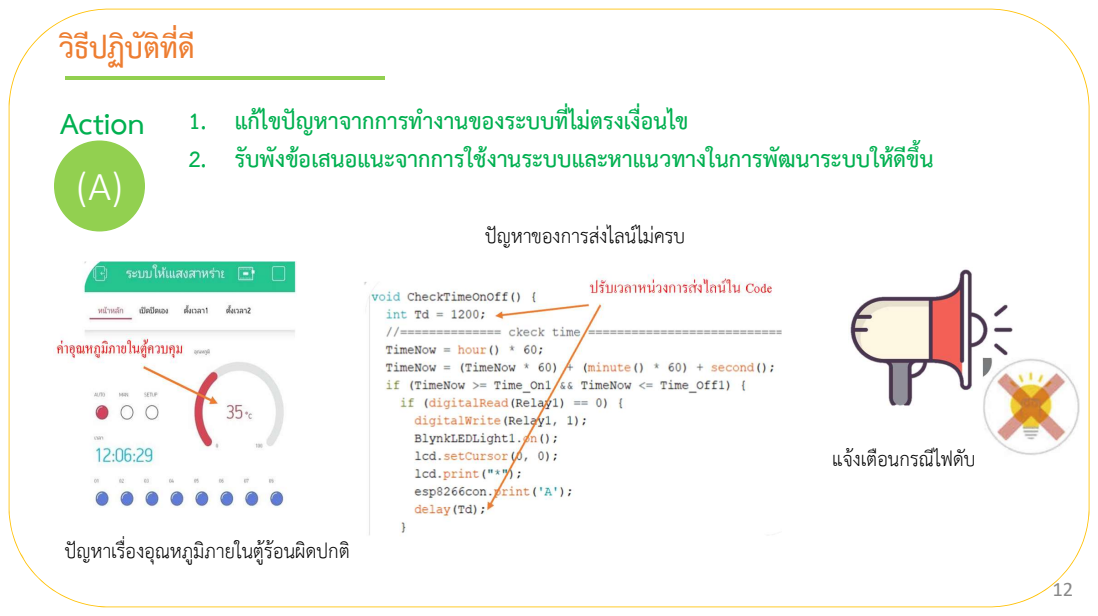
[picture p324: page 12]
อเสนอแนะจากการใช; งานระบบและหาแนวทางในการพัฒนาระบบใหด

Action 1. แกไขปญหาจากการทํางานของระบบที่ไมตรงเงื่อนไข

ปญหาของการสงไลนไมครบ

แจงเตือนกรณีไฟดับ

ปญหาเรื่องอณุ หภูมิภายในตูรอนผิดปกติ

# ความส

ํ

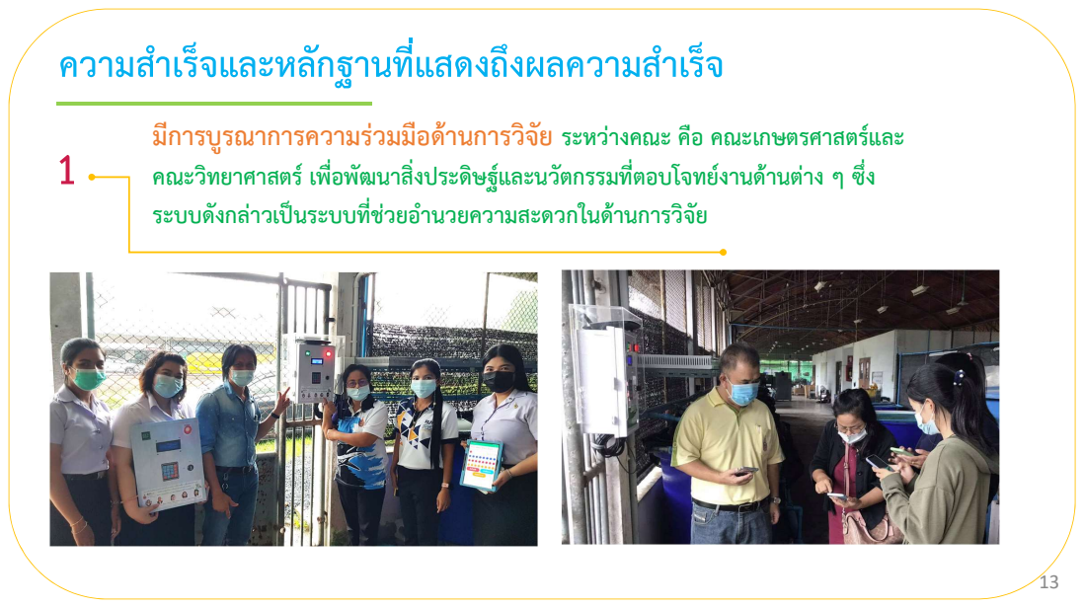
[picture p325: page 13]
จและหลก; ฐานท; แสดงถ; งผลความส; าเร; และนวัตกรรมท่ต; อบโจทย; งานด; านตาง ๆ ซ; นระบบท; านการวิจัย

าเร
มีการบูรณาการความรวมมือดานการวิจัย ระหวางคณะ คือ คณะเกษตรศาสตรและ
คณะวิทยาศาสตร
ระบบดังกลาวเป

ี่ชว ยอํานวยความสะดวกในด

ื่อพัฒนาสิ่งประดิษฐ

# ความส

ํ

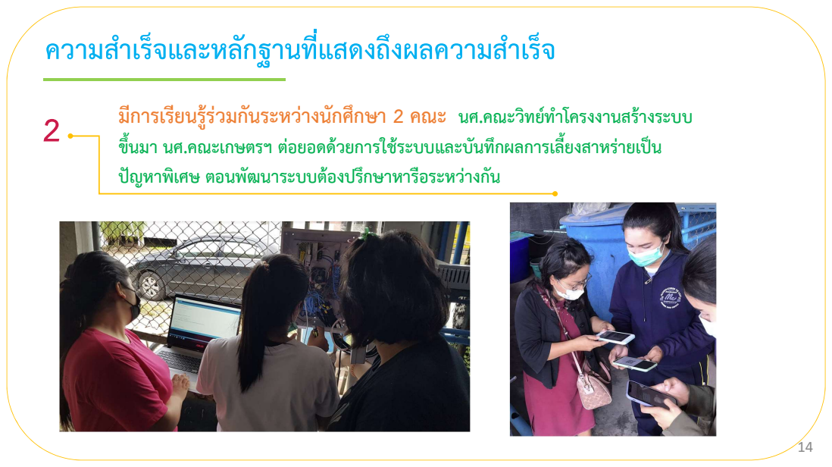
[picture p326: page 14]
าเร; จและหลก; ฐานท; แสดงถ; งผลความส; การเร; ยนร; ูวมก; นระหวางน; วยการใช; ระบบและบันท; กผลการเล; ี้ยงสาหรายเป; ปญหาพิเศษ ตอนพฒั นาระบบต; องปร; กษาหาร; อระหวางกัน

มา นศ.คณะเกษตรฯ ตอยอดด

กษา 2 คณะ นศ.คณะวิทยทําโครงงานสรางระบบ

# ความส

ํ

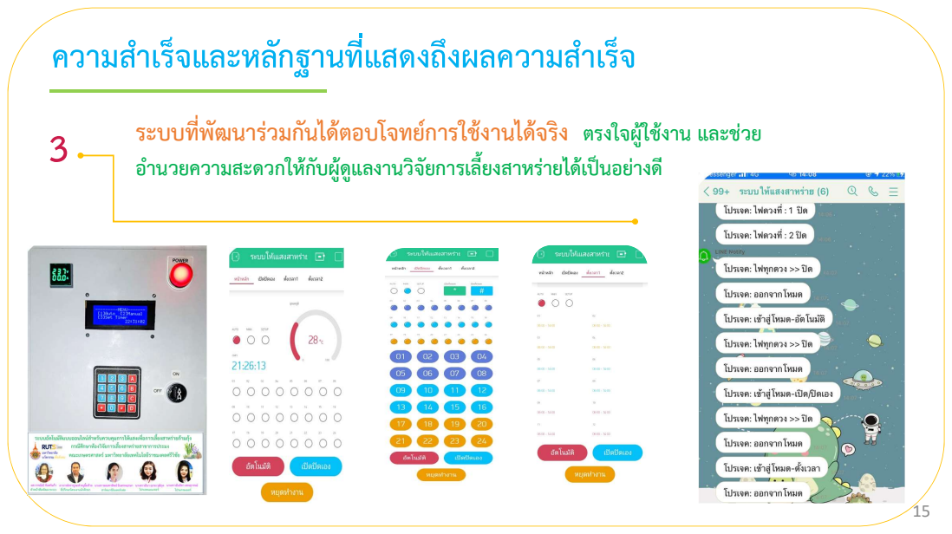
[picture p327: page 15]
จและหลก; ฐานท; แสดงถ; งผลความส; าเร; ระบบท; ฒนารวมก; นได; ตอบโจทยก; ารใช; งานได

าเร
อํานวยความสะดวกใหกับผูดูแลงานวิจัยการเลี้ยงสาหรายไดเปนอยางดี

ง ตรงใจผูใชงาน และชวย

# ความส

ํ

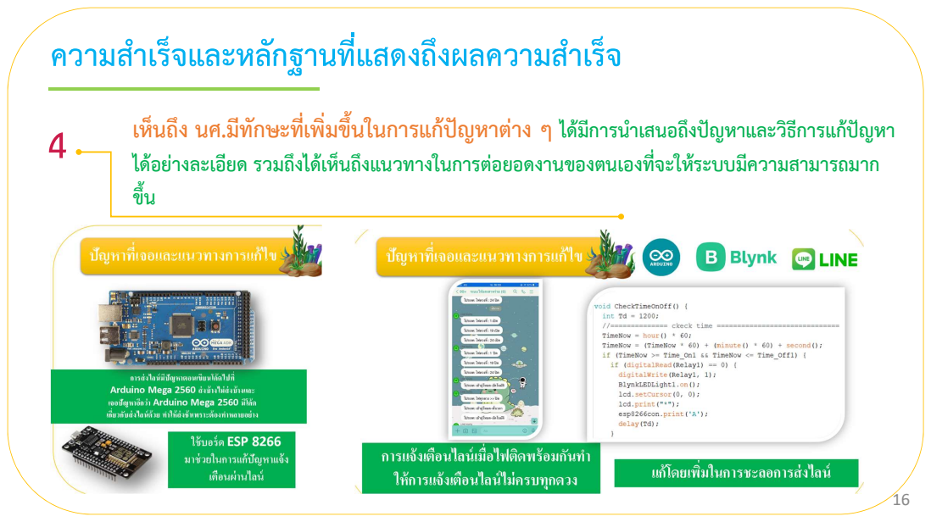
[picture p328: page 16]
าเร; จและหลก; ฐานท; แสดงถ; งผลความส; กษะท่เ; ึ้ นในการแก; อยางละเอ; ยด รวมถ; งได; งแนวทางในการตอยอดงานของตนเองท่จ; ะใหร; ะบบม; ความสามารถมาก

ญหาตาง ๆ ไดมีการนําเสนอถึงปญหาและวิธีการแกปญหา

# ความส

ํ

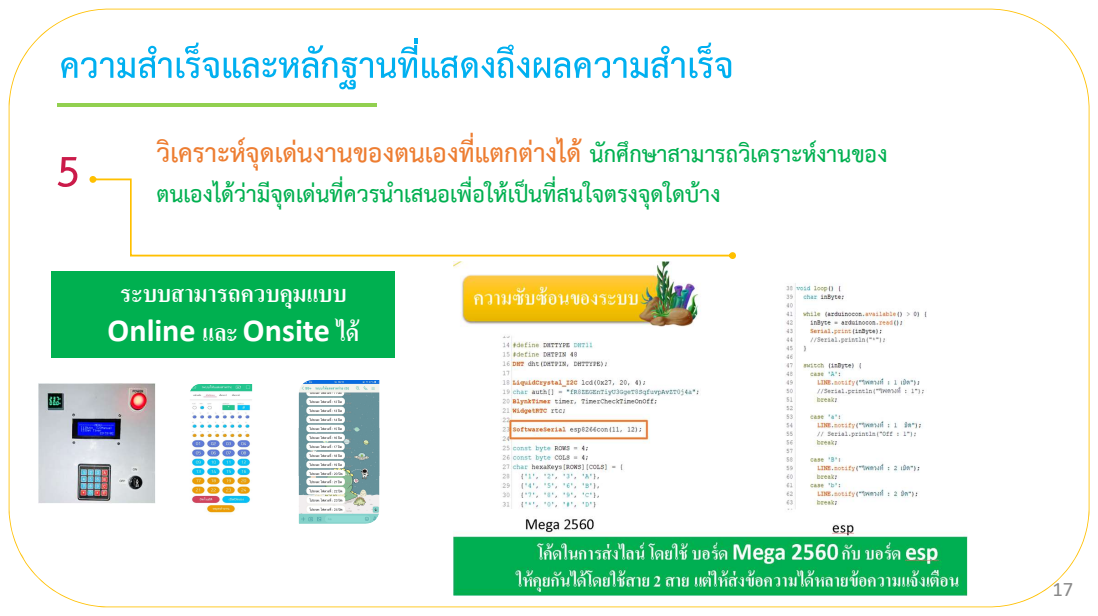
[picture p329: page 17]
าเร; จและหลก; ฐานท; แสดงถ; งผลความส; กษาสามารถวเิคราะห; งานของ; ดเดนท; ี่ควรนําเสนอเพ; ื่อให; ี่สนใจตรงจ; ดใดบ

5 วิเคราะหจุดเดนงานของตนเองที่แตกตางได นกัศ
ตนเองไดว

ระบบสามารถควบคุมแบบ
Online และ Onsite ได้

# ความส

ํ

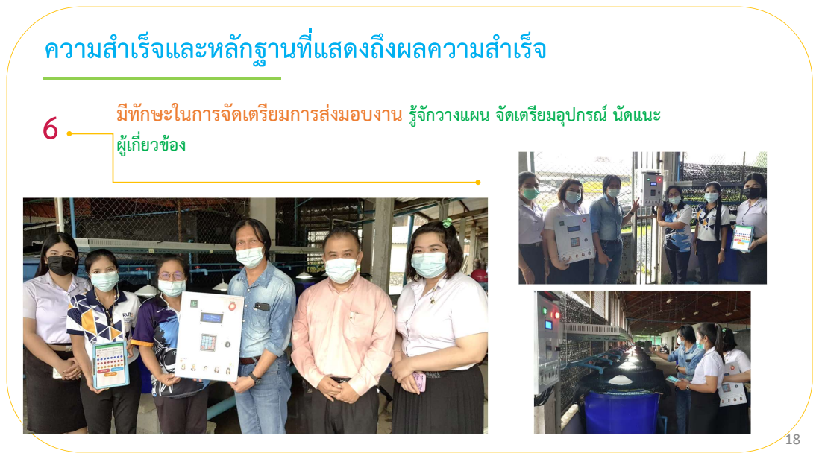
[picture p330: page 18]
าเร; จและหลก; ฐานท; แสดงถ; งผลความส; ษะในการจ; ดเตร; ยมการสงมอบงาน ร ู; ยมอ; ปกรณ; นัดแนะ; ี่ยวข

จกัวางแผน จัดเตร

# ความส

ํ

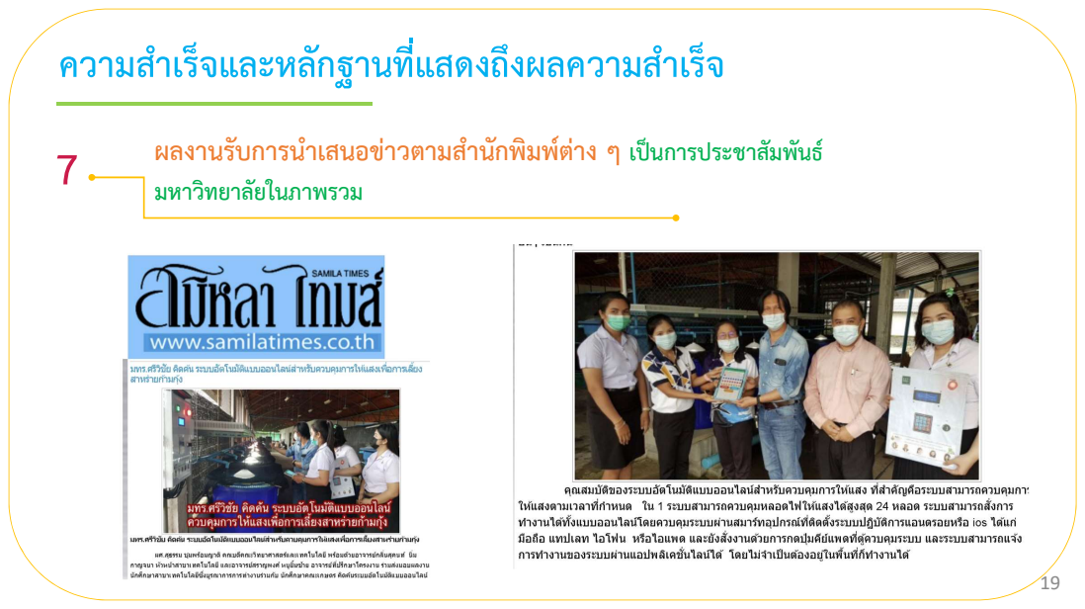
[picture p331: page 19]
าเร; จและหลก; ฐานท; แสดงถ; งผลความส

7 ผลงานรับการนําเสนอขาวตามสํานักพิมพตาง ๆ เปนการประชาสัมพันธ
มหาวิทยาลัยในภาพรวม

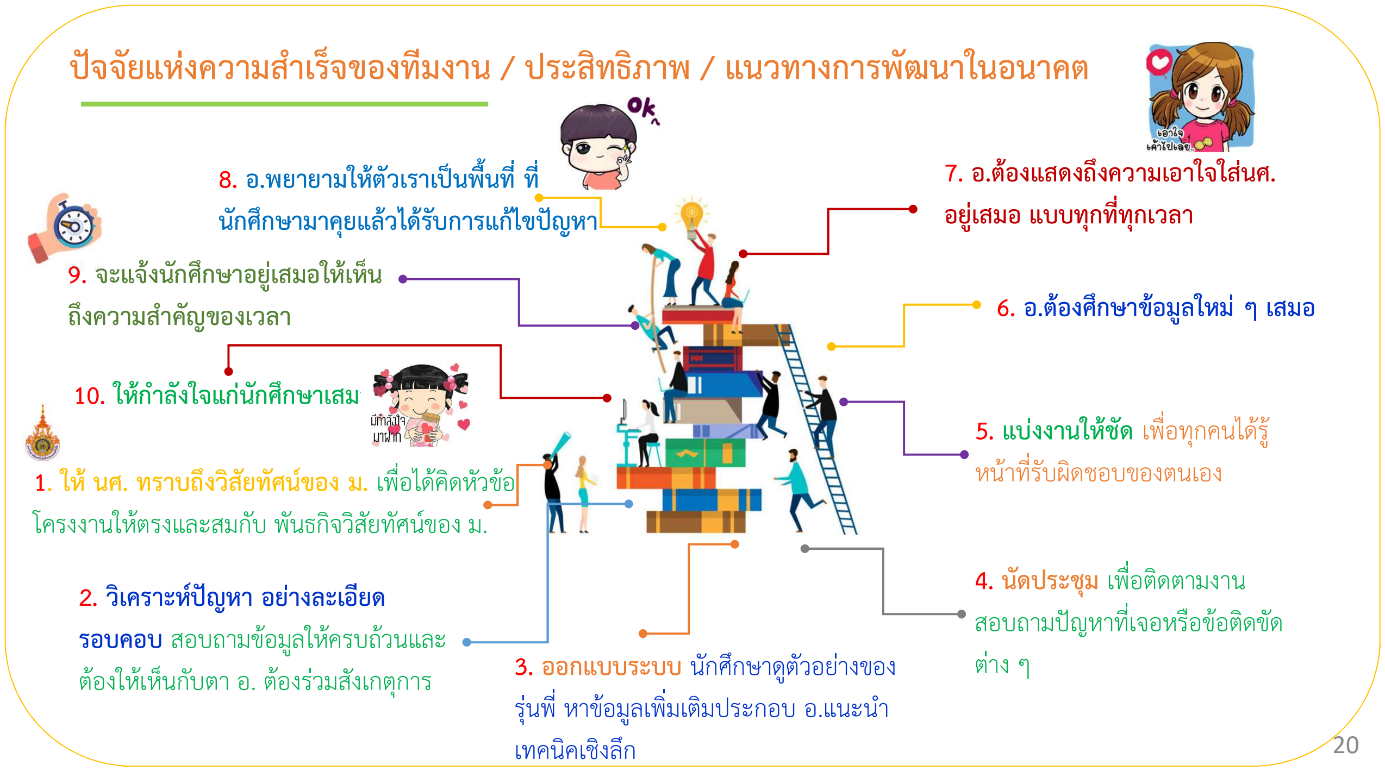
[picture p332: figure]
ยแหง ความส; าเร; จของท; มงาน / ประส; ภาพ / แนวทางการพ; ฒนาในอนาคต; 2. วิเคราะหป ญหา อยางละเอียด รอบคอบ สอบถามขอมลู ใหครบถวนและ ตองใหเห; นกบัตา อ. ตองรวมสังเกตุการ; 3. ออกแบบระบบ นักศึกษาดูตัวอยา งของ รุนพี่ หาขอมูลเพิ่มเติมประกอบ อ.แนะนํา เทคนิคเชิงลึก; 4. นัดประชุม เพื่อติดตามงาน สอบถามปญหาที่เจอหรอืขอติดขัด ตาง ๆ; 6. อ.ตองศึกษาขอมูลใหม ๆ เสมอ; 7. อ.ตองแสดงถึงความเอาใจใสนศ. อยูเสมอ แบบทุกที่ทุกเวลา; 8. อ.พยายามใหตัวเราเปนพื้นที่ ที่ นักศึกษามาคุยแลวไดรบัการแกไขปญหา 9. จะแจงนกัศึกษาอยูเสมอใหเห; ถึงความสําคญั ของเวลา; 10. ใหกําลังใจแกนักศึกษาเสมอ; โครงงานใหตรงและสมกับ พันธกิจวิสยัทัศนของ ม.

### 5. แบงงานใหชัด เพื่อทุกคนไดรู หนาที่รับผิดชอบของตนเอง 1. ให นศ. ทราบถึงวิสัยทัศนของ ม. เพื่อไดคิดหวัขอ

ปจ

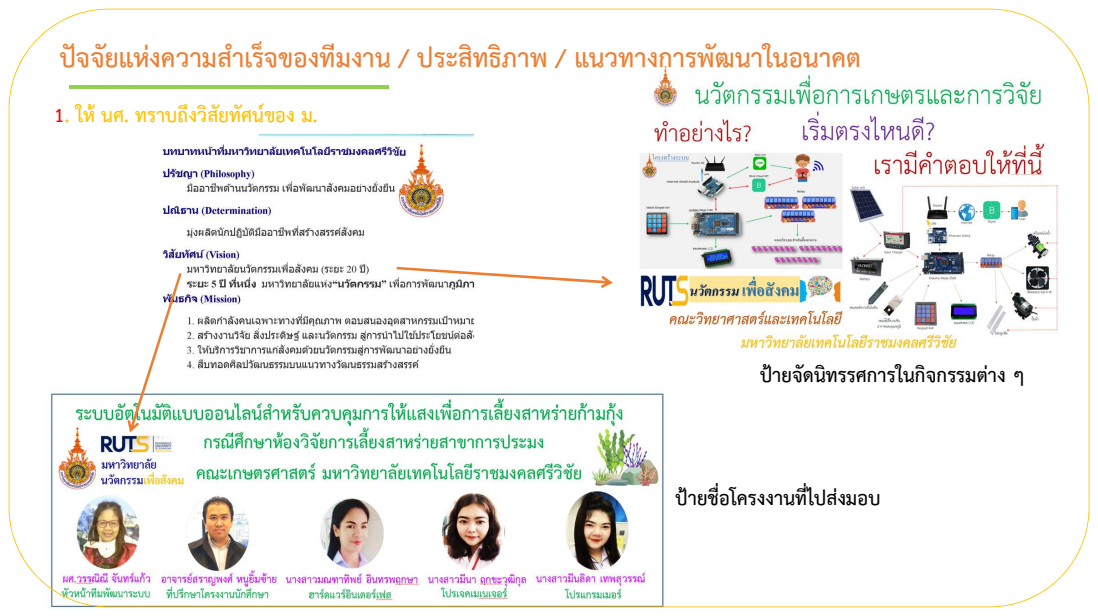
[picture p333: page 21]
ยแหง ความส; าเร; จของท; มงาน / ประส; ภาพ / แนวทางการพ; ฒนาในอนาคต

1. ให นศ. ทราบถึงวิสัยทัศนของ ม.

ปายจัดนิทรรศการในกิจกรรมตา ง ๆ

ปายชื่อโครงงานที่ไปสงมอบ

ปจ

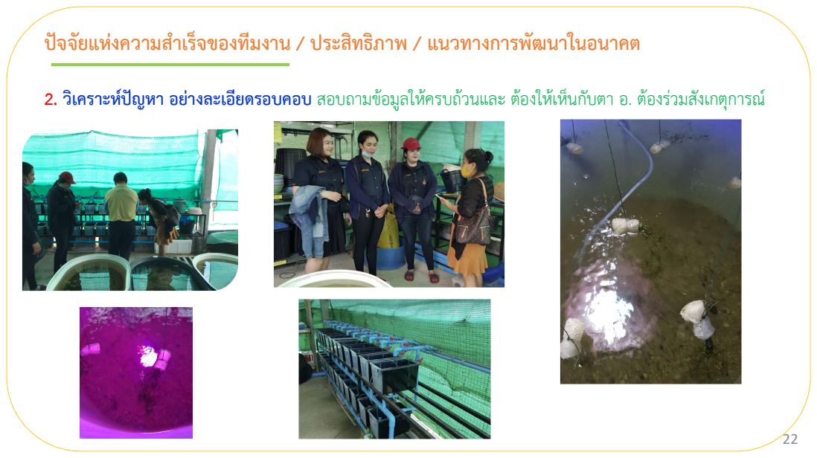
[picture p334: page 22]
ยแหง ความส; จของท; มงาน / ประส; ภาพ / แนวทางการพ; ฒนาในอนาคต

2. วิเคราะหป ญหา อยางละเอ

าเร
ยดรอบคอบ สอบถามขอมูลใหครบถวนและ ตองใหเห็นกับตา อ. ตองรวมสังเกตุการณ

ปจ

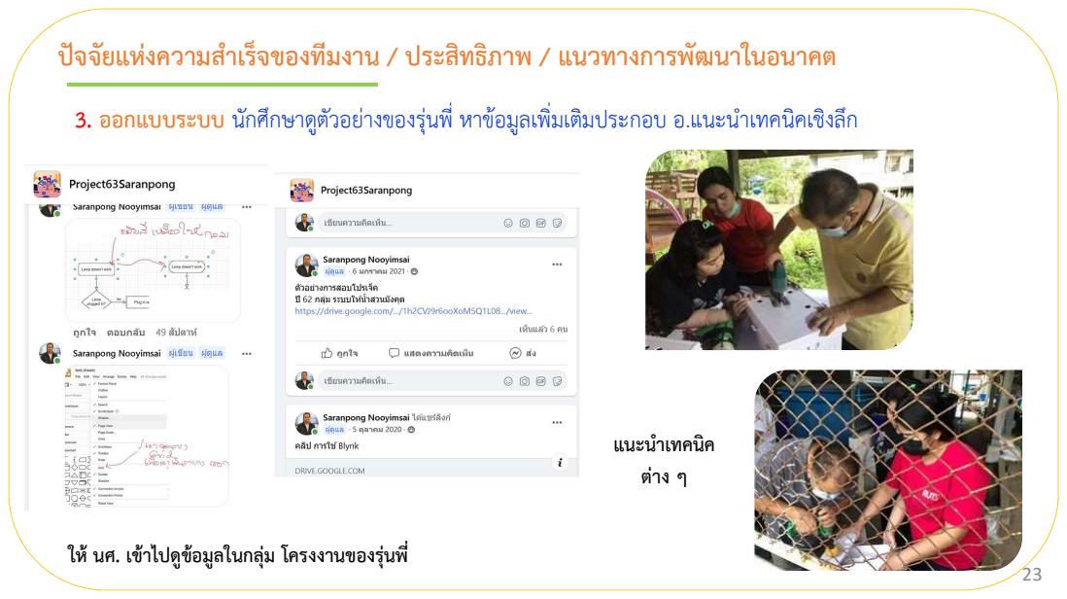
[picture p335: page 23]
ยแหง ความส; าเร; จของท; มงาน / ประส; ภาพ / แนวทางการพ; ฒนาในอนาคต; 3. ออกแบบระบบ นักศ; กษาดต; ี่ หาขอม; แนะนําเทคนิค ตาง ๆ

ู ัวอยางของรุนพ

ลเพิ่มเติมประกอบ อ.แนะนําเทคนคิเชิงล

ให นศ. เขาไปดูขอมูลในกลุม โครงงานของรุนพี่

ปจ

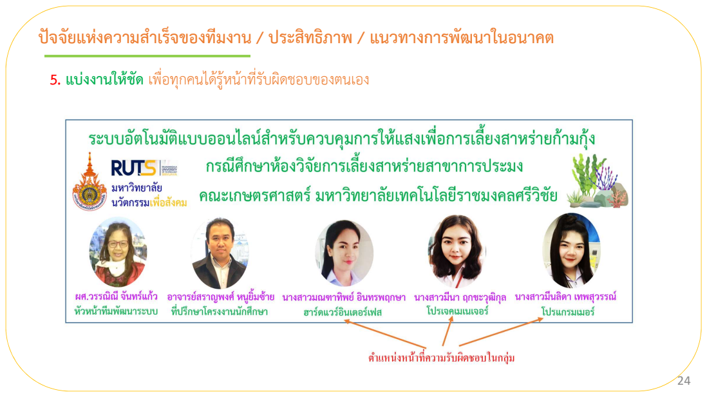
[picture p336: page 24]
ยแหง ความส; าเร; จของท; มงาน / ประส; ภาพ / แนวทางการพ; ฒนาในอนาคต; ี่รับผิดชอบของตนเอง

5. แบงงานใหชัด เพ

ื่อทุกคนไดรูหนาท

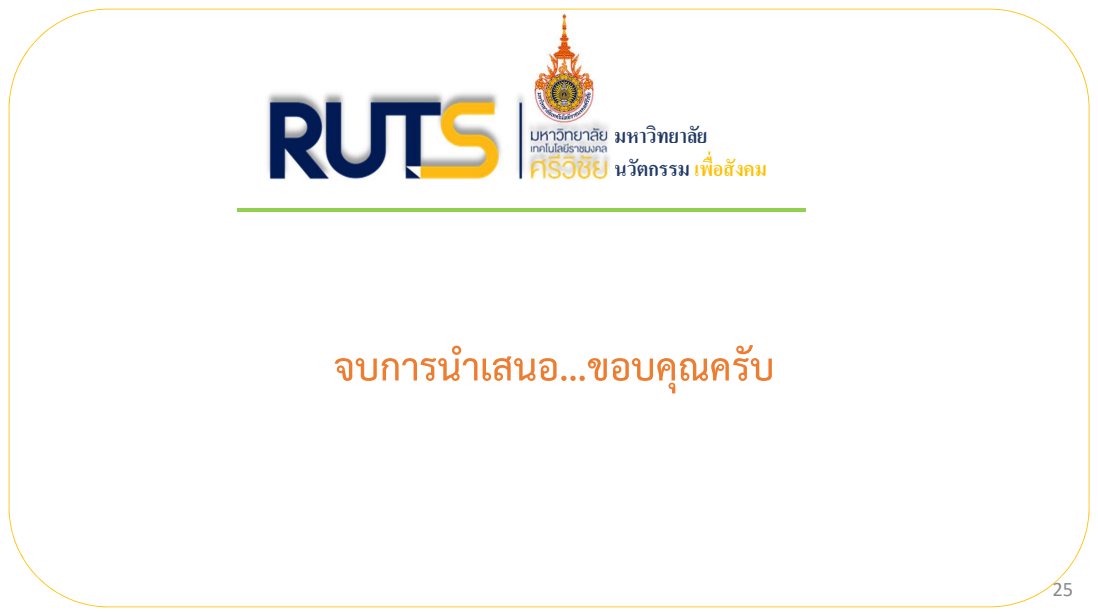
[picture p337: page 25]

มหาวทิยาลยั นวัตกรรม เพืÉอสังคม

จบการนําเสนอ…ขอบคุณครับ
