PipeNitch/Project_WPNS-IoT/Arduino/test_pzem/test_pzem.ino

#include <PZEM004Tv30.h>
PZEM004Tv30 pzem(D6,D7);
void setup() {
Serial.begin(115200);
}
void loop() {
float voltage = pzem.voltage();
if(voltage != NAN){
  Serial.print(“Voltage: “); Serial.print(voltage); Serial.println(“V”);
} 
else {
  Serial.println(“Error reading voltage”);
}
float current = pzem.current();
if(current != NAN){
  Serial.print(“Current: “); Serial.print(current); Serial.println(“A”);
} 
else {
  Serial.println(“Error reading current”);
}
float power = pzem.power();
if(current != NAN){
  Serial.print(“Power: “); Serial.print(power); Serial.println(“W”);
} 
else {
  Serial.println(“Error reading power”);
}
float energy = pzem.energy();
if(current != NAN){
  Serial.print(“Energy: “); Serial.print(energy,3); Serial.println(“kWh”);
} 
else {
  Serial.println(“Error reading energy”);
}
float frequency = pzem.frequency();
if(current != NAN){
  Serial.print(“Frequency: “); Serial.print(frequency, 1); Serial.println(“Hz”);
} 
else {
  Serial.println(“Error reading frequency”);
}
float pf = pzem.pf();
if(current != NAN){
  Serial.print(“PF: “); Serial.println(pf);
} 
else {
  Serial.println(“Error reading power factor”);
}
Serial.println();
delay(500);
}
